tgtakaoka/retro-bionic/docs/mandelbrot.md

# CPU speed by an assembly-language Mandelbrot

Every architecture's samples run the same Mandelbrot algorithm, written in
that chip's own assembly: [mandelbrot.c](../samples/arith/mandelbrot.c) in
16-bit integers, and on chips with floating-point instructions,
[fmandel.cpp](../samples/arith/fmandel.cpp) as well. Both draw 25 rows of 79
pixels, each printed as its iteration count, `0`-`9` and `A`-`F`, or a space
after 16. Each character goes into a queue that the serial port's
transmit interrupt drains, so sending overlaps the next pixel's work.
On chips that draw a frame in under 10 seconds, a frame ends once the
queue is empty.
The tables time them on real chips, from recorded casts, with
[mandelbrot-timing.py](../scripts/mandelbrot-timing.py).

- **frame** is the seconds for a full frame, measured when the cast has
  one. Otherwise it is estimated: rows differ in work, so seconds =
  a × iterations + b is fitted to the timed rows and summed over the
  golden frame.
- **avg row** is the average seconds per row over the rows a cast timed.
- **std dev** is the standard deviation of those rows' seconds, which is
  mostly the picture's, not the chip's.
- **MHz** is the chip's clock: ⏱️ marks one clocked from a timer at
  that rate (see [hardware.md](hardware.md#clocking-the-cpu)), 🔨 one
  whose edges the debugger bit-bangs, at its average rate.
- **Note** names the code when it is not the chip's own, and any mode
  the run set.
- **Links**: ▶️ plays the cast, an [asciinema](https://asciinema.org/)
  recording of the debugger's terminal while the chip draws, with its
  timing, in the browser at the speed it ran, beside its listing
  (`asciinema play` replays the file in a terminal); 📄 opens the
  listing, the assembly source the chip ran.

<!-- Link a cast as
     https://tgtakaoka.github.io/retro-bionic/play.html?cast=samples/<arch>/<name>.cast&lst=samples/<arch>/<name>.lst
     with ▶️ as the text and the cast file name as the title, and the
     row's listing as 📄 with its path as the title; docs/play.html
     plays it beside the listing. -->

## Integer, mandelbrot

Icons: ⏱️ timer clock, 🔨 bit-banged clock (average), ▶️ play the
cast, 📄 the listing.

| arch | core | CPU | frame | avg row | std dev | MHz | Note | Links |
| :---: | :---: | :---: | ----: | ---: | ---: | ---: | --- | :---: |
| i8096  | i80296  | S80296SA50 | 1.6 | 0.066 | 0.017 | 4.93&nbsp;🔨 | i80296 code | [▶️](https://tgtakaoka.github.io/retro-bionic/play.html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 "mandelbrot.cast") [📄](../samples/i80296/mandelbrot.lst "i80296/mandelbrot.lst") |
| i8096  | i80296  | S80296SA50 | 1.7 | 0.069 | 0.018 | 4.87&nbsp;🔨 | i8096 code | [▶️](https://tgtakaoka.github.io/retro-bionic/play.html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 "mandelbrot_s80296sa.cast") [📄](../samples/i8096/mandelbrot.lst "i8096/mandelbrot.lst") |
| z280 | z280 | Z8028012VSC  | 1.8 | 0.074 | 0.017 | 7.12&nbsp;🔨 | cache on | [▶️](https://tgtakaoka.github.io/retro-bionic/play.html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 "mandelbrot.cast") [📄](../samples/z280/mandelbrot.lst "z280/mandelbrot.lst") |
| mc68hc16 |  mc68hc16 | MC68HC16Z1PV16 | 2.1 | 0.084 | 0.024 | 10.00&nbsp;⏱️ | | [▶️](https://tgtakaoka.github.io/retro-bionic/play.html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 "mandelbrot.cast") [📄](../samples/mc68hc16/mandelbrot.lst "mc68hc16/mandelbrot.lst") |
| mc68hc12 |  mc68hc12 |  MC68HC912BD32 | 2.1 | 0.086 | 0.023 | 2.50&nbsp;🔨 | | [▶️](https://tgtakaoka.github.io/retro-bionic/play.html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 "mandelbrot.cast") [📄](../samples/mc68hc12/mandelbrot.lst "mc68hc12/mandelbrot.lst") |
| mc68hc12 | mc68hcs12 |  MC9S12DG128B  | 2.2 | 0.089 | 0.024 | 2.44&nbsp;🔨 | | [▶️](https://tgtakaoka.github.io/retro-bionic/play.html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 "mandelbrot_mc9s12d.cast") [📄](../samples/mc68hc12/mandelbrot.lst "mc68hc12/mandelbrot.lst") |
| h16 | h16 |  HD641016CP10  | 2.4 | 0.098 | 0.022 | 10.00&nbsp;⏱️ | | [▶️](https://tgtakaoka.github.io/retro-bionic/play.html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 "mandelbrot.cast") [📄](../samples/h16/mandelbrot.lst "h16/mandelbrot.lst") |
| z8000  | z8002 | Z16C0210PSC  | 2.6 | 0.104 | 0.030 | 6.86&nbsp;🔨 | | [▶️](https://tgtakaoka.github.io/retro-bionic/play.html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 "mandelbrot.cast") [📄](../samples/z8002/mandelbrot.lst "z8002/mandelbrot.lst") |
| mc68000  |  mc68000  | MC68010P12 | 2.7 | 0.112 | 0.032 |  10.00&nbsp;⏱️ | | [▶️](https://tgtakaoka.github.io/retro-bionic/play.html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 "mandelbrot_mc68010.cast") [📄](../samples/mc68000/mandelbrot.lst "mc68000/mandelbrot.lst") |
| i8096  | i8096 | N8097BH | 2.9 | 0.117 | 0.033 |  10.03&nbsp;🔨 | i8096 code | [▶️](https://tgtakaoka.github.io/retro-bionic/play.html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 "mandelbrot_n8097.cast") [📄](../samples/i8096/mandelbrot.lst "i8096/mandelbrot.lst") |
| i8096  | i8096 | P8095BH | 2.9 | 0.119 | 0.033 |  10.06&nbsp;🔨 | i8096 code | [▶️](https://tgtakaoka.github.io/retro-bionic/play.html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 "mandelbrot.cast") [📄](../samples/i8096/mandelbrot.lst "i8096/mandelbrot.lst") |
| z8000  | z8001 | Z0800110PSC  | 3.0 | 0.121 | 0.034 | 6.01&nbsp;🔨 | nonsegmented, normal | [▶️](https://tgtakaoka.github.io/retro-bionic/play.html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 "mandelbrot_nonseg.cast") [📄](../samples/z8001/mandelbrot_nonseg.lst "z8001/mandelbrot_nonseg.lst") |
| z8000  | z8001 | Z0800110PSC  | 3.0 | 0.122 | 0.034 | 6.10&nbsp;🔨 | segmented, normal | [▶️](https://tgtakaoka.github.io/retro-bionic/play.html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 "mandelbrot.cast") [📄](../samples/z8001/mandelbrot.lst "z8001/mandelbrot.lst") |
| z380 | z380 | Z8038018FSC  | 3.0 | 0.122 | 0.036 | 3.41&nbsp;🔨 | | [▶️](https://tgtakaoka.github.io/retro-bionic/play.html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 "mandelbrot.cast") [📄](../samples/z380/mandelbrot.lst "z380/mandelbrot.lst") |
| i8096  | i80196  | S80C196KC20  | 3.0 | 0.124 | 0.035 | 4.89&nbsp;🔨 | i8096 code | [▶️](https://tgtakaoka.github.io/retro-bionic/play.html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 "mandelbrot_s80c196kc.cast") [📄](../samples/i8096/mandelbrot.lst "i8096/mandelbrot.lst") |
| mc68hc12 | mc68hcs12x |  MC9S12XDP512  | 3.2 | 0.132 | 0.036 | 1.58&nbsp;🔨 | non-mux addr/data | [▶️](https://tgtakaoka.github.io/retro-bionic/play.html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 "mandelbrot.cast") [📄](../samples/mc9s12x/mandelbrot.lst "mc9s12x/mandelbrot.lst") |
| mc68hc12 | mc68hcs12x |  MC9S12XDP512  | 3.3 | 0.135 | 0.037 | 1.58&nbsp;🔨 | mc68hc12 code | [▶️](https://tgtakaoka.github.io/retro-bionic/play.html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 "mandelbrot_mc9s12x.cast") [📄](../samples/mc68hc12/mandelbrot.lst "mc68hc12/mandelbrot.lst") |
|  i8086 | v30 | D70116C-8 | 3.4 | 0.140 | 0.040 |  5.00&nbsp;⏱️ | i80186 code | [▶️](https://tgtakaoka.github.io/retro-bionic/play.html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 "mandelbrot_i80186_v30.cast") [📄](../samples/i8086/mandelbrot_i80186.lst "i8086/mandelbrot_i80186.lst")  |
|  i8086 | v30 | D70116C-8 | 3.5 | 0.142 | 0.041 |  5.00&nbsp;⏱️ | i8086 code | [▶️](https://tgtakaoka.github.io/retro-bionic/play.html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 "mandelbrot_v30.cast") [📄](../samples/i8086/mandelbrot.lst "i8086/mandelbrot.lst") |
| mc68000  |  mc68000  | MC68008P10 | 3.7 | 0.149 | 0.041 | 10.00&nbsp;⏱️ | | [▶️](https://tgtakaoka.github.io/retro-bionic/play.html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 "mandelbrot.cast") [📄](../samples/mc68000/mandelbrot.lst "mc68000/mandelbrot.lst") |
| mc68000  |  mc68000  |  MC68008FN10 | 3.7 | 0.149 | 0.041 | 10.00&nbsp;⏱️ | | [▶️](https://tgtakaoka.github.io/retro-bionic/play.html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 "mandelbrot_mc68008fn.cast") [📄](../samples/mc68000/mandelbrot.lst "mc68000/mandelbrot.lst") |
| mc68000  |  mc68000  |  MC68HC000P16  | 4.0 | 0.164 | 0.047 |  7.50&nbsp;⏱️ | | [▶️](https://tgtakaoka.github.io/retro-bionic/play.html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 "mandelbrot_mc68000p.cast") [📄](../samples/mc68000/mandelbrot.lst "mc68000/mandelbrot.lst") |
| z280 | z280 | Z8028012VSC  | 4.5 | 0.182 | 0.053 | 3.78&nbsp;🔨 | | [▶️](https://tgtakaoka.github.io/retro-bionic/play.html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 "mandelbrot.cast") [📄](../samples/z280/mandelbrot.lst "z280/mandelbrot.lst") |
|  i8086 | v20 |  D70108HCZ-16  | 4.8 | 0.194 | 0.055 |  5.00&nbsp;⏱️ | i80186 code | [▶️](https://tgtakaoka.github.io/retro-bionic/play.html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 "mandelbrot_i80186_v20.cast") [📄](../samples/i8086/mandelbrot_i80186.lst "i8086/mandelbrot_i80186.lst")  |
|  i8086 | v20 |  D70108HCZ-16  | 4.8 | 0.195 | 0.055 |  5.00&nbsp;⏱️ | i8086 code | [▶️](https://tgtakaoka.github.io/retro-bionic/play.html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 "mandelbrot_v20.cast") [📄](../samples/i8086/mandelbrot.lst "i8086/mandelbrot.lst") |
|  tms320  | tms320c1x | TMS320C15NL  | 4.8 | 0.195 | 0.062 | 5.19&nbsp;🔨 | TMS320C1x code | [▶️](https://tgtakaoka.github.io/retro-bionic/play.html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 "mandelbrot.cast") [📄](../samples/tms320c1x/mandelbrot.lst "tms320c1x/mandelbrot.lst") |
| pdp11  | j11 | DCJ11 | 6.0 | 0.246 | 0.074 |  7.50&nbsp;⏱️ | with EIS | [▶️](https://tgtakaoka.github.io/retro-bionic/play.html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 "mandelbrot.cast") [📄](../samples/dcj11/mandelbrot.lst "dcj11/mandelbrot.lst") |
|  tms9900 |  tms99105 |  TMS99105AJDL  | 6.7 | 0.272 | 0.087 | 6.34&nbsp;🔨 | | [▶️](https://tgtakaoka.github.io/retro-bionic/play.html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 "mandelbrot.cast") [📄](../samples/tms99105/mandelbrot.lst "tms99105/mandelbrot.lst") |
|  tms9900 |  tms99105 |  TMS99105AJDL  | 6.7 | 0.274 | 0.087 | 6.32&nbsp;🔨 | TMS9995 code | [▶️](https://tgtakaoka.github.io/retro-bionic/play.html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 "mandelbrot_tms99105.cast") [📄](../samples/tms9995/mandelbrot.lst "tms9995/mandelbrot.lst") |
|  i8086 | i8086 | P80C86A-2 | 6.8 | 0.277 | 0.087 |  5.00&nbsp;⏱️ | | [▶️](https://tgtakaoka.github.io/retro-bionic/play.html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 "mandelbrot.cast") [📄](../samples/i8086/mandelbrot.lst "i8086/mandelbrot.lst") |
|  tms9900 |  tms99105 |  TMS99105AJDL  | 7.1 | 0.291 | 0.093 | 6.12&nbsp;🔨 | TMS9900 code | [▶️](https://tgtakaoka.github.io/retro-bionic/play.html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 "mandelbrot_tms99105.cast") [📄](../samples/tms9900/mandelbrot.lst "tms9900/mandelbrot.lst") |
|  i8086 | i8086 | P80C86A-2 | 7.3 | 0.297 | 0.091 |  5.00&nbsp;⏱️ | with D8087 | [▶️](https://tgtakaoka.github.io/retro-bionic/play.html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 "mandelbrot_80c86_8087.cast") [📄](../samples/i8086/mandelbrot.lst "i8086/mandelbrot.lst") |
|  i8086 | i8086 | P80C88A-2 | 7.9 | 0.321 | 0.099 |  5.00&nbsp;⏱️ | | [▶️](https://tgtakaoka.github.io/retro-bionic/play.html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 "mandelbrot_80c88.cast") [📄](../samples/i8086/mandelbrot.lst "i8086/mandelbrot.lst") |
|  tms9900 |  tms9995  |  TMS9995NL-12  | 8.3 | 0.338 | 0.108 | 6.17&nbsp;🔨 | | [▶️](https://tgtakaoka.github.io/retro-bionic/play.html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 "mandelbrot.cast") [📄](../samples/tms9995/mandelbrot.lst "tms9995/mandelbrot.lst") |
|  mn1610  | mn1613  | MN1613 | 8.6 | 0.353 | 0.115 | 8.01&nbsp;🔨 | | [▶️](https://tgtakaoka.github.io/retro-bionic/play.html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 "mandelbrot.cast") [📄](../samples/mn1613/mandelbrot.lst "mn1613/mandelbrot.lst") |
|  mn1610  | mn1613  | MN1613A | 8.9 | 0.362 | 0.118 | 8.01&nbsp;🔨 | | [▶️](https://tgtakaoka.github.io/retro-bionic/play.html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 "mandelbrot_mn1613a.cast") [📄](../samples/mn1613/mandelbrot.lst "mn1613/mandelbrot.lst") |
|  i8086 | i8086 | P80C88A-2 | 9.2 | 0.374 | 0.113 |  5.00&nbsp;⏱️ | with D8087 | [▶️](https://tgtakaoka.github.io/retro-bionic/play.html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 "mandelbrot_80c88_8087.cast") [📄](../samples/i8086/mandelbrot.lst "i8086/mandelbrot.lst") |
|  mc6809  | hd6309  | HD63C09EP |  10.0 | 0.408 | 0.131 | 0.88&nbsp;🔨 | HD6309 code | [▶️](https://tgtakaoka.github.io/retro-bionic/play.html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 "mandelbrot_hd6309e.cast") [📄](../samples/hd6309/mandelbrot.lst "hd6309/mandelbrot.lst") |
|  mos6502 |  w65c816  |  W65C816S8P-14 |  10.1 | 0.411 | 0.099 | 2.61&nbsp;🔨 | | [▶️](https://tgtakaoka.github.io/retro-bionic/play.html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 "mandelbrot.cast") [📄](../samples/w65c816/mandelbrot.lst "w65c816/mandelbrot.lst") |
| z380 | z380 | Z8038018FSC  |  10.2 | 0.415 | 0.110 | 3.60&nbsp;🔨 | Z180 code | [▶️](https://tgtakaoka.github.io/retro-bionic/play.html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 "mandelbrot_z380.cast") [📄](../samples/z180/mandelbrot.lst "z180/mandelbrot.lst") |
|  mos6502 |  w65c02s  | W65C02S6TPG-14 |  10.3 | 0.417 | 0.098 | 3.69&nbsp;🔨 | G65SC02 code | [▶️](https://tgtakaoka.github.io/retro-bionic/play.html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 "mandelbrot_w65c02s.cast") [📄](../samples/g65sc02/mandelbrot.lst "g65sc02/mandelbrot.lst") |
|  tms9900 |  tms9995  |  TMS9995NL-12  |  10.3 | 0.420 | 0.134 | 6.11&nbsp;🔨 | TMS9900 code | [▶️](https://tgtakaoka.github.io/retro-bionic/play.html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 "mandelbrot_tms9995.cast") [📄](../samples/tms9900/mandelbrot.lst "tms9900/mandelbrot.lst") |
|  mc6809  | hd6309  | HD63B09P |  10.3 | 0.422 | 0.135 | 3.39&nbsp;🔨 | | [▶️](https://tgtakaoka.github.io/retro-bionic/play.html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 "mandelbrot.cast") [📄](../samples/hd6309/mandelbrot.lst "hd6309/mandelbrot.lst") |
|  mos6502 |  w65c02s  | W65C02S6TPG-14 |  10.4 | 0.421 | 0.099 | 3.69&nbsp;🔨 | MOS6502 code | [▶️](https://tgtakaoka.github.io/retro-bionic/play.html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 "mandelbrot_w65c02s.cast") [📄](../samples/mos6502/mandelbrot.lst "mos6502/mandelbrot.lst") |
|  tlcs90  | tlcs90  | TMP90C802AP  |  11.3 | 0.460 | 0.151 | 5.16&nbsp;🔨 | TLCS90 code | [▶️](https://tgtakaoka.github.io/retro-bionic/play.html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 "mandelbrot.cast") [📄](../samples/tlcs90/mandelbrot.lst "tlcs90/mandelbrot.lst") |
| z380 | z380 | Z8038018FSC  |  12.1 | 0.491 | 0.121 | 3.51&nbsp;🔨 | Z80 code | [▶️](https://tgtakaoka.github.io/retro-bionic/play.html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 "mandelbrot_z380.cast") [📄](../samples/z80/mandelbrot.lst "z80/mandelbrot.lst") |
| z80 | z80 |  KL5C80A12CFP  |  12.4 | 0.505 | 0.123 | 18.75&nbsp;⏱️ | Z80 code | [▶️](https://tgtakaoka.github.io/retro-bionic/play.html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 "mandelbrot_kl5c80.cast") [📄](../samples/z80/mandelbrot.lst "z80/mandelbrot.lst") |
|  mn1610  | mn1613  | MN1613 |  12.7 | 0.517 | 0.131 | 7.57&nbsp;🔨 | MN1610 code | [▶️](https://tgtakaoka.github.io/retro-bionic/play.html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 "mandelbrot.cast") [📄](../samples/mn1610/mandelbrot.lst "mn1610/mandelbrot.lst") |
|  mn1610  | mn1613  | MN1613A |  12.8 | 0.519 | 0.131 | 7.57&nbsp;🔨 | MN1610 code | [▶️](https://tgtakaoka.github.io/retro-bionic/play.html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 "mandelbrot_mn1613a.cast") [📄](../samples/mn1610/mandelbrot.lst "mn1610/mandelbrot.lst") |
|  mos6502 |  g65sc02  | G65SC02P-4 |  13.2 | 0.535 | 0.125 | 2.88&nbsp;🔨 | | [▶️](https://tgtakaoka.github.io/retro-bionic/play.html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 "mandelbrot.cast") [📄](../samples/g65sc02/mandelbrot.lst "g65sc02/mandelbrot.lst") |
|  mos6502 |  g65sc02  | G65SC02P-4 |  13.3 | 0.534 | 0.128 | 2.88&nbsp;🔨 | MOS6502 code | [▶️](https://tgtakaoka.github.io/retro-bionic/play.html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 "mandelbrot_g65sc02.cast") [📄](../samples/mos6502/mandelbrot.lst "mos6502/mandelbrot.lst") |
|  tms370  | tms370  |  TMS370C250FNA |  13.8 | 0.561 | 0.176 | 18.75&nbsp;⏱️ | | [▶️](https://tgtakaoka.github.io/retro-bionic/play.html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 "mandelbrot.cast") [📄](../samples/tms370/mandelbrot.lst "tms370/mandelbrot.lst") |
|  mos6502 |  w65c816  |  W65C816S8P-14 |  14.4 | 0.586 | 0.137 | 2.63&nbsp;🔨 | G65SC02 code | [▶️](https://tgtakaoka.github.io/retro-bionic/play.html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 "mandelbrot_w65c816.cast") [📄](../samples/g65sc02/mandelbrot.lst "g65sc02/mandelbrot.lst") |
|  mos6502 |  w65c816  |  W65C816S8P-14 |  14.6 | 0.592 | 0.139 | 2.63&nbsp;🔨 | MOS6502 code | [▶️](https://tgtakaoka.github.io/retro-bionic/play.html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 "mandelbrot_w65c816.cast") [📄](../samples/mos6502/mandelbrot.lst "mos6502/mandelbrot.lst") |
| z80 | z180 | Z8018010VSC  |  14.9 | 0.605 | 0.160 | 16.67&nbsp;⏱️ | | [▶️](https://tgtakaoka.github.io/retro-bionic/play.html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 "mandelbrot_z180vsc.cast") [📄](../samples/z180/mandelbrot.lst "z180/mandelbrot.lst") |
| z80 | z180 | Z8018008FSC  |  14.9 | 0.606 | 0.160 | 16.67&nbsp;⏱️ | | [▶️](https://tgtakaoka.github.io/retro-bionic/play.html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 "mandelbrot.cast") [📄](../samples/z180/mandelbrot.lst "z180/mandelbrot.lst") |
| z80 | z180 | HD64180SH10  |  15.2 | 0.619 | 0.163 | 18.75&nbsp;⏱️ | Z180 code | [▶️](https://tgtakaoka.github.io/retro-bionic/play.html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 "mandelbrot_hd64180s.cast") [📄](../samples/z180/mandelbrot.lst "z180/mandelbrot.lst") |
|  mos6502 | r65c02  | R65C02P3 |  15.9 | 0.647 | 0.152 | 2.38&nbsp;🔨 | G65SC02 code | [▶️](https://tgtakaoka.github.io/retro-bionic/play.html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 "mandelbrot_r65c02.cast") [📄](../samples/g65sc02/mandelbrot.lst "g65sc02/mandelbrot.lst") |
|  mos6502 | r65c02  | R65C02P3 |  16.1 | 0.653 | 0.154 | 2.38&nbsp;🔨 | MOS6502 code | [▶️](https://tgtakaoka.github.io/retro-bionic/play.html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 "mandelbrot_r65c02.cast") [📄](../samples/mos6502/mandelbrot.lst "mos6502/mandelbrot.lst") |
| z80 | z80 |  KL5C80A12CFP  |  16.6 | 0.673 | 0.156 | 18.75&nbsp;⏱️ | i8080 code/mode2 | [▶️](https://tgtakaoka.github.io/retro-bionic/play.html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 "mandelbrot_mode2_kl5c80.cast") [📄](../samples/i8080/mandelbrot_mode2.lst "i8080/mandelbrot_mode2.lst") |
| z80 | z180 | Z8018010VSC  |  17.3 | 0.702 | 0.171 | 16.67&nbsp;⏱️ | Z80 code | [▶️](https://tgtakaoka.github.io/retro-bionic/play.html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 "mandelbrot_z180vsc.cast") [📄](../samples/z80/mandelbrot.lst "z80/mandelbrot.lst") |
| z80 | z180 | Z8018008FSC  |  17.3 | 0.704 | 0.171 | 16.67&nbsp;⏱️ | Z80 code | [▶️](https://tgtakaoka.github.io/retro-bionic/play.html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 "mandelbrot_z180.cast") [📄](../samples/z80/mandelbrot.lst "z80/mandelbrot.lst") |
| z80 | z180 | HD64180SH10  |  17.8 | 0.723 | 0.176 | 18.75&nbsp;⏱️ | Z80 code | [▶️](https://tgtakaoka.github.io/retro-bionic/play.html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 "mandelbrot_hd64180s.cast") [📄](../samples/z80/mandelbrot.lst "z80/mandelbrot.lst") |
| z8 | z88 | Z88C0020PSC  |  17.9 | 0.730 | 0.243 | 6.97&nbsp;🔨 | Z88 code | [▶️](https://tgtakaoka.github.io/retro-bionic/play.html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 "mandelbrot.cast") [📄](../samples/z88/mandelbrot.lst "z88/mandelbrot.lst") |
| pdp11  | j11 | DCJ11 |  18.5 | 0.752 | 0.191 |  7.50&nbsp;⏱️ | base PDP11 | [▶️](https://tgtakaoka.github.io/retro-bionic/play.html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 "mandelbrot_dcj11.cast") [📄](../samples/pdp11/mandelbrot.lst "pdp11/mandelbrot.lst") |
|  mc6805  |  mc68hc08 | XC68HC08AZ0  |  19.1 | 0.780 | 0.256 | 4.21&nbsp;🔨 | | [▶️](https://tgtakaoka.github.io/retro-bionic/play.html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 "mandelbrot.cast") [📄](../samples/mc68hc08/mandelbrot.lst "mc68hc08/mandelbrot.lst") |
|  tms7000 |  tms7000  | TMS7002NL |  20.8 | 0.846 | 0.223 | 4.67&nbsp;🔨 | TMS7000 code | [▶️](https://tgtakaoka.github.io/retro-bionic/play.html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 "mandelbrot.cast") [📄](../samples/tms7000/mandelbrot.lst "tms7000/mandelbrot.lst") |
|  tms9900 |  tms9900  | TMS9900NL |  21.3 | 0.869 | 0.280 |  14.22&nbsp;🔨 | | [▶️](https://tgtakaoka.github.io/retro-bionic/play.html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 "mandelbrot.cast") [📄](../samples/tms9900/mandelbrot.lst "tms9900/mandelbrot.lst") |
| pdp11  | t11 | DCT11 |  21.6 | 0.879 | 0.220 | 4.90&nbsp;🔨 | base PDP11 | [▶️](https://tgtakaoka.github.io/retro-bionic/play.html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 "mandelbrot_dct11.cast") [📄](../samples/pdp11/mandelbrot.lst "pdp11/mandelbrot.lst") |
|  i8086 | v30 | D70116C-8 |  22.7 | 0.933 | 0.208 |  5.00&nbsp;⏱️ | i8080 code/emulation | [▶️](https://tgtakaoka.github.io/retro-bionic/play.html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 "mandelbrot_v30.cast") [📄](../samples/i8080/mandelbrot.lst "i8080/mandelbrot.lst") |
|  mc6800  |  mc68hc11 | MC68HC11A0P  |  23.1 | 0.942 | 0.314 | 3.34&nbsp;🔨 | | [▶️](https://tgtakaoka.github.io/retro-bionic/play.html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 "mandelbrot.cast") [📄](../samples/mc68hc11/mandelbrot.lst "mc68hc11/mandelbrot.lst") |
| z80 | z80 | NSC800N-4I |  24.5 | 0.994 | 0.239 |  8.33&nbsp;⏱️ | Z80 code | [▶️](https://tgtakaoka.github.io/retro-bionic/play.html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 "mandelbrot_nsc800.cast") [📄](../samples/z80/mandelbrot.lst "z80/mandelbrot.lst") |
| z80 | z80 | Z8400APS |  25.0 | 1.017 | 0.244 | 3.23&nbsp;🔨 | | [▶️](https://tgtakaoka.github.io/retro-bionic/play.html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 "mandelbrot.cast") [📄](../samples/z80/mandelbrot.lst "z80/mandelbrot.lst") |
|  tms7000 |  tms7000  | TMS70C02NL |  26.8 | 1.092 | 0.287 | 3.62&nbsp;🔨 | TMS7000 code | [▶️](https://tgtakaoka.github.io/retro-bionic/play.html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 "mandelbrot_tms70c02.cast") [📄](../samples/tms7000/mandelbrot.lst "tms7000/mandelbrot.lst") |
|  tms7000 |  tms7000  | TMS70C00NL |  26.8 | 1.092 | 0.287 | 3.62&nbsp;🔨 | TMS7000 code | [▶️](https://tgtakaoka.github.io/retro-bionic/play.html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 "mandelbrot_tms70c00.cast") [📄](../samples/tms7000/mandelbrot.lst "tms7000/mandelbrot.lst") |
|  tms7000 |  tms7000  | TMS7001NL-2  |  26.9 | 1.094 | 0.288 | 3.61&nbsp;🔨 | TMS7000 code | [▶️](https://tgtakaoka.github.io/retro-bionic/play.html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 "mandelbrot_tms7001nl2.cast") [📄](../samples/tms7000/mandelbrot.lst "tms7000/mandelbrot.lst") |
|  mos6502 |  mos6502  | UM6502A |  26.9 | 1.168 | 0.228 | 1.44&nbsp;🔨 | | [▶️](https://tgtakaoka.github.io/retro-bionic/play.html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 "mandelbrot.cast") [📄](../samples/mos6502/mandelbrot.lst "mos6502/mandelbrot.lst") |
| z8 | z86 | Z86C9116PSC  |  27.1 | 1.103 | 0.305 | 6.77&nbsp;🔨 | Z86 code | [▶️](https://tgtakaoka.github.io/retro-bionic/play.html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 "mandelbrot.cast") [📄](../samples/z86/mandelbrot.lst "z86/mandelbrot.lst") |
|  tms7000 |  tms7000  | TMS7001NL-4  |  28.1 | 1.141 | 0.300 | 6.90&nbsp;🔨 | TMS7000 code | [▶️](https://tgtakaoka.github.io/retro-bionic/play.html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 "mandelbrot_tms7001nl4.cast") [📄](../samples/tms7000/mandelbrot.lst "tms7000/mandelbrot.lst") |
| z280 | z280 | Z8028012VSC  |  28.4 | 1.155 | 0.280 | 3.85&nbsp;🔨 | Z80 code | [▶️](https://tgtakaoka.github.io/retro-bionic/play.html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 "mandelbrot_z280.cast") [📄](../samples/z80/mandelbrot.lst "z80/mandelbrot.lst") |
| i8080  | i8085 | P8085AH-2 |  29.1 | 1.179 | 0.272 | 10.00&nbsp;⏱️ | i8080 code | [▶️](https://tgtakaoka.github.io/retro-bionic/play.html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 "mandelbrot_p8085.cast") [📄](../samples/i8080/mandelbrot.lst "i8080/mandelbrot.lst") |
| z80 | z80 | NSC800N-4I |  29.8 | 1.210 | 0.279 |  8.33&nbsp;⏱️ | i8080 code/mode0 | [▶️](https://tgtakaoka.github.io/retro-bionic/play.html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 "mandelbrot_nsc800.cast") [📄](../samples/i8080/mandelbrot.lst "i8080/mandelbrot.lst") |
|  mc6800  | hd6301  | HD63B03R1P |  30.4 | 1.235 | 0.311 | 3.30&nbsp;🔨 | MC6801 code | [▶️](https://tgtakaoka.github.io/retro-bionic/play.html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 "mandelbrot_hd6301.cast") [📄](../samples/mc6801/mandelbrot.lst "mc6801/mandelbrot.lst") |
|  mc6809  | hd6309  | HD63C09EP |  30.5 | 1.238 | 0.292 | 0.89&nbsp;🔨 | MC6809 code | [▶️](https://tgtakaoka.github.io/retro-bionic/play.html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 "mandelbrot_hd6309e.cast") [📄](../samples/mc6809/mandelbrot.lst "mc6809/mandelbrot.lst") |
| z80 | z80 | Z8400APS |  30.6 | 1.242 | 0.286 | 3.16&nbsp;🔨 | i8080 code/mode0 | [▶️](https://tgtakaoka.github.io/retro-bionic/play.html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 "mandelbrot_z80.cast") [📄](../samples/i8080/mandelbrot.lst "i8080/mandelbrot.lst") |
| i8051  | i8051 | P80C52 |  30.7 | 1.254 | 0.382 | 7.95&nbsp;🔨 | i8051 code | [▶️](https://tgtakaoka.github.io/retro-bionic/play.html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 "mandelbrot_p80c51.cast") [📄](../samples/i8051/mandelbrot.lst "i8051/mandelbrot.lst") |
| i8051  | i8051 | P8051AH |  31.4 | 1.281 | 0.393 | 7.67&nbsp;🔨 | i8051 code | [▶️](https://tgtakaoka.github.io/retro-bionic/play.html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 "mandelbrot.cast") [📄](../samples/i8051/mandelbrot.lst "i8051/mandelbrot.lst") |
|  tms9900 |  tms9980  | TMS9980ANL |  31.5 | 1.287 | 0.409 | 10.00&nbsp;⏱️ | TMS9900 code | [▶️](https://tgtakaoka.github.io/retro-bionic/play.html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 "mandelbrot_tms9980.cast") [📄](../samples/tms9900/mandelbrot.lst "tms9900/mandelbrot.lst") |
|  tms9900 |  tms9980  |  TMS9981NL-16  |  31.5 | 1.287 | 0.409 | 10.00&nbsp;⏱️ | TMS9900 code | [▶️](https://tgtakaoka.github.io/retro-bionic/play.html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 "mandelbrot_tms9981.cast") [📄](../samples/tms9900/mandelbrot.lst "tms9900/mandelbrot.lst") |
|  mc6809  | hd6309  | HD63B09P |  32.3 | 1.310 | 0.309 | 3.38&nbsp;🔨 | MC6809 code | [▶️](https://tgtakaoka.github.io/retro-bionic/play.html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 "mandelbrot_hd6309.cast") [📄](../samples/mc6809/mandelbrot.lst "mc6809/mandelbrot.lst") |
|  mc6800  |  mc68hc11 | MC68HC11D0P  |  32.8 | 1.331 | 0.328 | 3.34&nbsp;🔨 | MC6801 code | [▶️](https://tgtakaoka.github.io/retro-bionic/play.html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 "mandelbrot_mc68hc11.cast") [📄](../samples/mc6801/mandelbrot.lst "mc6801/mandelbrot.lst") |
|  mc6800  |  mc68hc11 | MC68HC11A0P  |  32.8 | 1.331 | 0.328 | 3.34&nbsp;🔨 | MC6801 code | [▶️](https://tgtakaoka.github.io/retro-bionic/play.html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 "mandelbrot_mc68hc11a0.cast") [📄](../samples/mc6801/mandelbrot.lst "mc6801/mandelbrot.lst") |
|  mc6800  | mc6801  | MC6803P-1 |  33.1 | 1.346 | 0.332 | 3.30&nbsp;🔨 | | [▶️](https://tgtakaoka.github.io/retro-bionic/play.html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 "mandelbrot.cast") [📄](../samples/mc6801/mandelbrot.lst "mc6801/mandelbrot.lst") |
|  i8086 | v20 |  D70108HCZ-16  |  34.0 | 1.399 | 0.312 |  5.00&nbsp;⏱️ | i8080 code/emulation | [▶️](https://tgtakaoka.github.io/retro-bionic/play.html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 "mandelbrot_v20.cast") [📄](../samples/i8080/mandelbrot.lst "i8080/mandelbrot.lst") |
|  mc6809  | mc6809  | MC68B09EP |  34.1 | 1.384 | 0.330 | 0.89&nbsp;🔨 | MC6809 code | [▶️](https://tgtakaoka.github.io/retro-bionic/play.html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 "mandelbrot_mc6809e.cast") [📄](../samples/mc6809/mandelbrot.lst "mc6809/mandelbrot.lst") |
|  mc6805  |  mc68hc08 | XC68HC08AZ0  |  35.6 | 1.452 | 0.460 | 4.17&nbsp;🔨 | MC68HC05 code | [▶️](https://tgtakaoka.github.io/retro-bionic/play.html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 "mandelbrot_mc68hc08.cast") [📄](../samples/mc68hc05/mandelbrot.lst "mc68hc05/mandelbrot.lst") |
|  mc6809  | mc6809  | MC68B09P |  35.9 | 1.456 | 0.347 | 3.38&nbsp;🔨 | | [▶️](https://tgtakaoka.github.io/retro-bionic/play.html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 "mandelbrot.cast") [📄](../samples/mc6809/mandelbrot.lst "mc6809/mandelbrot.lst") |
|  mc6805  |  mc68hc05 | MC68HC05C0 |  37.7 | 1.538 | 0.488 | 4.93&nbsp;🔨 | | [▶️](https://tgtakaoka.github.io/retro-bionic/play.html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 "mandelbrot.cast") [📄](../samples/mc68hc05/mandelbrot.lst "mc68hc05/mandelbrot.lst") |
|  mc6800  | hd6301  | HD63B03R1P |  38.6 | 1.564 | 0.352 | 3.30&nbsp;🔨 | MC6800 code | [▶️](https://tgtakaoka.github.io/retro-bionic/play.html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 "mandelbrot_hd6301.cast") [📄](../samples/mc6800/mandelbrot.lst "mc6800/mandelbrot.lst") |
|  mc6800  |  mc68hc11 | MC68HC11D0P  |  40.1 | 1.627 | 0.363 | 3.34&nbsp;🔨 | MC6800 code | [▶️](https://tgtakaoka.github.io/retro-bionic/play.html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 "mandelbrot_mc68hc11.cast") [📄](../samples/mc6800/mandelbrot.lst "mc6800/mandelbrot.lst") |
|  mc6800  |  mc68hc11 | MC68HC11A0P  |  40.1 | 1.627 | 0.363 | 3.34&nbsp;🔨 | MC6800 code | [▶️](https://tgtakaoka.github.io/retro-bionic/play.html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 "mandelbrot_mc68hc11a0.cast") [📄](../samples/mc6800/mandelbrot.lst "mc6800/mandelbrot.lst") |
|  mc6805  |  mc68hc08 | XC68HC08AZ0  |  40.5 | 1.650 | 0.485 | 4.11&nbsp;🔨 | MC6805 code | [▶️](https://tgtakaoka.github.io/retro-bionic/play.html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 "mandelbrot_mc68hc08.cast") [📄](../samples/mc6805/mandelbrot.lst "mc6805/mandelbrot.lst") |
|  mc6800  | mc6801  | MC6803P-1 |  40.6 | 1.648 | 0.368 | 3.30&nbsp;🔨 | MC6800 code | [▶️](https://tgtakaoka.github.io/retro-bionic/play.html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 "mandelbrot_mc6801.cast") [📄](../samples/mc6800/mandelbrot.lst "mc6800/mandelbrot.lst") |
|  mc6805  |  mc68hc05 | MC68HC05C0 |  42.5 | 1.730 | 0.509 | 4.93&nbsp;🔨 | MC6805 code | [▶️](https://tgtakaoka.github.io/retro-bionic/play.html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 "mandelbrot_mc68hc05.cast") [📄](../samples/mc6805/mandelbrot.lst "mc6805/mandelbrot.lst") |
|  mc6800  | mb8861  | MB8861H |  43.8 | 1.777 | 0.400 | 0.87&nbsp;🔨 | MC6800 code | [▶️](https://tgtakaoka.github.io/retro-bionic/play.html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 "mandelbrot_mb8861.cast") [📄](../samples/mc6800/mandelbrot.lst "mc6800/mandelbrot.lst") |
|  mc6800  | mc6800  | MC68B00P |  43.8 | 1.777 | 0.400 | 0.87&nbsp;🔨 | | [▶️](https://tgtakaoka.github.io/retro-bionic/play.html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 "mandelbrot.cast") [📄](../samples/mc6800/mandelbrot.lst "mc6800/mandelbrot.lst") |
| i8080  | i8080 | P8080A-1 |  44.9 | 1.821 | 0.417 |  2.50&nbsp;⏱️ | | [▶️](https://tgtakaoka.github.io/retro-bionic/play.html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 "mandelbrot.cast") [📄](../samples/i8080/mandelbrot.lst "i8080/mandelbrot.lst") |
|  mc6800  | mb8861  | MB8870N |  48.6 | 1.969 | 0.443 | 3.14&nbsp;🔨 | MC6800 code | [▶️](https://tgtakaoka.github.io/retro-bionic/play.html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 "mandelbrot_mb8870.cast") [📄](../samples/mc6800/mandelbrot.lst "mc6800/mandelbrot.lst") |
|  mc6800  | mc6800  | MC68B02P |  48.6 | 1.969 | 0.443 | 3.14&nbsp;🔨 | MC6800 code | [▶️](https://tgtakaoka.github.io/retro-bionic/play.html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 "mandelbrot_mc6802.cast") [📄](../samples/mc6800/mandelbrot.lst "mc6800/mandelbrot.lst") |
|  ins8070 |  ins8070  | INS8070N |  49.4 | 2.015 | 0.641 |  4.05&nbsp;⏱️ | | [▶️](https://tgtakaoka.github.io/retro-bionic/play.html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 "mandelbrot.cast") [📄](../samples/ins8070/mandelbrot.lst "ins8070/mandelbrot.lst") |
|  cp1600  | cp1610  | CP1610 |  56.0 | 2.275 | 0.580 |  2.00&nbsp;⏱️ | | [▶️](https://tgtakaoka.github.io/retro-bionic/play.html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 "mandelbrot.cast") [📄](../samples/cp1600/mandelbrot.lst "cp1600/mandelbrot.lst") |
| pdp8 | hd6120  | HD1-6120-9 |  62.1 | 2.520 | 0.573 | 3.86&nbsp;🔨 | PDP8 code | [▶️](https://tgtakaoka.github.io/retro-bionic/play.html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 "mandelbrot_hd6120.cast") [📄](../samples/pdp8/mandelbrot.lst "pdp8/mandelbrot.lst") |
|  mc6805  |  mc146805 | MC146805E2P  |  63.9 | 2.604 | 0.766 | 4.09&nbsp;🔨 | MC6805 code | [▶️](https://tgtakaoka.github.io/retro-bionic/play.html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 "mandelbrot.cast") [📄](../samples/mc6805/mandelbrot.lst "mc6805/mandelbrot.lst") |
|  scn2650 |  scn2650  | MAB2650A |  67.7 | 2.746 | 0.632 |  2.00&nbsp;⏱️ | | [▶️](https://tgtakaoka.github.io/retro-bionic/play.html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 "mandelbrot_2mhz.cast") [📄](../samples/scn2650/mandelbrot.lst "scn2650/mandelbrot.lst") |
| i8048  | i8039 | P8039AHL |  71.6 | 2.910 | 0.768 | 6.79&nbsp;🔨 | i8048 code | [▶️](https://tgtakaoka.github.io/retro-bionic/play.html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 "mandelbrot.cast") [📄](../samples/i8048/mandelbrot.lst "i8048/mandelbrot.lst") |
| pdp8 | im6100  | IM6100AIPL |  89.0 | 3.610 | 0.813 | 4.52&nbsp;🔨 | PDP8 code | [▶️](https://tgtakaoka.github.io/retro-bionic/play.html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 "mandelbrot.cast") [📄](../samples/pdp8/mandelbrot.lst "pdp8/mandelbrot.lst") |
|  cdp1802 |  cdp1804a | CDP1806ACE |  91.7 | 3.725 | 0.929 | 5.08&nbsp;🔨 | CDP1804A code | [▶️](https://tgtakaoka.github.io/retro-bionic/play.html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 "mandelbrot.cast") [📄](../samples/cdp1804a/mandelbrot.lst "cdp1804a/mandelbrot.lst") |
|  scn2650 |  scn2650  | MAB2650A | 108.3 | 4.393 | 1.011 |  1.25&nbsp;⏱️ | | [▶️](https://tgtakaoka.github.io/retro-bionic/play.html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 "mandelbrot.cast") [📄](../samples/scn2650/mandelbrot.lst "scn2650/mandelbrot.lst") |
|  cdp1802 |  cdp1802  | CDP1802BCE | 129.9 | 5.288 | 1.452 | 5.06&nbsp;🔨 | | [▶️](https://tgtakaoka.github.io/retro-bionic/play.html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 "mandelbrot.cast") [📄](../samples/cdp1802/mandelbrot.lst "cdp1802/mandelbrot.lst") |
| f3850  | f3850 | F3850PC | 246.8 |  10.068 | 3.097 | 1.72&nbsp;🔨 | | [▶️](https://tgtakaoka.github.io/retro-bionic/play.html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 "mandelbrot.cast") [📄](../samples/f3850/mandelbrot.lst "f3850/mandelbrot.lst") |
|  ins8060 |  ins8060  | INS8060N | 250.2 |  10.144 | 2.212 |  4.05&nbsp;⏱️ | | [▶️](https://tgtakaoka.github.io/retro-bionic/play.html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 "mandelbrot.cast") [📄](../samples/ins8060/mandelbrot.lst "ins8060/mandelbrot.lst") |

## Floating point, fmandel

Icons: ⏱️ timer clock, 🔨 bit-banged clock (average), ▶️ play the
cast, 📄 the listing.

| arch | core | CPU | frame | avg row | std dev | MHz | Note | Links |
| :---: | :---: | :---: | ----: | ---: | ---: | ---: | --- | :---: |
| pdp11  | j11 | DCJ11 | 5.5 | 0.225 | 0.070 |  7.50&nbsp;⏱️ | with FP11 | [▶️](https://tgtakaoka.github.io/retro-bionic/play.html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 "fmandel.cast") [📄](../samples/dcj11/fmandel.lst "dcj11/fmandel.lst") |
|  i8086 | i8086 | P80C86A-2 | 7.0 | 0.284 | 0.094 |  5.00&nbsp;⏱️ | with D8087 | [▶️](https://tgtakaoka.github.io/retro-bionic/play.html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 "fmandel_80c86_8087.cast") [📄](../samples/i8087/fmandel.lst "i8087/fmandel.lst") |
|  mn1610  | mn1613  | MN1613 | 8.2 | 0.336 | 0.131 | 9.08&nbsp;🔨 | | [▶️](https://tgtakaoka.github.io/retro-bionic/play.html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 "fmandel.cast") [📄](../samples/mn1613/fmandel.lst "mn1613/fmandel.lst") |
|  i8086 | i8086 | P80C88A-2 | 8.3 | 0.339 | 0.108 |  5.00&nbsp;⏱️ | with D8087 | [▶️](https://tgtakaoka.github.io/retro-bionic/play.html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 "fmandel_80c88_8087.cast") [📄](../samples/i8087/fmandel.lst "i8087/fmandel.lst") |
|  mn1610  | mn1613  | MN1613A | 8.3 | 0.341 | 0.133 | 8.99&nbsp;🔨 | | [▶️](https://tgtakaoka.github.io/retro-bionic/play.html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 "fmandel_mn1613a.cast") [📄](../samples/mn1613/fmandel.lst "mn1613/fmandel.lst") |
|  tms9900 |  tms99105 |  TMS99105AJDL  |  40.7 | 1.671 | 0.570 | 6.92&nbsp;🔨 | TMS99110 macrostore | [▶️](https://tgtakaoka.github.io/retro-bionic/play.html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 "fmandel.cast") [📄](../samples/tms99110/fmandel.lst "tms99110/fmandel.lst") |

## Binary compatibility: the same code on related chips

A family's later chips run its earlier chips' code unchanged, so one
listing times several chips. Each table below is a family, in seconds
per frame from the casts in the tables above: a row is a chip, a column
a listing it ran. The debugger drives each chip's clock, serves its
memory and records every bus cycle, so a board's pace is its own, not
the chip's.

### MC6800 family

| arch | core | CPU | MHz | Note | [mc6800](../samples/mc6800/mandelbrot.lst) | [mc6801](../samples/mc6801/mandelbrot.lst) | [mc68hc11](../samples/mc68hc11/mandelbrot.lst) |
| :---: | :---: | :---: | ---: | --- | ---: | ---: | ---: |
|  mc6800  | mc6800  | MC68B00P | 0.87&nbsp;🔨 | 2 phase clock | 43.8 | | |
|  mc6800  | mb8861  | MB8861H | 0.87&nbsp;🔨 | 2 phase clock | 43.8 | | |
|  mc6800  | mc6800  | MC68B02P | 3.14&nbsp;🔨 | 1 phase clock | 48.6 | | |
|  mc6800  | mb8861  | MB8870N | 3.14&nbsp;🔨 | 1 phase clock | 48.6 | | |
|  mc6800  | mc6801  | MC6803P-1 | 3.30&nbsp;🔨 | | 40.6 | 33.1 | |
|  mc6800  | hd6301  | HD63B03R1P | 3.30&nbsp;🔨 | a bit fast core | 38.6 | 30.4 | |
|  mc6800  |  mc68hc11 | MC68HC11A0P  | 3.34&nbsp;🔨 | | 40.1 | 32.8 | 23.1 |
|  mc6800  |  mc68hc11 | MC68HC11D0P  | 3.34&nbsp;🔨 | | 40.1 | 32.8 | |

### MC6805 family

| arch | core | CPU | MHz | Note | [mc6805](../samples/mc6805/mandelbrot.lst) | [mc68hc05](../samples/mc68hc05/mandelbrot.lst) | [mc68hc08](../samples/mc68hc08/mandelbrot.lst) |
| :---: | :---: | :---: | ---: | --- | ---: | ---: | ---: |
|  mc6805  |  mc146805 | MC146805E2P  | 4.09&nbsp;🔨 | 5 clock bus | 63.9 | | |
|  mc6805  |  mc68hc05 | MC68HC05C0 | 4.93&nbsp;🔨 | 4 clock bus | 42.5 | 37.7 | |
|  mc6805  |  mc68hc08 | XC68HC08AZ0  | 4.21&nbsp;🔨 | fast core | 40.5 | 35.6 | 19.1 |

### MC6809 family

| arch | core | CPU | MHz | Note | [mc6809](../samples/mc6809/mandelbrot.lst) | [hd6309](../samples/hd6309/mandelbrot.lst) |
| :---: | :---: | :---: | ---: | --- | ---: | ---: |
|  mc6809  | mc6809  | MC68B09P | 3.38&nbsp;🔨 | | 35.9 | |
|  mc6809  | hd6309  | HD63B09P | 3.39&nbsp;🔨 | | 32.3 | 10.3 |
|  mc6809  | mc6809  | MC68B09EP | 0.89&nbsp;🔨 | 2 phase clock | 34.1 | |
|  mc6809  | hd6309  | HD63C09EP | 0.88&nbsp;🔨 | 2 phase clock | 30.5 | 10.0 |

### MC68HC12 family

| arch | core | CPU | MHz | Note | [mc68hc12](../samples/mc68hc12/mandelbrot.lst) | [mc9s12x](../samples/mc9s12x/mandelbrot.lst) |
| :---: | :---: | :---: | ---: | --- | ---: | ---: |
| mc68hc12 |  mc68hc12 |  MC68HC912BD32 | 2.50&nbsp;🔨 | | 2.1 | |
| mc68hc12 | mc68hcs12 |  MC9S12DG128B  | 2.44&nbsp;🔨 | | 2.2 | |
| mc68hc12 | mc68hcs12x |  MC9S12XDP512  | 1.58&nbsp;🔨 | non-mux addr/data | 3.3 | 3.2 |

### MOS6502 family

| arch | core | CPU | MHz | Note | [mos6502](../samples/mos6502/mandelbrot.lst) | [g65sc02](../samples/g65sc02/mandelbrot.lst) | [w65c816](../samples/w65c816/mandelbrot.lst) |
| :---: | :---: | :---: | ---: | --- | ---: | ---: | ---: |
|  mos6502 |  mos6502  | UM6502A | 1.44&nbsp;🔨 | | 26.9 | | |
|  mos6502 |  g65sc02  | G65SC02P-4 | 2.88&nbsp;🔨 | | 13.3 | 13.2 | |
|  mos6502 | r65c02  | R65C02P3 | 2.38&nbsp;🔨 | | 16.1 | 15.9 | |
|  mos6502 |  w65c02s  | W65C02S6TPG-14 | 3.69&nbsp;🔨 | | 10.4 | 10.3 | |
|  mos6502 |  w65c816  |  W65C816S8P-14 | 2.61&nbsp;🔨 | 24bit addr | 14.6 | 14.4 | 10.1 |

### MCS-96 family

| arch | core | CPU | MHz | Note | [i8096](../samples/i8096/mandelbrot.lst) | [i80296](../samples/i80296/mandelbrot.lst) |
| :---: | :---: | :---: | ---: | --- | ---: | ---: |
| i8096  | i8096 | N8097BH |  10.03&nbsp;🔨 | | 2.9 | |
| i8096  | i8096 | P8095BH |  10.06&nbsp;🔨 | | 2.9 | |
| i8096  | i80196  | S80C196KC20  | 4.89&nbsp;🔨 | | 3.0 | |
| i8096  | i80296  | S80296SA50 | 4.93&nbsp;🔨 | shorter opcode | 1.7 | 1.6 |

### MN1610 family

| arch | core | CPU | MHz | Note | [mn1610](../samples/mn1610/mandelbrot.lst) | [mn1613](../samples/mn1613/mandelbrot.lst) |
| :---: | :---: | :---: | ---: | --- | ---: | ---: |
|  mn1610  | mn1613  | MN1613 | 8.01&nbsp;🔨 | 18bit addr | 12.7 | 10.0 |
|  mn1610  | mn1613  | MN1613A | 8.01&nbsp;🔨 | 20bit addr | 12.8 | 10.2 |

### PDP-8 family

| arch | core | CPU | MHz | Note | [pdp8](../samples/pdp8/mandelbrot.lst) |
| :---: | :---: | :---: | ---: | --- | ---: |
| pdp8 | im6100  | IM6100AIPL | 4.52&nbsp;🔨 | | 89.0 |
| pdp8 | hd6120  | HD1-6120-9 | 3.86&nbsp;🔨 | fast core/bus | 62.1 |

### PDP-11 family

| arch | core | CPU | MHz | Note | [base](../samples/pdp11/mandelbrot.lst) | [EIS](../samples/dcj11/mandelbrot.lst) |
| :---: | :---: | :---: | ---: | --- | ---: | ---: |
| pdp11  | t11 | DCT11 | 4.90&nbsp;🔨 | 16bit addr | 21.6 | |
| pdp11  | j11 | DCJ11 |  7.50&nbsp;⏱️ | 22bit addr | 18.5 | 6.0 |

### TMS7000 family

| arch | core | CPU | MHz | Note | [tms7000](../samples/tms7000/mandelbrot.lst) |
| :---: | :---: | :---: | ---: | --- | ---: |
|  tms7000 |  tms7000  | TMS7002NL | 4.67&nbsp;🔨 | /2 clock, 8 MHz part | 20.8 |
|  tms7000 |  tms7000  | TMS70C02NL | 3.62&nbsp;🔨 | /2 clock, CMOS | 26.8 |
|  tms7000 |  tms7000  | TMS70C00NL | 3.62&nbsp;🔨 | /2 clock, CMOS | 26.8 |
|  tms7000 |  tms7000  | TMS7001NL-2  | 3.61&nbsp;🔨 | /2 clock | 26.9 |
|  tms7000 |  tms7000  | TMS7001NL-4  | 6.90&nbsp;🔨 | /4 clock | 28.1 |

### TMS9900 family

| arch | core | CPU | MHz | Note | [tms9900](../samples/tms9900/mandelbrot.lst) | [tms9995](../samples/tms9995/mandelbrot.lst) | [tms99105](../samples/tms99105/mandelbrot.lst) |
| :---: | :---: | :---: | ---: | --- | ---: | ---: | ---: |
|  tms9900 |  tms9900  | TMS9900NL |  14.22&nbsp;🔨 | 16bit non mux | 21.3 | | |
|  tms9900 |  tms9980  | TMS9980ANL | 10.00&nbsp;⏱️ | 8bit bus | 38.9 | | |
|  tms9900 |  tms9980  |  TMS9981NL-16  | 10.00&nbsp;⏱️ | 8bit bus | 38.9 | | |
|  tms9900 |  tms9995  |  TMS9995NL-12  | 6.17&nbsp;🔨 | 8bit/fast bus | 13.0 | 8.3 | |
|  tms9900 |  tms99105 |  TMS99105AJDL  | 6.34&nbsp;🔨 | 16bit mux bus | 8.5 | 6.7 | 6.7 |

### 8080 and Z80 family

| arch | core | CPU | MHz | Note | [i8080](../samples/i8080/mandelbrot.lst) | [z80](../samples/z80/mandelbrot.lst) | [z180](../samples/z180/mandelbrot.lst) | [z280](../samples/z280/mandelbrot.lst) | [z380](../samples/z380/mandelbrot.lst) |
| :---: | :---: | :---: | ---: | --- | ---: | ---: | ---: | ---: | ---: |
| i8080  | i8080 | P8080A-1 |  2.50&nbsp;⏱️ | | 49.7 | | | | |
| i8080  | i8085 | P8085AH-2 | 10.00&nbsp;⏱️ | mux bus | 32.2 | | | | |
|  i8086 | v20 |  D70108HCZ-16  |  5.00&nbsp;⏱️ | emulation, 8 bit | 33.2 | | | | |
|  i8086 | v30 | D70116C-8 |  5.00&nbsp;⏱️ | emulation, 16 bit | 23.3 | | | | |
| z80 | z80 |  KL5C80A12CFP  | 18.75&nbsp;⏱️ | fast core/bus | 16.6 | 12.4 | | | |
| z80 | z80 | NSC800N-4I |  8.33&nbsp;⏱️ | mux bus | 33.0 | 27.9 | | | |
| z80 | z80 | Z8400APS | 3.23&nbsp;🔨 | | 33.3 | 28.0 | | | |
| z80 | z180 | HD64180SH10  | 18.75&nbsp;⏱️ | | | 17.8 | 15.2 | | |
| z80 | z180 | Z8018008FSC  | 16.67&nbsp;⏱️ | | | 17.3 | 14.9 | | |
| z80 | z180 | Z8018010VSC  | 16.67&nbsp;⏱️ | | | 17.3 | 14.9 | | |
| z280 | z280 | Z8028012VSC  | 3.78&nbsp;🔨 | mux bus | | 31.1 | | 5.2 | |
| z380 | z380 | Z8038018FSC  | 3.41&nbsp;🔨 | non mux | | 12.1 | 10.2 | | 3.0 |

### 8086 family

| arch | core | CPU | MHz | Note | [i8086](../samples/i8086/mandelbrot.lst) | [i80186](../samples/i8086/mandelbrot_i80186.lst) |
| :---: | :---: | :---: | ---: | --- | ---: | ---: |
|  i8086 | i8086 | P80C88A-2 |  5.00&nbsp;⏱️ | 8bit mux bus | 7.9 | |
|  i8086 | i8086 | P80C86A-2 |  5.00&nbsp;⏱️ | 16bit mux bus | 6.8 | |
|  i8086 | v20 |  D70108HCZ-16  |  5.00&nbsp;⏱️ | 8bit mux bus, fast core  | 4.8 | 4.8 |
|  i8086 | v30 | D70116C-8 |  5.00&nbsp;⏱️ | 16bit mux bus, fast core | 3.5 | 3.5 |
