tgtakaoka/retro-bionic/schematics/base/bionic-base.png

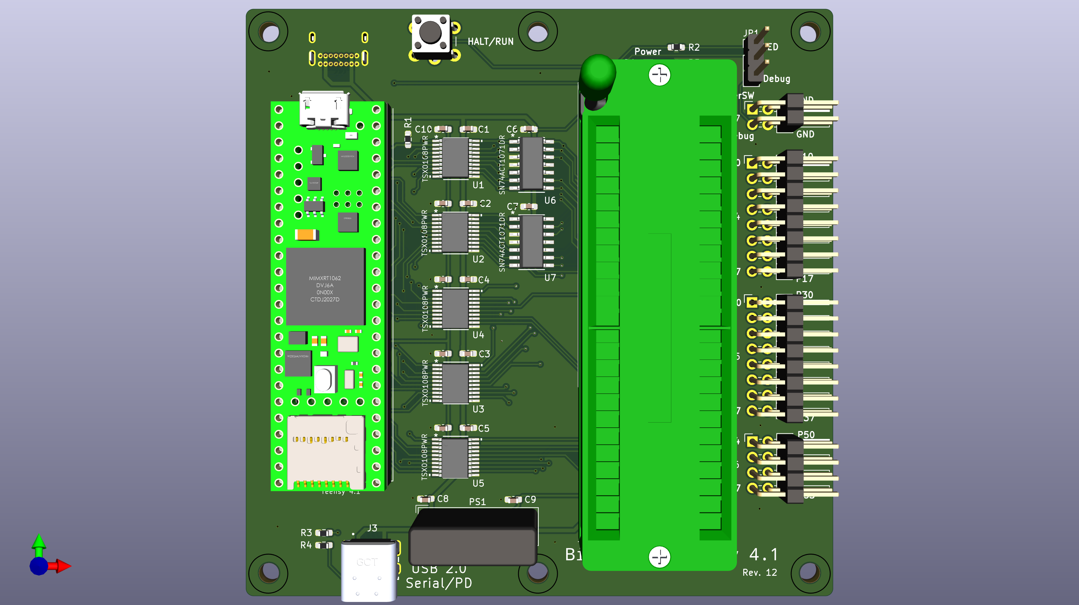
schematics/base/bionic-base.png
