tgtakaoka/retro-bionic/schematics/hd6120/0-LocalLibrary/SOT-23_MC_MCH.step

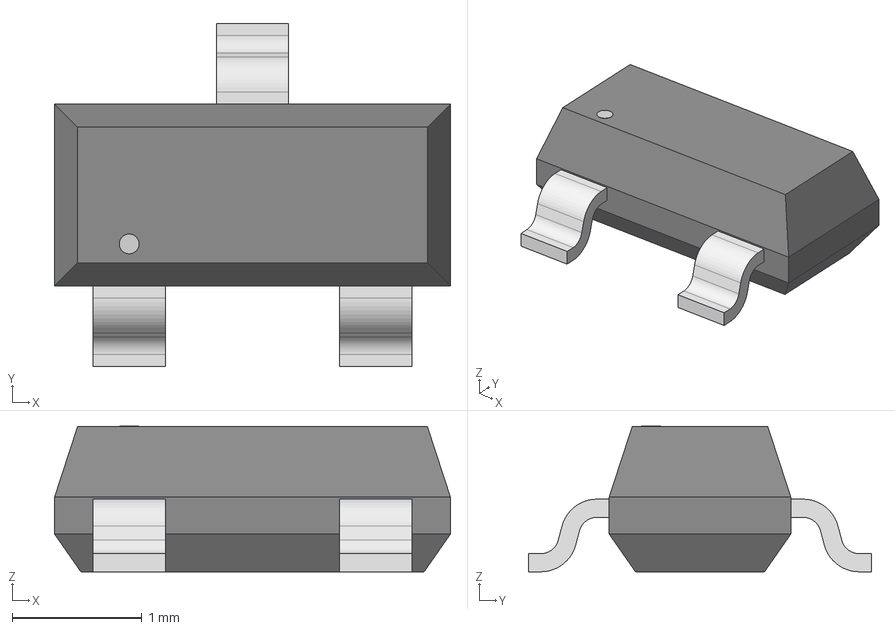
[picture p7: CAD file, 2024-05-01]
schematics/hd6120/0-LocalLibrary/SOT-23_MC_MCH.step
3.05 x 2.64 x 1.12 mm
