tgtakaoka/retro-bionic/schematics/tms99105/0-LocalLibrary/LED_CSL1901UW1_ROM.step

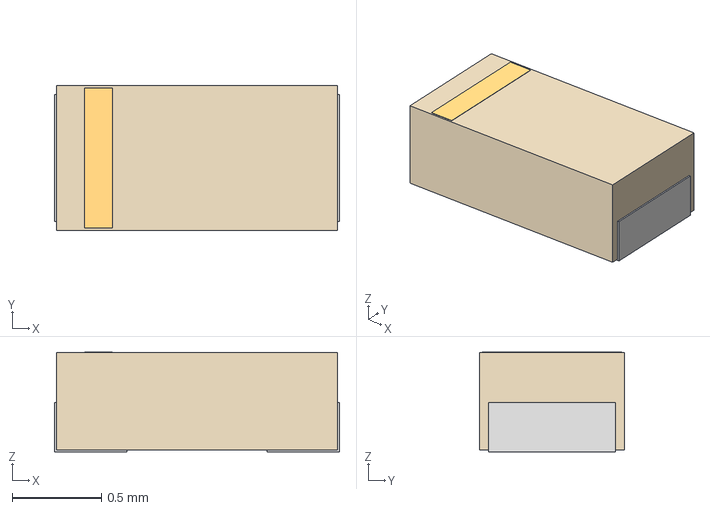
[picture p8: CAD file, 2025-01-11]
schematics/tms99105/0-LocalLibrary/LED_CSL1901UW1_ROM.step
1.60 x 0.812 x 0.561 mm
