tgtakaoka/retro-bionic/(list of files, cad)

Other CAD files:
schematics/hd6120/0-LocalLibrary/LED_CSL1901UW1_ROM.step
schematics/mezzanine/0-LocalLibrary/LED_CSL1901UW1_ROM.step
schematics/im6100/0-LocalLibrary/LED_CSL1901UW1_ROM.step
schematics/ins8060/0-LocalLibrary/LED_CSL1901UW1_ROM.step
schematics/ins8070/0-LocalLibrary/LED_CSL1901UW1_ROM.step
schematics/cdp1802/0-LocalLibrary/LED_CSL1901UW1_ROM.step
schematics/f3850/0-LocalLibrary/LED_CSL1901UW1_ROM.step
schematics/mc146805e2/0-LocalLibrary/LED_CSL1901UW1_ROM.step
schematics/mc6800/0-LocalLibrary/LED_CSL1901UW1_ROM.step
schematics/mc6801/0-LocalLibrary/LED_CSL1901UW1_ROM.step
schematics/mc6802/0-LocalLibrary/LED_CSL1901UW1_ROM.step
schematics/mc6809/0-LocalLibrary/LED_CSL1901UW1_ROM.step
schematics/mc6809e/0-LocalLibrary/LED_CSL1901UW1_ROM.step
schematics/mc68hc05c0/0-LocalLibrary/LED_CSL1901UW1_ROM.step
schematics/mc68hc11a/0-LocalLibrary/LED_CSL1901UW1_ROM.step
schematics/mc68hc11d/0-LocalLibrary/LED_CSL1901UW1_ROM.step
schematics/mn1613/0-LocalLibrary/LED_CSL1901UW1_ROM.step
schematics/mos6502/0-LocalLibrary/LED_CSL1901UW1_ROM.step
schematics/nsc800/0-LocalLibrary/LED_CSL1901UW1_ROM.step
schematics/p8048/0-LocalLibrary/LED_CSL1901UW1_ROM.step
schematics/p8051/0-LocalLibrary/LED_CSL1901UW1_ROM.step
schematics/p8085/0-LocalLibrary/LED_CSL1901UW1_ROM.step
schematics/scn2650/0-LocalLibrary/LED_CSL1901UW1_ROM.step
schematics/tmp90c802/0-LocalLibrary/LED_CSL1901UW1_ROM.step
schematics/tms7000/0-LocalLibrary/LED_CSL1901UW1_ROM.step
schematics/z80/0-LocalLibrary/LED_CSL1901UW1_ROM.step
schematics/z8691/0-LocalLibrary/LED_CSL1901UW1_ROM.step
schematics/z8800/0-LocalLibrary/LED_CSL1901UW1_ROM.step
