tgtakaoka/retro-bionic/schematics/mc9s12d/bionic-mc9s12d.pdf

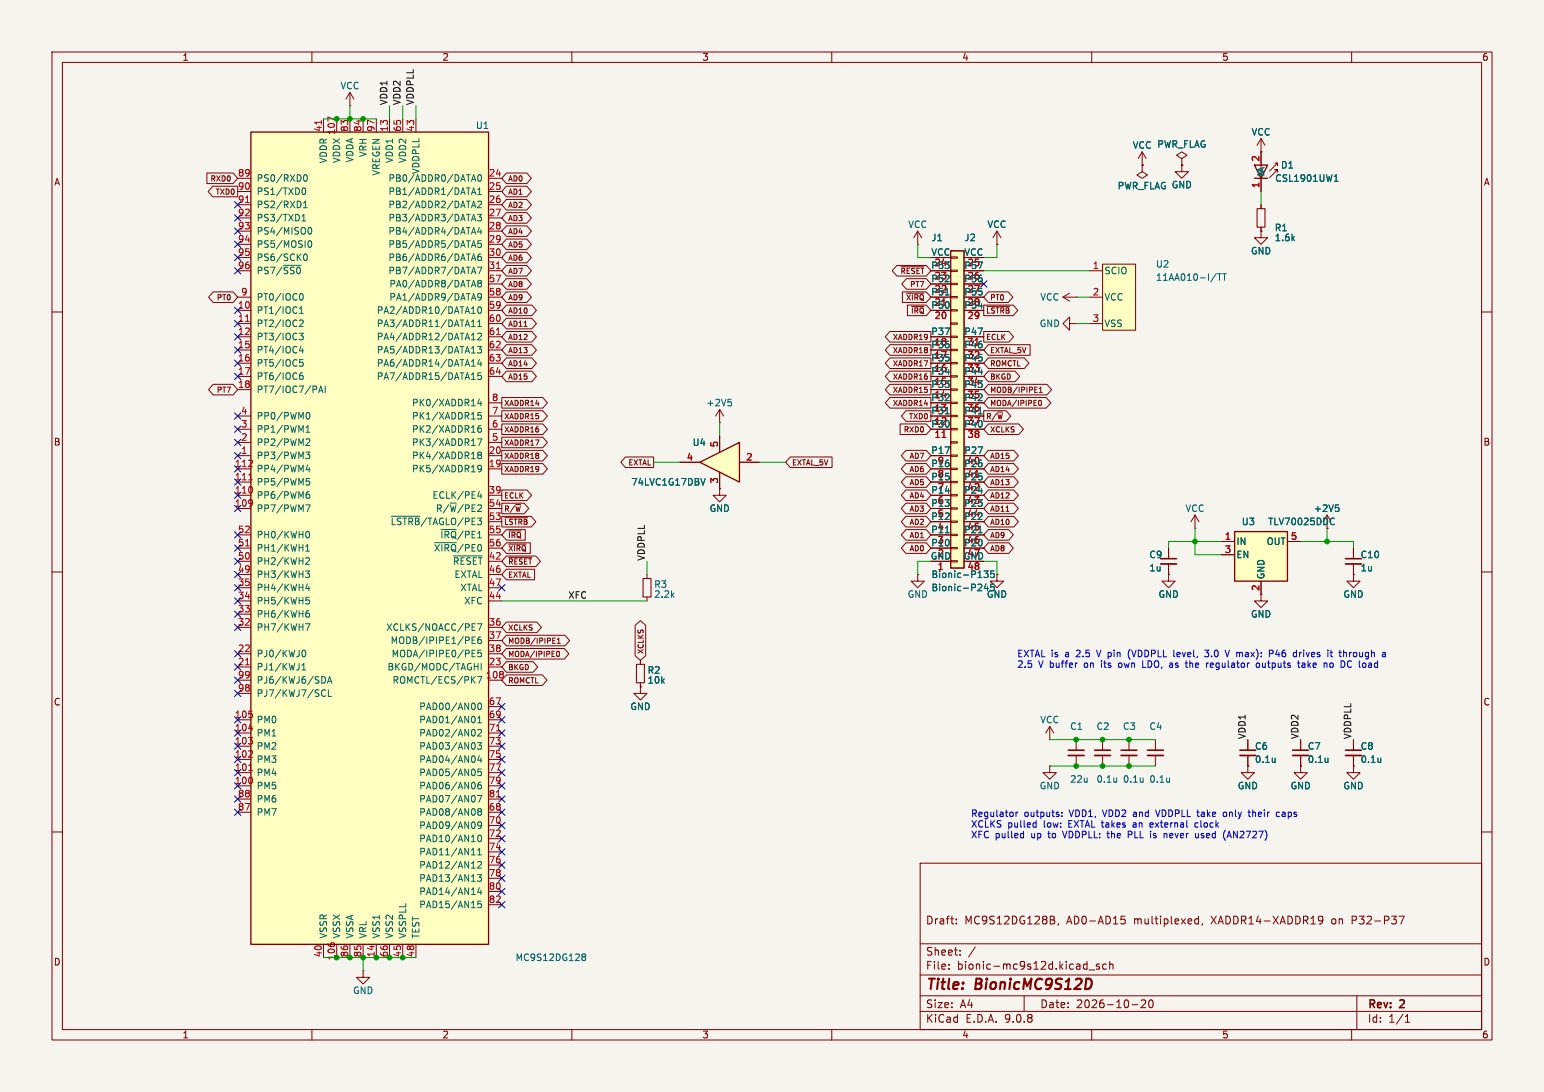
[picture p10: page 1]

~{LSTRB} MODB/IPIPE1 MODA/IPIPE0 XCLKS
