tgtakaoka/retro-bionic/schematics/dct11/bionic-dct11.pdf

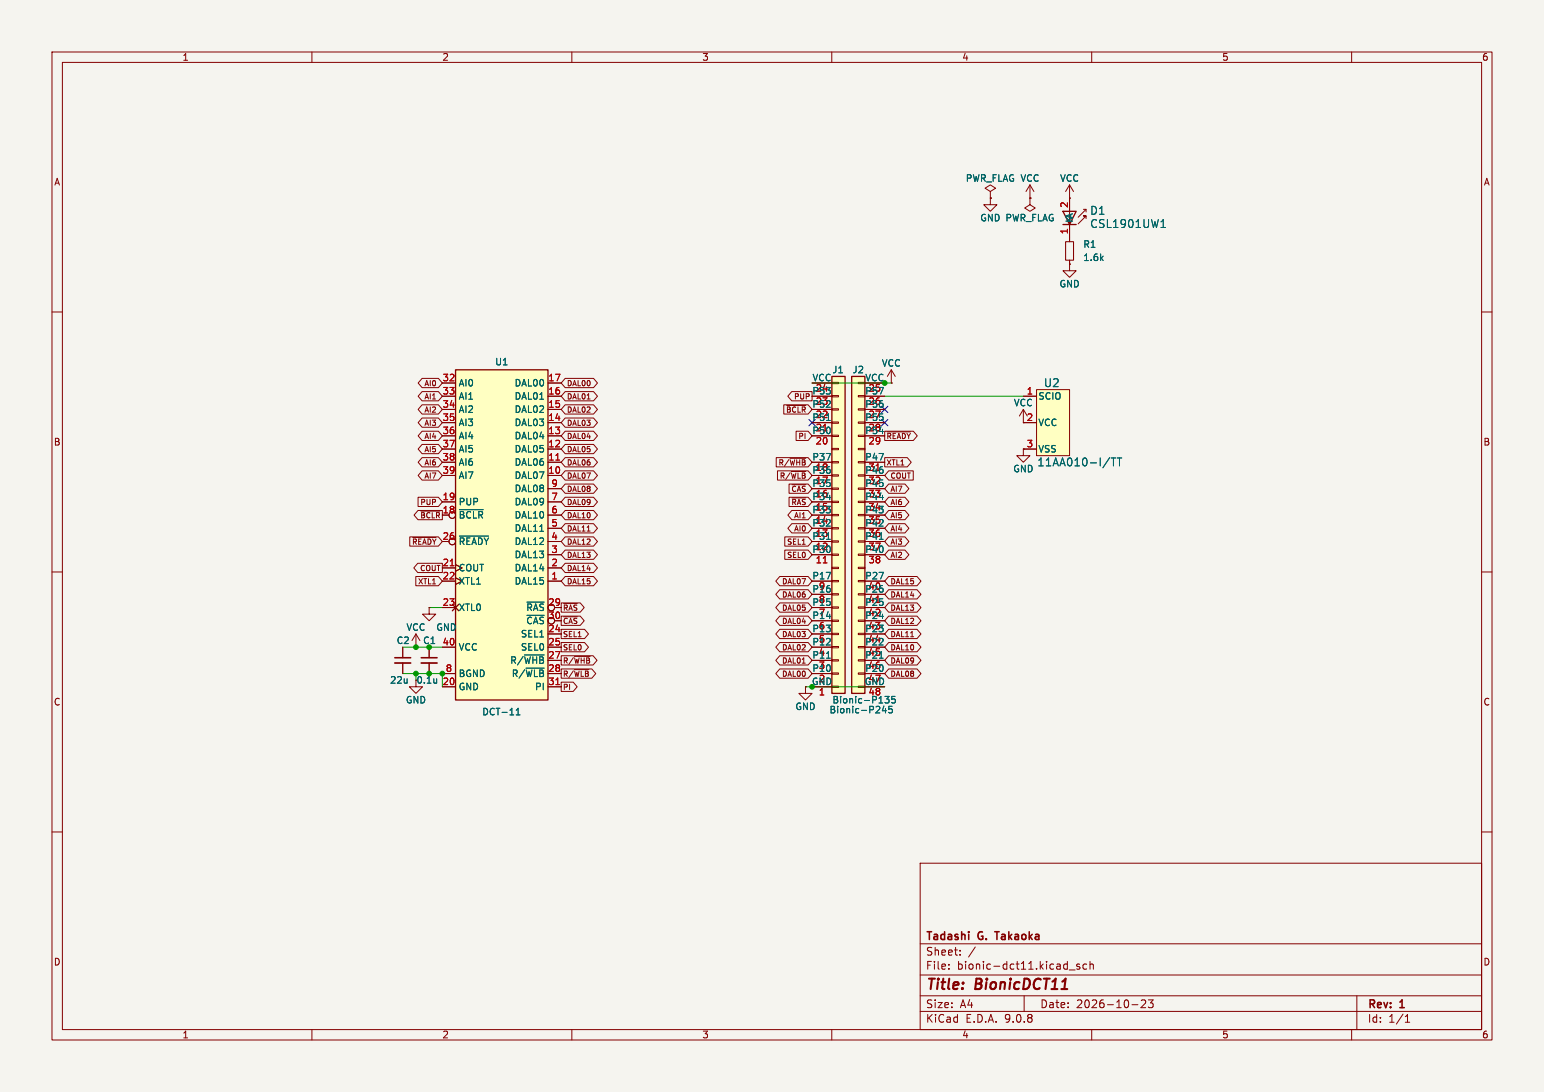
[picture p11: page 1]
