tgtakaoka/retro-bionic/schematics/ns32016/bionic-ns32081.pdf

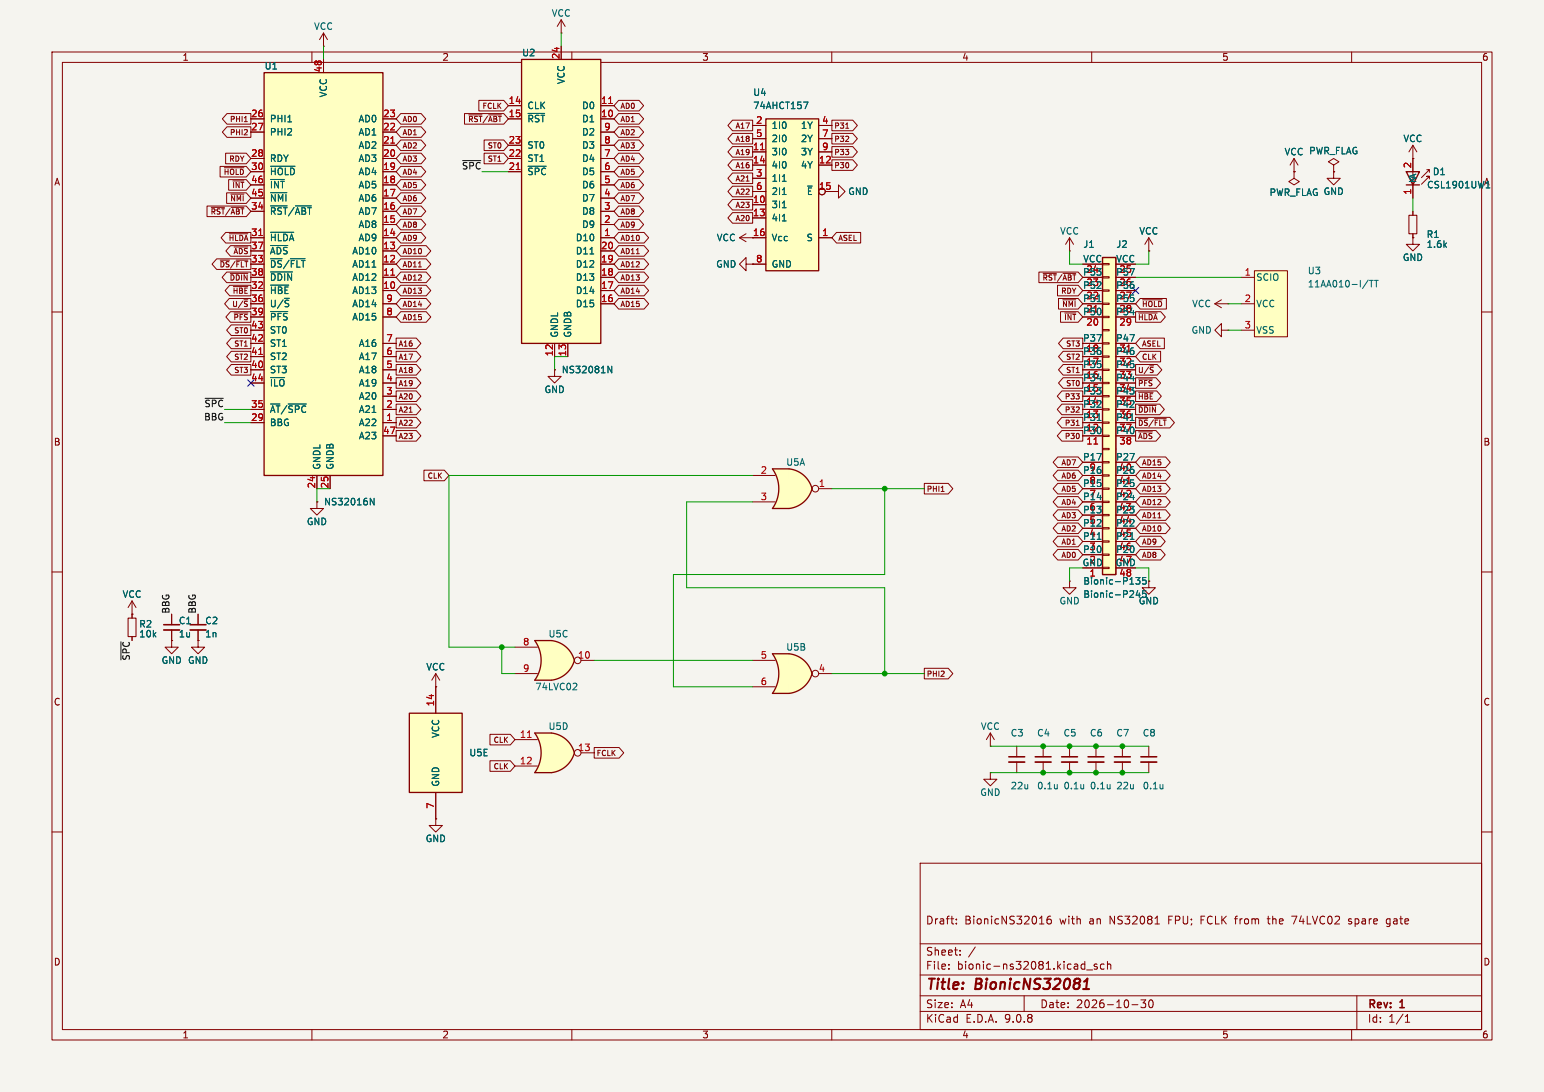
[picture p12: page 1]
