tgtakaoka/retro-bionic/schematics/ns32016/bionic-ns32016.pdf

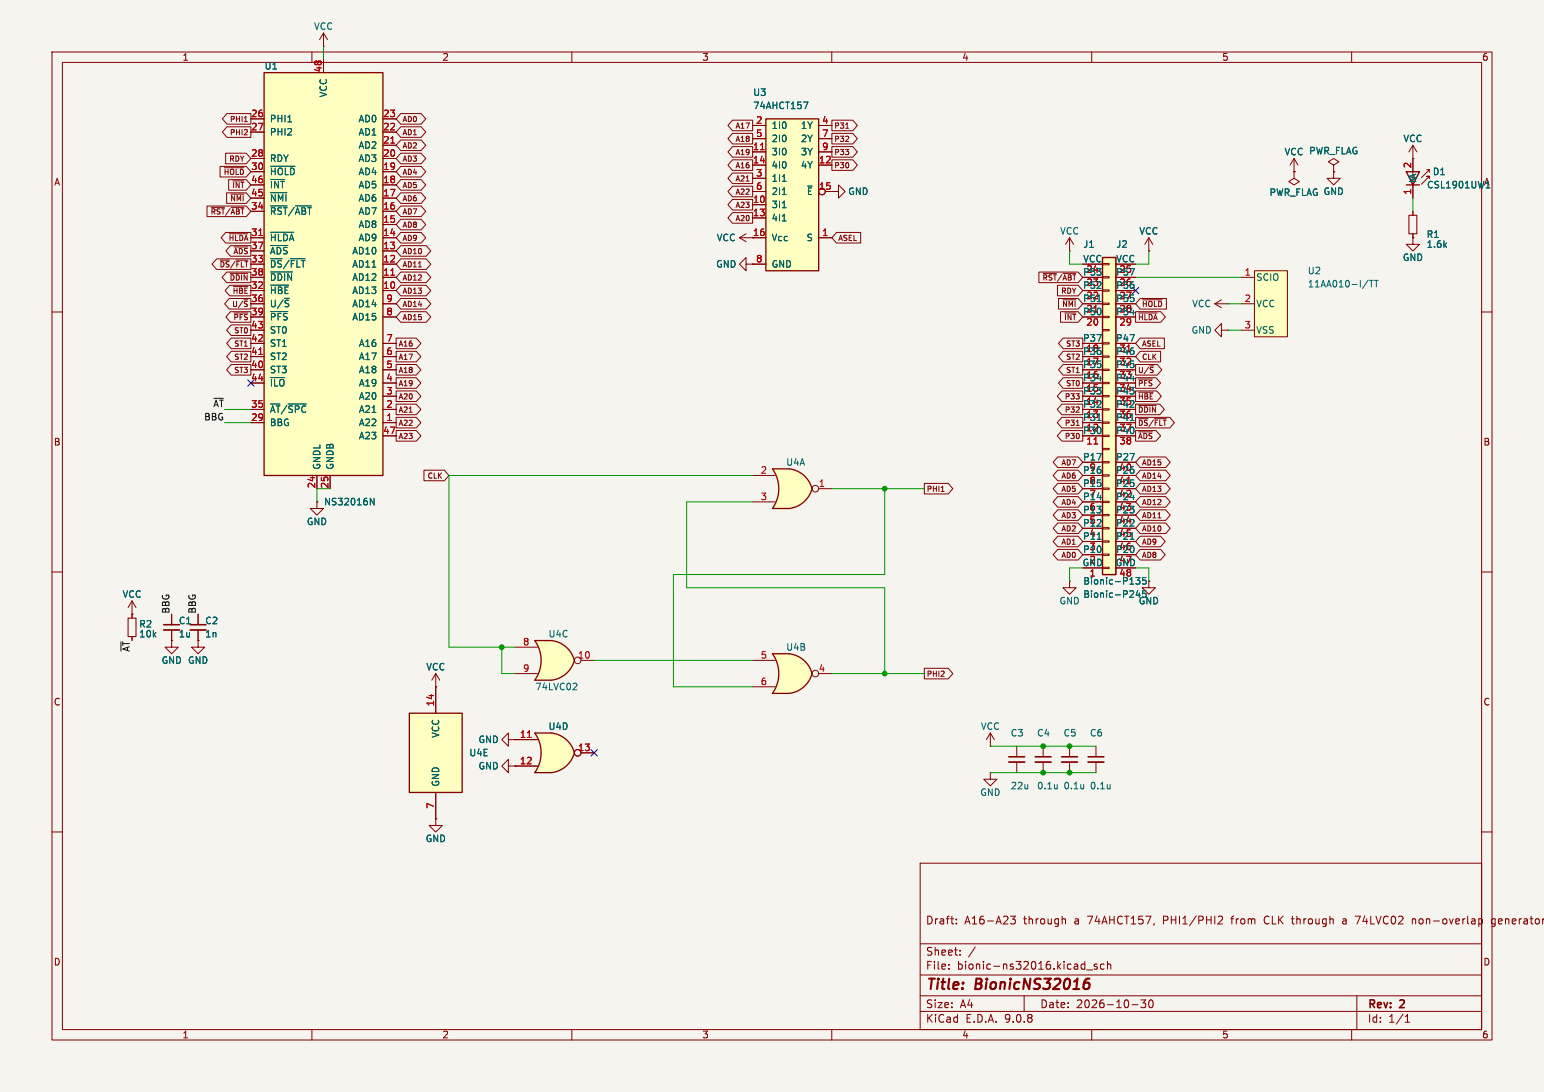
[picture p13: page 1]
