tgtakaoka/retro-bionic/schematics/h8510/bionic-h8510.pdf

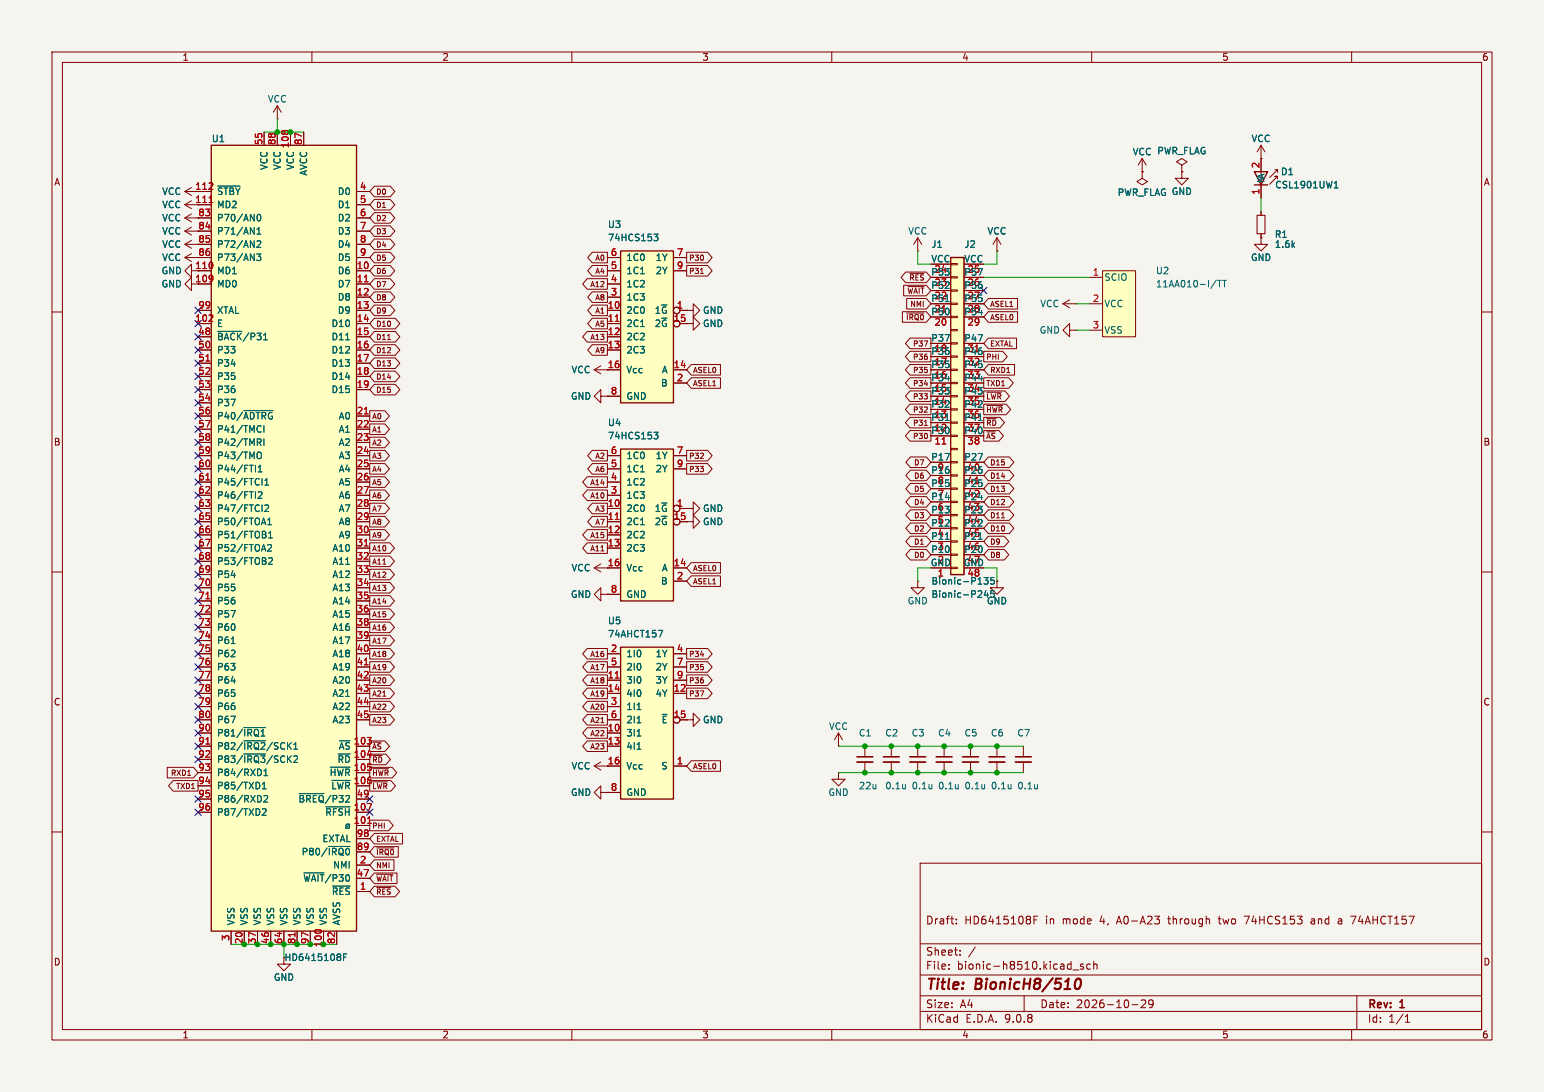
[picture p14: page 1]
