tgtakaoka/retro-bionic/schematics/hd641016/bionic-hd641016.pdf

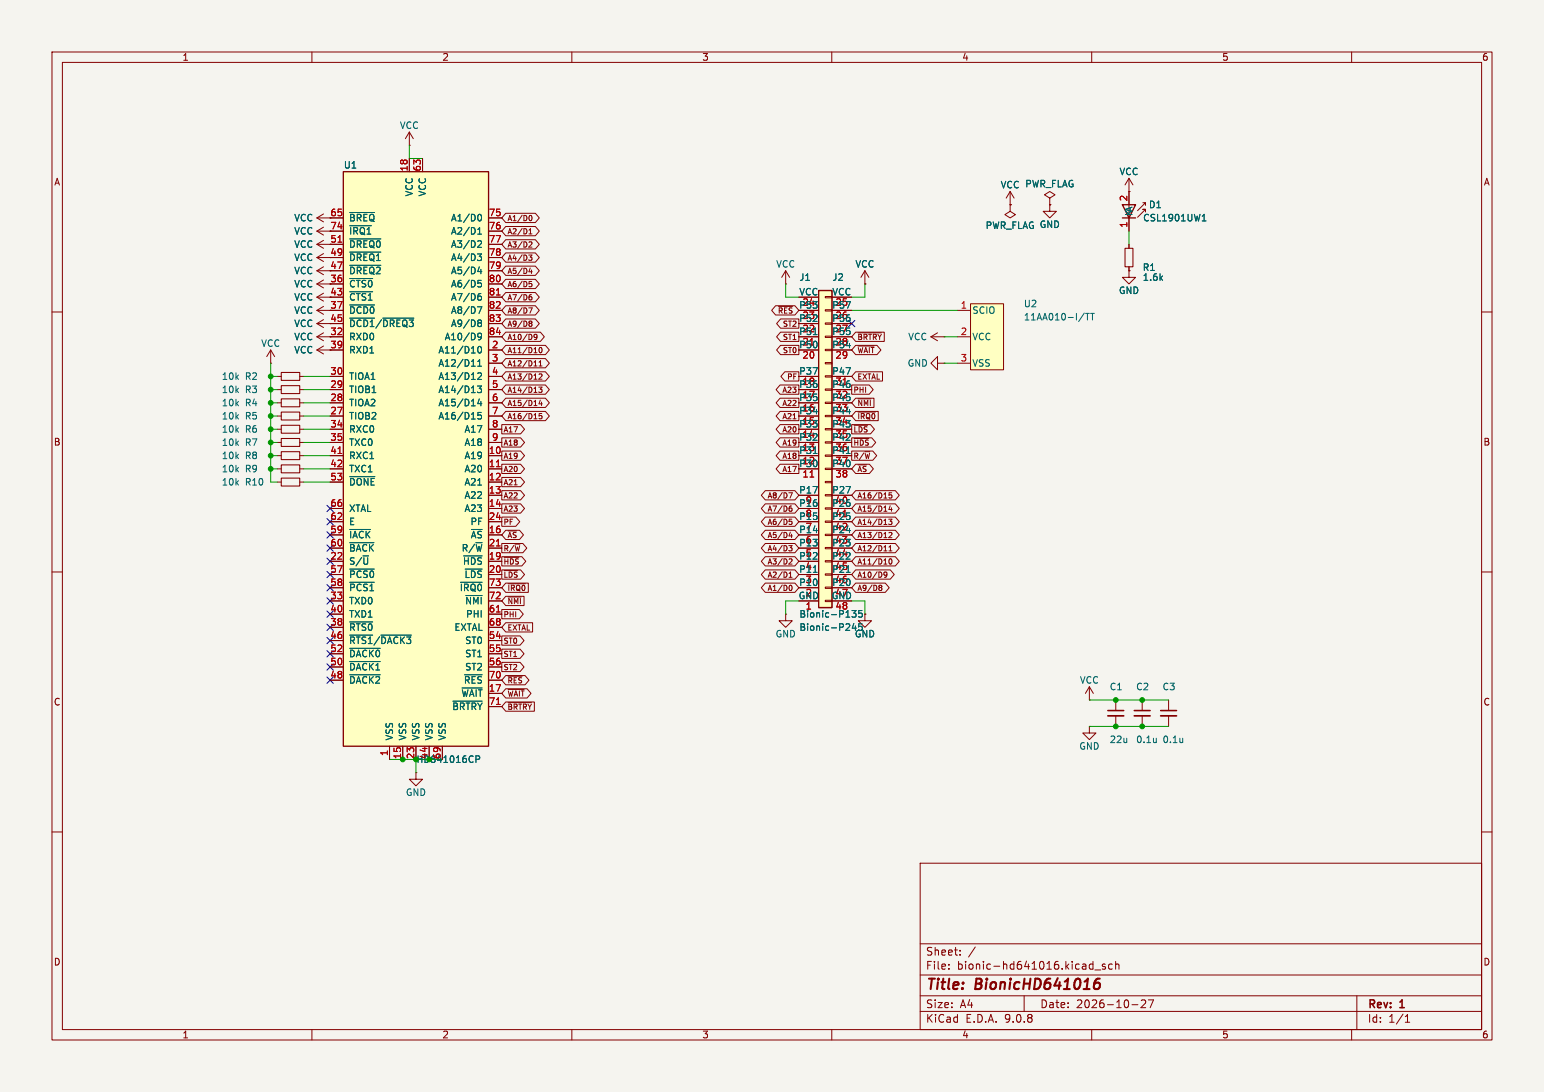
[picture p15: page 1]
