tgtakaoka/retro-bionic/schematics/mc68000/bionic-mc68000fn.pdf

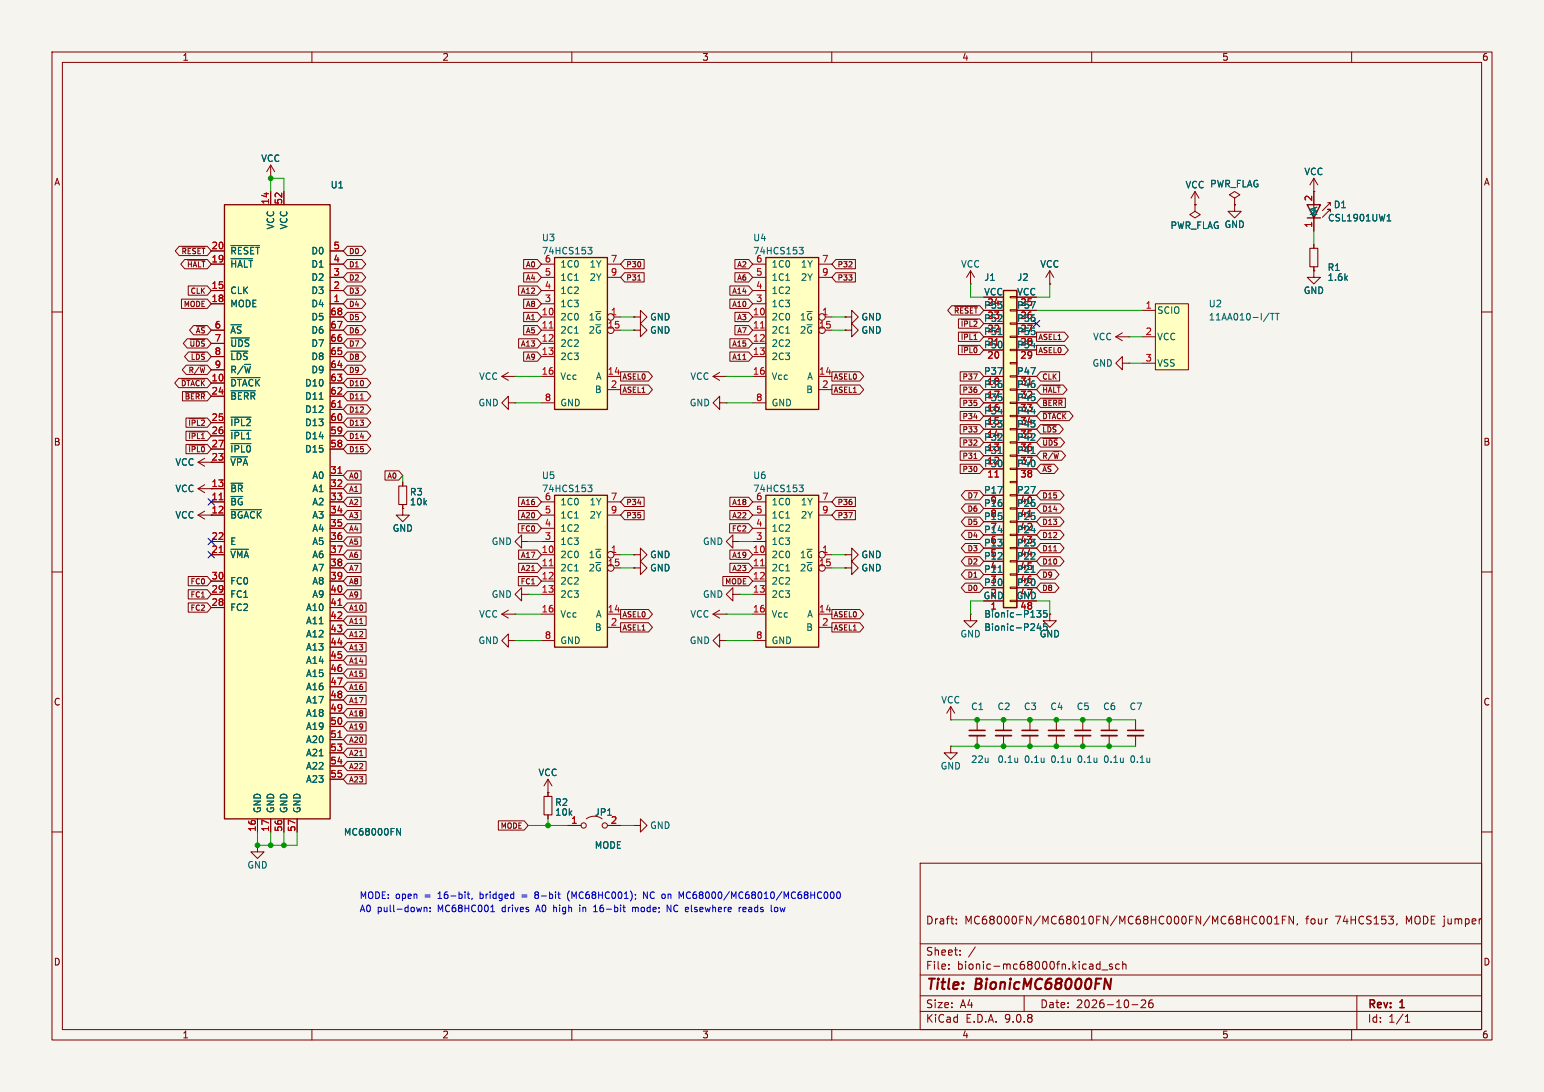
[picture p16: page 1]
