tgtakaoka/retro-bionic/schematics/mc68000/bionic-mc68000p.pdf

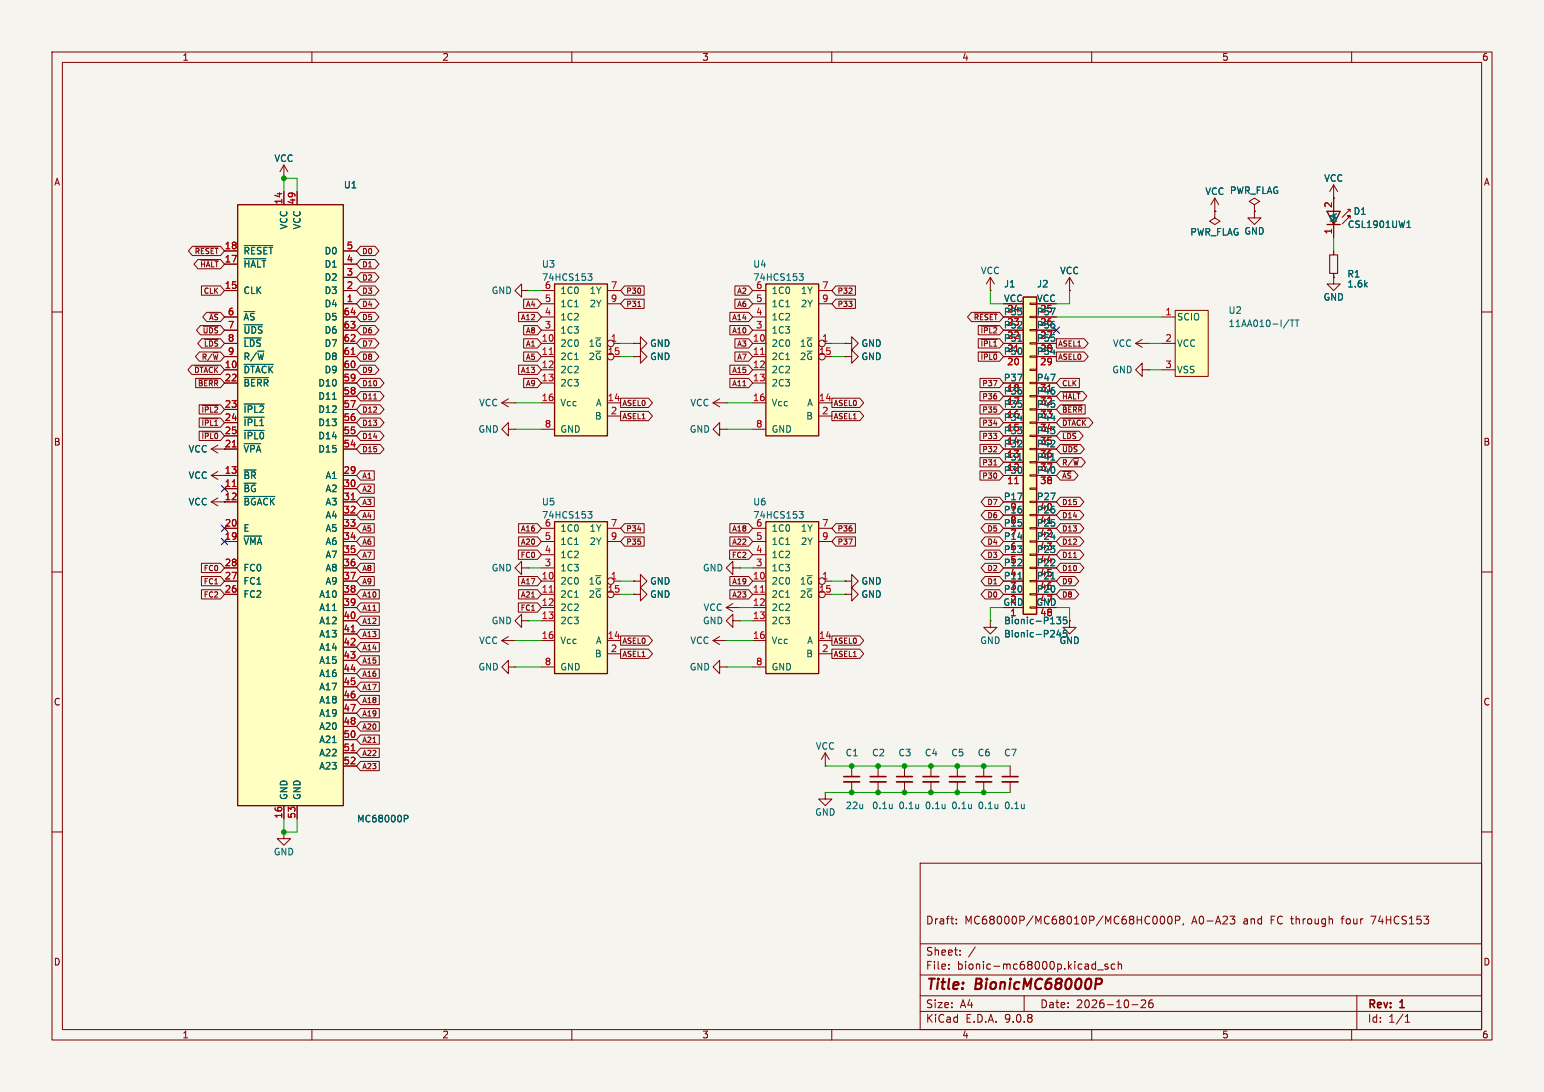
[picture p17: page 1]

~{RESET} 18 ~{HALT} 17 CLK 15 ~{AS} 6 ~{UDS} 7 ~{LDS} 8 R/~{W} 9 ~{DTACK} 10 ~{BERR} 22 ~{IPL2} 23 ~{IPL1} 24 ~{IPL0} 25 ~{VPA} 21 ~{BR} 13 ~{BG} 11 ~{BGACK} 12 E

VCC
