tgtakaoka/retro-bionic/schematics/p8086/bionic-d8087.pdf

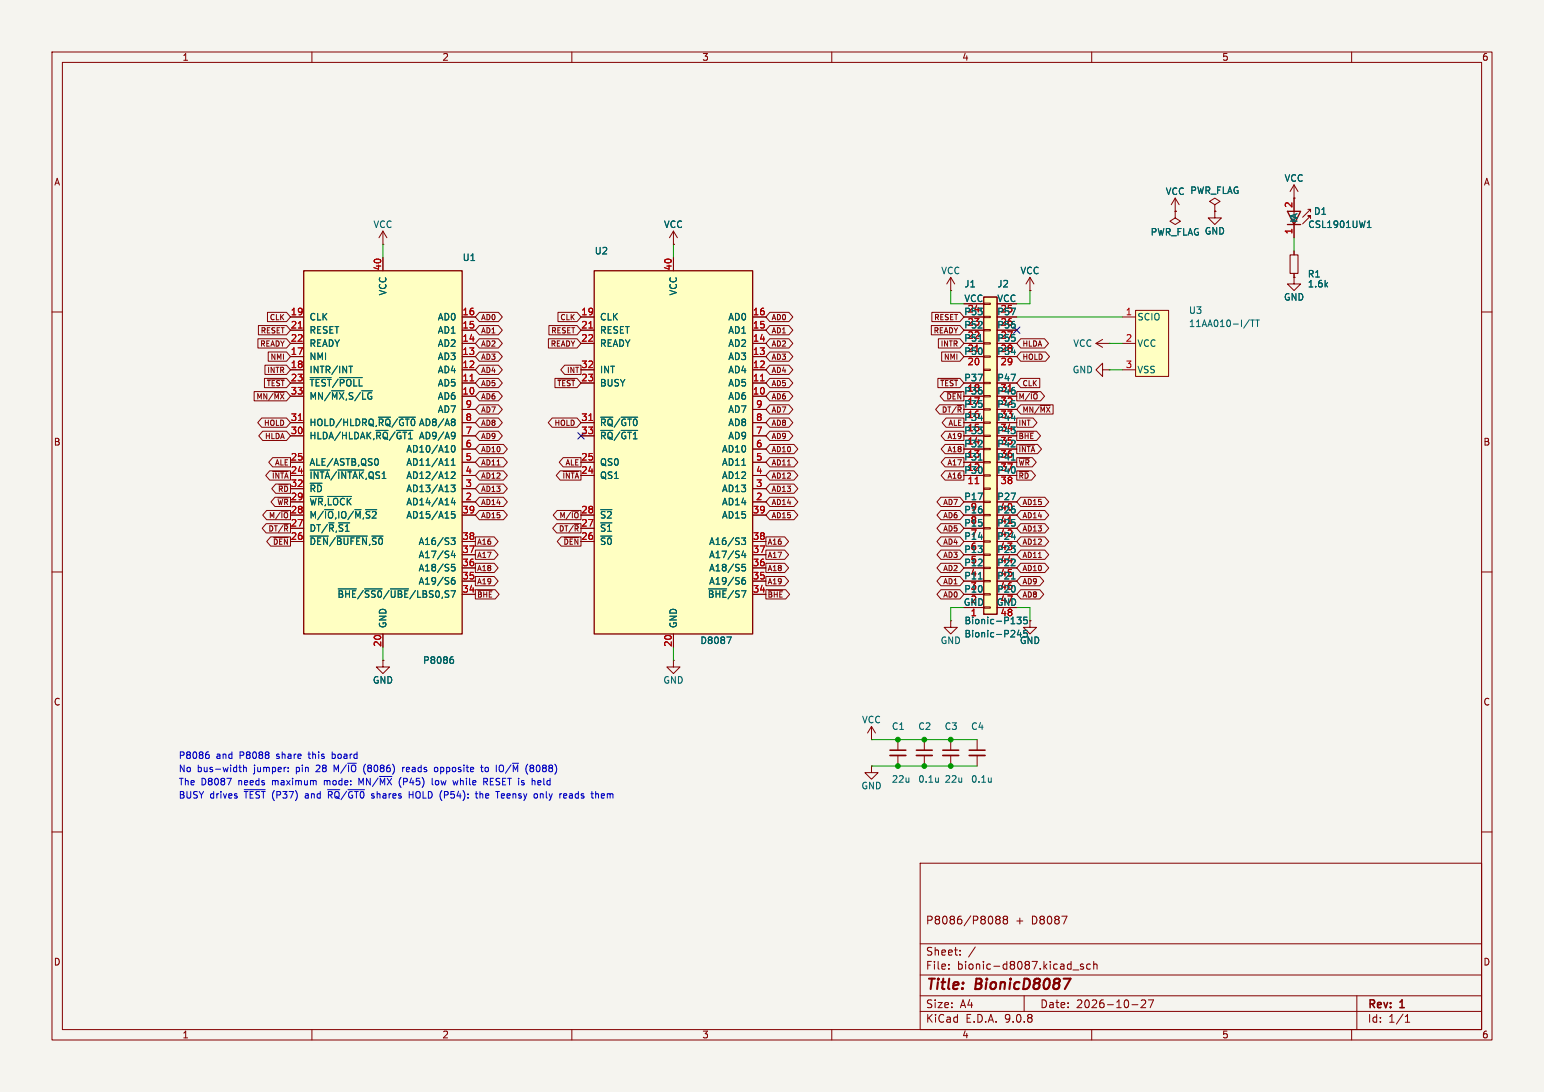
[picture p18: page 1]

1 D1 VCC VCC CSL1901UW1 CLK 19 RESET 21 READY 22

~{TEST} READY CLK RESET
NMI MN/~{MX} HOLD
INTR
