tgtakaoka/retro-bionic/schematics/p8086/bionic-p8086.pdf

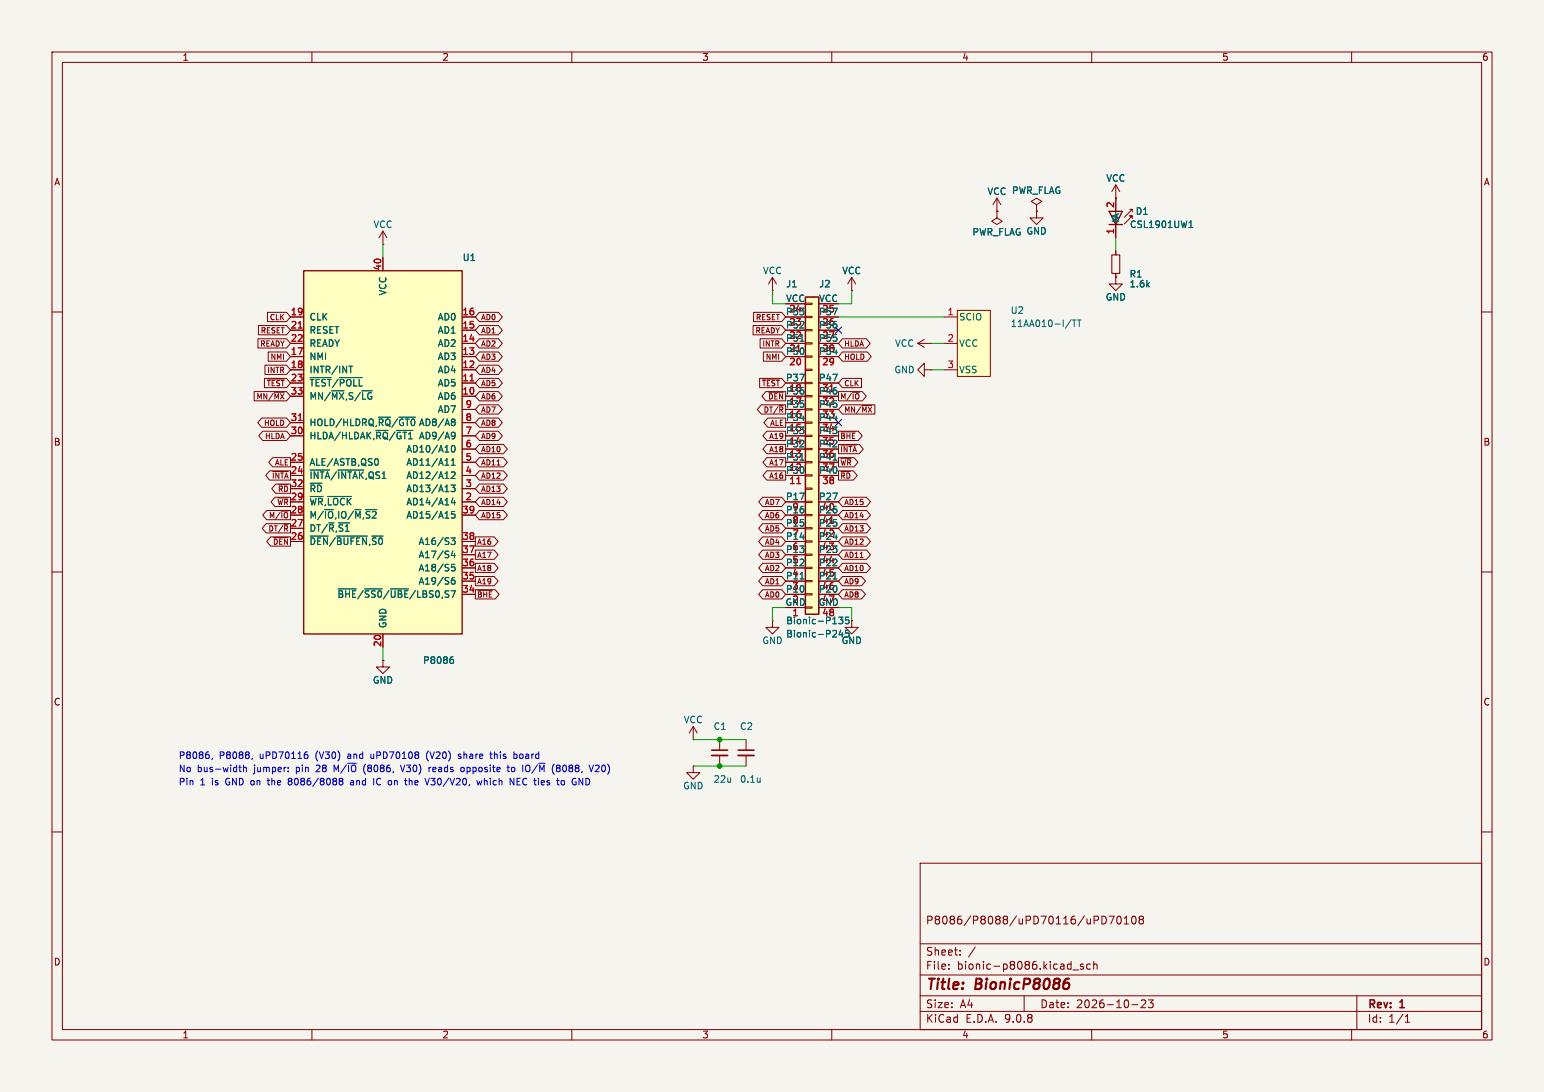
[picture p19: page 1]
