tgtakaoka/retro-bionic/schematics/mc68hc16z/bionic-mc68hc16z.pdf

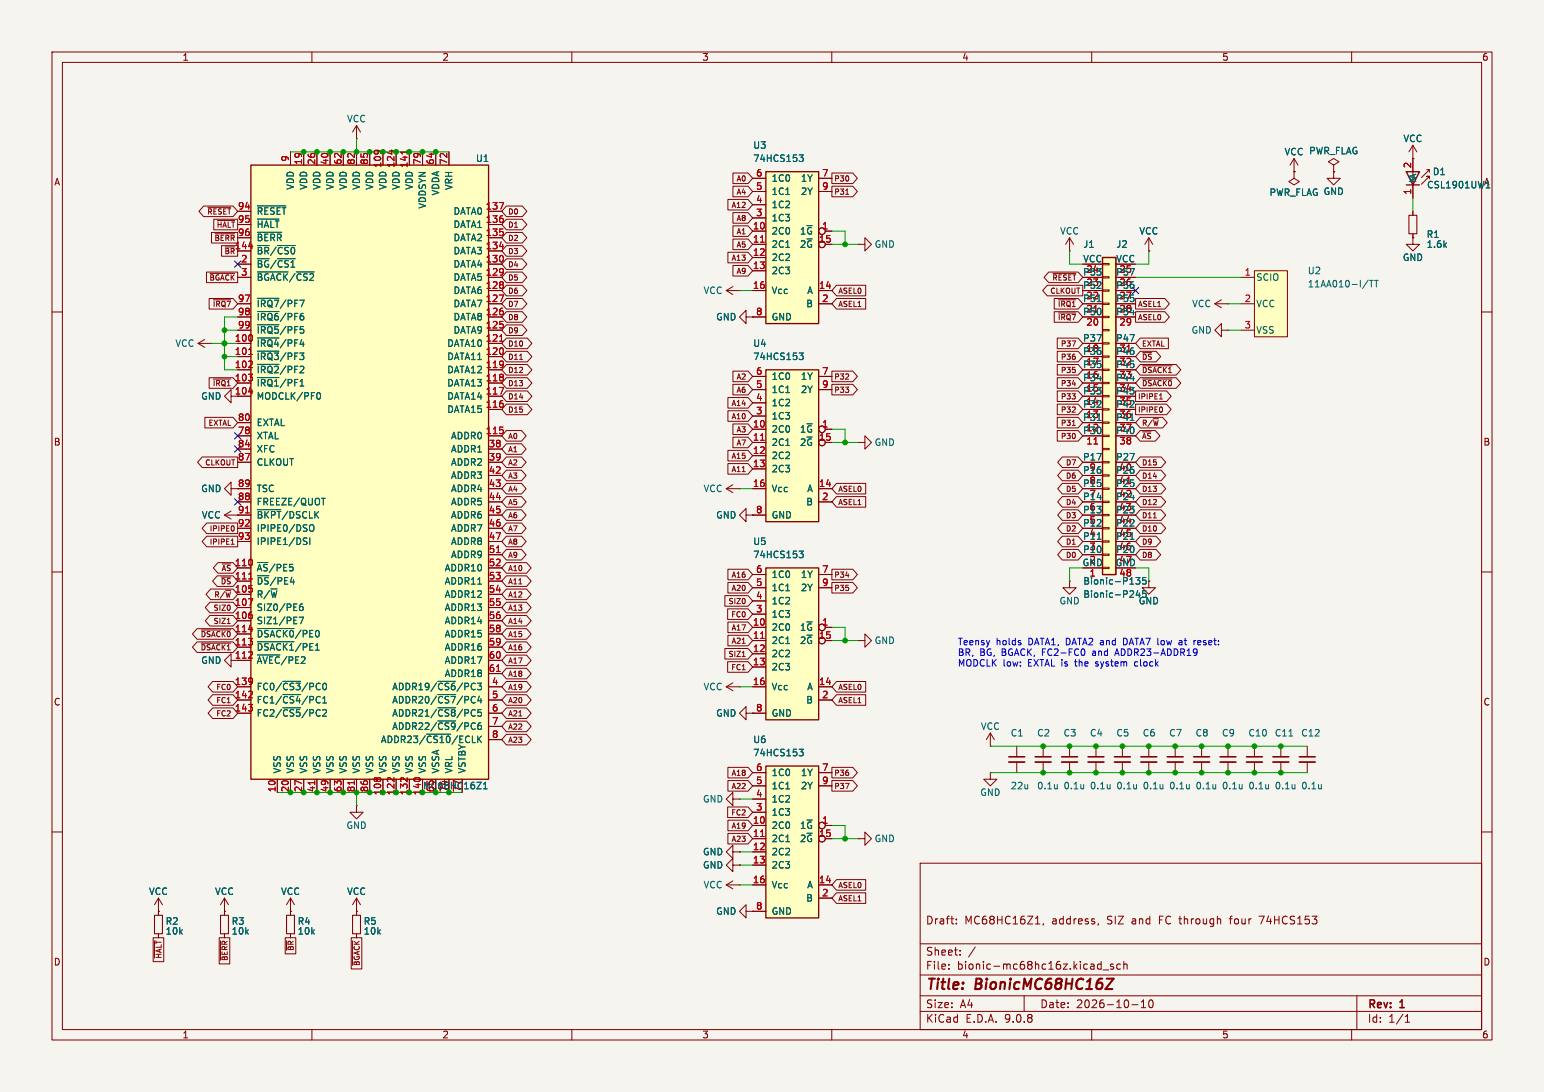
[picture p20: page 1]

VCC
~{RESET} 94 ~{HALT} 95 ~{BERR} 96 ~{BR}/~{CS0} 144 ~{BG}/~{CS1} 2 ~{BGACK}/~{CS2} 3 ~{IRQ7}/PF7 97 ~{IRQ6}/PF6 98 ~{IRQ5}/PF5 99 ~{IRQ4}/PF4 100 ~{IRQ3}/PF3 101 ~{IRQ2}/PF2 102 ~{IRQ1}/PF1 103 MODCLK/PF0 104 EXTAL 80 XTAL 78 XFC 84 CLKOUT 87 TSC 89 FREEZE/QUOT 88 ~{BKPT}/DSCLK 91
