tgtakaoka/retro-bionic/schematics/s80296sa/bionic-s80296sa.pdf

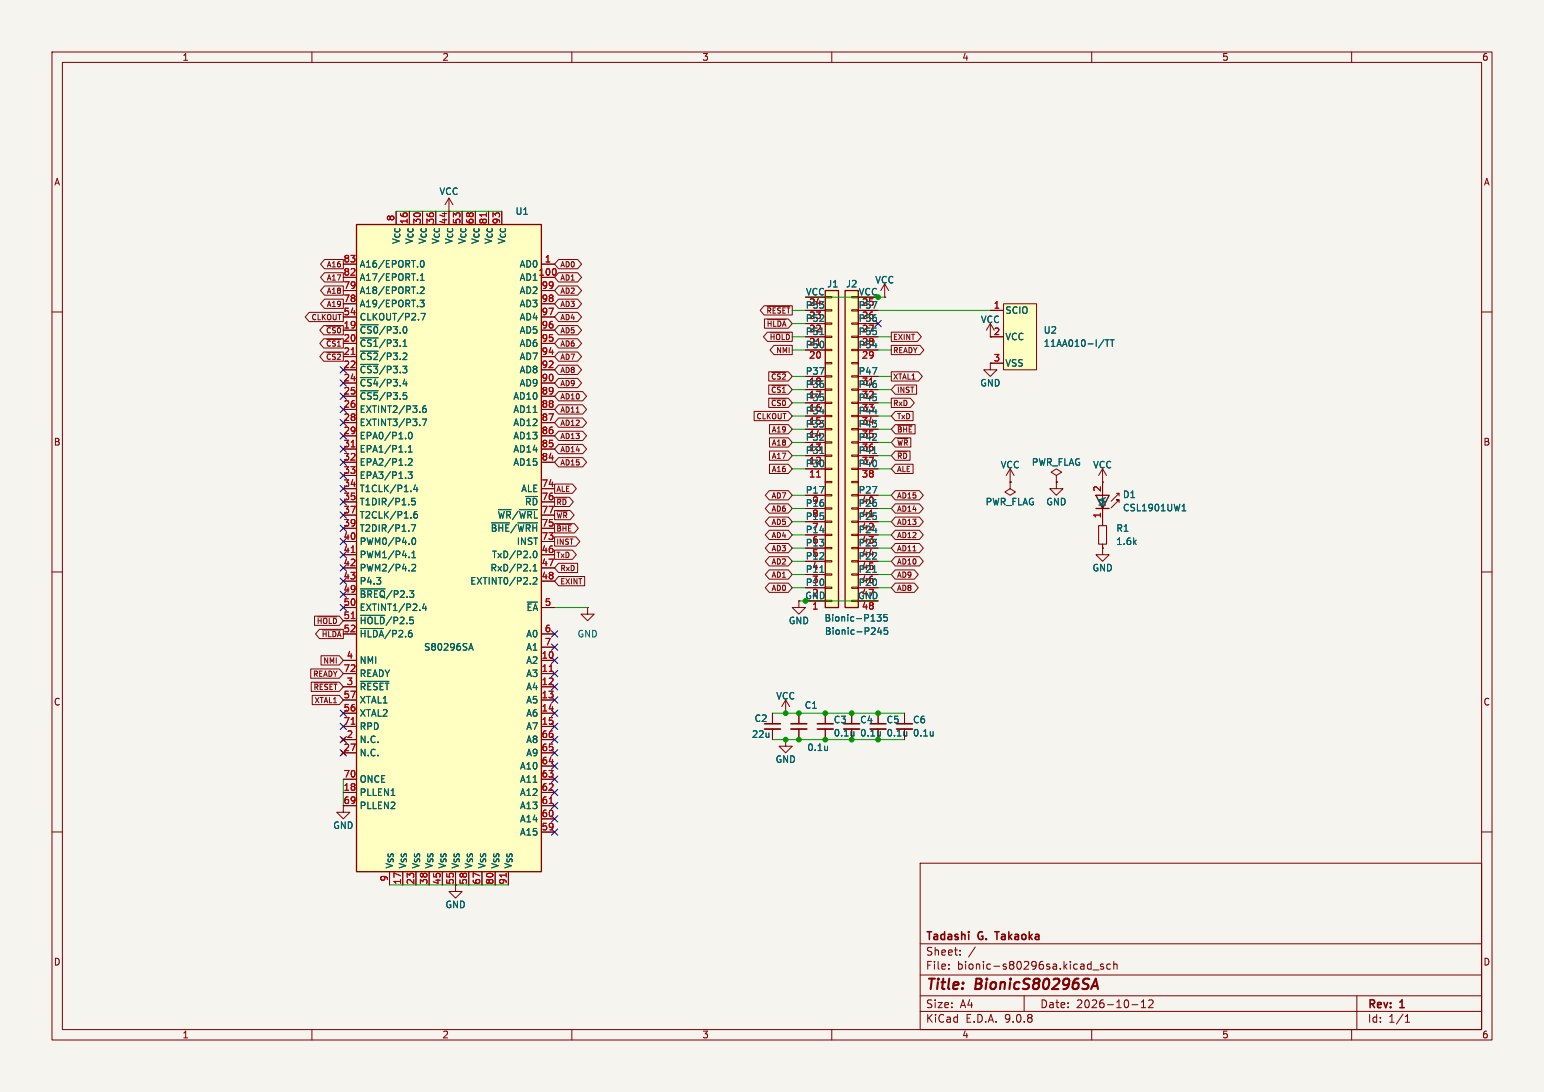
[picture p21: page 1]
