tgtakaoka/retro-bionic/schematics/mc68hc12b/bionic-mc68hc12b.pdf

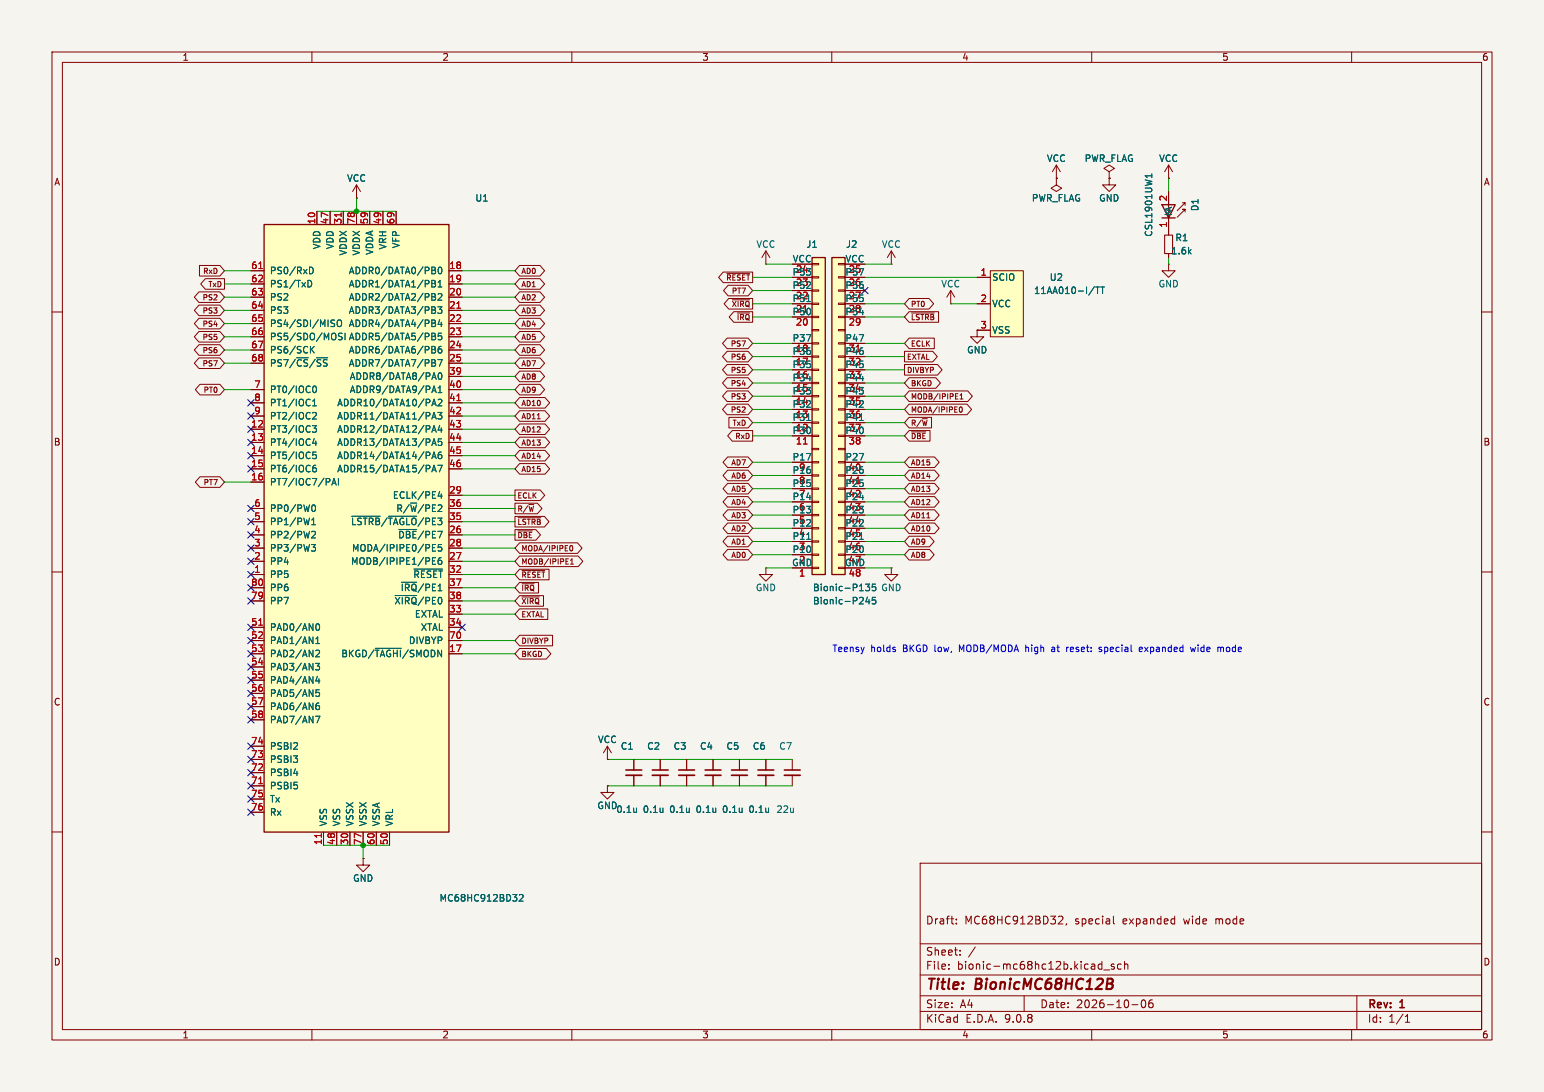
[picture p22: page 1]
