tgtakaoka/retro-bionic/schematics/n8097/bionic-n8097.pdf

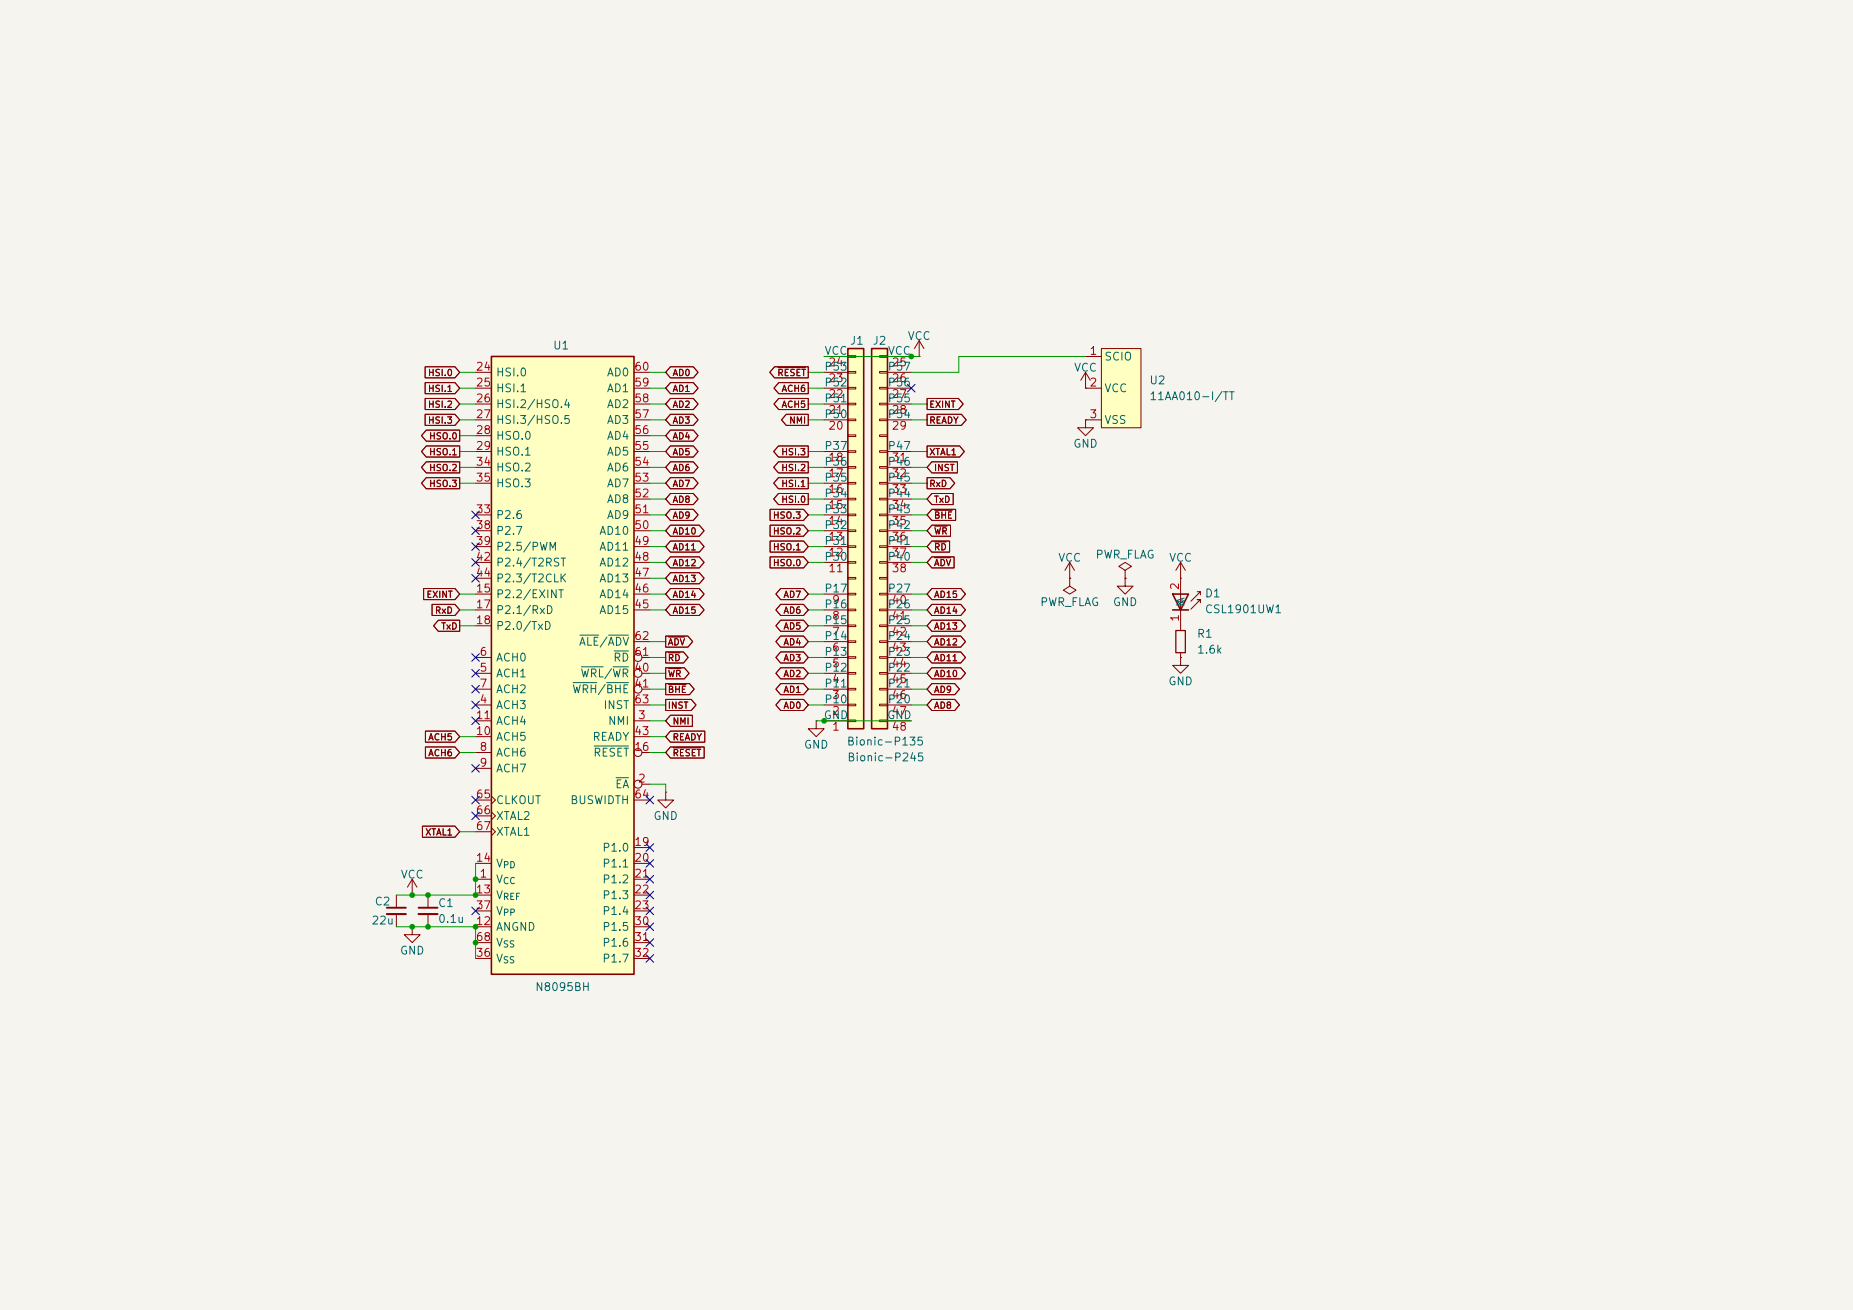
[picture p23: page 1]
