tgtakaoka/retro-bionic/schematics/z8001/bionic-z8001.pdf

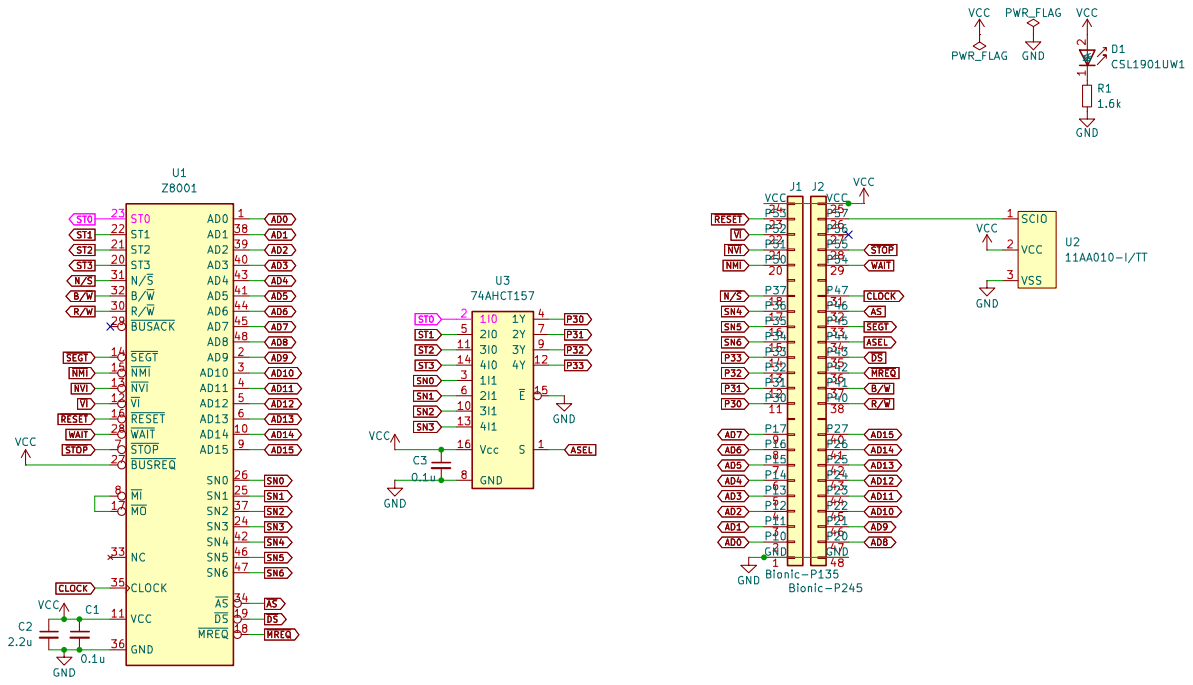
[picture p24: page 1]
