tgtakaoka/retro-bionic/schematics/z8002/bionic-z8002.pdf

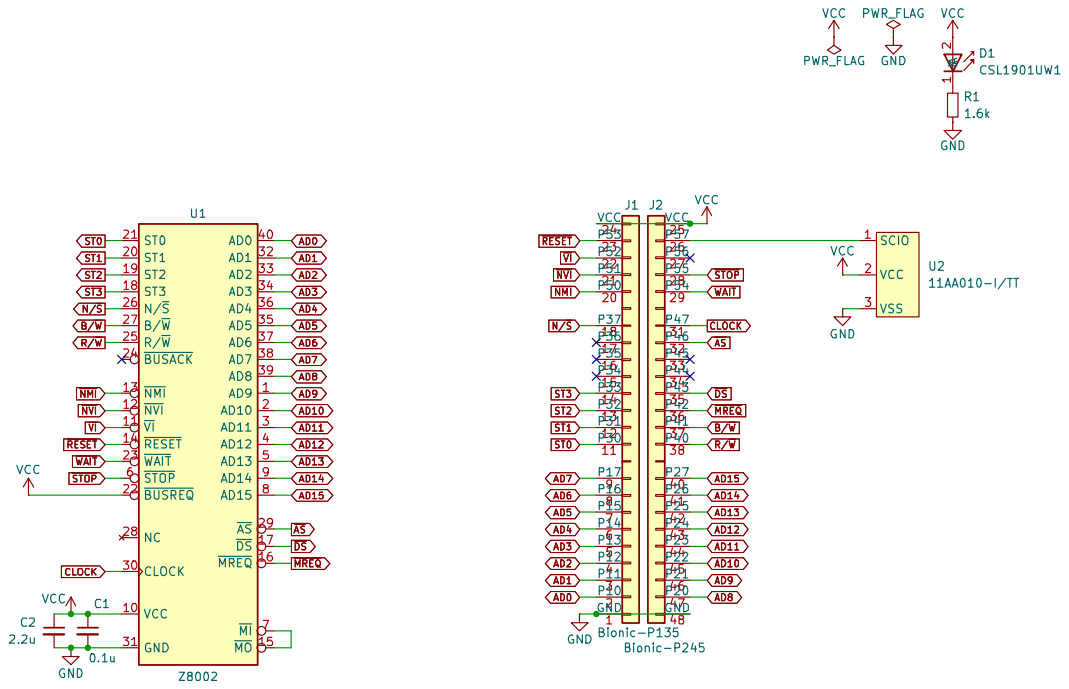
[picture p25: page 1]
