tgtakaoka/retro-bionic/schematics/z380/bionic-z380.pdf

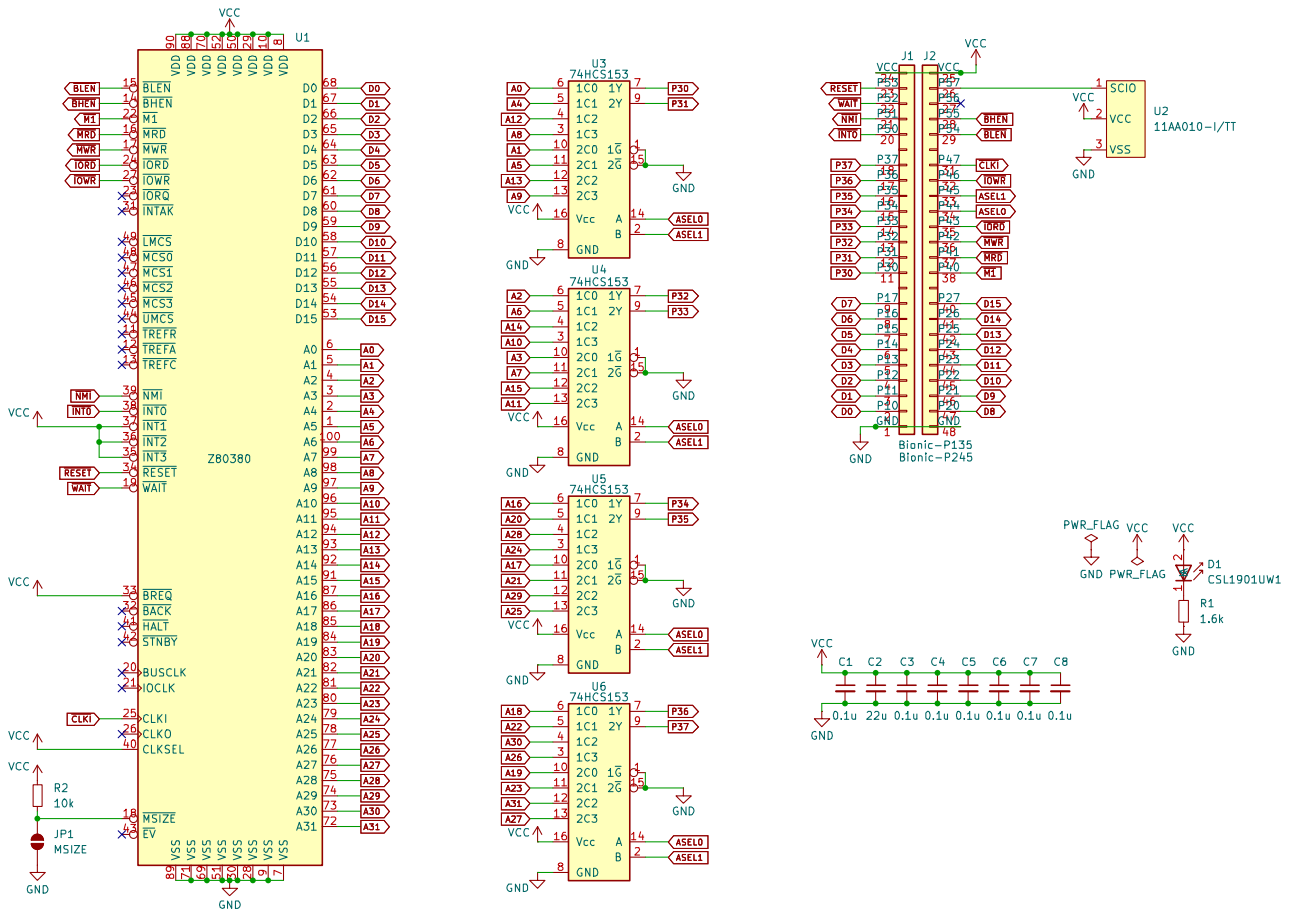
[picture p26: page 1]
