tgtakaoka/retro-bionic/schematics/z280/bionic-z280.pdf

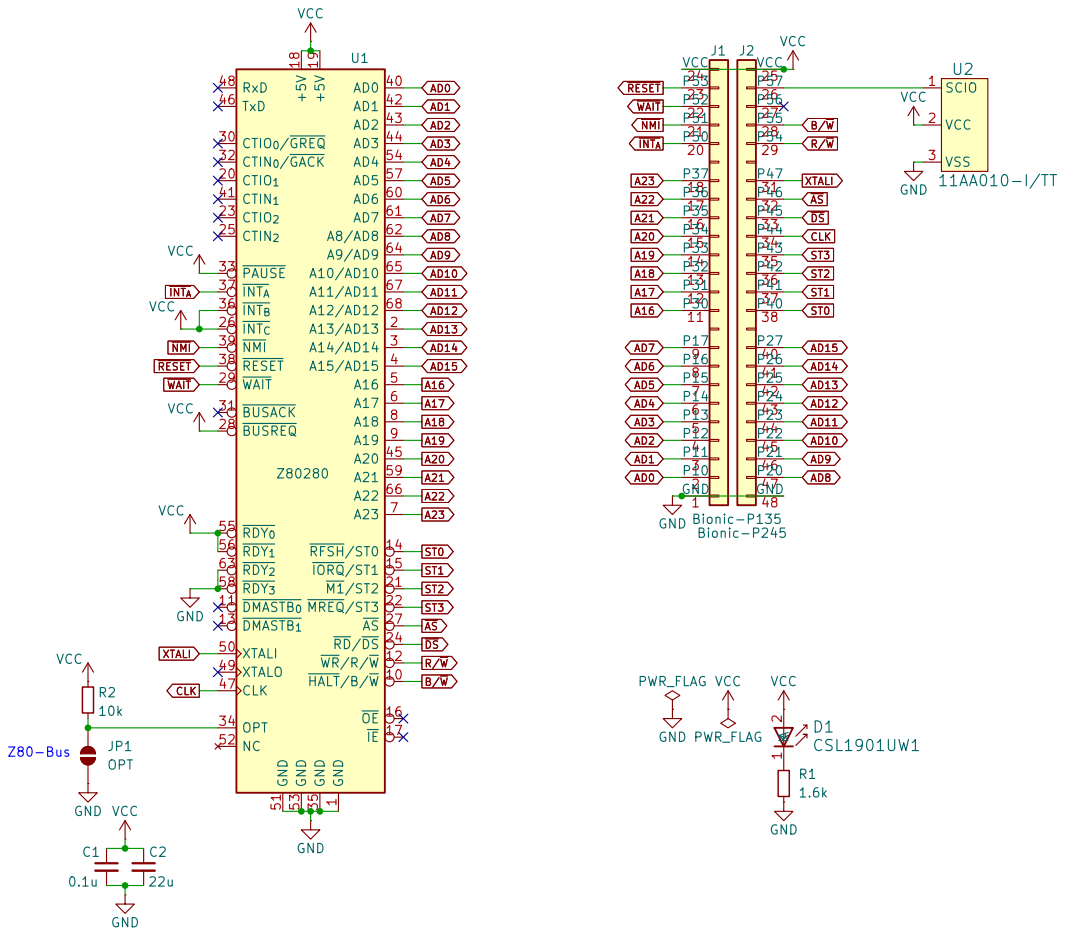
[picture p27: page 1]
