tgtakaoka/retro-bionic/schematics/hd64180s/bionic-hd64180s.pdf

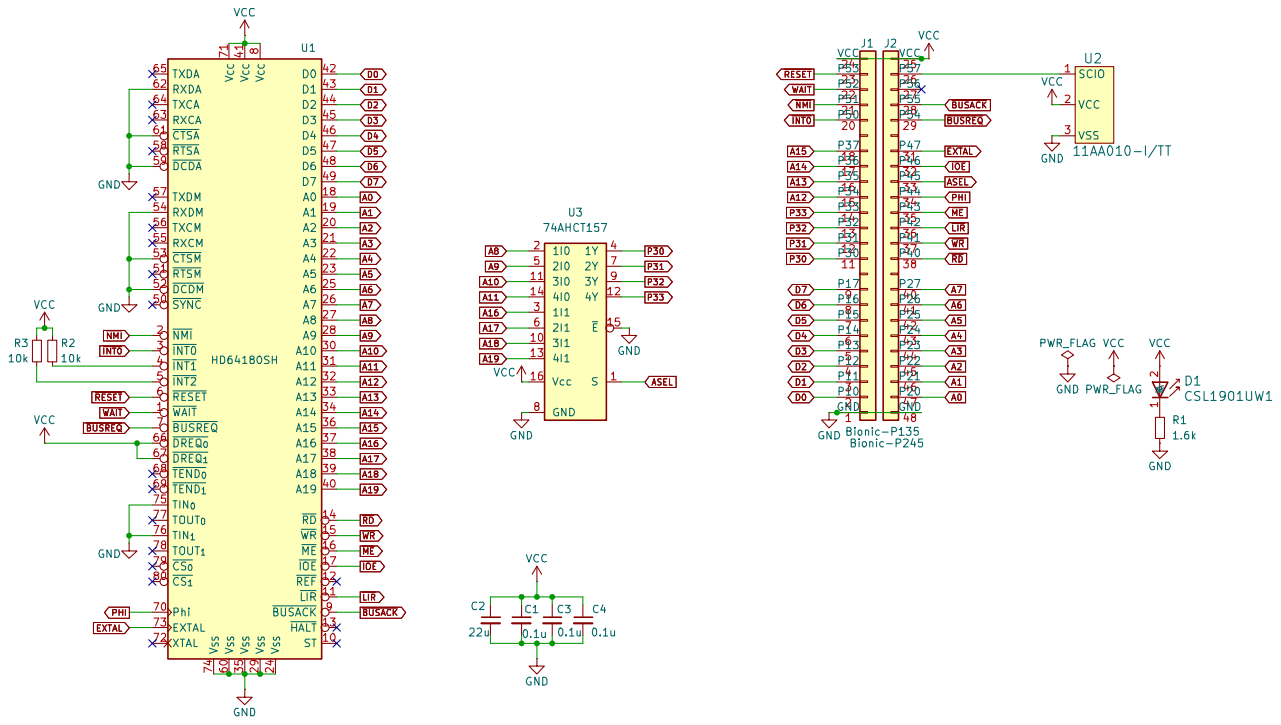
[picture p28: page 1]
