tgtakaoka/retro-bionic/schematics/p8095/bionic-p8095.pdf

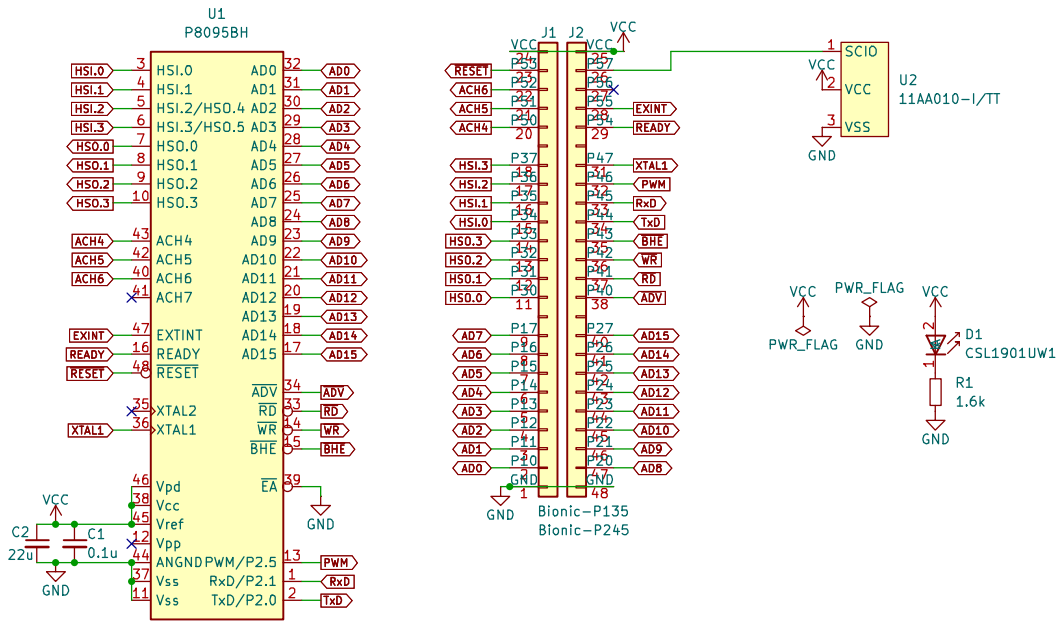
[picture p29: page 1]
