tgtakaoka/retro-bionic/schematics/tms370cx5x/bionic-tms370cx5x.pdf

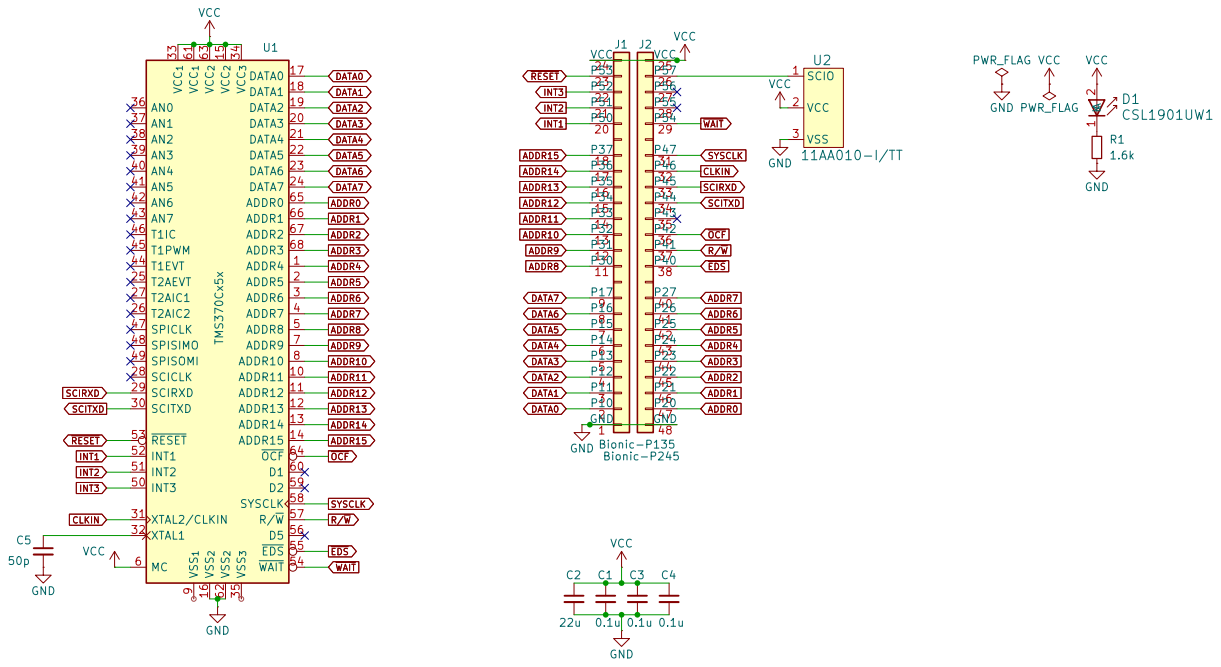
[picture p30: page 1]
