tgtakaoka/retro-bionic/schematics/z180/bionic-z180f.pdf

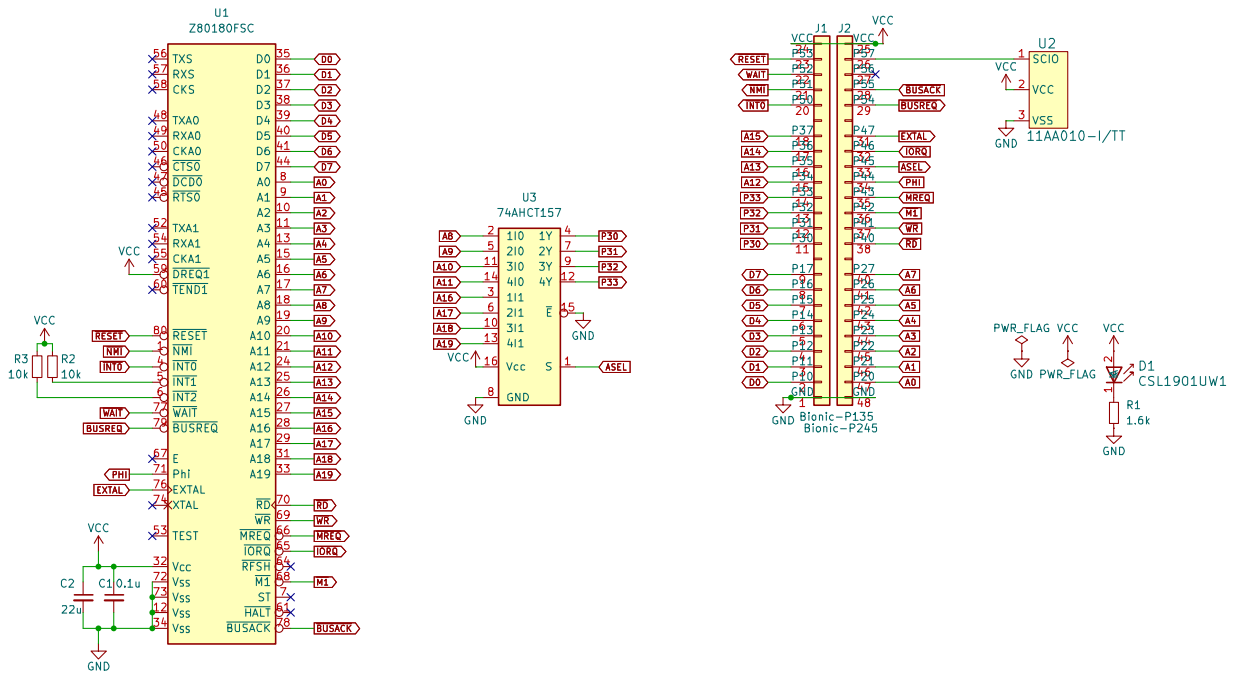
[picture p31: page 1]
