tgtakaoka/retro-bionic/schematics/z180/bionic-z180v.pdf

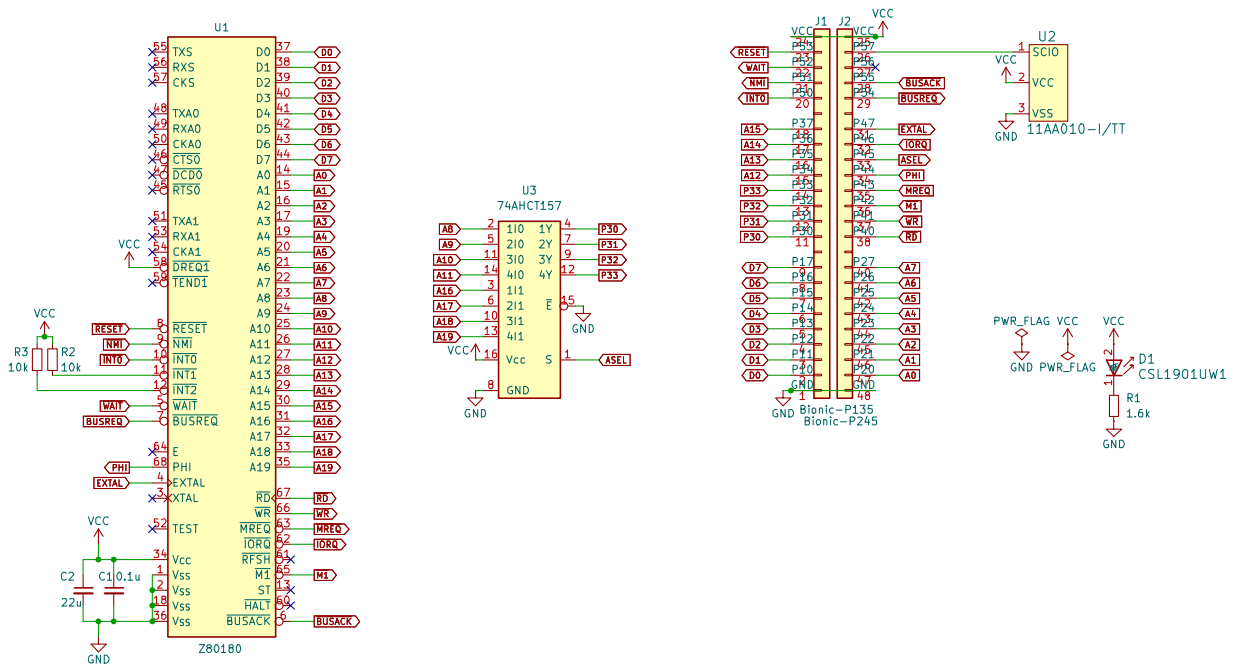
[picture p32: page 1]
