tgtakaoka/retro-bionic/schematics/kl5c80a12/bionic-kl5c80a12.pdf

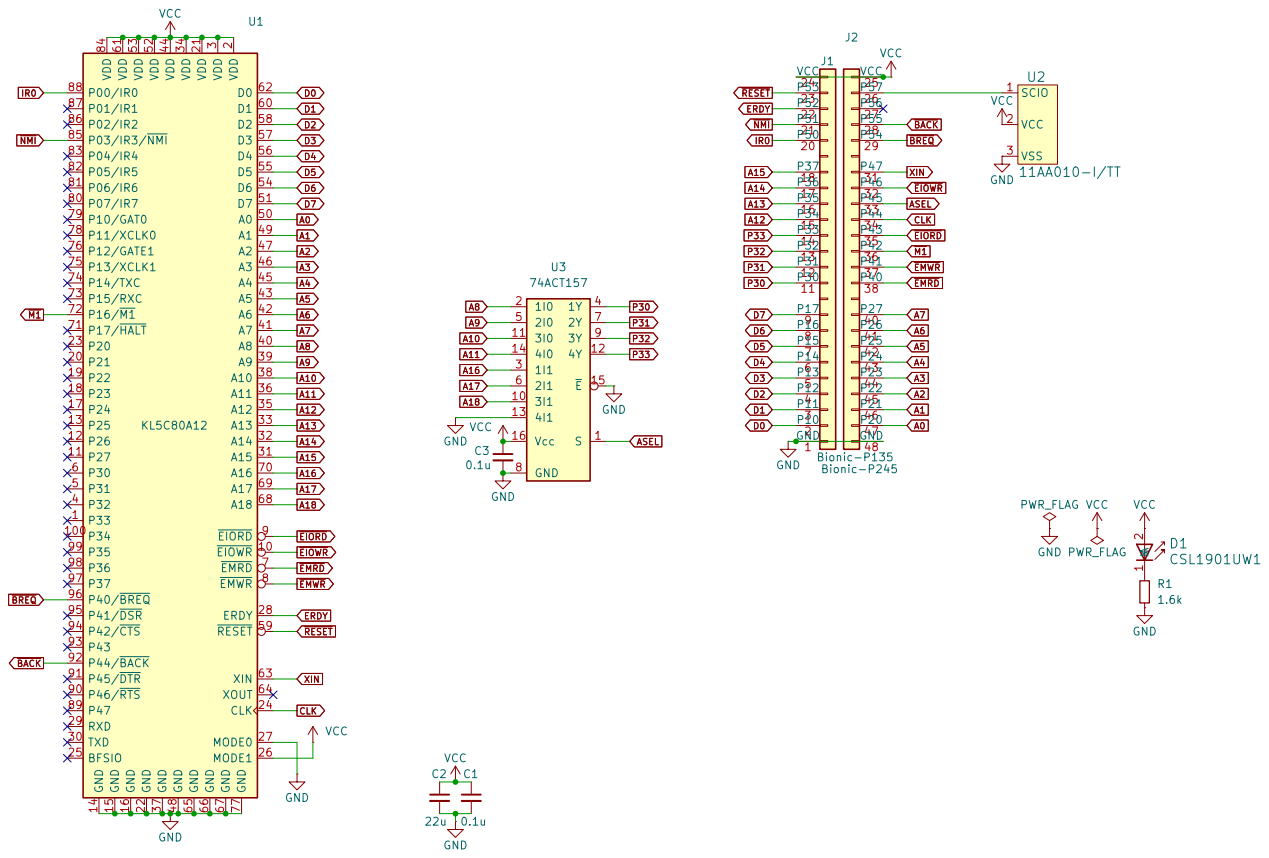
[picture p33: page 1]
