tgtakaoka/retro-bionic/schematics/mc68hc08az0/bionic-mc68hc08az0.pdf

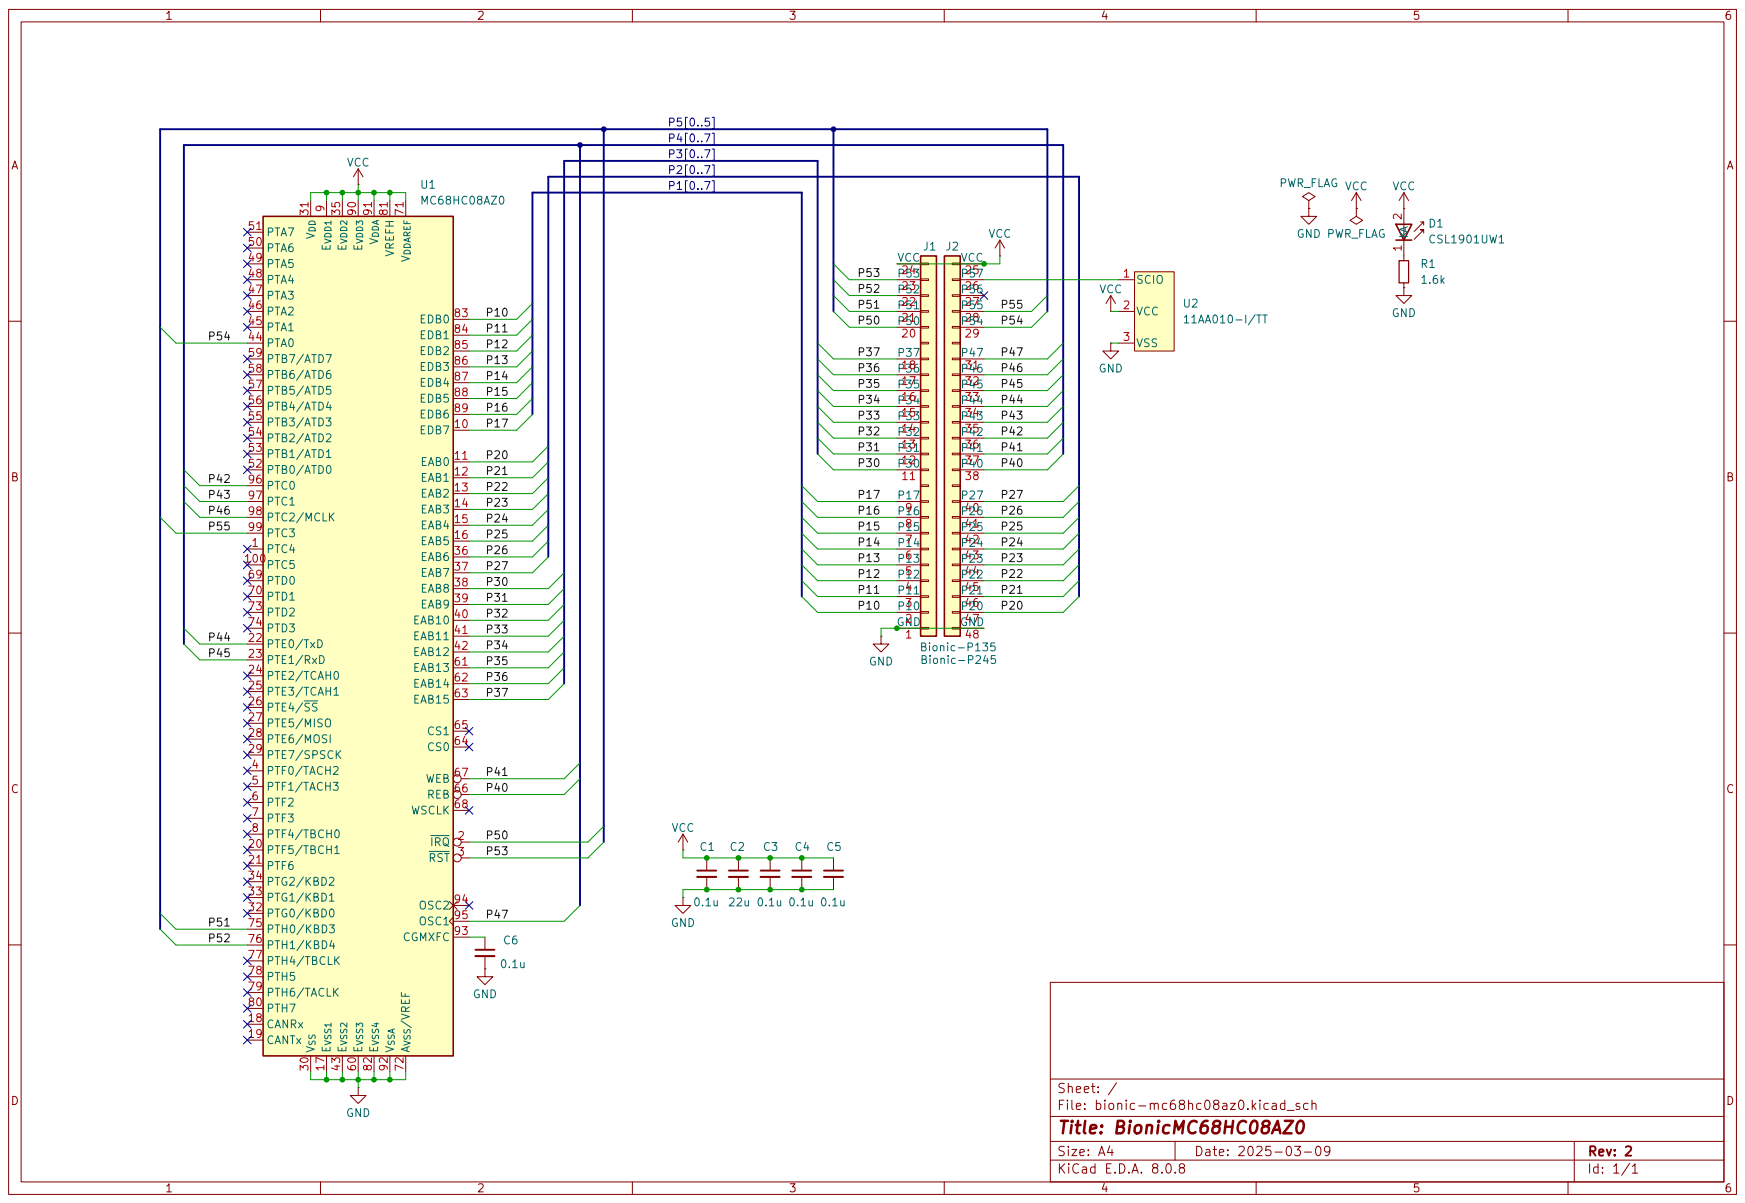
[picture p34: page 1]
