tgtakaoka/retro-bionic/schematics/tms32010/bionic-tms32010.pdf

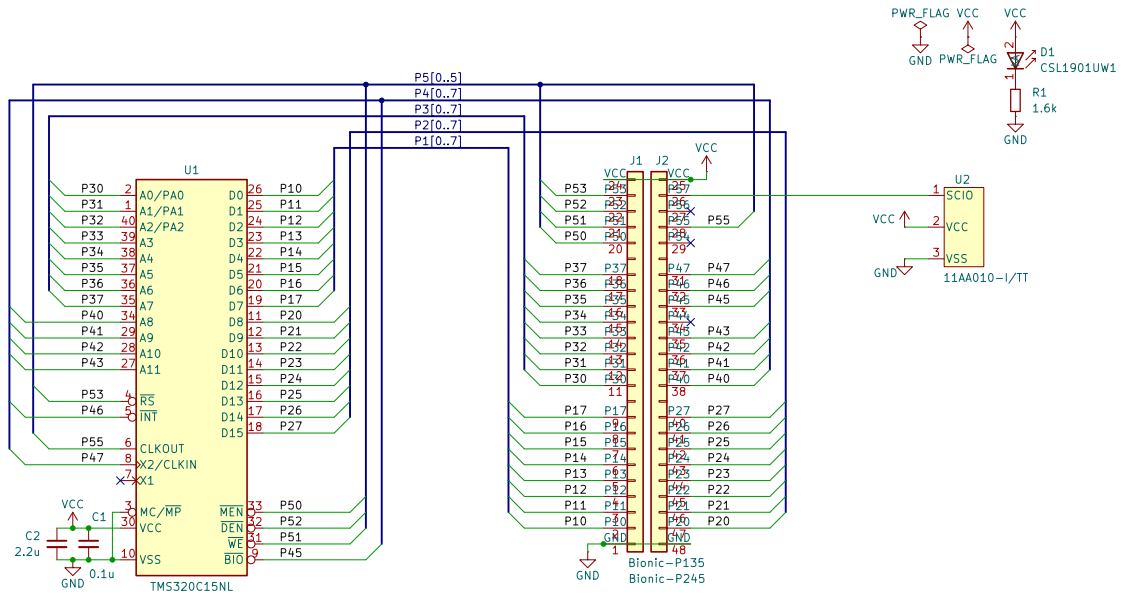
[picture p35: page 1]
