tgtakaoka/retro-bionic/schematics/tms9900/bionic-tms9900.pdf

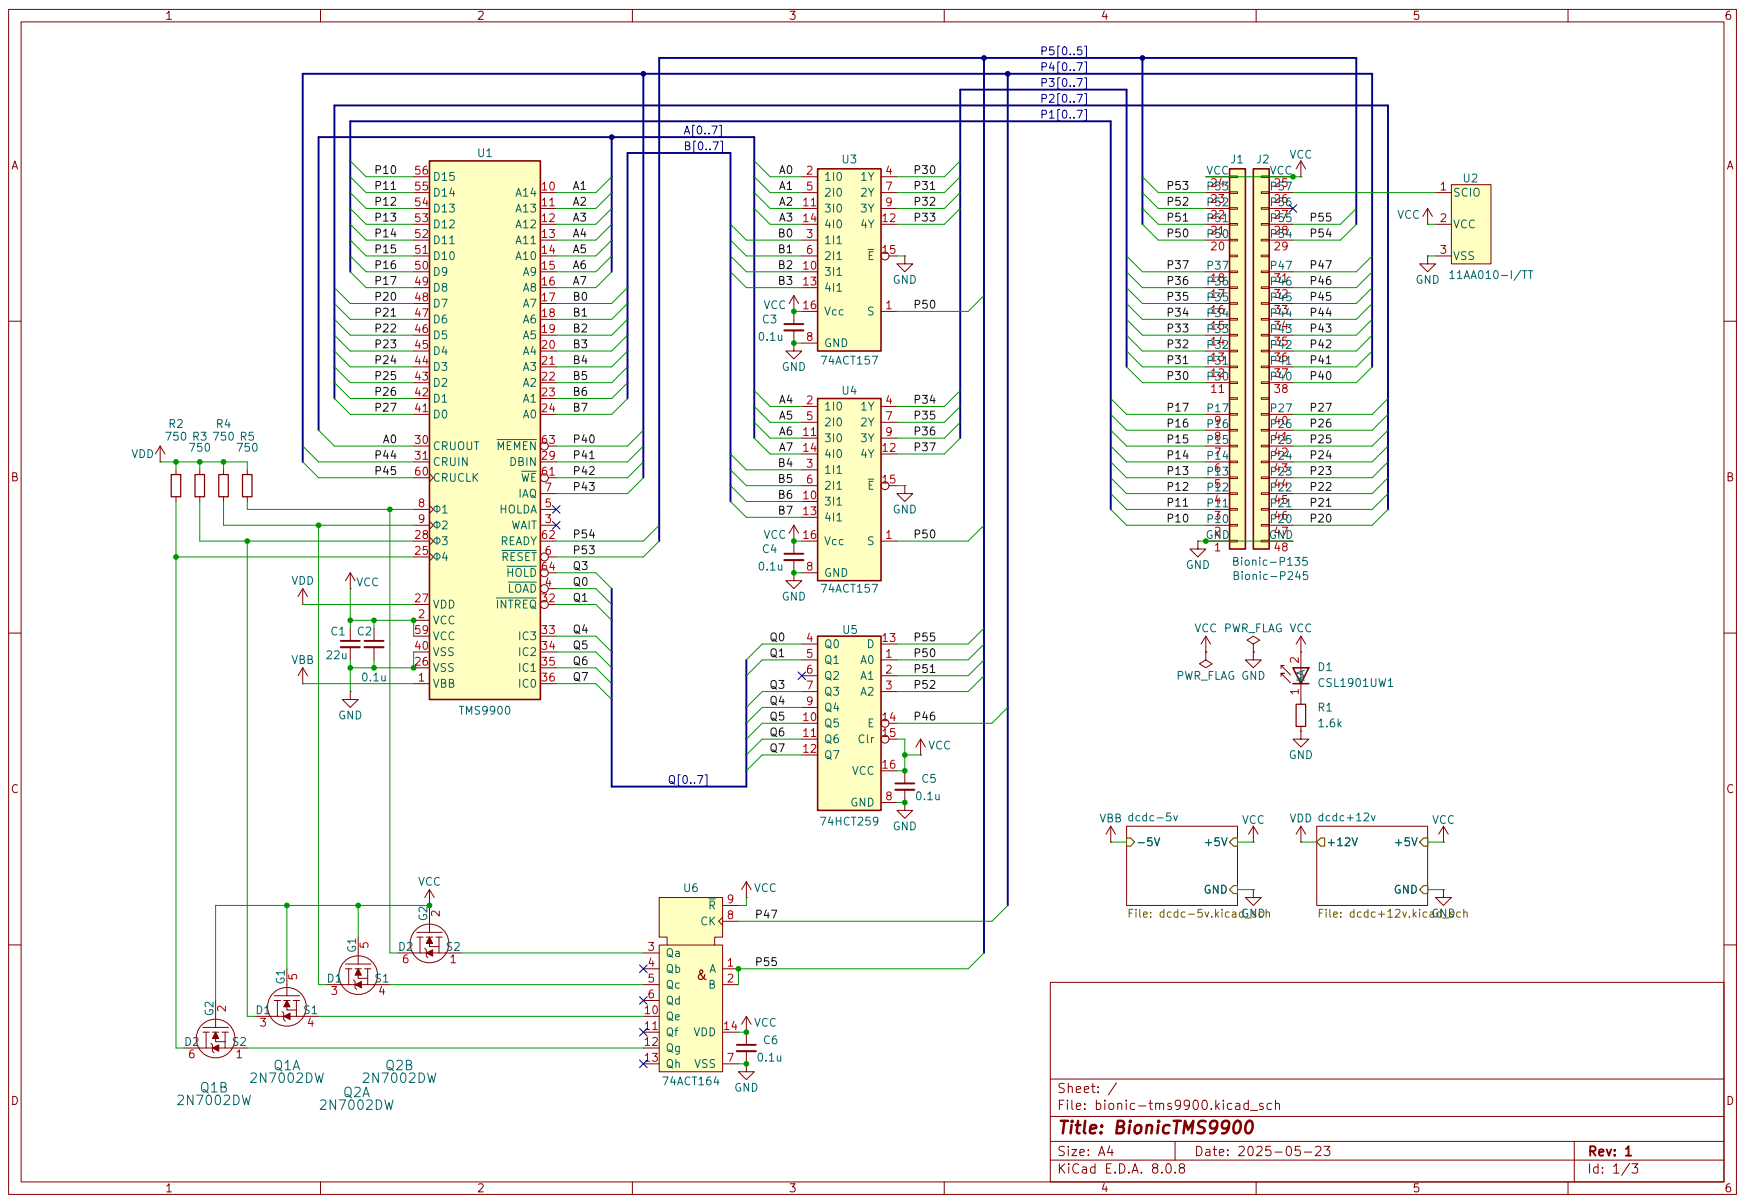
[picture p36: page 1]

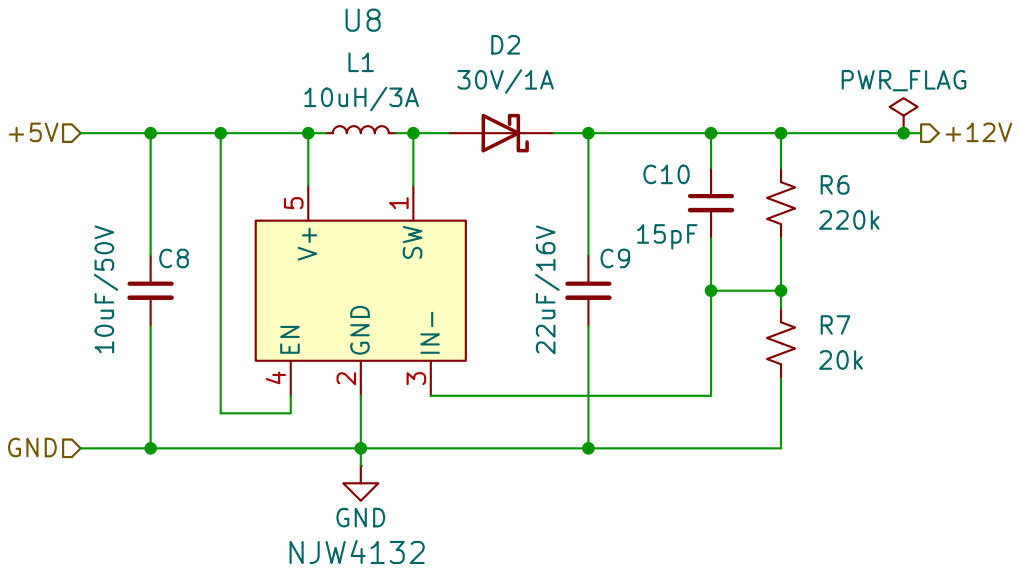
[picture p37: page 2]

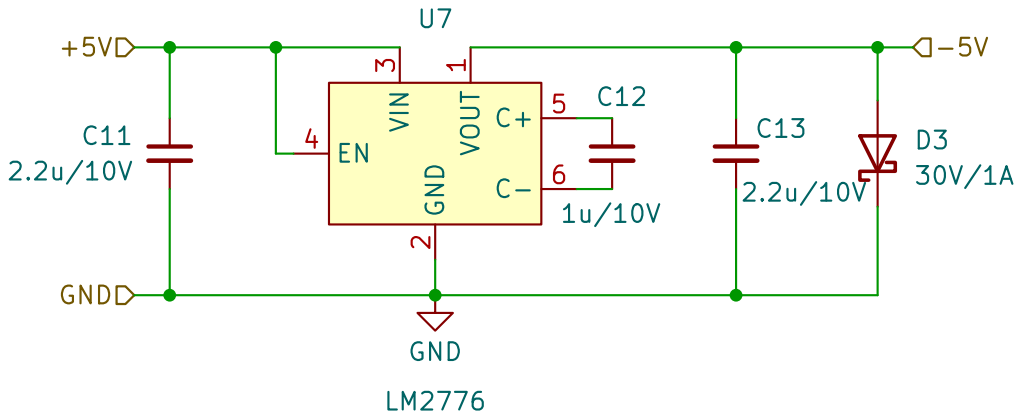
[picture p38: page 3]
