tgtakaoka/retro-bionic/schematics/tms9980/bionic-tms9980.pdf

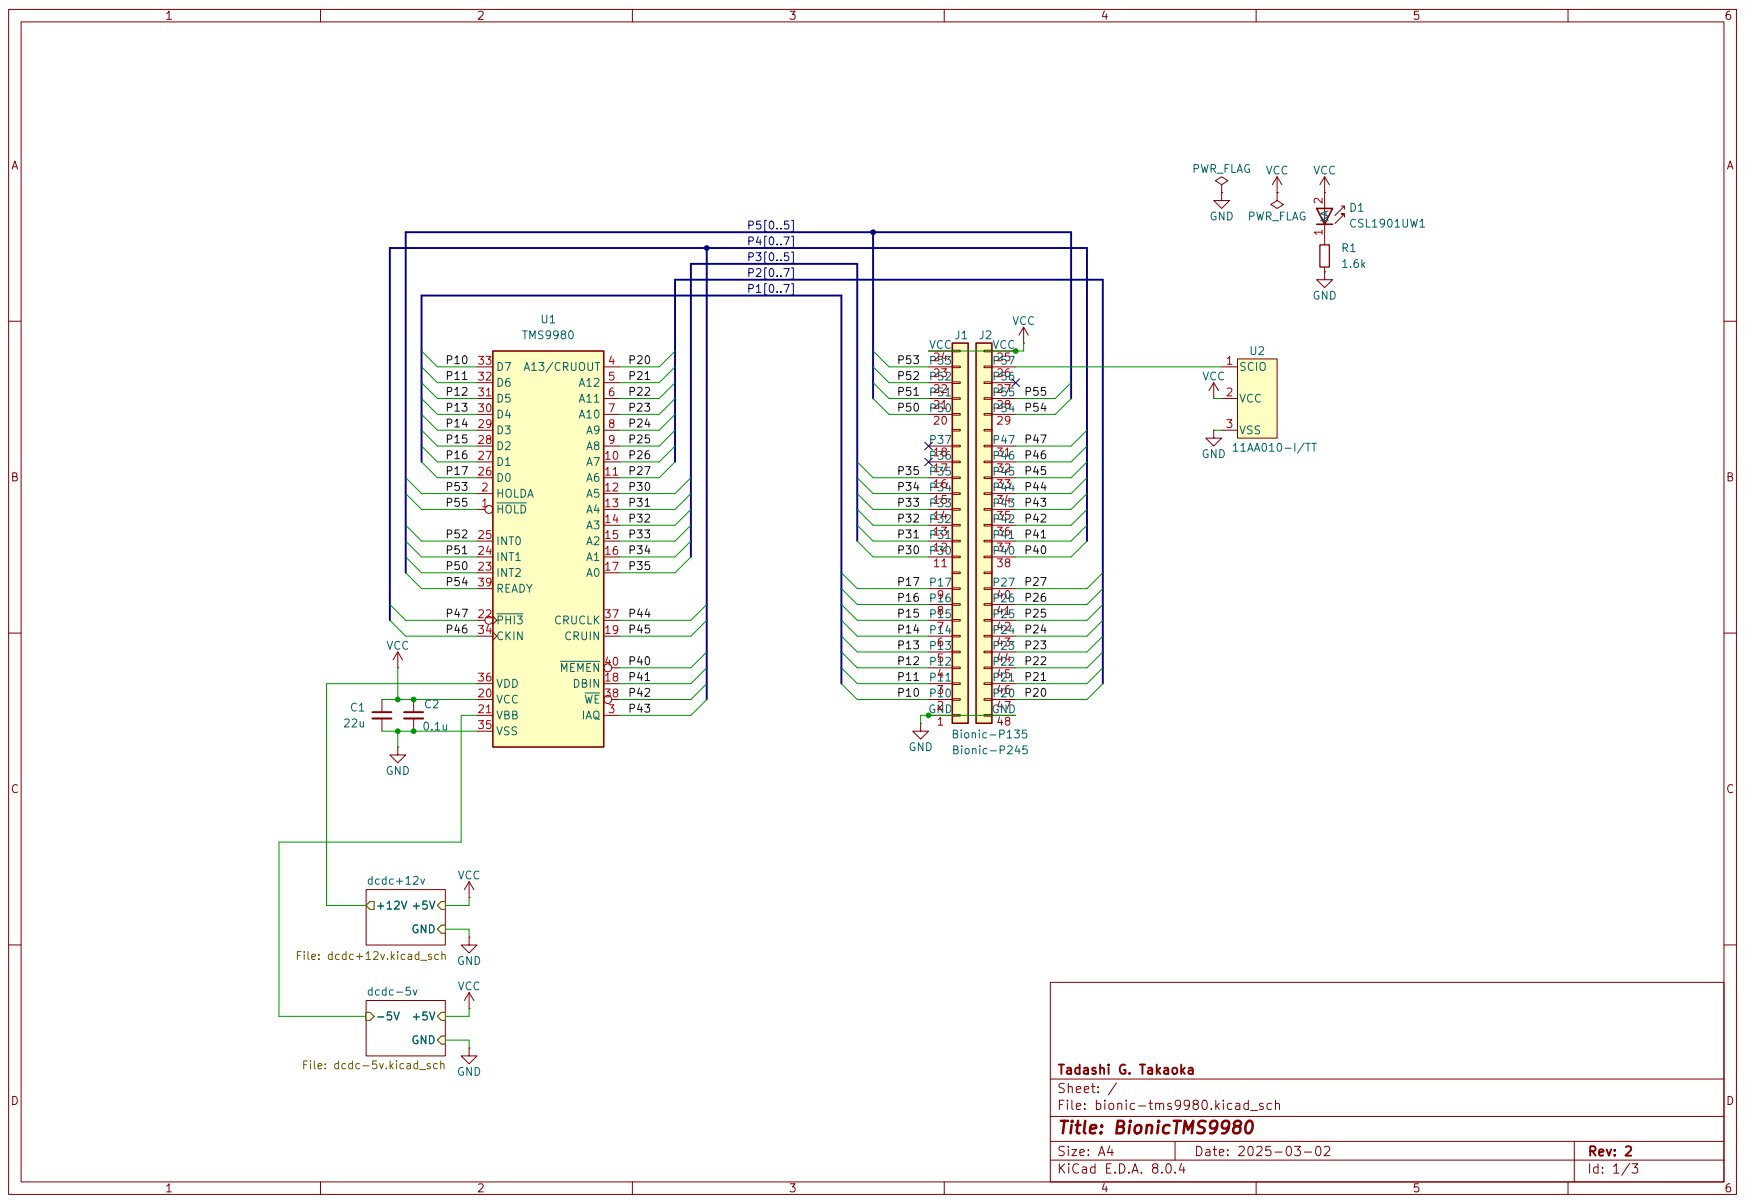
[picture p39: page 1]

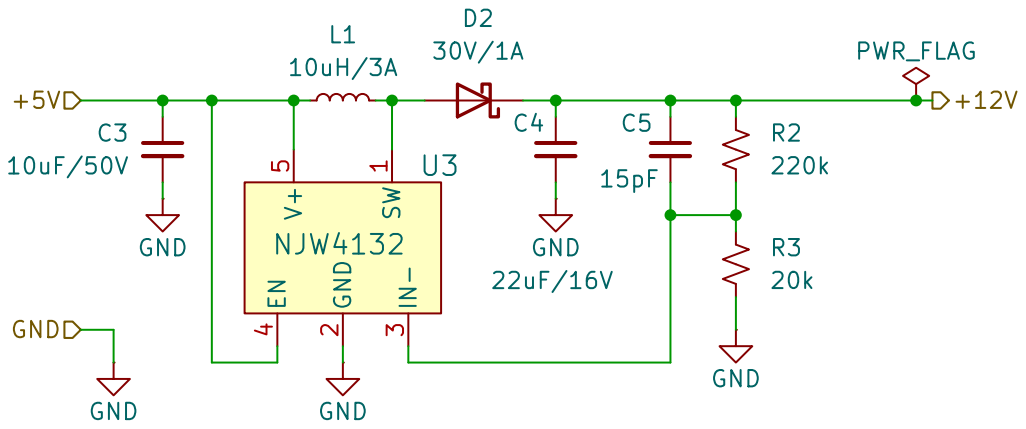
[picture p40: page 2]

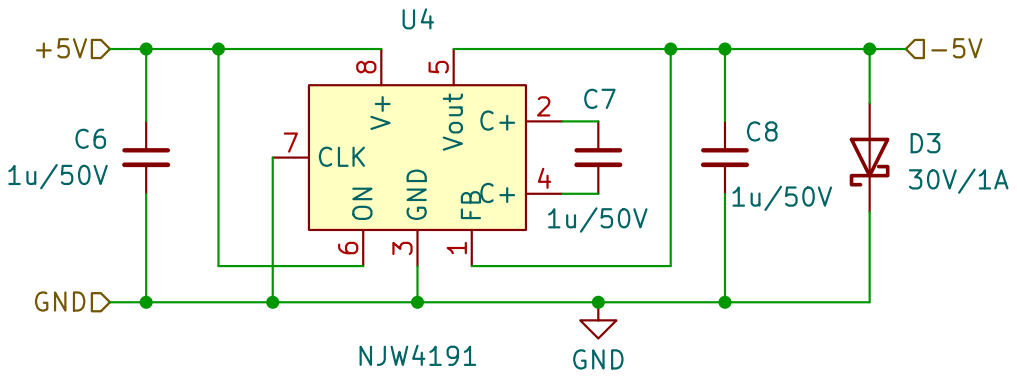
[picture p41: page 3]
