tgtakaoka/retro-bionic/schematics/mc146805e2/bionic-mc146805e2.pdf

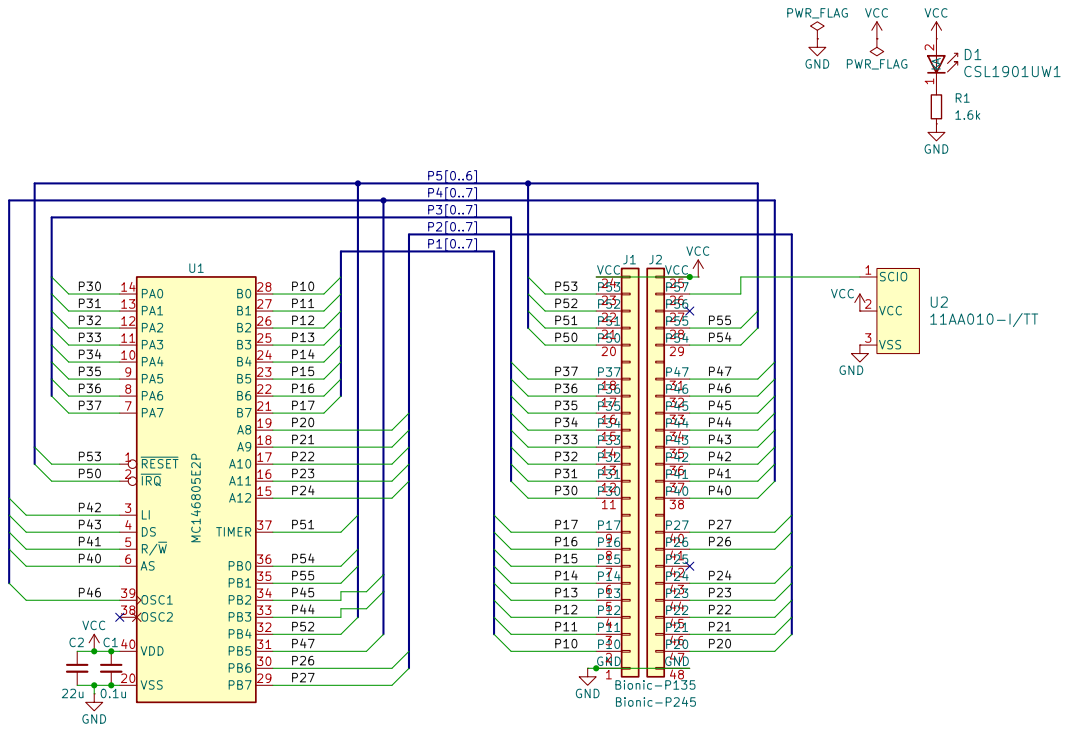
[picture p42: page 1]
