tgtakaoka/retro-bionic/schematics/mezzanine/bionic-mezzanine.pdf

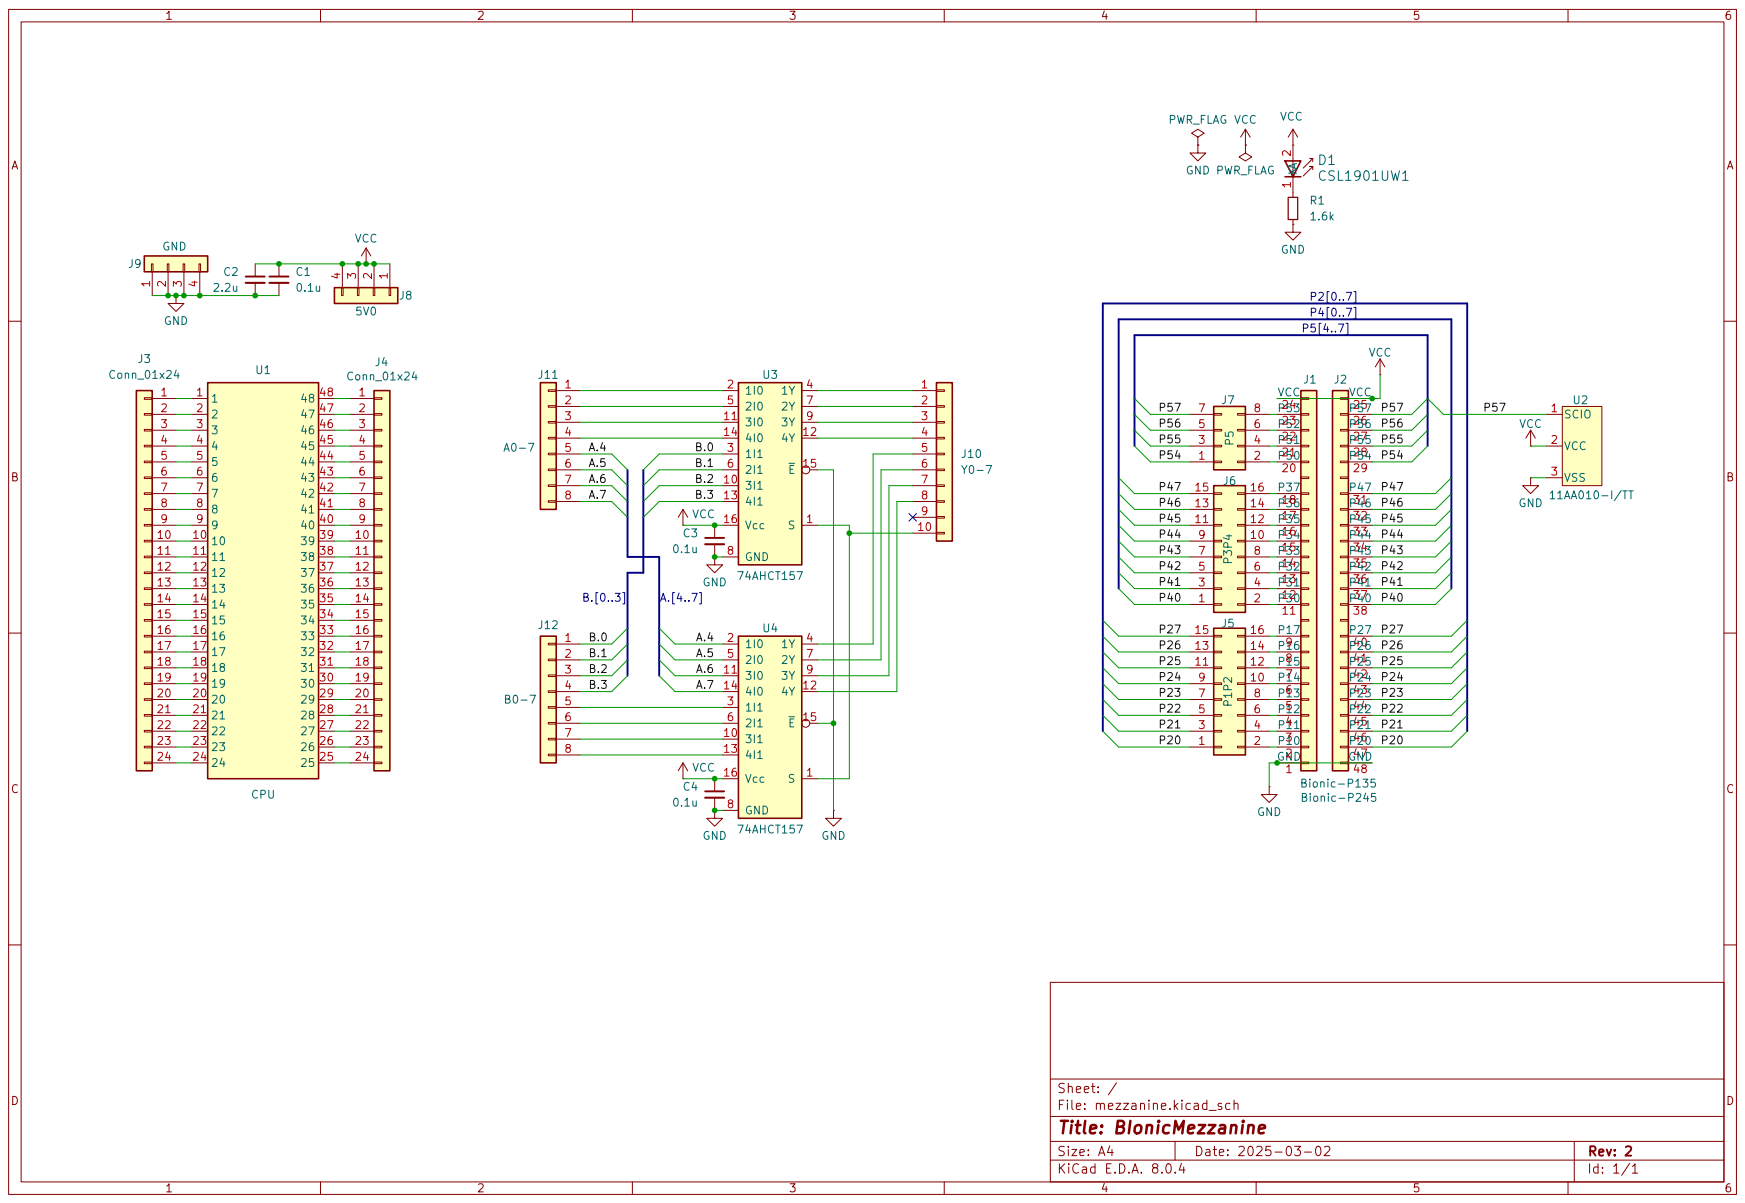
[picture p43: page 1]
