tgtakaoka/retro-bionic/schematics/mn1613/bionic-mn1613.pdf

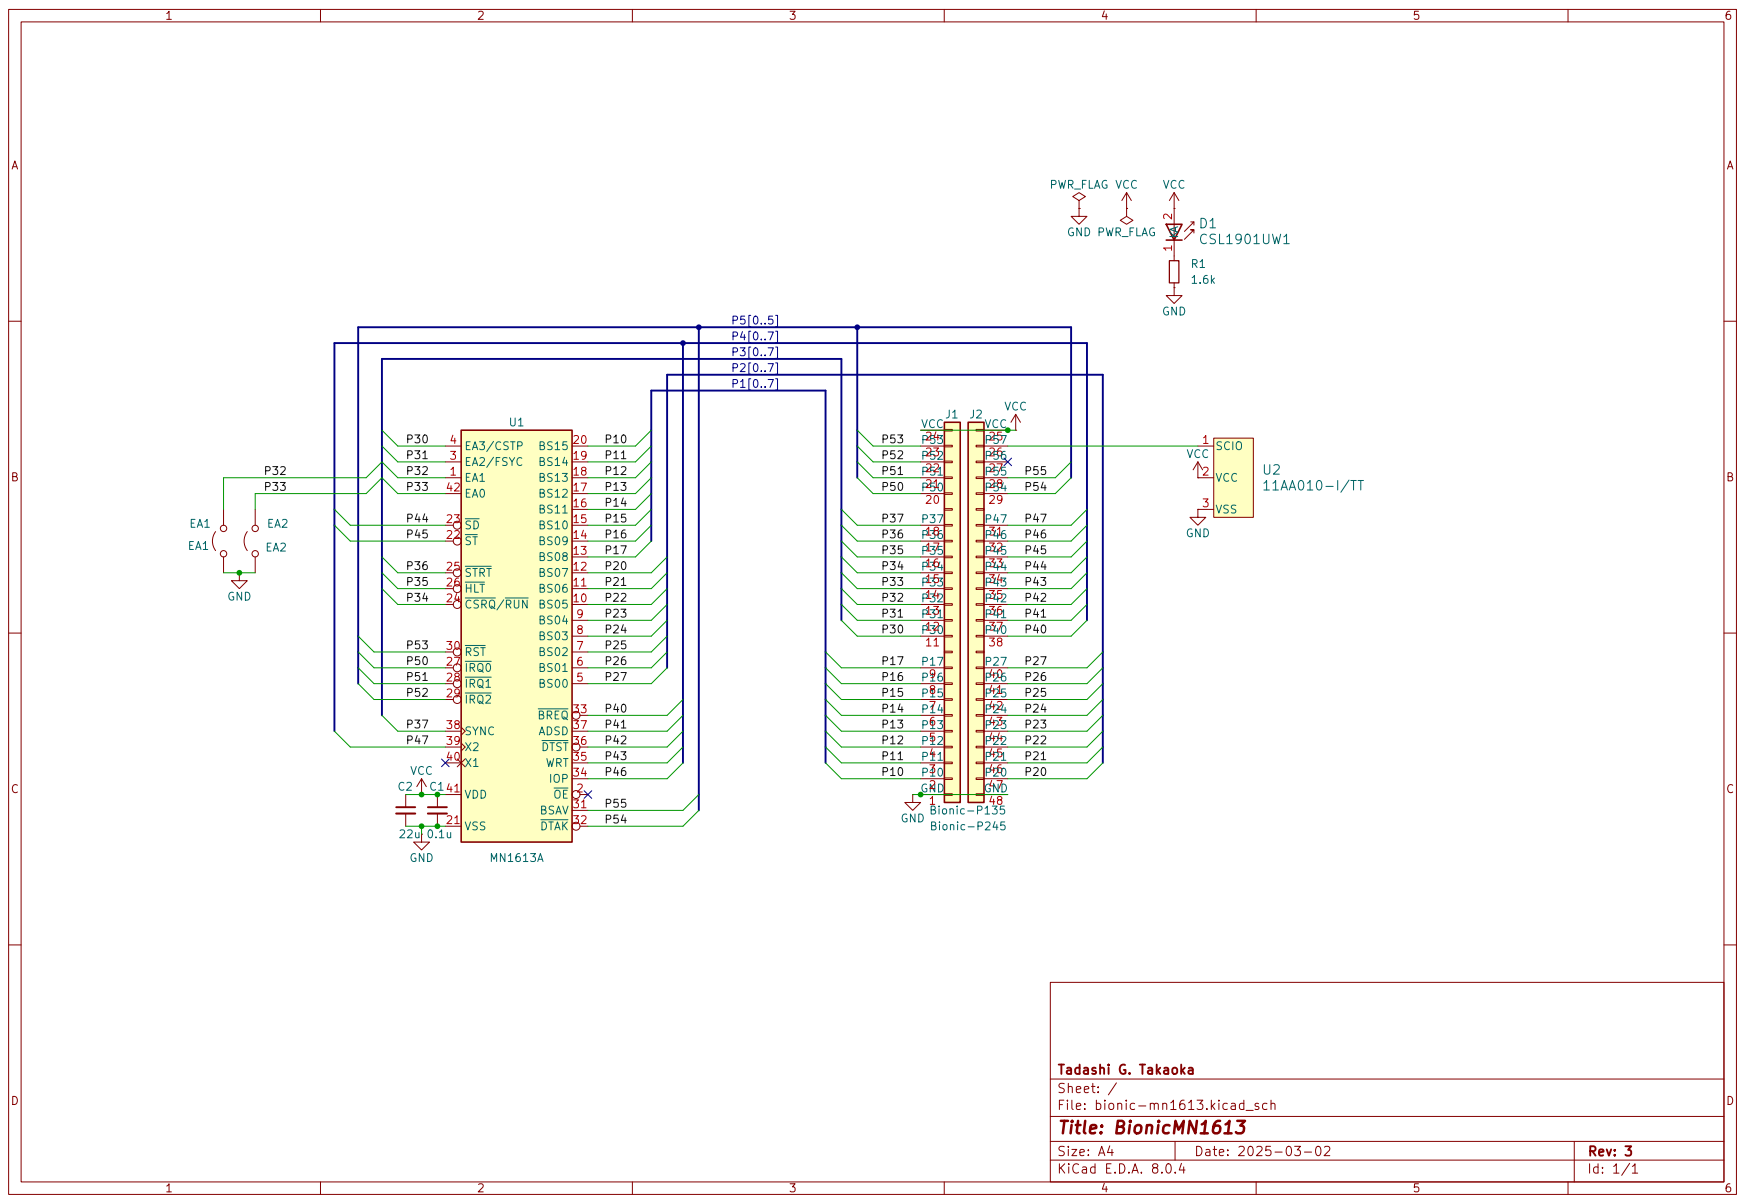
[picture p44: page 1]
