tgtakaoka/retro-bionic/schematics/mos6502/bionic-mos6502.pdf

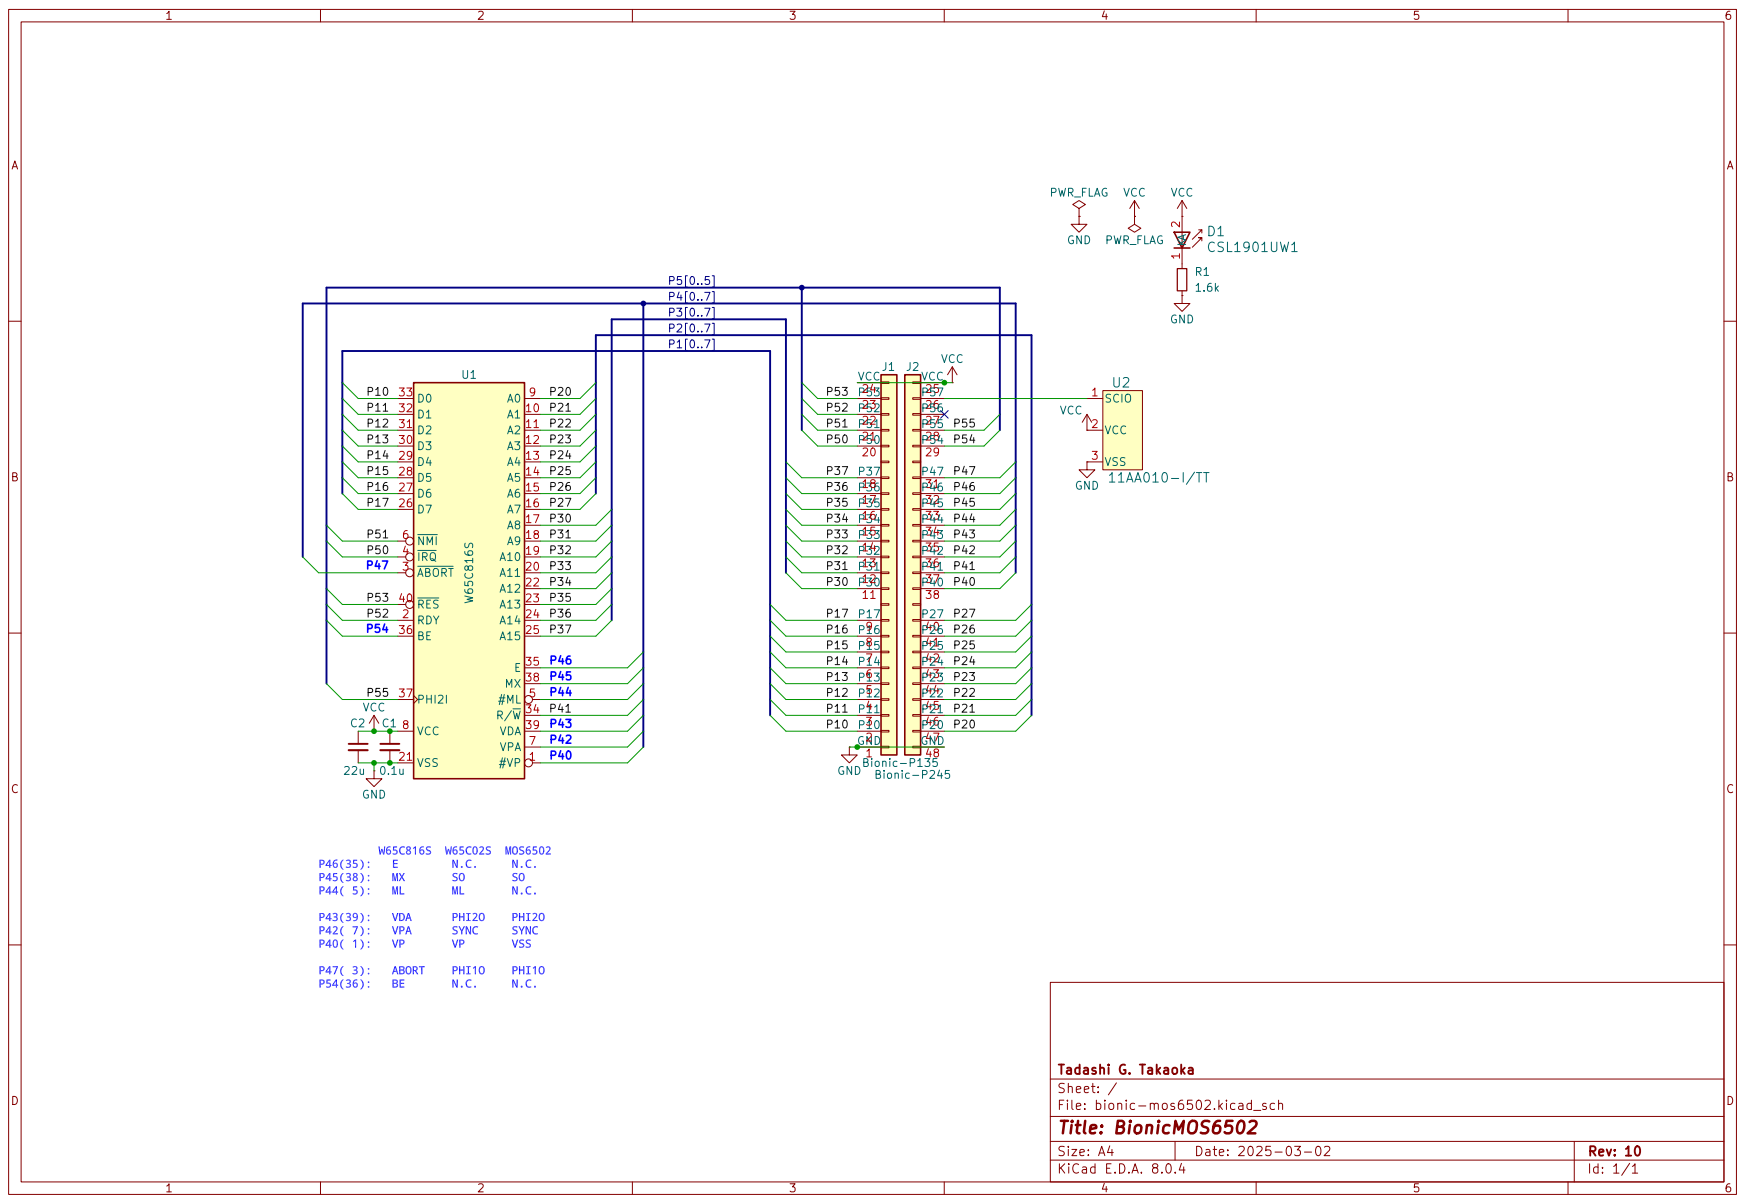
[picture p45: page 1]
