tgtakaoka/retro-bionic/schematics/nsc800/bionic-nsc800.pdf

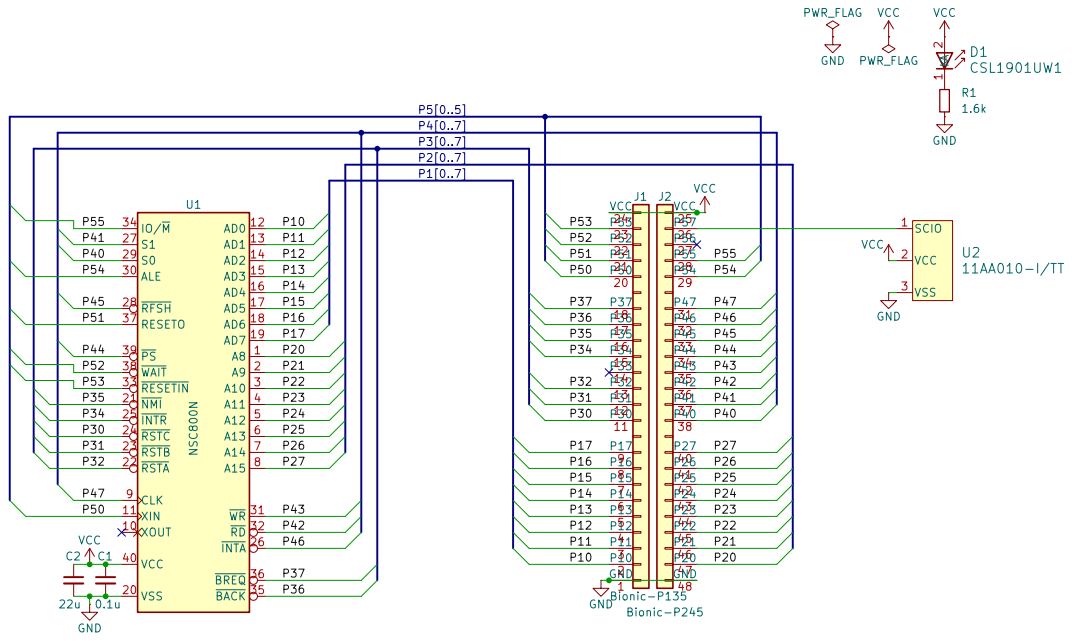
[picture p46: page 1]
