tgtakaoka/retro-bionic/schematics/p8048/bionic-p8048.pdf

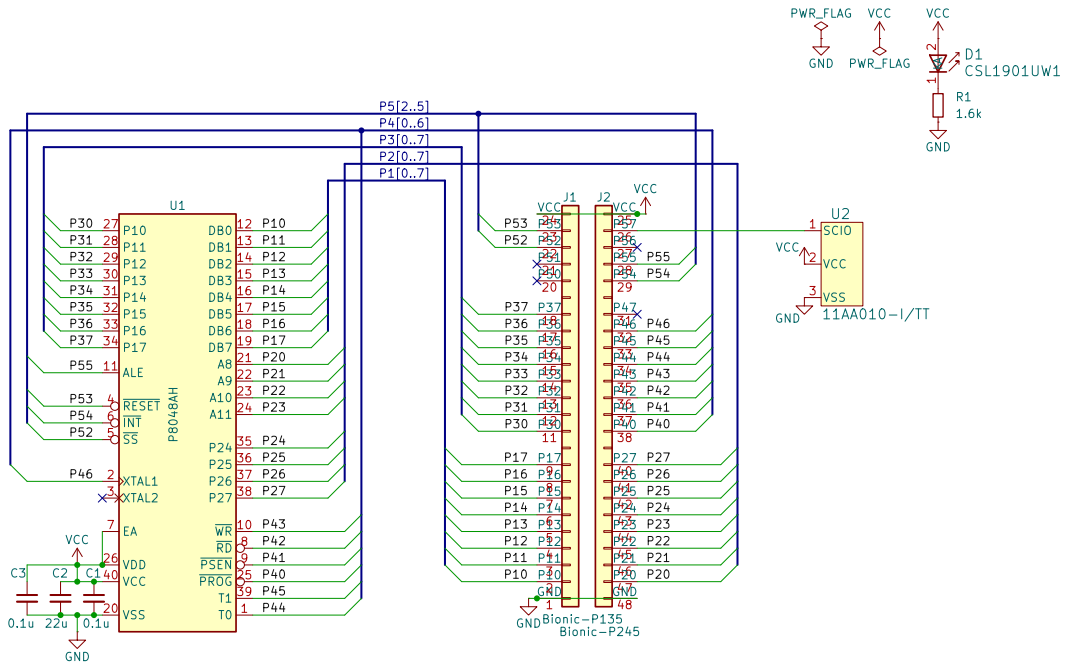
[picture p47: page 1]
