tgtakaoka/retro-bionic/schematics/p8051/bionic-p8051.pdf

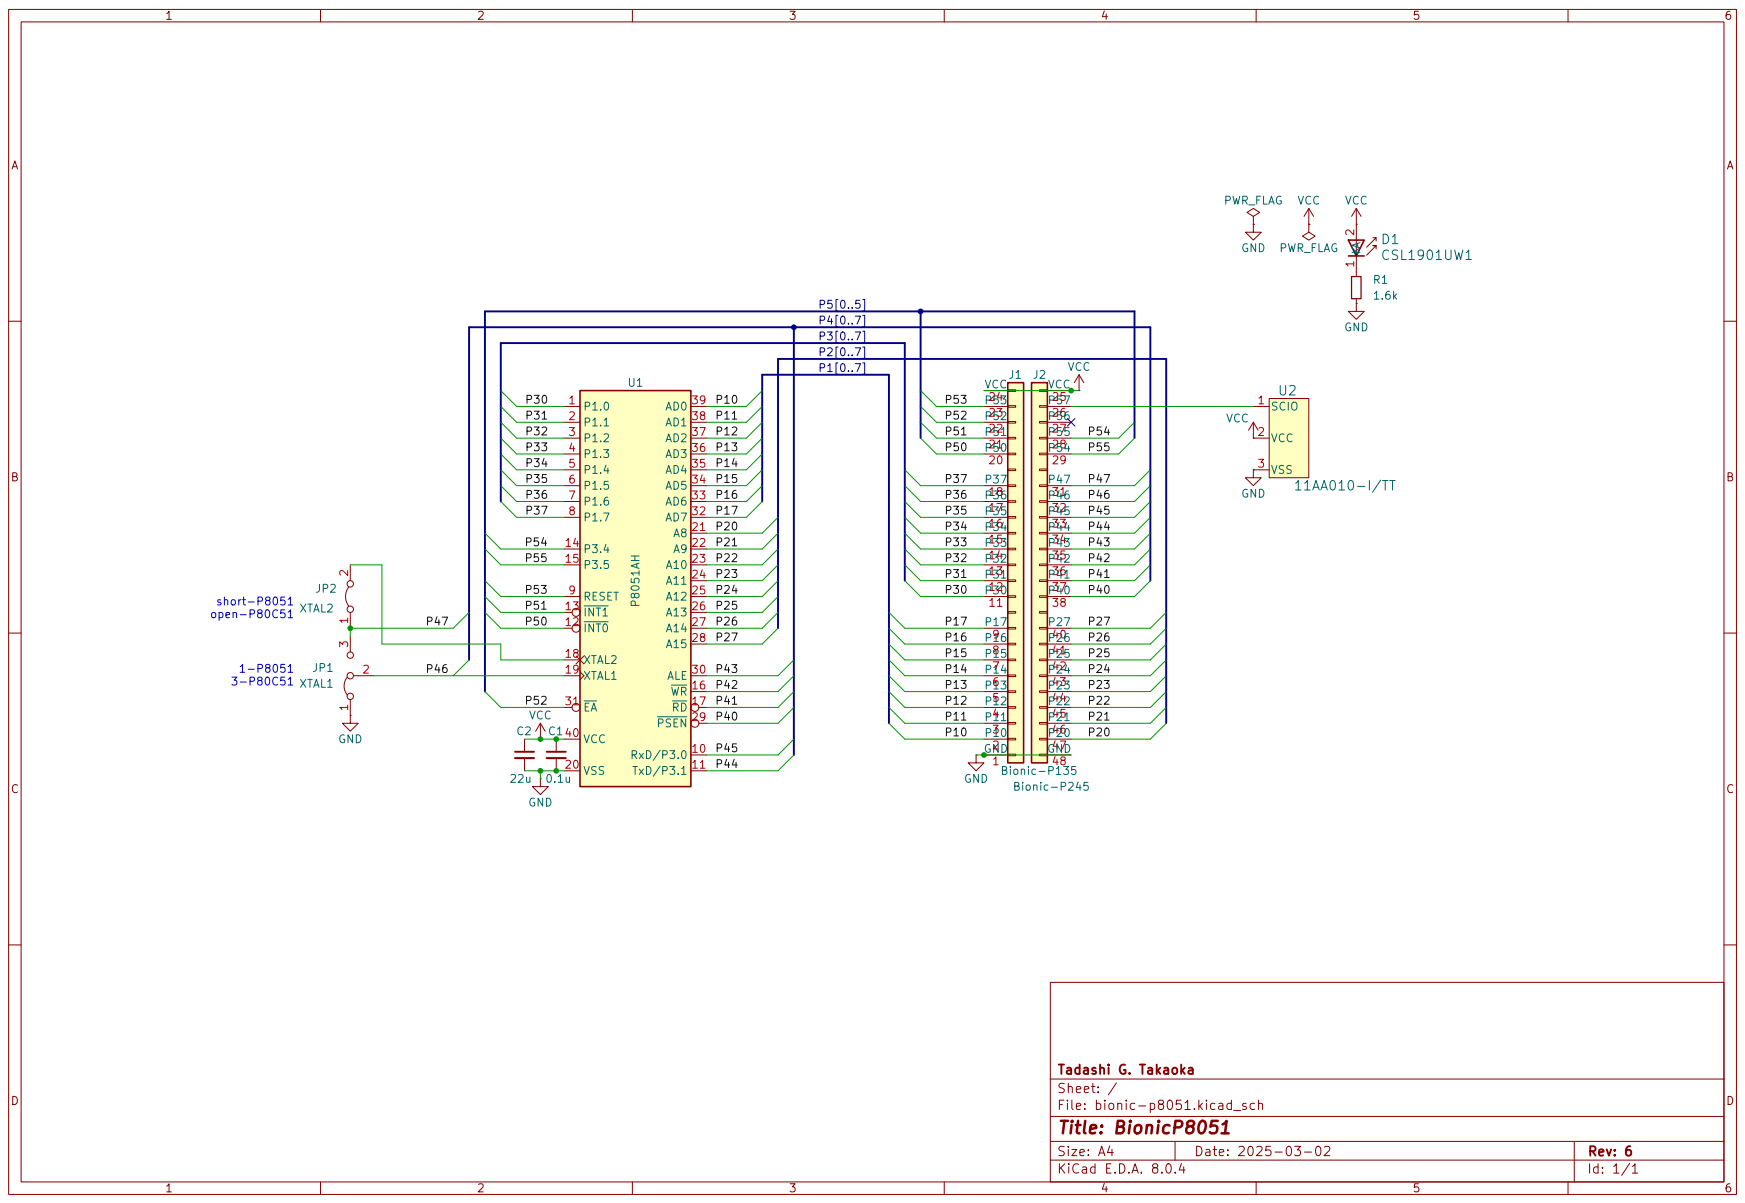
[picture p48: page 1]
