tgtakaoka/retro-bionic/schematics/p8080/bionic-p8080.pdf

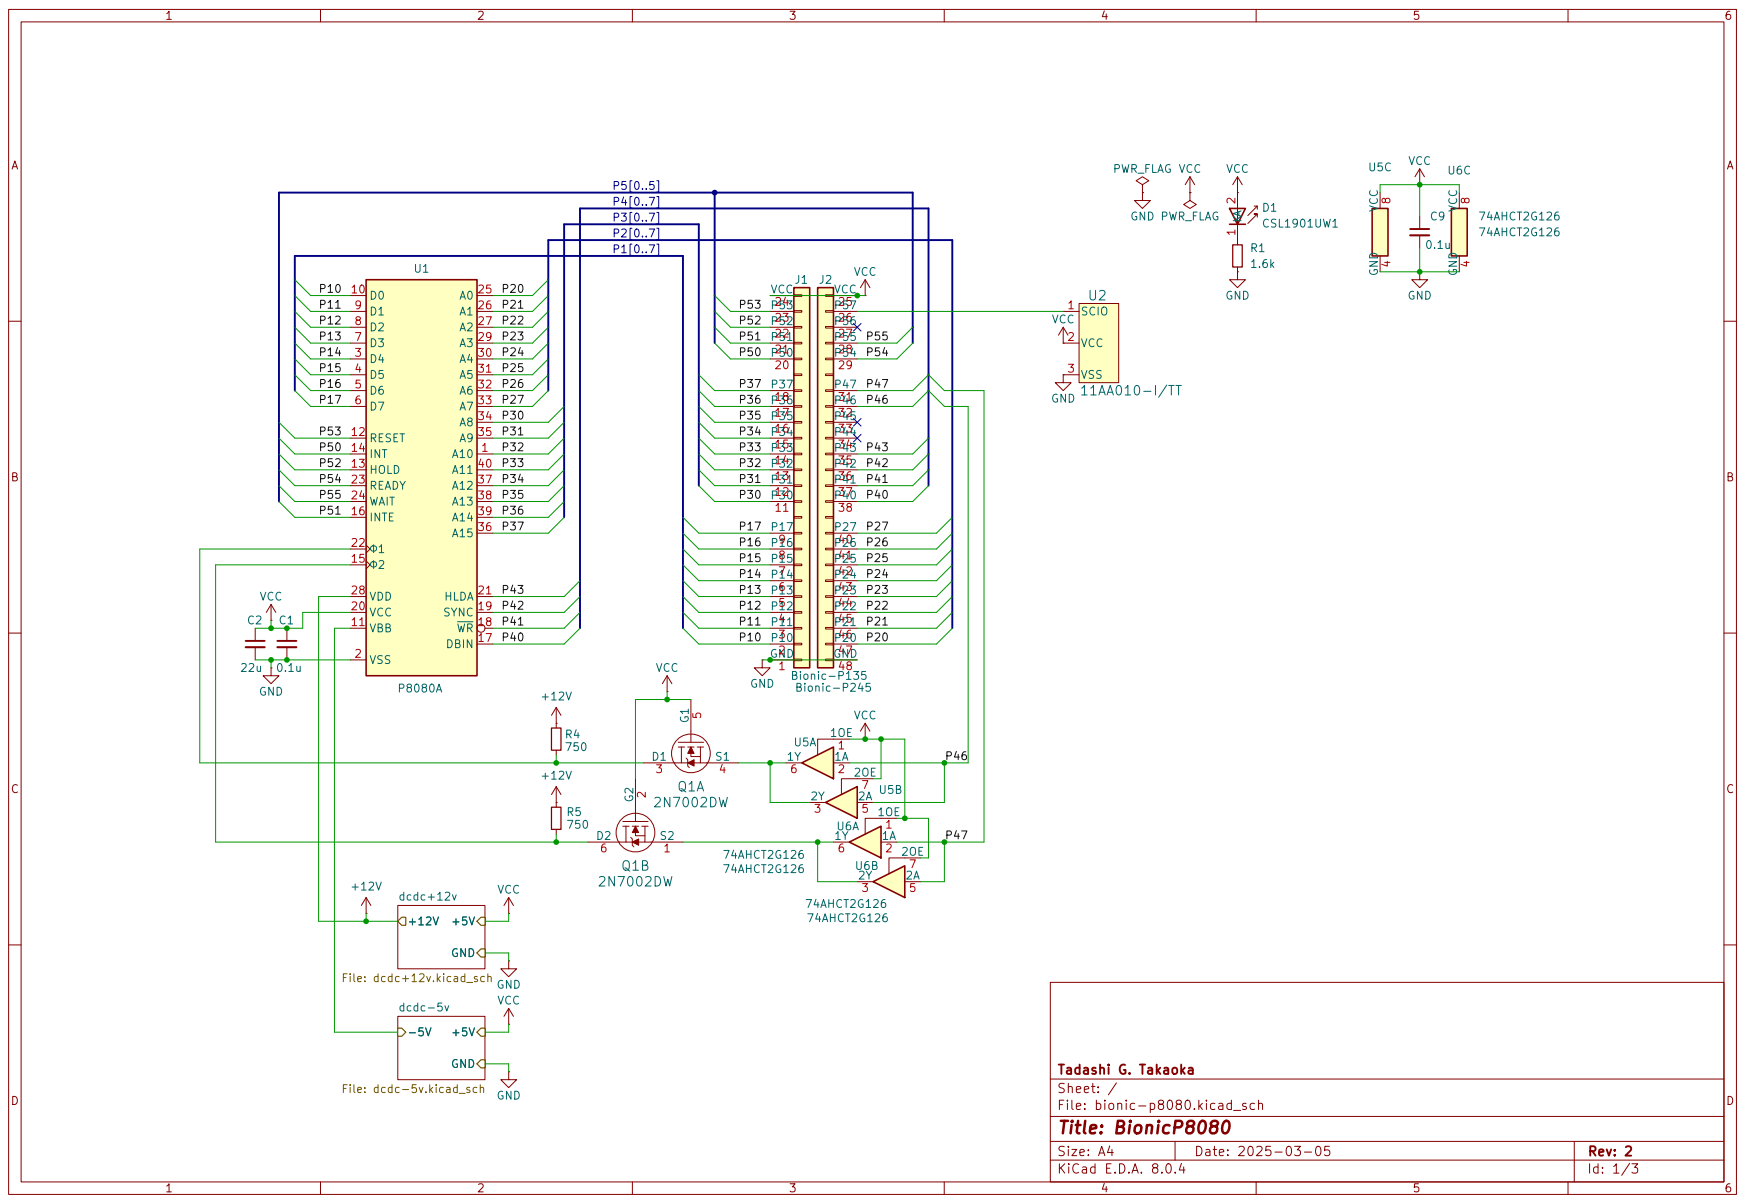
[picture p49: page 1]

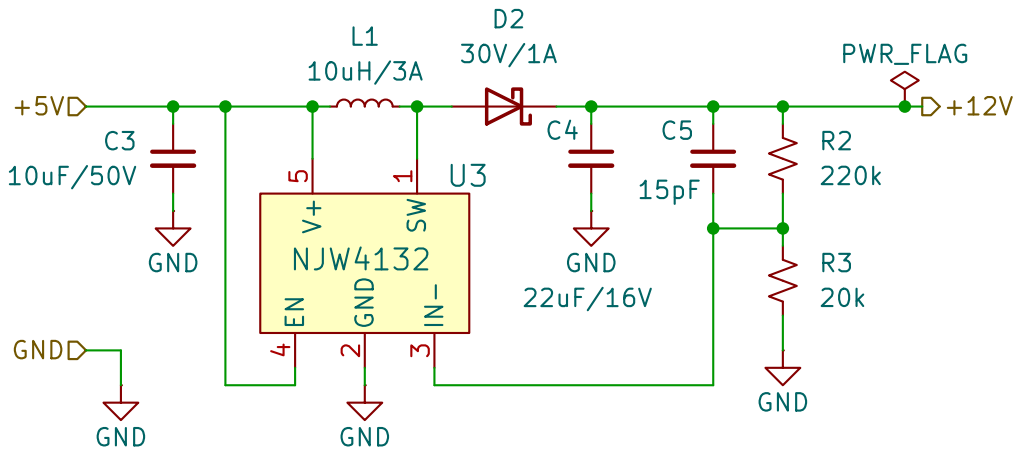
[picture p50: page 2]
