tgtakaoka/retro-bionic/schematics/p8085/bionic-p8085.pdf

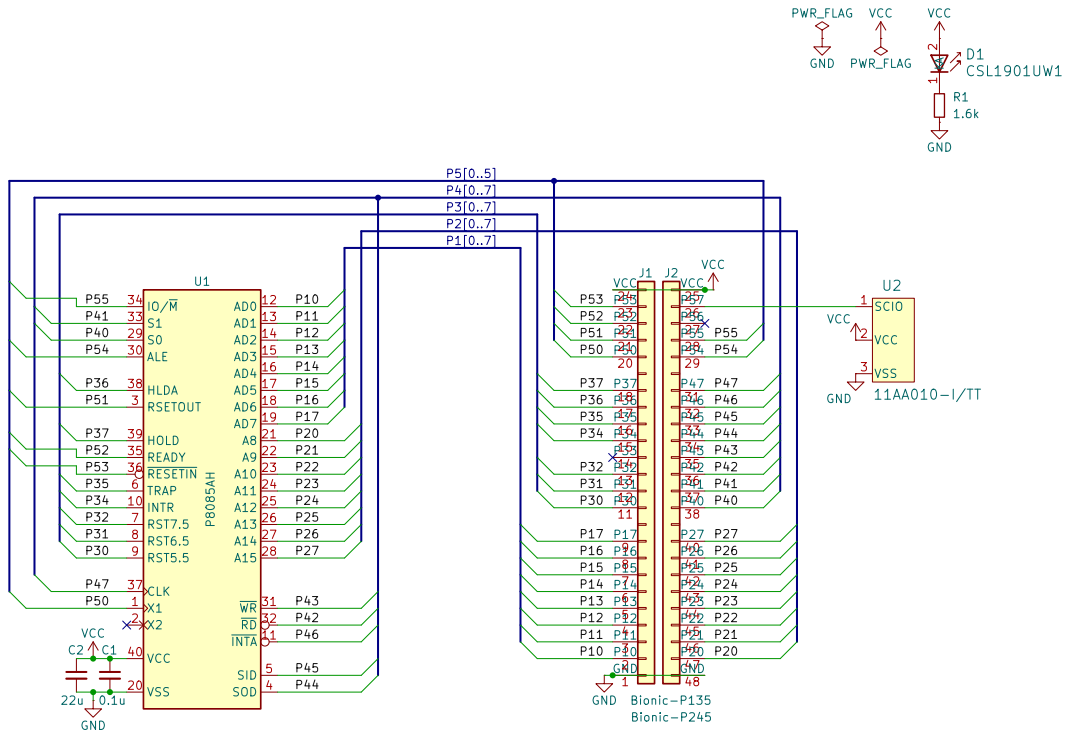
[picture p51: page 1]
