tgtakaoka/retro-bionic/schematics/scn2650/bionic-scn2650.pdf

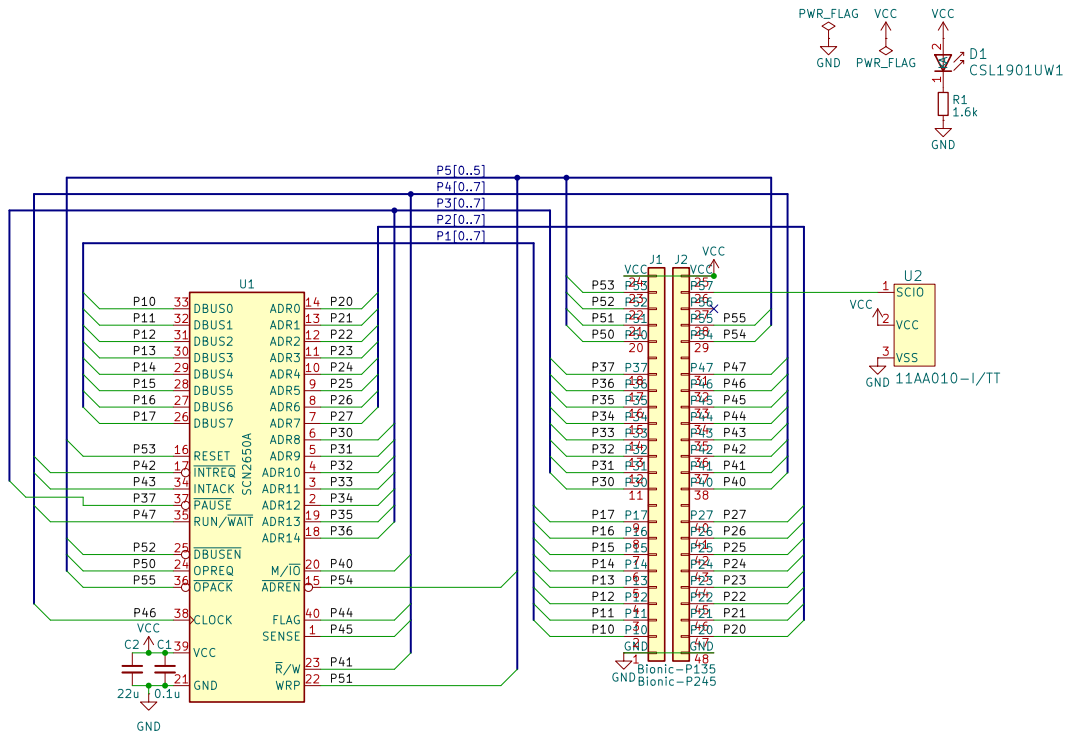
[picture p52: page 1]
