tgtakaoka/retro-bionic/schematics/tmp90c802/bionic-tmp90c802.pdf

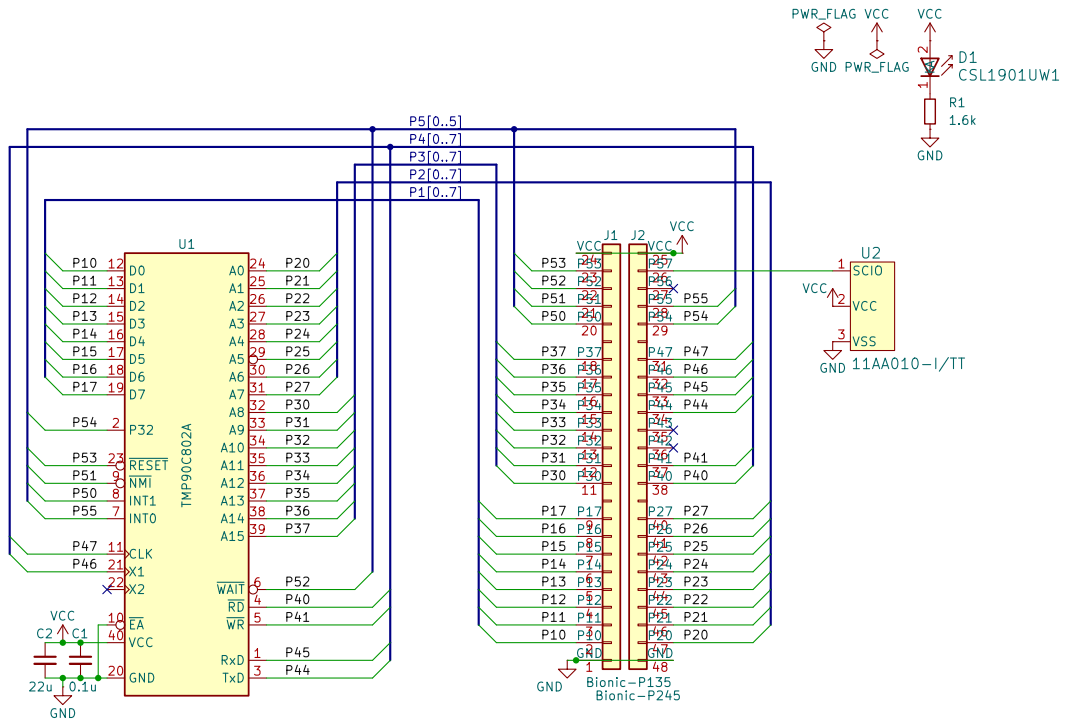
[picture p53: page 1]
