tgtakaoka/retro-bionic/schematics/tms7000/bionic-tms7000.pdf

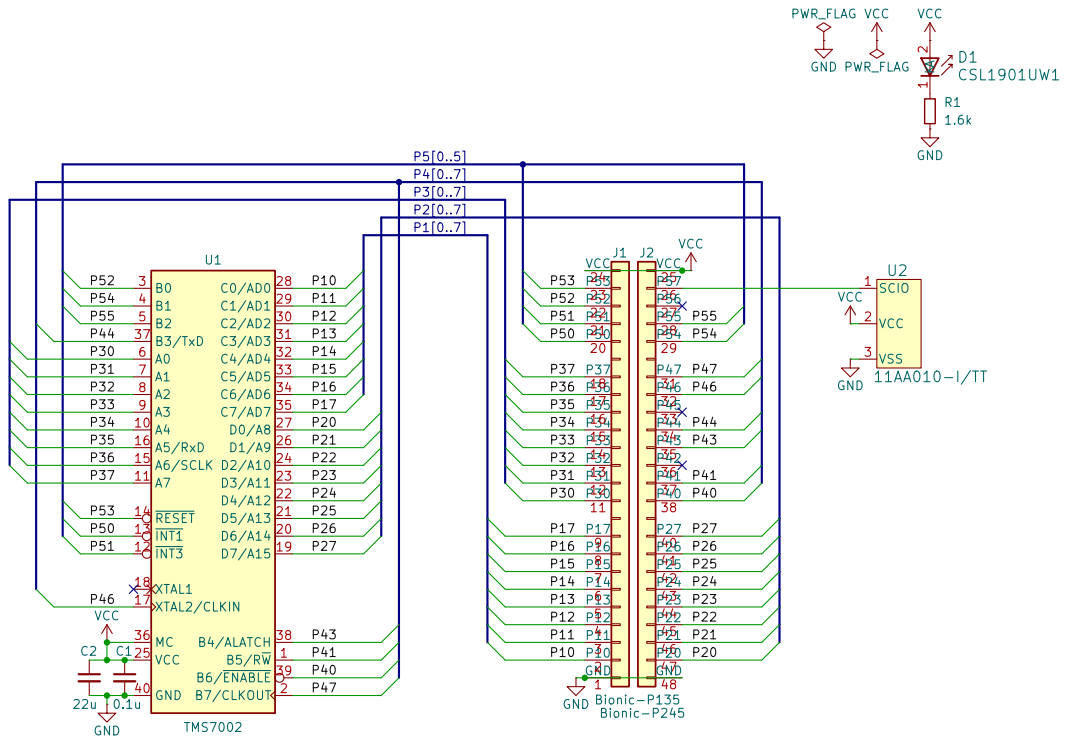
[picture p54: page 1]
