tgtakaoka/retro-bionic/schematics/tms99105/bionic-tms99105.pdf

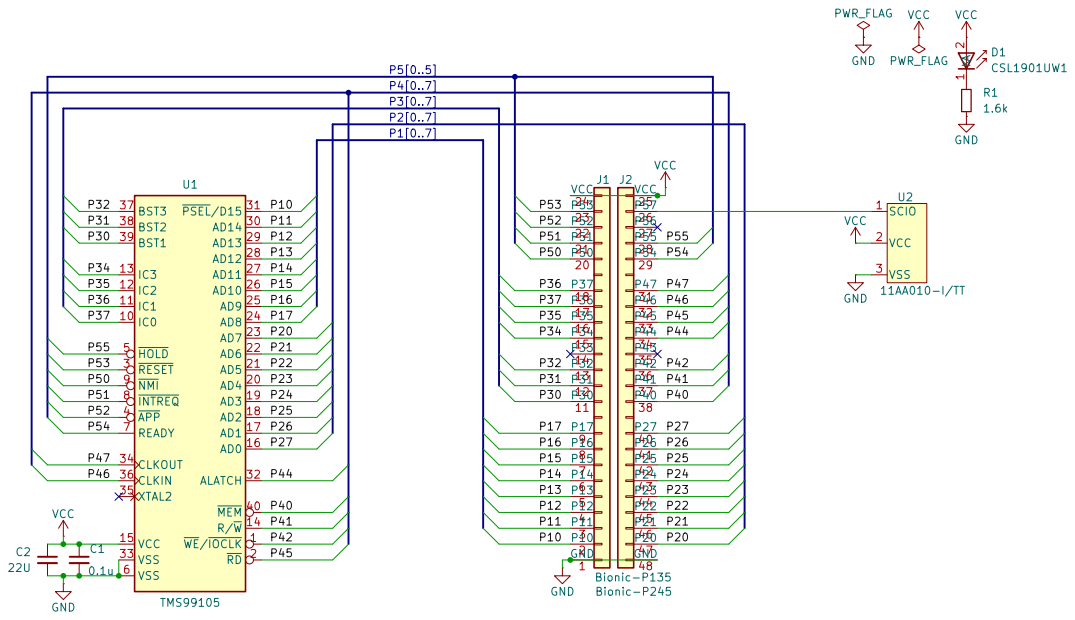
[picture p55: page 1]
