tgtakaoka/retro-bionic/schematics/tms9981/bionic-tms9981.pdf

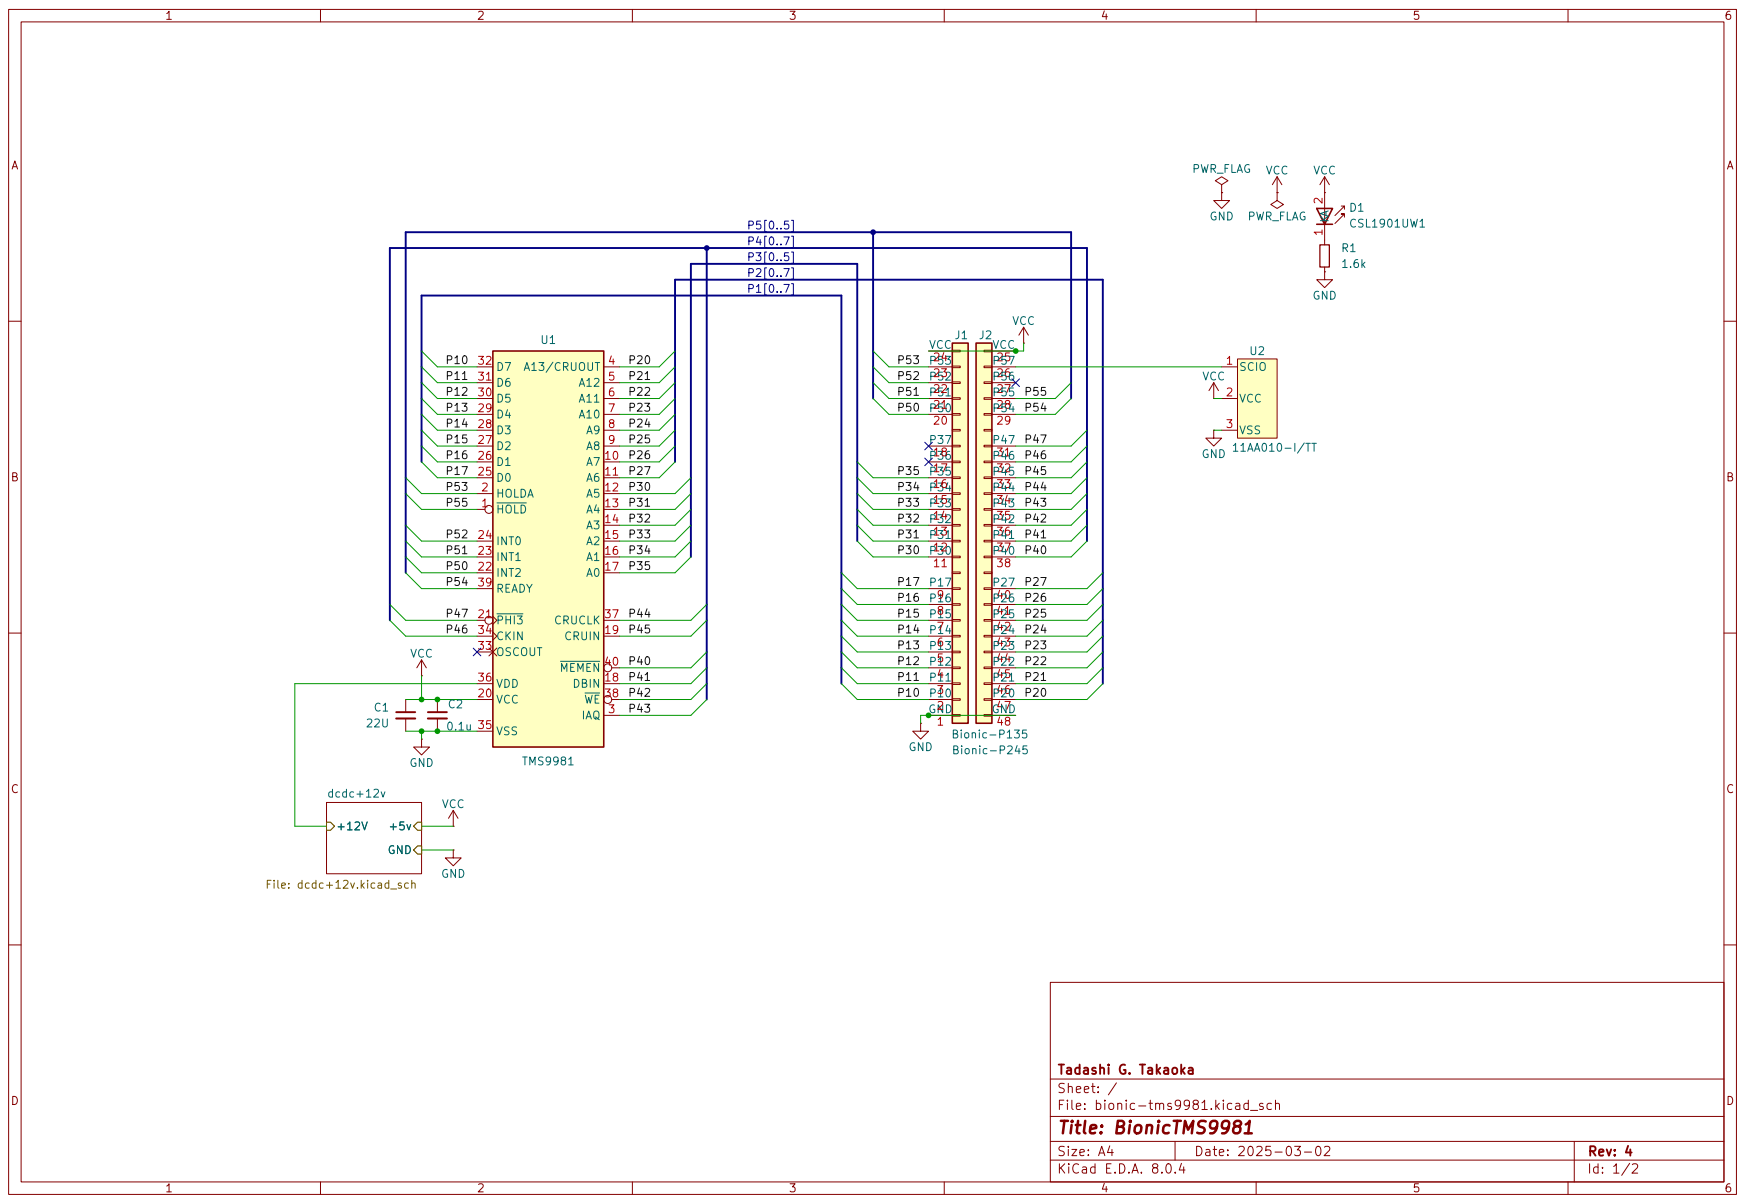
[picture p56: page 1]

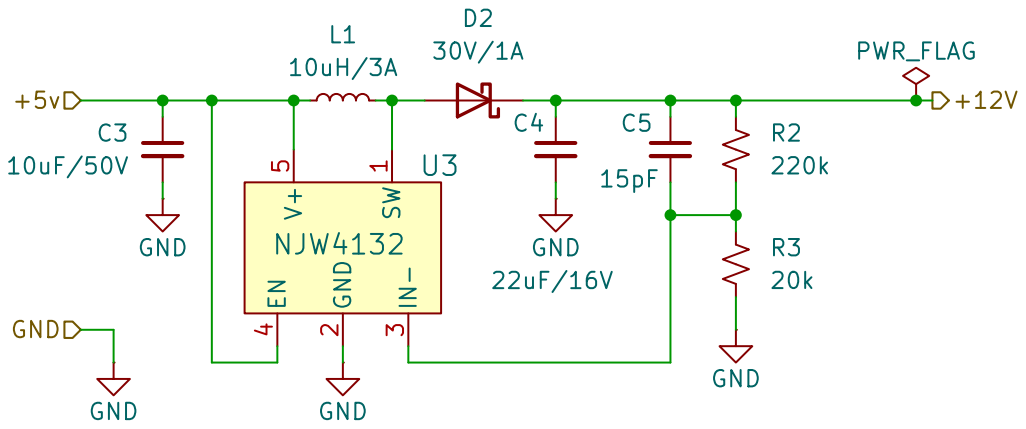
[picture p57: page 2]
