tgtakaoka/retro-bionic/schematics/tms9995/bionic-tms9995.pdf

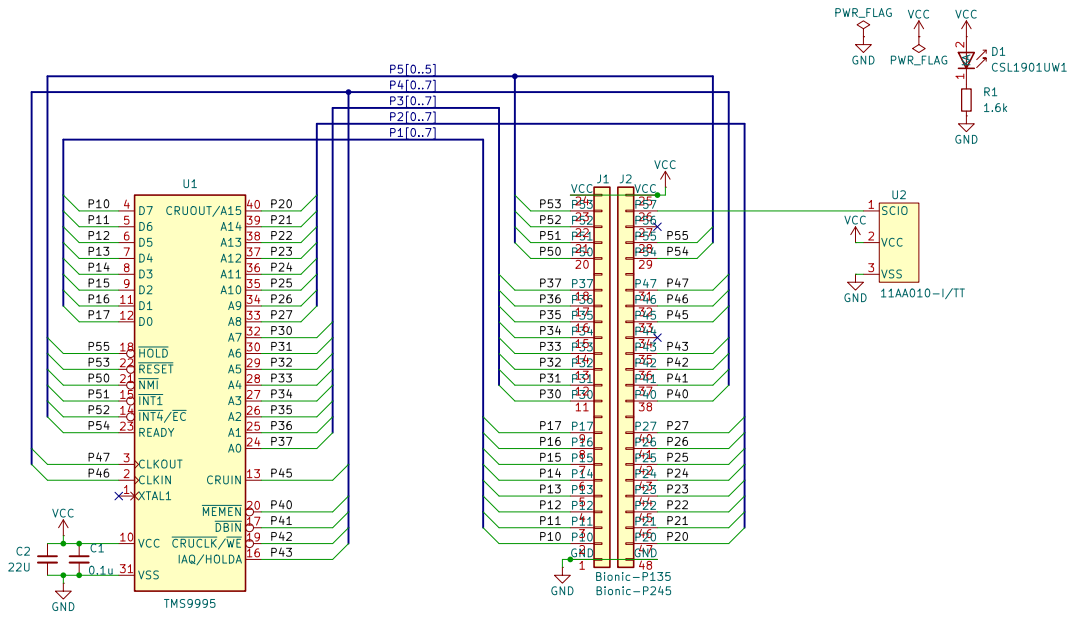
[picture p58: page 1]
