tgtakaoka/retro-bionic/schematics/z80/bionic-z80.pdf

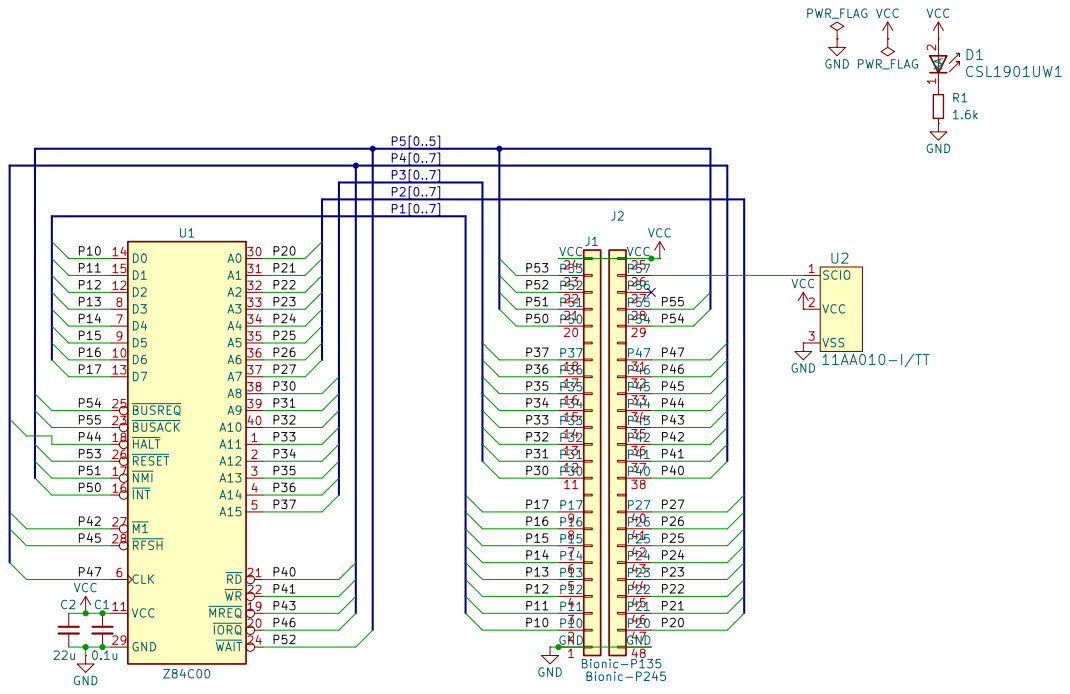
[picture p59: page 1]
