tgtakaoka/retro-bionic/schematics/z8691/bionic-z8691.pdf

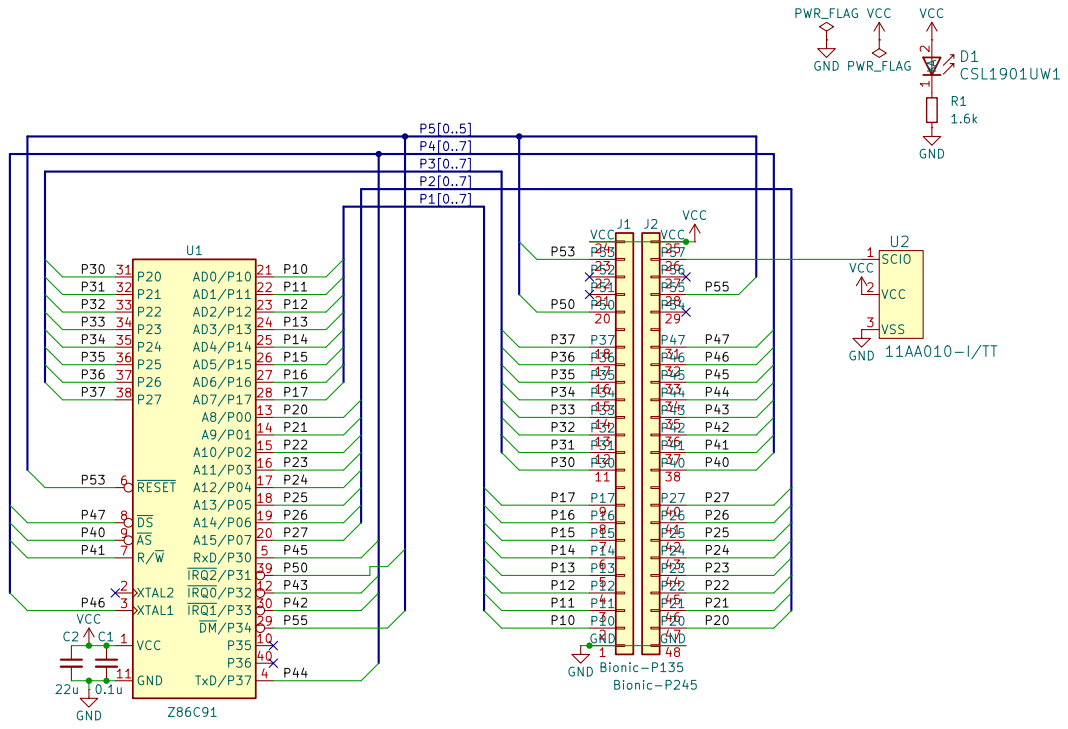
[picture p60: page 1]
