tgtakaoka/retro-bionic/schematics/z8800/bionic-z8800.pdf

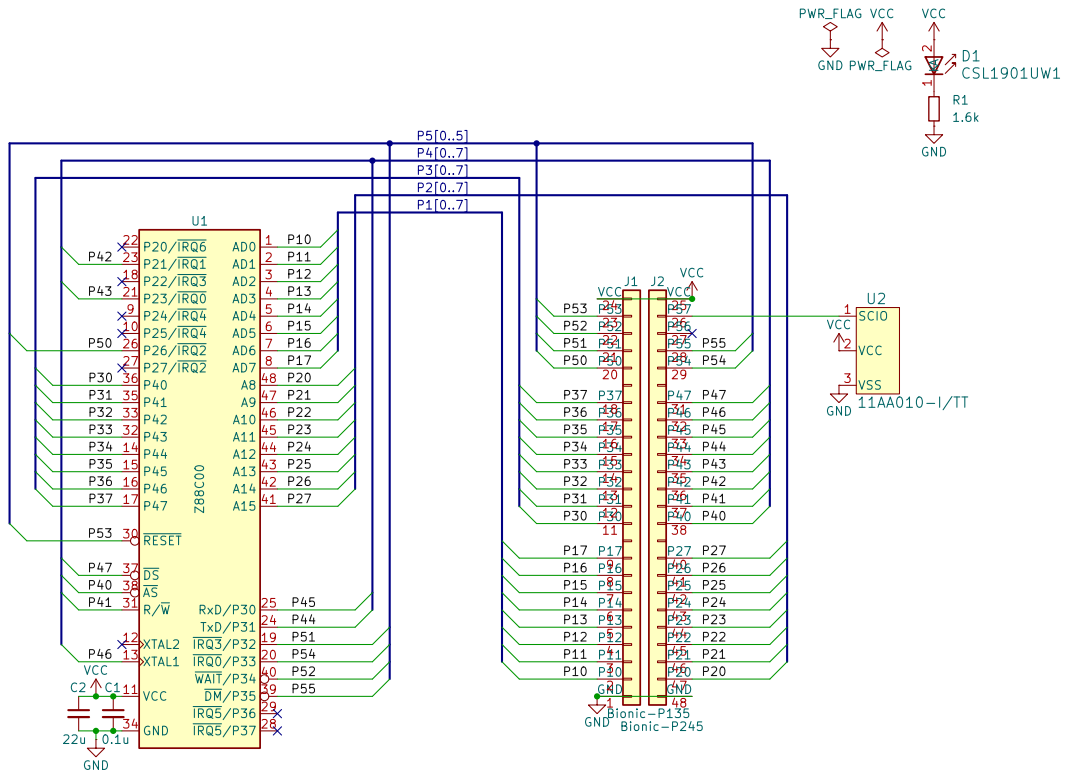
[picture p61: page 1]
