tgtakaoka/retro-bionic/schematics/cdp1802/bionic-cdp1802.pdf

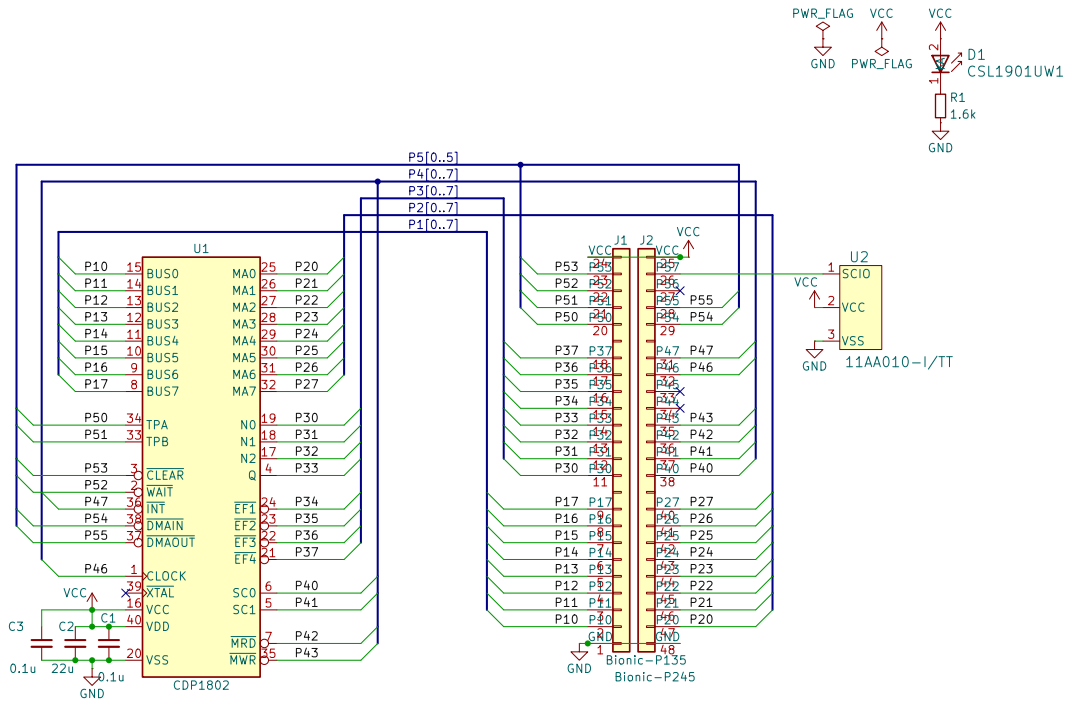
[picture p62: page 1]
