tgtakaoka/retro-bionic/schematics/f3850/bionic-f3850.pdf

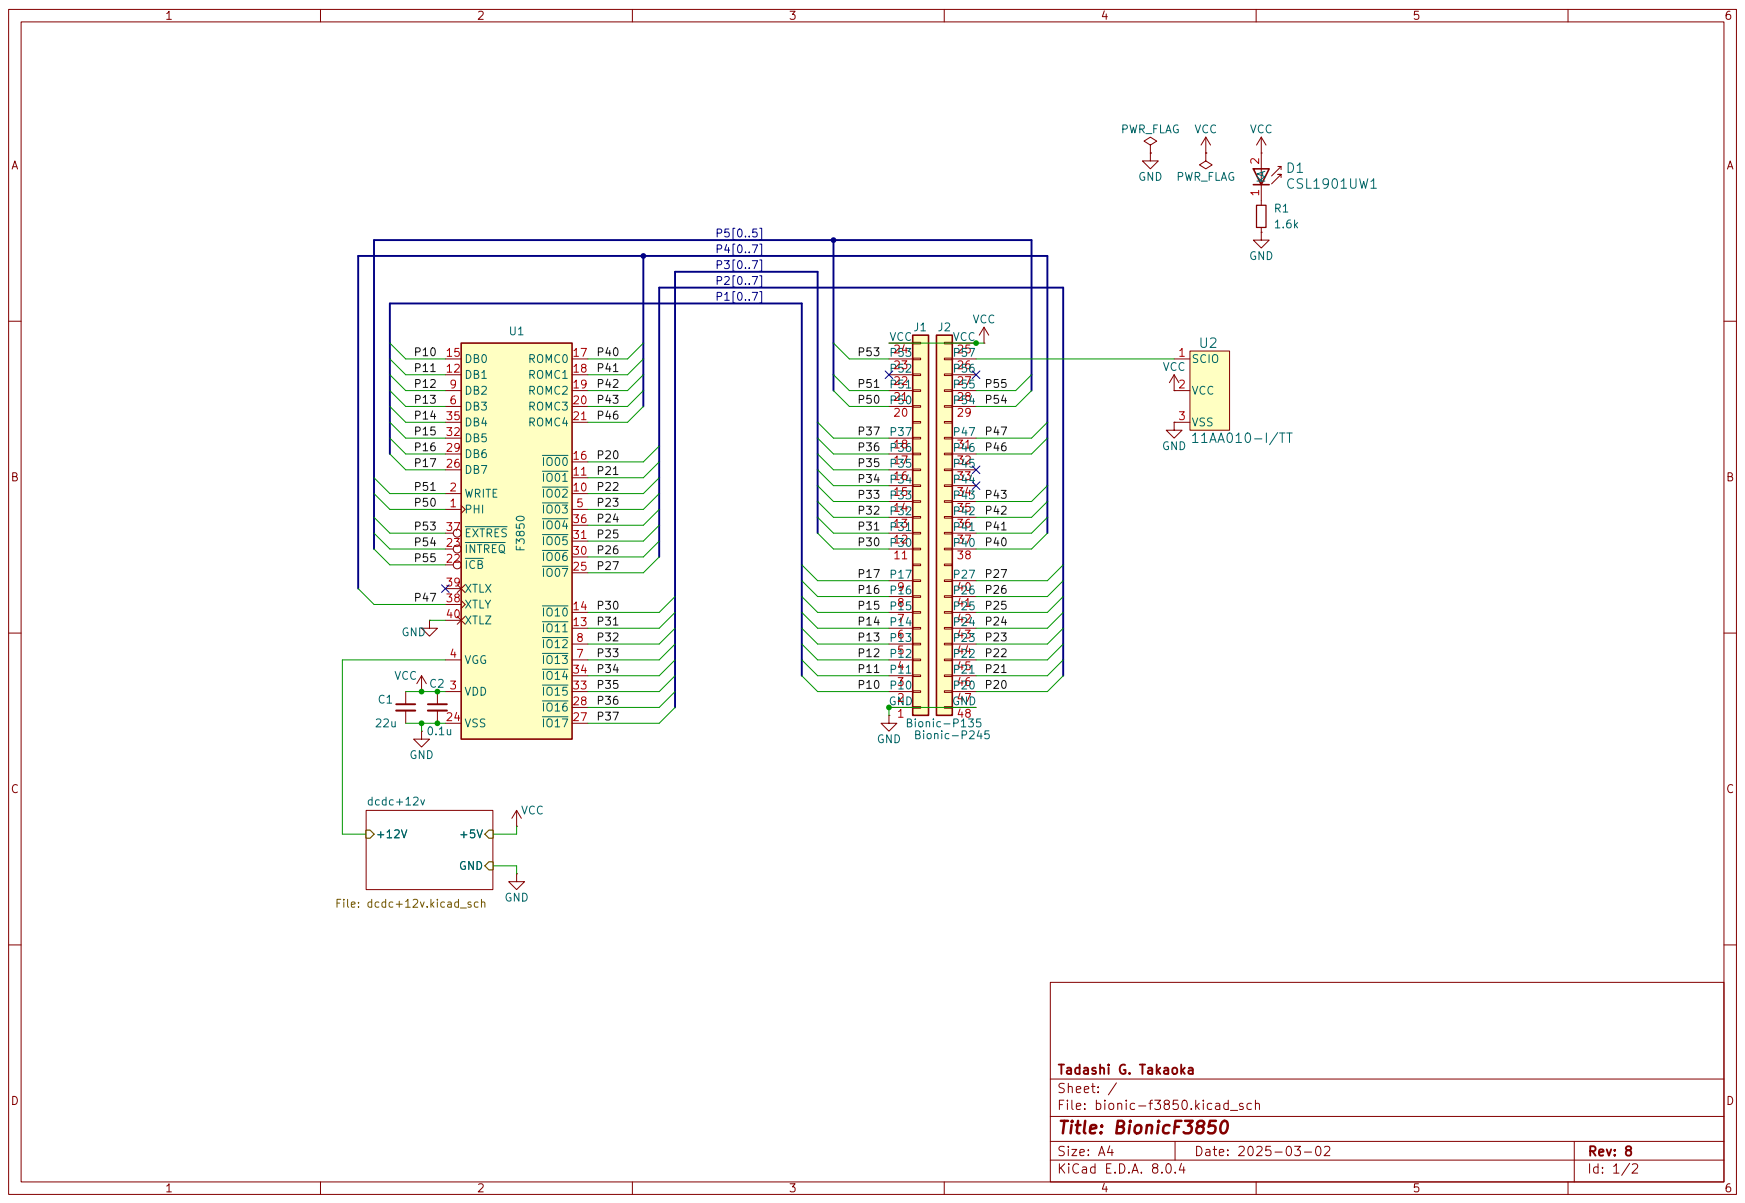
[picture p63: page 1]

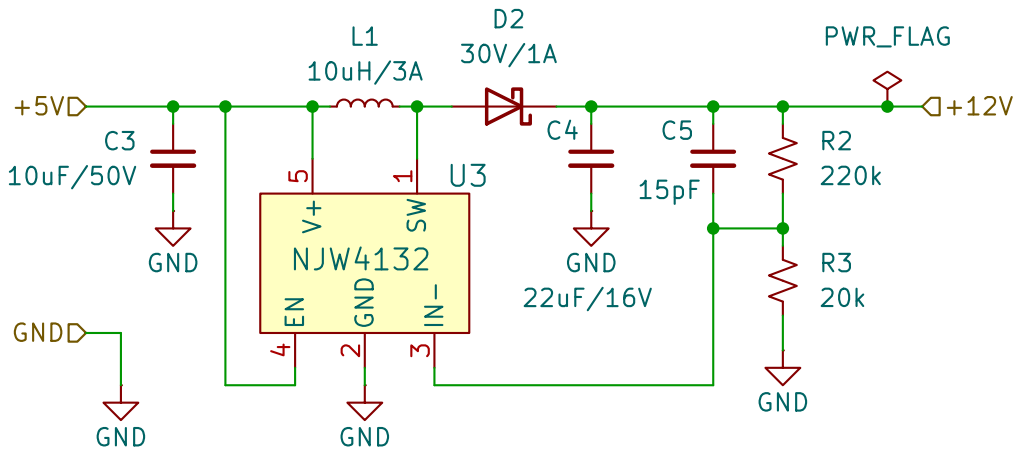
[picture p64: page 2]
