tgtakaoka/retro-bionic/schematics/im6100/bionic-im6100.pdf

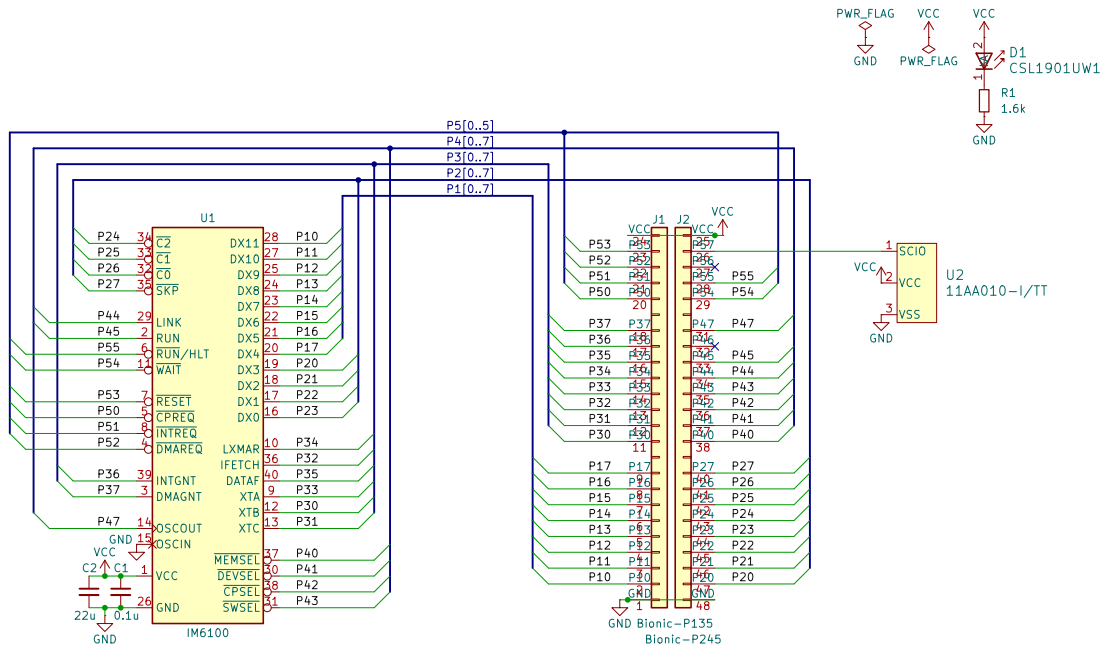
[picture p65: page 1]
