tgtakaoka/retro-bionic/schematics/ins8060/bionic-ins8060.pdf

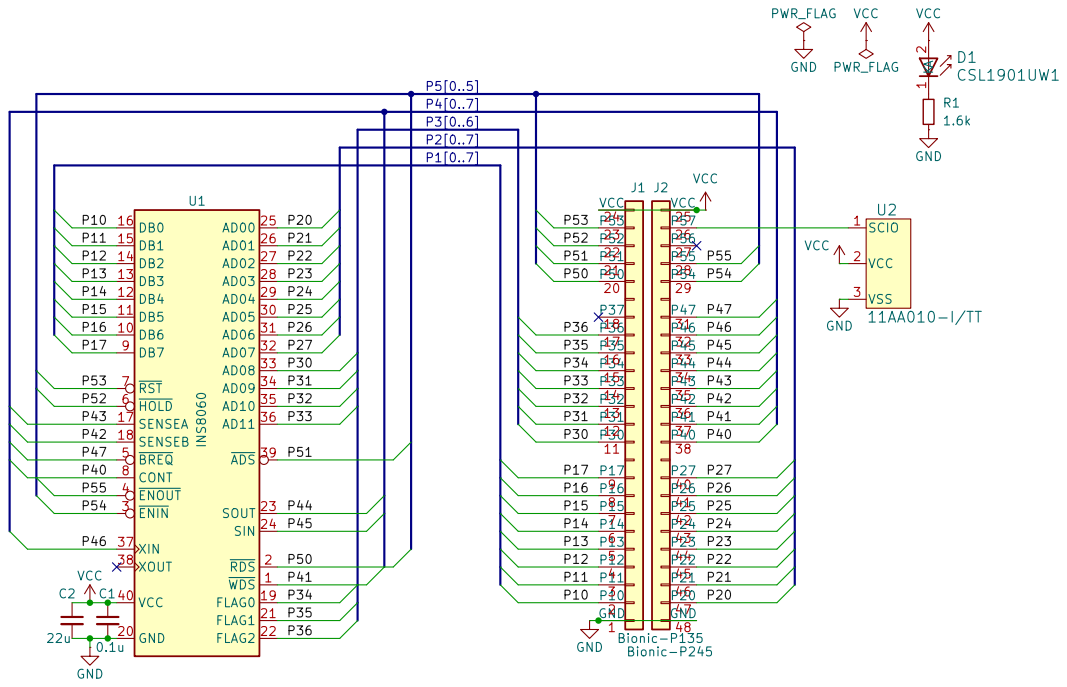
[picture p66: page 1]
