tgtakaoka/retro-bionic/schematics/ins8070/bionic-ins8070.pdf

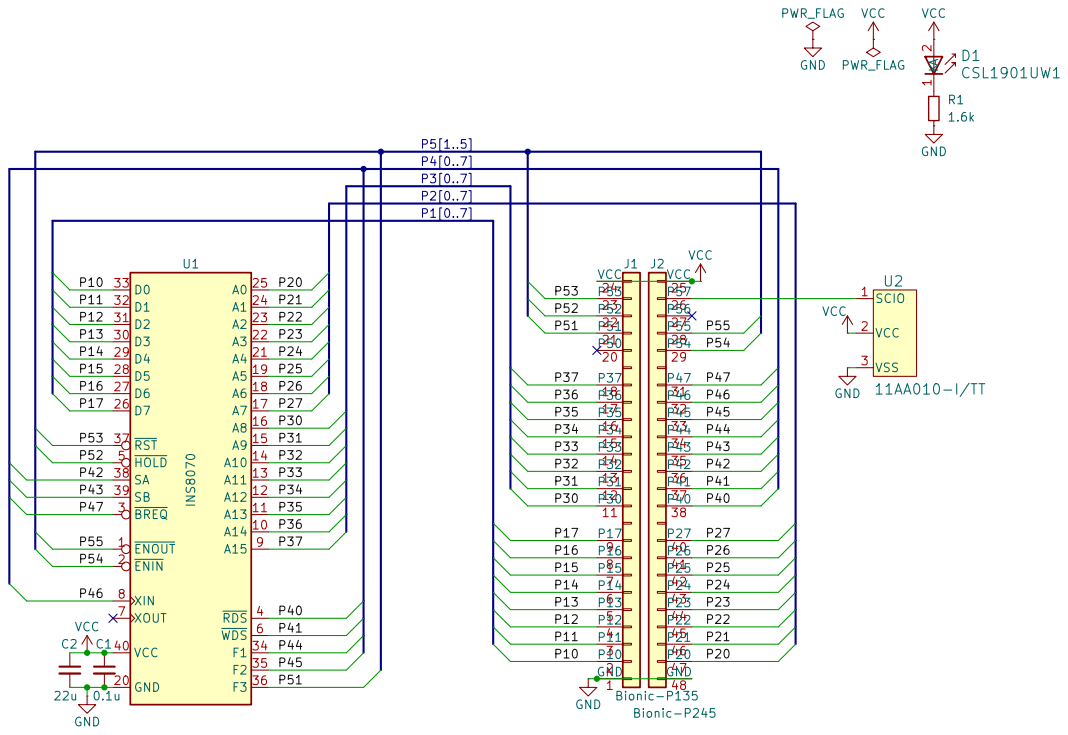
[picture p67: page 1]
