tgtakaoka/retro-bionic/schematics/mc6800/bionic-mc6800.pdf

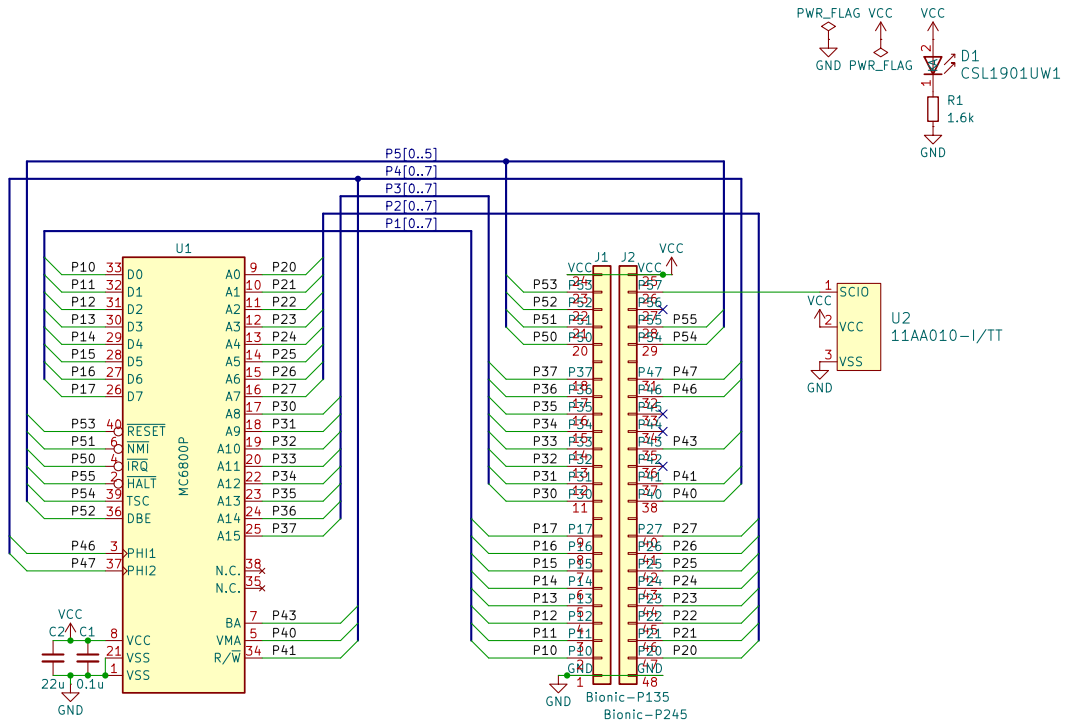
[picture p68: page 1]
