tgtakaoka/retro-bionic/schematics/mc6801/bionic-mc6801.pdf

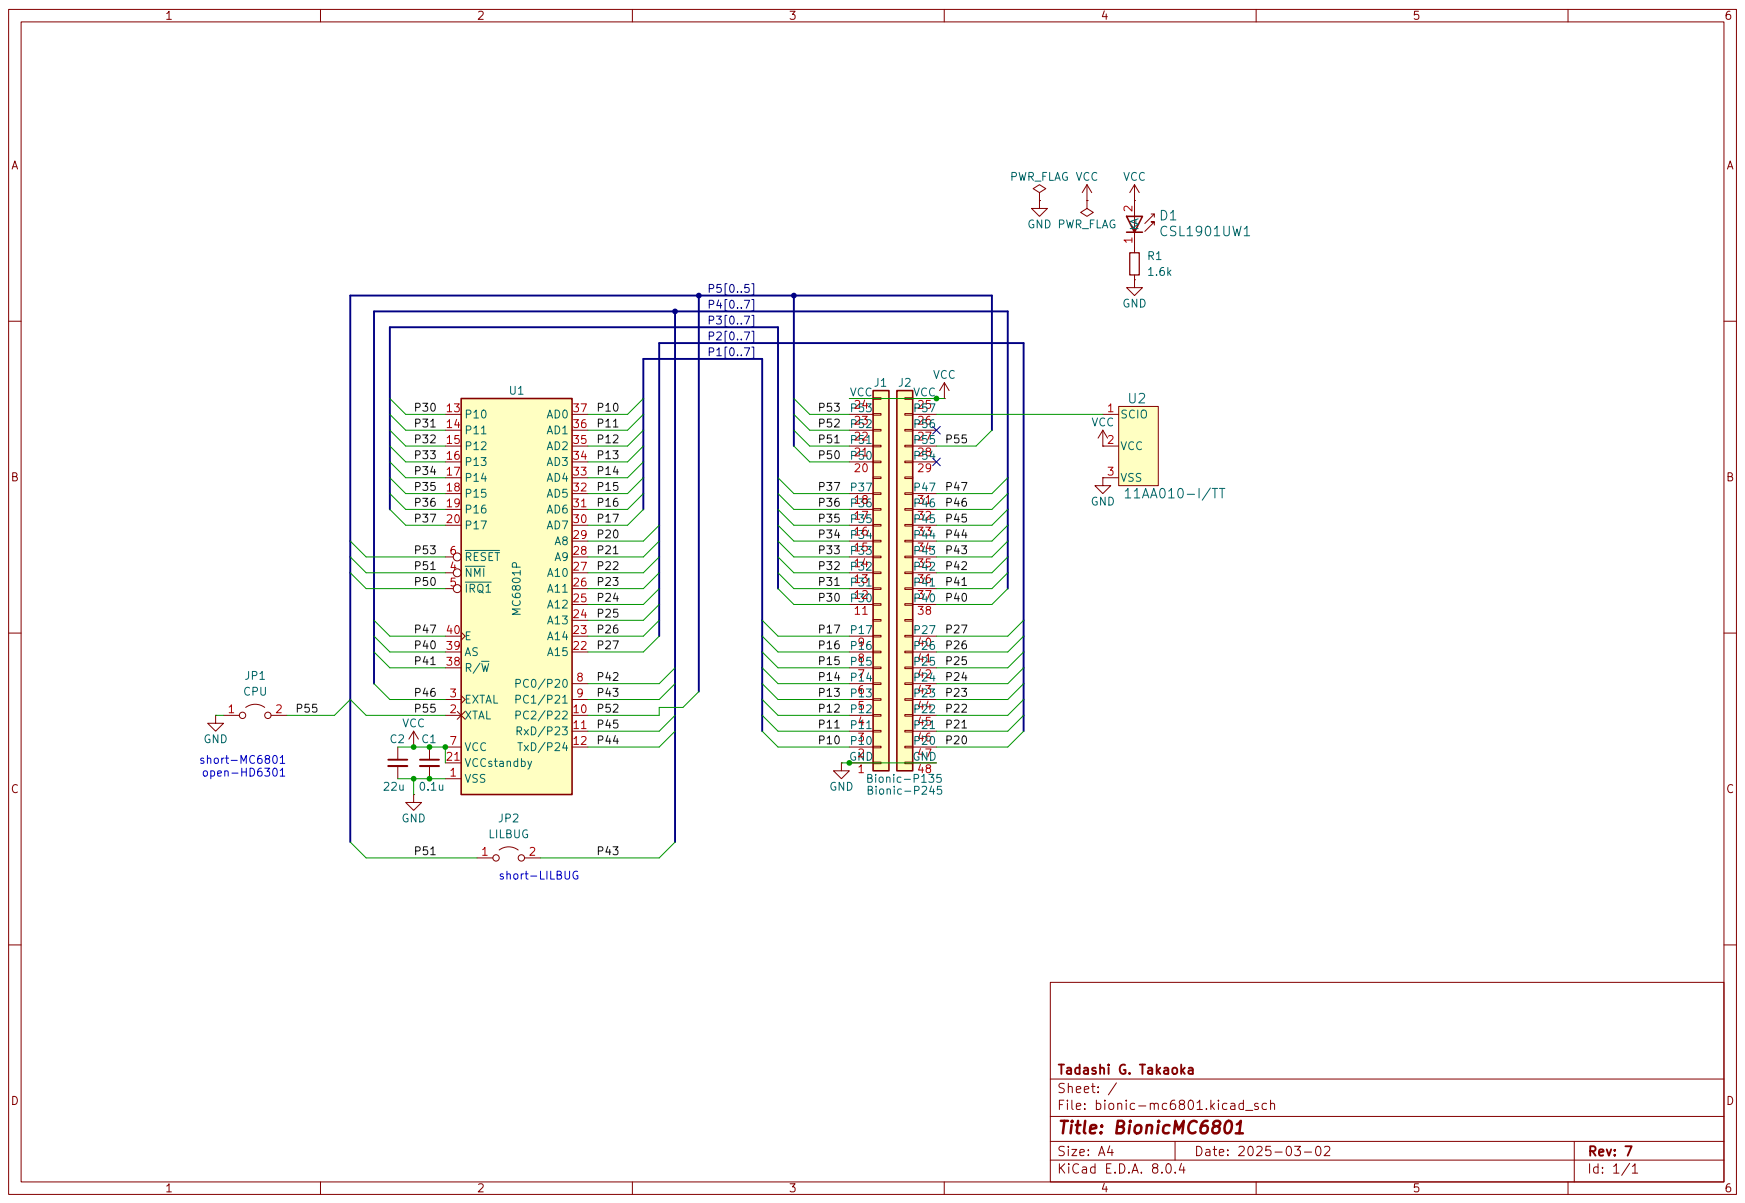
[picture p69: page 1]
