tgtakaoka/retro-bionic/schematics/mc6802/bionic-mc6802.pdf

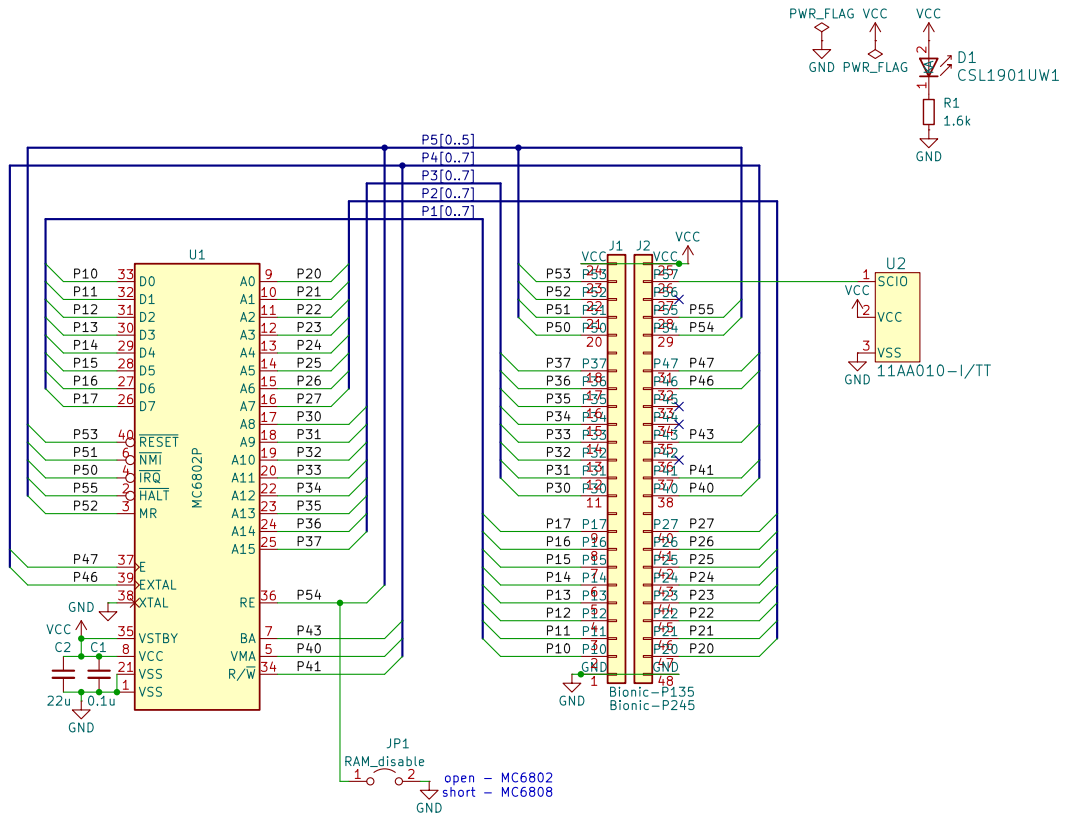
[picture p70: page 1]
