tgtakaoka/retro-bionic/schematics/mc6809/bionic-mc6809.pdf

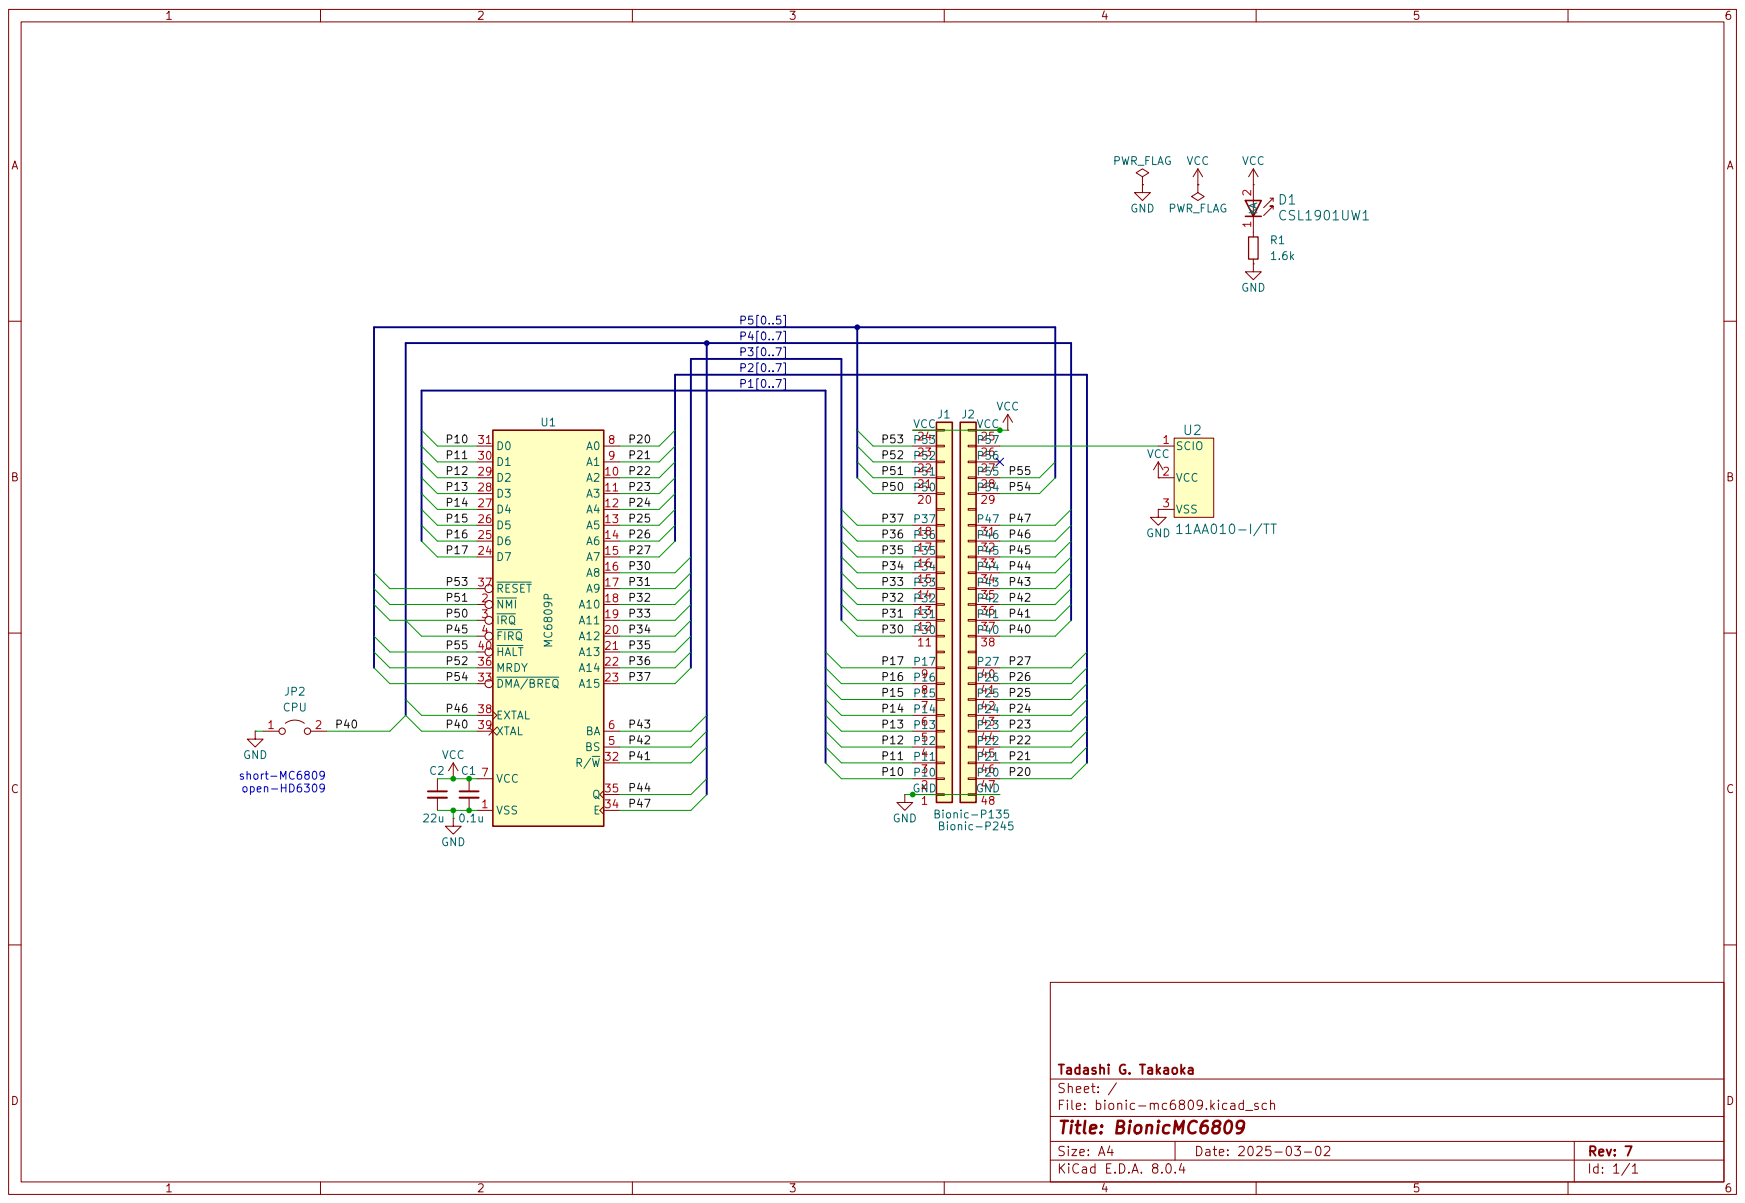
[picture p71: page 1]
