tgtakaoka/retro-bionic/schematics/mc6809e/bionic-mc6809e.pdf

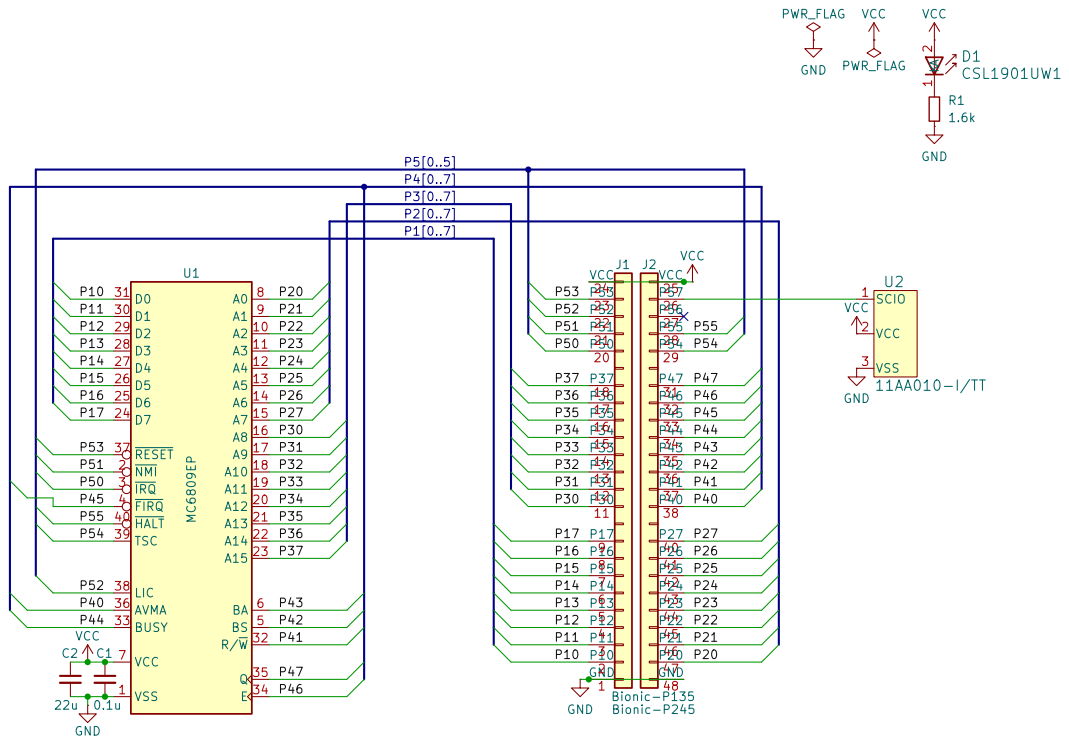
[picture p72: page 1]
