tgtakaoka/retro-bionic/schematics/mc68hc05c0/bionic-mc68hc05c0.pdf

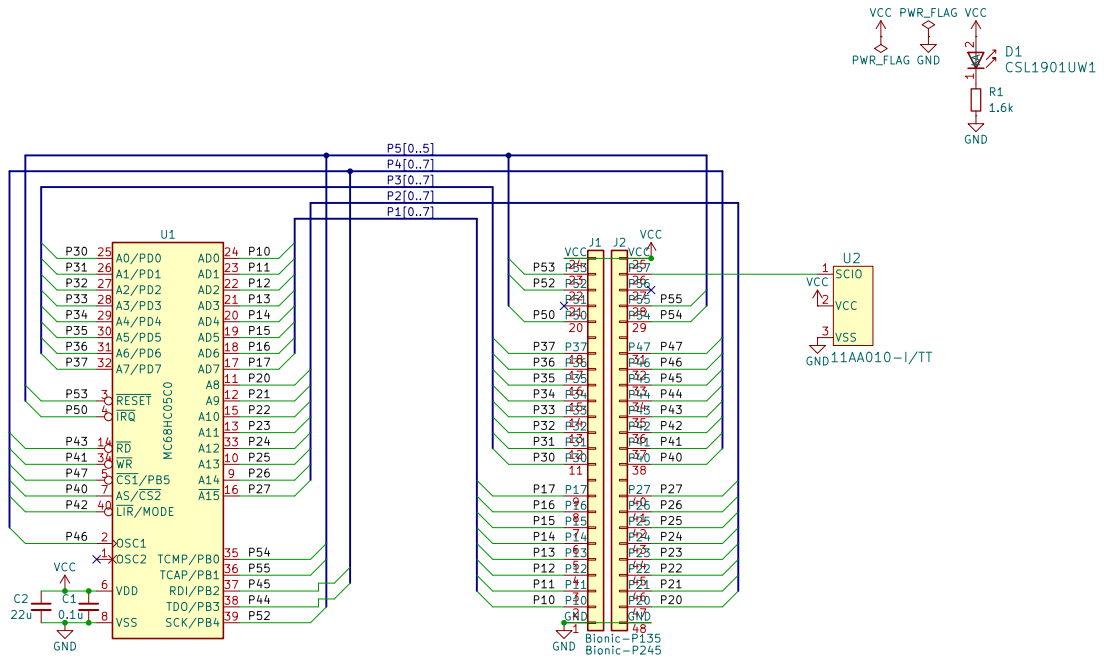
[picture p73: page 1]
