tgtakaoka/retro-bionic/schematics/mc68hc11a/bionic-mc68hc11a.pdf

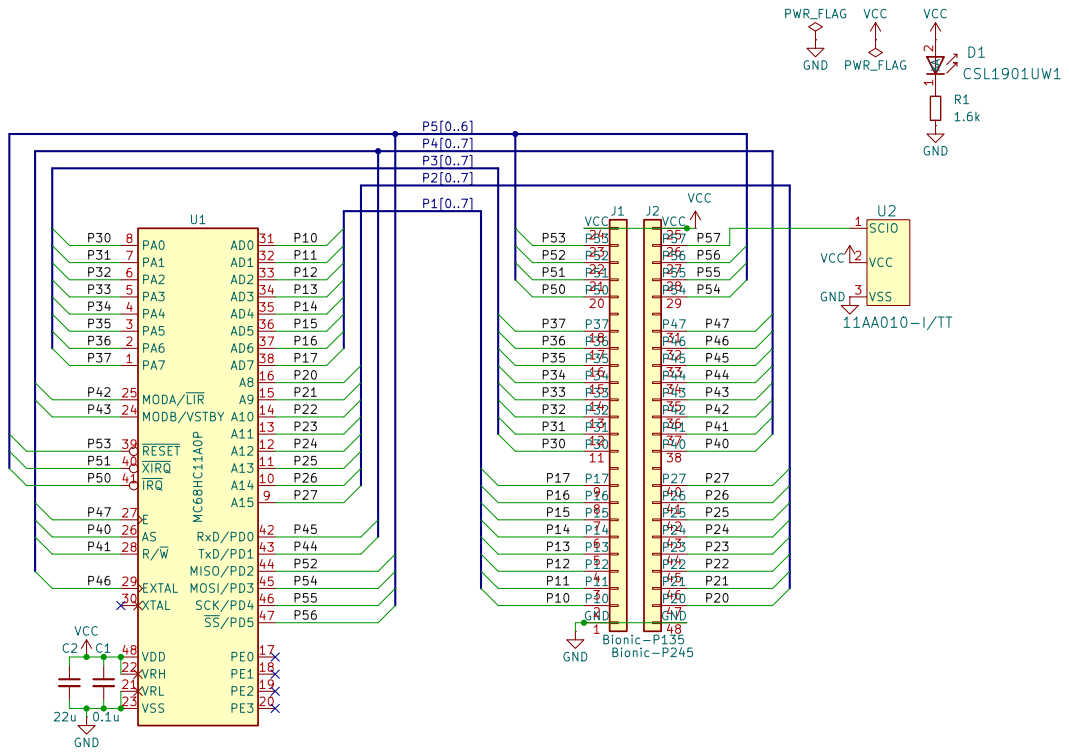
[picture p74: page 1]
