tgtakaoka/retro-bionic/schematics/mc68hc11d/bionic-mc68hc11d.pdf

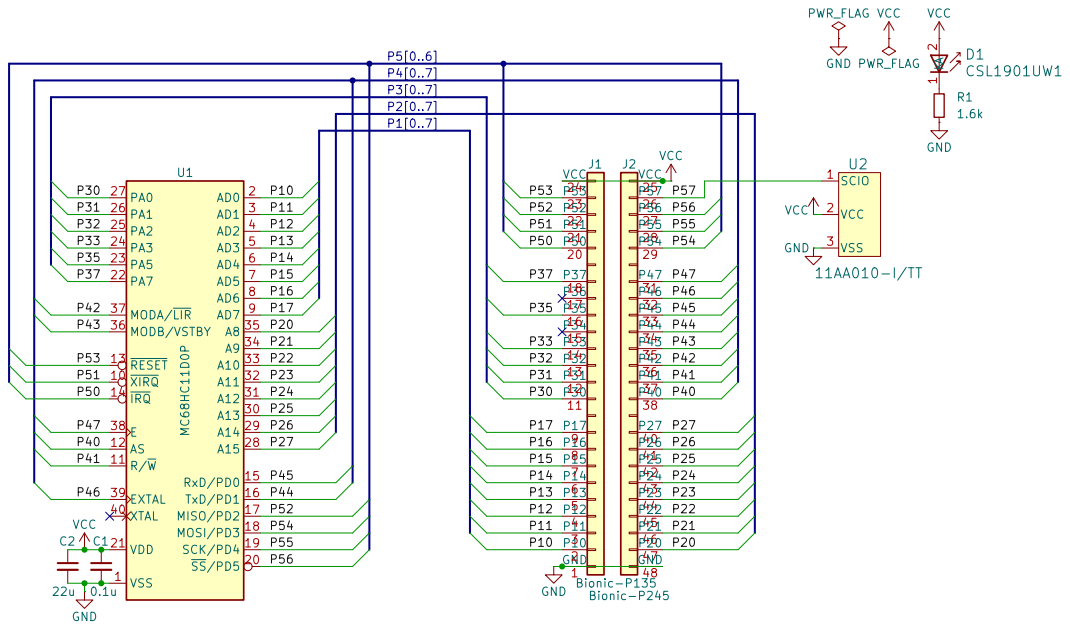
[picture p75: page 1]
