tgtakaoka/retro-bionic/schematics/base/bionic-base.pdf

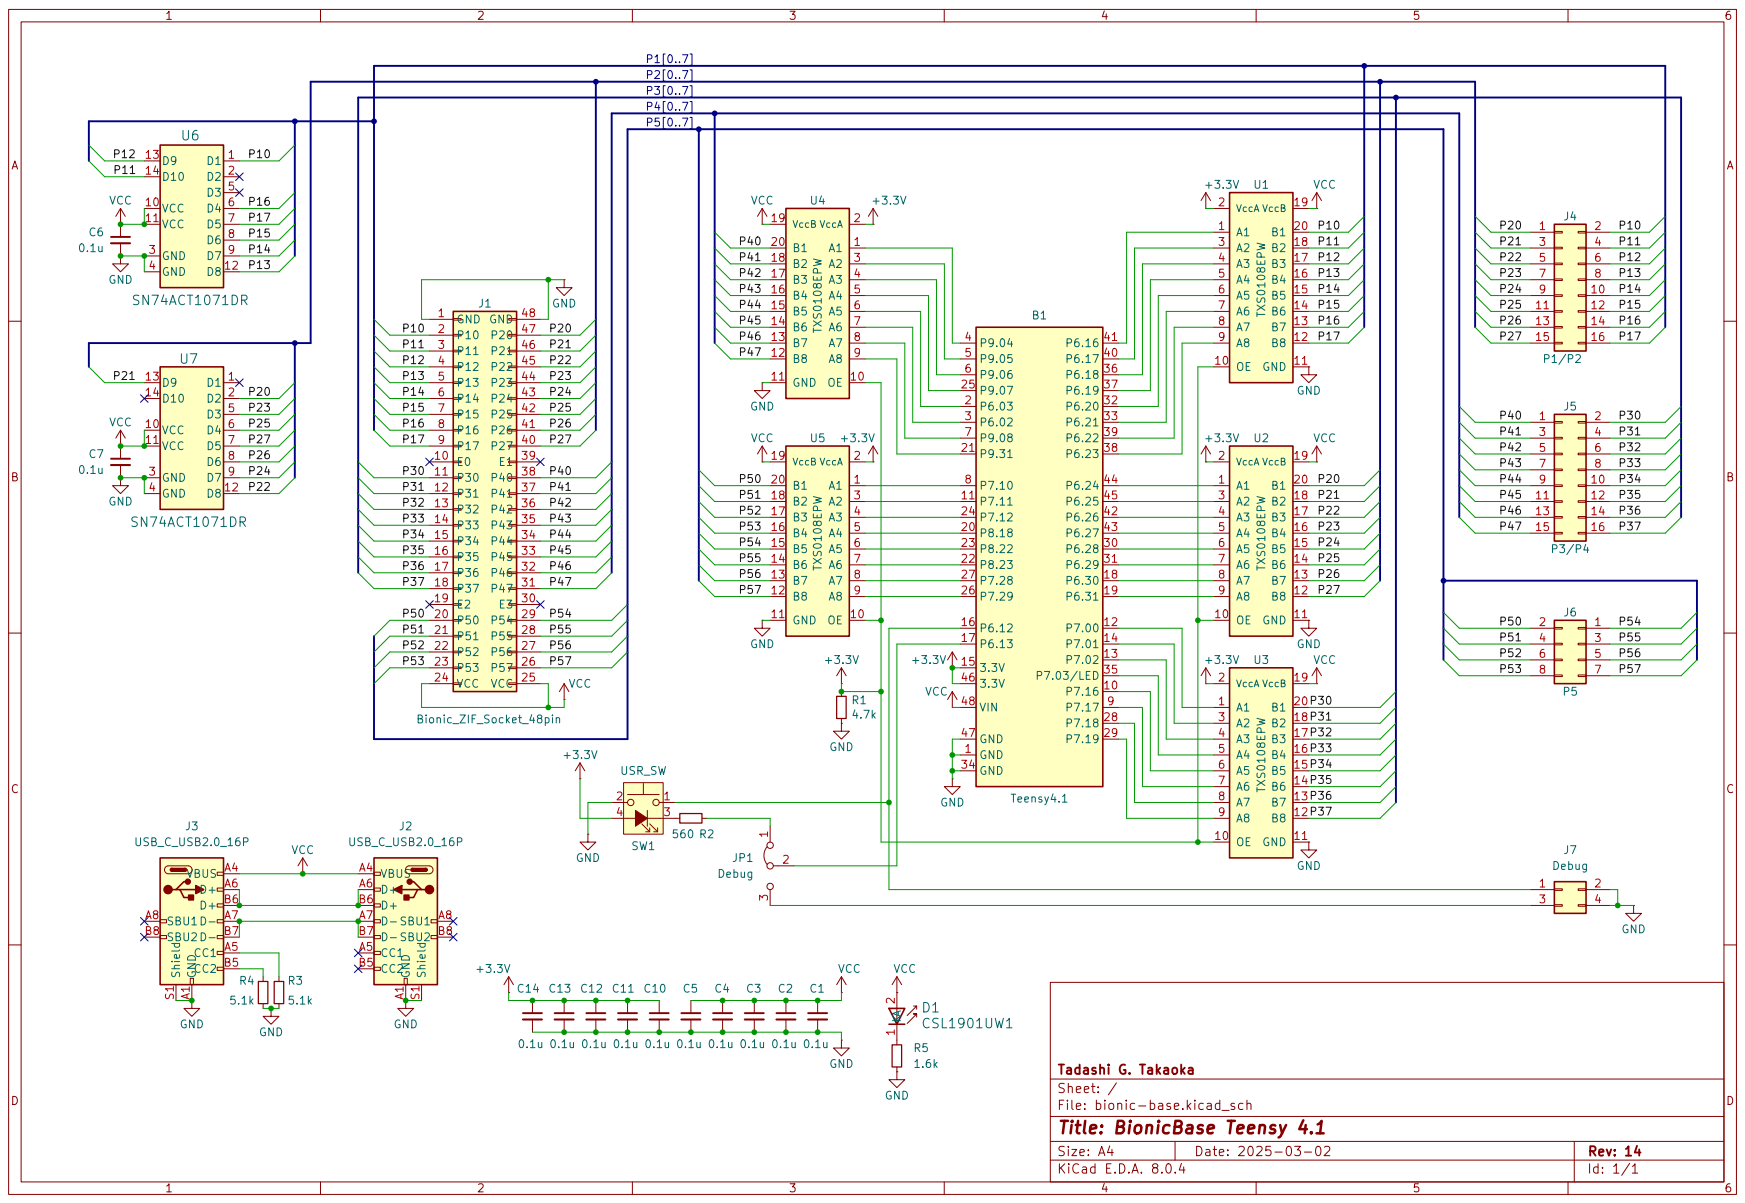
[picture p76: page 1]
