tgtakaoka/retro-bionic/schematics/hd6120/bionic-hd6120.pdf

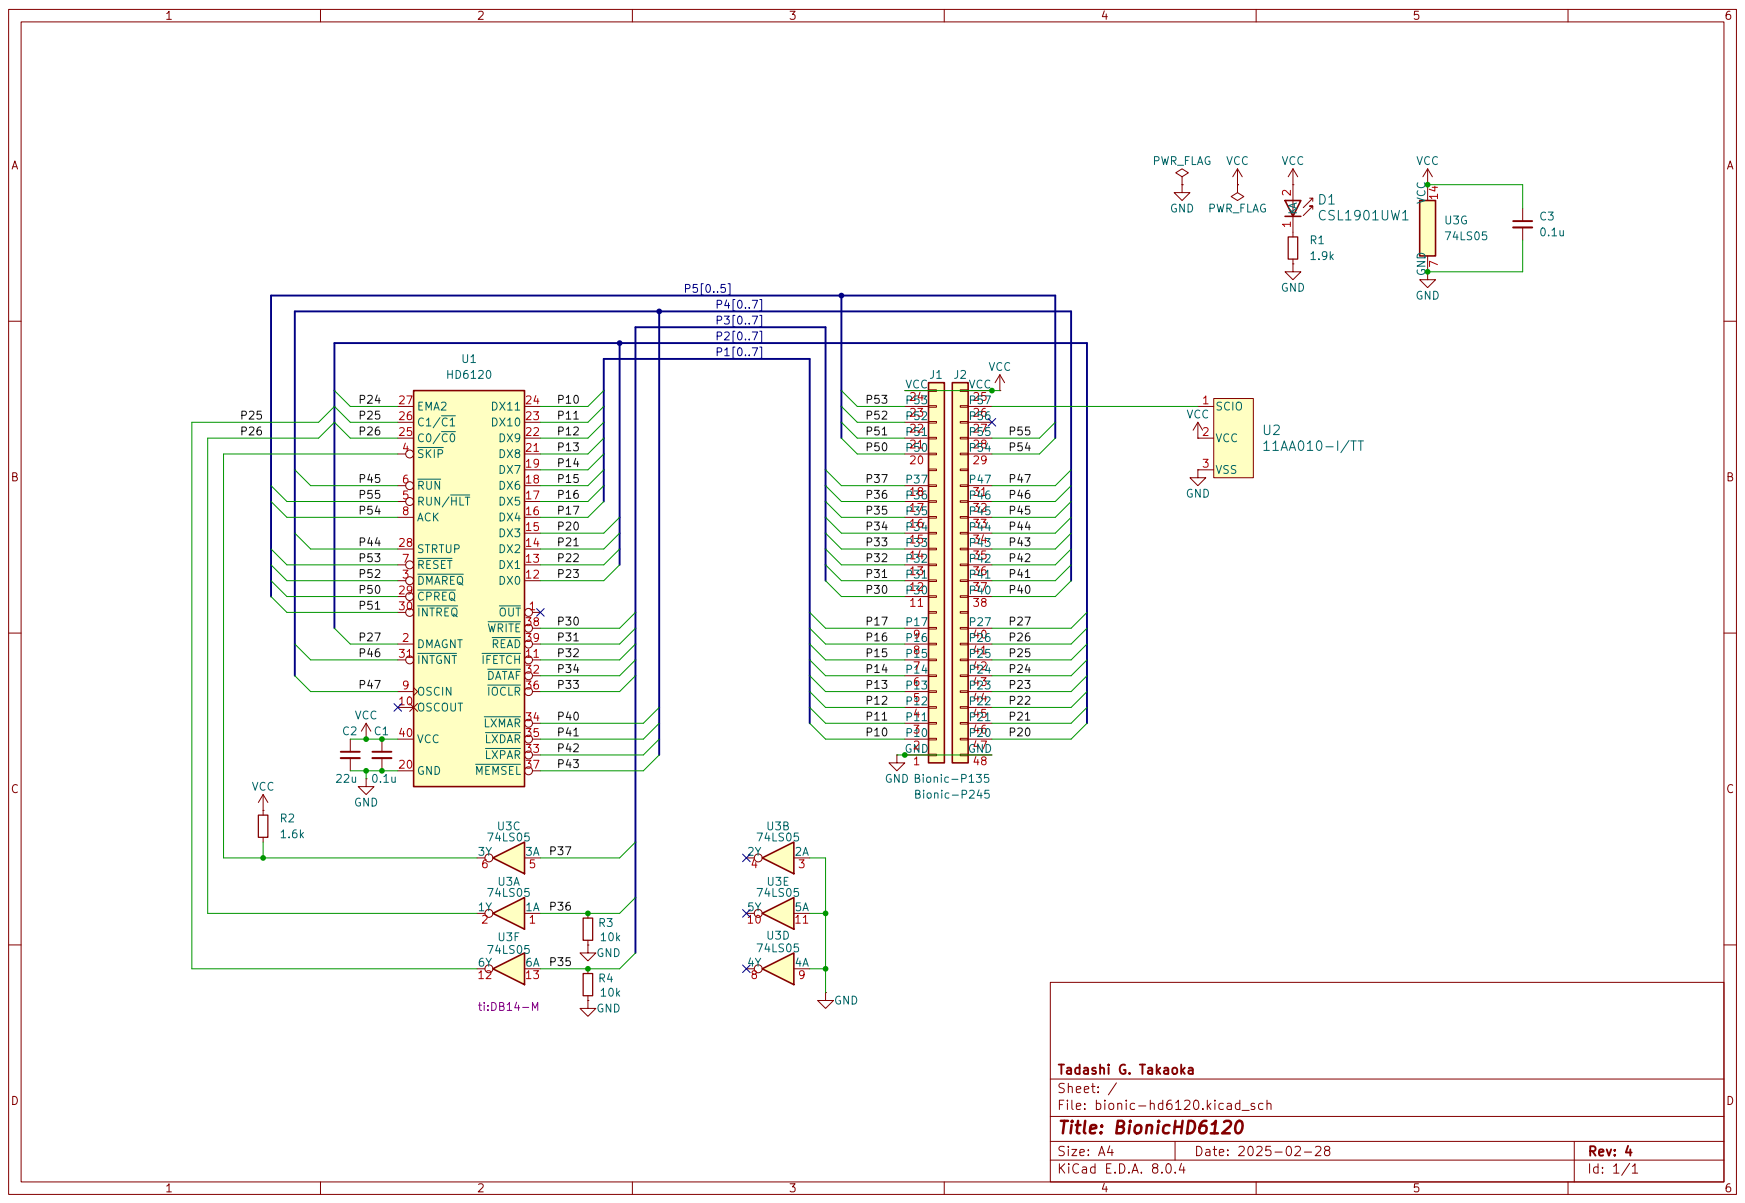
[picture p77: page 1]
