tgtakaoka/retro-bionic/schematics/hd641016/bionic-hd641016.kicad_pcb

## KiCad design schematics/hd641016/bionic-hd641016.kicad_pcb (2026-11-05)

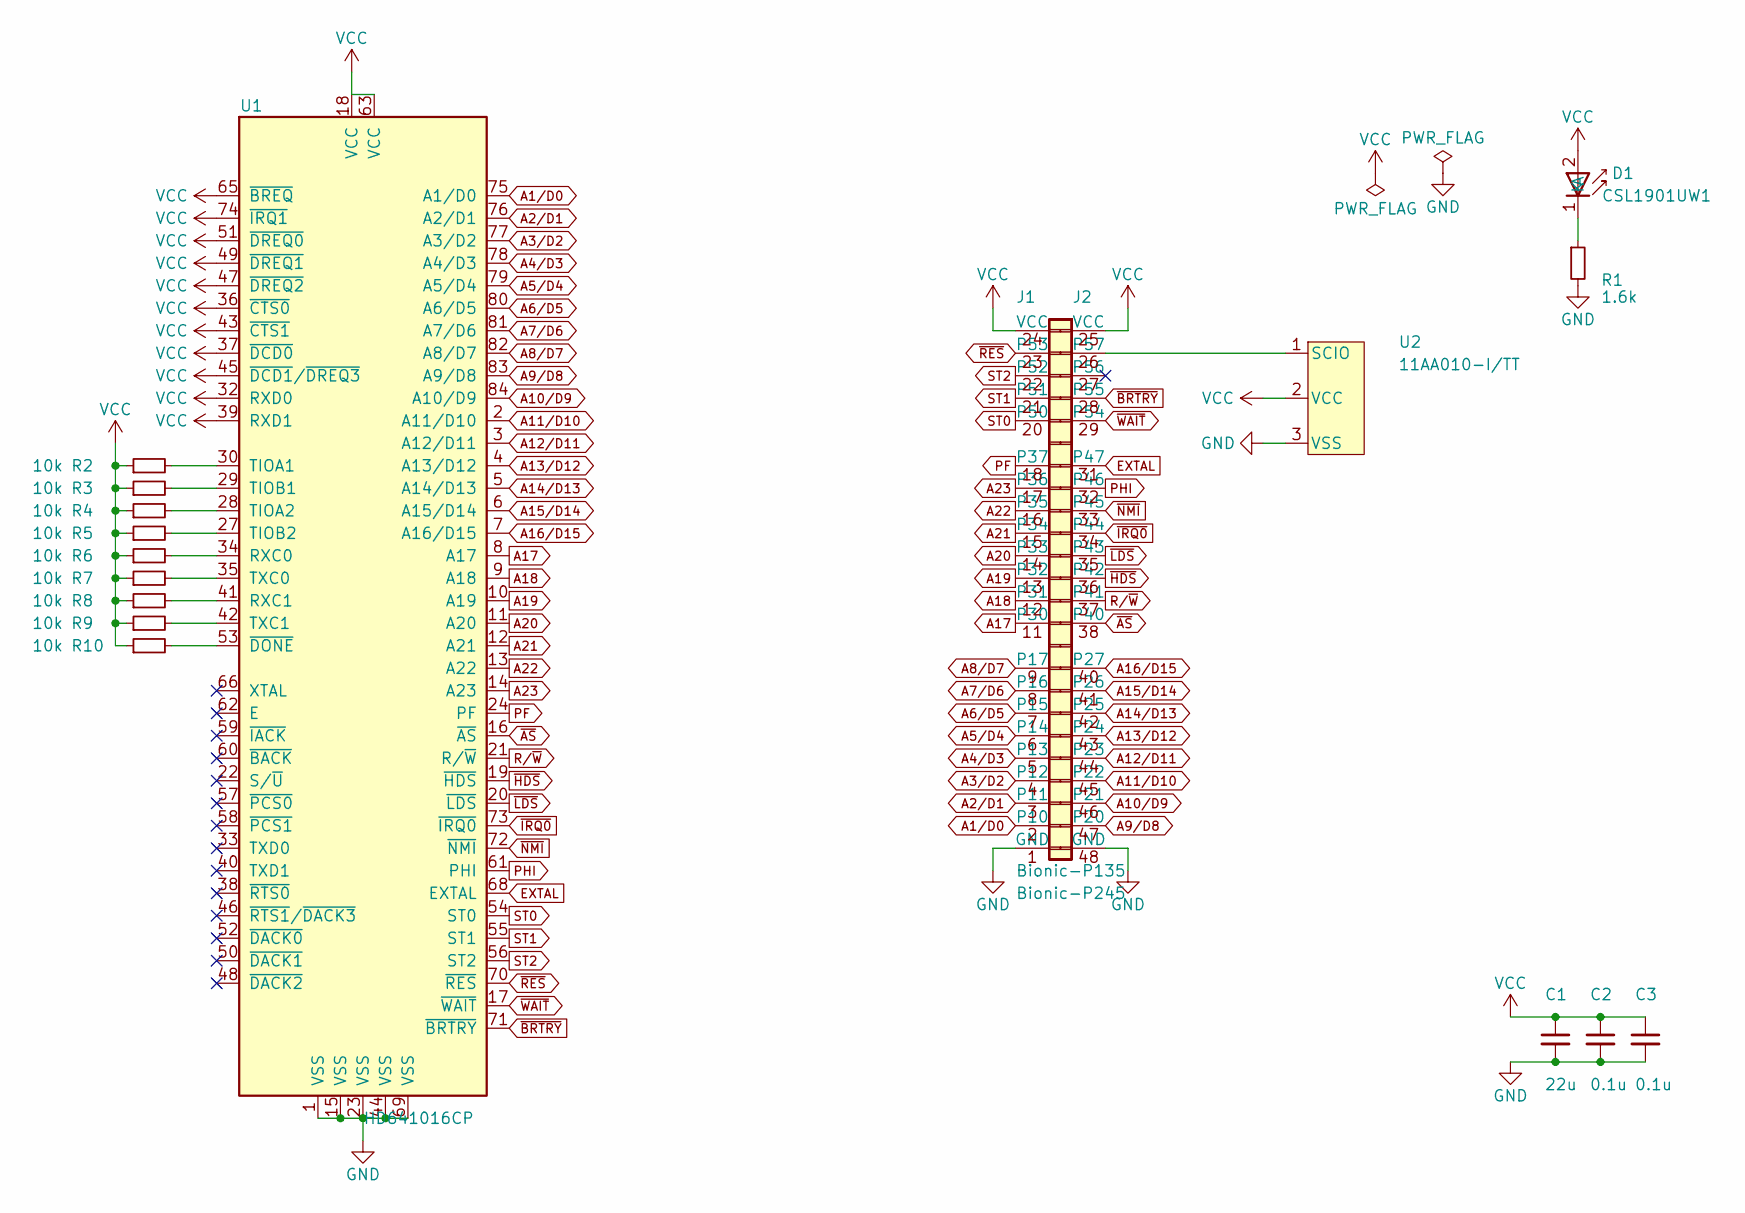
[picture p81: schematic bionic-hd641016.kicad_sch, BionicHD641016]

Parts:
C1: 22u; C_0603_1608Metric_Pad1.08x0.95mm_HandSolder
C2, C3: 0.1u; C_0603_1608Metric_Pad1.08x0.95mm_HandSolder
D1: CSL1901UW1; LED_CSL1901UW1_ROM-M
J1: Bionic-P135; Bionic-P135_SMT
J2: Bionic-P245; Bionic-P245_SMT
R1: 1.6k; R_0603_1608Metric_Pad0.98x0.95mm_HandSolder
R2, R3, R4, R5, R6, R7, R8, R9, R10: 10k; R_0603_1608Metric_Pad0.98x0.95mm_HandSolder
U1: HD641016CP; 848421B1RKTP
U2: 11AA010-I/TT; SOT-23_MC_MCH-M

Connections:
A1/D0: J1.2 (P10), U1.75 (A1/D0)
A2/D1: J1.3 (P11), U1.76 (A2/D1)
A3/D2: J1.4 (P12), U1.77 (A3/D2)
A4/D3: J1.5 (P13), U1.78 (A4/D3)
A5/D4: J1.6 (P14), U1.79 (A5/D4)
A6/D5: J1.7 (P15), U1.80 (A6/D5)
A7/D6: J1.8 (P16), U1.81 (A7/D6)
A8/D7: J1.9 (P17), U1.82 (A8/D7)
A9/D8: J2.47 (P20), U1.83 (A9/D8)
A10/D9: J2.46 (P21), U1.84 (A10/D9)
A11/D10: J2.45 (P22), U1.2 (A11/D10)
A12/D11: J2.44 (P23), U1.3 (A12/D11)
A13/D12: J2.43 (P24), U1.4 (A13/D12)
A14/D13: J2.42 (P25), U1.5 (A14/D13)
A15/D14: J2.41 (P26), U1.6 (A15/D14)
A16/D15: J2.40 (P27), U1.7 (A16/D15)
A17: J1.11 (P30), U1.8 (A17)
A18: J1.12 (P31), U1.9 (A18)
A19: J1.13 (P32), U1.10 (A19)
A20: J1.14 (P33), U1.11 (A20)
A21: J1.15 (P34), U1.12 (A21)
A22: J1.16 (P35), U1.13 (A22)
A23: J1.17 (P36), U1.14 (A23)
EXTAL: J2.31 (P47), U1.68 (EXTAL)
GND: C1.2, C2.2, C3.2, J1.1 (GND), J2.48 (GND), R1.2, U1.1 (VSS), U1.15 (VSS), U1.23 (VSS), U1.44 (VSS), U1.69 (VSS), U2.3 (VSS)
unnamed: D1.1 (K), R1.1
unnamed: J2.26 (P57), U2.1 (SCIO)
unnamed: R6.2, U1.34 (RXC0)
unnamed: R8.2, U1.41 (RXC1)
unnamed: R2.2, U1.30 (TIOA1)
unnamed: R4.2, U1.28 (TIOA2)
unnamed: R3.2, U1.29 (TIOB1)
unnamed: R5.2, U1.27 (TIOB2)
unnamed: R7.2, U1.35 (TXC0)
unnamed: R9.2, U1.42 (TXC1)
unnamed: R10.2, U1.53 (~DONE)
PF: J1.18 (P37), U1.24 (PF)
PHI: J2.32 (P46), U1.61 (PHI)
R/~W: J2.37 (P41), U1.21 (R/~W)
ST0: J1.20 (P50), U1.54 (ST0)
ST1: J1.21 (P51), U1.55 (ST1)
ST2: J1.22 (P52), U1.56 (ST2)
VCC: C1.1, C2.1, C3.1, D1.2 (A), J1.24 (VCC), J2.25 (VCC), R2.1, R3.1, R4.1, R5.1, R6.1, R7.1, R8.1, R9.1, R10.1, U1.18 (VCC), U1.32 (RXD0), U1.36 (~CTS0), U1.37 (~DCD0), U1.39 (RXD1), U1.43 (~CTS1), U1.45 (~DCD1/~DREQ3), U1.47 (~DREQ2), U1.49 (~DREQ1), U1.51 (~DREQ0), U1.63 (VCC), U1.65 (~BREQ), U1.74 (~IRQ1), U2.2 (VCC)
~AS: J2.38 (P40), U1.16 (~AS)
~BRTRY: J2.28 (P55), U1.71 (~BRTRY)
~HDS: J2.36 (P42), U1.19 (~HDS)
~IRQ0: J2.34 (P44), U1.73 (~IRQ0)
~LDS: J2.35 (P43), U1.20 (~LDS)
~NMI: J2.33 (P45), U1.72 (~NMI)
~RES: J1.23 (P53), U1.70 (~RES)
~WAIT: J2.29 (P54), U1.17 (~WAIT)

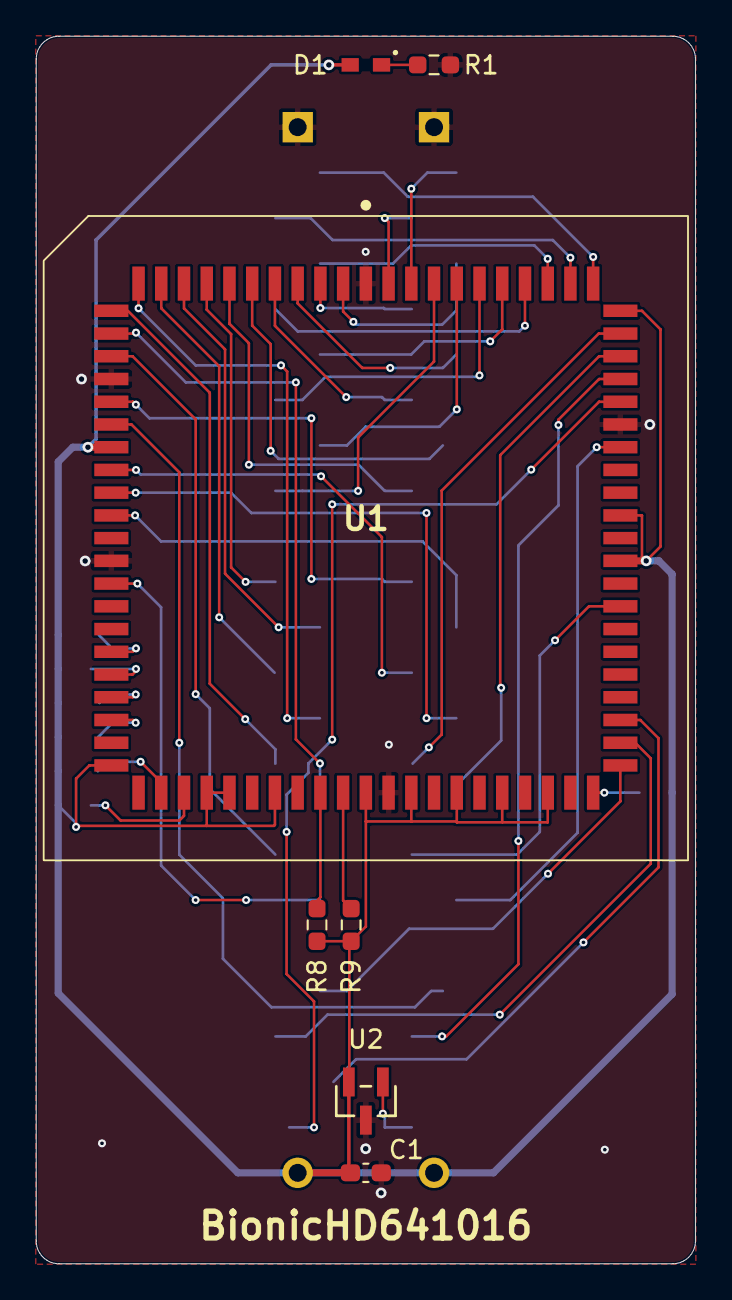
[picture p82: board bionic-hd641016.kicad_pcb from above]

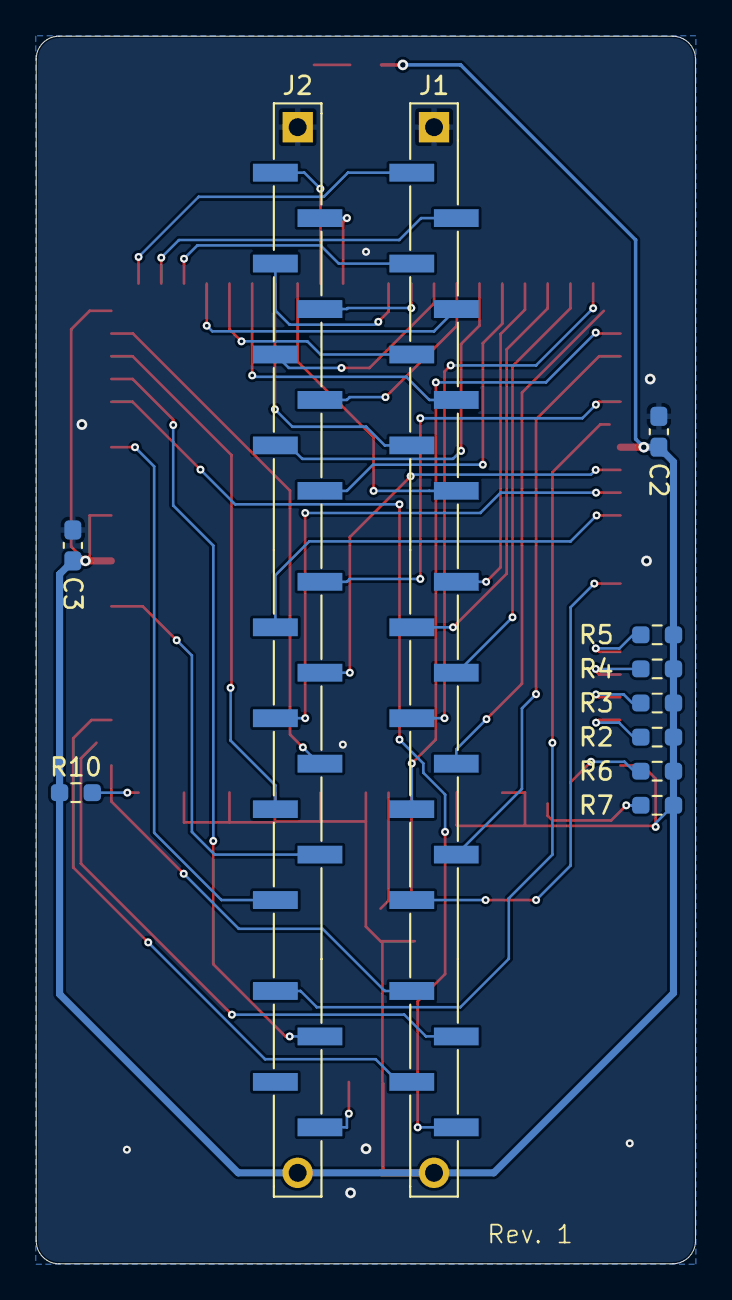
[picture p83: board bionic-hd641016.kicad_pcb from below]

Board: 2 copper layers, 36.8 x 68.6 mm, 18 parts (11 on the bottom side), 51 nets.
