tgtakaoka/retro-bionic/schematics/p8095/bionic-p8095.kicad_pcb

## KiCad design schematics/p8095/bionic-p8095.kicad_pcb (2026-11-05)

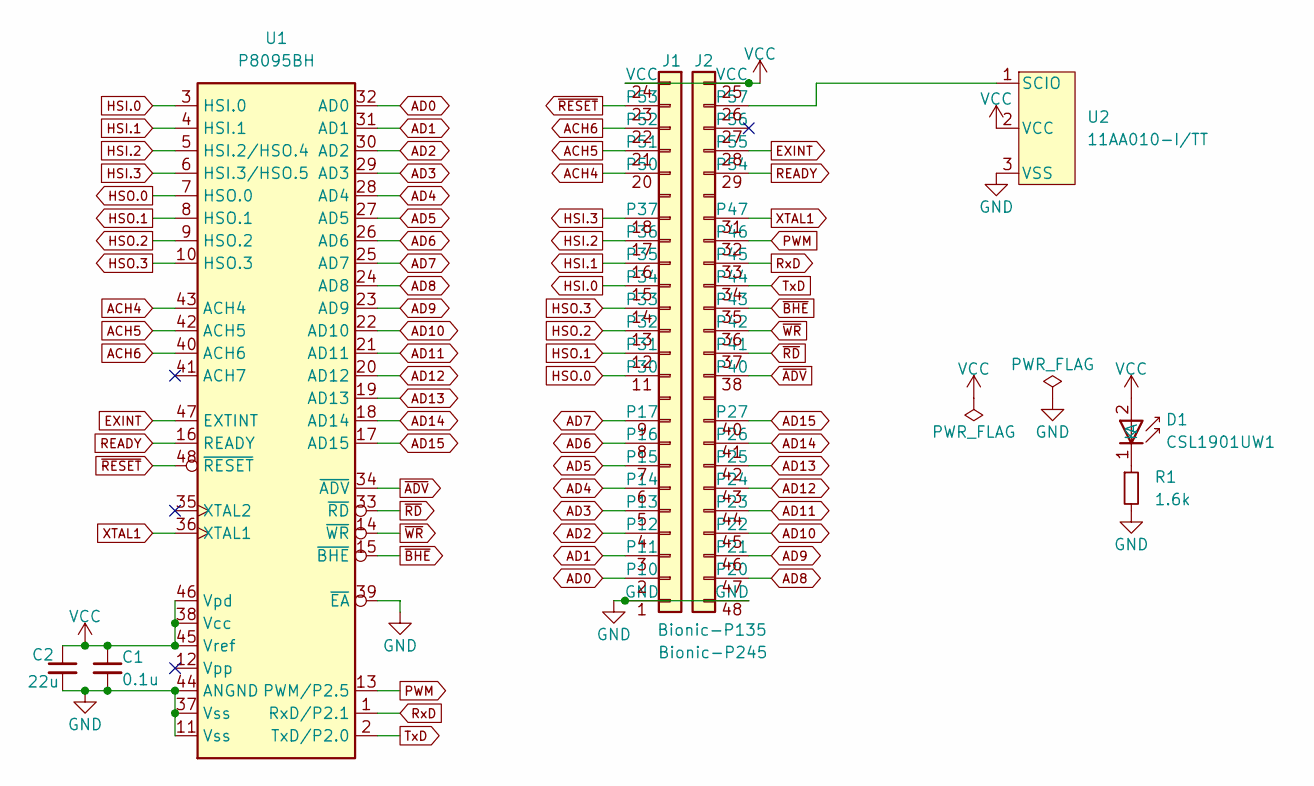
[picture p84: schematic bionic-p8095.kicad_sch, BionicP8095]

Parts:
C1: 0.1u; C_0603_1608Metric_Pad1.08x0.95mm_HandSolder
C2: 22u; C_0603_1608Metric_Pad1.08x0.95mm_HandSolder
D1: CSL1901UW1; LED_CSL1901UW1_ROM-M
J1: Bionic-P135; Bionic-P135_Vertical
J2: Bionic-P245; Bionic-P245_Vertical
R1: 1.6k; R_0603_1608Metric_Pad0.98x0.95mm_HandSolder
U1: P8095BH; DIP-48_W15.24mm_Socket
U2: 11AA010-I/TT; SOT-23_MC_MCH-M

Connections:
ACH4: J1.20 (P50), U1.43 (ACH4)
ACH5: J1.21 (P51), U1.42 (ACH5)
ACH6: J1.22 (P52), U1.40 (ACH6)
AD0: J1.2 (P10), U1.32 (AD0)
AD1: J1.3 (P11), U1.31 (AD1)
AD2: J1.4 (P12), U1.30 (AD2)
AD3: J1.5 (P13), U1.29 (AD3)
AD4: J1.6 (P14), U1.28 (AD4)
AD5: J1.7 (P15), U1.27 (AD5)
AD6: J1.8 (P16), U1.26 (AD6)
AD7: J1.9 (P17), U1.25 (AD7)
AD8: J2.47 (P20), U1.24 (AD8)
AD9: J2.46 (P21), U1.23 (AD9)
AD10: J2.45 (P22), U1.22 (AD10)
AD11: J2.44 (P23), U1.21 (AD11)
AD12: J2.43 (P24), U1.20 (AD12)
AD13: J2.42 (P25), U1.19 (AD13)
AD14: J2.41 (P26), U1.18 (AD14)
AD15: J2.40 (P27), U1.17 (AD15)
EXINT: J2.28 (P55), U1.47 (EXTINT)
GND: C1.2, C2.2, J1.1 (GND), J2.48 (GND), R1.2, U1.11 (Vss), U1.37 (Vss), U1.39 (~EA), U1.44 (ANGND), U2.3 (VSS)
HSI.0: J1.15 (P34), U1.3 (HSI.0)
HSI.1: J1.16 (P35), U1.4 (HSI.1)
HSI.2: J1.17 (P36), U1.5 (HSI.2/HSO.4)
HSI.3: J1.18 (P37), U1.6 (HSI.3/HSO.5)
HSO.0: J1.11 (P30), U1.7 (HSO.0)
HSO.1: J1.12 (P31), U1.8 (HSO.1)
HSO.2: J1.13 (P32), U1.9 (HSO.2)
HSO.3: J1.14 (P33), U1.10 (HSO.3)
unnamed: D1.1 (K), R1.1
unnamed: J2.26 (P57), U2.1 (SCIO)
PWM: J2.32 (P46), U1.13 (PWM/P2.5)
READY: J2.29 (P54), U1.16 (READY)
RxD: J2.33 (P45), U1.1 (RxD/P2.1)
TxD: J2.34 (P44), U1.2 (TxD/P2.0)
VCC: C1.1, C2.1, D1.2 (A), J1.24 (VCC), J2.25 (VCC), U1.38 (Vcc), U1.45 (Vref), U1.46 (Vpd), U2.2 (VCC)
XTAL1: J2.31 (P47), U1.36 (XTAL1)
~ADV: J2.38 (P40), U1.34 (~ADV)
~BHE: J2.35 (P43), U1.15 (~BHE)
~RD: J2.37 (P41), U1.33 (~RD)
~RESET: J1.23 (P53), U1.48 (~RESET)
~WR: J2.36 (P42), U1.14 (~WR)

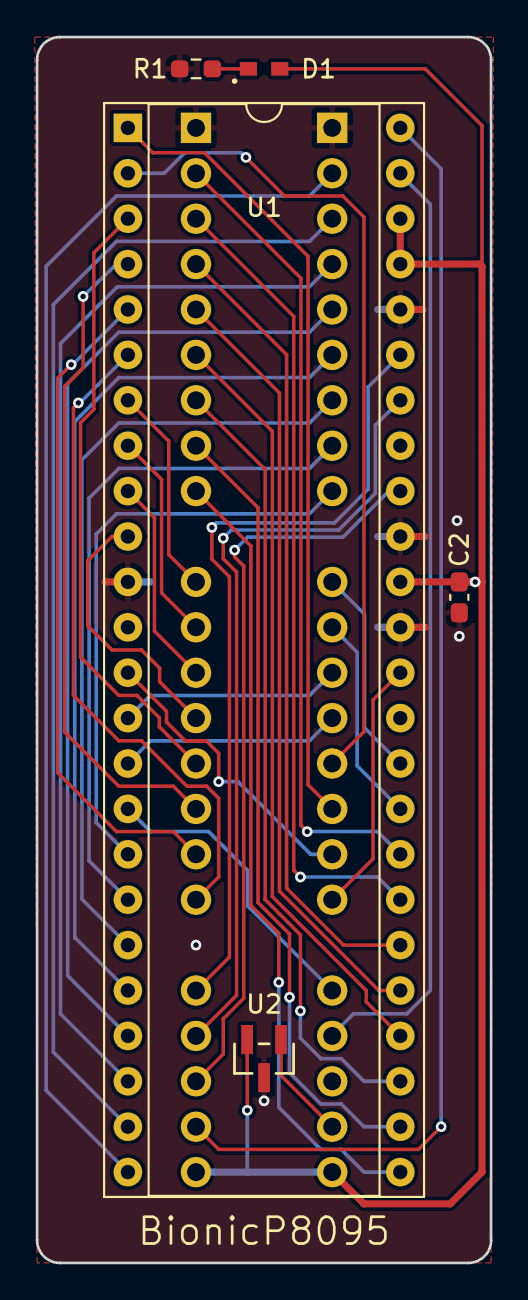
[picture p85: board bionic-p8095.kicad_pcb from above]

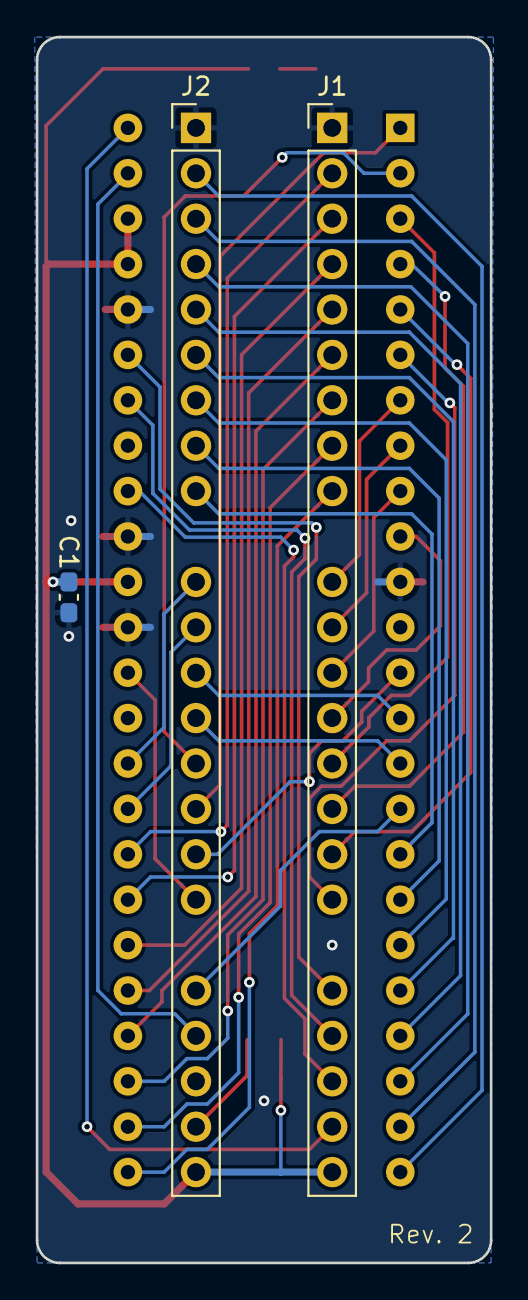
[picture p86: board bionic-p8095.kicad_pcb from below]

Board: 2 copper layers, 25.4 x 68.6 mm, 8 parts (3 on the bottom side), 42 nets.
