tgtakaoka/retro-bionic/schematics/n80c286/bionic-n80c286.kicad_pcb

## KiCad design schematics/n80c286/bionic-n80c286.kicad_pcb (2026-11-05)

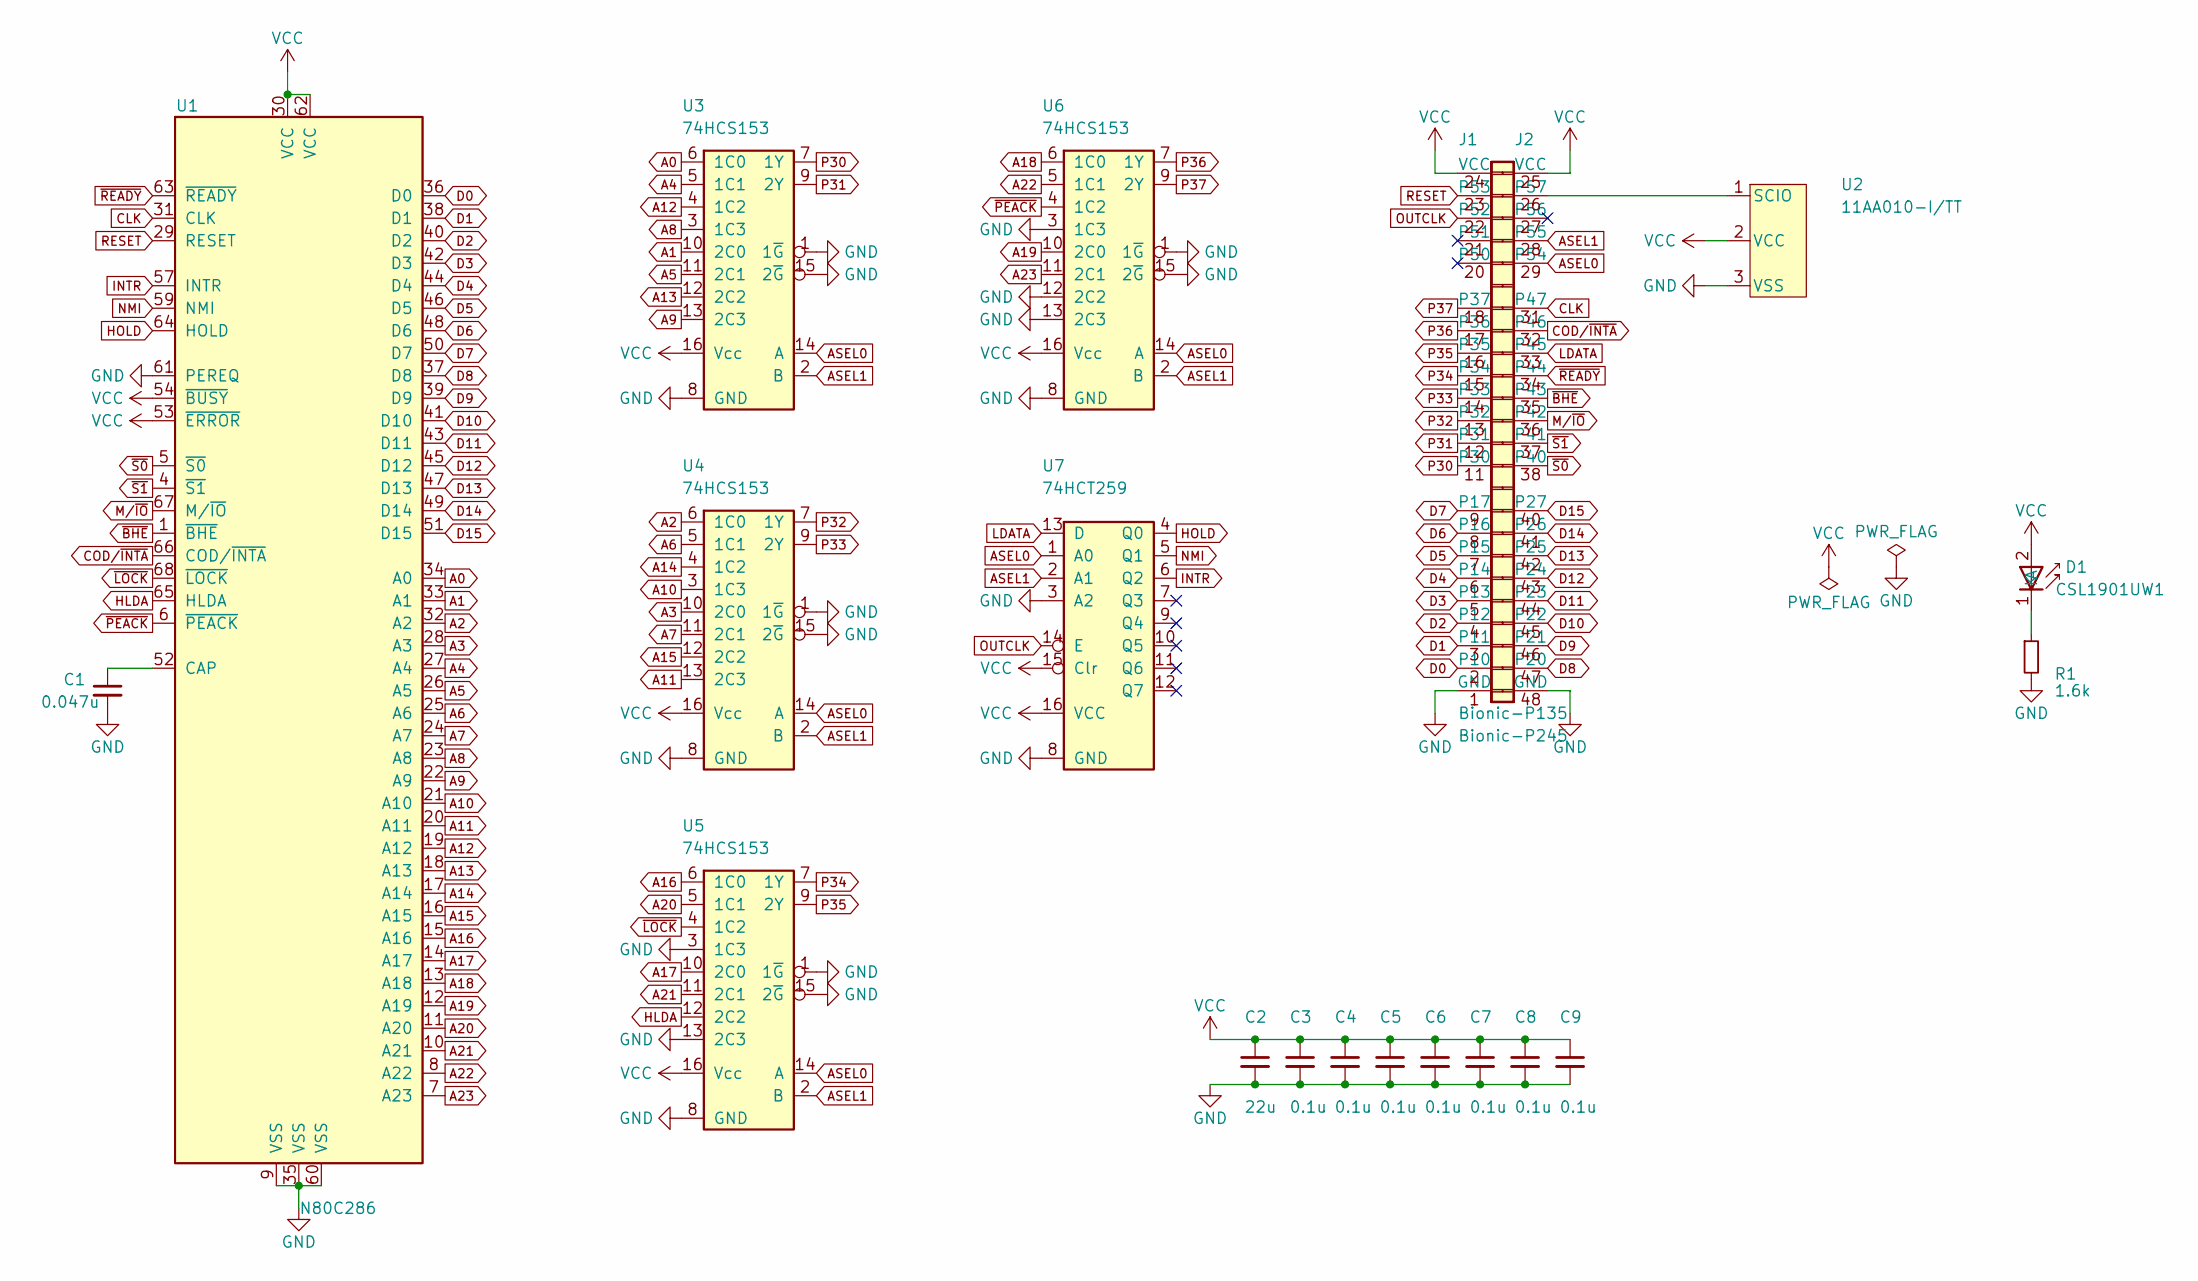
[picture p87: schematic bionic-n80c286.kicad_sch, BionicN80C286]

Parts:
C1: 0.047u; C_0603_1608Metric_Pad1.08x0.95mm_HandSolder
C2: 22u; C_0603_1608Metric_Pad1.08x0.95mm_HandSolder
C3, C4, C5, C6, C7, C8, C9: 0.1u; C_0603_1608Metric_Pad1.08x0.95mm_HandSolder
D1: CSL1901UW1; LED_CSL1901UW1_ROM-M
J1: Bionic-P135; Bionic-P135_SMT
J2: Bionic-P245; Bionic-P245_SMT
R1: 1.6k; R_0603_1608Metric_Pad0.98x0.95mm_HandSolder
U1: N80C286; PLCC-68_SMD-Socket
U2: 11AA010-I/TT; SOT-23_MC_MCH-M
U3, U4, U5, U6: 74HCS153; PW16-M
U7: 74HCT259; TSSOP16_SOT403-1_NEX-M

Connections:
A0: U1.34 (A0), U3.6 (1C0)
A1: U1.33 (A1), U3.10 (2C0)
A2: U1.32 (A2), U4.6 (1C0)
A3: U1.28 (A3), U4.10 (2C0)
A4: U1.27 (A4), U3.5 (1C1)
A5: U1.26 (A5), U3.11 (2C1)
A6: U1.25 (A6), U4.5 (1C1)
A7: U1.24 (A7), U4.11 (2C1)
A8: U1.23 (A8), U3.3 (1C3)
A9: U1.22 (A9), U3.13 (2C3)
A10: U1.21 (A10), U4.3 (1C3)
A11: U1.20 (A11), U4.13 (2C3)
A12: U1.19 (A12), U3.4 (1C2)
A13: U1.18 (A13), U3.12 (2C2)
A14: U1.17 (A14), U4.4 (1C2)
A15: U1.16 (A15), U4.12 (2C2)
A16: U1.15 (A16), U5.6 (1C0)
A17: U1.14 (A17), U5.10 (2C0)
A18: U1.13 (A18), U6.6 (1C0)
A19: U1.12 (A19), U6.10 (2C0)
A20: U1.11 (A20), U5.5 (1C1)
A21: U1.10 (A21), U5.11 (2C1)
A22: U1.8 (A22), U6.5 (1C1)
A23: U1.7 (A23), U6.11 (2C1)
ASEL0: J2.29 (P54), U3.14 (A), U4.14 (A), U5.14 (A), U6.14 (A), U7.1 (A0)
ASEL1: J2.28 (P55), U3.2 (B), U4.2 (B), U5.2 (B), U6.2 (B), U7.2 (A1)
CLK: J2.31 (P47), U1.31 (CLK)
COD/~INTA: J2.32 (P46), U1.66 (COD/~INTA)
D0: J1.2 (P10), U1.36 (D0)
D1: J1.3 (P11), U1.38 (D1)
D2: J1.4 (P12), U1.40 (D2)
D3: J1.5 (P13), U1.42 (D3)
D4: J1.6 (P14), U1.44 (D4)
D5: J1.7 (P15), U1.46 (D5)
D6: J1.8 (P16), U1.48 (D6)
D7: J1.9 (P17), U1.50 (D7)
D8: J2.47 (P20), U1.37 (D8)
D9: J2.46 (P21), U1.39 (D9)
D10: J2.45 (P22), U1.41 (D10)
D11: J2.44 (P23), U1.43 (D11)
D12: J2.43 (P24), U1.45 (D12)
D13: J2.42 (P25), U1.47 (D13)
D14: J2.41 (P26), U1.49 (D14)
D15: J2.40 (P27), U1.51 (D15)
GND: C1.2, C2.2, C3.2, C4.2, C5.2, C6.2, C7.2, C8.2, C9.2, J1.1 (GND), J2.48 (GND), R1.2, U1.9 (VSS), U1.35 (VSS), U1.60 (VSS), U1.61 (PEREQ), U2.3 (VSS), U3.1 (1~G), U3.8 (GND), U3.15 (2~G), U4.1 (1~G), U4.8 (GND), U4.15 (2~G), U5.1 (1~G), U5.3 (1C3), U5.8 (GND), U5.13 (2C3), U5.15 (2~G), U6.1 (1~G), U6.3 (1C3), U6.8 (GND), U6.12 (2C2), U6.13 (2C3), U6.15 (2~G), U7.3 (A2), U7.8 (GND)
HLDA: U1.65 (HLDA), U5.12 (2C2)
HOLD: U1.64 (HOLD), U7.4 (Q0)
INTR: U1.57 (INTR), U7.6 (Q2)
LDATA: J2.33 (P45), U7.13 (D)
M/~IO: J2.36 (P42), U1.67 (M/~IO)
NMI: U1.59 (NMI), U7.5 (Q1)
unnamed: D1.1 (K), R1.1
unnamed: J2.26 (P57), U2.1 (SCIO)
unnamed: C1.1, U1.52 (CAP)
OUTCLK: J1.22 (P52), U7.14 (E)
P30: J1.11 (P30), U3.7 (1Y)
P31: J1.12 (P31), U3.9 (2Y)
P32: J1.13 (P32), U4.7 (1Y)
P33: J1.14 (P33), U4.9 (2Y)
P34: J1.15 (P34), U5.7 (1Y)
P35: J1.16 (P35), U5.9 (2Y)
P36: J1.17 (P36), U6.7 (1Y)
P37: J1.18 (P37), U6.9 (2Y)
RESET: J1.23 (P53), U1.29 (RESET)
VCC: C2.1, C3.1, C4.1, C5.1, C6.1, C7.1, C8.1, C9.1, D1.2 (A), J1.24 (VCC), J2.25 (VCC), U1.30 (VCC), U1.53 (~ERROR), U1.54 (~BUSY), U1.62 (VCC), U2.2 (VCC), U3.16 (Vcc), U4.16 (Vcc), U5.16 (Vcc), U6.16 (Vcc), U7.15 (Clr), U7.16 (VCC)
~BHE: J2.35 (P43), U1.1 (~BHE)
~LOCK: U1.68 (~LOCK), U5.4 (1C2)
~PEACK: U1.6 (~PEACK), U6.4 (1C2)
~READY: J2.34 (P44), U1.63 (~READY)
~S0: J2.38 (P40), U1.5 (~S0)
~S1: J2.37 (P41), U1.4 (~S1)

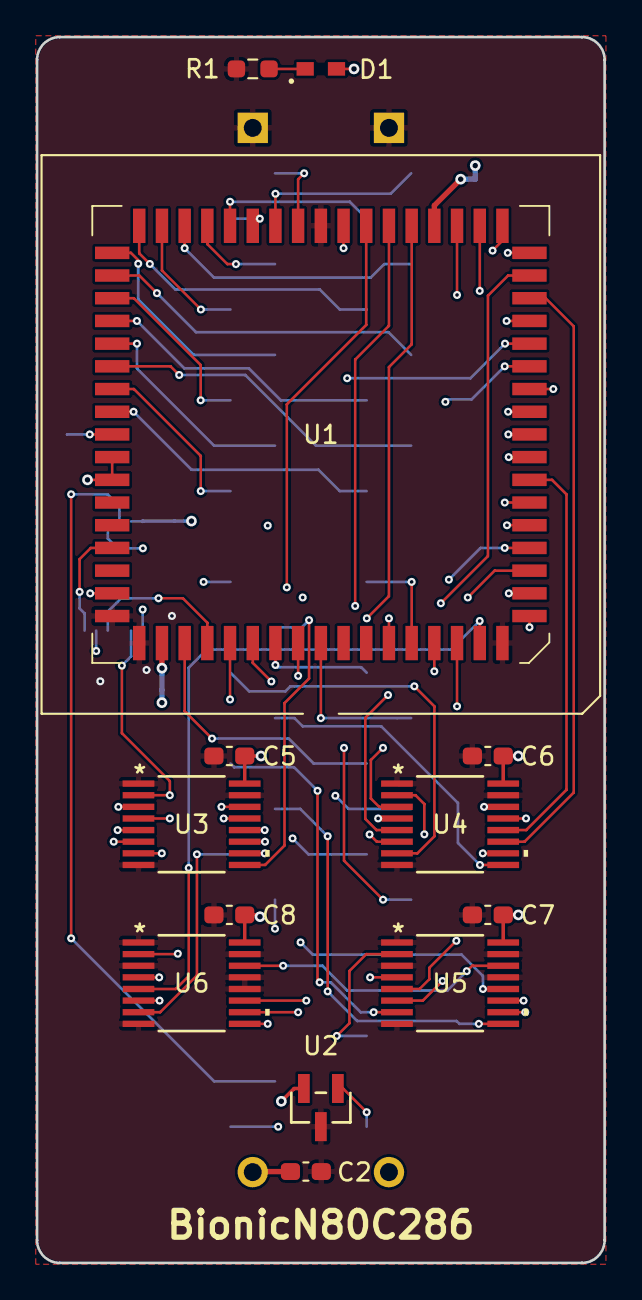
[picture p88: board bionic-n80c286.kicad_pcb from above]

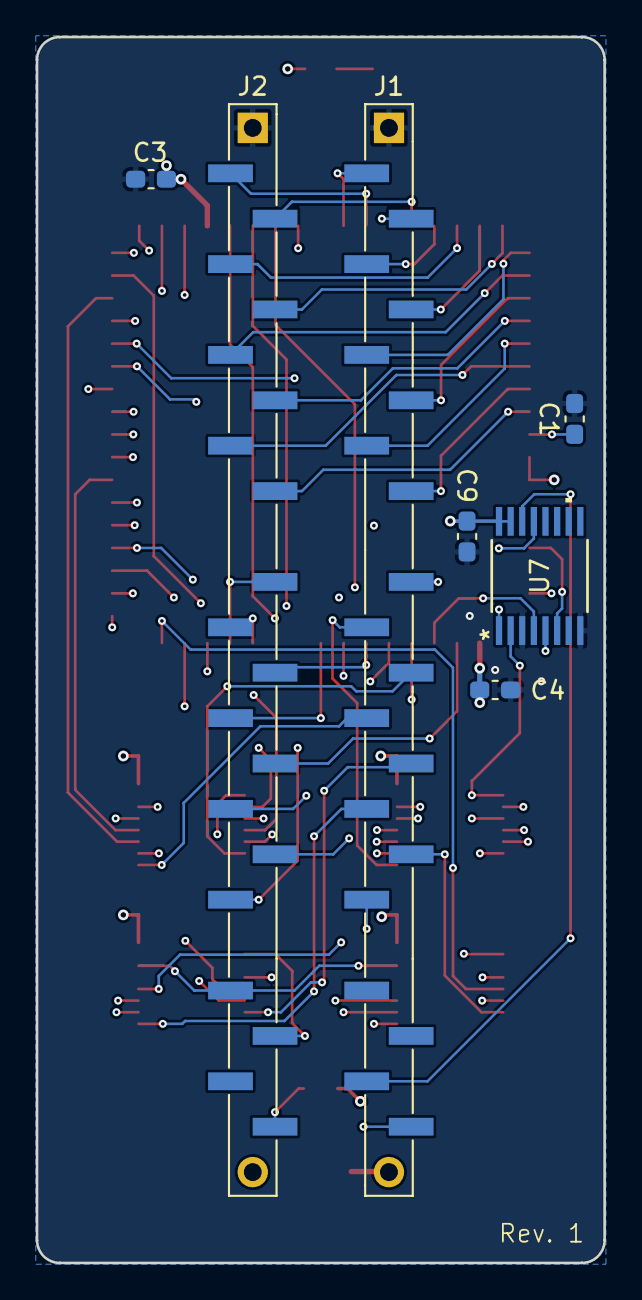
[picture p89: board bionic-n80c286.kicad_pcb from below]

Board: 4 copper layers, 31.7 x 68.6 mm, 20 parts (7 on the bottom side), 71 nets.
