tgtakaoka/retro-bionic/schematics/n80c186/bionic-n80c186.kicad_pcb

## KiCad design schematics/n80c186/bionic-n80c186.kicad_pcb (2026-11-05)

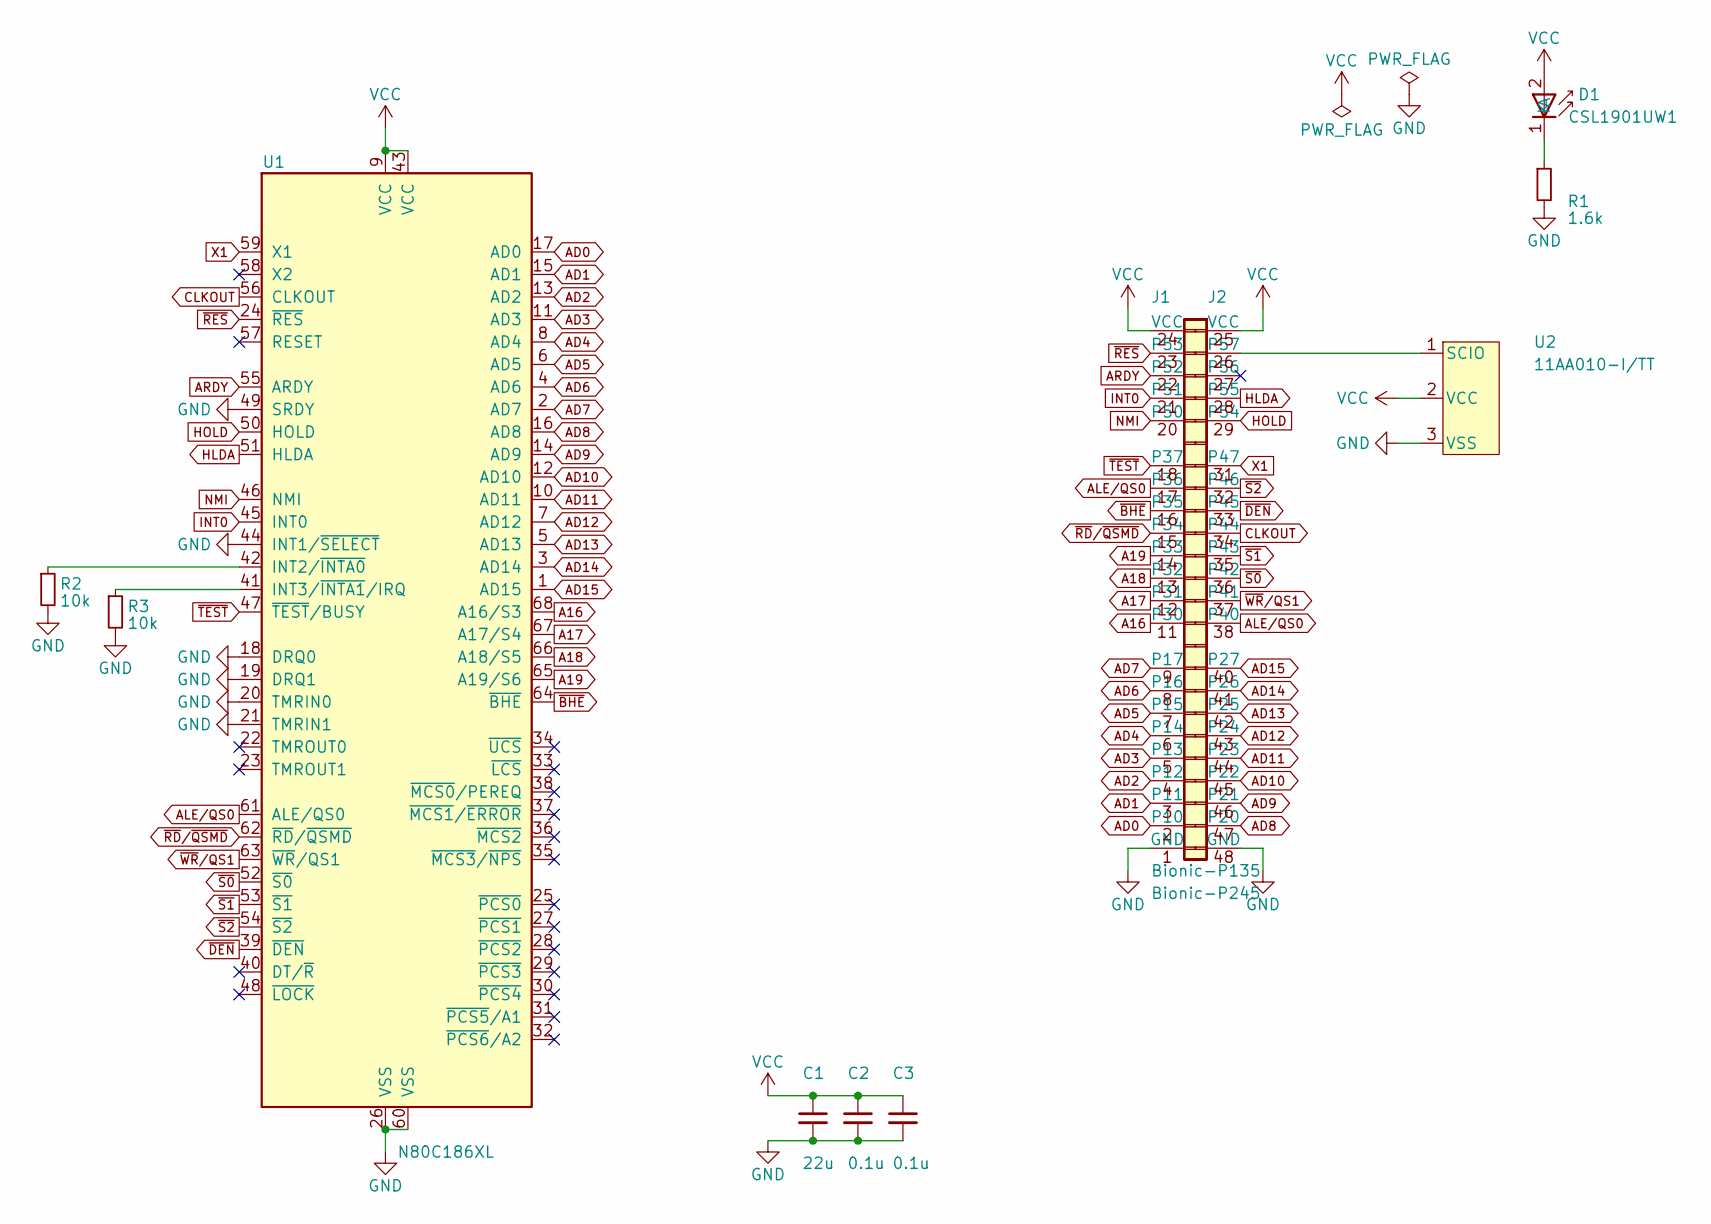
[picture p90: schematic bionic-n80c186.kicad_sch, BionicN80C186]

Parts:
C1: 22u; C_0603_1608Metric_Pad1.08x0.95mm_HandSolder
C2, C3: 0.1u; C_0603_1608Metric_Pad1.08x0.95mm_HandSolder
D1: CSL1901UW1; LED_CSL1901UW1_ROM-M
J1: Bionic-P135; Bionic-P135_SMT
J2: Bionic-P245; Bionic-P245_SMT
R1: 1.6k; R_0603_1608Metric_Pad0.98x0.95mm_HandSolder
R2, R3: 10k; R_0603_1608Metric_Pad0.98x0.95mm_HandSolder
U1: N80C186XL; PLCC-68_SMD-Socket
U2: 11AA010-I/TT; SOT-23_MC_MCH-M

Connections:
A16: J1.11 (P30), U1.68 (A16/S3)
A17: J1.12 (P31), U1.67 (A17/S4)
A18: J1.13 (P32), U1.66 (A18/S5)
A19: J1.14 (P33), U1.65 (A19/S6)
AD0: J1.2 (P10), U1.17 (AD0)
AD1: J1.3 (P11), U1.15 (AD1)
AD2: J1.4 (P12), U1.13 (AD2)
AD3: J1.5 (P13), U1.11 (AD3)
AD4: J1.6 (P14), U1.8 (AD4)
AD5: J1.7 (P15), U1.6 (AD5)
AD6: J1.8 (P16), U1.4 (AD6)
AD7: J1.9 (P17), U1.2 (AD7)
AD8: J2.47 (P20), U1.16 (AD8)
AD9: J2.46 (P21), U1.14 (AD9)
AD10: J2.45 (P22), U1.12 (AD10)
AD11: J2.44 (P23), U1.10 (AD11)
AD12: J2.43 (P24), U1.7 (AD12)
AD13: J2.42 (P25), U1.5 (AD13)
AD14: J2.41 (P26), U1.3 (AD14)
AD15: J2.40 (P27), U1.1 (AD15)
ALE/QS0: J1.17 (P36), J2.38 (P40), U1.61 (ALE/QS0)
ARDY: J1.22 (P52), U1.55 (ARDY)
CLKOUT: J2.34 (P44), U1.56 (CLKOUT)
GND: C1.2, C2.2, C3.2, J1.1 (GND), J2.48 (GND), R1.2, R2.2, R3.2, U1.18 (DRQ0), U1.19 (DRQ1), U1.20 (TMRIN0), U1.21 (TMRIN1), U1.26 (VSS), U1.44 (INT1/~SELECT), U1.49 (SRDY), U1.60 (VSS), U2.3 (VSS)
HLDA: J2.28 (P55), U1.51 (HLDA)
HOLD: J2.29 (P54), U1.50 (HOLD)
INT0: J1.21 (P51), U1.45 (INT0)
NMI: J1.20 (P50), U1.46 (NMI)
unnamed: D1.1 (K), R1.1
unnamed: J2.26 (P57), U2.1 (SCIO)
unnamed: R2.1, U1.42 (INT2/~INTA0)
unnamed: R3.1, U1.41 (INT3/~INTA1/IRQ)
VCC: C1.1, C2.1, C3.1, D1.2 (A), J1.24 (VCC), J2.25 (VCC), U1.9 (VCC), U1.43 (VCC), U2.2 (VCC)
X1: J2.31 (P47), U1.59 (X1)
~BHE: J1.16 (P35), U1.64 (~BHE)
~DEN: J2.33 (P45), U1.39 (~DEN)
~RD/~QSMD: J1.15 (P34), U1.62 (~RD/~QSMD)
~RES: J1.23 (P53), U1.24 (~RES)
~S0: J2.36 (P42), U1.52 (~S0)
~S1: J2.35 (P43), U1.53 (~S1)
~S2: J2.32 (P46), U1.54 (~S2)
~TEST: J1.18 (P37), U1.47 (~TEST/BUSY)
~WR/QS1: J2.37 (P41), U1.63 (~WR/QS1)

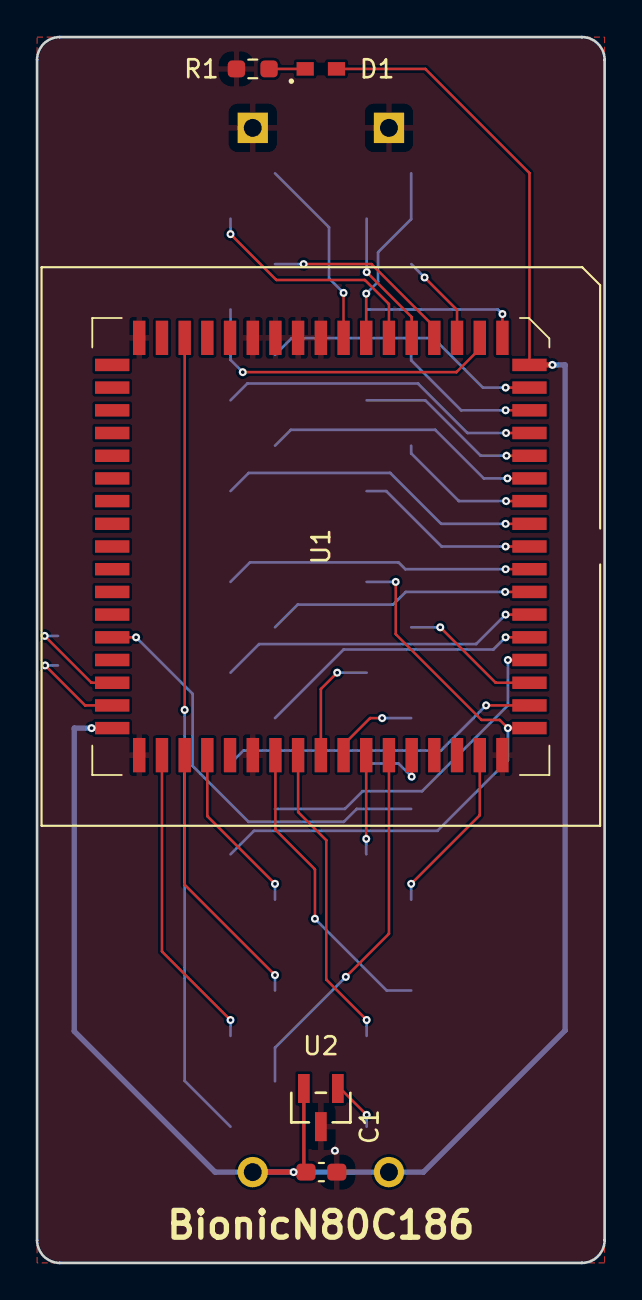
[picture p91: board bionic-n80c186.kicad_pcb from above]

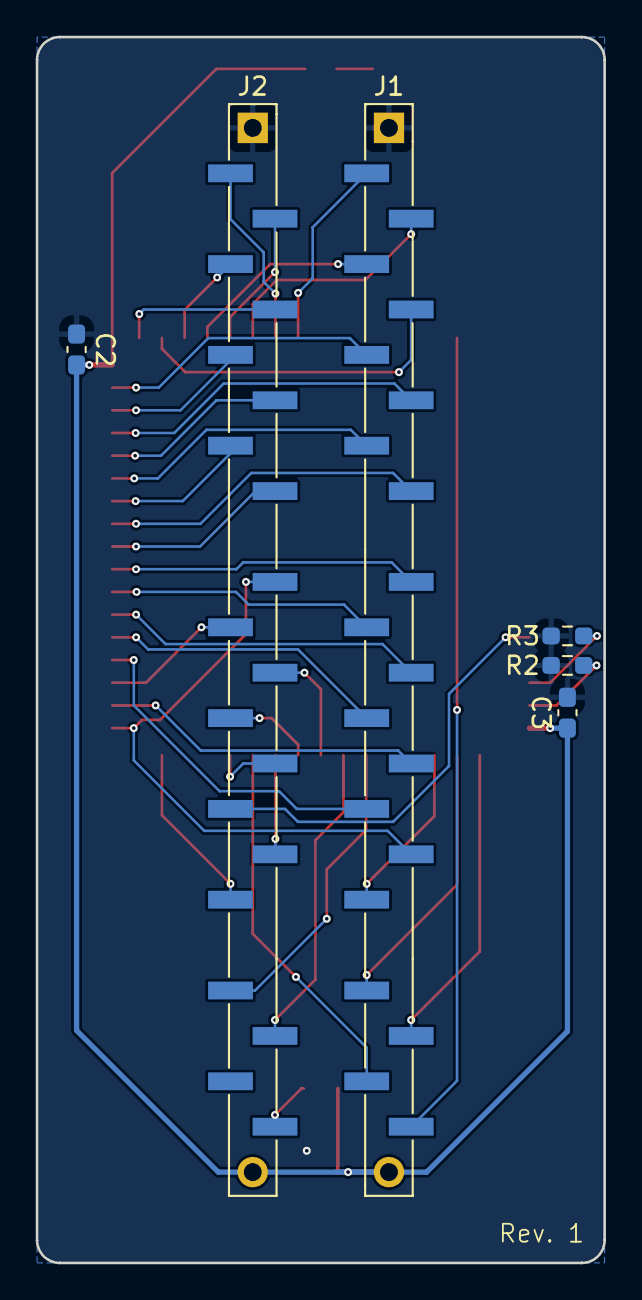
[picture p92: board bionic-n80c186.kicad_pcb from below]

Board: 2 copper layers, 31.7 x 68.6 mm, 11 parts (6 on the bottom side), 43 nets.
