tgtakaoka/retro-bionic/schematics/h8323/bionic-h8323.kicad_pcb

## KiCad design schematics/h8323/bionic-h8323.kicad_pcb (2026-10-30)

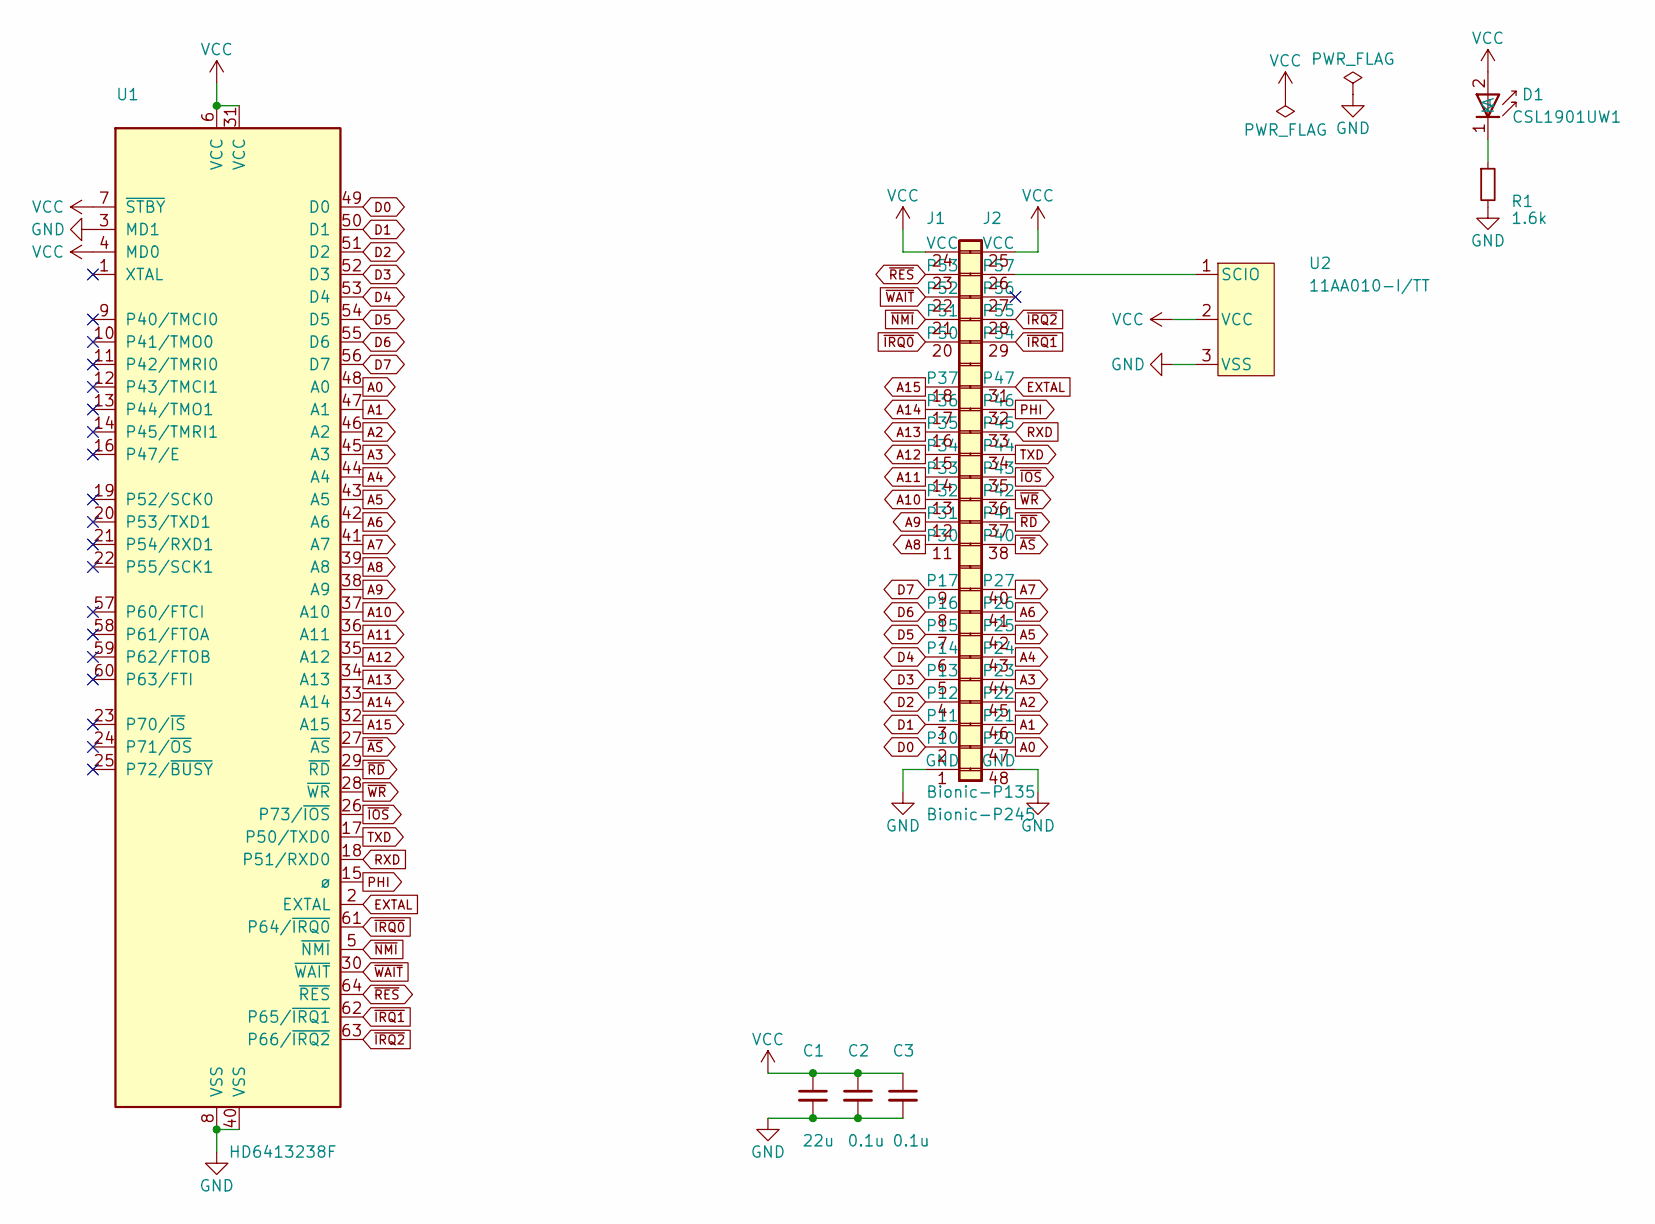
[picture p96: schematic bionic-h8323.kicad_sch, BionicH8/323]

Parts:
C1: 22u; C_0603_1608Metric_Pad1.08x0.95mm_HandSolder
C2, C3: 0.1u; C_0603_1608Metric_Pad1.08x0.95mm_HandSolder
D1: CSL1901UW1; LED_CSL1901UW1_ROM-M
J1: Bionic-P135; Bionic-P135_SMT
J2: Bionic-P245; Bionic-P245_SMT
R1: 1.6k; R_0603_1608Metric_Pad0.98x0.95mm_HandSolder
U1: HD6413238F; QFP-64_14x14mm_P0.8mm_Hitachi
U2: 11AA010-I/TT; SOT-23_MC_MCH-M

Connections:
A0: J2.47 (P20), U1.48 (A0)
A1: J2.46 (P21), U1.47 (A1)
A2: J2.45 (P22), U1.46 (A2)
A3: J2.44 (P23), U1.45 (A3)
A4: J2.43 (P24), U1.44 (A4)
A5: J2.42 (P25), U1.43 (A5)
A6: J2.41 (P26), U1.42 (A6)
A7: J2.40 (P27), U1.41 (A7)
A8: J1.11 (P30), U1.39 (A8)
A9: J1.12 (P31), U1.38 (A9)
A10: J1.13 (P32), U1.37 (A10)
A11: J1.14 (P33), U1.36 (A11)
A12: J1.15 (P34), U1.35 (A12)
A13: J1.16 (P35), U1.34 (A13)
A14: J1.17 (P36), U1.33 (A14)
A15: J1.18 (P37), U1.32 (A15)
D0: J1.2 (P10), U1.49 (D0)
D1: J1.3 (P11), U1.50 (D1)
D2: J1.4 (P12), U1.51 (D2)
D3: J1.5 (P13), U1.52 (D3)
D4: J1.6 (P14), U1.53 (D4)
D5: J1.7 (P15), U1.54 (D5)
D6: J1.8 (P16), U1.55 (D6)
D7: J1.9 (P17), U1.56 (D7)
EXTAL: J2.31 (P47), U1.2 (EXTAL)
GND: C1.2, C2.2, C3.2, J1.1 (GND), J2.48 (GND), R1.2, U1.3 (MD1), U1.8 (VSS), U1.40 (VSS), U2.3 (VSS)
unnamed: D1.1 (K), R1.1
unnamed: J2.26 (P57), U2.1 (SCIO)
PHI: J2.32 (P46), U1.15 (ø)
RXD: J2.33 (P45), U1.18 (P51/RXD0)
TXD: J2.34 (P44), U1.17 (P50/TXD0)
VCC: C1.1, C2.1, C3.1, D1.2 (A), J1.24 (VCC), J2.25 (VCC), U1.4 (MD0), U1.6 (VCC), U1.7 (~STBY), U1.31 (VCC), U2.2 (VCC)
~AS: J2.38 (P40), U1.27 (~AS)
~IOS: J2.35 (P43), U1.26 (P73/~IOS)
~IRQ0: J1.20 (P50), U1.61 (P64/~IRQ0)
~IRQ1: J2.29 (P54), U1.62 (P65/~IRQ1)
~IRQ2: J2.28 (P55), U1.63 (P66/~IRQ2)
~NMI: J1.21 (P51), U1.5 (~NMI)
~RD: J2.37 (P41), U1.29 (~RD)
~RES: J1.23 (P53), U1.64 (~RES)
~WAIT: J1.22 (P52), U1.30 (~WAIT)
~WR: J2.36 (P42), U1.28 (~WR)

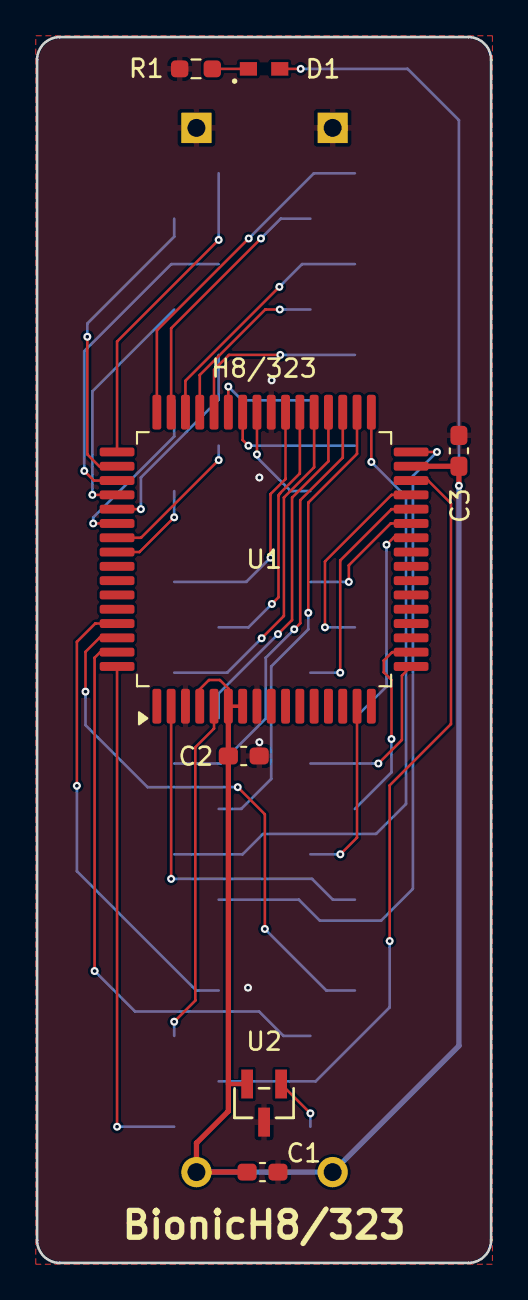
[picture p97: board bionic-h8323.kicad_pcb from above]

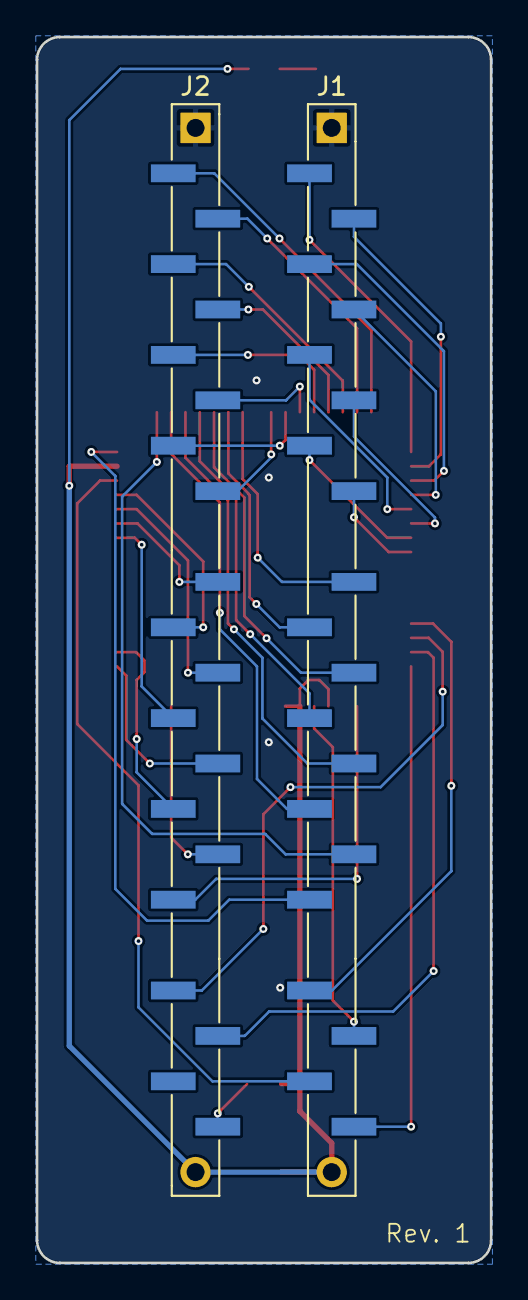
[picture p98: board bionic-h8323.kicad_pcb from below]

Board: 2 copper layers, 25.4 x 68.6 mm, 9 parts (2 on the bottom side), 42 nets.
