tgtakaoka/retro-bionic/schematics/h8536/bionic-h8536.kicad_pcb

## KiCad design schematics/h8536/bionic-h8536.kicad_pcb (2026-10-30)

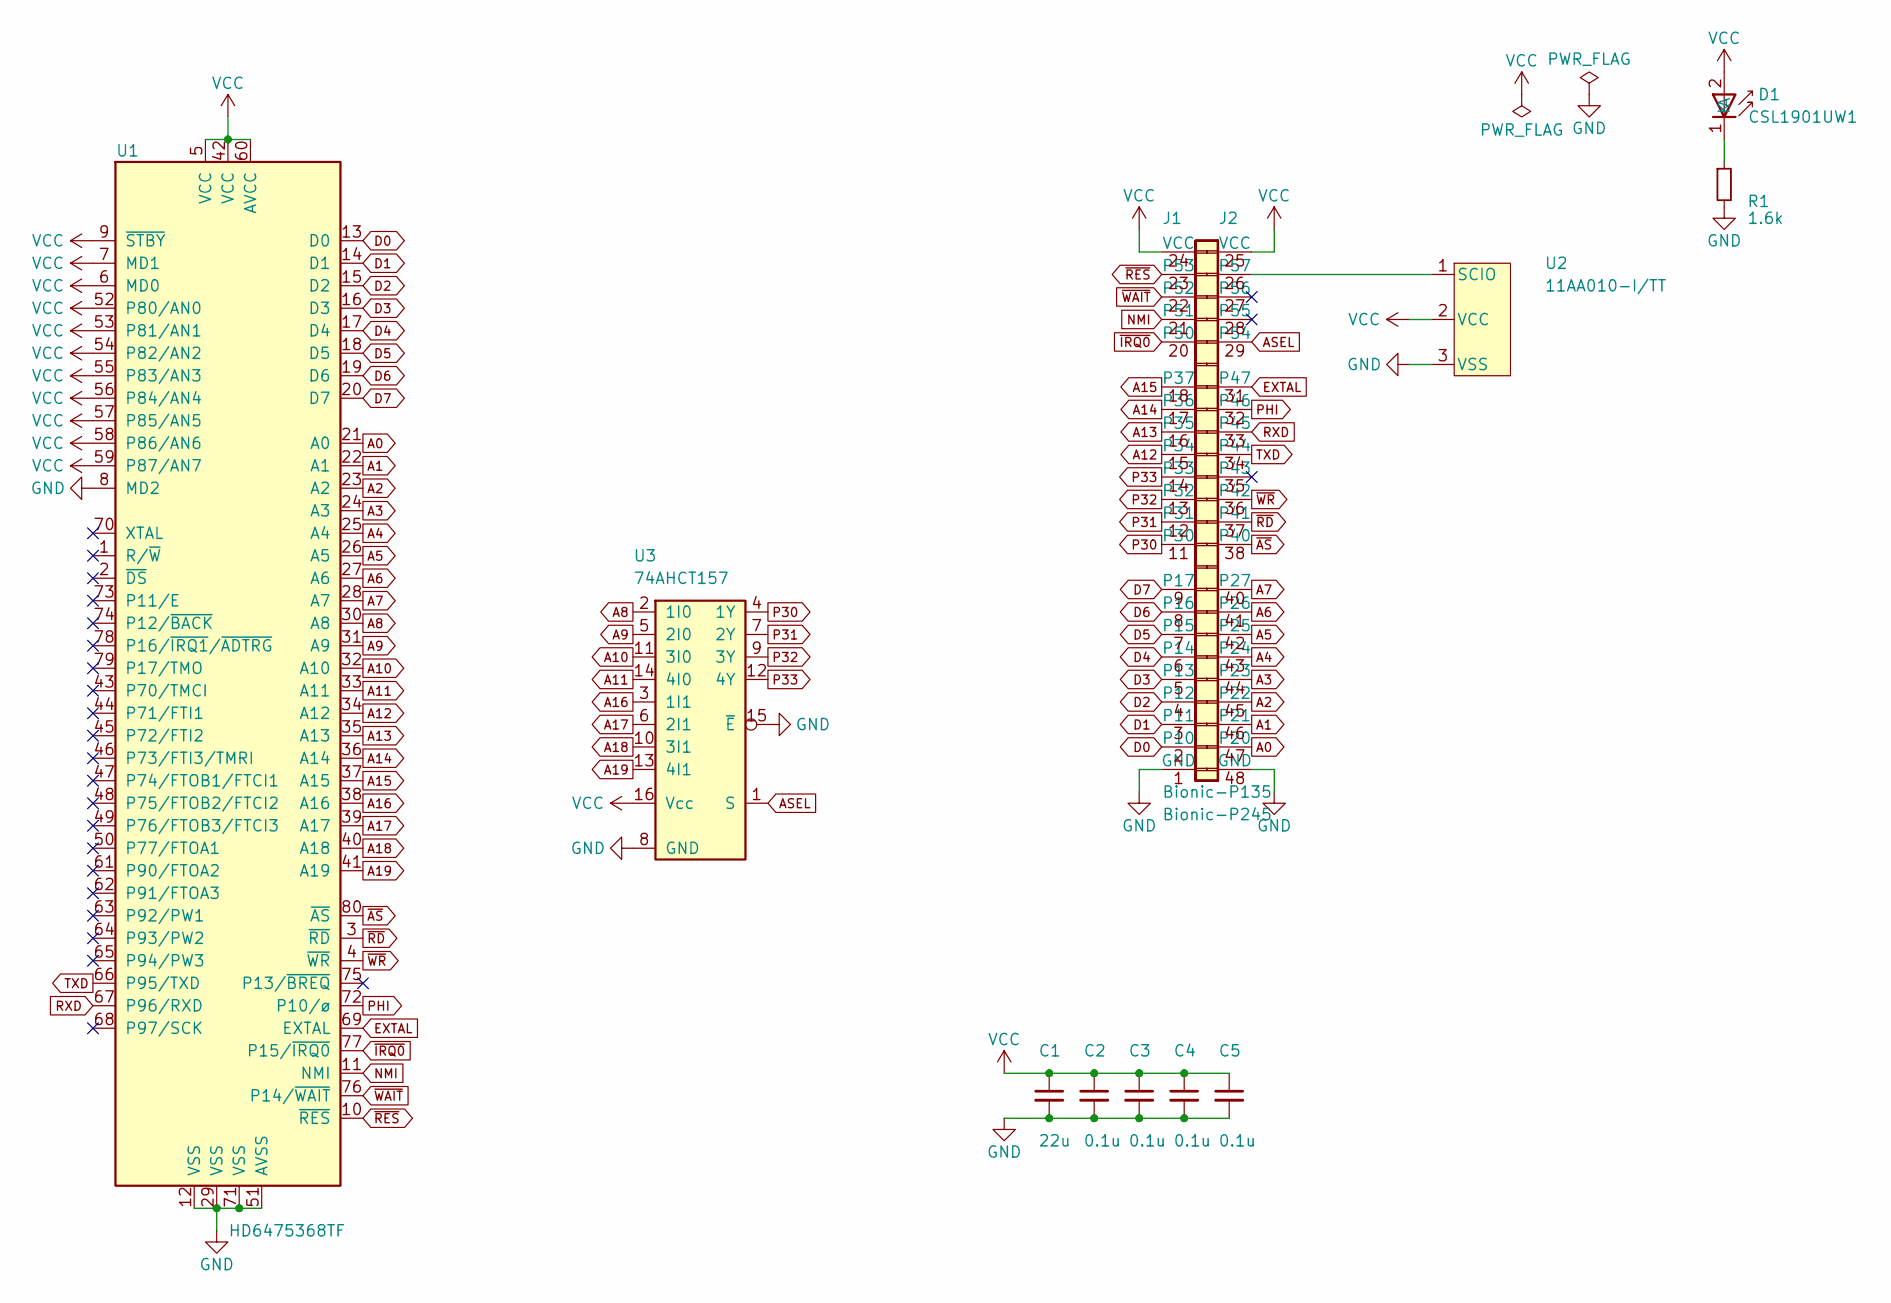
[picture p99: schematic bionic-h8536.kicad_sch, BionicH8/536]

Parts:
C1: 22u; C_0603_1608Metric_Pad1.08x0.95mm_HandSolder
C2, C3, C4, C5: 0.1u; C_0603_1608Metric_Pad1.08x0.95mm_HandSolder
D1: CSL1901UW1; LED_CSL1901UW1_ROM-M
J1: Bionic-P135; Bionic-P135_SMT
J2: Bionic-P245; Bionic-P245_SMT
R1: 1.6k; R_0603_1608Metric_Pad0.98x0.95mm_HandSolder
U1: HD6475368TF; TQFP-80_12x12mm_P0.5mm_Hitachi
U2: 11AA010-I/TT; SOT-23_MC_MCH-M
U3: 74AHCT157; PW16-M

Connections:
A0: J2.47 (P20), U1.21 (A0)
A1: J2.46 (P21), U1.22 (A1)
A2: J2.45 (P22), U1.23 (A2)
A3: J2.44 (P23), U1.24 (A3)
A4: J2.43 (P24), U1.25 (A4)
A5: J2.42 (P25), U1.26 (A5)
A6: J2.41 (P26), U1.27 (A6)
A7: J2.40 (P27), U1.28 (A7)
A8: U1.30 (A8), U3.2 (1I0)
A9: U1.31 (A9), U3.5 (2I0)
A10: U1.32 (A10), U3.11 (3I0)
A11: U1.33 (A11), U3.14 (4I0)
A12: J1.15 (P34), U1.34 (A12)
A13: J1.16 (P35), U1.35 (A13)
A14: J1.17 (P36), U1.36 (A14)
A15: J1.18 (P37), U1.37 (A15)
A16: U1.38 (A16), U3.3 (1I1)
A17: U1.39 (A17), U3.6 (2I1)
A18: U1.40 (A18), U3.10 (3I1)
A19: U1.41 (A19), U3.13 (4I1)
ASEL: J2.29 (P54), U3.1 (S)
D0: J1.2 (P10), U1.13 (D0)
D1: J1.3 (P11), U1.14 (D1)
D2: J1.4 (P12), U1.15 (D2)
D3: J1.5 (P13), U1.16 (D3)
D4: J1.6 (P14), U1.17 (D4)
D5: J1.7 (P15), U1.18 (D5)
D6: J1.8 (P16), U1.19 (D6)
D7: J1.9 (P17), U1.20 (D7)
EXTAL: J2.31 (P47), U1.69 (EXTAL)
GND: C1.2, C2.2, C3.2, C4.2, C5.2, J1.1 (GND), J2.48 (GND), R1.2, U1.8 (MD2), U1.12 (VSS), U1.29 (VSS), U1.51 (AVSS), U1.71 (VSS), U2.3 (VSS), U3.8 (GND), U3.15 (~E)
NMI: J1.21 (P51), U1.11 (NMI)
unnamed: D1.1 (K), R1.1
unnamed: J2.26 (P57), U2.1 (SCIO)
P30: J1.11 (P30), U3.4 (1Y)
P31: J1.12 (P31), U3.7 (2Y)
P32: J1.13 (P32), U3.9 (3Y)
P33: J1.14 (P33), U3.12 (4Y)
PHI: J2.32 (P46), U1.72 (P10/ø)
RXD: J2.33 (P45), U1.67 (P96/RXD)
TXD: J2.34 (P44), U1.66 (P95/TXD)
VCC: C1.1, C2.1, C3.1, C4.1, C5.1, D1.2 (A), J1.24 (VCC), J2.25 (VCC), U1.5 (VCC), U1.6 (MD0), U1.7 (MD1), U1.9 (~STBY), U1.42 (VCC), U1.52 (P80/AN0), U1.53 (P81/AN1), U1.54 (P82/AN2), U1.55 (P83/AN3), U1.56 (P84/AN4), U1.57 (P85/AN5), U1.58 (P86/AN6), U1.59 (P87/AN7), U1.60 (AVCC), U2.2 (VCC), U3.16 (Vcc)
~AS: J2.38 (P40), U1.80 (~AS)
~IRQ0: J1.20 (P50), U1.77 (P15/~IRQ0)
~RD: J2.37 (P41), U1.3 (~RD)
~RES: J1.23 (P53), U1.10 (~RES)
~WAIT: J1.22 (P52), U1.76 (P14/~WAIT)
~WR: J2.36 (P42), U1.4 (~WR)

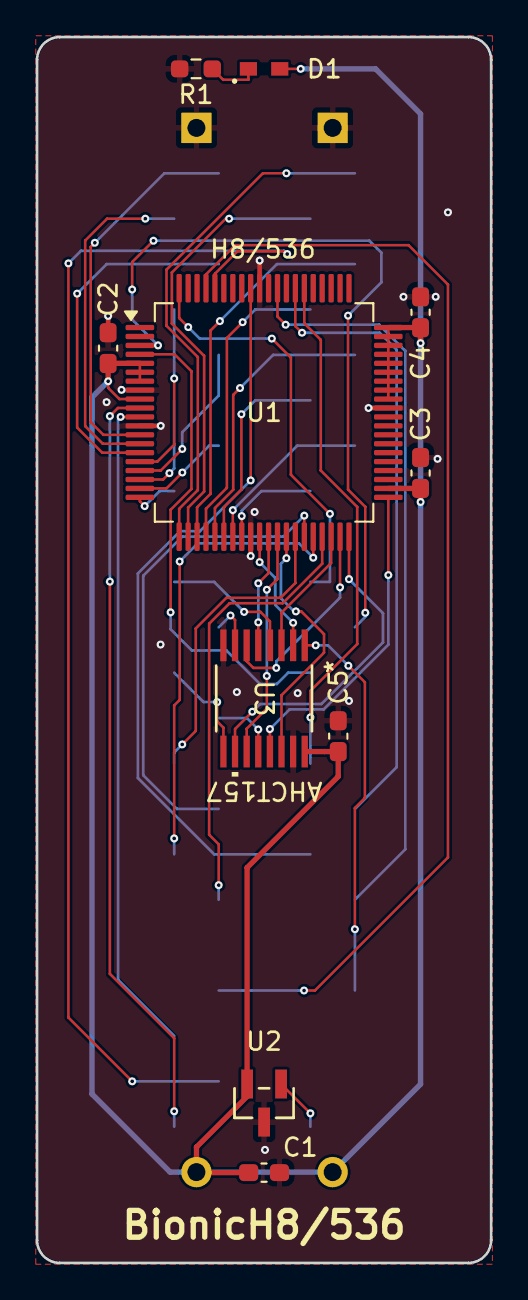
[picture p100: board bionic-h8536.kicad_pcb from above]

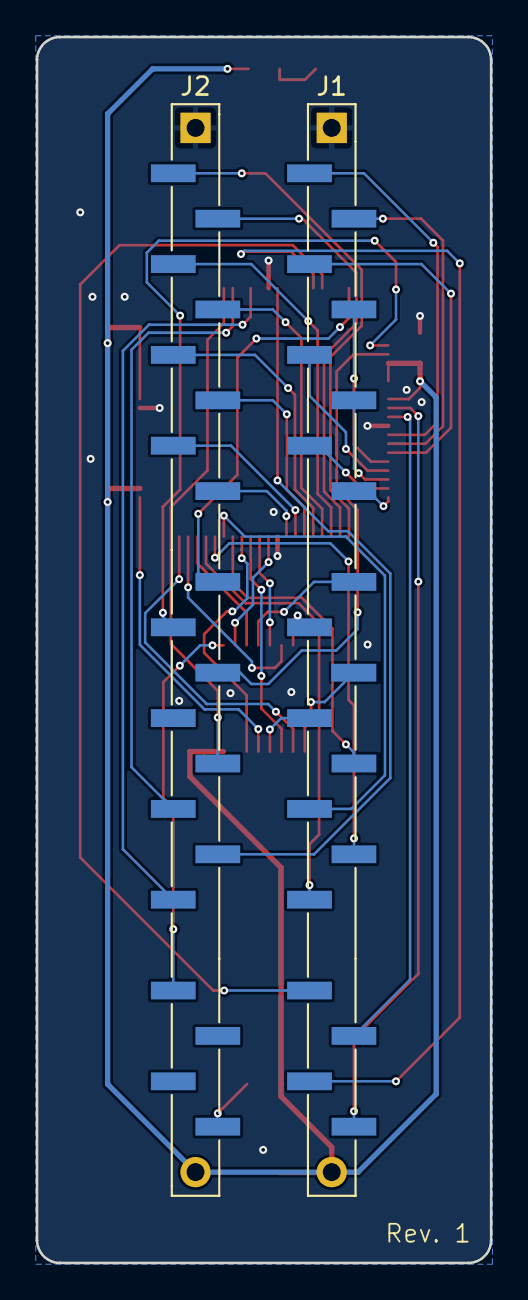
[picture p101: board bionic-h8536.kicad_pcb from below]

Board: 2 copper layers, 25.4 x 68.6 mm, 12 parts (2 on the bottom side), 48 nets.
