tgtakaoka/retro-bionic/schematics/mc68008/bionic-mc68008p.kicad_pcb

## KiCad design schematics/mc68008/bionic-mc68008p.kicad_pcb (2026-10-27)

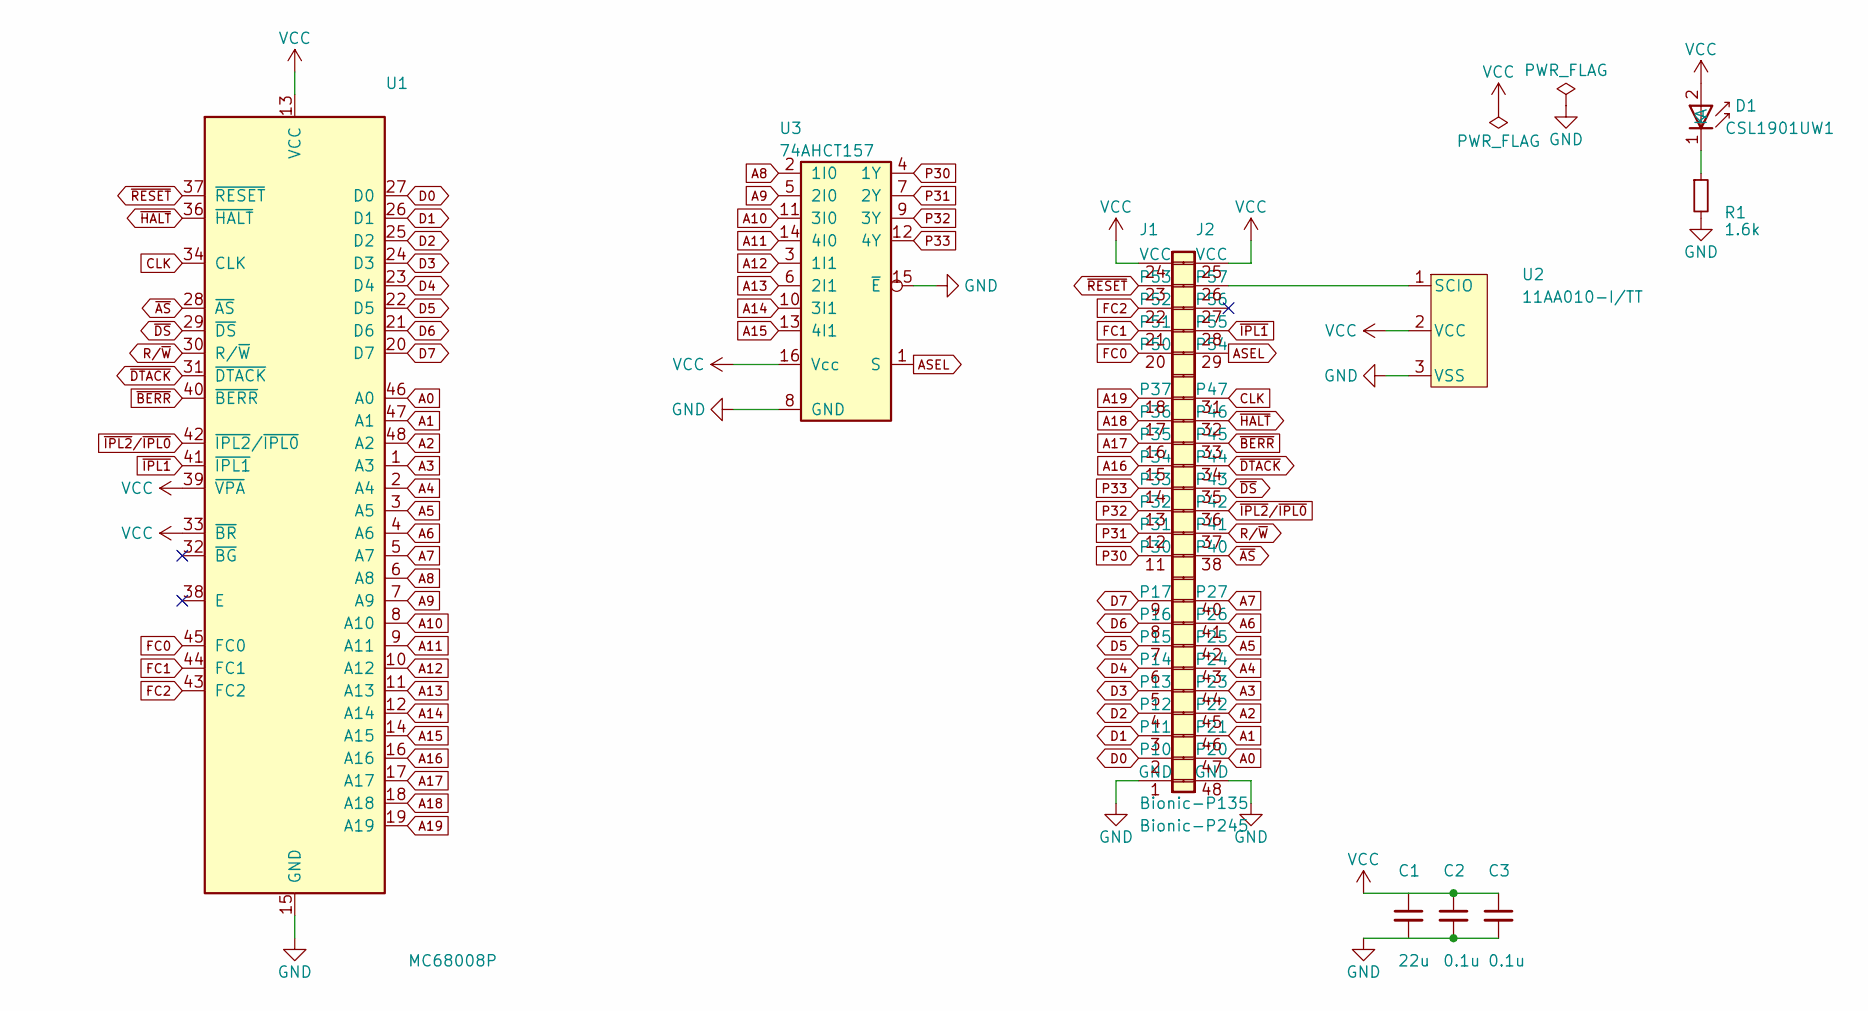
[picture p102: schematic bionic-mc68008p.kicad_sch, BionicMC68008P]

Parts:
C1: 22u; C_0603_1608Metric_Pad1.08x0.95mm_HandSolder
C2, C3: 0.1u; C_0603_1608Metric_Pad1.08x0.95mm_HandSolder
D1: CSL1901UW1; LED_CSL1901UW1_ROM-M
J1: Bionic-P135; Bionic-P135_THT
J2: Bionic-P245; Bionic-P245_THT
R1: 1.6k; R_0603_1608Metric_Pad0.98x0.95mm_HandSolder
U1: MC68008P; DIP-48_W15.24mm_Socket
U2: 11AA010-I/TT; SOT-23_MC_MCH-M
U3: 74AHCT157; PW16-M

Connections:
A0: J2.47 (P20), U1.46 (A0)
A1: J2.46 (P21), U1.47 (A1)
A2: J2.45 (P22), U1.48 (A2)
A3: J2.44 (P23), U1.1 (A3)
A4: J2.43 (P24), U1.2 (A4)
A5: J2.42 (P25), U1.3 (A5)
A6: J2.41 (P26), U1.4 (A6)
A7: J2.40 (P27), U1.5 (A7)
A8: U1.6 (A8), U3.2 (1I0)
A9: U1.7 (A9), U3.5 (2I0)
A10: U1.8 (A10), U3.11 (3I0)
A11: U1.9 (A11), U3.14 (4I0)
A12: U1.10 (A12), U3.3 (1I1)
A13: U1.11 (A13), U3.6 (2I1)
A14: U1.12 (A14), U3.10 (3I1)
A15: U1.14 (A15), U3.13 (4I1)
A16: J1.15 (P34), U1.16 (A16)
A17: J1.16 (P35), U1.17 (A17)
A18: J1.17 (P36), U1.18 (A18)
A19: J1.18 (P37), U1.19 (A19)
ASEL: J2.29 (P54), U3.1 (S)
CLK: J2.31 (P47), U1.34 (CLK)
D0: J1.2 (P10), U1.27 (D0)
D1: J1.3 (P11), U1.26 (D1)
D2: J1.4 (P12), U1.25 (D2)
D3: J1.5 (P13), U1.24 (D3)
D4: J1.6 (P14), U1.23 (D4)
D5: J1.7 (P15), U1.22 (D5)
D6: J1.8 (P16), U1.21 (D6)
D7: J1.9 (P17), U1.20 (D7)
FC0: J1.20 (P50), U1.45 (FC0)
FC1: J1.21 (P51), U1.44 (FC1)
FC2: J1.22 (P52), U1.43 (FC2)
GND: C1.2, C2.2, C3.2, J1.1 (GND), J2.48 (GND), R1.2, U1.15 (GND), U1.35 (GND), U2.3 (VSS), U3.8 (GND), U3.15 (~E)
unnamed: D1.1 (K), R1.1
unnamed: J2.26 (P57), U2.1 (SCIO)
P30: J1.11 (P30), U3.4 (1Y)
P31: J1.12 (P31), U3.7 (2Y)
P32: J1.13 (P32), U3.9 (3Y)
P33: J1.14 (P33), U3.12 (4Y)
R/~W: J2.37 (P41), U1.30 (R/~W)
VCC: C1.1, C2.1, C3.1, D1.2 (A), J1.24 (VCC), J2.25 (VCC), U1.13 (VCC), U1.33 (~BR), U1.39 (~VPA), U2.2 (VCC), U3.16 (Vcc)
~AS: J2.38 (P40), U1.28 (~AS)
~BERR: J2.33 (P45), U1.40 (~BERR)
~DS: J2.35 (P43), U1.29 (~DS)
~DTACK: J2.34 (P44), U1.31 (~DTACK)
~HALT: J2.32 (P46), U1.36 (~HALT)
~IPL1: J2.28 (P55), U1.41 (~IPL1)
~IPL2/~IPL0: J2.36 (P42), U1.42 (~IPL2/~IPL0)
~RESET: J1.23 (P53), U1.37 (~RESET)
