tgtakaoka/retro-bionic/schematics/mc68008/bionic-mc68008p.kicad_pcb

## KiCad design schematics/mc68008/bionic-mc68008p.kicad_pcb (continued)

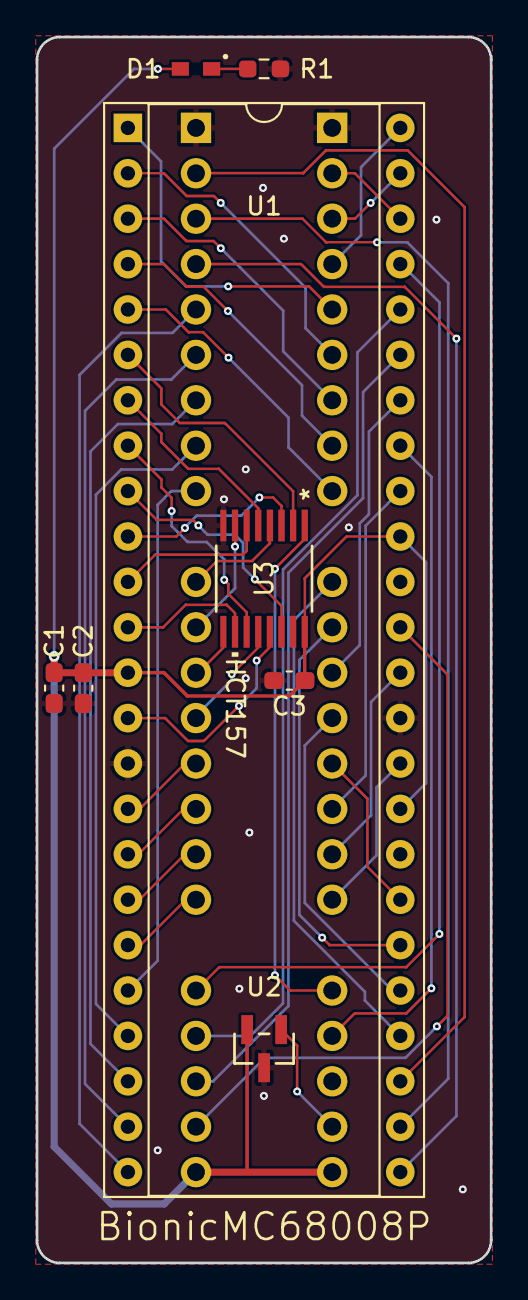
[picture p103: board bionic-mc68008p.kicad_pcb from above]

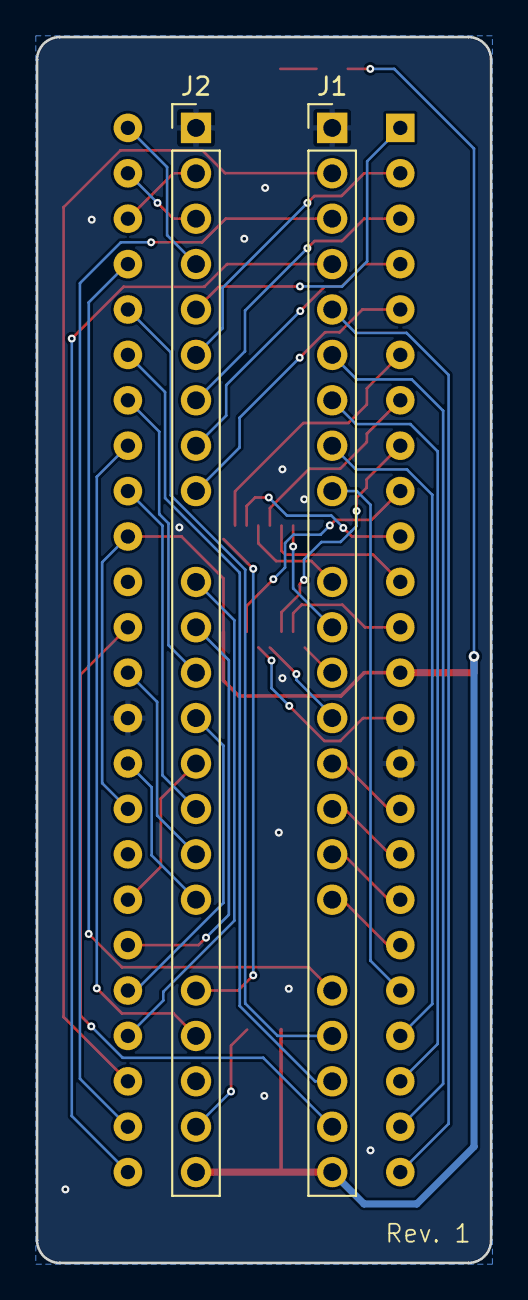
[picture p104: board bionic-mc68008p.kicad_pcb from below]

Board: 2 copper layers, 25.4 x 68.6 mm, 10 parts (2 on the bottom side), 50 nets.
