tgtakaoka/retro-bionic/schematics/mc68hc11a/bionic-mc68hc11a.kicad_pcb

## KiCad design schematics/mc68hc11a/bionic-mc68hc11a.kicad_pcb (2026-10-26)

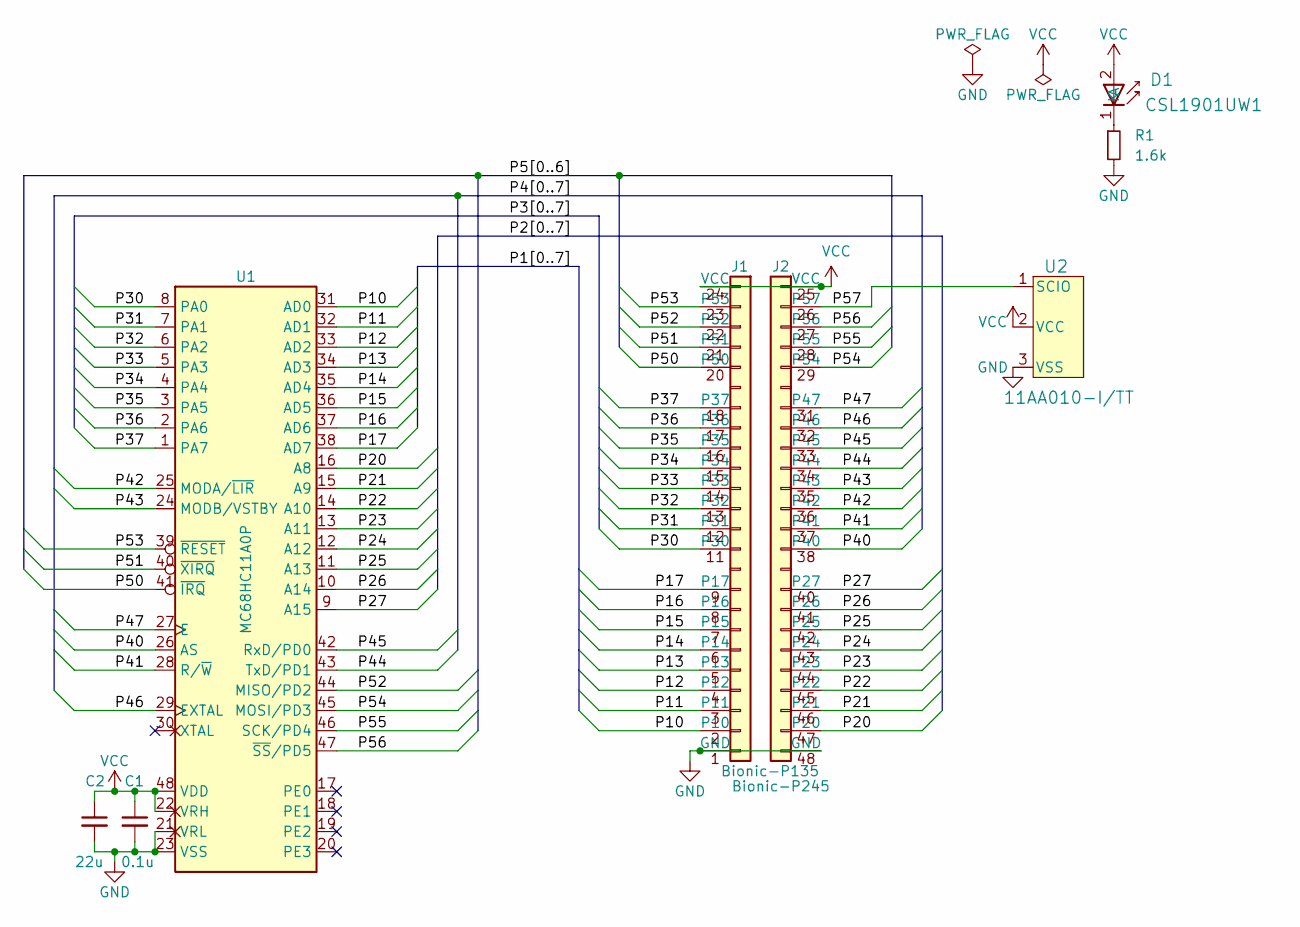
[picture p105: schematic bionic-mc68hc11a.kicad_sch, BionicMC68HC11A]

Parts:
C1: 0.1u; C_0603_1608Metric_Pad1.08x0.95mm_HandSolder
C2: 22u; C_0603_1608Metric_Pad1.08x0.95mm_HandSolder
D1: CSL1901UW1; LED_CSL1901UW1_ROM-M
J1: Bionic-P135; Bionic-P135_THT
J2: Bionic-P245; Bionic-P245_THT
R1: 1.6k; R_0603_1608Metric_Pad0.98x0.95mm_HandSolder
U1: MC68HC11A0P; DIP-48_W15.24mm_Socket
U2: 11AA010-I/TT; SOT-23_MC_MCH-M

Connections:
/P10: J1.2 (P10), U1.31 (AD0)
/P11: J1.3 (P11), U1.32 (AD1)
/P12: J1.4 (P12), U1.33 (AD2)
/P13: J1.5 (P13), U1.34 (AD3)
/P14: J1.6 (P14), U1.35 (AD4)
/P15: J1.7 (P15), U1.36 (AD5)
/P16: J1.8 (P16), U1.37 (AD6)
/P17: J1.9 (P17), U1.38 (AD7)
/P20: J2.47 (P20), U1.16 (A8)
/P21: J2.46 (P21), U1.15 (A9)
/P22: J2.45 (P22), U1.14 (A10)
/P23: J2.44 (P23), U1.13 (A11)
/P24: J2.43 (P24), U1.12 (A12)
/P25: J2.42 (P25), U1.11 (A13)
/P26: J2.41 (P26), U1.10 (A14)
/P27: J2.40 (P27), U1.9 (A15)
/P30: J1.11 (P30), U1.8 (PA0)
/P31: J1.12 (P31), U1.7 (PA1)
/P32: J1.13 (P32), U1.6 (PA2)
/P33: J1.14 (P33), U1.5 (PA3)
/P34: J1.15 (P34), U1.4 (PA4)
/P35: J1.16 (P35), U1.3 (PA5)
/P36: J1.17 (P36), U1.2 (PA6)
/P37: J1.18 (P37), U1.1 (PA7)
/P40: J2.38 (P40), U1.26 (AS)
/P41: J2.37 (P41), U1.28 (R/~W)
/P42: J2.36 (P42), U1.25 (MODA/~LIR)
/P43: J2.35 (P43), U1.24 (MODB/VSTBY)
/P44: J2.34 (P44), U1.43 (TxD/PD1)
/P45: J2.33 (P45), U1.42 (RxD/PD0)
/P46: J2.32 (P46), U1.29 (EXTAL)
/P47: J2.31 (P47), U1.27 (E)
/P50: J1.20 (P50), U1.41 (~IRQ)
/P51: J1.21 (P51), U1.40 (~XIRQ)
/P52: J1.22 (P52), U1.44 (MISO/PD2)
/P53: J1.23 (P53), U1.39 (~RESET)
/P54: J2.29 (P54), U1.45 (MOSI/PD3)
/P55: J2.28 (P55), U1.46 (SCK/PD4)
/P56: J2.27 (P56), U1.47 (~SS/PD5)
/P57: J2.26 (P57), U2.1 (SCIO)
GND: C1.2, C2.2, J1.1 (GND), J2.48 (GND), R1.2, U1.21 (VRL), U1.23 (VSS), U2.3 (VSS)
unnamed: D1.1 (K), R1.1
VCC: C1.1, C2.1, D1.2 (A), J1.24 (VCC), J2.25 (VCC), U1.22 (VRH), U1.48 (VDD), U2.2 (VCC)

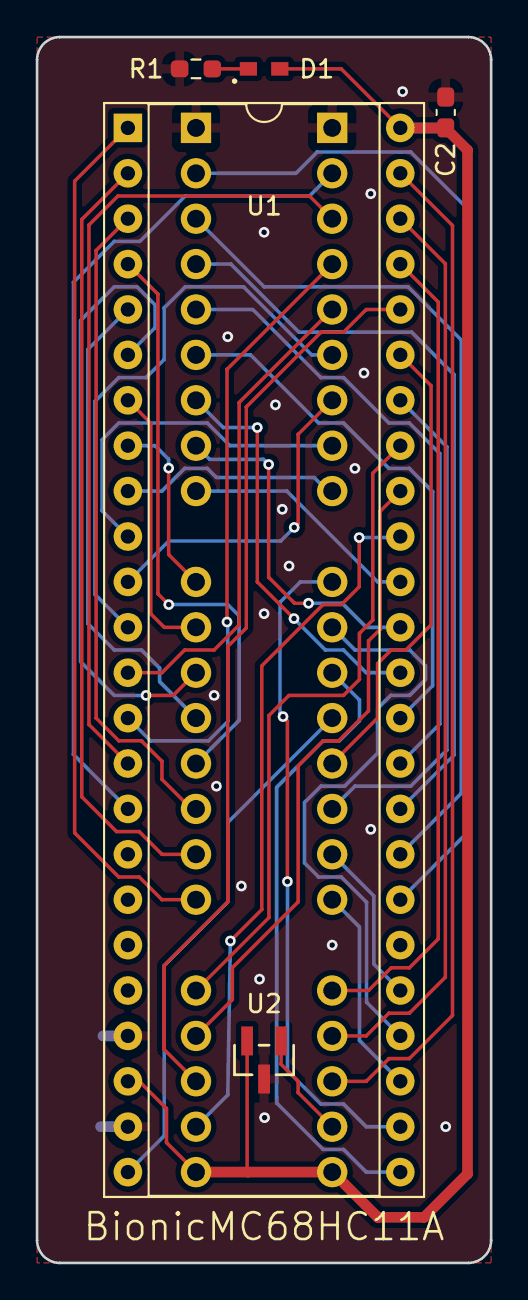
[picture p106: board bionic-mc68hc11a.kicad_pcb from above]

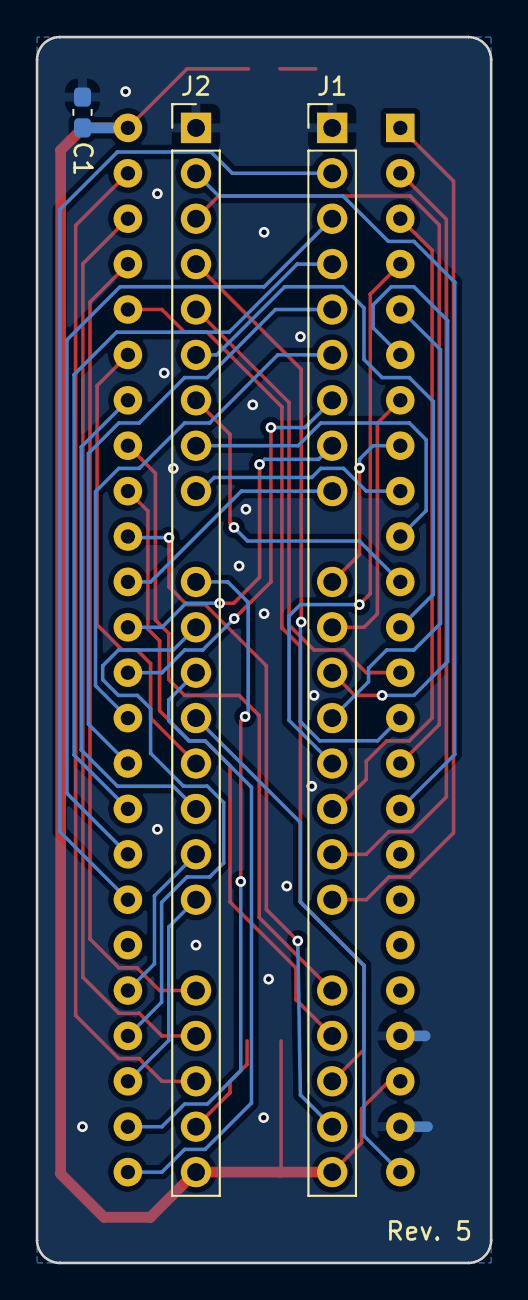
[picture p107: board bionic-mc68hc11a.kicad_pcb from below]

Board: 2 copper layers, 25.4 x 68.6 mm, 8 parts (3 on the bottom side), 43 nets.
