tgtakaoka/retro-bionic/schematics/p8080/bionic-p8080.kicad_pcb

## KiCad design schematics/p8080/bionic-p8080.kicad_pcb (2026-10-26)

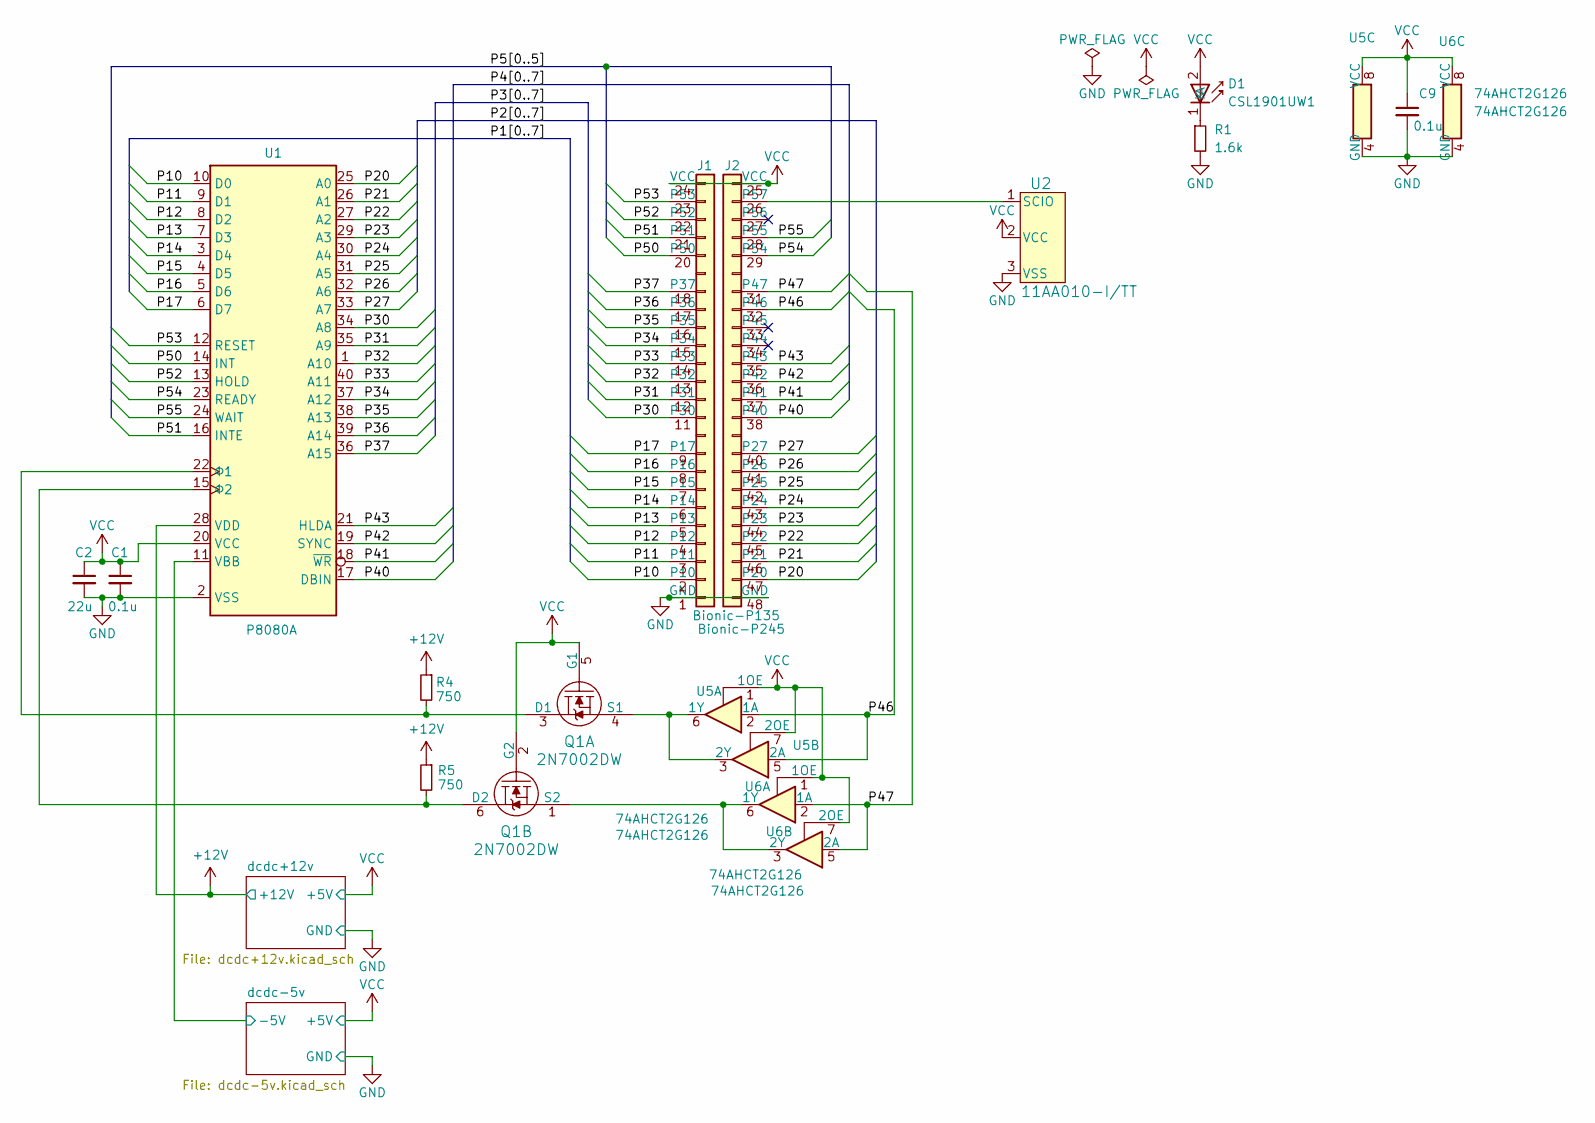
[picture p114: schematic bionic-p8080.kicad_sch, BionicP8080]

Parts:
C1, C9: 0.1u; C_0603_1608Metric_Pad1.08x0.95mm_HandSolder
C2: 22u; C_0603_1608Metric_Pad1.08x0.95mm_HandSolder
D1: CSL1901UW1; LED_CSL1901UW1_ROM-M
J1: Bionic-P135; Bionic-P135_SMT
J2: Bionic-P245; Bionic-P245_SMT
Q1: 2N7002DW; SC-88/SC70-6/SOT-363_419B-02_ONS_OSI
R1: 1.6k; R_0603_1608Metric_Pad0.98x0.95mm_HandSolder
R4, R5: 750; R_0603_1608Metric_Pad0.98x0.95mm_HandSolder
U1: P8080A; DIP-40_W15.24mm_Socket
U2: 11AA010-I/TT; SOT-23_MC_MCH-M
U5, U6: 74AHCT2G126; U_SOT765-1_NEX-M

Connections:
+12V: R4.1, R5.1, U1.28 (VDD); also elsewhere on the board
/P10: J1.2 (P10), U1.10 (D0)
/P11: J1.3 (P11), U1.9 (D1)
/P12: J1.4 (P12), U1.8 (D2)
/P13: J1.5 (P13), U1.7 (D3)
/P14: J1.6 (P14), U1.3 (D4)
/P15: J1.7 (P15), U1.4 (D5)
/P16: J1.8 (P16), U1.5 (D6)
/P17: J1.9 (P17), U1.6 (D7)
/P20: J2.47 (P20), U1.25 (A0)
/P21: J2.46 (P21), U1.26 (A1)
/P22: J2.45 (P22), U1.27 (A2)
/P23: J2.44 (P23), U1.29 (A3)
/P24: J2.43 (P24), U1.30 (A4)
/P25: J2.42 (P25), U1.31 (A5)
/P26: J2.41 (P26), U1.32 (A6)
/P27: J2.40 (P27), U1.33 (A7)
/P30: J1.11 (P30), U1.34 (A8)
/P31: J1.12 (P31), U1.35 (A9)
/P32: J1.13 (P32), U1.1 (A10)
/P33: J1.14 (P33), U1.40 (A11)
/P34: J1.15 (P34), U1.37 (A12)
/P35: J1.16 (P35), U1.38 (A13)
/P36: J1.17 (P36), U1.39 (A14)
/P37: J1.18 (P37), U1.36 (A15)
/P40: J2.38 (P40), U1.17 (DBIN)
/P41: J2.37 (P41), U1.18 (~WR)
/P42: J2.36 (P42), U1.19 (SYNC)
/P43: J2.35 (P43), U1.21 (HLDA)
/P46: J2.32 (P46), U5.2 (1A), U5.5 (2A)
/P47: J2.31 (P47), U6.2 (1A), U6.5 (2A)
/P50: J1.20 (P50), U1.14 (INT)
/P51: J1.21 (P51), U1.16 (INTE)
/P52: J1.22 (P52), U1.13 (HOLD)
/P53: J1.23 (P53), U1.12 (RESET)
/P54: J2.29 (P54), U1.23 (READY)
/P55: J2.28 (P55), U1.24 (WAIT)
/dcdc-5v/-5V: U1.11 (VBB); also elsewhere on the board
GND: C1.2, C2.2, C9.2, J1.1 (GND), J2.48 (GND), R1.2, U1.2 (VSS), U2.3 (VSS), U5.4 (GND), U6.4 (GND); also elsewhere on the board
unnamed: D1.1 (K), R1.1
unnamed: J2.26 (P57), U2.1 (SCIO)
unnamed: Q1.3 (D1), R4.2, U1.22 (Φ1)
unnamed: Q1.4 (S1), U5.3 (2Y), U5.6 (1Y)
unnamed: Q1.6 (D2), R5.2, U1.15 (Φ2)
unnamed: Q1.1 (S2), U6.3 (2Y), U6.6 (1Y)
VCC: C1.1, C2.1, C9.1, D1.2 (A), J1.24 (VCC), J2.25 (VCC), Q1.2 (G2), Q1.5 (G1), U1.20 (VCC), U2.2 (VCC), U5.1 (1OE), U5.7 (2OE), U5.8 (VCC), U6.1 (1OE), U6.7 (2OE), U6.8 (VCC); also elsewhere on the board

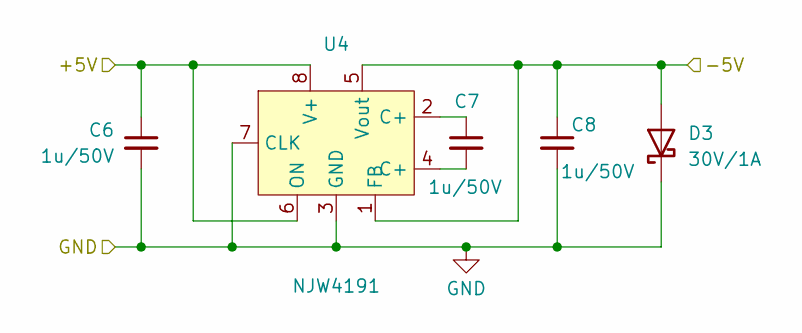
[picture p115: schematic dcdc-5v.kicad_sch]

Parts:
C6, C7, C8: 1u/50V; C_0603_1608Metric_Pad1.08x0.95mm_HandSolder
D3: 30V/1A; CR_60M-60_ROM-M
U4: NJW4191; MSOP8VSP8_PI-VSP8-E-B_NMD-M

Connections:
/dcdc-5v/-5V: C8.1, D3.2 (A), U4.1 (FB), U4.5 (Vout); also elsewhere on the board
GND: C6.2, C8.2, D3.1 (K), U4.3 (GND), U4.7 (CLK); also elsewhere on the board
VCC: C6.1, U4.6 (ON), U4.8 (V+); also elsewhere on the board

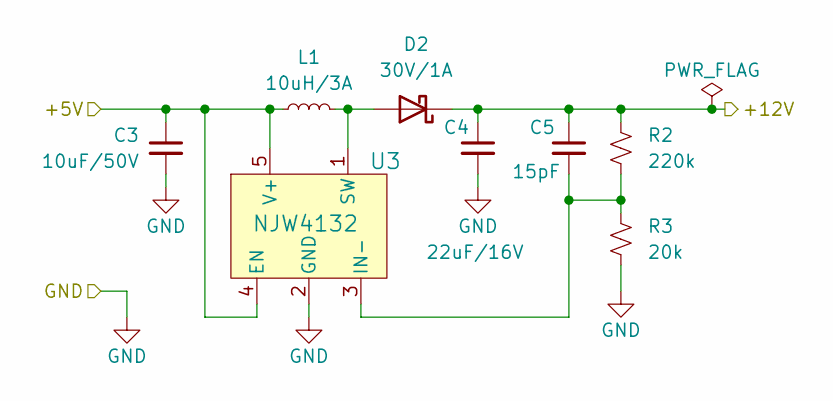
[picture p116: schematic dcdc+12v.kicad_sch]

Parts:
C3: 10uF/50V; C_0603_1608Metric_Pad1.08x0.95mm_HandSolder
C4: 22uF/16V; C_1210_3225Metric_Pad1.33x2.70mm_HandSolder
C5: 15pF; C_0603_1608Metric_Pad1.08x0.95mm_HandSolder
D2: 30V/1A; CR_60M-60_ROM-M
L1: 10uH/3A; IND_DFE322512F_MUR-M
R2: 220k; R_0603_1608Metric_Pad0.98x0.95mm_HandSolder
R3: 20k; R_0603_1608Metric_Pad0.98x0.95mm_HandSolder
U3: NJW4132; SOT-89-5_NMD-M

Connections:
+12V: C4.1, C5.1, D2.1 (K), R2.1; also elsewhere on the board
GND: C3.2, C4.2, R3.2, U3.2 (GND); also elsewhere on the board
unnamed: D2.2 (A), L1.2, U3.1 (SW)
unnamed: C5.2, R2.2, R3.1, U3.3 (IN-)
VCC: C3.1, L1.1, U3.4 (EN), U3.5 (V+); also elsewhere on the board

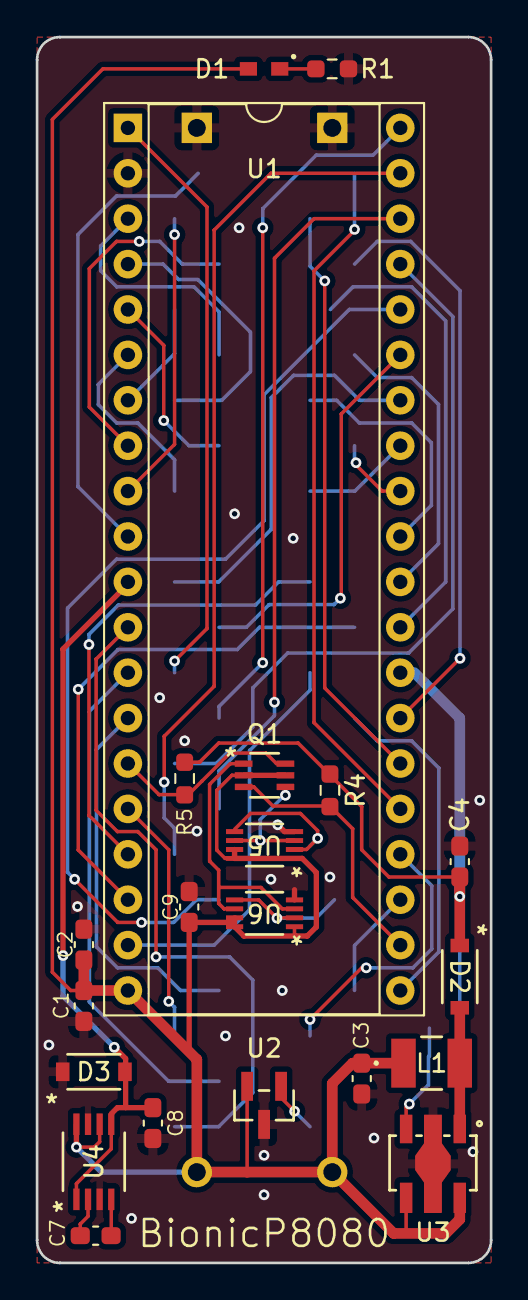
[picture p117: board bionic-p8080.kicad_pcb from above]

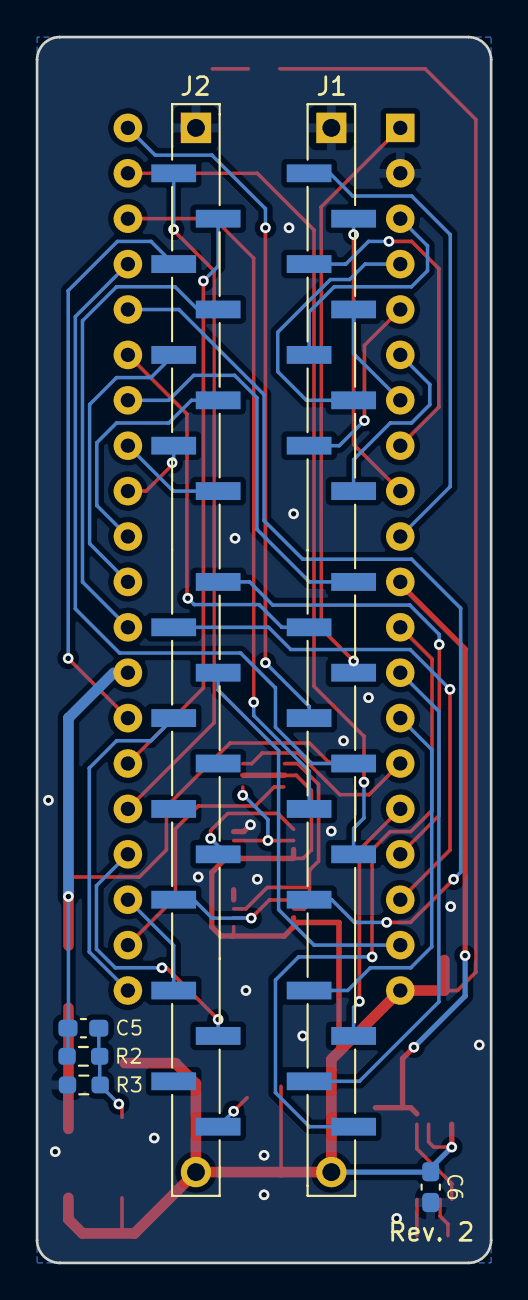
[picture p118: board bionic-p8080.kicad_pcb from below]

Board: 2 copper layers, 25.4 x 68.6 mm, 27 parts (6 on the bottom side), 48 nets.
