tgtakaoka/retro-bionic/schematics/mc6809/bionic-mc6809.kicad_pcb

## KiCad design schematics/mc6809/bionic-mc6809.kicad_pcb (2026-10-26)

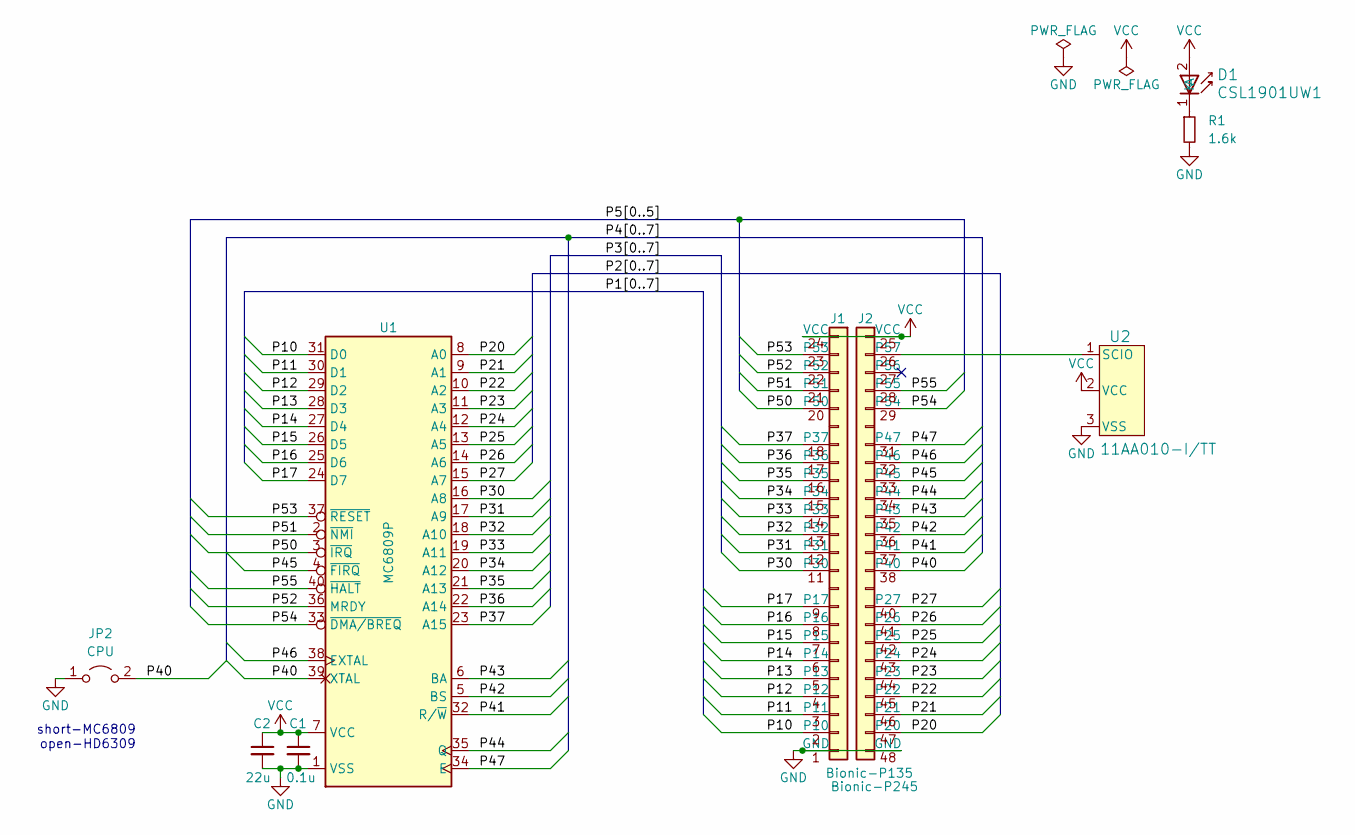
[picture p119: schematic bionic-mc6809.kicad_sch, BionicMC6809]

Parts:
C1: 0.1u; C_0603_1608Metric_Pad1.08x0.95mm_HandSolder
C2: 22u; C_0603_1608Metric_Pad1.08x0.95mm_HandSolder
D1: CSL1901UW1; LED_CSL1901UW1_ROM-M
J1: Bionic-P135; Bionic-P135_THT
J2: Bionic-P245; Bionic-P245_THT
JP2: CPU; SolderJumper-2_P1.3mm_Open_RoundedPad1.0x1.5mm
R1: 1.6k; R_0603_1608Metric_Pad0.98x0.95mm_HandSolder
U1: MC6809P; DIP-40_W15.24mm_Socket
U2: 11AA010-I/TT; SOT-23_MC_MCH-M

Connections:
/P10: J1.2 (P10), U1.31 (D0)
/P11: J1.3 (P11), U1.30 (D1)
/P12: J1.4 (P12), U1.29 (D2)
/P13: J1.5 (P13), U1.28 (D3)
/P14: J1.6 (P14), U1.27 (D4)
/P15: J1.7 (P15), U1.26 (D5)
/P16: J1.8 (P16), U1.25 (D6)
/P17: J1.9 (P17), U1.24 (D7)
/P20: J2.47 (P20), U1.8 (A0)
/P21: J2.46 (P21), U1.9 (A1)
/P22: J2.45 (P22), U1.10 (A2)
/P23: J2.44 (P23), U1.11 (A3)
/P24: J2.43 (P24), U1.12 (A4)
/P25: J2.42 (P25), U1.13 (A5)
/P26: J2.41 (P26), U1.14 (A6)
/P27: J2.40 (P27), U1.15 (A7)
/P30: J1.11 (P30), U1.16 (A8)
/P31: J1.12 (P31), U1.17 (A9)
/P32: J1.13 (P32), U1.18 (A10)
/P33: J1.14 (P33), U1.19 (A11)
/P34: J1.15 (P34), U1.20 (A12)
/P35: J1.16 (P35), U1.21 (A13)
/P36: J1.17 (P36), U1.22 (A14)
/P37: J1.18 (P37), U1.23 (A15)
/P40: J2.38 (P40), JP2.2 (B), U1.39 (XTAL)
/P41: J2.37 (P41), U1.32 (R/~W)
/P42: J2.36 (P42), U1.5 (BS)
/P43: J2.35 (P43), U1.6 (BA)
/P44: J2.34 (P44), U1.35 (Q)
/P45: J2.33 (P45), U1.4 (~FIRQ)
/P46: J2.32 (P46), U1.38 (EXTAL)
/P47: J2.31 (P47), U1.34 (E)
/P50: J1.20 (P50), U1.3 (~IRQ)
/P51: J1.21 (P51), U1.2 (~NMI)
/P52: J1.22 (P52), U1.36 (MRDY)
/P53: J1.23 (P53), U1.37 (~RESET)
/P54: J2.29 (P54), U1.33 (~DMA/BREQ)
/P55: J2.28 (P55), U1.40 (~HALT)
GND: C1.2, C2.2, J1.1 (GND), J2.48 (GND), JP2.1 (A), R1.2, U1.1 (VSS), U2.3 (VSS)
unnamed: D1.1 (K), R1.1
unnamed: J2.26 (P57), U2.1 (SCIO)
VCC: C1.1, C2.1, D1.2 (A), J1.24 (VCC), J2.25 (VCC), U1.7 (VCC), U2.2 (VCC)

Notes on the sheet:
short-MC6809 open-HD6309

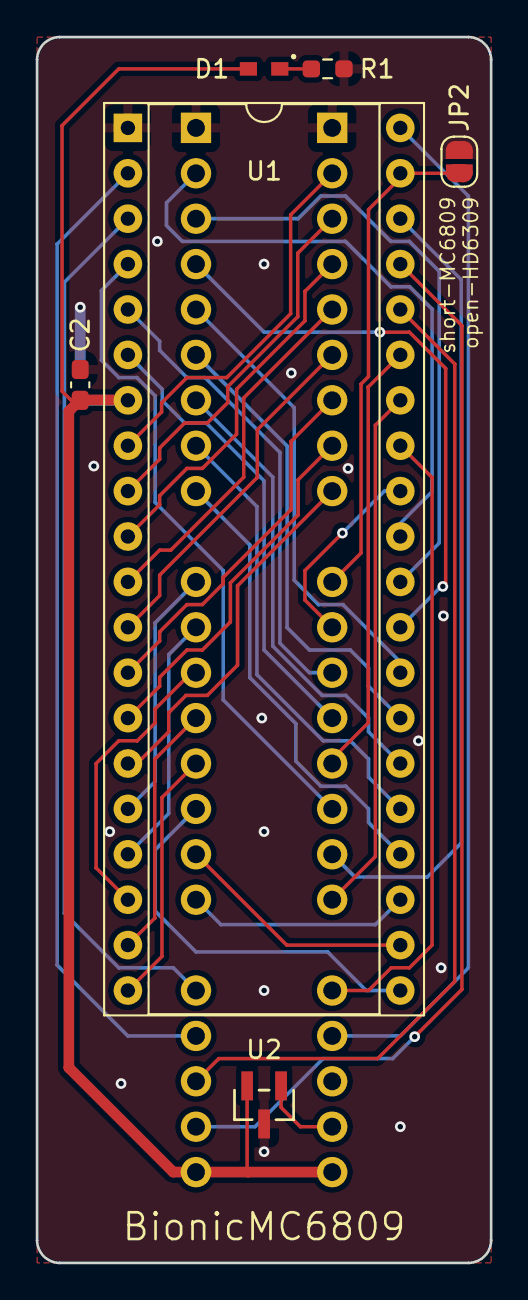
[picture p120: board bionic-mc6809.kicad_pcb from above]

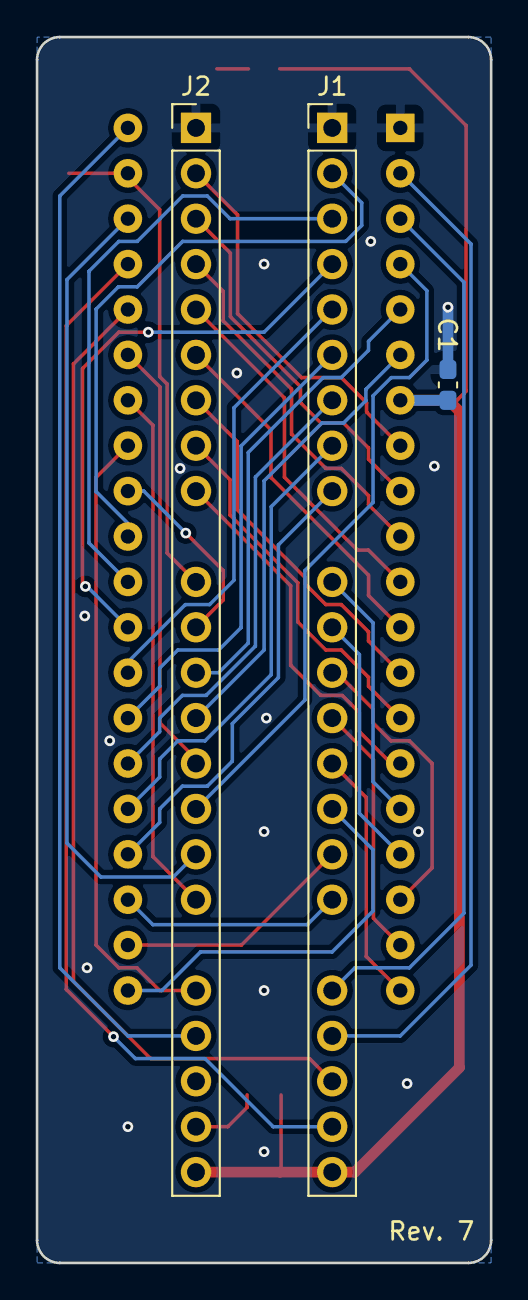
[picture p121: board bionic-mc6809.kicad_pcb from below]

Board: 2 copper layers, 25.4 x 68.6 mm, 9 parts (3 on the bottom side), 42 nets.
