tgtakaoka/retro-bionic/schematics/hd64180s/bionic-hd64180s.kicad_pcb

## KiCad design schematics/hd64180s/bionic-hd64180s.kicad_pcb (2026-10-26)

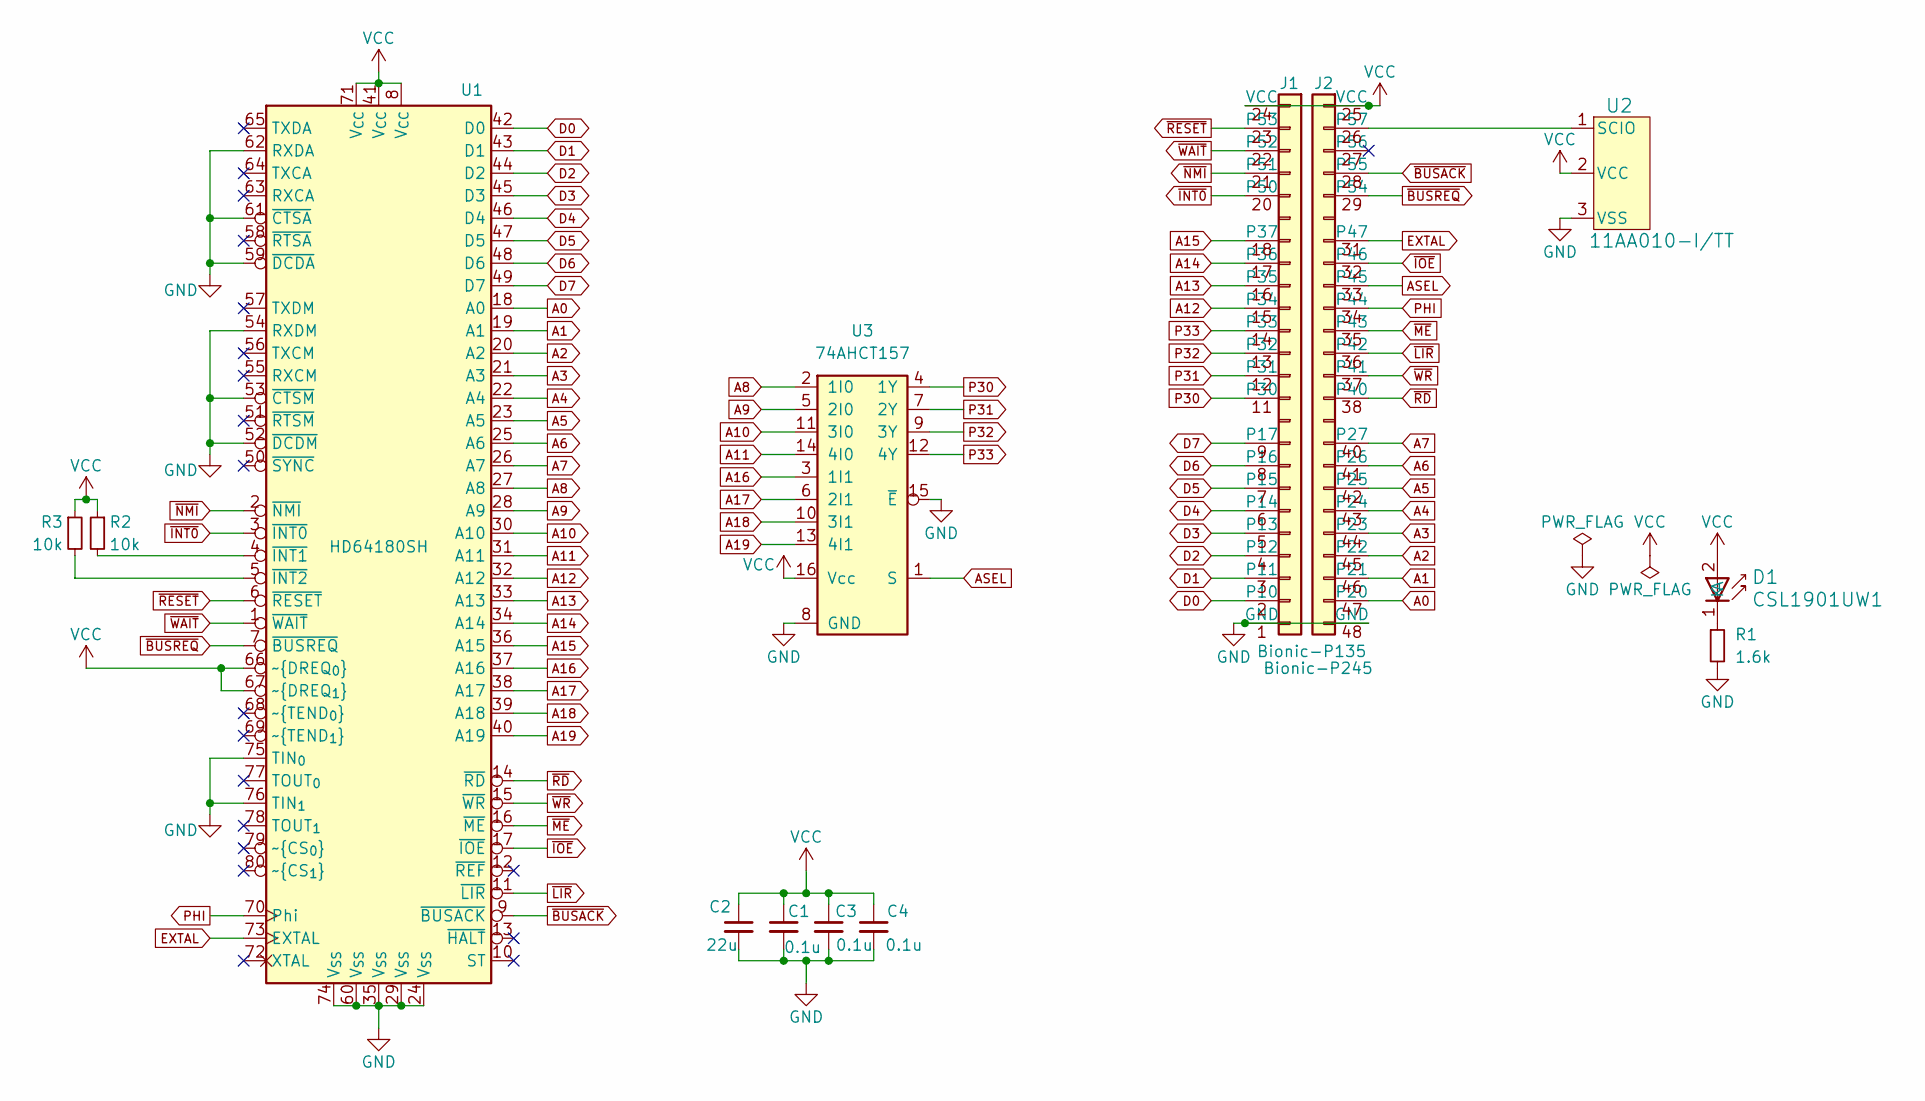
[picture p125: schematic bionic-hd64180s.kicad_sch, BionicHD64180S]

Parts:
C1, C3, C4: 0.1u; C_0603_1608Metric_Pad1.08x0.95mm_HandSolder
C2: 22u; C_0603_1608Metric_Pad1.08x0.95mm_HandSolder
D1: CSL1901UW1; LED_CSL1901UW1_ROM-M
J1: Bionic-P135; Bionic-P135_SMT
J2: Bionic-P245; Bionic-P245_SMT
R1: 1.6k; R_0603_1608Metric_Pad0.98x0.95mm_HandSolder
R2, R3: 10k; R_0603_1608Metric_Pad0.98x0.95mm_HandSolder
U1: HD64180SH; PQFP-80_14x14mm_P0.65mm
U2: 11AA010-I/TT; SOT-23_MC_MCH-M
U3: 74AHCT157; PW16-M

Connections:
A0: J2.47 (P20), U1.18 (A0)
A1: J2.46 (P21), U1.19 (A1)
A2: J2.45 (P22), U1.20 (A2)
A3: J2.44 (P23), U1.21 (A3)
A4: J2.43 (P24), U1.22 (A4)
A5: J2.42 (P25), U1.23 (A5)
A6: J2.41 (P26), U1.25 (A6)
A7: J2.40 (P27), U1.26 (A7)
A8: U1.27 (A8), U3.2 (1I0)
A9: U1.28 (A9), U3.5 (2I0)
A10: U1.30 (A10), U3.11 (3I0)
A11: U1.31 (A11), U3.14 (4I0)
A12: J1.15 (P34), U1.32 (A12)
A13: J1.16 (P35), U1.33 (A13)
A14: J1.17 (P36), U1.34 (A14)
A15: J1.18 (P37), U1.36 (A15)
A16: U1.37 (A16), U3.3 (1I1)
A17: U1.38 (A17), U3.6 (2I1)
A18: U1.39 (A18), U3.10 (3I1)
A19: U1.40 (A19), U3.13 (4I1)
ASEL: J2.33 (P45), U3.1 (S)
D0: J1.2 (P10), U1.42 (D0)
D1: J1.3 (P11), U1.43 (D1)
D2: J1.4 (P12), U1.44 (D2)
D3: J1.5 (P13), U1.45 (D3)
D4: J1.6 (P14), U1.46 (D4)
D5: J1.7 (P15), U1.47 (D5)
D6: J1.8 (P16), U1.48 (D6)
D7: J1.9 (P17), U1.49 (D7)
EXTAL: J2.31 (P47), U1.73 (EXTAL)
GND: C1.2, C2.2, C3.2, C4.2, J1.1 (GND), J2.48 (GND), R1.2, U1.24 (V_{SS}), U1.29 (V_{SS}), U1.35 (V_{SS}), U1.52 (~DCDM), U1.53 (~CTSM), U1.54 (RXDM), U1.59 (~DCDA), U1.60 (V_{SS}), U1.61 (~CTSA), U1.62 (RXDA), U1.74 (V_{SS}), U1.75 (TIN_{0}), U1.76 (TIN_{1}), U2.3 (VSS), U3.8 (GND), U3.15 (~E)
unnamed: D1.1 (K), R1.1
unnamed: J2.26 (P57), U2.1 (SCIO)
unnamed: R2.2, U1.4 (~INT1)
unnamed: R3.2, U1.5 (~INT2)
P30: J1.11 (P30), U3.4 (1Y)
P31: J1.12 (P31), U3.7 (2Y)
P32: J1.13 (P32), U3.9 (3Y)
P33: J1.14 (P33), U3.12 (4Y)
PHI: J2.34 (P44), U1.70 (Phi)
VCC: C1.1, C2.1, C3.1, C4.1, D1.2 (A), J1.24 (VCC), J2.25 (VCC), R2.1, R3.1, U1.8 (V_{CC}), U1.41 (V_{CC}), U1.66 (~DREQ_{0}), U1.67 (~DREQ_{1}), U1.71 (V_{CC}), U2.2 (VCC), U3.16 (Vcc)
~BUSACK: J2.28 (P55), U1.9 (~BUSACK)
~BUSREQ: J2.29 (P54), U1.7 (~BUSREQ)
~INT0: J1.20 (P50), U1.3 (~INT0)
~IOE: J2.32 (P46), U1.17 (~IOE)
~LIR: J2.36 (P42), U1.11 (~LIR)
~ME: J2.35 (P43), U1.16 (~ME)
~NMI: J1.21 (P51), U1.2 (~NMI)
~RD: J2.38 (P40), U1.14 (~RD)
~RESET: J1.23 (P53), U1.6 (~RESET)
~WAIT: J1.22 (P52), U1.1 (~WAIT)
~WR: J2.37 (P41), U1.15 (~WR)

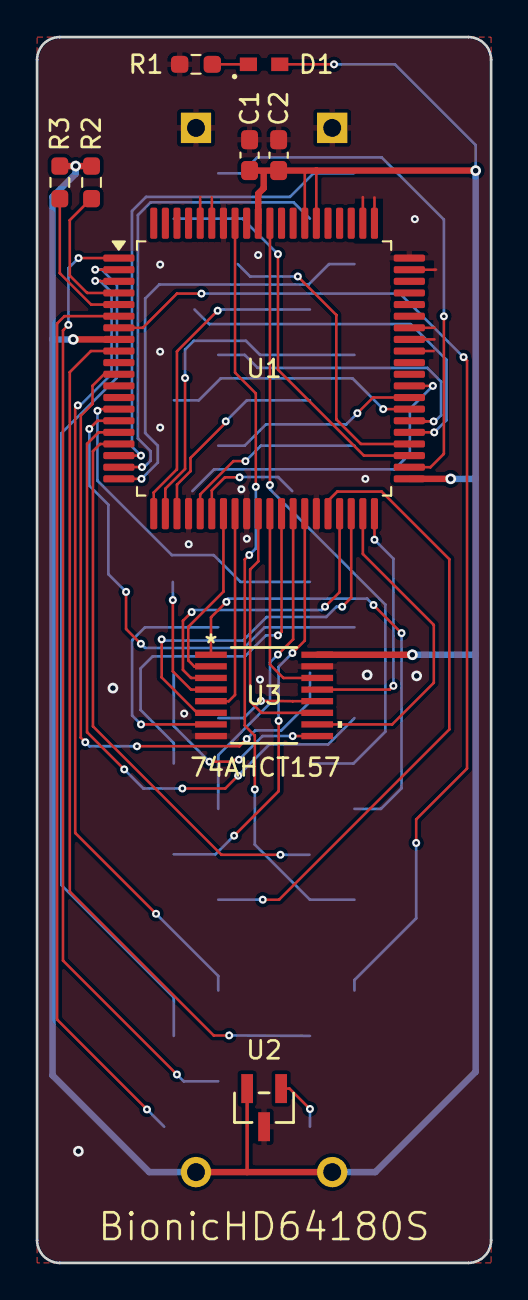
[picture p126: board bionic-hd64180s.kicad_pcb from above]

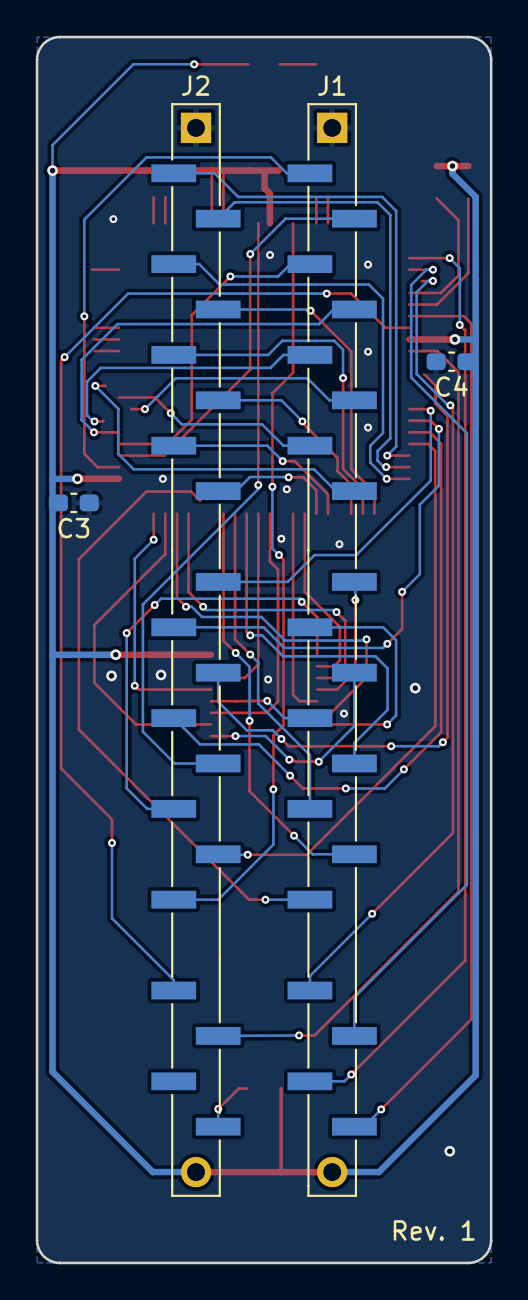
[picture p127: board bionic-hd64180s.kicad_pcb from below]

Board: 2 copper layers, 25.4 x 68.6 mm, 13 parts (4 on the bottom side), 52 nets.
