tgtakaoka/retro-bionic/schematics/s80c196kc/bionic-s80c196kc.kicad_pcb

## KiCad design schematics/s80c196kc/bionic-s80c196kc.kicad_pcb (2026-10-26)

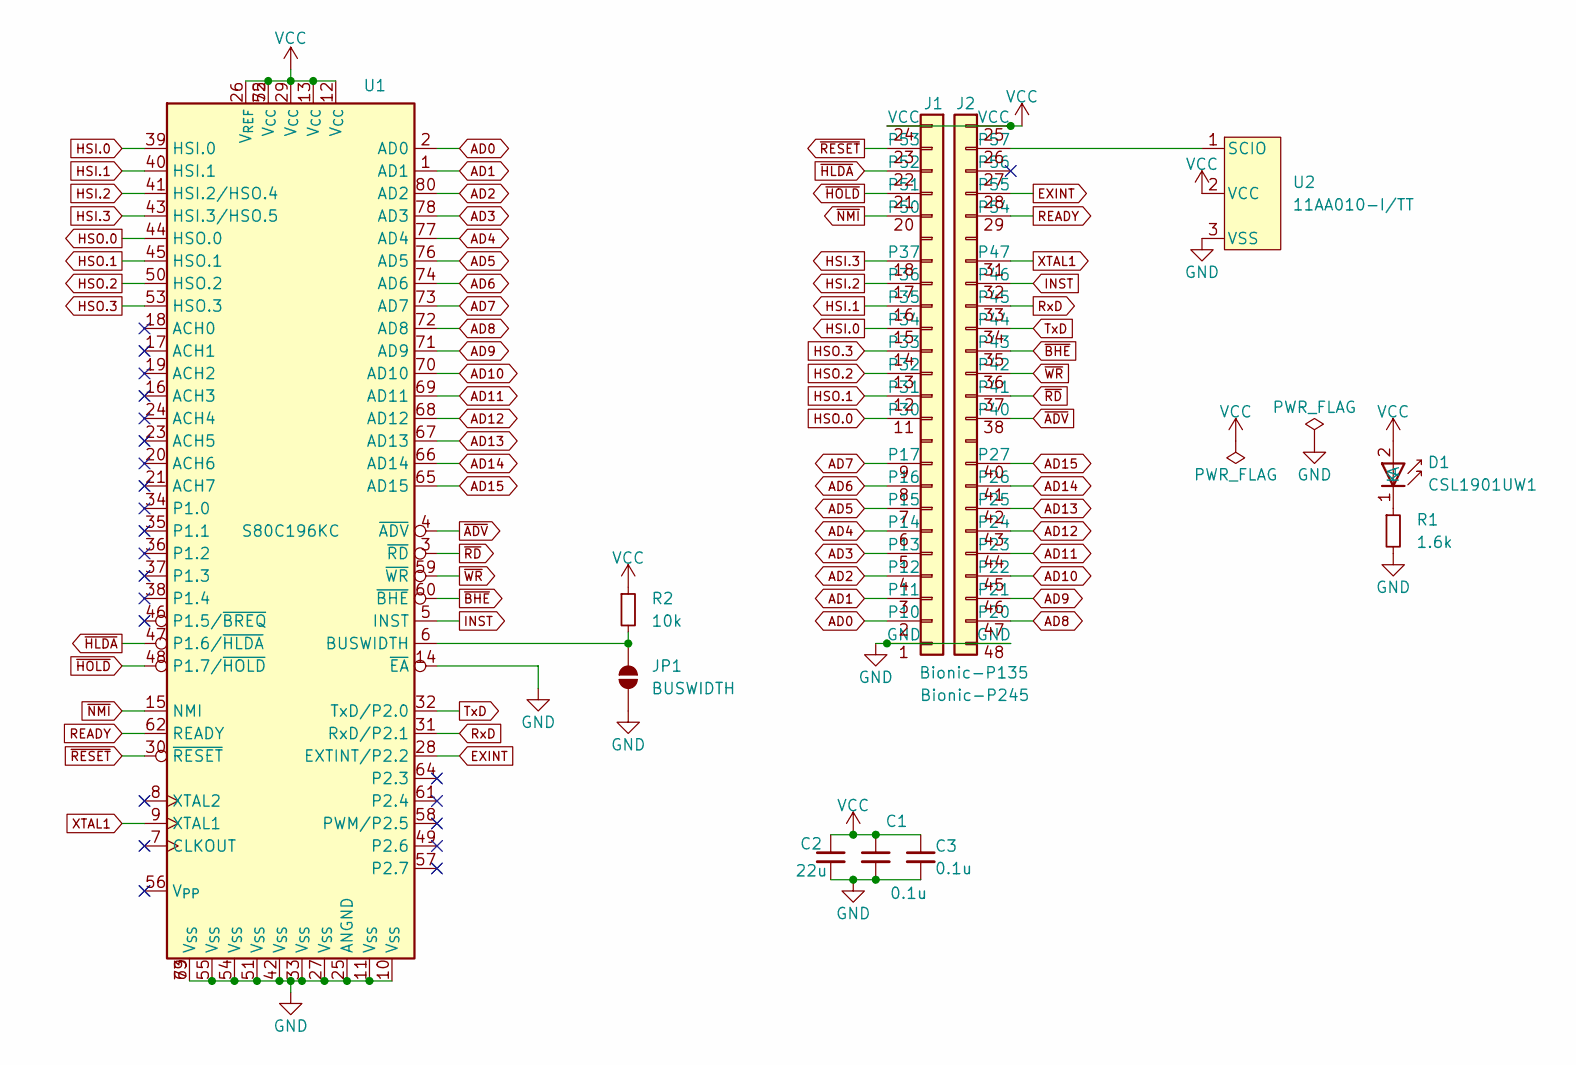
[picture p131: schematic bionic-s80c196kc.kicad_sch, BionicS80C196KC]

Parts:
C1, C3: 0.1u; C_0603_1608Metric_Pad1.08x0.95mm_HandSolder
C2: 22u; C_0603_1608Metric_Pad1.08x0.95mm_HandSolder
D1: CSL1901UW1; LED_CSL1901UW1_ROM-M
J1: Bionic-P135; Bionic-P135_SMT
J2: Bionic-P245; Bionic-P245_SMT
JP1: BUSWIDTH; SolderJumper-2_P1.3mm_Open_TrianglePad1.0x1.5mm
R1: 1.6k; R_0603_1608Metric_Pad0.98x0.95mm_HandSolder
R2: 10k; R_0603_1608Metric_Pad0.98x0.95mm_HandSolder
U1: S80C196KC; PQFP-80_14x20mm_P0.8mm
U2: 11AA010-I/TT; SOT-23_MC_MCH-M

Connections:
AD0: J1.2 (P10), U1.2 (AD0)
AD1: J1.3 (P11), U1.1 (AD1)
AD2: J1.4 (P12), U1.80 (AD2)
AD3: J1.5 (P13), U1.78 (AD3)
AD4: J1.6 (P14), U1.77 (AD4)
AD5: J1.7 (P15), U1.76 (AD5)
AD6: J1.8 (P16), U1.74 (AD6)
AD7: J1.9 (P17), U1.73 (AD7)
AD8: J2.47 (P20), U1.72 (AD8)
AD9: J2.46 (P21), U1.71 (AD9)
AD10: J2.45 (P22), U1.70 (AD10)
AD11: J2.44 (P23), U1.69 (AD11)
AD12: J2.43 (P24), U1.68 (AD12)
AD13: J2.42 (P25), U1.67 (AD13)
AD14: J2.41 (P26), U1.66 (AD14)
AD15: J2.40 (P27), U1.65 (AD15)
EXINT: J2.28 (P55), U1.28 (EXTINT/P2.2)
GND: C1.2, C2.2, C3.2, J1.1 (GND), J2.48 (GND), JP1.1 (A), R1.2, U1.10 (V_{SS}), U1.11 (V_{SS}), U1.14 (~EA), U1.25 (ANGND), U1.27 (V_{SS}), U1.33 (V_{SS}), U1.42 (V_{SS}), U1.51 (V_{SS}), U1.54 (V_{SS}), U1.55 (V_{SS}), U1.63 (V_{SS}), U1.79 (V_{SS}), U2.3 (VSS)
HSI.0: J1.15 (P34), U1.39 (HSI.0)
HSI.1: J1.16 (P35), U1.40 (HSI.1)
HSI.2: J1.17 (P36), U1.41 (HSI.2/HSO.4)
HSI.3: J1.18 (P37), U1.43 (HSI.3/HSO.5)
HSO.0: J1.11 (P30), U1.44 (HSO.0)
HSO.1: J1.12 (P31), U1.45 (HSO.1)
HSO.2: J1.13 (P32), U1.50 (HSO.2)
HSO.3: J1.14 (P33), U1.53 (HSO.3)
INST: J2.32 (P46), U1.5 (INST)
unnamed: D1.1 (K), R1.1
unnamed: J2.26 (P57), U2.1 (SCIO)
unnamed: JP1.2 (B), R2.2, U1.6 (BUSWIDTH)
READY: J2.29 (P54), U1.62 (READY)
RxD: J2.33 (P45), U1.31 (RxD/P2.1)
TxD: J2.34 (P44), U1.32 (TxD/P2.0)
VCC: C1.1, C2.1, C3.1, D1.2 (A), J1.24 (VCC), J2.25 (VCC), R2.1, U1.12 (V_{CC}), U1.13 (V_{CC}), U1.26 (V_{REF}), U1.29 (V_{CC}), U1.52 (V_{CC}), U1.75 (V_{CC}), U2.2 (VCC)
XTAL1: J2.31 (P47), U1.9 (XTAL1)
~ADV: J2.38 (P40), U1.4 (~ADV)
~BHE: J2.35 (P43), U1.60 (~BHE)
~HLDA: J1.22 (P52), U1.47 (P1.6/~HLDA)
~HOLD: J1.21 (P51), U1.48 (P1.7/~HOLD)
~NMI: J1.20 (P50), U1.15 (NMI)
~RD: J2.37 (P41), U1.3 (~RD)
~RESET: J1.23 (P53), U1.30 (~RESET)
~WR: J2.36 (P42), U1.59 (~WR)

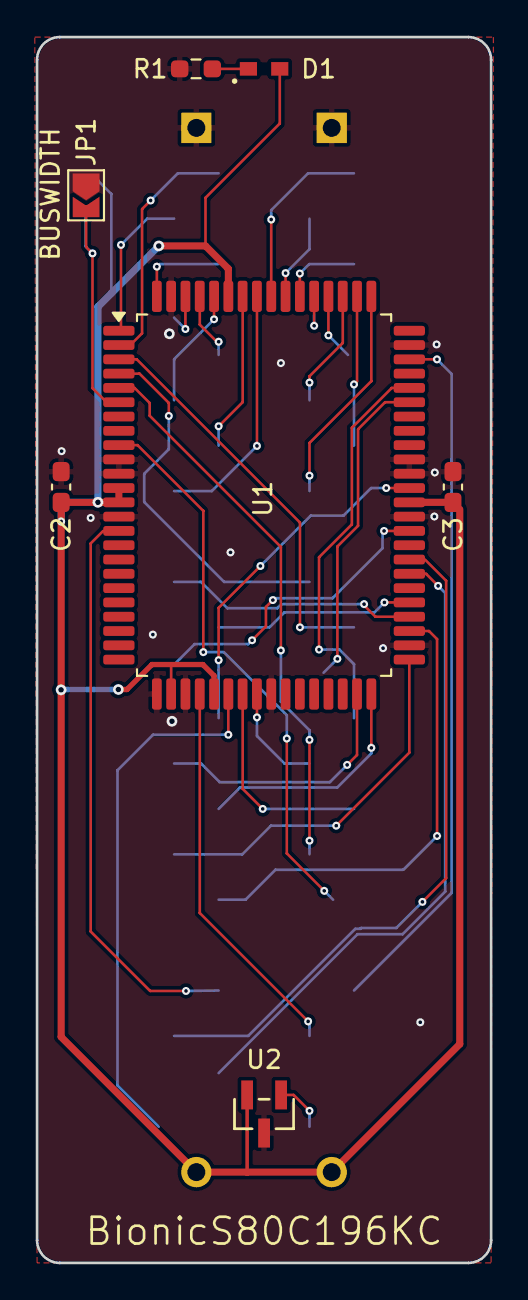
[picture p132: board bionic-s80c196kc.kicad_pcb from above]

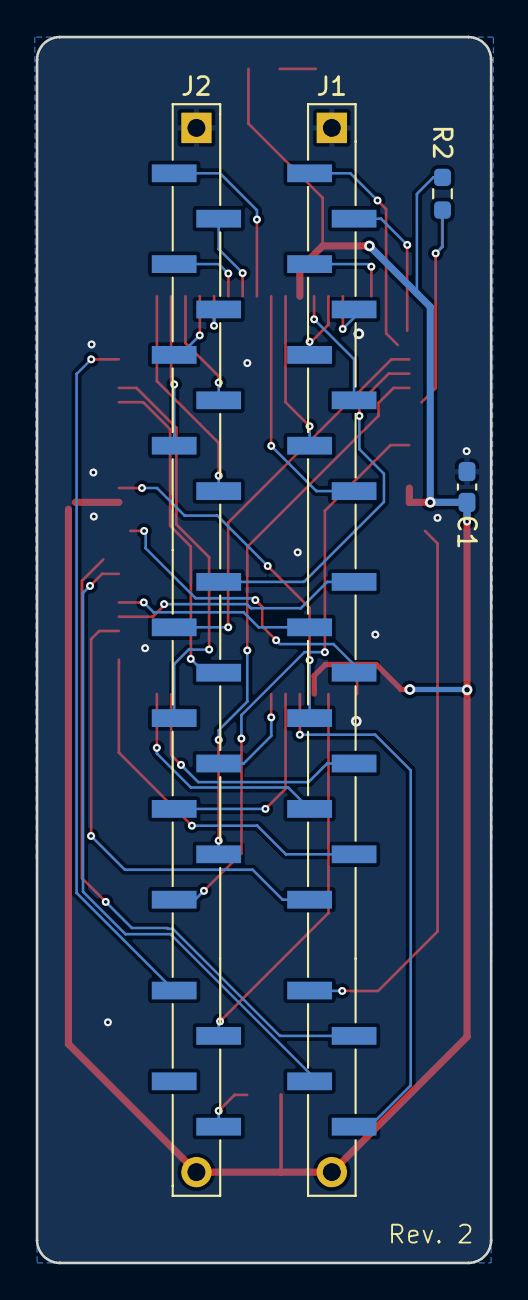
[picture p133: board bionic-s80c196kc.kicad_pcb from below]

Board: 2 copper layers, 25.4 x 68.6 mm, 11 parts (4 on the bottom side), 43 nets.
