tgtakaoka/retro-bionic/schematics/tmp90c802/bionic-tmp90c802.kicad_pcb

## KiCad design schematics/tmp90c802/bionic-tmp90c802.kicad_pcb (continued)

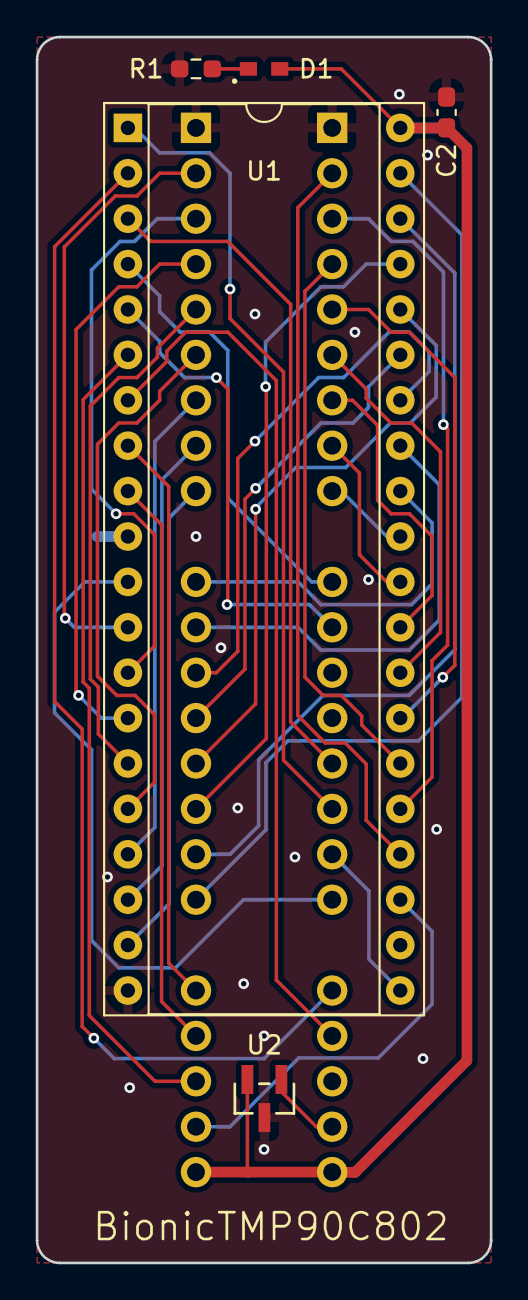
[picture p138: board bionic-tmp90c802.kicad_pcb from above]

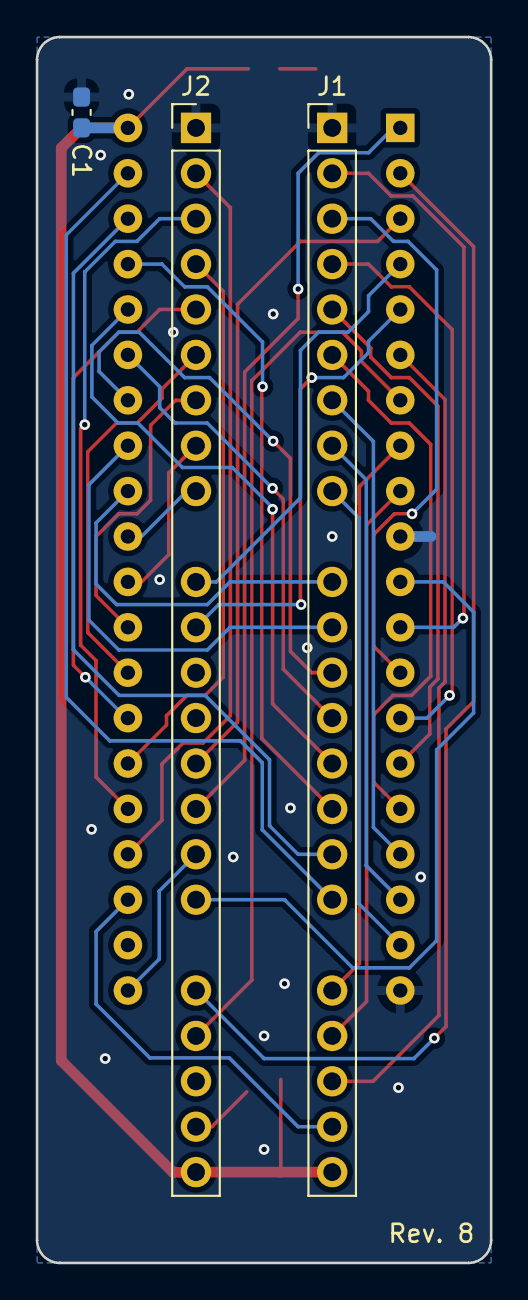
[picture p139: board bionic-tmp90c802.kicad_pcb from below]

Board: 2 copper layers, 25.4 x 68.6 mm, 8 parts (3 on the bottom side), 40 nets.
