tgtakaoka/retro-bionic/schematics/mc68hc08az0/bionic-mc68hc08az0.kicad_pcb

## KiCad design schematics/mc68hc08az0/bionic-mc68hc08az0.kicad_pcb (2026-10-26)

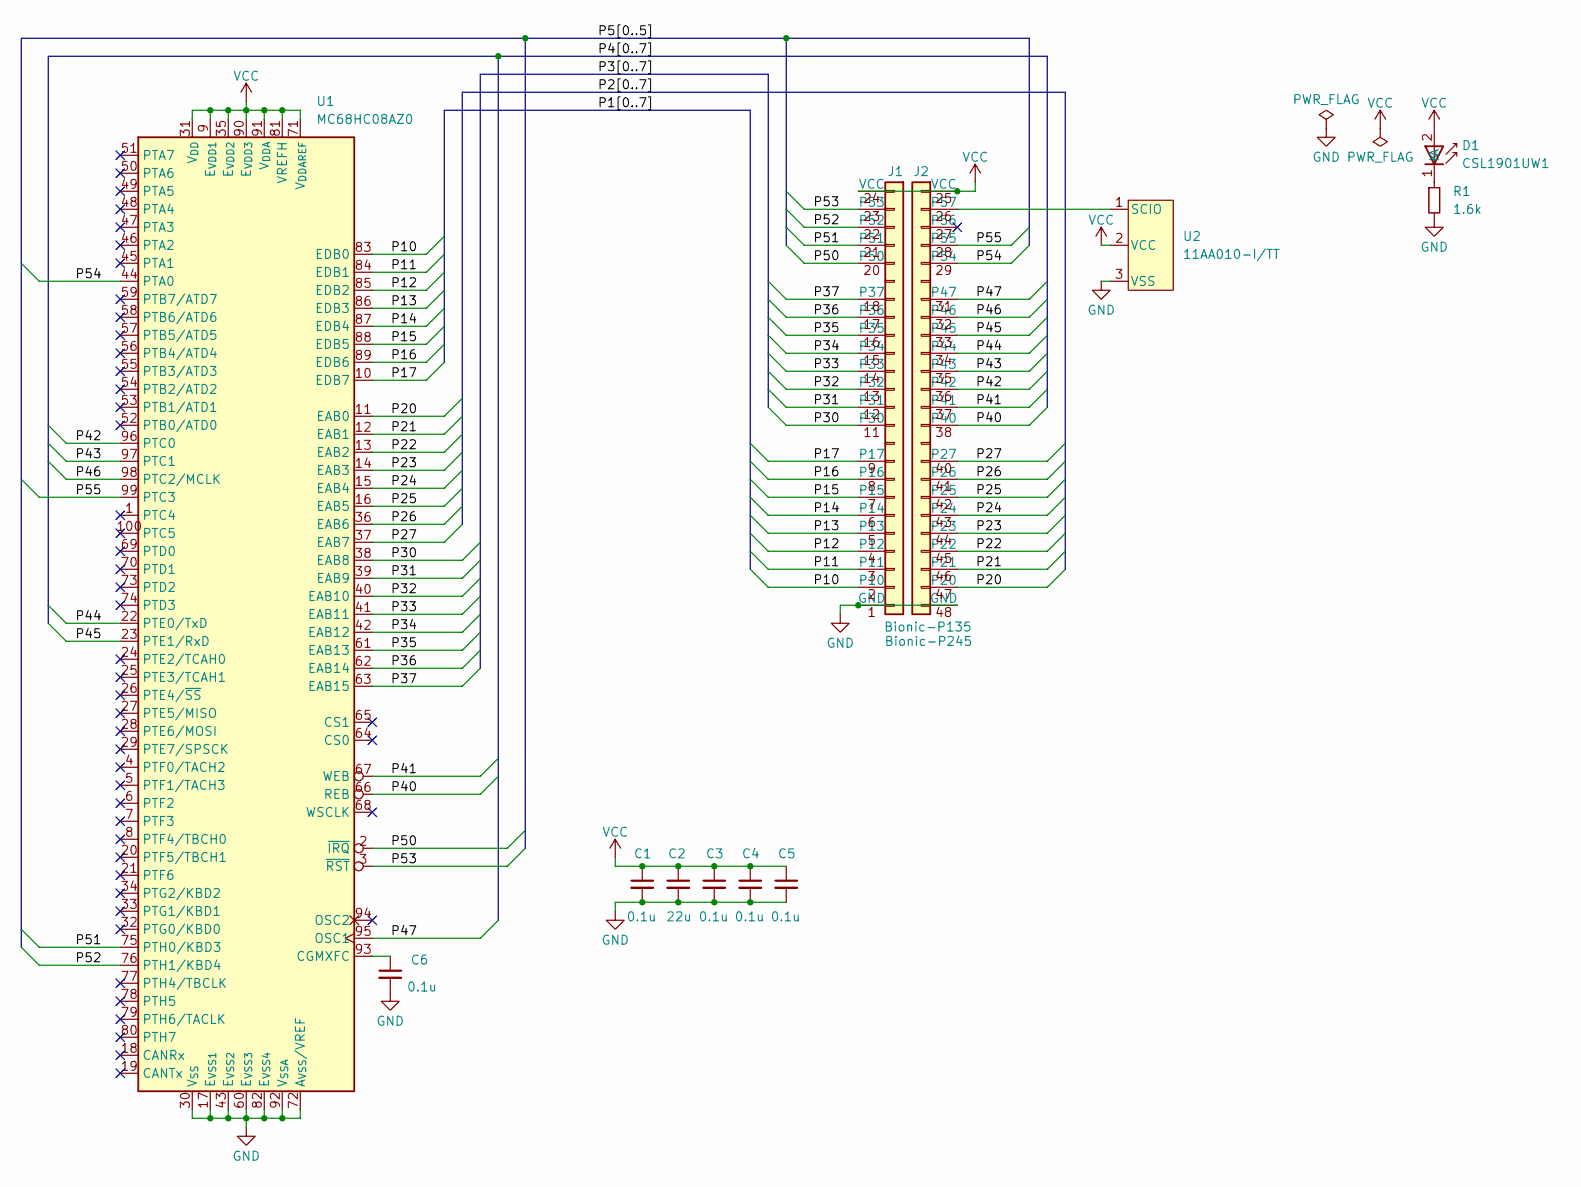
[picture p143: schematic bionic-mc68hc08az0.kicad_sch, BionicMC68HC08AZ0]

Parts:
C1, C3, C4, C5, C6: 0.1u; C_0603_1608Metric_Pad1.08x0.95mm_HandSolder
C2: 22u; C_0603_1608Metric_Pad1.08x0.95mm_HandSolder
D1: CSL1901UW1; LED_CSL1901UW1_ROM-M
J1: Bionic-P135; Bionic-P135_SMT
J2: Bionic-P245; Bionic-P245_SMT
R1: 1.6k; R_0603_1608Metric_Pad0.98x0.95mm_HandSolder
U1: MC68HC08AZ0; LQFP-100_14x14mm_P0.5mm
U2: 11AA010-I/TT; SOT-23_MC_MCH-M

Connections:
/P10: J1.2 (P10), U1.83 (EDB0)
/P11: J1.3 (P11), U1.84 (EDB1)
/P12: J1.4 (P12), U1.85 (EDB2)
/P13: J1.5 (P13), U1.86 (EDB3)
/P14: J1.6 (P14), U1.87 (EDB4)
/P15: J1.7 (P15), U1.88 (EDB5)
/P16: J1.8 (P16), U1.89 (EDB6)
/P17: J1.9 (P17), U1.10 (EDB7)
/P20: J2.47 (P20), U1.11 (EAB0)
/P21: J2.46 (P21), U1.12 (EAB1)
/P22: J2.45 (P22), U1.13 (EAB2)
/P23: J2.44 (P23), U1.14 (EAB3)
/P24: J2.43 (P24), U1.15 (EAB4)
/P25: J2.42 (P25), U1.16 (EAB5)
/P26: J2.41 (P26), U1.36 (EAB6)
/P27: J2.40 (P27), U1.37 (EAB7)
/P30: J1.11 (P30), U1.38 (EAB8)
/P31: J1.12 (P31), U1.39 (EAB9)
/P32: J1.13 (P32), U1.40 (EAB10)
/P33: J1.14 (P33), U1.41 (EAB11)
/P34: J1.15 (P34), U1.42 (EAB12)
/P35: J1.16 (P35), U1.61 (EAB13)
/P36: J1.17 (P36), U1.62 (EAB14)
/P37: J1.18 (P37), U1.63 (EAB15)
/P40: J2.38 (P40), U1.66 (REB)
/P41: J2.37 (P41), U1.67 (WEB)
/P42: J2.36 (P42), U1.96 (PTC0)
/P43: J2.35 (P43), U1.97 (PTC1)
/P44: J2.34 (P44), U1.22 (PTE0/TxD)
/P45: J2.33 (P45), U1.23 (PTE1/RxD)
/P46: J2.32 (P46), U1.98 (PTC2/MCLK)
/P47: J2.31 (P47), U1.95 (OSC1)
/P50: J1.20 (P50), U1.2 (~IRQ)
/P51: J1.21 (P51), U1.75 (PTH0/KBD3)
/P52: J1.22 (P52), U1.76 (PTH1/KBD4)
/P53: J1.23 (P53), U1.3 (~RST)
/P54: J2.29 (P54), U1.44 (PTA0)
/P55: J2.28 (P55), U1.99 (PTC3)
GND: C1.2, C2.2, C3.2, C4.2, C5.2, C6.2, J1.1 (GND), J2.48 (GND), R1.2, U1.17 (EVSS1), U1.30 (VSS), U1.43 (EVSS2), U1.60 (EVSS3), U1.72 (AVSS/VREFL), U1.82 (EVSS4), U1.92 (VSSA), U2.3 (VSS)
unnamed: D1.1 (K), R1.1
unnamed: J2.26 (P57), U2.1 (SCIO)
unnamed: C6.1, U1.93 (CGMXFC)
VCC: C1.1, C2.1, C3.1, C4.1, C5.1, D1.2 (A), J1.24 (VCC), J2.25 (VCC), U1.9 (EVDD1), U1.31 (VDD), U1.35 (EVDD2), U1.71 (VDDAREF), U1.81 (VREFH), U1.90 (EVDD3), U1.91 (VDDA), U2.2 (VCC)

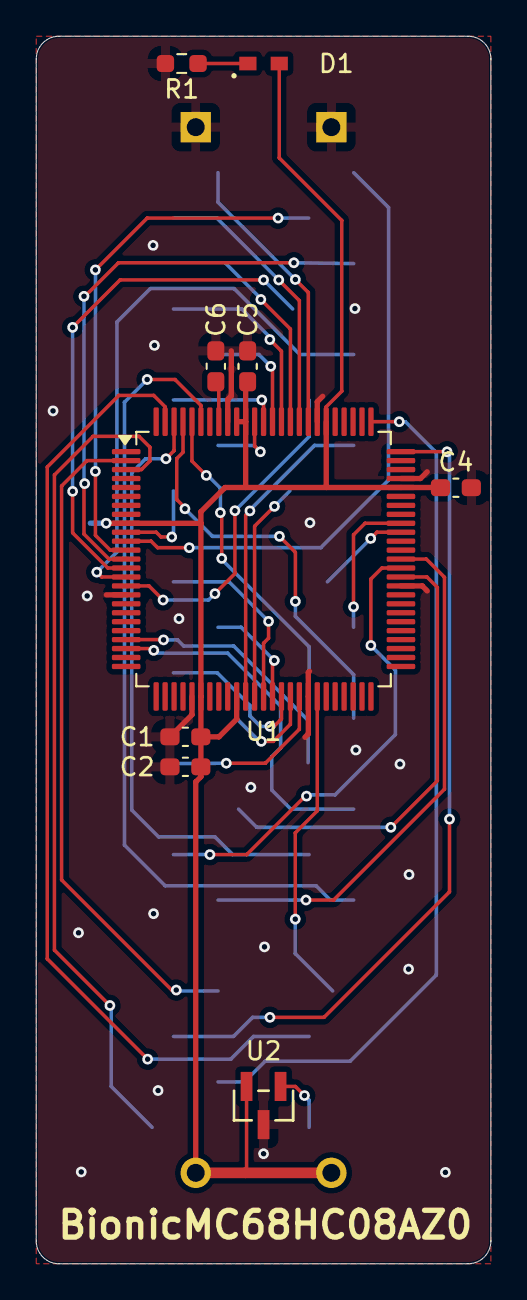
[picture p144: board bionic-mc68hc08az0.kicad_pcb from above]

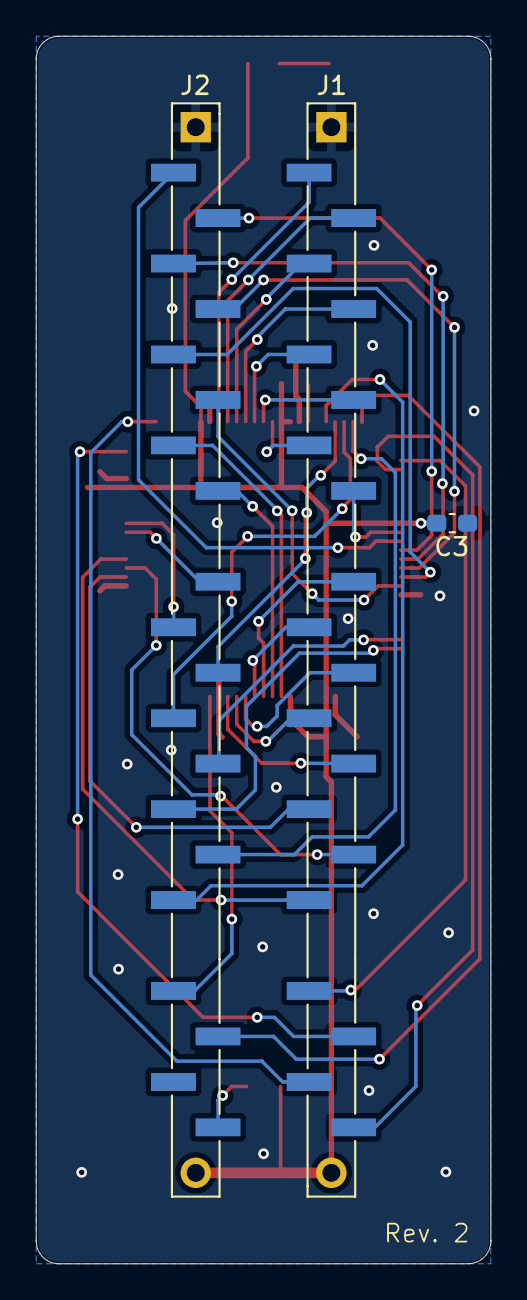
[picture p145: board bionic-mc68hc08az0.kicad_pcb from below]

Board: 2 copper layers, 25.4 x 68.6 mm, 12 parts (3 on the bottom side), 43 nets.
