tgtakaoka/retro-bionic/schematics/f3850/bionic-f3850.kicad_pcb

## KiCad design schematics/f3850/bionic-f3850.kicad_pcb (2026-10-26)

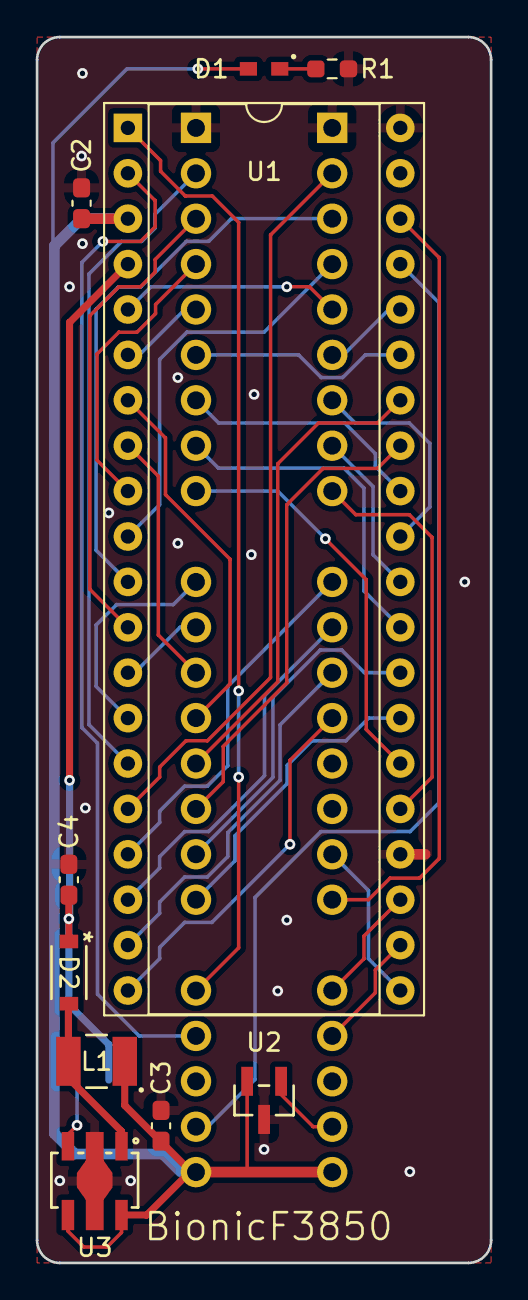
[picture p149: board bionic-f3850.kicad_pcb from above]

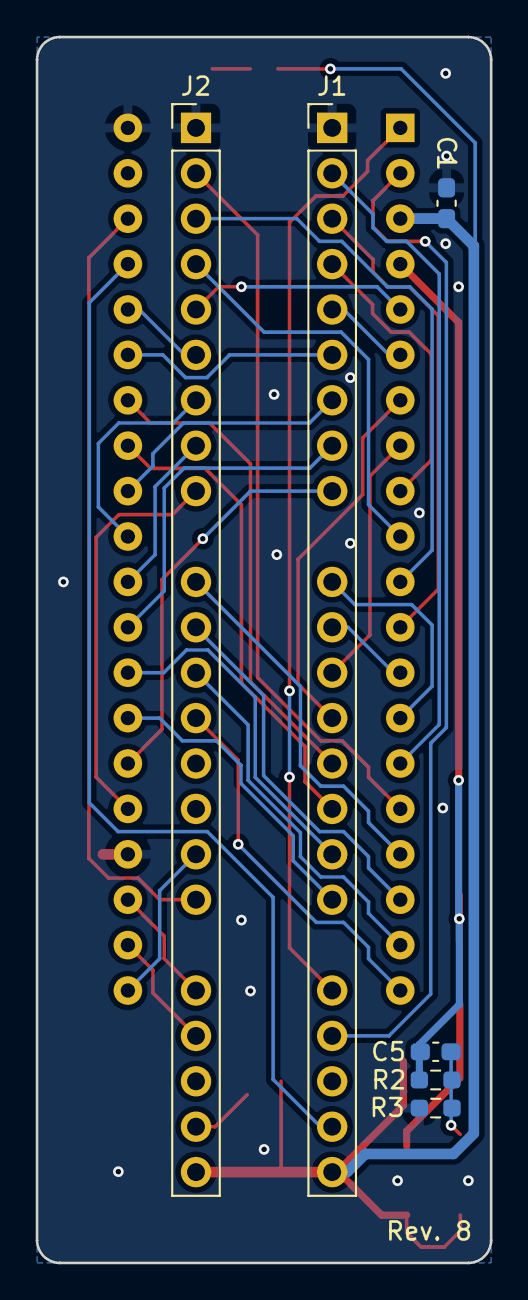
[picture p150: board bionic-f3850.kicad_pcb from below]

Board: 2 copper layers, 25.4 x 68.6 mm, 16 parts (6 on the bottom side), 42 nets.

Parts:
C1: 22u; C_0603_1608Metric_Pad1.08x0.95mm_HandSolder
C2: 0.1u; C_0603_1608Metric_Pad1.08x0.95mm_HandSolder
C3: 10uF/50V; C_0603_1608Metric_Pad1.08x0.95mm_HandSolder
C4: 22uF/16V; C_0603_1608Metric_Pad1.08x0.95mm_HandSolder
C5: 15pF; C_0603_1608Metric_Pad1.08x0.95mm_HandSolder
D1: CSL1901UW1; LED_CSL1901UW1_ROM-M
D2: 30V/1A; CR_60M-60_ROM-M
J1: Bionic-P135; Bionic-P135_THT
J2: Bionic-P245; Bionic-P245_THT
L1: 10uH/3A; IND_DFE322512F_MUR-M
R1: 1.6k; R_0603_1608Metric_Pad0.98x0.95mm_HandSolder
R2: 220k; R_0603_1608Metric_Pad0.98x0.95mm_HandSolder
R3: 20k; R_0603_1608Metric_Pad0.98x0.95mm_HandSolder
U1: F3850; DIP-40_W15.24mm_Socket
U2: 11AA010-I/TT; SOT-23_MC_MCH-M
U3: NJW4132; SOT-89-5_NMD-M

Connections:
/P10: J1.2 (P10), U1.15 (DB0)
/P11: J1.3 (P11), U1.12 (DB1)
/P12: J1.4 (P12), U1.9 (DB2)
/P13: J1.5 (P13), U1.6 (DB3)
/P14: J1.6 (P14), U1.35 (DB4)
/P15: J1.7 (P15), U1.32 (DB5)
/P16: J1.8 (P16), U1.29 (DB6)
/P17: J1.9 (P17), U1.26 (DB7)
/P20: J2.47 (P20), U1.16 (~IO00)
/P21: J2.46 (P21), U1.11 (~IO01)
/P22: J2.45 (P22), U1.10 (~IO02)
/P23: J2.44 (P23), U1.5 (~IO03)
/P24: J2.43 (P24), U1.36 (~IO04)
/P25: J2.42 (P25), U1.31 (~IO05)
/P26: J2.41 (P26), U1.30 (~IO06)
/P27: J2.40 (P27), U1.25 (~IO07)
/P30: J1.11 (P30), U1.14 (~IO10)
/P31: J1.12 (P31), U1.13 (~IO11)
/P32: J1.13 (P32), U1.8 (~IO12)
/P33: J1.14 (P33), U1.7 (~IO13)
/P34: J1.15 (P34), U1.34 (~IO14)
/P35: J1.16 (P35), U1.33 (~IO15)
/P36: J1.17 (P36), U1.28 (~IO16)
/P37: J1.18 (P37), U1.27 (~IO17)
/P40: J2.38 (P40), U1.17 (ROMC0)
/P41: J2.37 (P41), U1.18 (ROMC1)
/P42: J2.36 (P42), U1.19 (ROMC2)
/P43: J2.35 (P43), U1.20 (ROMC3)
/P46: J2.32 (P46), U1.21 (ROMC4)
/P47: J2.31 (P47), U1.38 (XTLY)
/P50: J1.20 (P50), U1.1 (PHI)
/P51: J1.21 (P51), U1.2 (WRITE)
/P53: J1.23 (P53), U1.37 (~EXTRES)
/P54: J2.29 (P54), U1.23 (~INTREQ)
/P55: J2.28 (P55), U1.22 (~ICB)
/dcdc+12v/+12V: C4.1, C5.1, D2.1 (K), R2.1, U1.4 (VGG)
GND: C1.2, C2.2, C3.2, C4.2, J1.1 (GND), J2.48 (GND), R1.2, R3.2, U1.24 (VSS), U1.40 (XTLZ), U2.3 (VSS), U3.2 (GND)
unnamed: D1.1 (K), R1.1
unnamed: D2.2 (A), L1.2, U3.1 (SW)
unnamed: J2.26 (P57), U2.1 (SCIO)
unnamed: C5.2, R2.2, R3.1, U3.3 (IN-)
VCC: C1.1, C2.1, C3.1, D1.2 (A), J1.24 (VCC), J2.25 (VCC), L1.1, U1.3 (VDD), U2.2 (VCC), U3.4 (EN), U3.5 (V+)
