tgtakaoka/retro-bionic/schematics/z8002/bionic-z8002.kicad_pcb

## KiCad design schematics/z8002/bionic-z8002.kicad_pcb (2026-10-26)

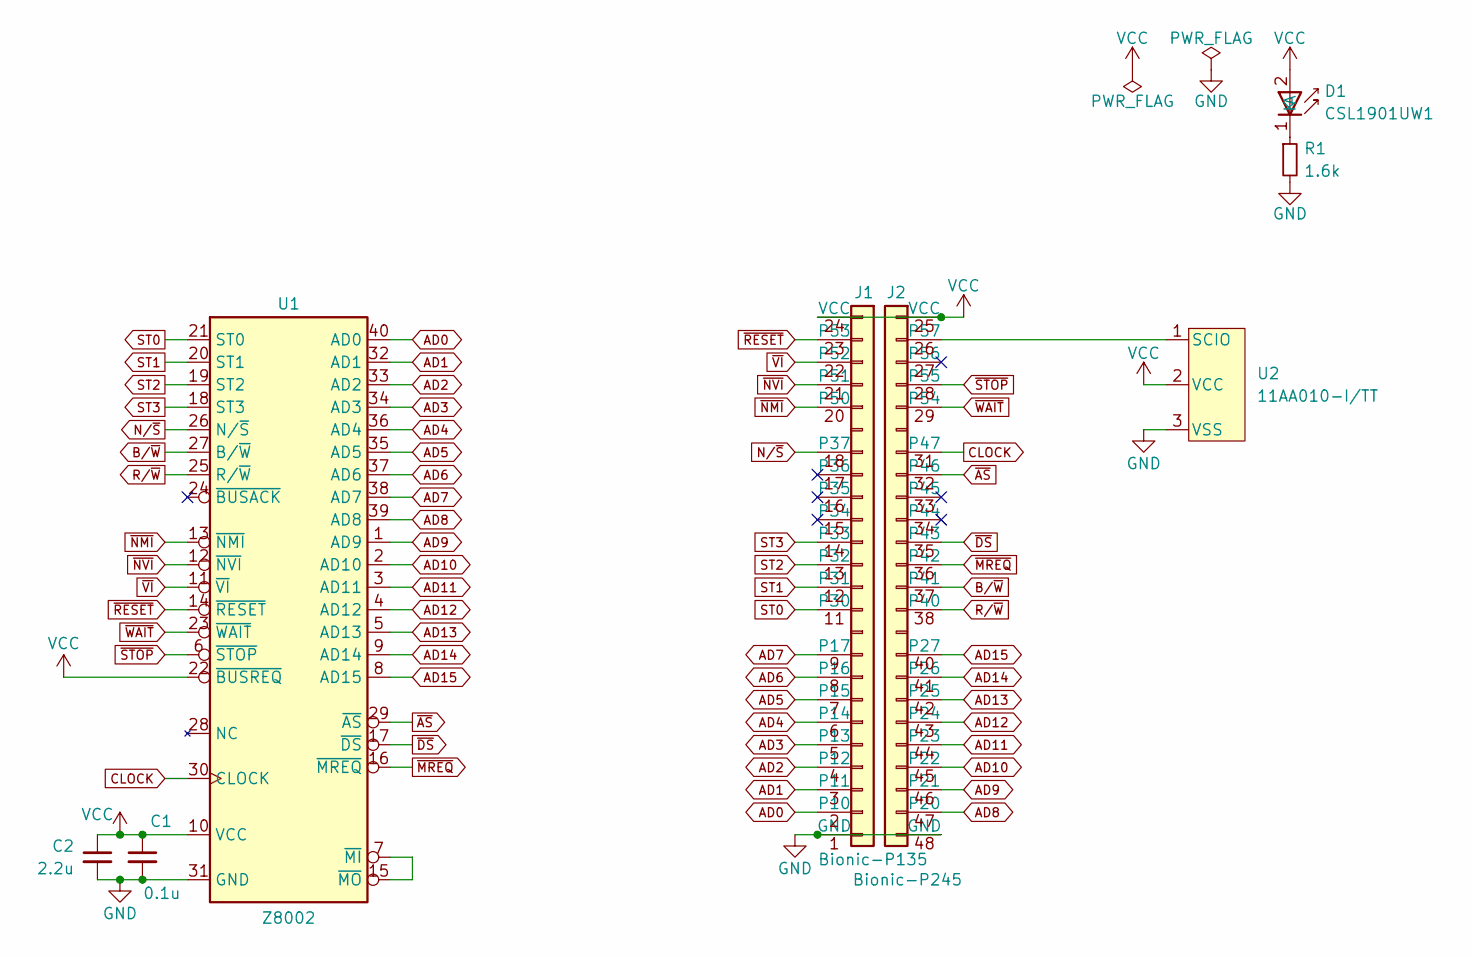
[picture p160: schematic bionic-z8002.kicad_sch, BionicZ8002]

Parts:
C1: 0.1u; C_0603_1608Metric_Pad1.08x0.95mm_HandSolder
C2: 2.2u; C_0603_1608Metric_Pad1.08x0.95mm_HandSolder
D1: CSL1901UW1; LED_CSL1901UW1_ROM-M
J1: Bionic-P135; Bionic-P135_THT
J2: Bionic-P245; Bionic-P245_THT
R1: 1.6k; R_0603_1608Metric_Pad0.98x0.95mm_HandSolder
U1: Z8002; DIP-40_W15.24mm_Socket
U2: 11AA010-I/TT; SOT-23_MC_MCH-M

Connections:
AD0: J1.2 (P10), U1.40 (AD0)
AD1: J1.3 (P11), U1.32 (AD1)
AD2: J1.4 (P12), U1.33 (AD2)
AD3: J1.5 (P13), U1.34 (AD3)
AD4: J1.6 (P14), U1.36 (AD4)
AD5: J1.7 (P15), U1.35 (AD5)
AD6: J1.8 (P16), U1.37 (AD6)
AD7: J1.9 (P17), U1.38 (AD7)
AD8: J2.47 (P20), U1.39 (AD8)
AD9: J2.46 (P21), U1.1 (AD9)
AD10: J2.45 (P22), U1.2 (AD10)
AD11: J2.44 (P23), U1.3 (AD11)
AD12: J2.43 (P24), U1.4 (AD12)
AD13: J2.42 (P25), U1.5 (AD13)
AD14: J2.41 (P26), U1.9 (AD14)
AD15: J2.40 (P27), U1.8 (AD15)
B/~W: J2.37 (P41), U1.27 (B/~W)
CLOCK: J2.31 (P47), U1.30 (CLOCK)
GND: C1.2, C2.2, J1.1 (GND), J2.48 (GND), R1.2, U1.31 (GND), U2.3 (VSS)
unnamed: D1.1 (K), R1.1
unnamed: J2.26 (P57), U2.1 (SCIO)
unnamed: U1.7 (~MI), U1.15 (~MO)
N/~S: J1.18 (P37), U1.26 (N/~S)
R/~W: J2.38 (P40), U1.25 (R/~W)
ST0: J1.11 (P30), U1.21 (ST0)
ST1: J1.12 (P31), U1.20 (ST1)
ST2: J1.13 (P32), U1.19 (ST2)
ST3: J1.14 (P33), U1.18 (ST3)
VCC: C1.1, C2.1, D1.2 (A), J1.24 (VCC), J2.25 (VCC), U1.10 (VCC), U1.22 (~BUSREQ), U2.2 (VCC)
~AS: J2.32 (P46), U1.29 (~AS)
~DS: J2.35 (P43), U1.17 (~DS)
~MREQ: J2.36 (P42), U1.16 (~MREQ)
~NMI: J1.20 (P50), U1.13 (~NMI)
~NVI: J1.21 (P51), U1.12 (~NVI)
~RESET: J1.23 (P53), U1.14 (~RESET)
~STOP: J2.28 (P55), U1.6 (~STOP)
~VI: J1.22 (P52), U1.11 (~VI)
~WAIT: J2.29 (P54), U1.23 (~WAIT)

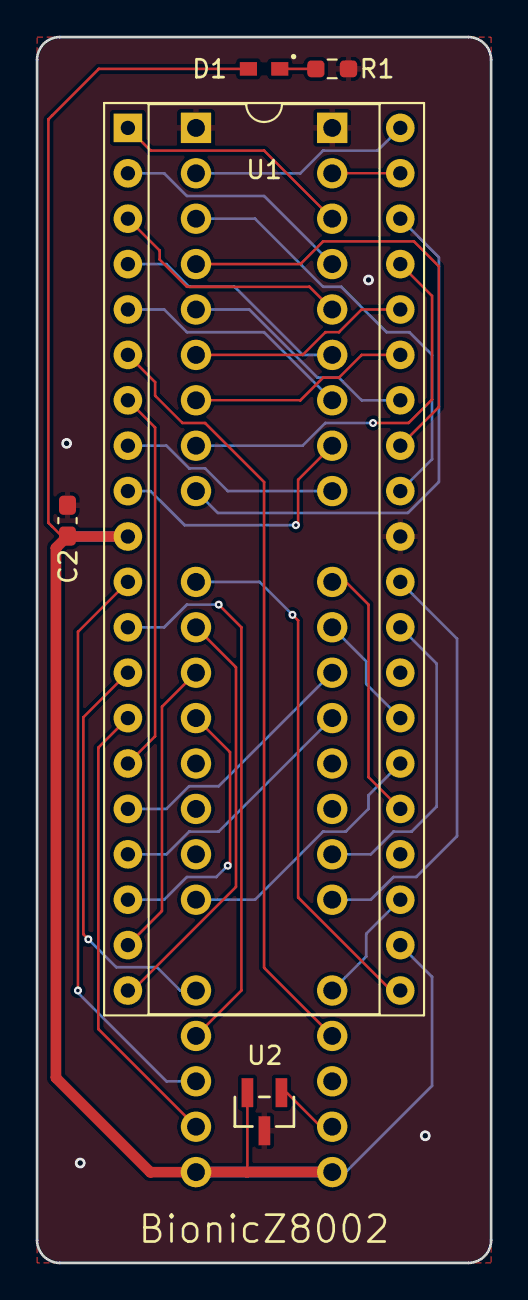
[picture p161: board bionic-z8002.kicad_pcb from above]

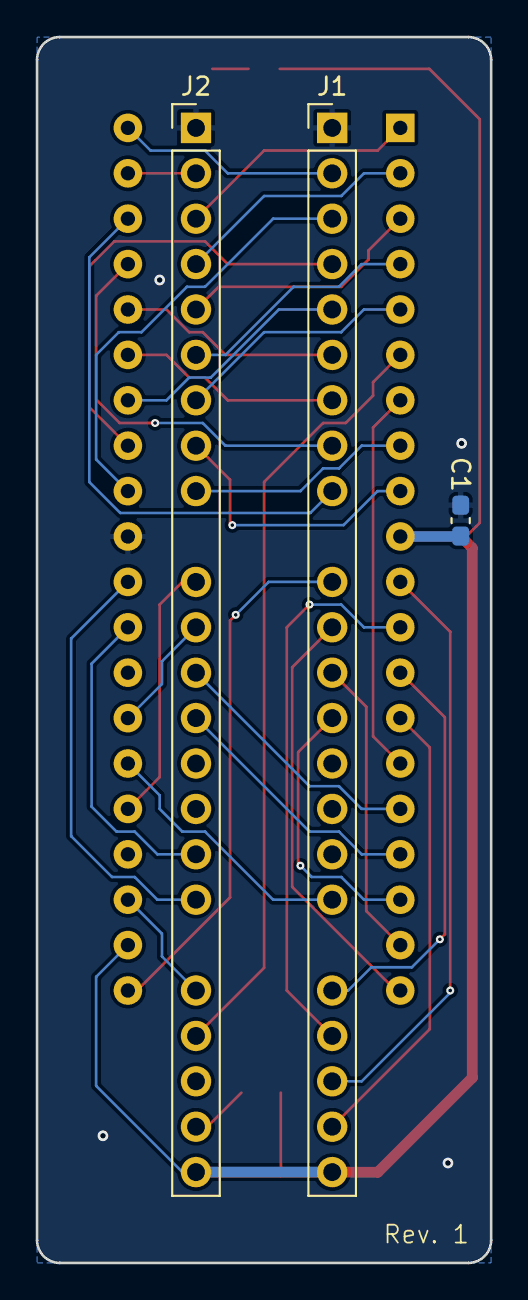
[picture p162: board bionic-z8002.kicad_pcb from below]

Board: 2 copper layers, 25.4 x 68.6 mm, 8 parts (3 on the bottom side), 38 nets.
