tgtakaoka/retro-bionic/schematics/mezzanine/mezzanine.kicad_pcb

## KiCad design schematics/mezzanine/mezzanine.kicad_pcb (2026-10-26)

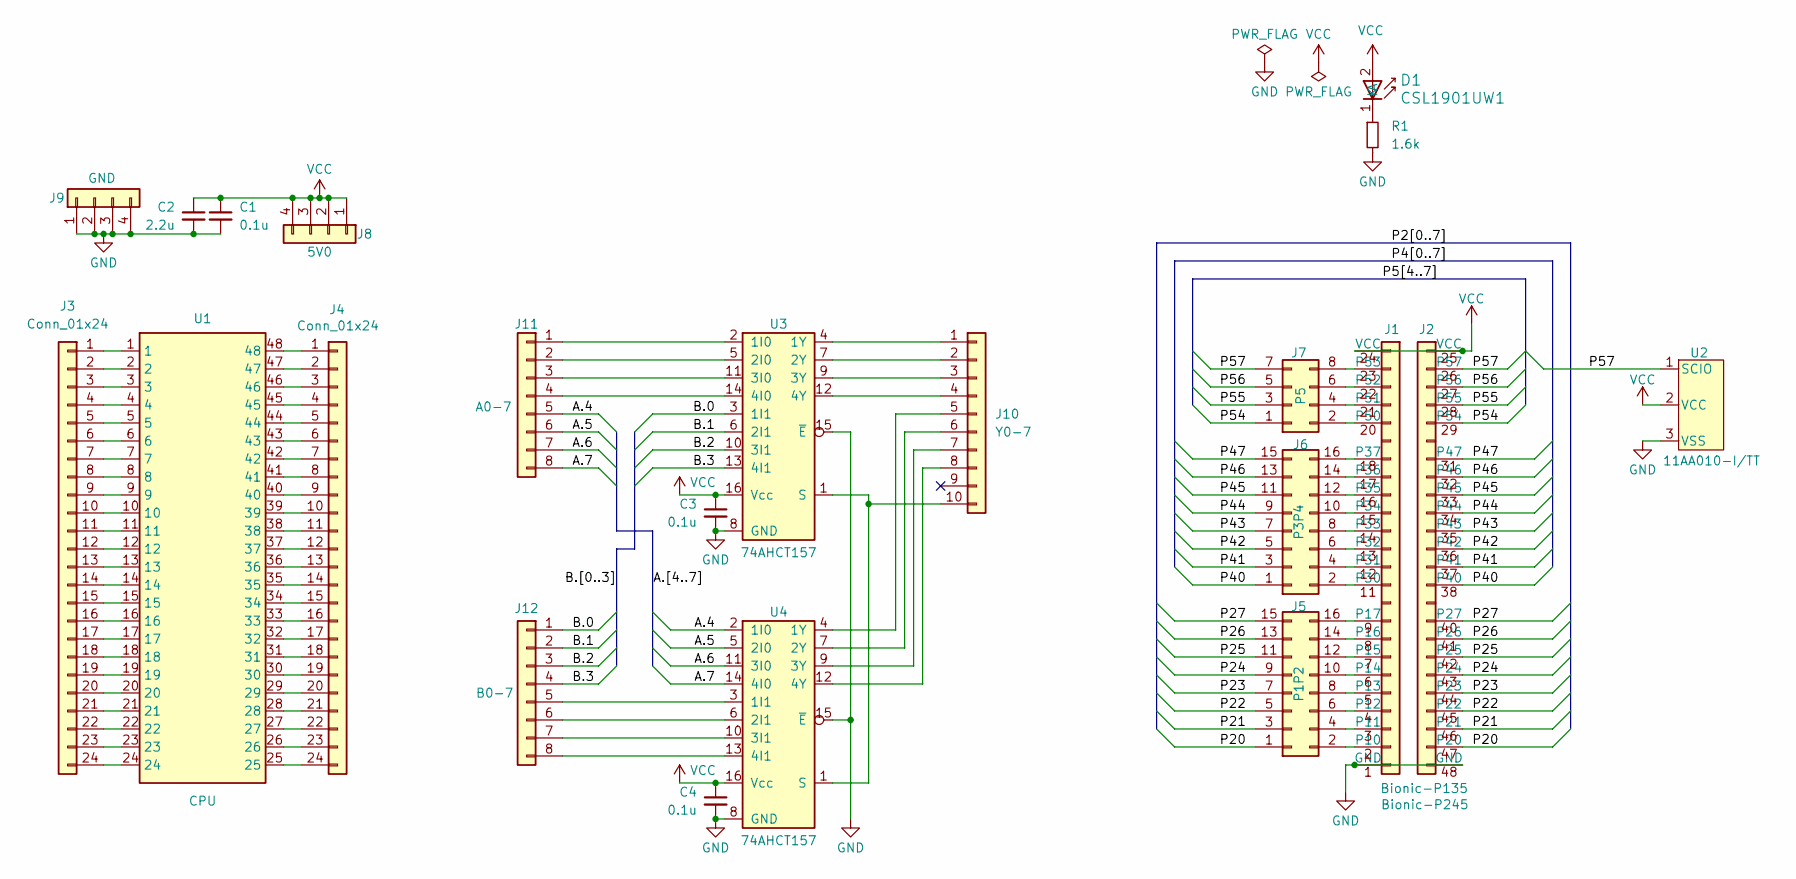
[picture p166: schematic mezzanine.kicad_sch, BIonicMezzanine]

Parts:
C1, C3, C4: 0.1u; C_0603_1608Metric_Pad1.08x0.95mm_HandSolder
C2: 2.2u; C_0603_1608Metric_Pad1.08x0.95mm_HandSolder
D1: CSL1901UW1; LED_CSL1901UW1_ROM-M
J1: Bionic-P135; Bionic-P135_THT
J2: Bionic-P245; Bionic-P245_THT
J3, J4: Conn_01x24; PinSocket_1x24_P2.54mm_Vertical
J5: P1P2; PinSocket_2x08_P2.54mm_Vertical
J6: P3P4; PinSocket_2x08_P2.54mm_Vertical
J7: P5; PinSocket_2x04_P2.54mm_Vertical
J8: 5V0; PinSocket_1x04_P2.54mm_Vertical
J9: GND; PinSocket_1x04_P2.54mm_Vertical
J10: Y0-7; PinSocket_1x10_P2.54mm_Vertical
J11: A0-7; PinSocket_1x08_P2.54mm_Vertical
J12: B0-7; PinSocket_1x08_P2.54mm_Vertical
R1: 1.6k; R_0603_1608Metric_Pad0.98x0.95mm_HandSolder
U1: CPU; Aries_ZIF_socket_DIP-48-pin
U2: 11AA010-I/TT; SOT-23_MC_MCH-M
U3, U4: 74AHCT157; PW16-M

Connections:
/A.4: J11.5, U4.2 (1I0)
/A.5: J11.6, U4.5 (2I0)
/A.6: J11.7, U4.11 (3I0)
/A.7: J11.8, U4.14 (4I0)
/B.0: J12.1, U3.3 (1I1)
/B.1: J12.2, U3.6 (2I1)
/B.2: J12.3, U3.10 (3I1)
/B.3: J12.4, U3.13 (4I1)
/P20: J2.47 (P20), J5.1
/P21: J2.46 (P21), J5.3
/P22: J2.45 (P22), J5.5
/P23: J2.44 (P23), J5.7
/P24: J2.43 (P24), J5.9
/P25: J2.42 (P25), J5.11
/P26: J2.41 (P26), J5.13
/P27: J2.40 (P27), J5.15
/P40: J2.38 (P40), J6.1
/P41: J2.37 (P41), J6.3
/P42: J2.36 (P42), J6.5
/P43: J2.35 (P43), J6.7
/P44: J2.34 (P44), J6.9
/P45: J2.33 (P45), J6.11
/P46: J2.32 (P46), J6.13
/P47: J2.31 (P47), J6.15
/P54: J2.29 (P54), J7.1
/P55: J2.28 (P55), J7.3
/P56: J2.27 (P56), J7.5
/P57: J2.26 (P57), J7.7, U2.1 (SCIO)
GND: C1.2, C2.2, C3.2, C4.2, J1.1 (GND), J2.48 (GND), J9.1, J9.2, J9.3, J9.4, R1.2, U2.3 (VSS), U3.8 (GND), U3.15 (~E), U4.8 (GND), U4.15 (~E)
unnamed: D1.1 (K), R1.1
unnamed: J1.2 (P10), J5.2
unnamed: J1.3 (P11), J5.4
unnamed: J1.4 (P12), J5.6
unnamed: J1.5 (P13), J5.8
unnamed: J1.6 (P14), J5.10
unnamed: J1.7 (P15), J5.12
unnamed: J1.8 (P16), J5.14
unnamed: J1.9 (P17), J5.16
unnamed: J1.11 (P30), J6.2
unnamed: J1.12 (P31), J6.4
unnamed: J1.13 (P32), J6.6
unnamed: J1.14 (P33), J6.8
unnamed: J1.15 (P34), J6.10
unnamed: J1.16 (P35), J6.12
unnamed: J1.17 (P36), J6.14
unnamed: J1.18 (P37), J6.16
unnamed: J1.20 (P50), J7.2
unnamed: J1.21 (P51), J7.4
unnamed: J1.22 (P52), J7.6
unnamed: J1.23 (P53), J7.8
unnamed: J3.1, U1.1
unnamed: J3.2, U1.2
unnamed: J3.3, U1.3
unnamed: J3.4, U1.4
unnamed: J3.5, U1.5
unnamed: J3.6, U1.6
unnamed: J3.7, U1.7
unnamed: J3.8, U1.8
unnamed: J3.9, U1.9
unnamed: J3.10, U1.10
unnamed: J3.11, U1.11
unnamed: J3.12, U1.12
unnamed: J3.13, U1.13
unnamed: J3.14, U1.14
unnamed: J3.15, U1.15
unnamed: J3.16, U1.16
unnamed: J3.17, U1.17
unnamed: J3.18, U1.18
unnamed: J3.19, U1.19
unnamed: J3.20, U1.20
unnamed: J3.21, U1.21
unnamed: J3.22, U1.22
unnamed: J3.23, U1.23
unnamed: J3.24, U1.24
unnamed: J4.1, U1.48
unnamed: J4.2, U1.47
unnamed: J4.3, U1.46
unnamed: J4.4, U1.45
unnamed: J4.5, U1.44
unnamed: J4.6, U1.43
unnamed: J4.7, U1.42
unnamed: J4.8, U1.41
unnamed: J4.9, U1.40
unnamed: J4.10, U1.39
unnamed: J4.11, U1.38
unnamed: J4.12, U1.37
unnamed: J4.13, U1.36
unnamed: J4.14, U1.35
unnamed: J4.15, U1.34
unnamed: J4.16, U1.33
unnamed: J4.17, U1.32
unnamed: J4.18, U1.31
unnamed: J4.19, U1.30
unnamed: J4.20, U1.29
unnamed: J4.21, U1.28
unnamed: J4.22, U1.27
unnamed: J4.23, U1.26
unnamed: J4.24, U1.25
unnamed: J10.1, U3.4 (1Y)
unnamed: J10.2, U3.7 (2Y)
unnamed: J10.3, U3.9 (3Y)
unnamed: J10.4, U3.12 (4Y)
unnamed: J10.5, U4.4 (1Y)
unnamed: J10.6, U4.7 (2Y)
unnamed: J10.7, U4.9 (3Y)
unnamed: J10.8, U4.12 (4Y)
unnamed: J10.10, U3.1 (S), U4.1 (S)
unnamed: J11.1, U3.2 (1I0)
unnamed: J11.2, U3.5 (2I0)
unnamed: J11.3, U3.11 (3I0)
unnamed: J11.4, U3.14 (4I0)
unnamed: J12.5, U4.3 (1I1)
unnamed: J12.6, U4.6 (2I1)
unnamed: J12.7, U4.10 (3I1)
unnamed: J12.8, U4.13 (4I1)
VCC: C1.1, C2.1, C3.1, C4.1, D1.2 (A), J1.24 (VCC), J2.25 (VCC), J8.1, J8.2, J8.3, J8.4, U2.2 (VCC), U3.16 (Vcc), U4.16 (Vcc)

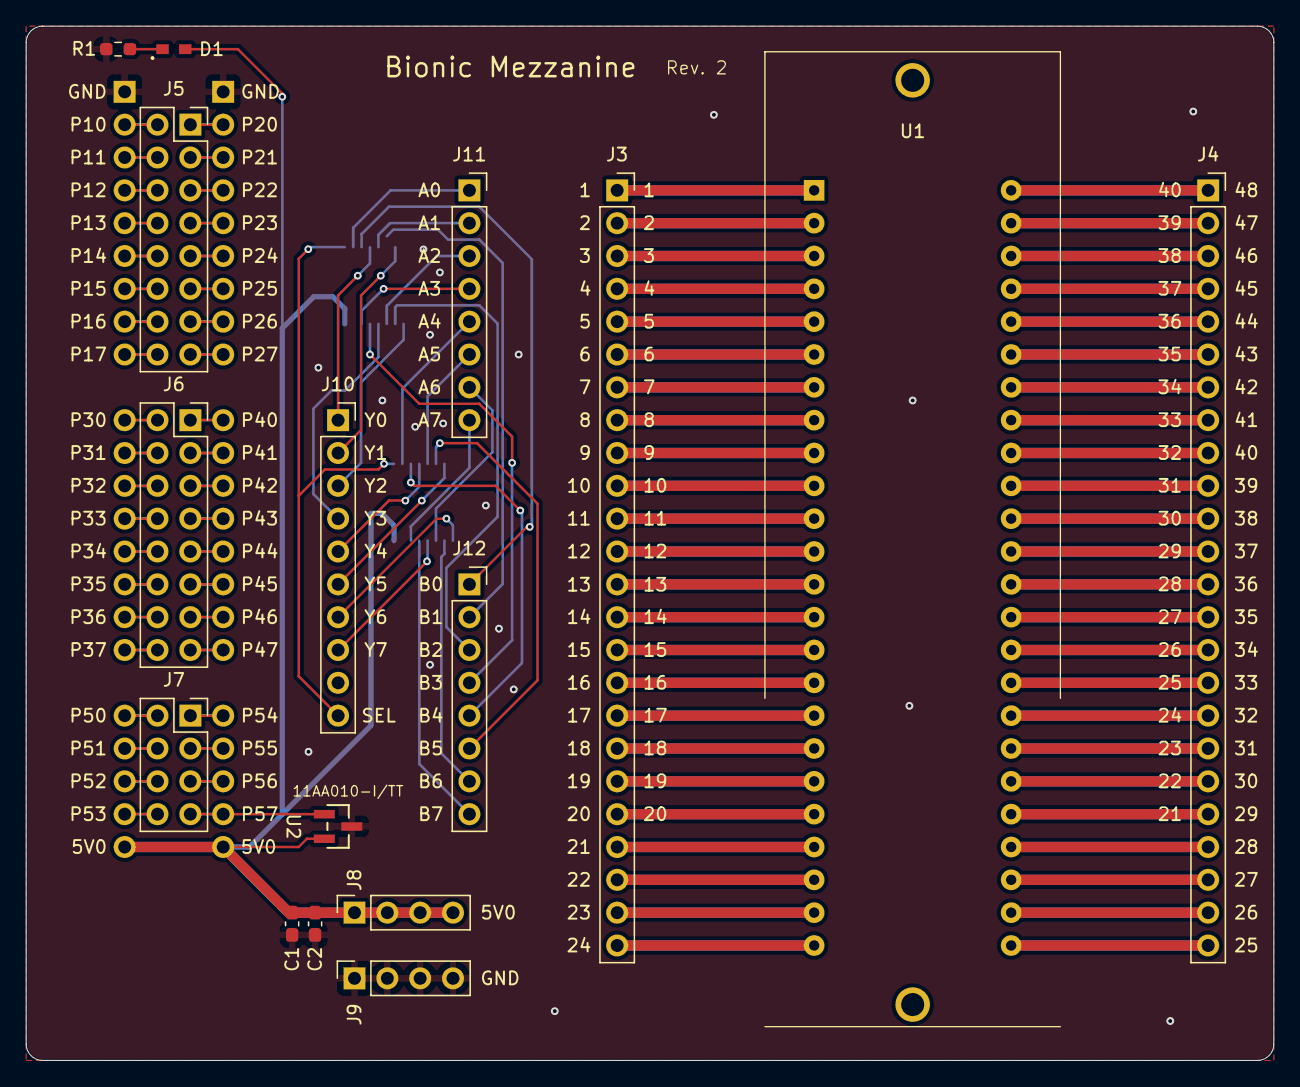
[picture p167: board mezzanine.kicad_pcb from above]

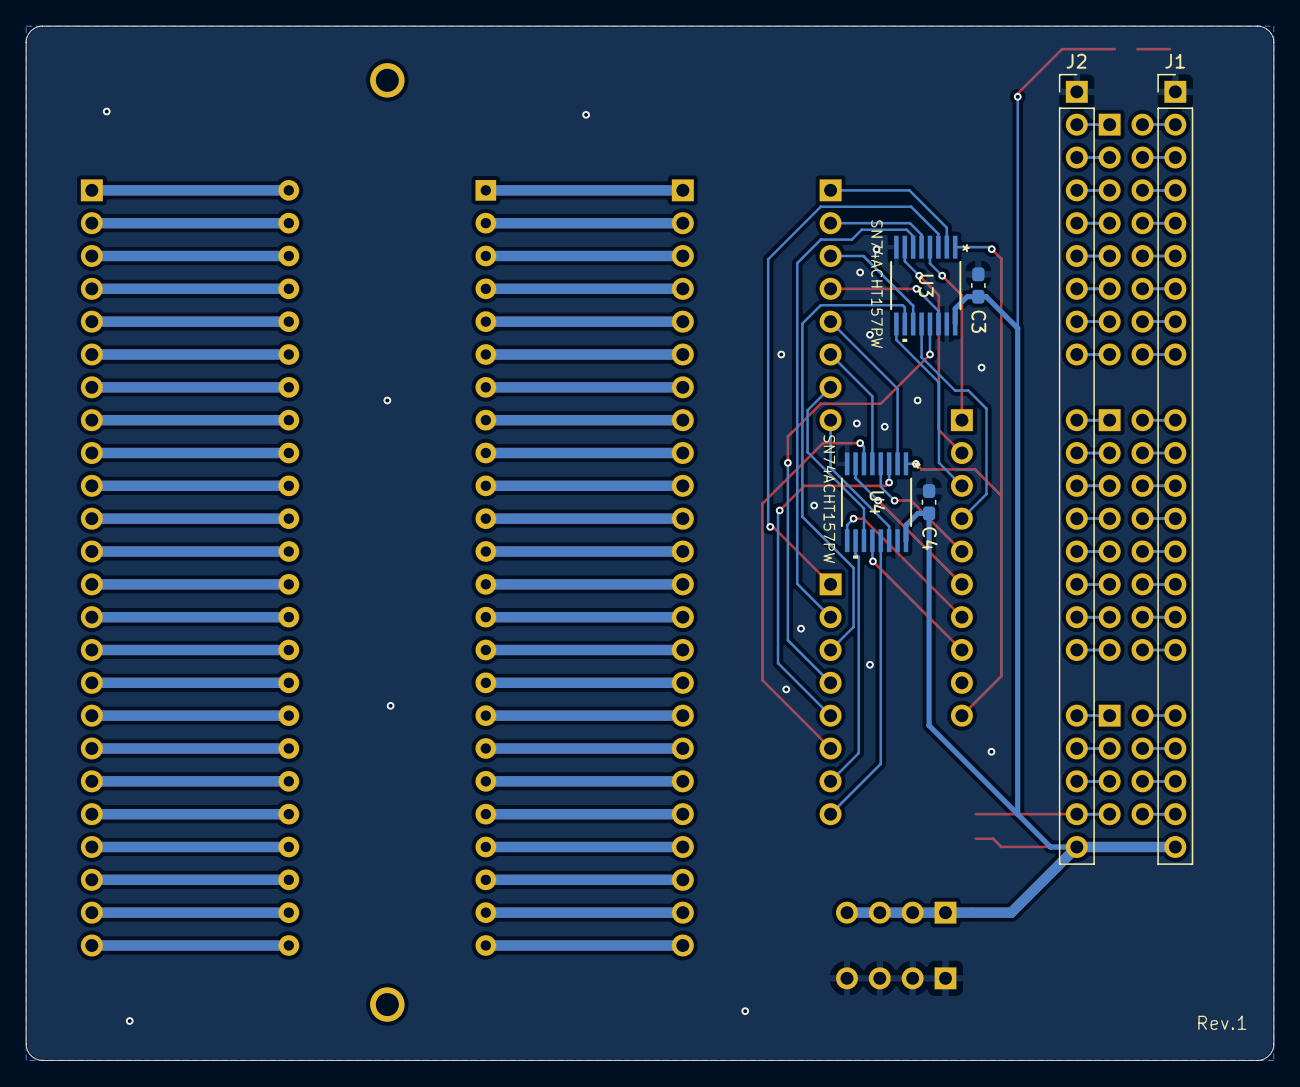
[picture p168: board mezzanine.kicad_pcb from below]

Board: 2 copper layers, 96.5 x 80.0 mm, 22 parts (6 on the bottom side), 116 nets.
