tgtakaoka/retro-bionic/schematics/z280/bionic-z280.kicad_pcb

## KiCad design schematics/z280/bionic-z280.kicad_pcb (2026-10-26)

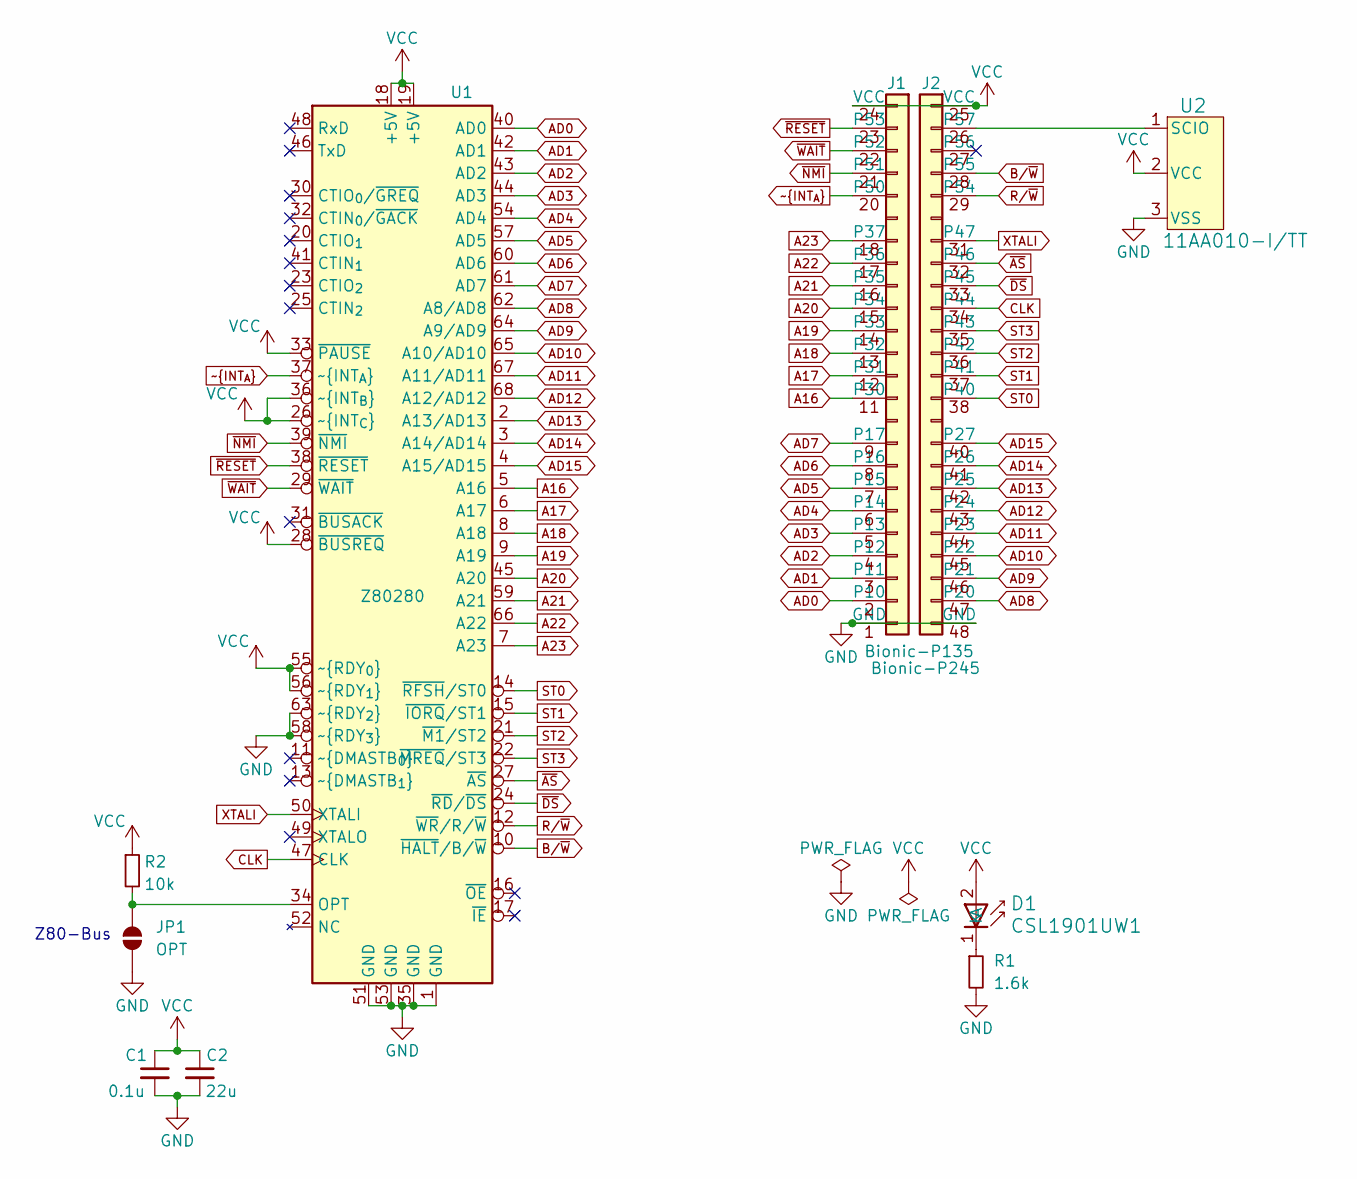
[picture p169: schematic bionic-z280.kicad_sch, BionicZ280]

Parts:
C1: 0.1u; C_0603_1608Metric_Pad1.08x0.95mm_HandSolder
C2: 22u; C_0603_1608Metric_Pad1.08x0.95mm_HandSolder
D1: CSL1901UW1; LED_CSL1901UW1_ROM-M
J1: Bionic-P135; Bionic-P135_SMT
J2: Bionic-P245; Bionic-P245_SMT
JP1: OPT; SolderJumper-2_P1.3mm_Open_TrianglePad1.0x1.5mm
R1: 1.6k; R_0603_1608Metric_Pad0.98x0.95mm_HandSolder
R2: 10k; R_0603_1608Metric_Pad0.98x0.95mm_HandSolder
U1: Z80280; 846821B1RKTP
U2: 11AA010-I/TT; SOT-23_MC_MCH-M

Connections:
A16: J1.11 (P30), U1.5 (A16)
A17: J1.12 (P31), U1.6 (A17)
A18: J1.13 (P32), U1.8 (A18)
A19: J1.14 (P33), U1.9 (A19)
A20: J1.15 (P34), U1.45 (A20)
A21: J1.16 (P35), U1.59 (A21)
A22: J1.17 (P36), U1.66 (A22)
A23: J1.18 (P37), U1.7 (A23)
AD0: J1.2 (P10), U1.40 (AD0)
AD1: J1.3 (P11), U1.42 (AD1)
AD2: J1.4 (P12), U1.43 (AD2)
AD3: J1.5 (P13), U1.44 (AD3)
AD4: J1.6 (P14), U1.54 (AD4)
AD5: J1.7 (P15), U1.57 (AD5)
AD6: J1.8 (P16), U1.60 (AD6)
AD7: J1.9 (P17), U1.61 (AD7)
AD8: J2.47 (P20), U1.62 (A8/AD8)
AD9: J2.46 (P21), U1.64 (A9/AD9)
AD10: J2.45 (P22), U1.65 (A10/AD10)
AD11: J2.44 (P23), U1.67 (A11/AD11)
AD12: J2.43 (P24), U1.68 (A12/AD12)
AD13: J2.42 (P25), U1.2 (A13/AD13)
AD14: J2.41 (P26), U1.3 (A14/AD14)
AD15: J2.40 (P27), U1.4 (A15/AD15)
B/~W: J2.28 (P55), U1.10 (~HALT/B/~W)
CLK: J2.34 (P44), U1.47 (CLK)
GND: C1.2, C2.2, J1.1 (GND), J2.48 (GND), JP1.1 (A), R1.2, U1.1 (GND), U1.35 (GND), U1.51 (GND), U1.53 (GND), U1.58 (~RDY_{3}), U1.63 (~RDY_{2}), U2.3 (VSS)
unnamed: D1.1 (K), R1.1
unnamed: J2.26 (P57), U2.1 (SCIO)
unnamed: JP1.2 (B), R2.2, U1.34 (OPT)
R/~W: J2.29 (P54), U1.12 (~WR/R/~W)
ST0: J2.38 (P40), U1.14 (~RFSH/ST0)
ST1: J2.37 (P41), U1.15 (~IORQ/ST1)
ST2: J2.36 (P42), U1.21 (~M1/ST2)
ST3: J2.35 (P43), U1.22 (~MREQ/ST3)
VCC: C1.1, C2.1, D1.2 (A), J1.24 (VCC), J2.25 (VCC), R2.1, U1.18 (+5V), U1.19 (+5V), U1.26 (~INT_{C}), U1.28 (~BUSREQ), U1.33 (~PAUSE), U1.36 (~INT_{B}), U1.55 (~RDY_{0}), U1.56 (~RDY_{1}), U2.2 (VCC)
XTALI: J2.31 (P47), U1.50 (XTALI)
~AS: J2.32 (P46), U1.27 (~AS)
~DS: J2.33 (P45), U1.24 (~RD/~DS)
~INT_{A}: J1.20 (P50), U1.37 (~INT_{A})
~NMI: J1.21 (P51), U1.39 (~NMI)
~RESET: J1.23 (P53), U1.38 (~RESET)
~WAIT: J1.22 (P52), U1.29 (~WAIT)

Notes on the sheet:
Z80-Bus

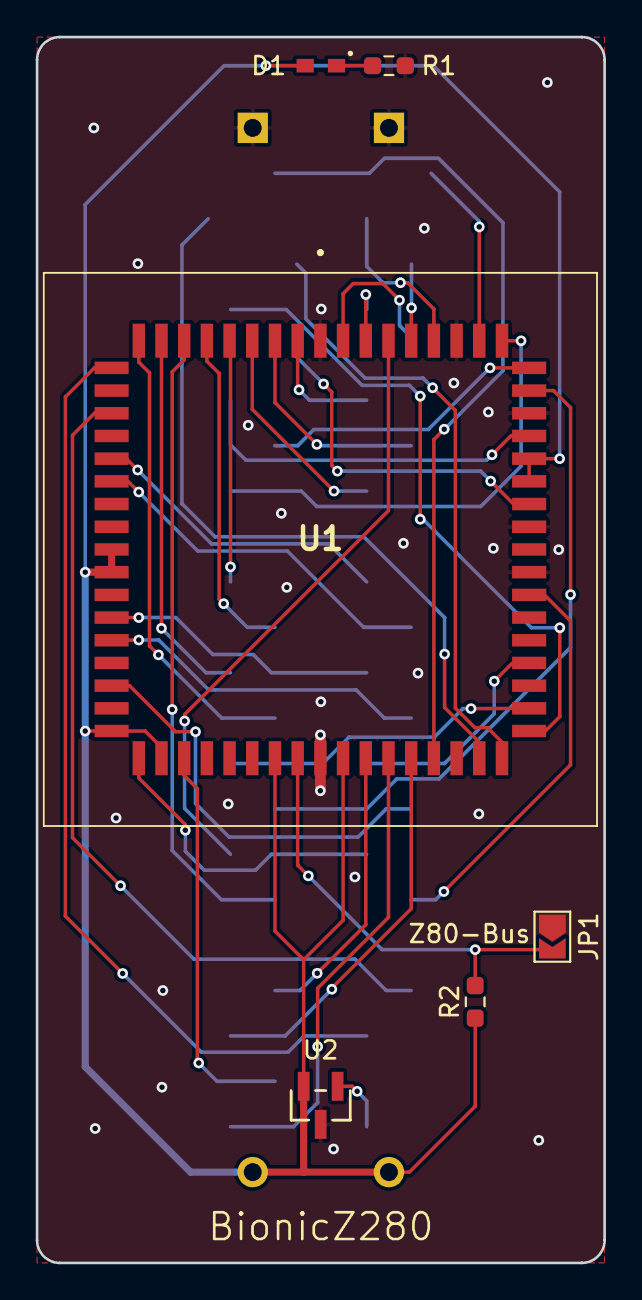
[picture p170: board bionic-z280.kicad_pcb from above]

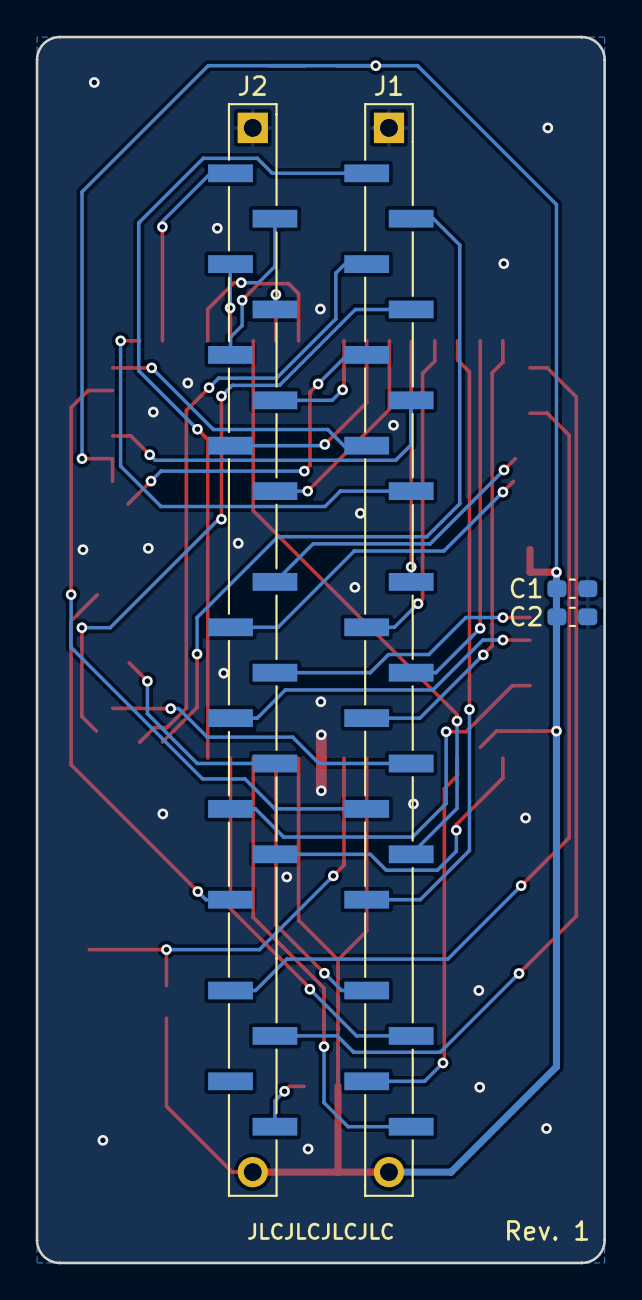
[picture p171: board bionic-z280.kicad_pcb from below]

Board: 2 copper layers, 31.7 x 68.6 mm, 10 parts (4 on the bottom side), 43 nets.
