tgtakaoka/retro-bionic/schematics/z380/bionic-z380.kicad_pcb

## KiCad design schematics/z380/bionic-z380.kicad_pcb (2026-10-26)

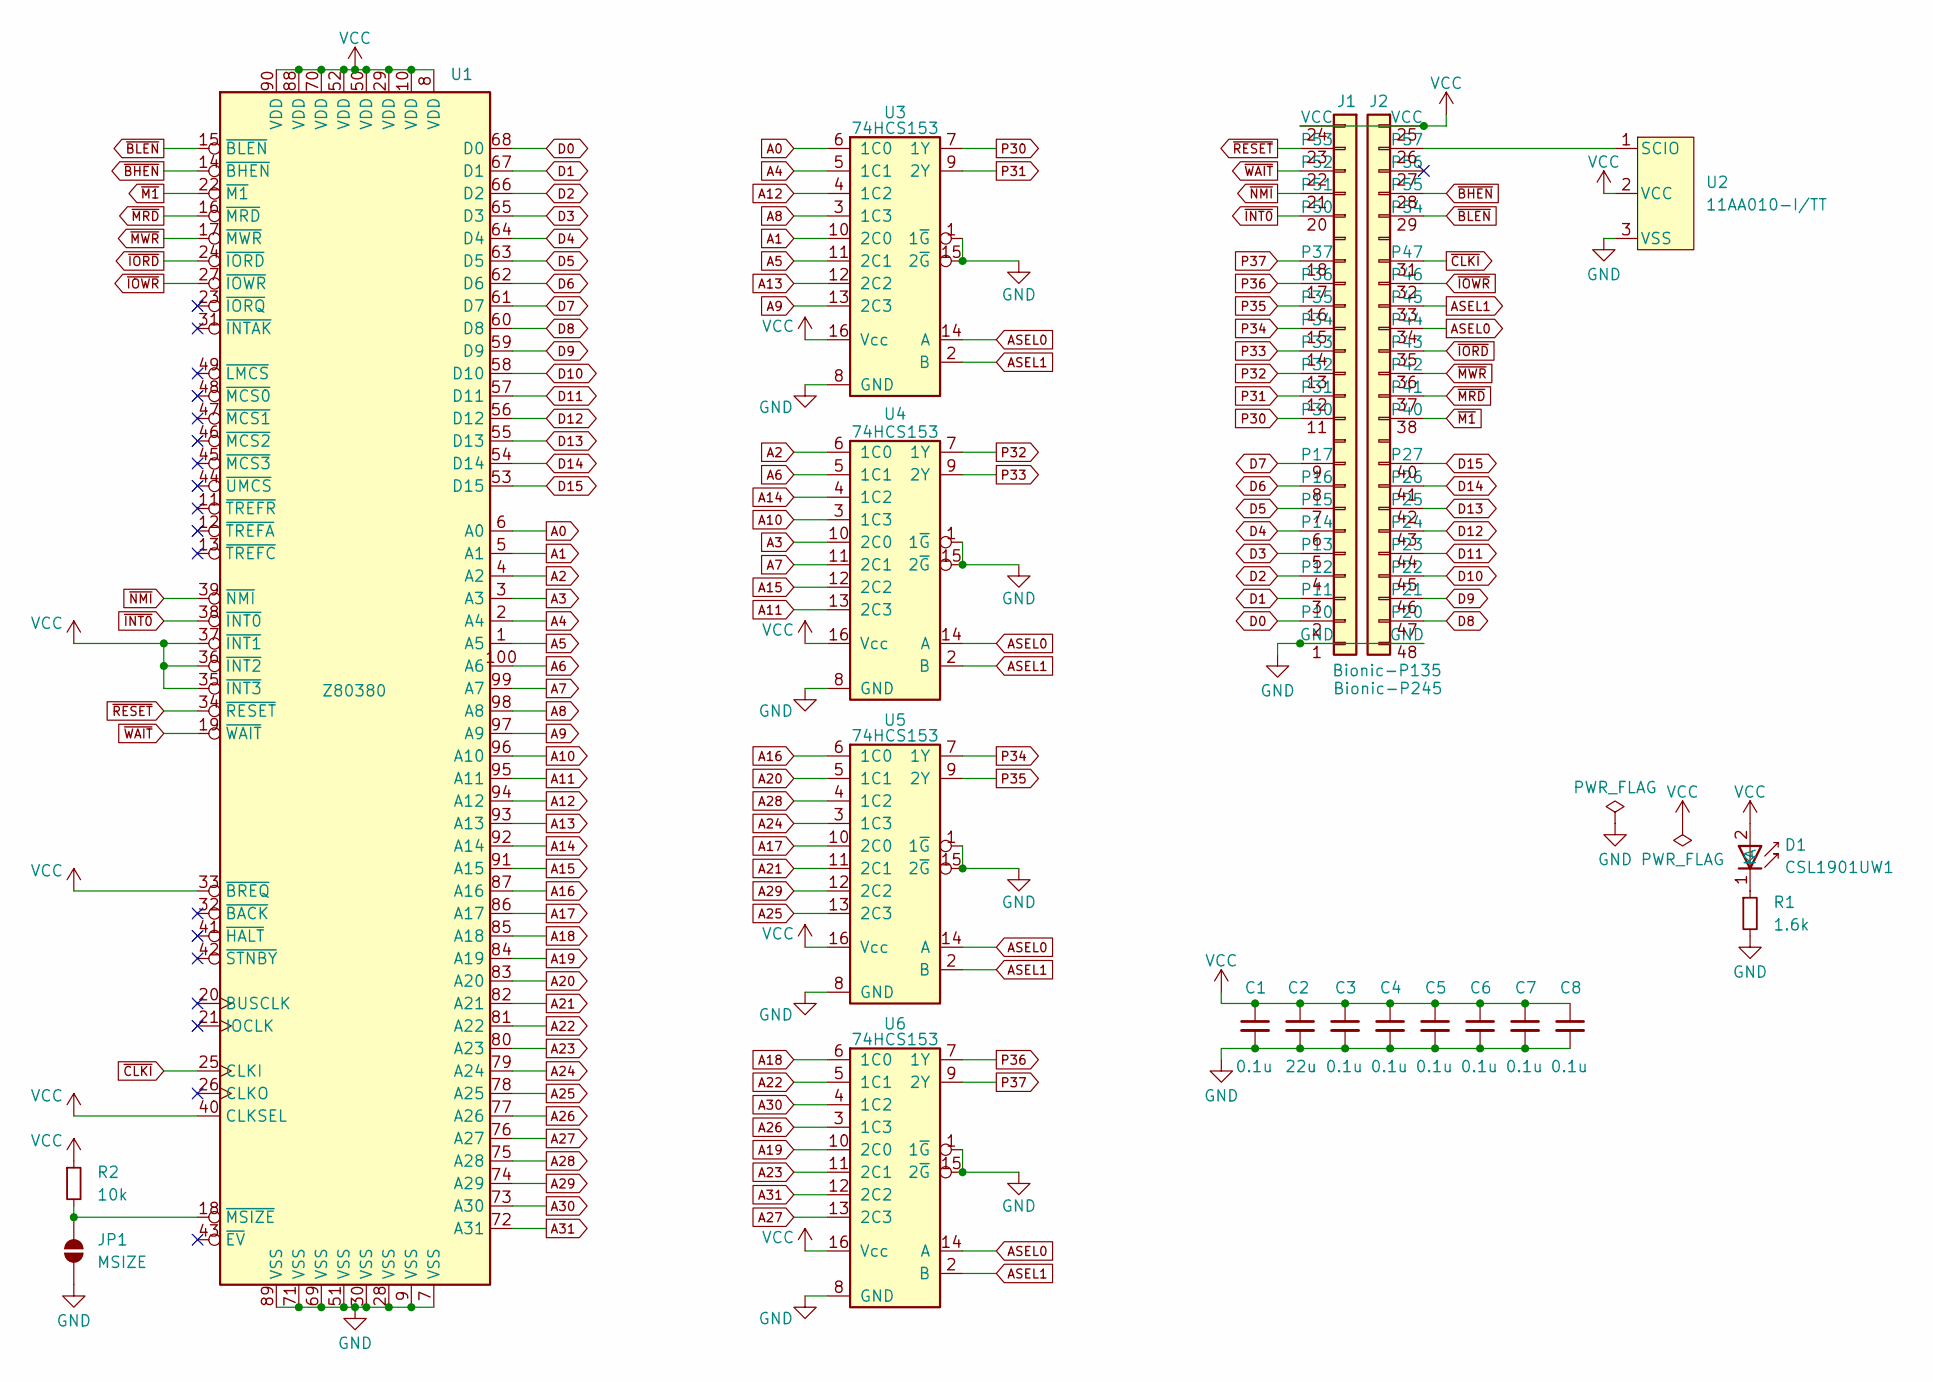
[picture p172: schematic bionic-z380.kicad_sch, BionicZ380]

Parts:
C1, C3, C4, C5, C6, C7, C8: 0.1u; C_0603_1608Metric_Pad1.08x0.95mm_HandSolder
C2: 22u; C_0603_1608Metric_Pad1.08x0.95mm_HandSolder
D1: CSL1901UW1; LED_CSL1901UW1_ROM-M
J1: Bionic-P135; Bionic-P135_SMT
J2: Bionic-P245; Bionic-P245_SMT
JP1: MSIZE; SolderJumper-2_P1.3mm_Open_TrianglePad1.0x1.5mm
R1: 1.6k; R_0603_1608Metric_Pad0.98x0.95mm_HandSolder
R2: 10k; R_0603_1608Metric_Pad0.98x0.95mm_HandSolder
U1: Z80380; PQFP-100_14x20mm_P0.65mm
U2: 11AA010-I/TT; SOT-23_MC_MCH-M
U3, U4, U5, U6: 74HCS153; PW16-M

Connections:
A0: U1.6 (A0), U3.6 (1C0)
A1: U1.5 (A1), U3.10 (2C0)
A2: U1.4 (A2), U4.6 (1C0)
A3: U1.3 (A3), U4.10 (2C0)
A4: U1.2 (A4), U3.5 (1C1)
A5: U1.1 (A5), U3.11 (2C1)
A6: U1.100 (A6), U4.5 (1C1)
A7: U1.99 (A7), U4.11 (2C1)
A8: U1.98 (A8), U3.3 (1C3)
A9: U1.97 (A9), U3.13 (2C3)
A10: U1.96 (A10), U4.3 (1C3)
A11: U1.95 (A11), U4.13 (2C3)
A12: U1.94 (A12), U3.4 (1C2)
A13: U1.93 (A13), U3.12 (2C2)
A14: U1.92 (A14), U4.4 (1C2)
A15: U1.91 (A15), U4.12 (2C2)
A16: U1.87 (A16), U5.6 (1C0)
A17: U1.86 (A17), U5.10 (2C0)
A18: U1.85 (A18), U6.6 (1C0)
A19: U1.84 (A19), U6.10 (2C0)
A20: U1.83 (A20), U5.5 (1C1)
A21: U1.82 (A21), U5.11 (2C1)
A22: U1.81 (A22), U6.5 (1C1)
A23: U1.80 (A23), U6.11 (2C1)
A24: U1.79 (A24), U5.3 (1C3)
A25: U1.78 (A25), U5.13 (2C3)
A26: U1.77 (A26), U6.3 (1C3)
A27: U1.76 (A27), U6.13 (2C3)
A28: U1.75 (A28), U5.4 (1C2)
A29: U1.74 (A29), U5.12 (2C2)
A30: U1.73 (A30), U6.4 (1C2)
A31: U1.72 (A31), U6.12 (2C2)
ASEL0: J2.34 (P44), U3.14 (A), U4.14 (A), U5.14 (A), U6.14 (A)
ASEL1: J2.33 (P45), U3.2 (B), U4.2 (B), U5.2 (B), U6.2 (B)
D0: J1.2 (P10), U1.68 (D0)
D1: J1.3 (P11), U1.67 (D1)
D2: J1.4 (P12), U1.66 (D2)
D3: J1.5 (P13), U1.65 (D3)
D4: J1.6 (P14), U1.64 (D4)
D5: J1.7 (P15), U1.63 (D5)
D6: J1.8 (P16), U1.62 (D6)
D7: J1.9 (P17), U1.61 (D7)
D8: J2.47 (P20), U1.60 (D8)
D9: J2.46 (P21), U1.59 (D9)
D10: J2.45 (P22), U1.58 (D10)
D11: J2.44 (P23), U1.57 (D11)
D12: J2.43 (P24), U1.56 (D12)
D13: J2.42 (P25), U1.55 (D13)
D14: J2.41 (P26), U1.54 (D14)
D15: J2.40 (P27), U1.53 (D15)
GND: C1.2, C2.2, C3.2, C4.2, C5.2, C6.2, C7.2, C8.2, J1.1 (GND), J2.48 (GND), JP1.1 (A), R1.2, U1.7 (VSS), U1.9 (VSS), U1.28 (VSS), U1.30 (VSS), U1.51 (VSS), U1.69 (VSS), U1.71 (VSS), U1.89 (VSS), U2.3 (VSS), U3.1 (1~G), U3.8 (GND), U3.15 (2~G), U4.1 (1~G), U4.8 (GND), U4.15 (2~G), U5.1 (1~G), U5.8 (GND), U5.15 (2~G), U6.1 (1~G), U6.8 (GND), U6.15 (2~G)
unnamed: D1.1 (K), R1.1
unnamed: J2.26 (P57), U2.1 (SCIO)
unnamed: JP1.2 (B), R2.2, U1.18 (~MSIZE)
P30: J1.11 (P30), U3.7 (1Y)
P31: J1.12 (P31), U3.9 (2Y)
P32: J1.13 (P32), U4.7 (1Y)
P33: J1.14 (P33), U4.9 (2Y)
P34: J1.15 (P34), U5.7 (1Y)
P35: J1.16 (P35), U5.9 (2Y)
P36: J1.17 (P36), U6.7 (1Y)
P37: J1.18 (P37), U6.9 (2Y)
VCC: C1.1, C2.1, C3.1, C4.1, C5.1, C6.1, C7.1, C8.1, D1.2 (A), J1.24 (VCC), J2.25 (VCC), R2.1, U1.8 (VDD), U1.10 (VDD), U1.29 (VDD), U1.33 (~BREQ), U1.35 (~INT3), U1.36 (~INT2), U1.37 (~INT1), U1.40 (CLKSEL), U1.50 (VDD), U1.52 (VDD), U1.70 (VDD), U1.88 (VDD), U1.90 (VDD), U2.2 (VCC), U3.16 (Vcc), U4.16 (Vcc), U5.16 (Vcc), U6.16 (Vcc)
~BHEN: J2.28 (P55), U1.14 (~BHEN)
~BLEN: J2.29 (P54), U1.15 (~BLEN)
~CLKI: J2.31 (P47), U1.25 (CLKI)
~INT0: J1.20 (P50), U1.38 (~INT0)
~IORD: J2.35 (P43), U1.24 (~IORD)
~IOWR: J2.32 (P46), U1.27 (~IOWR)
~M1: J2.38 (P40), U1.22 (~M1)
~MRD: J2.37 (P41), U1.16 (~MRD)
~MWR: J2.36 (P42), U1.17 (~MWR)
~NMI: J1.21 (P51), U1.39 (~NMI)
~RESET: J1.23 (P53), U1.34 (~RESET)
~WAIT: J1.22 (P52), U1.19 (~WAIT)

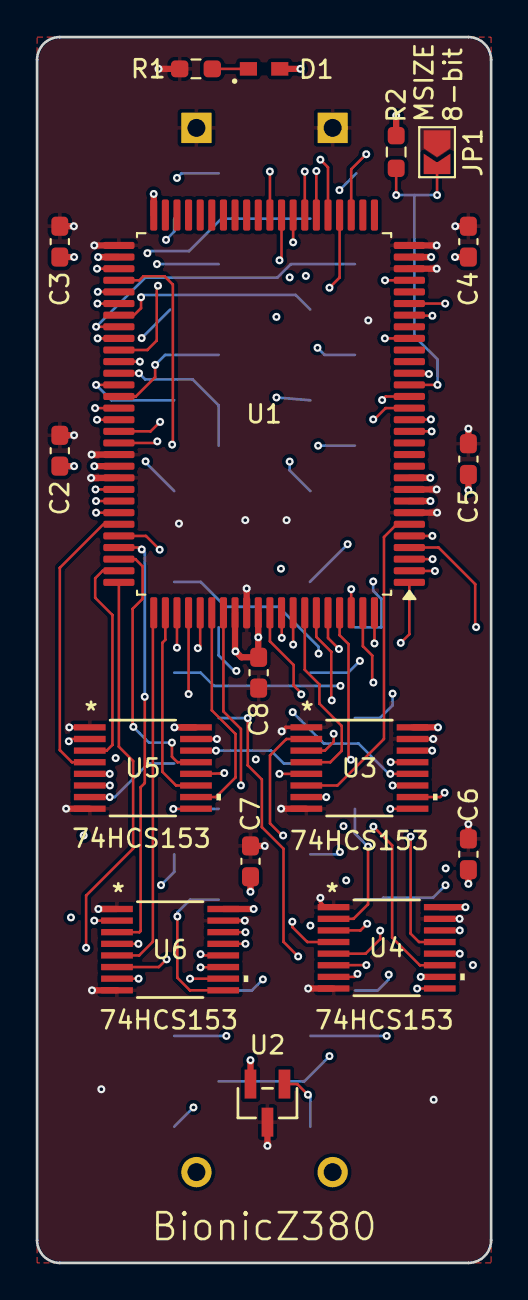
[picture p173: board bionic-z380.kicad_pcb from above]

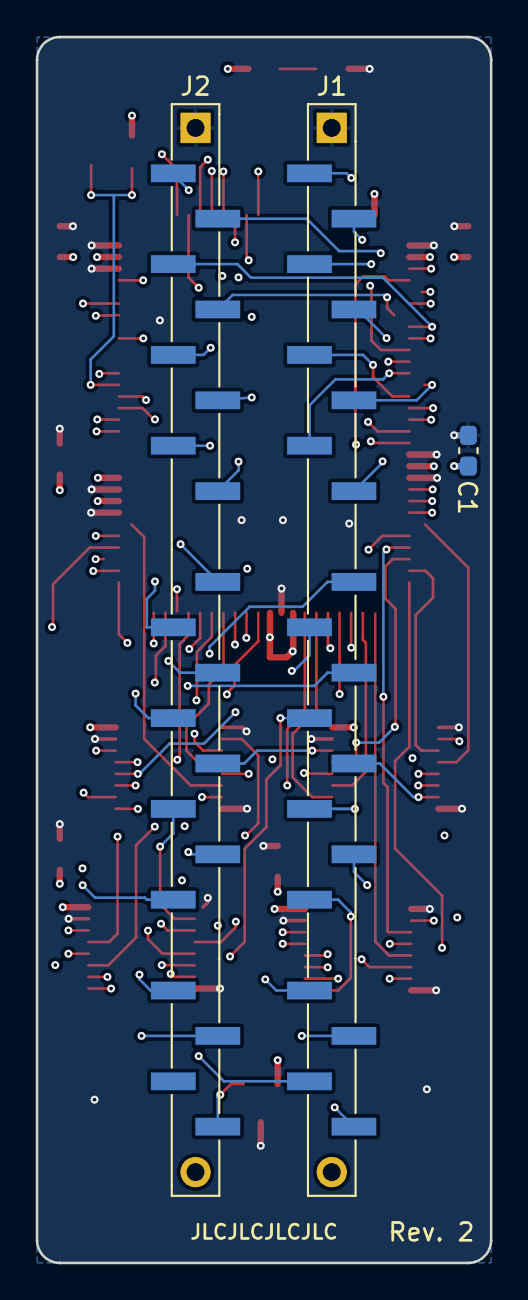
[picture p174: board bionic-z380.kicad_pcb from below]

Board: 4 copper layers, 25.4 x 68.6 mm, 20 parts (3 on the bottom side), 75 nets.
