tgtakaoka/retro-bionic/schematics/n8097/bionic-n8097.kicad_pcb

## KiCad design schematics/n8097/bionic-n8097.kicad_pcb (2026-10-26)

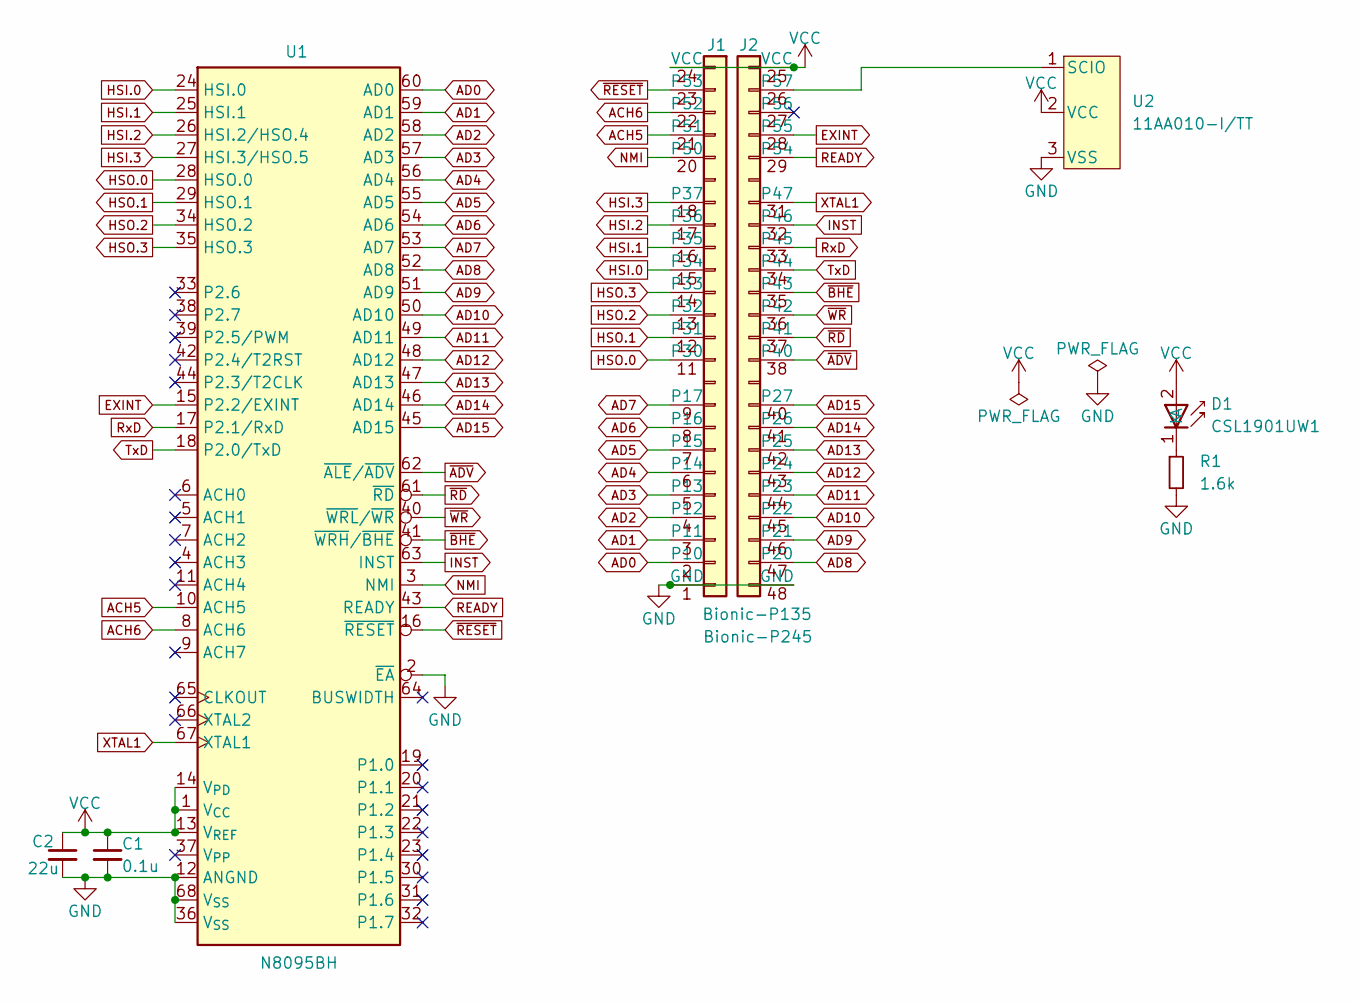
[picture p175: schematic bionic-n8097.kicad_sch, BionicN8097]

Parts:
C1: 0.1u; C_0603_1608Metric_Pad1.08x0.95mm_HandSolder
C2: 22u; C_0603_1608Metric_Pad1.08x0.95mm_HandSolder
D1: CSL1901UW1; LED_CSL1901UW1_ROM-M
J1: Bionic-P135; Bionic-P135_SMT
J2: Bionic-P245; Bionic-P245_SMT
R1: 1.6k; R_0603_1608Metric_Pad0.98x0.95mm_HandSolder
U1: N8095BH; 846821B1RKTP
U2: 11AA010-I/TT; SOT-23_MC_MCH-M

Connections:
ACH5: J1.21 (P51), U1.10 (ACH5)
ACH6: J1.22 (P52), U1.8 (ACH6)
AD0: J1.2 (P10), U1.60 (AD0)
AD1: J1.3 (P11), U1.59 (AD1)
AD2: J1.4 (P12), U1.58 (AD2)
AD3: J1.5 (P13), U1.57 (AD3)
AD4: J1.6 (P14), U1.56 (AD4)
AD5: J1.7 (P15), U1.55 (AD5)
AD6: J1.8 (P16), U1.54 (AD6)
AD7: J1.9 (P17), U1.53 (AD7)
AD8: J2.47 (P20), U1.52 (AD8)
AD9: J2.46 (P21), U1.51 (AD9)
AD10: J2.45 (P22), U1.50 (AD10)
AD11: J2.44 (P23), U1.49 (AD11)
AD12: J2.43 (P24), U1.48 (AD12)
AD13: J2.42 (P25), U1.47 (AD13)
AD14: J2.41 (P26), U1.46 (AD14)
AD15: J2.40 (P27), U1.45 (AD15)
EXINT: J2.28 (P55), U1.15 (P2.2/EXINT)
GND: C1.2, C2.2, J1.1 (GND), J2.48 (GND), R1.2, U1.2 (~EA), U1.12 (ANGND), U1.36 (V_{SS}), U1.68 (V_{SS}), U2.3 (VSS)
HSI.0: J1.15 (P34), U1.24 (HSI.0)
HSI.1: J1.16 (P35), U1.25 (HSI.1)
HSI.2: J1.17 (P36), U1.26 (HSI.2/HSO.4)
HSI.3: J1.18 (P37), U1.27 (HSI.3/HSO.5)
HSO.0: J1.11 (P30), U1.28 (HSO.0)
HSO.1: J1.12 (P31), U1.29 (HSO.1)
HSO.2: J1.13 (P32), U1.34 (HSO.2)
HSO.3: J1.14 (P33), U1.35 (HSO.3)
INST: J2.32 (P46), U1.63 (INST)
NMI: J1.20 (P50), U1.3 (NMI)
unnamed: D1.1 (K), R1.1
unnamed: J2.26 (P57), U2.1 (SCIO)
READY: J2.29 (P54), U1.43 (READY)
RxD: J2.33 (P45), U1.17 (P2.1/RxD)
TxD: J2.34 (P44), U1.18 (P2.0/TxD)
VCC: C1.1, C2.1, D1.2 (A), J1.24 (VCC), J2.25 (VCC), U1.1 (V_{CC}), U1.13 (V_{REF}), U1.14 (V_{PD}), U2.2 (VCC)
XTAL1: J2.31 (P47), U1.67 (XTAL1)
~ADV: J2.38 (P40), U1.62 (~ALE/~ADV)
~BHE: J2.35 (P43), U1.41 (~WRH/~BHE)
~RD: J2.37 (P41), U1.61 (~RD)
~RESET: J1.23 (P53), U1.16 (~RESET)
~WR: J2.36 (P42), U1.40 (~WRL/~WR)

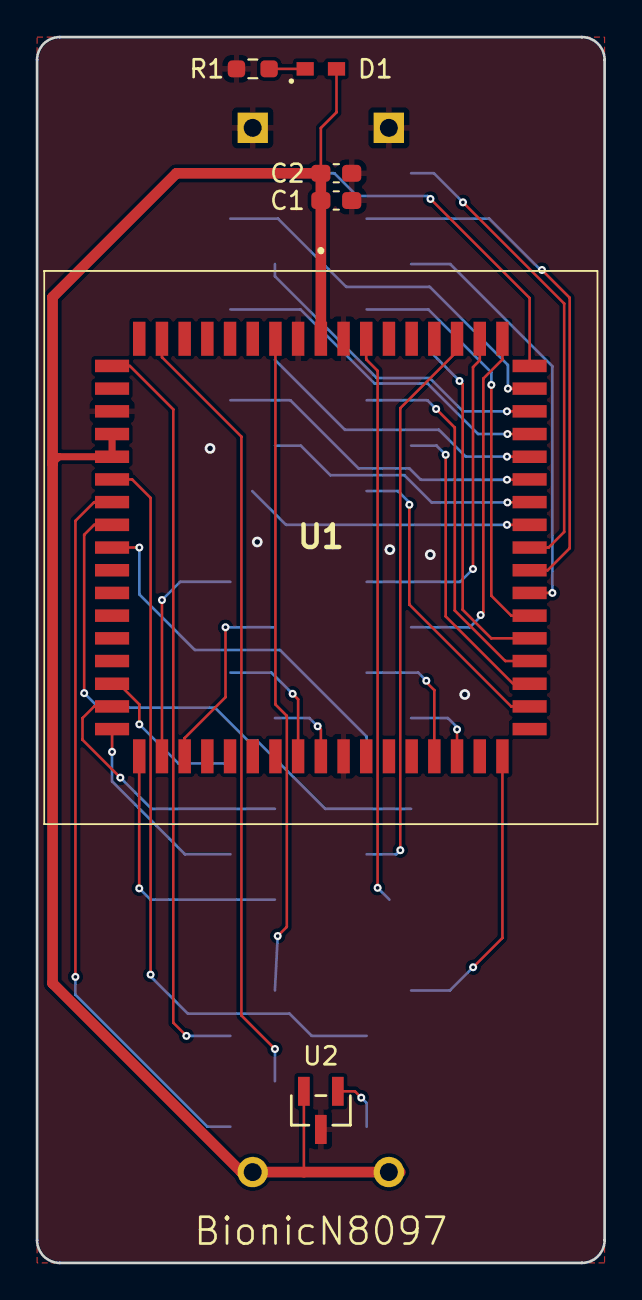
[picture p176: board bionic-n8097.kicad_pcb from above]

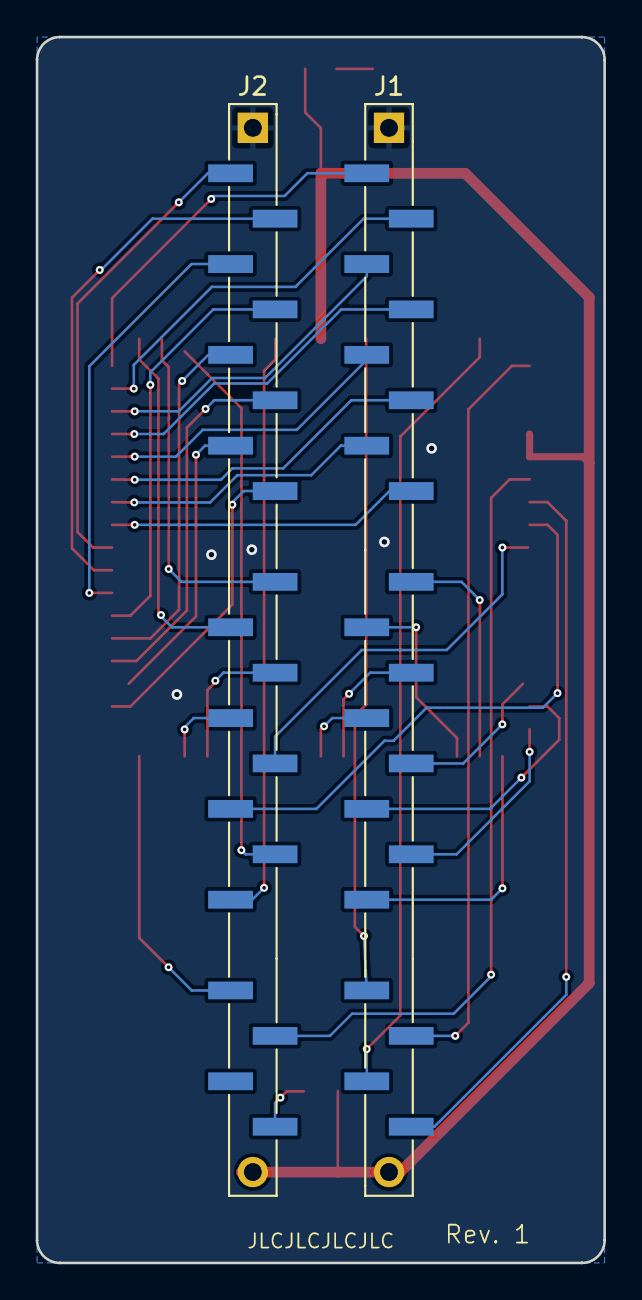
[picture p177: board bionic-n8097.kicad_pcb from below]

Board: 2 copper layers, 31.8 x 68.6 mm, 8 parts (2 on the bottom side), 42 nets.
