tgtakaoka/retro-bionic/schematics/tms9980/bionic-tms9980.kicad_pcb

## KiCad design schematics/tms9980/bionic-tms9980.kicad_pcb (2026-10-26)

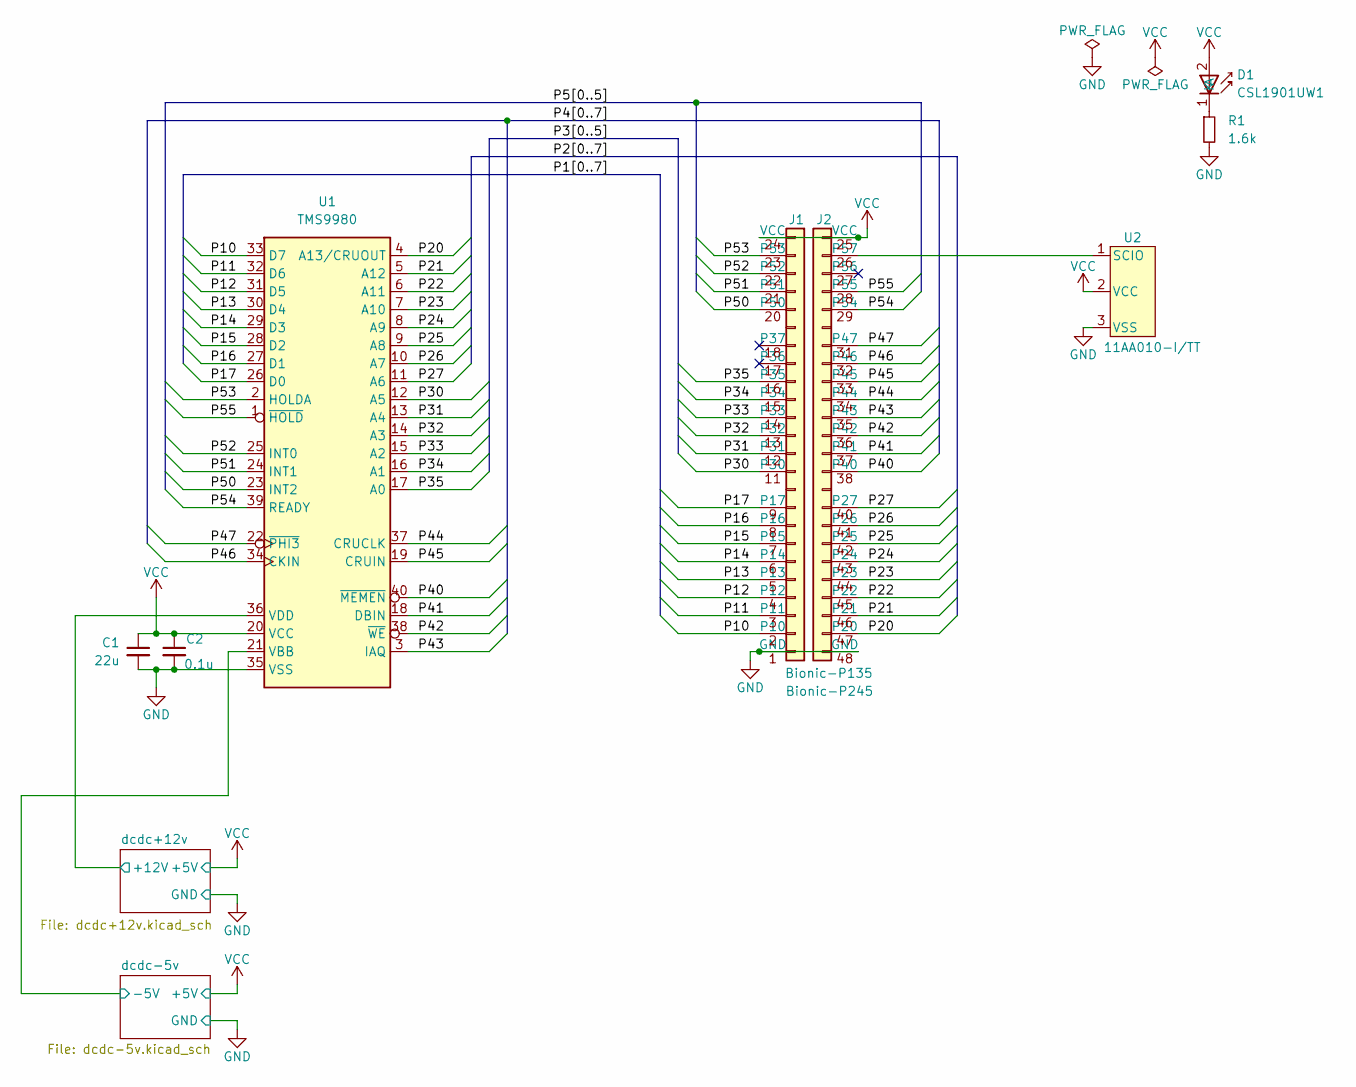
[picture p178: schematic bionic-tms9980.kicad_sch, BionicTMS9980]

Parts:
C1: 22u; C_0603_1608Metric_Pad1.08x0.95mm_HandSolder
C2: 0.1u; C_0603_1608Metric_Pad1.08x0.95mm_HandSolder
D1: CSL1901UW1; LED_CSL1901UW1_ROM-M
J1: Bionic-P135; Bionic-P135_THT
J2: Bionic-P245; Bionic-P245_THT
R1: 1.6k; R_0603_1608Metric_Pad0.98x0.95mm_HandSolder
U1: TMS9980; DIP-40_W15.24mm_Socket
U2: 11AA010-I/TT; SOT-23_MC_MCH-M

Connections:
/P10: J1.2 (P10), U1.33 (D7)
/P11: J1.3 (P11), U1.32 (D6)
/P12: J1.4 (P12), U1.31 (D5)
/P13: J1.5 (P13), U1.30 (D4)
/P14: J1.6 (P14), U1.29 (D3)
/P15: J1.7 (P15), U1.28 (D2)
/P16: J1.8 (P16), U1.27 (D1)
/P17: J1.9 (P17), U1.26 (D0)
/P20: J2.47 (P20), U1.4 (A13/CRUOUT)
/P21: J2.46 (P21), U1.5 (A12)
/P22: J2.45 (P22), U1.6 (A11)
/P23: J2.44 (P23), U1.7 (A10)
/P24: J2.43 (P24), U1.8 (A9)
/P25: J2.42 (P25), U1.9 (A8)
/P26: J2.41 (P26), U1.10 (A7)
/P27: J2.40 (P27), U1.11 (A6)
/P30: J1.11 (P30), U1.12 (A5)
/P31: J1.12 (P31), U1.13 (A4)
/P32: J1.13 (P32), U1.14 (A3)
/P33: J1.14 (P33), U1.15 (A2)
/P34: J1.15 (P34), U1.16 (A1)
/P35: J1.16 (P35), U1.17 (A0)
/P40: J2.38 (P40), U1.40 (~MEMEN)
/P41: J2.37 (P41), U1.18 (DBIN)
/P42: J2.36 (P42), U1.38 (~WE)
/P43: J2.35 (P43), U1.3 (IAQ)
/P44: J2.34 (P44), U1.37 (CRUCLK)
/P45: J2.33 (P45), U1.19 (CRUIN)
/P46: J2.32 (P46), U1.34 (CKIN)
/P47: J2.31 (P47), U1.22 (~PHI3)
/P50: J1.20 (P50), U1.23 (INT2)
/P51: J1.21 (P51), U1.24 (INT1)
/P52: J1.22 (P52), U1.25 (INT0)
/P53: J1.23 (P53), U1.2 (HOLDA)
/P54: J2.29 (P54), U1.39 (READY)
/P55: J2.28 (P55), U1.1 (~HOLD)
/dcdc+12v/+12V: U1.36 (VDD); also elsewhere on the board
/dcdc-5v/-5V: U1.21 (VBB); also elsewhere on the board
GND: C1.2, C2.2, J1.1 (GND), J2.48 (GND), R1.2, U1.35 (VSS), U2.3 (VSS); also elsewhere on the board
unnamed: D1.1 (K), R1.1
unnamed: J2.26 (P57), U2.1 (SCIO)
VCC: C1.1, C2.1, D1.2 (A), J1.24 (VCC), J2.25 (VCC), U1.20 (VCC), U2.2 (VCC); also elsewhere on the board


Parts:
C6, C7, C8: 1u/50V; C_0603_1608Metric_Pad1.08x0.95mm_HandSolder
D3: 30V/1A; CR_60M-60_ROM-M
U4: NJW4191; MSOP8VSP8_PI-VSP8-E-B_NMD-M

Connections:
/dcdc-5v/-5V: C8.1, D3.2 (A), U4.1 (FB), U4.5 (Vout); also elsewhere on the board
GND: C6.2, C8.2, D3.1 (K), U4.3 (GND), U4.7 (CLK); also elsewhere on the board
unnamed: C7.1, U4.2 (C+)
unnamed: C7.2, U4.4 (C+)
VCC: C6.1, U4.6 (ON), U4.8 (V+); also elsewhere on the board

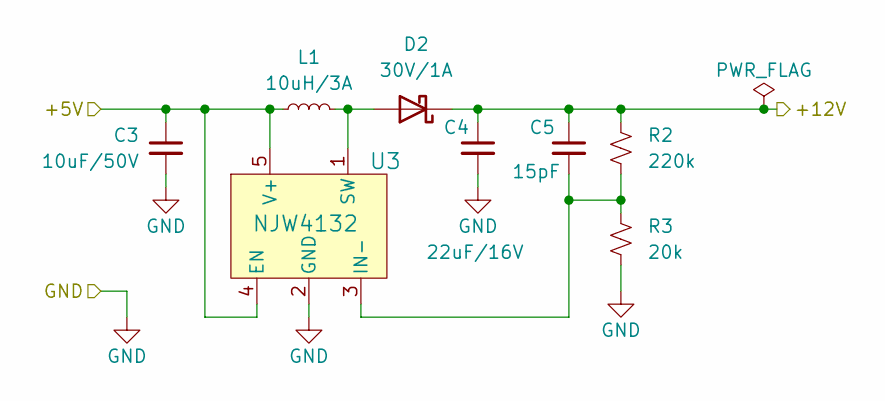
[picture p179: schematic dcdc+12v.kicad_sch]

Parts:
C3: 10uF/50V; C_0603_1608Metric_Pad1.08x0.95mm_HandSolder
C4: 22uF/16V; C_0603_1608Metric_Pad1.08x0.95mm_HandSolder
C5: 15pF; C_0603_1608Metric_Pad1.08x0.95mm_HandSolder
D2: 30V/1A; CR_60M-60_ROM-M
L1: 10uH/3A; IND_DFE322512F_MUR-M
R2: 220k; R_0603_1608Metric_Pad0.98x0.95mm_HandSolder
R3: 20k; R_0603_1608Metric_Pad0.98x0.95mm_HandSolder
U3: NJW4132; SOT-89-5_NMD-M

Connections:
/dcdc+12v/+12V: C4.1, C5.1, D2.1 (K), R2.1; also elsewhere on the board
GND: C3.2, C4.2, R3.2, U3.2 (GND); also elsewhere on the board
unnamed: D2.2 (A), L1.2, U3.1 (SW)
unnamed: C5.2, R2.2, R3.1, U3.3 (IN-)
VCC: C3.1, L1.1, U3.4 (EN), U3.5 (V+); also elsewhere on the board

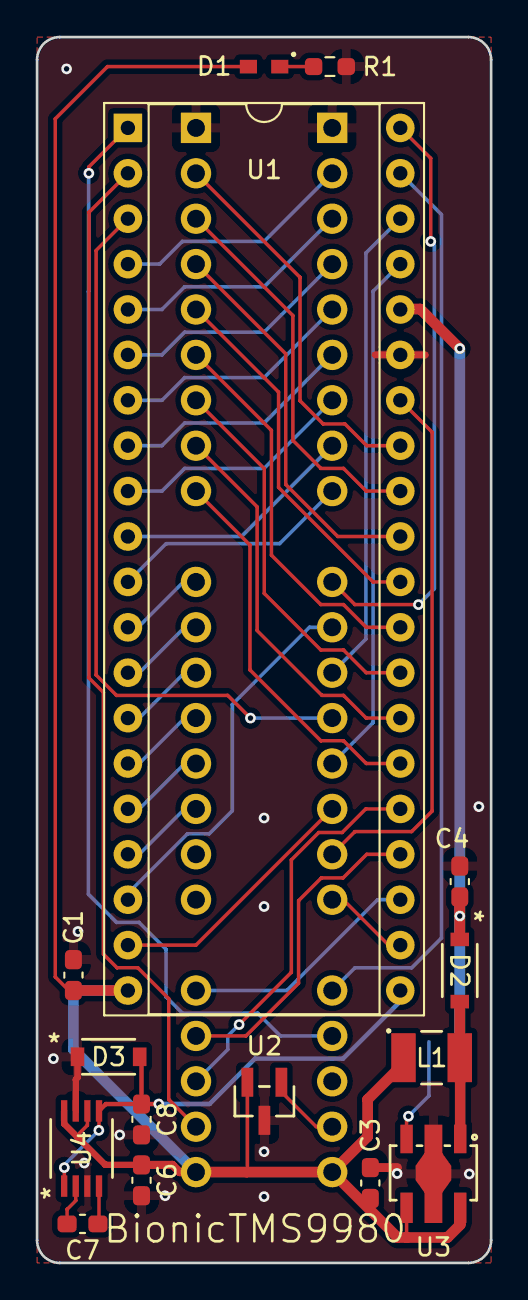
[picture p180: board bionic-tms9980.kicad_pcb from above]

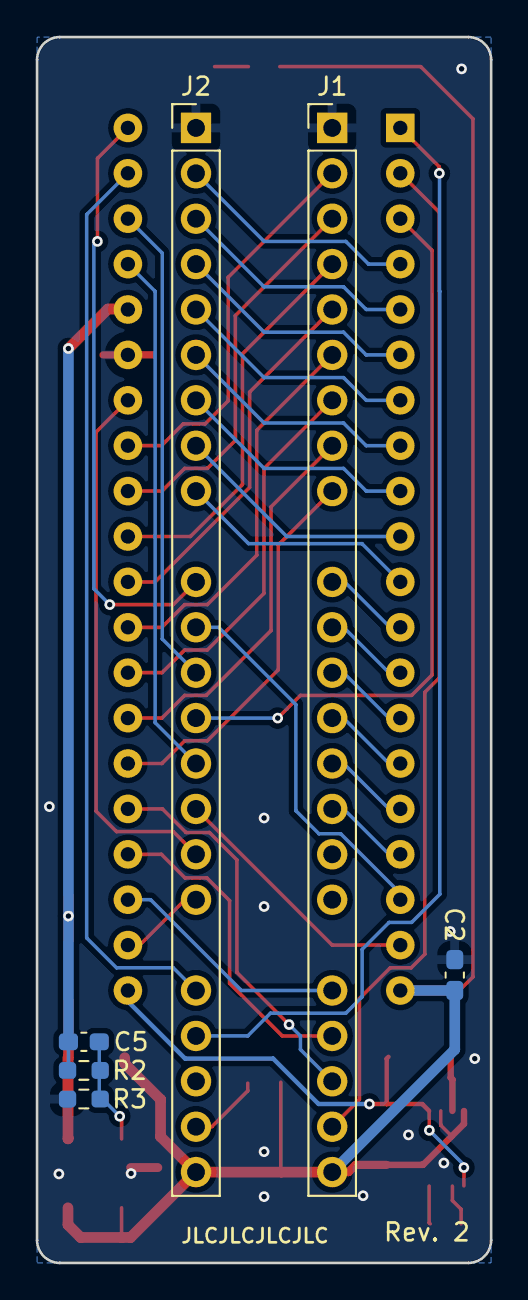
[picture p181: board bionic-tms9980.kicad_pcb from below]

Board: 2 copper layers, 25.4 x 68.6 mm, 21 parts (6 on the bottom side), 46 nets.
