tgtakaoka/retro-bionic/schematics/kl5c80a12/bionic-kl5c80a12.kicad_pcb

## KiCad design schematics/kl5c80a12/bionic-kl5c80a12.kicad_pcb (2026-10-26)

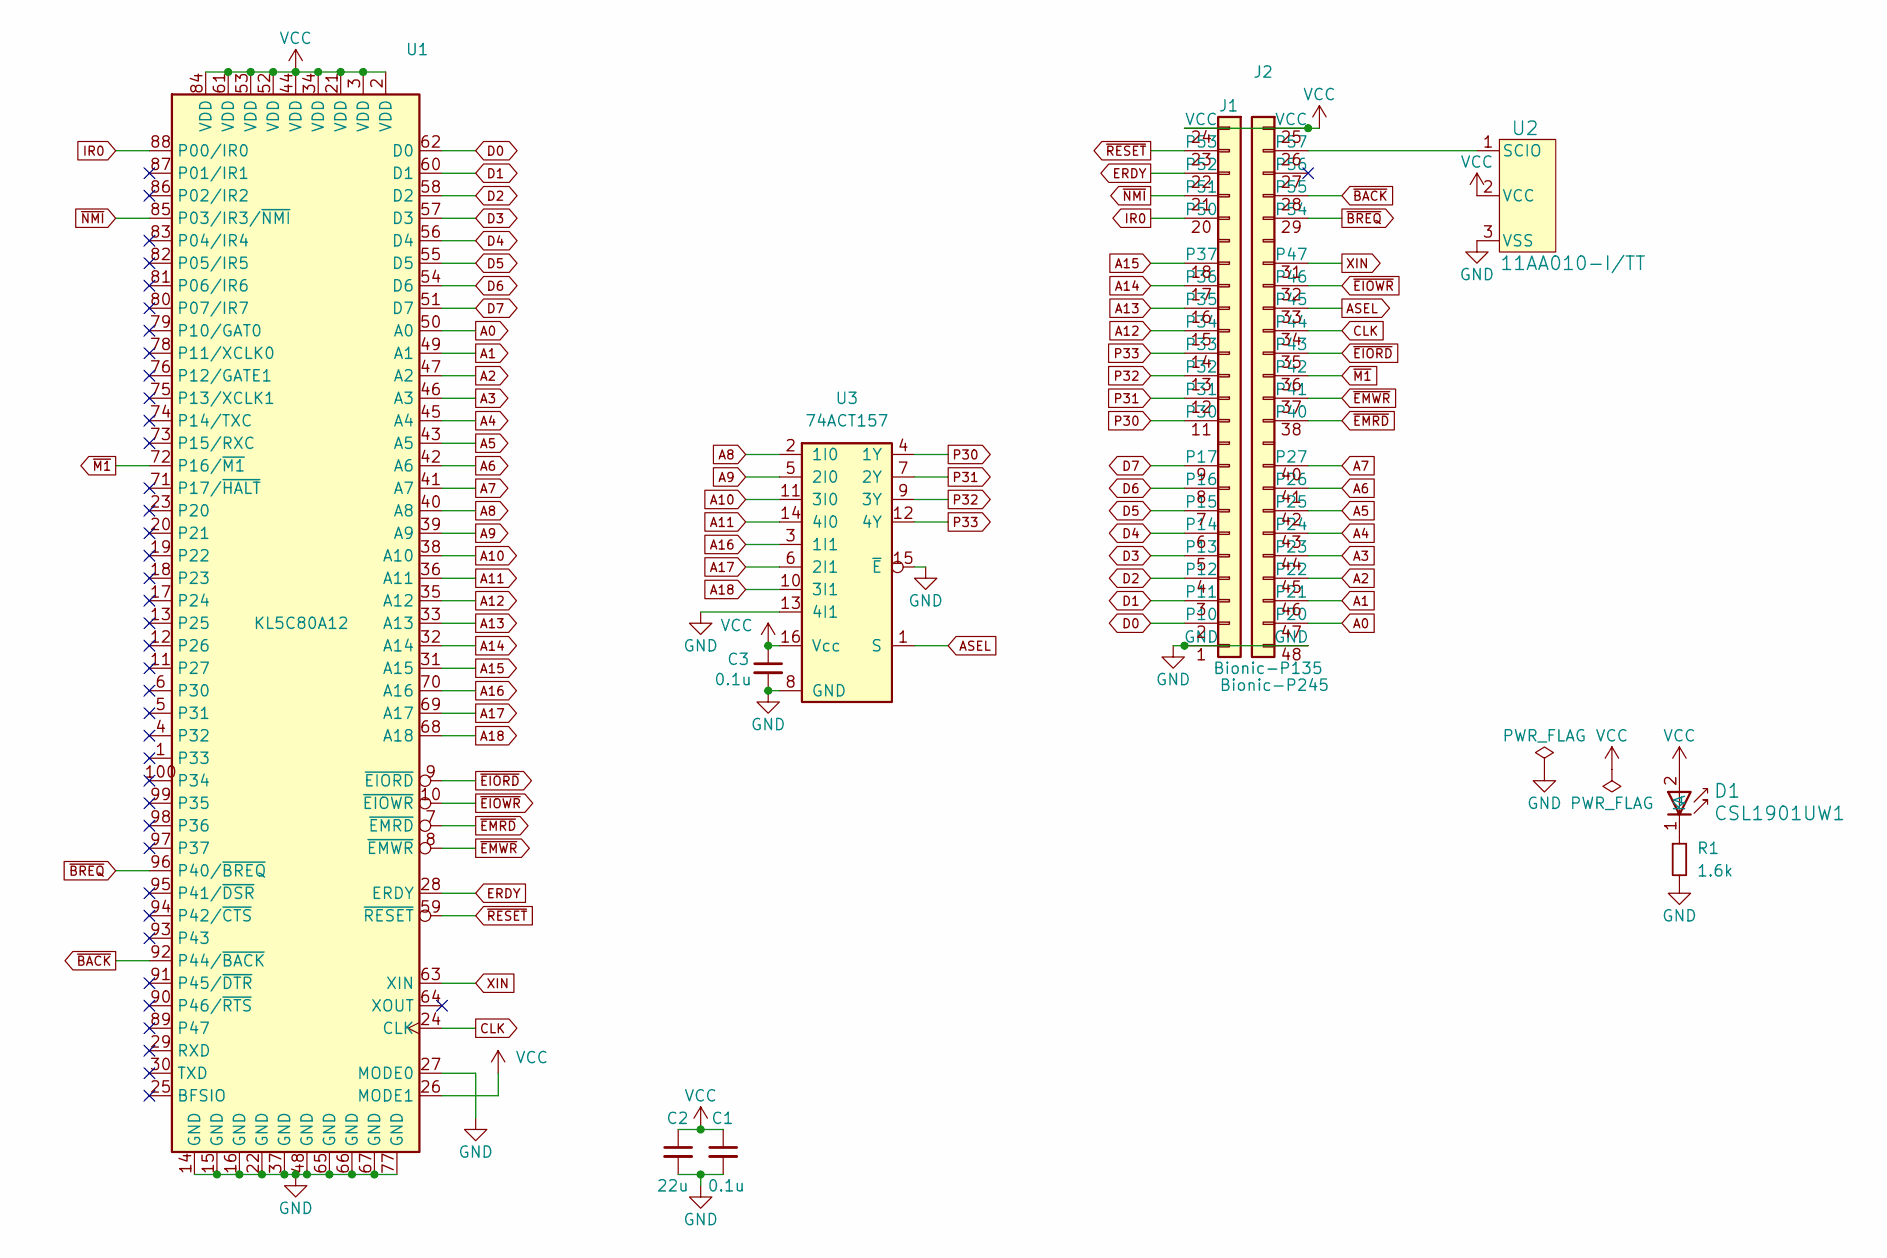
[picture p182: schematic bionic-kl5c80a12.kicad_sch, BionicKL5C80A12]

Parts:
C1, C3: 0.1u; C_0603_1608Metric_Pad1.08x0.95mm_HandSolder
C2: 22u; C_0603_1608Metric_Pad1.08x0.95mm_HandSolder
D1: CSL1901UW1; LED_CSL1901UW1_ROM-M
J1: Bionic-P135; Bionic-P135_SMT
J2: Bionic-P245; Bionic-P245_SMT
R1: 1.6k; R_0603_1608Metric_Pad0.98x0.95mm_HandSolder
U1: KL5C80A12; PQFP-100_14x20mm_P0.65mm
U2: 11AA010-I/TT; SOT-23_MC_MCH-M
U3: 74ACT157; PW16-M

Connections:
A0: J2.47 (P20), U1.50 (A0)
A1: J2.46 (P21), U1.49 (A1)
A2: J2.45 (P22), U1.47 (A2)
A3: J2.44 (P23), U1.46 (A3)
A4: J2.43 (P24), U1.45 (A4)
A5: J2.42 (P25), U1.43 (A5)
A6: J2.41 (P26), U1.42 (A6)
A7: J2.40 (P27), U1.41 (A7)
A8: U1.40 (A8), U3.2 (1I0)
A9: U1.39 (A9), U3.5 (2I0)
A10: U1.38 (A10), U3.11 (3I0)
A11: U1.36 (A11), U3.14 (4I0)
A12: J1.15 (P34), U1.35 (A12)
A13: J1.16 (P35), U1.33 (A13)
A14: J1.17 (P36), U1.32 (A14)
A15: J1.18 (P37), U1.31 (A15)
A16: U1.70 (A16), U3.3 (1I1)
A17: U1.69 (A17), U3.6 (2I1)
A18: U1.68 (A18), U3.10 (3I1)
ASEL: J2.33 (P45), U3.1 (S)
CLK: J2.34 (P44), U1.24 (CLK)
D0: J1.2 (P10), U1.62 (D0)
D1: J1.3 (P11), U1.60 (D1)
D2: J1.4 (P12), U1.58 (D2)
D3: J1.5 (P13), U1.57 (D3)
D4: J1.6 (P14), U1.56 (D4)
D5: J1.7 (P15), U1.55 (D5)
D6: J1.8 (P16), U1.54 (D6)
D7: J1.9 (P17), U1.51 (D7)
ERDY: J1.22 (P52), U1.28 (ERDY)
GND: C1.2, C2.2, C3.2, J1.1 (GND), J2.48 (GND), R1.2, U1.14 (GND), U1.15 (GND), U1.16 (GND), U1.22 (GND), U1.27 (MODE0), U1.37 (GND), U1.48 (GND), U1.65 (GND), U1.66 (GND), U1.67 (GND), U1.77 (GND), U2.3 (VSS), U3.8 (GND), U3.13 (4I1), U3.15 (~E)
IR0: J1.20 (P50), U1.88 (P00/IR0)
unnamed: D1.1 (K), R1.1
unnamed: J2.26 (P57), U2.1 (SCIO)
P30: J1.11 (P30), U3.4 (1Y)
P31: J1.12 (P31), U3.7 (2Y)
P32: J1.13 (P32), U3.9 (3Y)
P33: J1.14 (P33), U3.12 (4Y)
VCC: C1.1, C2.1, C3.1, D1.2 (A), J1.24 (VCC), J2.25 (VCC), U1.2 (VDD), U1.3 (VDD), U1.21 (VDD), U1.26 (MODE1), U1.34 (VDD), U1.44 (VDD), U1.52 (VDD), U1.53 (VDD), U1.61 (VDD), U1.84 (VDD), U2.2 (VCC), U3.16 (Vcc)
XIN: J2.31 (P47), U1.63 (XIN)
~BACK: J2.28 (P55), U1.92 (P44/~BACK)
~BREQ: J2.29 (P54), U1.96 (P40/~BREQ)
~EIORD: J2.35 (P43), U1.9 (~EIORD)
~EIOWR: J2.32 (P46), U1.10 (~EIOWR)
~EMRD: J2.38 (P40), U1.7 (~EMRD)
~EMWR: J2.37 (P41), U1.8 (~EMWR)
~M1: J2.36 (P42), U1.72 (P16/~M1)
~NMI: J1.21 (P51), U1.85 (P03/IR3/~NMI)
~RESET: J1.23 (P53), U1.59 (~RESET)

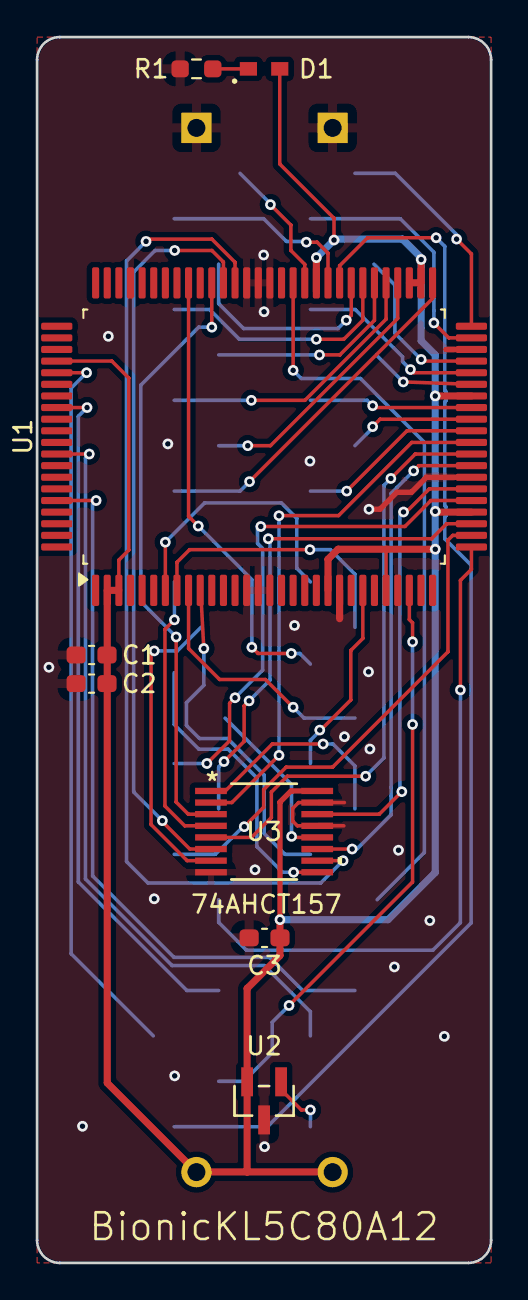
[picture p183: board bionic-kl5c80a12.kicad_pcb from above]

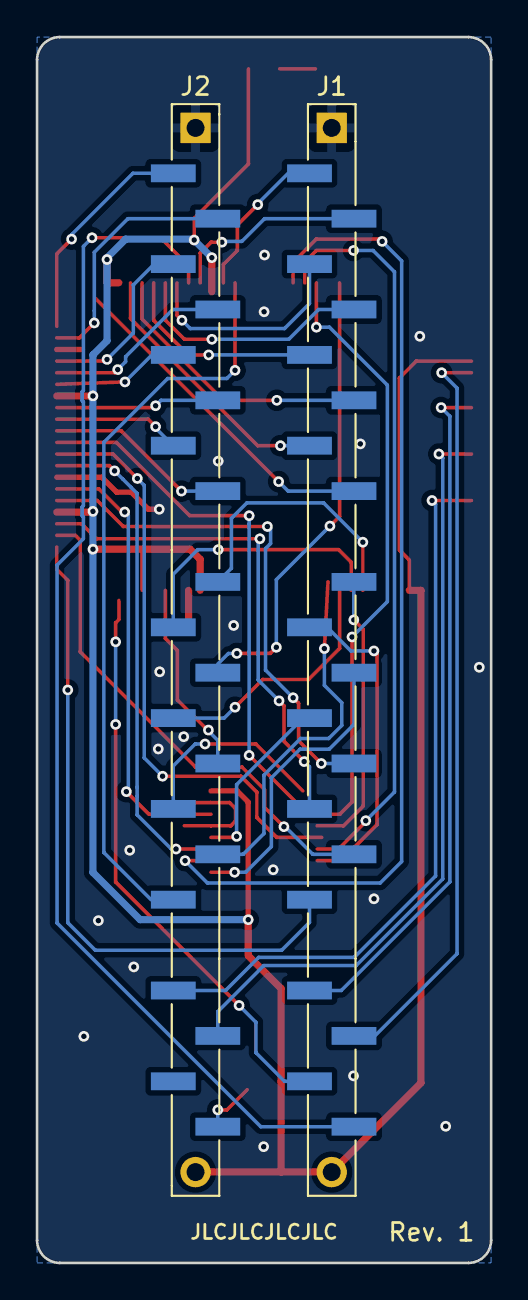
[picture p184: board bionic-kl5c80a12.kicad_pcb from below]

Board: 2 copper layers, 25.4 x 68.6 mm, 10 parts (2 on the bottom side), 49 nets.
