tgtakaoka/retro-bionic/schematics/tms9900/bionic-tms9900.kicad_pcb

## KiCad design schematics/tms9900/bionic-tms9900.kicad_pcb (2026-10-26)

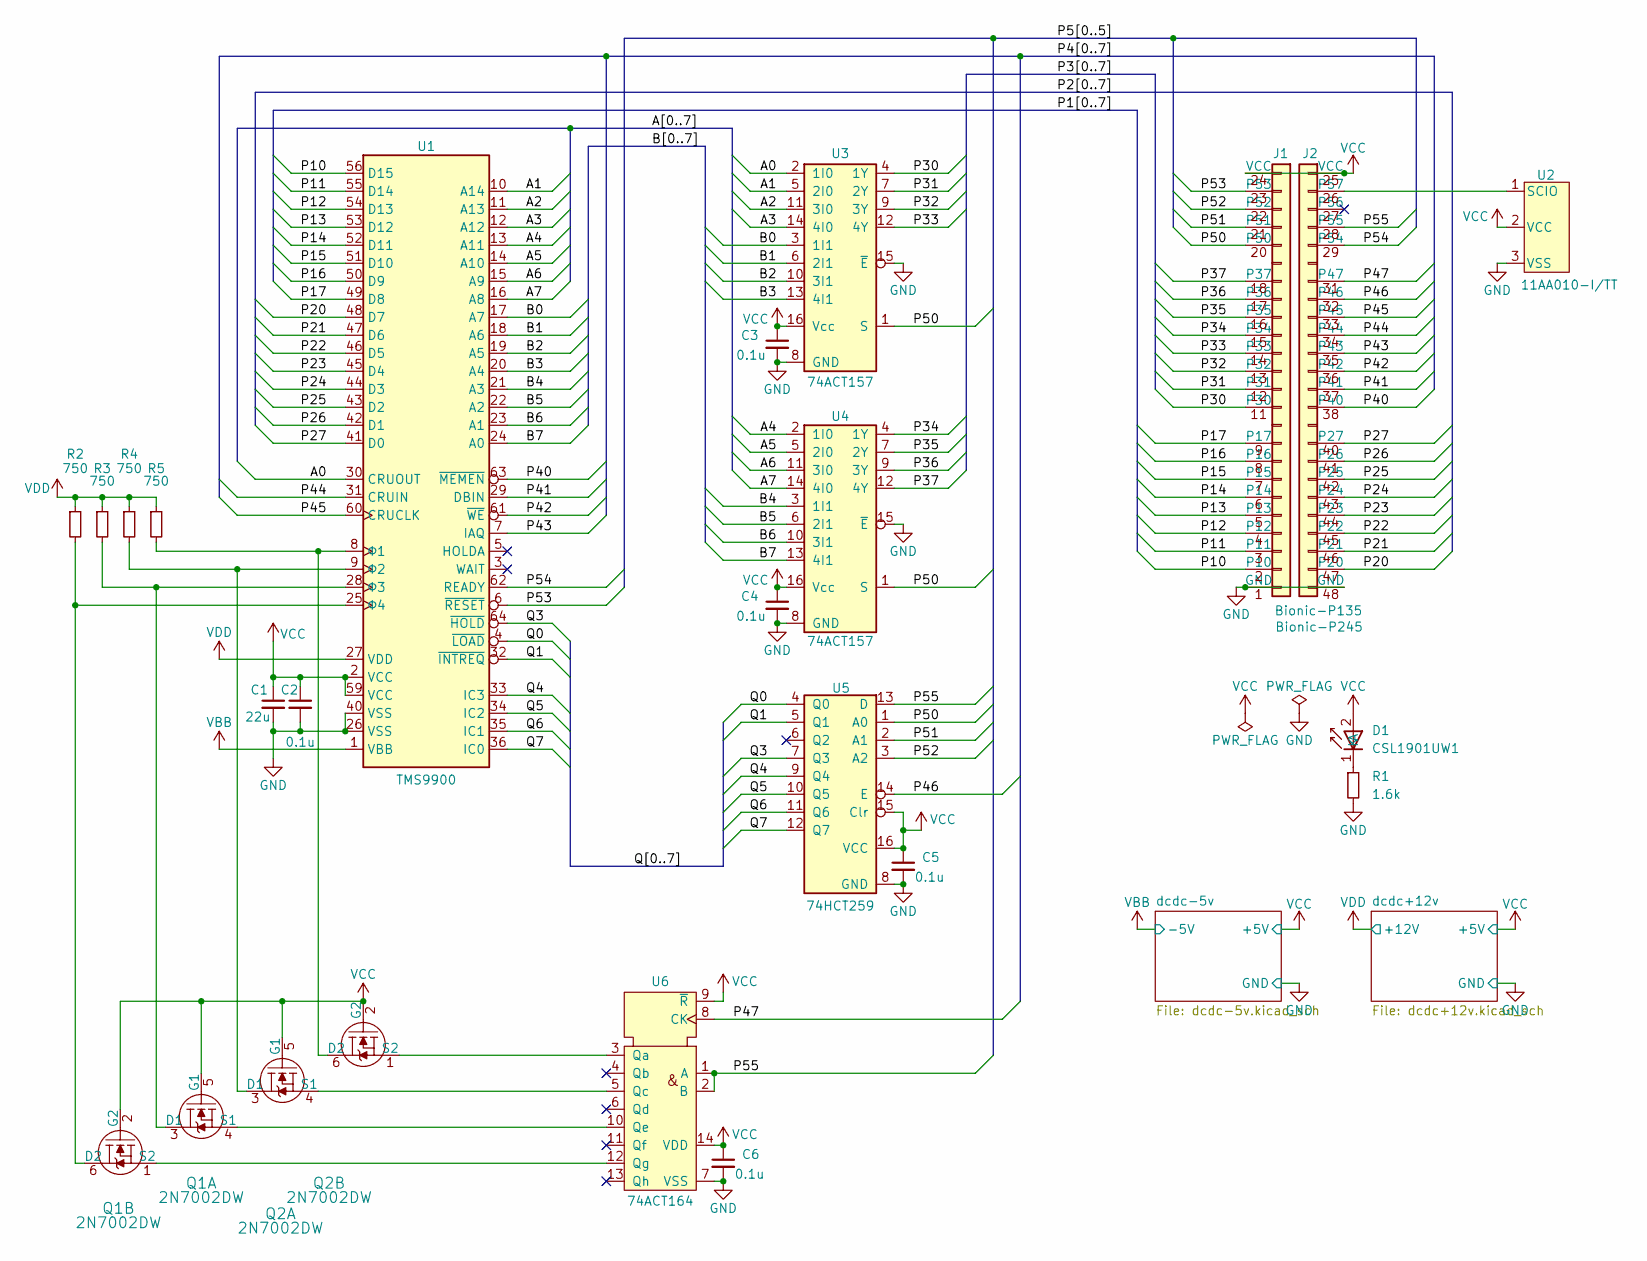
[picture p185: schematic bionic-tms9900.kicad_sch, BionicTMS9900]

Parts:
C1: 22u; C_0603_1608Metric_Pad1.08x0.95mm_HandSolder
C2, C3, C4, C5, C6: 0.1u; C_0603_1608Metric_Pad1.08x0.95mm_HandSolder
D1: CSL1901UW1; LED_CSL1901UW1_ROM-M
J1: Bionic-P135; Bionic-P135_SMT
J2: Bionic-P245; Bionic-P245_SMT
Q1, Q2: 2N7002DW; SC-88&slash;SC70-6&slash;SOT-363_419B-02_ONS_OSI-M
R1: 1.6k; R_0603_1608Metric_Pad0.98x0.95mm_HandSolder
R2, R3, R4, R5: 750; R_0603_1608Metric_Pad0.98x0.95mm_HandSolder
U1: TMS9900; DIP-64_W22.86mm_Socket
U2: 11AA010-I/TT; SOT-23_MC_MCH-M
U3, U4: 74ACT157; PW16-M
U5: 74HCT259; TSSOP16_SOT403-1_NEX-M
U6: 74ACT164; PW14-M

Connections:
/A0: U1.30 (CRUOUT), U3.2 (1I0)
/A1: U1.10 (A14), U3.5 (2I0)
/A2: U1.11 (A13), U3.11 (3I0)
/A3: U1.12 (A12), U3.14 (4I0)
/A4: U1.13 (A11), U4.2 (1I0)
/A5: U1.14 (A10), U4.5 (2I0)
/A6: U1.15 (A9), U4.11 (3I0)
/A7: U1.16 (A8), U4.14 (4I0)
/B0: U1.17 (A7), U3.3 (1I1)
/B1: U1.18 (A6), U3.6 (2I1)
/B2: U1.19 (A5), U3.10 (3I1)
/B3: U1.20 (A4), U3.13 (4I1)
/B4: U1.21 (A3), U4.3 (1I1)
/B5: U1.22 (A2), U4.6 (2I1)
/B6: U1.23 (A1), U4.10 (3I1)
/B7: U1.24 (A0), U4.13 (4I1)
/P10: J1.2 (P10), U1.56 (D15)
/P11: J1.3 (P11), U1.55 (D14)
/P12: J1.4 (P12), U1.54 (D13)
/P13: J1.5 (P13), U1.53 (D12)
/P14: J1.6 (P14), U1.52 (D11)
/P15: J1.7 (P15), U1.51 (D10)
/P16: J1.8 (P16), U1.50 (D9)
/P17: J1.9 (P17), U1.49 (D8)
/P20: J2.47 (P20), U1.48 (D7)
/P21: J2.46 (P21), U1.47 (D6)
/P22: J2.45 (P22), U1.46 (D5)
/P23: J2.44 (P23), U1.45 (D4)
/P24: J2.43 (P24), U1.44 (D3)
/P25: J2.42 (P25), U1.43 (D2)
/P26: J2.41 (P26), U1.42 (D1)
/P27: J2.40 (P27), U1.41 (D0)
/P30: J1.11 (P30), U3.4 (1Y)
/P31: J1.12 (P31), U3.7 (2Y)
/P32: J1.13 (P32), U3.9 (3Y)
/P33: J1.14 (P33), U3.12 (4Y)
/P34: J1.15 (P34), U4.4 (1Y)
/P35: J1.16 (P35), U4.7 (2Y)
/P36: J1.17 (P36), U4.9 (3Y)
/P37: J1.18 (P37), U4.12 (4Y)
/P40: J2.38 (P40), U1.63 (~MEMEN)
/P41: J2.37 (P41), U1.29 (DBIN)
/P42: J2.36 (P42), U1.61 (~WE)
/P43: J2.35 (P43), U1.7 (IAQ)
/P44: J2.34 (P44), U1.31 (CRUIN)
/P45: J2.33 (P45), U1.60 (CRUCLK)
/P46: J2.32 (P46), U5.14 (E)
/P47: J2.31 (P47), U6.8 (CK)
/P50: J1.20 (P50), U3.1 (S), U4.1 (S), U5.1 (A0)
/P51: J1.21 (P51), U5.2 (A1)
/P52: J1.22 (P52), U5.3 (A2)
/P53: J1.23 (P53), U1.6 (~RESET)
/P54: J2.29 (P54), U1.62 (READY)
/P55: J2.28 (P55), U5.13 (D), U6.1 (A), U6.2 (B)
/Q0: U1.4 (~LOAD), U5.4 (Q0)
/Q1: U1.32 (~INTREQ), U5.5 (Q1)
/Q3: U1.64 (~HOLD), U5.7 (Q3)
/Q4: U1.33 (IC3), U5.9 (Q4)
/Q5: U1.34 (IC2), U5.10 (Q5)
/Q6: U1.35 (IC1), U5.11 (Q6)
/Q7: U1.36 (IC0), U5.12 (Q7)
GND: C1.2, C2.2, C3.2, C4.2, C5.2, C6.2, J1.1 (GND), J2.48 (GND), R1.2, U1.26 (VSS), U1.40 (VSS), U2.3 (VSS), U3.8 (GND), U3.15 (~E), U4.8 (GND), U4.15 (~E), U5.8 (GND), U6.7 (VSS); also elsewhere on the board
unnamed: D1.1 (K), R1.1
unnamed: J2.26 (P57), U2.1 (SCIO)
unnamed: Q1.3 (D1), R3.2, U1.28 (Φ3)
unnamed: Q1.4 (S1), U6.10 (Qe)
unnamed: Q1.6 (D2), R2.2, U1.25 (Φ4)
unnamed: Q1.1 (S2), U6.12 (Qg)
unnamed: Q2.3 (D1), R4.2, U1.9 (Φ2)
unnamed: Q2.4 (S1), U6.5 (Qc)
unnamed: Q2.6 (D2), R5.2, U1.8 (Φ1)
unnamed: Q2.1 (S2), U6.3 (Qa)
VBB: U1.1 (VBB); also elsewhere on the board
VCC: C1.1, C2.1, C3.1, C4.1, C5.1, C6.1, D1.2 (A), J1.24 (VCC), J2.25 (VCC), Q1.2 (G2), Q1.5 (G1), Q2.2 (G2), Q2.5 (G1), U1.2 (VCC), U1.59 (VCC), U2.2 (VCC), U3.16 (Vcc), U4.16 (Vcc), U5.15 (Clr), U5.16 (VCC), U6.9 (~R), U6.14 (VDD); also elsewhere on the board
VDD: R2.1, R3.1, R4.1, R5.1, U1.27 (VDD); also elsewhere on the board

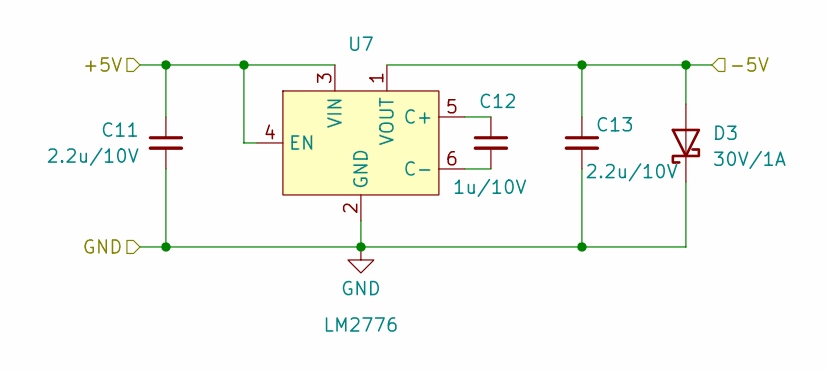
[picture p186: schematic dcdc-5v.kicad_sch]

Parts:
C11, C13: 2.2u/10V; C_0603_1608Metric_Pad1.08x0.95mm_HandSolder
C12: 1u/10V; C_0603_1608Metric_Pad1.08x0.95mm_HandSolder
D3: 30V/1A; CR_60M-60_ROM-M
U7: LM2776; DBV0006A_M

Connections:
GND: C11.2, C13.2, D3.1 (K), U7.2 (GND); also elsewhere on the board
unnamed: C12.1, U7.5 (C+)
unnamed: C12.2, U7.6 (C-)
VBB: C13.1, D3.2 (A), U7.1 (VOUT); also elsewhere on the board
VCC: C11.1, U7.3 (VIN), U7.4 (EN); also elsewhere on the board

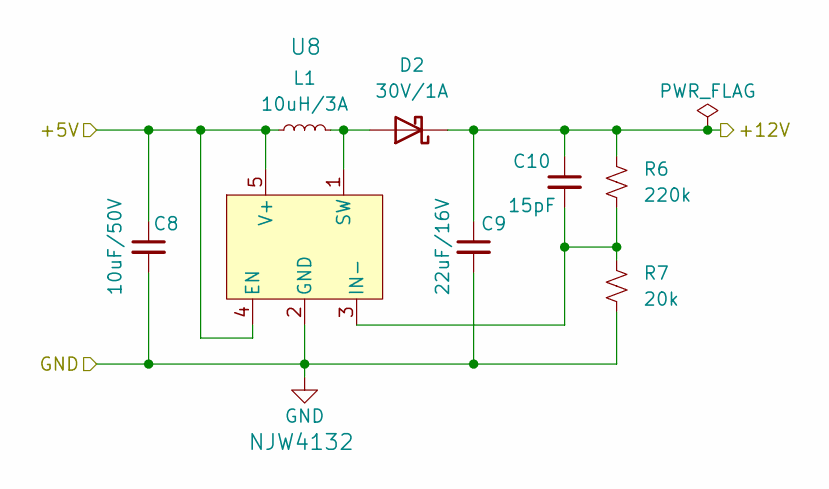
[picture p187: schematic dcdc+12v.kicad_sch]

Parts:
C8: 10uF/50V; C_0603_1608Metric_Pad1.08x0.95mm_HandSolder
C9: 22uF/16V; C_0603_1608Metric_Pad1.08x0.95mm_HandSolder
C10: 15pF; C_0603_1608Metric_Pad1.08x0.95mm_HandSolder
D2: 30V/1A; CR_60M-60_ROM-M
L1: 10uH/3A; IND_DFE322512F_MUR-M
R6: 220k; R_0603_1608Metric_Pad0.98x0.95mm_HandSolder
R7: 20k; R_0603_1608Metric_Pad0.98x0.95mm_HandSolder
U8: NJW4132; SOT-89-5_NMD-M

Connections:
GND: C8.2, C9.2, R7.2, U8.2 (GND); also elsewhere on the board
unnamed: D2.2 (A), L1.2, U8.1 (SW)
unnamed: C10.2, R6.2, R7.1, U8.3 (IN-)
VCC: C8.1, L1.1, U8.4 (EN), U8.5 (V+); also elsewhere on the board
VDD: C9.1, C10.1, D2.1 (K), R6.1; also elsewhere on the board

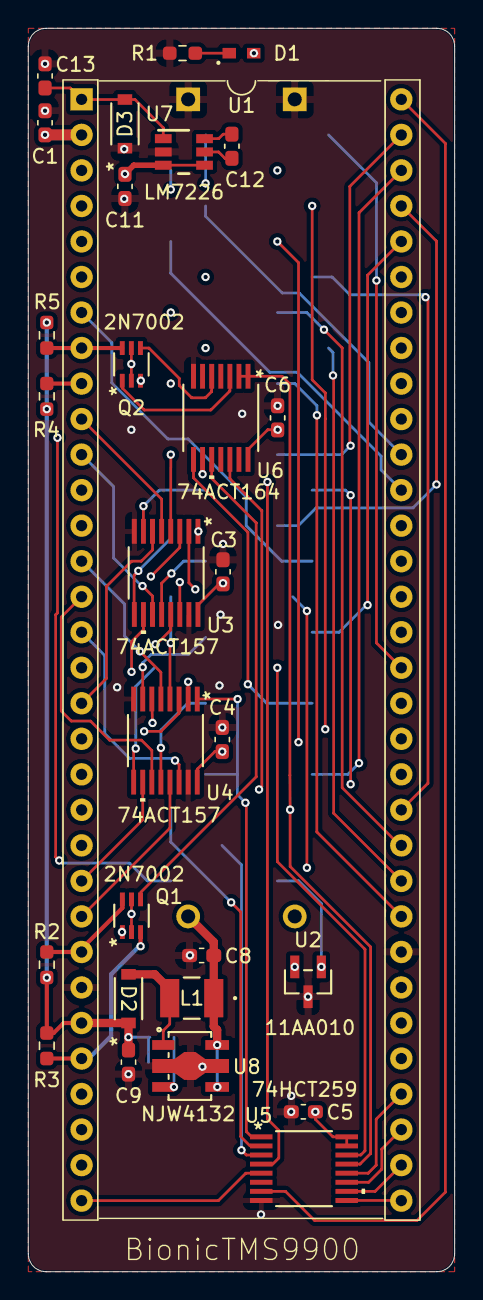
[picture p188: board bionic-tms9900.kicad_pcb from above]

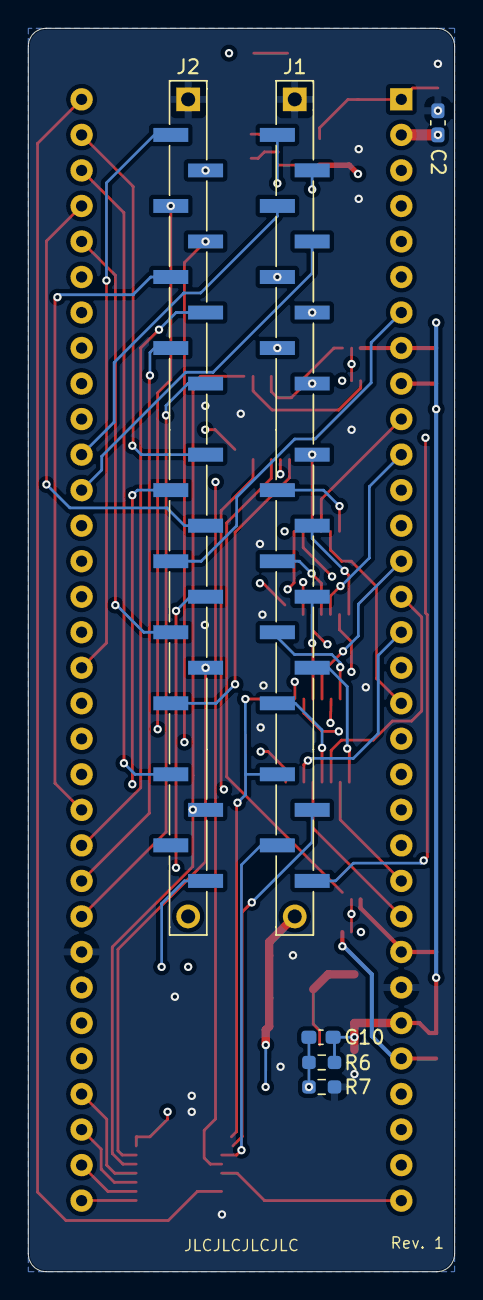
[picture p189: board bionic-tms9900.kicad_pcb from below]

Board: 4 copper layers, 30.5 x 88.9 mm, 35 parts (6 on the bottom side), 79 nets.
