tgtakaoka/retro-bionic/schematics/hd6120/bionic-hd6120.kicad_pcb

## KiCad design schematics/hd6120/bionic-hd6120.kicad_pcb (2026-10-26)

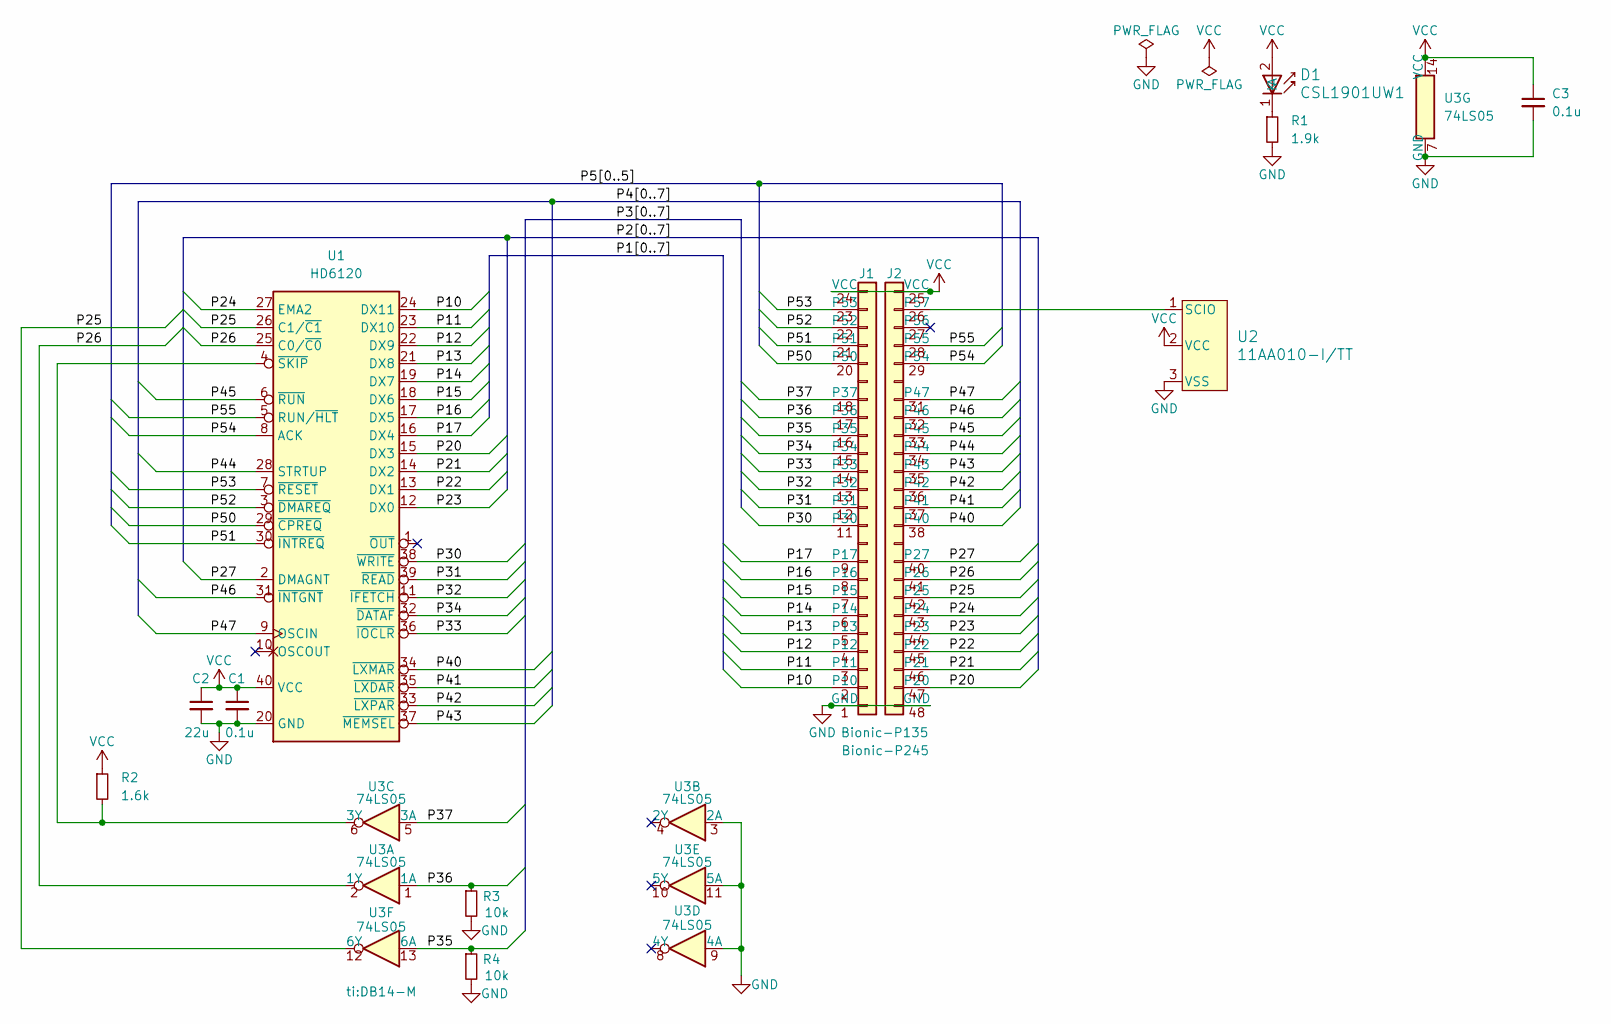
[picture p190: schematic bionic-hd6120.kicad_sch, BionicHD6120]

Parts:
C1, C3: 0.1u; C_0603_1608Metric_Pad1.08x0.95mm_HandSolder
C2: 22u; C_0603_1608Metric_Pad1.08x0.95mm_HandSolder
D1: CSL1901UW1; LED_CSL1901UW1_ROM-M
J1: Bionic-P135; Bionic-P135_THT
J2: Bionic-P245; Bionic-P245_THT
R1: 1.9k; R_0603_1608Metric_Pad0.98x0.95mm_HandSolder
R2: 1.6k; R_0603_1608Metric_Pad0.98x0.95mm_HandSolder
R3, R4: 10k; R_0603_1608Metric_Pad0.98x0.95mm_HandSolder
U1: HD6120; DIP-40_W15.24mm_Socket
U2: 11AA010-I/TT; SOT-23_MC_MCH-M
U3: 74LS05; DB14-M

Connections:
/P10: J1.2 (P10), U1.24 (DX11)
/P11: J1.3 (P11), U1.23 (DX10)
/P12: J1.4 (P12), U1.22 (DX9)
/P13: J1.5 (P13), U1.21 (DX8)
/P14: J1.6 (P14), U1.19 (DX7)
/P15: J1.7 (P15), U1.18 (DX6)
/P16: J1.8 (P16), U1.17 (DX5)
/P17: J1.9 (P17), U1.16 (DX4)
/P20: J2.47 (P20), U1.15 (DX3)
/P21: J2.46 (P21), U1.14 (DX2)
/P22: J2.45 (P22), U1.13 (DX1)
/P23: J2.44 (P23), U1.12 (DX0)
/P24: J2.43 (P24), U1.27 (EMA2)
/P25: J2.42 (P25), U1.26 (C1/~C1), U3.12 (6Y)
/P26: J2.41 (P26), U1.25 (C0/~C0), U3.2 (1Y)
/P27: J2.40 (P27), U1.2 (DMAGNT)
/P30: J1.11 (P30), U1.38 (~WRITE)
/P31: J1.12 (P31), U1.39 (~READ)
/P32: J1.13 (P32), U1.11 (~IFETCH)
/P33: J1.14 (P33), U1.36 (~IOCLR)
/P34: J1.15 (P34), U1.32 (~DATAF)
/P35: J1.16 (P35), R4.1, U3.13 (6A)
/P36: J1.17 (P36), R3.1, U3.1 (1A)
/P37: J1.18 (P37), U3.5 (3A)
/P40: J2.38 (P40), U1.34 (~LXMAR)
/P41: J2.37 (P41), U1.35 (~LXDAR)
/P42: J2.36 (P42), U1.33 (~LXPAR)
/P43: J2.35 (P43), U1.37 (~MEMSEL)
/P44: J2.34 (P44), U1.28 (STRTUP)
/P45: J2.33 (P45), U1.6 (~RUN)
/P46: J2.32 (P46), U1.31 (~INTGNT)
/P47: J2.31 (P47), U1.9 (OSCIN)
/P50: J1.20 (P50), U1.29 (~CPREQ)
/P51: J1.21 (P51), U1.30 (~INTREQ)
/P52: J1.22 (P52), U1.3 (~DMAREQ)
/P53: J1.23 (P53), U1.7 (~RESET)
/P54: J2.29 (P54), U1.8 (ACK)
/P55: J2.28 (P55), U1.5 (RUN/~HLT)
GND: C1.2, C2.2, C3.2, J1.1 (GND), J2.48 (GND), R1.2, R3.2, R4.2, U1.20 (GND), U2.3 (VSS), U3.3 (2A), U3.7 (GND), U3.9 (4A), U3.11 (5A)
unnamed: D1.1 (K), R1.1
unnamed: J2.26 (P57), U2.1 (SCIO)
unnamed: R2.2, U1.4 (~SKIP), U3.6 (3Y)
VCC: C1.1, C2.1, C3.1, D1.2 (A), J1.24 (VCC), J2.25 (VCC), R2.1, U1.40 (VCC), U2.2 (VCC), U3.14 (VCC)

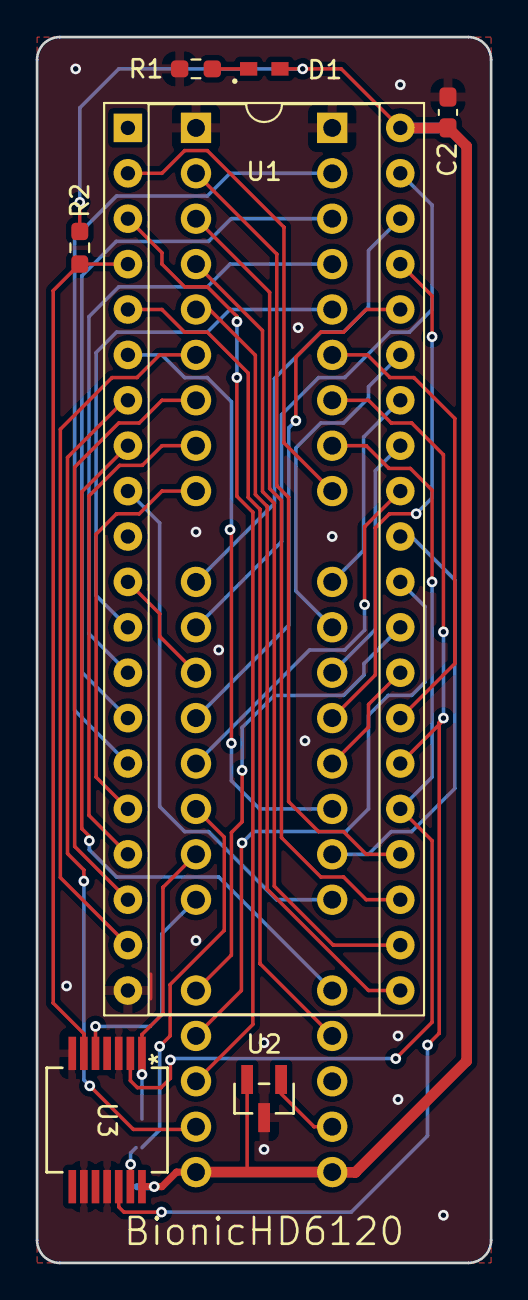
[picture p191: board bionic-hd6120.kicad_pcb from above]

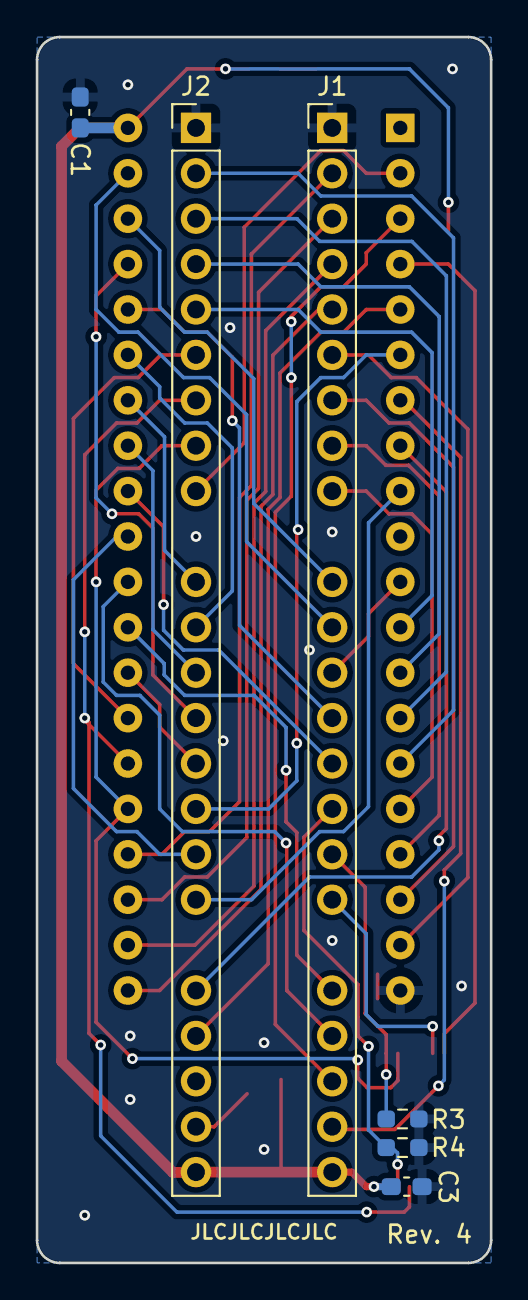
[picture p192: board bionic-hd6120.kicad_pcb from below]

Board: 2 copper layers, 25.4 x 68.6 mm, 13 parts (6 on the bottom side), 43 nets.
