tgtakaoka/retro-bionic/debugger/mc68000/pins_mc68000.cpp

#include "pins_mc68000.h"
#include "debugger.h"
#include "devs_mc68000.h"
#include "digital_bus.h"
#include "mems_mc68000.h"
#include "pins_mc68000_cycle.h"
#include "regs_mc68000.h"
#include "signals_mc68000.h"

namespace debugger {
namespace mc68000 {

namespace {

constexpr auto ADDR_MASK = 0xFFFFFF;  // A0-A23
// 150 MHz / 15: the slowest chips the boards take are 10 MHz parts.
constexpr uint32_t clock_input_hz = 10000000;

// 74HCS153 select to output: 15 ns typical at 5 V.
constexpr auto asel_delay_ns = 15;

const uint8_t PINS_LOW[] = {
        PIN_RESET,
        PIN_HALT,
        PIN_ASEL0,
        PIN_ASEL1,
};

const uint8_t PINS_HIGH[] = {
        PIN_DTACK,
        PIN_BERR,
        PIN_IPL0,
        PIN_IPL1,
        PIN_IPL2,
};

const uint8_t PINS_INPUT[] = {
        PIN_AS,
        PIN_RW,
        PIN_UDS,
        PIN_LDS,
        PIN_D0,
        PIN_D1,
        PIN_D2,
        PIN_D3,
        PIN_D4,
        PIN_D5,
        PIN_D6,
        PIN_D7,
        PIN_D8,
        PIN_D9,
        PIN_D10,
        PIN_D11,
        PIN_D12,
        PIN_D13,
        PIN_D14,
        PIN_D15,
        PIN_AL0,
        PIN_AL1,
        PIN_AL2,
        PIN_AL3,
        PIN_AH0,
        PIN_AH1,
        PIN_AH2,
        PIN_AH3,
};

inline uint16_t bothLanes(uint8_t v) {
    return static_cast<uint16_t>(v) << 8 | v;
}

// The read right after a select write still shows the old selection, the
// next one the new, measured from the Teensy side: one other read settles
// a step, a discarded one where there is nothing to read. A board with
// asel_delay waits asel_delay_ns instead.
template <typename BOARD>
inline void settle_asel(bool read) {
    if constexpr (BOARD::asel_delay) {
        delayNanoseconds(asel_delay_ns);
    } else if (!read) {
        PIN(ADDR);
    }
}

}  // namespace

template <typename BOARD>
PinsMc68000<BOARD>::PinsMc68000()
    : PinsMc68000Base(Signals::UDS | Signals::LDS, clock_input_hz) {
    _devs = new DevsMc68000(ADDR_MASK);
    _mems = new MemsMc68000(ADDR_MASK);
    _regs = new RegsMc68000(this, mems<MemsMc68000>(), false);
}

template <typename BOARD>
void PinsMc68000<BOARD>::resetPins() {
    pinsMode(PINS_LOW, sizeof(PINS_LOW), OUTPUT, LOW);
    pinsMode(PINS_HIGH, sizeof(PINS_HIGH), OUTPUT, HIGH);
    pinsMode(PINS_INPUT, sizeof(PINS_INPUT), INPUT);
    resetCpu();
}

// MODE, on P37 in phase 10, is a strap: high or open for a 16-bit bus, low
// (JP1 closed on the FN board) for an MC68HC001's 8-bit bus. The P and PS
// boards tie it high. It must be known before the first cycle, whose A0
// comes from the strobes on a 16-bit bus and from the mux on an 8-bit one.
template <typename BOARD>
void PinsMc68000<BOARD>::readStraps() {
    digitalWriteFast(PIN_ASEL1, HIGH);  // 10
    delayNanoseconds(asel_delay_ns);
    const uint32_t sel10 = PIN(ADDR);
    digitalWriteFast(PIN_ASEL1, LOW);  // 00
    _bus8 = (sel10 & (UINT32_C(1) << 19)) == 0;
}

// ASEL1:ASEL0 rests at 00. Stepped in gray order 00, 01, 11, 10 the muxes
// hand out A0/A16, A4/A20, A8/-, A12/FC in turn, one select changing per
// step, and the last step brings it back to 00. Each phase's AL and AH
// nibbles shift together by 0, 4, 8 and 12: A0-A23 in bits 0-23, FC2:FC0
// in 28-30. The CPU holds the address until #DTACK.
template <typename BOARD>
void PinsMc68000<BOARD>::getAddr(Signals *s) const {
    constexpr uint32_t nibbles = 0x000F000F;
    const uint32_t sel00 = PIN(ADDR);
    // A read asserts its strobes with #AS: they are settled by now.
    uint8_t cntl;
    if constexpr (BOARD::asel_delay) {
        // ATTENTION: cause unknown. Read after the select write, bench1
        // misreads device cycles.
        cntl = busRead(CNTL);
        digitalWriteFast(PIN_ASEL0, HIGH);  // 01
    } else {
        digitalWriteFast(PIN_ASEL0, HIGH);  // 01
        cntl = busRead(CNTL);
    }
    uint32_t addr = sel00 & nibbles;
    settle_asel<BOARD>(true);
    const uint32_t sel01 = PIN(ADDR);
    digitalWriteFast(PIN_ASEL1, HIGH);  // 11
    addr |= (sel01 & nibbles) << 4;
    settle_asel<BOARD>(false);
    const uint32_t sel11 = PIN(ADDR);
    digitalWriteFast(PIN_ASEL0, LOW);  // 10
    addr |= (sel11 & nibbles) << 8;
    settle_asel<BOARD>(false);
    const uint32_t sel10 = PIN(ADDR);
    digitalWriteFast(PIN_ASEL1, LOW);  // 00
    addr |= (sel10 & nibbles) << 12;
    s->addr = addr & 0xFFFFFF;
    s->setFc((addr >> 28) & 7, false);
    // A write's strobes come later, for getLanes().
    if (s->read()) {
        s->cntl() = cntl;
        getLanes(s);
    }
}

// Both strobes move a word; #UDS alone the even byte, #LDS alone the odd
// one. On an 8-bit bus #LDS strobes every byte and A0 is on the bus.
template <typename BOARD>
void PinsMc68000<BOARD>::getLanes(Signals *s) const {
    if (_bus8)
        return;
    const auto uds = (s->cntl() & Signals::UDS) == 0;
    const auto lds = (s->cntl() & Signals::LDS) == 0;
    s->addr = (s->addr & ~UINT32_C(1)) | ((lds && !uds) ? 1 : 0);
    s->setFc(s->fc(), uds && lds);
}

template <typename BOARD>
void PinsMc68000<BOARD>::getData(Signals *s) const {
    const uint16_t data = busRead(D);
    if (s->wordAccess()) {
        s->data = data;
    } else if (_bus8 || (s->cntl() & Signals::LDS) == 0) {
        s->data = data & 0xFF;
    } else {
        s->data = data >> 8;
    }
}

// A byte goes out on both lanes: the CPU takes the one it strobed.
template <typename BOARD>
void PinsMc68000<BOARD>::outData(const Signals *s) const {
    busWrite(D, s->wordAccess() ? s->data : bothLanes(s->data));
    busMode(D, OUTPUT);
}

template <typename BOARD>
void PinsMc68000<BOARD>::inputMode() const {
    busMode(D, INPUT);
}

// The level on #IPL2-#IPL0, active low.
template <typename BOARD>
void PinsMc68000<BOARD>::setIpl() const {
    busWrite(IPL, ~iplLevel() & 7);
}

template <typename BOARD>
Signals *PinsMc68000<BOARD>::prepareCycle(uint_fast16_t clocks) {
    return prepareCycleOf<BOARD>(clocks);
}

template <typename BOARD>
Signals *PinsMc68000<BOARD>::completeCycle(Signals *s) {
    return completeCycleOf<BOARD>(s);
}

template <typename BOARD>
bool PinsMc68000<BOARD>::loop() {
    return loopOf<BOARD>();
}

template struct PinsMc68000<PinsMc68000P>;
template struct PinsMc68000<PinsMc68000Fn>;

}  // namespace mc68000
}  // namespace debugger

// Local Variables:
// mode: c++
// c-basic-offset: 4
// tab-width: 4
// End:
// vim: set ft=cpp et ts=4 sw=4:
