tgtakaoka/retro-bionic/debugger/mc6800/pins_mc6801.cpp

#include "pins_mc6801.h"
#include "debugger.h"
#include "devs_mc6801.h"
#include "inst_hd6301.h"
#include "inst_mc6801.h"
#include "mems_mc6801.h"
#include "regs_mc6801.h"
#include "signals_mc6801.h"

namespace debugger {
namespace mc6801 {

/**
 * MC6801 bus cycle.
 *         __    __    __    __    __    __    __    __    __    __
 * EXTAL c|4 |_c|1 |_c|2 |_c|3 |_c|4 |_c|1 |_c|2 |_c|3 |_c|4 |_c| 1|_
 *       ____\  \     \  \ __________\  \     \  \ ___________\  \
 *     E      |___________|           |___________|           |______
 *                _____                   _____                    __
 *    AS ________|     |_________________|     |__________________|
 *       ______     ___________________                             _
 *   R/W ______>---|                   |---|___________________|---<_
 *       ______     ___________________     ___________________     _
 *  Addr ______>---<___________________>---<___________________>---<_
 *       ______     ____            ___     ____        _______     _
 *  Data ______>---<____>----------<___>---<____>------<_______>---<_
 *
 * - EXTAL falling-edge to E edges takes 50ns.
 * - EXTAL rising-edge of c1 to AS edges takes 40ns.
 * - EXTAL falling-edge of c4 to R/W edges takes 100ns.
 * - R/W is valid before rising edge of c1.
 * - Read data setup to falling E edge is 80ns.
 * - Write data gets valid after 225ns of rising E edge.
 */

namespace {

//  XTAL: max 4 MHz, min 0.4 MHz
//  tCYC: min 1000 ns, max 2,000 ns
//  PWEL: min  430 ns, max 1,000 ns; e_lo
//  PWEH: min  450 ns, max 1,000 ns; e_hi
//   tAV: min  200 ns; addr to e_hi
//  tDSR: min   80 ns; data to e_lo
//  tDDW: max  225 ns; e_hi to data
//  tASD: min   90 ns; e_lo to as_hi
//  tASL: min   60 ns; addr to as_lo
// tASED: min   90 ns; as_lo to e_hi
//  tPCS: min  200 ns; reset_hi to e_lo
constexpr auto extal_hi_ns = 108;  // 125
constexpr auto extal_lo_ns = 108;  // 125
enum Delay : uint8_t {
    c1_lo_ns,       // 125
    c1_hi_ns,       // 125
    c2_lo_ns,       // 125
    c2_hi_ns,       // 125
    c3_lo_read,     // 125
    c3_lo_inject,   // 125
    c3_hi_read,     // 125
    c4_lo_read,     // 125
    c4_hi_read,     // 125
    c3_lo_write,    // 125
    c3_hi_write,    // 125
    c4_lo_write,    // 125
    c4_lo_capture,  // 125
    c4_hi_write,    // 125
    DELAYS,
};
// Long enough that no EXTAL half runs under 125 ns, the 1 MHz part's
// 4 MHz XTAL, so no E cycle runs under tCYC either.
constexpr uint16_t DELAYS_NS[DELAYS] = {
        37, 116, 100, 100, 70, 105, 105, 87, 61, 103, 100, 78, 108, 65};
// MC6803-1 (1.25 MHz): no E cycle under 800 ns on the bench.
// constexpr uint16_t DELAYS_NS[DELAYS] = {
//         1, 74, 64, 64, 1, 67, 67, 54, 39, 66, 64, 1, 69, 41};
// HD63B03 (2 MHz): E 1.67 MHz on the bench; 1.92 MHz fails the regress.
// constexpr uint16_t DELAYS_NS[DELAYS] = {
//         1, 31, 26, 26, 1, 28, 28, 22, 16, 27, 26, 1, 29, 17};
constexpr auto tpcs_ns = 200;

inline void extal_hi() {
    digitalWriteFast(PIN_EXTAL, HIGH);
}

inline void extal_lo() {
    digitalWriteFast(PIN_EXTAL, LOW);
}

inline void clock_cycle() {
    extal_hi();
    delayNanoseconds(extal_hi_ns);
    extal_lo();
    delayNanoseconds(extal_lo_ns);
}

inline auto clock_e() {
    return digitalReadFast(PIN_E);
}

inline void negate_reset() {
    digitalWriteFast(PIN_RESET, HIGH);
}

inline void inject_mode_pin(uint8_t pin, uint8_t val) {
    if (val) {
        pinMode(pin, INPUT_PULLUP);
    } else {
        digitalWriteFast(pin, LOW);
        pinMode(pin, OUTPUT);
    }
}

void inject_mode(uint8_t mode) {
    inject_mode_pin(PIN_PC2, mode & 4);
    inject_mode_pin(PIN_PC1, mode & 2);
    inject_mode_pin(PIN_PC0, mode & 1);
}

void release_mode() {
    pinMode(PIN_PC2, INPUT_PULLUP);
    pinMode(PIN_PC1, INPUT_PULLUP);
    pinMode(PIN_PC0, INPUT_PULLUP);
}

constexpr uint8_t PINS_LOW[] = {
        PIN_RESET,
        PIN_EXTAL,
};

constexpr uint8_t PINS_HIGH[] = {
        PIN_IRQ,  // IRQ1
};

constexpr uint8_t PINS_PULLUP[] = {
        // #NMI may be connected to P21/PC1 for LILBUG trace.
        PIN_NMI,
        PIN_PC0,
        PIN_PC1,
        PIN_PC2,
};

constexpr uint8_t PINS_INPUT[] = {
        PIN_AD0,
        PIN_AD1,
        PIN_AD2,
        PIN_AD3,
        PIN_AD4,
        PIN_AD5,
        PIN_AD6,
        PIN_AD7,
        PIN_ADDR8,
        PIN_ADDR9,
        PIN_ADDR10,
        PIN_ADDR11,
        PIN_ADDR12,
        PIN_ADDR13,
        PIN_ADDR14,
        PIN_ADDR15,
        PIN_RW,
        PIN_AS,
        PIN_E,
        PIN_XTAL,
};

}  // namespace

PinsMc6801::PinsMc6801() {
    auto regs = new RegsMc6801(this);
    auto devs = new DevsMc6801();
    _regs = regs;
    _devs = devs;
    _mems = new MemsMc6801(regs, devs);
    _inst = new InstMc6801(_mems);
}

template <uint8_t F>
inline void PinsMc6801::delay() const {
    if constexpr (DELAYS_NS[F] != 0)
        delayNanoseconds(DELAYS_NS[F]);
}

void PinsMc6801::resetPins() {
    // Assert reset condition
    pinsMode(PINS_LOW, sizeof(PINS_LOW), OUTPUT, LOW);
    pinsMode(PINS_HIGH, sizeof(PINS_HIGH), OUTPUT, HIGH);
    pinsMode(PINS_PULLUP, sizeof(PINS_PULLUP), INPUT_PULLUP);
    pinsMode(PINS_INPUT, sizeof(PINS_INPUT), INPUT);

    // The save injects into the first fetch, so it must be external: the
    // CPU answers an internal address itself. Start at 8000H until then.
    const uint16_t reset_vec = _mems->read16(ArchMc6800::VEC_RESET);
    _mems->write16(ArchMc6800::VEC_RESET, 0x8000);

    // Clock a few cycles with #RESET low.
    clock_cycle();
    clock_cycle();
    clock_cycle();
    clock_cycle();
    // Synchronize clock output and E clock input.
    while (clock_e() == LOW)
        clock_cycle();
    while (clock_e() != LOW)
        clock_cycle();
    // #RESET Low Pulse Width: min 3 E cycles
    cycle();
    // Mode Programming Setup Time: min 2 E cycles
    inject_mode(MPU_MODE);
    cycle();
    cycle();
    delayNanoseconds(tpcs_ns);
    negate_reset();
    Cycles::reset();
    // Mode Programming Hold Time: min MC6803:100ns HD6303:150ns
    release_mode();
    if (isHd63())
        cycle();
    cycle();
    // Read Reset vector
    cycle();
    cycle();
    // The first fetch takes the save's injected instructions.
    _regs->reset();
    _regs->save();
    _mems->write16(ArchMc6800::VEC_RESET, reset_vec);
    _regs->setIp(reset_vec);
    if (regs<RegsMc6801>()->checkSoftwareType() == SW_HD6301) {
        delete _inst;
        _inst = new hd6301::InstHd6301(_mems);
    }
}

mc6800::Signals *PinsMc6801::cycle() {
    delay<c1_lo_ns>();
    return rawCycle();
}

mc6800::Signals *PinsMc6801::rawCycle() {
    // E is EXTAL/4: one bus cycle is four EXTAL cycles, c1-c4.
    Signals::inputMode();
    // c1
    extal_hi();
    auto s = Signals::put();
    delay<c1_hi_ns>();
    // c2
    extal_lo();
    delay<c2_lo_ns>();
    s->getAddr();
    extal_hi();
    delay<c2_hi_ns>();
    s->getDirection();
    //  c3
    extal_lo();
    if (s->write()) {
        ++_writes;
        delay<c3_lo_write>();
        extal_hi();
        delay<c3_hi_write>();
        s->getData();
        // c4
        extal_lo();
        if (s->writeMemory()) {
            mems<MemsMc6801>()->write(s->addr, s->data);
            delay<c4_lo_write>();
        } else {
            delay<c4_lo_capture>();
        }
        extal_hi();
        Cycles::next();
        delay<c4_hi_write>();
    } else {
        if (s->readMemory()) {
            s->data = mems<MemsMc6801>()->read(s->addr);
            delay<c3_lo_read>();
        } else {
            delay<c3_lo_inject>();
        }
        extal_hi();
        delay<c3_hi_read>();
        s->setData();
        // c4
        extal_lo();
        Signals::outputMode();
        delay<c4_lo_read>();
        extal_hi();
        _writes = 0;
        Cycles::next();
        delay<c4_hi_read>();
    }
    // c1
    extal_lo();

    return s;
}

// The MC6801's BRA takes 3 cycles.
void PinsMc6801::idle() {
    auto s = Signals::put();
    s->inject(ArchMc6800::BRA);
    rawCycle();
    injectCycle(ArchMc6800::BRA_HERE);
    injectCycle(0);
    Cycles::discard(s);
}

bool PinsMc6801::isHd63() const {
    return digitalReadFast(PIN_XTAL) != LOW;
}

}  // namespace mc6801
}  // namespace debugger

// Local Variables:
// mode: c++
// c-basic-offset: 4
// tab-width: 4
// End:
// vim: set ft=cpp et ts=4 sw=4:
