tgtakaoka/retro-bionic/debugger/mc6800/pins_mc68hc11.cpp

#include "pins_mc68hc11.h"
#include "debugger.h"
#include "devs_mc68hc11.h"
#include "inst_mc68hc11.h"
#include "mc68hc11_init.h"
#include "mems_mc68hc11.h"
#include "regs_mc68hc11.h"
#include "signals_mc68hc11.h"

namespace debugger {
namespace mc68hc11 {

/**
 * MC68HC11 bus cycle.
 *       _    __    __    __    __    __    __    __    __    __
 * EXTAL  |_c|1 |_c|2 |_c|3 |_c|4 |_c|1 |_c|2 |_c|3 |_c|4 |_c|1 |_
 *            \     \  \___________\  \     \  \___________\  \
 *     E _____|______|_|           |__|_____|__|           |__|___
 *            |______|                |_____|                 |___
 *    AS _____|      |________________|     |_________________|
 *           _______________________                         _____
 *   R/W ---<                       |_______________________|
 *           _______________________ _______________________ _____
 *  Addr ---<_______________________X_______________________X_____
 *              _______       ________   _______   __________    _
 *  Data ------<___A___>-----<______R_>-<___A___>-<_______W__>--<_
 *
 * - EXTAL falling-edge to E edges takes 40ns.
 * - EXTAL rising-edge of c1 to AS edges takes 40ns.
 * - EXTAL falling-edge of c4 to R/W edges takes 100ns.
 * - EXTAL falling-edge to #LIR edges takes 40ns.
 * - R/W and non-muxed address are valid after 281.5ns of falling edge of E.
 * - R/W and non-muxed address are valid before rising edge of c1.
 * - Muxed address is valid before 151ns of falling edge of AS.
 * - Muxed address is valid until 95.4ns of falling edge of AS.
 * - Read data setup to falling E edge is 30ns.
 * - Read data hold to falling E edge is 145.5ns.
 * - Write data gets valid after 190.5ns of rising E edge.
 */

namespace {

//  fXTAL: max   4.0 MHz
//   tCYC: min 1,000 ns
// pwRSTL: min 8,000 ns; reset_lo width
//   tMPH: min 2,000 ns: mode setup to reset_hi
//  pwIRQ: min 1,020 ns: irq_lo width
//  tPWEL: min   477 ns: e_lo
//  tPWEH: min   472 ns: e_hi
//    tAV: min   282 ns: high-addr to e_hi
//   tDSR: min   146 ns: data to e_lo
//   tDDW: max   191 ns: e_hi to data
//   tDHW: min    96 ns: e_lo to data hold
//   tAVM: min   272 ns: muxed-addr to e_hi
//   tASL: min   151 ns: muxed-addr to as_lo
//   tAHL: min    95 ns: as_lo to muxed-addr hold
//   tASD: min   116 ns: e_lo to as_hi
//  pwASH: min:  221 ns: as_hi
//  tASED: min   116 ns: as_lo to e_hi
//   tMAD: min   145 ns: el_lo to muxed-addr
//  tPCSU: min   300 ns; processor control setup to e_lo
constexpr auto extal_e_ns = 50;
constexpr auto extal_hi_ns = 100;  // 125
constexpr auto extal_lo_ns = 100;  // 125
enum Delay : uint8_t {
    c1_lo_ns,       // 125
    c1_hi_ns,       // 125
    c2_lo_ns,       // 125
    c2_hi_read,     // 125
    c3_lo_read,     // 125
    c3_lo_inject,   // 125
    c3_hi_read,     // 125
    c4_lo_read,     // 125
    c4_hi_read,     // 125
    c2_hi_write,    // 125
    c3_lo_write,    // 125
    c3_hi_write,    // 125
    c4_lo_write,    // 125
    c4_lo_capture,  // 125
    c4_hi_write,    // 125
    DELAYS,
};
// Long enough that no E cycle runs under tCYC, nor EXTAL faster than fXTAL,
// the 1 MHz part's.
constexpr uint16_t DELAYS_NS[DELAYS] = {
        60, 121, 87, 84, 60, 109, 60, 96, 66, 72, 95, 90, 60, 107, 77};
// 2 MHz part: E 1.55 MHz, EXTAL under 8 MHz on the bench.
// constexpr uint16_t DELAYS_NS[DELAYS] = {
//         1, 36, 26, 25, 0, 32, 18, 29, 20, 21, 28, 27, 1, 32, 23};
constexpr auto tpcsu = 300;

inline void extal_hi() {
    digitalWriteFast(PIN_EXTAL, HIGH);
}

inline void extal_lo() {
    digitalWriteFast(PIN_EXTAL, LOW);
}

inline void extal_cycle() {
    delayNanoseconds(extal_lo_ns);
    extal_hi();
    delayNanoseconds(extal_hi_ns);
    extal_lo();
}

inline auto clock_e() {
    return digitalReadFast(PIN_E);
}

// STOP freezes E until an interrupt restarts the clock, which may come back
// at another phase against EXTAL; walk EXTAL until E falls again.
void resync_e() {
    for (auto n = 0; clock_e() == LOW; ++n) {
        if (n >= 16)
            return;  // still stopped
        extal_cycle();
        delayNanoseconds(extal_e_ns);
    }
    while (clock_e() != LOW) {
        extal_cycle();
        delayNanoseconds(extal_e_ns);
    }
}

inline auto reset_signal() {
    return digitalReadFast(PIN_RESET);
}

inline void assert_reset() {
    digitalWriteFast(PIN_RESET, LOW);
    pinMode(PIN_RESET, OUTPUT_OPENDRAIN);
}

inline void negate_reset() {
    pinMode(PIN_RESET, INPUT_PULLUP);
}

constexpr uint8_t PINS_LOW[] = {
        PIN_EXTAL,
};

constexpr uint8_t PINS_HIGH[] = {
        PIN_IRQ,
        PIN_MODB,
};

constexpr uint8_t PINS_PULLUP[] = {
        PIN_RESET,  // bi-directional
        PIN_NMI,
        PIN_MODA,
};

constexpr uint8_t PINS_INPUT[] = {
        PIN_AD0,
        PIN_AD1,
        PIN_AD2,
        PIN_AD3,
        PIN_AD4,
        PIN_AD5,
        PIN_AD6,
        PIN_AD7,
        PIN_ADDR8,
        PIN_ADDR9,
        PIN_ADDR10,
        PIN_ADDR11,
        PIN_ADDR12,
        PIN_ADDR13,
        PIN_ADDR14,
        PIN_ADDR15,
        PIN_RW,
        PIN_AS,
        PIN_E,
};

void inject_mode() {
    // Inject MODB=H, MODA=H
    digitalWriteFast(PIN_MODB, HIGH);
    pinMode(PIN_MODA, INPUT_PULLUP);
}

void release_mode() {
    // PIN_MODB is now Vstby
    digitalWriteFast(PIN_MODB, HIGH);
    // PIN_MODA is now PIN_LIR
    pinMode(PIN_MODA, INPUT_PULLUP);
}

}  // namespace

PinsMc68hc11::PinsMc68hc11(Mc68hc11Init &init) : _init(init) {
    auto regs = new RegsMc68hc11(this, init);
    auto devs = new DevsMc68hc11(init);
    _regs = regs;
    _devs = devs;
    _mems = new MemsMc68hc11(regs, devs, init);
    _inst = new InstMc68hc11(_mems);
}

template <uint8_t F>
inline void PinsMc68hc11::delay() const {
    if constexpr (DELAYS_NS[F] != 0)
        delayNanoseconds(DELAYS_NS[F]);
}

void PinsMc68hc11::resetPins() {
    // Assert reset condition
    pinsMode(PINS_LOW, sizeof(PINS_LOW), OUTPUT, LOW);
    pinsMode(PINS_HIGH, sizeof(PINS_HIGH), OUTPUT, HIGH);
    pinsMode(PINS_PULLUP, sizeof(PINS_PULLUP), INPUT_PULLUP);
    pinsMode(PINS_INPUT, sizeof(PINS_INPUT), INPUT);

    // The save injects into the first fetch, so it must be external: the
    // CPU answers an internal address itself. Start at 8000H until then.
    const auto reset_vec = _mems->read16(InstMc68hc11::VEC_RESET);
    _mems->write16(InstMc68hc11::VEC_RESET, 0x8000);

    // To get out from Clock Monitor Reset, inject EXTAL pulses
    while (reset_signal() == LOW) {
        negate_reset();
        extal_cycle();
    }
    assert_reset();

    // Synchronize clock output and E clock input.
    while (clock_e() == LOW) {
        extal_cycle();
        delayNanoseconds(extal_e_ns);
    }
    while (clock_e() != LOW) {
        extal_cycle();
        delayNanoseconds(extal_e_ns);
    }
    // #RESET should be at least 8 cycles
    for (auto i = 0; i < 8; i++)
        cycle();

    // Mode Programming Setup Time for #RESET rising is 2 E cycles at minimum.
    inject_mode();
    cycle();
    cycle();
    cycle();
    delayNanoseconds(tpcsu);
    negate_reset();
    Cycles::reset();
    // Mode Programming Hold Time: min 10ns
    release_mode();
    cycle();
    // Read Reset vector
    cycle();
    cycle();
    // The first fetch takes the save's injected instructions.
    _regs->reset();
    _regs->save();
    _init.configSystem(regs<RegsMc68hc11>());
    regs<RegsMc68hc11>()->checkSoftwareType();
    _mems->write16(InstMc68hc11::VEC_RESET, reset_vec);
    _regs->setIp(reset_vec);
}

mc6800::Signals *PinsMc68hc11::cycle() {
    delay<c1_lo_ns>();
    return rawCycle();
}

mc6800::Signals *PinsMc68hc11::rawCycle() {
    // E is EXTAL/4: one bus cycle is four EXTAL cycles, c1-c4.
    // C1H
    Signals::inputMode();
    extal_hi();
    delay<c1_hi_ns>();
    // C2L
    extal_lo();
    auto s = Signals::put();
    delay<c2_lo_ns>();
    s->getAddr();
    // C2H
    extal_hi();
    s->getDirection();
    if (s->read()) {
        _writes = 0;
        delay<c2_hi_read>();
        // C3L
        extal_lo();
        if (s->readMemory()) {
            s->data = mems<MemsMc68hc11>()->read(s->addr);
            delay<c3_lo_read>();
        } else {
            delay<c3_lo_inject>();
        }
        // C3H
        extal_hi();
        s->outData();
        delay<c3_hi_read>();
        // C4L
        extal_lo();
        delay<c4_lo_read>();
        s->getControl();
        // E low where it must be high: a STOP froze it or shifted its
        // phase; stopped() resyncs.
        if (clock_e() == LOW)
            return stopped(s);
        // C4H
        extal_hi();
        Cycles::next();
        delay<c4_hi_read>();
    } else {
        ++_writes;
        delay<c2_hi_write>();
        // C3L
        extal_lo();
        delay<c3_lo_write>();
        s->getControl();
        // C3H
        extal_hi();
        delay<c3_hi_write>();
        if (clock_e() == LOW) {
            --_writes;
            return stopped(s);
        }
        s->getData();
        // C4L
        extal_lo();
        if (s->writeMemory()) {
            mems<MemsMc68hc11>()->write(s->addr, s->data);
            delay<c4_lo_write>();
        } else {
            delay<c4_lo_capture>();
        }
        // C4H
        extal_hi();
        Cycles::next();
        delay<c4_hi_write>();
    }
    // C1L
    extal_lo();

    return s;
}

mc6800::Signals *PinsMc68hc11::stopped(Signals *s) {
    s->clearVma();
    extal_lo();
    Signals::inputMode();
    resync_e();
    Cycles::next();
    return s;
}

void PinsMc68hc11::printBacktrace() {
    const auto g = Signals::get();
    const auto cycles = g->diff(Signals::put());
    for (auto i = 0u; i < cycles;) {
        const auto s = g->next(i);
        if (s->fetch()) {
            const auto len = _mems->disassemble(s->addr, 1) - s->addr;
            // print bus cycles other than instruction bytes
            for (uint_fast8_t j = 1; j < len; j++) {
                const auto t = s->next(j);
                if (t->addr < s->addr || t->addr >= s->addr + len)
                    t->print();
            }
            i += len;
        } else {
            s->print();
            ++i;
        }
    }
}

}  // namespace mc68hc11
}  // namespace debugger

// Local Variables:
// mode: c++
// c-basic-offset: 4
// tab-width: 4
// End:
// vim: set ft=cpp et ts=4 sw=4:
