tgtakaoka/retro-bionic/debugger/mc6800/pins_mc6800_base.cpp

#include "pins_mc6800_base.h"
#include "debugger.h"
#include "inst_mc6800.h"
#include "mems_mc6800.h"
#include "regs_mc6800.h"
#include "signals_mc6800.h"

namespace debugger {
namespace mc6800 {

namespace {

// Longest instruction plus a context save, with margin.
constexpr auto SUSPEND_CYCLES = 64;

inline void assert_irq() {
    digitalWriteFast(PIN_IRQ, LOW);
}

inline void negate_irq() {
    digitalWriteFast(PIN_IRQ, HIGH);
}

inline bool irq_asserted() {
    return (*portOutputRegister(PIN_IRQ) & digitalPinToBitMask(PIN_IRQ)) == 0;
}

// Open drain: #NMI may also be wired to another source or a switch.
void assert_nmi() {
    pinMode(PIN_NMI, OUTPUT_OPENDRAIN);
    digitalWriteFast(PIN_NMI, LOW);
}

void negate_nmi() {
    pinMode(PIN_NMI, INPUT_PULLUP);
}

}  // namespace

Signals *PinsMc6800Base::injectCycle(uint8_t data) {
    Signals::put()->inject(data);
    return cycle();
}

void PinsMc6800Base::injectReads(
        const uint8_t *inst, uint8_t len, uint8_t cycles) {
    for (auto inj = 0; inj < len; ++inj) {
        injectCycle(inst[inj]);
    }
    for (auto inj = len; inj < cycles; ++inj) {
        injectCycle(ArchMc6800::NOP);
    }
}

void PinsMc6800Base::captureWrites(uint8_t *buf, uint8_t len, uint16_t *addr) {
    for (auto cap = 0; cap < len;) {
        auto s = Signals::put();
        s->capture();
        cycle();
        if (s->write()) {
            if (cap == 0 && addr)
                *addr = s->addr;
            buf[cap++] = s->data;
        }
    }
}

// A 4-cycle BRA $ keeps the PC while the bus stays clocked; its cycles
// are dropped from the ring.
void PinsMc6800Base::idle() {
    auto s = Signals::put();
    s->inject(ArchMc6800::BRA);
    rawCycle();
    injectCycle(ArchMc6800::BRA_HERE);
    injectCycle(ArchMc6800::NOP);
    injectCycle(ArchMc6800::NOP);
    Cycles::discard(s);
}

#ifdef PROFILE_CYCLES
// For scripts/record-cycles.py: stop at any SWI, keep every cycle of it,
// and give up well before the ring wraps; the debug pin frames the run, to
// trigger a capture on.
void PinsMc6800Base::loop() {
    constexpr auto MAX_CYCLES = 96;
    _profileEnd = nullptr;
    assert_debug();
    for (auto n = 0;; ++n) {
        _devs->loop();
        rawCycle();
        if (_writes == regs<RegsMc6800>()->contextLength()) {
            const auto frame = Signals::put()->prev(_writes);
            if (nonVmaAfterContextSave())
                cycle();                  // non VMA cycle
            const auto vec_hi = cycle();  // read interrupt high(vector)
            if (vec_hi->addr == _inst->vec_swi()) {
                negate_debug();
                cycle();  // read interrupt low(vector)
                regs<RegsMc6800>()->capture(frame, false);
                // Match up to the SWI's opcode fetch, as the normal build does.
                _profileEnd = frame->prev(nonVmaAfterContextSave() ? 1 : 2);
                return;
            }
            _writes = 0;
        } else if (n >= MAX_CYCLES || haltSwitch()) {
            negate_debug();
            cli.println(n >= MAX_CYCLES ? "?cycles" : "?halt");
            suspend(true);
            return;
        }
    }
}
#else
void PinsMc6800Base::loop() {
    while (true) {
        const auto serviced = _devs->loop();
        cycle();
        // A context push: the vector read after it tells an SWI's.
        if (_writes == regs<RegsMc6800>()->contextLength()) {
            const auto frame = Signals::put()->prev(_writes);
            if (nonVmaAfterContextSave())
                cycle();                  // non VMA cycle
            const auto vec_hi = cycle();  // read interrupt high(vector)
            const auto vec_swi = _inst->vec_swi();
            if (vec_hi->addr == vec_swi) {
                cycle();  // read interrupt low(vector)
                const auto pc = regs<RegsMc6800>()->capture(frame, false);
                const auto swi_vector = _mems->read16(vec_swi);
                // An SWI vector pointing at itself is a program's halt to
                // system.
                if (isBreakPoint(pc) || swi_vector == vec_swi) {
                    const auto discard = nonVmaAfterContextSave() ? 1 : 2;
                    Cycles::discard(frame->prev(discard));
                    return;
                }
            }
            // WAI idles on non-VMA cycles, which leave _writes as is.
            _writes = 0;
        } else if (serviced && haltSwitch()) {
            suspend(true);
            return;
        }
    }
}
#endif

void PinsMc6800Base::suspend(bool show) {
    assert_nmi();
reentry:
    _writes = 0;
    // Wait for the NMI's context push, a write per stacked byte.
    for (auto n = 0; _writes < regs<RegsMc6800>()->contextLength(); ++n) {
        const auto s = cycle();
        if (s->valid() && s->read() && s->addr == _inst->vec_nmi()) {
            // In WAI the context is already stacked, so NMI fetches its
            // vector without pushing. RTI back out of WAI, then take a
            // fresh NMI edge.
            negate_nmi();
            cycle();  // NMI lo(vector)
            injectCycle(ArchMc6800::RTI);
            assert_nmi();
            goto reentry;
        }
        if (n >= SUSPEND_CYCLES) {
            negate_nmi();
            cli.println("?halt: no context saved");
            return;
        }
    }
    // Capture registers pushed onto stack.
    const auto frame = Signals::put()->prev(_writes);
    // A push by WAI is followed by idle cycles until the NMI is taken,
    // so find the vector read rather than counting cycles to it.
    const Signals *v;
    for (auto n = 0;; ++n) {
        v = cycle();
        if (v->valid() && v->read() &&
                (v->addr == _inst->vec_swi() || v->addr == _inst->vec_nmi()))
            break;
        if (n >= SUSPEND_CYCLES) {
            negate_nmi();
            cli.println("?halt: no vector fetched");
            return;
        }
    }
    negate_nmi();
    // An SWI pushed first: give NMI a fresh edge and wait for its push.
    if (v->addr == _inst->vec_swi()) {
        assert_nmi();
        cycle();  // SWI lo(vector);
        goto reentry;
    }
    cycle();  // NMI lo(vector)
    regs<RegsMc6800>()->capture(frame);
    if (show) {
        const auto discard = nonVmaAfterContextSave() ? 1 : 2;
        Cycles::discard(frame->prev(discard));
    }
}

void PinsMc6800Base::run() {
    _regs->restore();
    Cycles::reset();
    saveBreakInsts();
    startRunTimer();
    loop();
    stopRunTimer();
    restoreBreakInsts();
    disassembleCycles();
}

bool PinsMc6800Base::step(bool show) {
    Cycles::reset();
    _regs->restore();
    if (show)
        Cycles::reset();
    // A pending IRQ the restored CC lets in starts its entry before any
    // instruction, and an NMI raised now would take the vector: let the
    // IRQ fetch its vector first.
    if (irq_asserted() && !regs<RegsMc6800>()->irqMasked()) {
        for (auto n = 0; n < SUSPEND_CYCLES; ++n) {
            const auto s = cycle();
            if (s->valid() && s->read() && s->addr == _inst->vec_irq())
                break;
        }
    }
    suspend(show);
    if (show)
        printCycles(Signals::put()->prev());
    return true;
}

void PinsMc6800Base::assertInt(uint8_t) {
    assert_irq();
}

void PinsMc6800Base::negateInt(uint8_t) {
    negate_irq();
}

void PinsMc6800Base::setBreakInst(uint32_t addr) const {
    _mems->put_prog(addr, ArchMc6800::SWI);
};

void PinsMc6800Base::printCycles(const Signals *end) {
    const auto g = Signals::get();
    const auto cycles = g->diff(end ? end : Signals::put());
    for (auto i = 0u; i < cycles; ++i) {
        const auto s = g->next(i);
        if (s == end)
            break;
        s->print();
        idle();
    }
}

// The ring's last cycle is the next fetch: ArchMc6800 walks no
// instruction from it.
const Signals *PinsMc6800Base::findFetch(Signals *begin, const Signals *end) {
    _inst->setIdle(
            [](void *pins) { static_cast<PinsMc6800Base *>(pins)->idle(); },
            this);
    auto &walker = MatchWalker::shared();
    if (!walker.walk(*_inst, begin, end))
        return end;
    return begin->next(walker.start());
}

// findFetch() marks the fetch() cycles as it walks the ring, so it runs
// before backtraceStartFrom() counts them; printBacktrace() runs it again
// and derives the same marks.
const SignalsImpl *PinsMc6800Base::findBacktraceStart() {
    const auto end = Signals::put();
    // Make room for idle cycles -- see printBacktrace().
    const auto begin = findFetch(Signals::get()->next(4), end);
    return backtraceStartFrom<Signals>(begin, _lineLimit);
}

void PinsMc6800Base::printBacktrace() {
    const auto end = Signals::put();
#ifdef PROFILE_CYCLES
    // Every cycle, with the marks the matcher gives them; a run's first
    // cycle is its opcode fetch.
    findFetch(Signals::get(), _profileEnd ? _profileEnd : end);
    printCycles(end);
#else
    // Skip the 4 oldest cycles: each idle() writes 4 past the ring's end,
    // over them.
    const auto begin = findFetch(Signals::get()->next(4), end);
    printCycles(begin);
    const auto cycles = begin->diff(end);
    if (Debugger.verbose()) {
        // Every cycle in order, an instruction's line before its fetch.
        for (auto i = 0u; i < cycles; ++i) {
            const auto s = begin->next(i);
            if (s->fetch())
                _mems->disassemble(s->addr, 1);
            s->print();
            idle();
        }
        return;
    }
    const Signals *pref = nullptr;
    for (auto i = 0u; i < cycles;) {
        const auto s = begin->next(i);
        if (pref || s->fetch()) {
            const auto f = pref ? pref : s;
            const auto nexti = _mems->disassemble(f->addr, 1);
            const auto len = nexti - f->addr - (pref ? 1 : 0);
            const auto matched = f->matched();
            pref = nullptr;
            for (auto j = len; j < matched; ++j) {
                const auto p = s->next(j);
                p->print();
                if (p->fetch())
                    pref = p;
            }
            i += matched;
        } else {
            if (s->valid())
                s->print();
            ++i;
        }
        idle();
    }
#endif
}

}  // namespace mc6800
}  // namespace debugger

// Local Variables:
// mode: c++
// c-basic-offset: 4
// tab-width: 4
// End:
// vim: set ft=cpp et ts=4 sw=4:
