tgtakaoka/retro-bionic/(commit log)

2024-04-10 [MC68HC11D] Fix mode injection and tune bus cycles
    [pins_mc68hc11.cpp, pins_mc68hc11.h]
2024-04-10 [MC68HC11A] Add MC68HC11A variant
    [bionic-mc68hc11a.kicad_pcb, bionic-mc68hc11a.kicad_sch]
2024-04-10 [MC68HC11D] Update schematics
    Connect PAx and PDx
    [bionic-mc68hc11d.kicad_pcb, bionic-mc68hc11d.kicad_sch]
2024-05-01 [SCN2650] Read control signals as bus
    Assign control signals, M/#IO, #R/W and INTACK to P9 and read those
    signals at once.
    [LED_CSL1901UW1_ROM.step, SOT-23_MC_MCH.step, bionic-scn2650.kicad_pcb, bionic-scn2650.kicad_sch]
2024-05-01 [P8085] Read control signals as bus
    Assign control signals, S0, S1, #RD, #WR and #INTA to P9 and read
    those signals at once.
    [LED_CSL1901UW1_ROM.step, SOT-23_MC_MCH.step, bionic-p8085.kicad_pcb, bionic-p8085.kicad_sch]
2024-05-01 [CDP1802] Read control signals as bus
    Assign control signals, SC0, SC1, #MRD and #MWR to P9 and read those
    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
    [LED_CSL1901UW1_ROM.step, SOT-23_MC_MCH.step, bionic-cdp1802.kicad_pcb, bionic-cdp1802.kicad_sch]
2024-05-01 [P8048] Support P8048
    [LED_CSL1901UW1_ROM.step, SOT-23_MC_MCH.step, bionic-p8048.kicad_pcb, bionic-p8048.kicad_sch]
2024-05-01 [Z8] Unify Z86 and Z88 debugger
    [LED_CSL1901UW1_ROM.step, SOT-23_MC_MCH.step, bionic-z8691.kicad_pcb, bionic-z8691.kicad_sch, bionic-z8800.kicad_pcb, bionic-z8800.kicad_sch]
2024-05-01 Fix serial handler to be disabled while in idle
    [debugger.cpp, debugger.h, device.h, devs.h, devs_cdp1802.cpp, devs_cdp1802.h, devs_i8085.cpp, devs_i8085.h]
2024-05-01 [TMP90C802] Read control signals as bus
    [LED_CSL1901UW1_ROM.step, SOT-23_MC_MCH.step, bionic-tmp90c802.kicad_pcb, bionic-tmp90c802.kicad_sch]
2024-05-01 [INS8070] Read control signals as bus
    [LED_CSL1901UW1_ROM.step, SOT-23_MC_MCH.step, bionic-ins8070.kicad_pcb, bionic-ins8070.kicad_sch]
2024-05-01 [MOS6502] Read control signals as bus
    [LED_CSL1901UW1_ROM.step, SOT-23_MC_MCH.step, bionic-mos6502.kicad_pcb, bionic-mos6502.kicad_sch]
2024-05-02 [debugger] Add verbose option to Reset command
    [debugger.cpp, debugger.h, pins.h, pins_cdp1802.cpp, pins_cdp1802.h, pins_f3850.cpp, pins_f3850.h, pins_i8048.h]
2024-05-02 [MC6809] Fix ORCC/ANDCC bus cycles
    [pins_mc6809.cpp]
2024-05-02 [MC6809] Fix DIVD/DIVQ/MULD bus cycles
    [pins_mc6809.cpp]
2024-05-04 [MC6809] Fix capture context
    [mems.cpp, pins_mc6809.cpp, pins_mc6809e.cpp]
2024-05-08 [MOS6502] Add W65C816 E signal to control bus
    [bionic-mos6502.kicad_pcb, bionic-mos6502.kicad_sch]
2024-05-08 [MC6802] Fix target config
    [pins_mc6800.cpp]
2024-05-09 [MC68HC11] Fix disassemble cycles of BRxxx instruction
    [pins_mc68hc11.cpp]
2024-05-09 [MC68xx] Read control signals as bus
    [bionic-mc6800.kicad_pcb, bionic-mc6800.kicad_sch, bionic-mc6801.kicad_pcb, bionic-mc6801.kicad_sch, bionic-mc6802.kicad_pcb, bionic-mc6802.kicad_sch, bionic-mc6809.kicad_pcb, bionic-mc6809.kicad_sch]
2024-05-11 [MOS6502] Fix bus conflict with W65C816 bank address
    [bionic-mos6502.kicad_pcb, bionic-mos6502.kicad_sch]
2024-05-11 [INS8060] Add power LED
    [LED_CSL1901UW1_ROM.step, SOT-23_MC_MCH.step, bionic-ins8060.kicad_pcb, bionic-ins8060.kicad_sch]
2024-05-11 [F3850] Add power LED
    [LED_CSL1901UW1_ROM.step, SOT-23_MC_MCH.step, bionic-f3850.kicad_pcb, bionic-f3850.kicad_sch]
2024-05-25 [P8051] Support P8051
    [DBV0005A.stp, LED_CSL1901UW1_ROM.step, SOT-23_MC_MCH.step, bionic-p8051.kicad_pcb, bionic-p8051.kicad_sch]
2024-05-29 [debugger] Fix break on consecutive break points
    [debugger.cpp]
2024-05-29 [i8085] Fix I/O read/write access
    [pins_i8085.cpp, regs_i8085.cpp]
2024-05-29 [samples] Optimize echoitr
2024-06-01 [Z80] Support Z80
    [bionic-z80.kicad_pcb, bionic-z80.kicad_sch]
2024-06-12 [samples] Cleanup mandelbrot C reference sourece
2024-06-16 [MOS6502] Remove unnecessary info from Signals::print
2024-06-17 [MC6809E] Fix finding instruction fetch
    [pins_mc6809.cpp, pins_mc6809e.cpp]
2024-06-17 [MC6809] Improve register print
2024-06-18 [MOS6502] Fix to use W65C816 memory
    [pins_mos6502.cpp]
2024-06-18 [samples] Fix typos in comments
2024-06-21 [Base] Add bus-terminaters
    [D0014A.stp, PW0020A.stp, base.kicad_pcb, base.kicad_sch, universal.kicad_pcb, universal.kicad_sch]
2024-06-21 [MOS6502] Turns bus to input before phi0 edge
    Bus hold circuit retains output data until bank address of next bus
    cycle of W65C816.
2024-06-26 [TMS7000] Update schematics
    [bionic-tms7000.kicad_pcb, bionic-tms7000.kicad_sch]
2024-10-21 [samples] compatible with libasm 1.6.48
2024-10-21 Add SerialUSB1 as logger printer
2024-10-25 [Base] Add USB-C Power connector
    [248-1282-00-0602J.step, Keystone 5000.step, Keystone 5001.step, Keystone 5002.step, Keystone 5003.step, Keystone 5004.step, Keystone 5115.step, Keystone 5116.step]
2024-10-25 [schematics] Make board edges round
    [LED_CSL1901UW1_ROM.step, SOT-23_MC_MCH.step, bionic-cdp1802.kicad_pcb, bionic-f3850.kicad_pcb, bionic-ins8060.kicad_pcb, bionic-ins8070.kicad_pcb, bionic-mc146805e2.kicad_pcb, bionic-mc146805e2.kicad_sch]
2024-10-25 [gerber] Generate Gerber data files fo JLPCB
    [base-B_Cu.gbr, base-B_Mask.gbr, base-B_Paste.gbr, base-B_Silkscreen.gbr, base-Edge_Cuts.gbr, base-F_Cu.gbr, base-F_Mask.gbr, base-F_Paste.gbr]
2024-10-25 [P8085] Connect RESET OUT pin
    [bionic-p8085-B_Cu.gbr, bionic-p8085-B_Mask.gbr, bionic-p8085-B_Paste.gbr, bionic-p8085-B_Silkscreen.gbr, bionic-p8085-Edge_Cuts.gbr, bionic-p8085-F_Cu.gbr, bionic-p8085-F_Mask.gbr, bionic-p8085-F_Paste.gbr]
2024-11-14 [Base] Change mount hale to M3
    [base-B_Cu.gbr, base-B_Mask.gbr, base-B_Paste.gbr, base-B_Silkscreen.gbr, base-Edge_Cuts.gbr, base-F_Cu.gbr, base-F_Mask.gbr, base-F_Paste.gbr]
2024-11-14 [CDP1802] Fix EEPROM pinout
    [bionic-cdp1802-B_Cu.gbr, bionic-cdp1802-B_Mask.gbr, bionic-cdp1802-B_Paste.gbr, bionic-cdp1802-B_Silkscreen.gbr, bionic-cdp1802-Edge_Cuts.gbr, bionic-cdp1802-F_Cu.gbr, bionic-cdp1802-F_Mask.gbr, bionic-cdp1802-F_Paste.gbr]
2024-11-14 [F3850] Fix EEPROM pinout
    [bionic-f3850-B_Cu.gbr, bionic-f3850-B_Mask.gbr, bionic-f3850-B_Paste.gbr, bionic-f3850-B_Silkscreen.gbr, bionic-f3850-Edge_Cuts.gbr, bionic-f3850-F_Cu.gbr, bionic-f3850-F_Mask.gbr, bionic-f3850-F_Paste.gbr]
2024-11-14 [INS8060] Fix EEPROM pinout
    [bionic-ins8060-B_Cu.gbr, bionic-ins8060-B_Mask.gbr, bionic-ins8060-B_Paste.gbr, bionic-ins8060-B_Silkscreen.gbr, bionic-ins8060-Edge_Cuts.gbr, bionic-ins8060-F_Cu.gbr, bionic-ins8060-F_Mask.gbr, bionic-ins8060-F_Paste.gbr]
2024-11-14 [INS8070] Fix EEPROM pinout
    [bionic-ins8070-B_Cu.gbr, bionic-ins8070-B_Mask.gbr, bionic-ins8070-B_Paste.gbr, bionic-ins8070-B_Silkscreen.gbr, bionic-ins8070-Edge_Cuts.gbr, bionic-ins8070-F_Cu.gbr, bionic-ins8070-F_Mask.gbr, bionic-ins8070-F_Paste.gbr]
2024-11-14 [MC68HC11A] Fix EEPROM pinout
    [bionic-mc68hc11a-B_Cu.gbr, bionic-mc68hc11a-B_Mask.gbr, bionic-mc68hc11a-B_Paste.gbr, bionic-mc68hc11a-B_Silkscreen.gbr, bionic-mc68hc11a-Edge_Cuts.gbr, bionic-mc68hc11a-F_Cu.gbr, bionic-mc68hc11a-F_Mask.gbr, bionic-mc68hc11a-F_Paste.gbr]
2024-11-14 [MC68HC11D] Fix EEPROM pinout
    [bionic-mc68hc11d-B_Cu.gbr, bionic-mc68hc11d-B_Mask.gbr, bionic-mc68hc11d-B_Paste.gbr, bionic-mc68hc11d-B_Silkscreen.gbr, bionic-mc68hc11d-Edge_Cuts.gbr, bionic-mc68hc11d-F_Cu.gbr, bionic-mc68hc11d-F_Mask.gbr, bionic-mc68hc11d-F_Paste.gbr]
2024-11-14 [MC6800] Fix EEPROM pinout
    [bionic-mc6800-B_Cu.gbr, bionic-mc6800-B_Mask.gbr, bionic-mc6800-B_Paste.gbr, bionic-mc6800-B_Silkscreen.gbr, bionic-mc6800-Edge_Cuts.gbr, bionic-mc6800-F_Cu.gbr, bionic-mc6800-F_Mask.gbr, bionic-mc6800-F_Paste.gbr]
2024-11-14 [MC6801] Fix EEPROM pinout
    [bionic-mc6801-B_Cu.gbr, bionic-mc6801-B_Mask.gbr, bionic-mc6801-B_Paste.gbr, bionic-mc6801-B_Silkscreen.gbr, bionic-mc6801-Edge_Cuts.gbr, bionic-mc6801-F_Cu.gbr, bionic-mc6801-F_Mask.gbr, bionic-mc6801-F_Paste.gbr]
2024-11-14 [MC6802] Fix EEPROM pinout
    [bionic-mc6802-B_Cu.gbr, bionic-mc6802-B_Mask.gbr, bionic-mc6802-B_Paste.gbr, bionic-mc6802-B_Silkscreen.gbr, bionic-mc6802-Edge_Cuts.gbr, bionic-mc6802-F_Cu.gbr, bionic-mc6802-F_Mask.gbr, bionic-mc6802-F_Paste.gbr]
2024-11-14 [MC6809] Fix EEPROM pinout
    [bionic-mc6809-B_Cu.gbr, bionic-mc6809-B_Mask.gbr, bionic-mc6809-B_Paste.gbr, bionic-mc6809-B_Silkscreen.gbr, bionic-mc6809-Edge_Cuts.gbr, bionic-mc6809-F_Cu.gbr, bionic-mc6809-F_Mask.gbr, bionic-mc6809-F_Paste.gbr]
2024-11-14 [MC6809E] Fix EEPROM pinout
    [bionic-mc6809e-B_Cu.gbr, bionic-mc6809e-B_Mask.gbr, bionic-mc6809e-B_Paste.gbr, bionic-mc6809e-B_Silkscreen.gbr, bionic-mc6809e-Edge_Cuts.gbr, bionic-mc6809e-F_Cu.gbr, bionic-mc6809e-F_Mask.gbr, bionic-mc6809e-F_Paste.gbr]
2024-11-14 [MC146805E2] Fix EEPROM pinout
    [bionic-mc146805e2-B_Cu.gbr, bionic-mc146805e2-B_Mask.gbr, bionic-mc146805e2-B_Paste.gbr, bionic-mc146805e2-B_Silkscreen.gbr, bionic-mc146805e2-Edge_Cuts.gbr, bionic-mc146805e2-F_Cu.gbr, bionic-mc146805e2-F_Mask.gbr, bionic-mc146805e2-F_Paste.gbr]
2024-11-14 [MOS6502] Fix EEPROM pinout
    [bionic-mos6502-B_Cu.gbr, bionic-mos6502-B_Mask.gbr, bionic-mos6502-B_Paste.gbr, bionic-mos6502-B_Silkscreen.gbr, bionic-mos6502-Edge_Cuts.gbr, bionic-mos6502-F_Cu.gbr, bionic-mos6502-F_Mask.gbr, bionic-mos6502-F_Paste.gbr]
2024-11-14 [P8048] Fix EEPROM pinout
    [bionic-p8048-B_Cu.gbr, bionic-p8048-B_Mask.gbr, bionic-p8048-B_Paste.gbr, bionic-p8048-B_Silkscreen.gbr, bionic-p8048-Edge_Cuts.gbr, bionic-p8048-F_Cu.gbr, bionic-p8048-F_Mask.gbr, bionic-p8048-F_Paste.gbr]
2024-11-14 [P8051] Fix EEPROM pinout
    [bionic-p8051-B_Cu.gbr, bionic-p8051-B_Mask.gbr, bionic-p8051-B_Paste.gbr, bionic-p8051-B_Silkscreen.gbr, bionic-p8051-Edge_Cuts.gbr, bionic-p8051-F_Cu.gbr, bionic-p8051-F_Mask.gbr, bionic-p8051-F_Paste.gbr]
2024-11-14 [P8085] Fix EEPROM pinout
    [bionic-p8085-B_Cu.gbr, bionic-p8085-B_Mask.gbr, bionic-p8085-B_Paste.gbr, bionic-p8085-B_Silkscreen.gbr, bionic-p8085-Edge_Cuts.gbr, bionic-p8085-F_Cu.gbr, bionic-p8085-F_Mask.gbr, bionic-p8085-F_Paste.gbr]
2024-11-14 [SCN2650] Fix EEPROM pinout
    [bionic-scn2650-B_Cu.gbr, bionic-scn2650-B_Mask.gbr, bionic-scn2650-B_Paste.gbr, bionic-scn2650-B_Silkscreen.gbr, bionic-scn2650-Edge_Cuts.gbr, bionic-scn2650-F_Cu.gbr, bionic-scn2650-F_Mask.gbr, bionic-scn2650-F_Paste.gbr]
2024-11-14 [TMP90C802] Fix EEPROM pinout
    [bionic-tmp90c802-B_Cu.gbr, bionic-tmp90c802-B_Mask.gbr, bionic-tmp90c802-B_Paste.gbr, bionic-tmp90c802-B_Silkscreen.gbr, bionic-tmp90c802-Edge_Cuts.gbr, bionic-tmp90c802-F_Cu.gbr, bionic-tmp90c802-F_Mask.gbr, bionic-tmp90c802-F_Paste.gbr]
2024-11-14 [TMS7000] Fix EEPROM pinout
    [bionic-tms7000-B_Cu.gbr, bionic-tms7000-B_Mask.gbr, bionic-tms7000-B_Paste.gbr, bionic-tms7000-B_Silkscreen.gbr, bionic-tms7000-Edge_Cuts.gbr, bionic-tms7000-F_Cu.gbr, bionic-tms7000-F_Mask.gbr, bionic-tms7000-F_Paste.gbr]
2024-11-14 [Z80] Fix EEPROM pinout
    [bionic-z80-B_Cu.gbr, bionic-z80-B_Mask.gbr, bionic-z80-B_Paste.gbr, bionic-z80-B_Silkscreen.gbr, bionic-z80-Edge_Cuts.gbr, bionic-z80-F_Cu.gbr, bionic-z80-F_Mask.gbr, bionic-z80-F_Paste.gbr]
2024-11-14 [Z8691] Fix EEPROM pinout
    [bionic-z8691-B_Cu.gbr, bionic-z8691-B_Mask.gbr, bionic-z8691-B_Paste.gbr, bionic-z8691-B_Silkscreen.gbr, bionic-z8691-Edge_Cuts.gbr, bionic-z8691-F_Cu.gbr, bionic-z8691-F_Mask.gbr, bionic-z8691-F_Paste.gbr]
2024-11-14 [Z8800] Fix EEPROM pinout
    [bionic-z8800-B_Cu.gbr, bionic-z8800-B_Mask.gbr, bionic-z8800-B_Paste.gbr, bionic-z8800-B_Silkscreen.gbr, bionic-z8800-Edge_Cuts.gbr, bionic-z8800-F_Cu.gbr, bionic-z8800-F_Mask.gbr, bionic-z8800-F_Paste.gbr]
2024-11-14 [base] Fix push switch foot print
    [base-B_Cu.gbr, base-B_Mask.gbr, base-B_Paste.gbr, base-B_Silkscreen.gbr, base-Edge_Cuts.gbr, base-F_Cu.gbr, base-F_Mask.gbr, base-F_Paste.gbr]
2024-11-20 [TMS7000] Fix disassemble BTJxx bus cycles
    [pins_tms7000.cpp]
2024-11-24 [debugger] Defer Tx interrupt of UART emulator
    This prevents an Tx interrupt assertion just after negating Tx
    interrupt by sending a character. Those successive interrupts may not
    be recognized by the level sensing interrupt system of some CPUs.
    [i8251.cpp, mc6850.cpp, uart_base.cpp, uart_base.h]
2024-11-24 [TMS7000] Fix MC6850 Tx/Rx interrupts samples
2024-11-25 [base] Change test points to pin headers
    [base-B_Cu.gbr, base-B_Mask.gbr, base-B_Paste.gbr, base-B_Silkscreen.gbr, base-Edge_Cuts.gbr, base-F_Cu.gbr, base-F_Mask.gbr, base-F_Paste.gbr]
2024-11-26 [base] 4 Layers
    [base-B_Cu.gbr, base-B_Mask.gbr, base-B_Paste.gbr, base-B_Silkscreen.gbr, base-Edge_Cuts.gbr, base-F_Cu.gbr, base-F_Mask.gbr, base-F_Paste.gbr]
2024-11-28 [CDP1802] Shrink board size
    [bionic-cdp1802-B_Cu.gbr, bionic-cdp1802-B_Mask.gbr, bionic-cdp1802-B_Paste.gbr, bionic-cdp1802-B_Silkscreen.gbr, bionic-cdp1802-Edge_Cuts.gbr, bionic-cdp1802-F_Cu.gbr, bionic-cdp1802-F_Mask.gbr, bionic-cdp1802-F_Paste.gbr]
2024-12-04 [F3850] Shrink board size
    [bionic-f3850-B_Cu.gbr, bionic-f3850-B_Mask.gbr, bionic-f3850-B_Paste.gbr, bionic-f3850-B_Silkscreen.gbr, bionic-f3850-Edge_Cuts.gbr, bionic-f3850-F_Cu.gbr, bionic-f3850-F_Mask.gbr, bionic-f3850-F_Paste.gbr]
2024-12-04 [INS8060] Shrink board size
    [bionic-ins8060-B_Cu.gbr, bionic-ins8060-B_Mask.gbr, bionic-ins8060-B_Paste.gbr, bionic-ins8060-B_Silkscreen.gbr, bionic-ins8060-Edge_Cuts.gbr, bionic-ins8060-F_Cu.gbr, bionic-ins8060-F_Mask.gbr, bionic-ins8060-F_Paste.gbr]
2024-12-04 [INS8070] Shrink board size
    [bionic-ins8070-B_Cu.gbr, bionic-ins8070-B_Mask.gbr, bionic-ins8070-B_Paste.gbr, bionic-ins8070-B_Silkscreen.gbr, bionic-ins8070-Edge_Cuts.gbr, bionic-ins8070-F_Cu.gbr, bionic-ins8070-F_Mask.gbr, bionic-ins8070-F_Paste.gbr]
2024-12-04 [MC68HC11A] Shrink board size
    [bionic-mc68hc11a-B_Cu.gbr, bionic-mc68hc11a-B_Mask.gbr, bionic-mc68hc11a-B_Paste.gbr, bionic-mc68hc11a-B_Silkscreen.gbr, bionic-mc68hc11a-Edge_Cuts.gbr, bionic-mc68hc11a-F_Cu.gbr, bionic-mc68hc11a-F_Mask.gbr, bionic-mc68hc11a-F_Paste.gbr]
2024-12-04 [MC68HC11D] Shrink board size
    [bionic-mc68hc11d-B_Cu.gbr, bionic-mc68hc11d-B_Mask.gbr, bionic-mc68hc11d-B_Paste.gbr, bionic-mc68hc11d-B_Silkscreen.gbr, bionic-mc68hc11d-Edge_Cuts.gbr, bionic-mc68hc11d-F_Cu.gbr, bionic-mc68hc11d-F_Mask.gbr, bionic-mc68hc11d-F_Paste.gbr]
2024-12-04 [MC6800] Shrink board size
    [bionic-mc6800-B_Cu.gbr, bionic-mc6800-B_Mask.gbr, bionic-mc6800-B_Paste.gbr, bionic-mc6800-B_Silkscreen.gbr, bionic-mc6800-Edge_Cuts.gbr, bionic-mc6800-F_Cu.gbr, bionic-mc6800-F_Mask.gbr, bionic-mc6800-F_Paste.gbr]
2024-12-04 [MC6801] Shrink board size
    [bionic-mc6801-B_Cu.gbr, bionic-mc6801-B_Mask.gbr, bionic-mc6801-B_Paste.gbr, bionic-mc6801-B_Silkscreen.gbr, bionic-mc6801-Edge_Cuts.gbr, bionic-mc6801-F_Cu.gbr, bionic-mc6801-F_Mask.gbr, bionic-mc6801-F_Paste.gbr]
2024-12-04 [MC6802] Shrink board size
    [bionic-mc6802-B_Cu.gbr, bionic-mc6802-B_Mask.gbr, bionic-mc6802-B_Paste.gbr, bionic-mc6802-B_Silkscreen.gbr, bionic-mc6802-Edge_Cuts.gbr, bionic-mc6802-F_Cu.gbr, bionic-mc6802-F_Mask.gbr, bionic-mc6802-F_Paste.gbr]
2024-12-04 [MC6809] Shrink board size
    [bionic-mc6809-B_Cu.gbr, bionic-mc6809-B_Mask.gbr, bionic-mc6809-B_Paste.gbr, bionic-mc6809-B_Silkscreen.gbr, bionic-mc6809-Edge_Cuts.gbr, bionic-mc6809-F_Cu.gbr, bionic-mc6809-F_Mask.gbr, bionic-mc6809-F_Paste.gbr]
2024-12-04 [MC6809E] Shrink board size
    [bionic-mc6809e-B_Cu.gbr, bionic-mc6809e-B_Mask.gbr, bionic-mc6809e-B_Paste.gbr, bionic-mc6809e-B_Silkscreen.gbr, bionic-mc6809e-Edge_Cuts.gbr, bionic-mc6809e-F_Cu.gbr, bionic-mc6809e-F_Mask.gbr, bionic-mc6809e-F_Paste.gbr]
2024-12-04 [MC146805E2] Shrink board size
    [bionic-mc146805e2-B_Cu.gbr, bionic-mc146805e2-B_Mask.gbr, bionic-mc146805e2-B_Paste.gbr, bionic-mc146805e2-B_Silkscreen.gbr, bionic-mc146805e2-Edge_Cuts.gbr, bionic-mc146805e2-F_Cu.gbr, bionic-mc146805e2-F_Mask.gbr, bionic-mc146805e2-F_Paste.gbr]
2024-12-04 [MOS6502] Shrink board size
    [bionic-mos6502-B_Cu.gbr, bionic-mos6502-B_Mask.gbr, bionic-mos6502-B_Paste.gbr, bionic-mos6502-B_Silkscreen.gbr, bionic-mos6502-Edge_Cuts.gbr, bionic-mos6502-F_Cu.gbr, bionic-mos6502-F_Mask.gbr, bionic-mos6502-F_Paste.gbr]
2024-12-04 [P8048] Shrink board size
    [bionic-p8048-B_Cu.gbr, bionic-p8048-B_Mask.gbr, bionic-p8048-B_Paste.gbr, bionic-p8048-B_Silkscreen.gbr, bionic-p8048-Edge_Cuts.gbr, bionic-p8048-F_Cu.gbr, bionic-p8048-F_Mask.gbr, bionic-p8048-F_Paste.gbr]
2024-12-04 [P8051] Shrink board size
    [bionic-p8051-B_Cu.gbr, bionic-p8051-B_Mask.gbr, bionic-p8051-B_Paste.gbr, bionic-p8051-B_Silkscreen.gbr, bionic-p8051-Edge_Cuts.gbr, bionic-p8051-F_Cu.gbr, bionic-p8051-F_Mask.gbr, bionic-p8051-F_Paste.gbr]
2024-12-04 [P8085] Shrink board size
    [bionic-p8085-B_Cu.gbr, bionic-p8085-B_Mask.gbr, bionic-p8085-B_Paste.gbr, bionic-p8085-B_Silkscreen.gbr, bionic-p8085-Edge_Cuts.gbr, bionic-p8085-F_Cu.gbr, bionic-p8085-F_Mask.gbr, bionic-p8085-F_Paste.gbr]
2024-12-04 [SCN2650] Shrink board size
    [bionic-scn2650-B_Cu.gbr, bionic-scn2650-B_Mask.gbr, bionic-scn2650-B_Paste.gbr, bionic-scn2650-B_Silkscreen.gbr, bionic-scn2650-Edge_Cuts.gbr, bionic-scn2650-F_Cu.gbr, bionic-scn2650-F_Mask.gbr, bionic-scn2650-F_Paste.gbr]
2024-12-04 [TMP90C802] Shrink board size
    [bionic-tmp90c802-B_Cu.gbr, bionic-tmp90c802-B_Mask.gbr, bionic-tmp90c802-B_Paste.gbr, bionic-tmp90c802-B_Silkscreen.gbr, bionic-tmp90c802-Edge_Cuts.gbr, bionic-tmp90c802-F_Cu.gbr, bionic-tmp90c802-F_Mask.gbr, bionic-tmp90c802-F_Paste.gbr]
2024-12-04 [TMS7000] Shrink board size
    [bionic-tms7000-B_Cu.gbr, bionic-tms7000-B_Mask.gbr, bionic-tms7000-B_Paste.gbr, bionic-tms7000-B_Silkscreen.gbr, bionic-tms7000-Edge_Cuts.gbr, bionic-tms7000-F_Cu.gbr, bionic-tms7000-F_Mask.gbr, bionic-tms7000-F_Paste.gbr]
2024-12-04 [Z80] Shrink board size
    [bionic-z80-B_Cu.gbr, bionic-z80-B_Mask.gbr, bionic-z80-B_Paste.gbr, bionic-z80-B_Silkscreen.gbr, bionic-z80-Edge_Cuts.gbr, bionic-z80-F_Cu.gbr, bionic-z80-F_Mask.gbr, bionic-z80-F_Paste.gbr]
2024-12-04 [Z8691] Shrink board size and 4 layers
    [bionic-z8691-B_Cu.gbr, bionic-z8691-B_Mask.gbr, bionic-z8691-B_Paste.gbr, bionic-z8691-B_Silkscreen.gbr, bionic-z8691-Edge_Cuts.gbr, bionic-z8691-F_Cu.gbr, bionic-z8691-F_Mask.gbr, bionic-z8691-F_Paste.gbr]
2024-12-04 [Z8800] Shrink board size
    [bionic-z8800-B_Cu.gbr, bionic-z8800-B_Mask.gbr, bionic-z8800-B_Paste.gbr, bionic-z8800-B_Silkscreen.gbr, bionic-z8800-Edge_Cuts.gbr, bionic-z8800-F_Cu.gbr, bionic-z8800-F_Mask.gbr, bionic-z8800-F_Paste.gbr]
2024-12-04 [P8051] Fix P8051 footprint
    [bionic-p8051-B_Cu.gbr, bionic-p8051-B_Mask.gbr, bionic-p8051-B_Paste.gbr, bionic-p8051-B_Silkscreen.gbr, bionic-p8051-Edge_Cuts.gbr, bionic-p8051-F_Cu.gbr, bionic-p8051-F_Mask.gbr, bionic-p8051-F_Paste.gbr]
2024-12-04 [MOS6502] Improve PCB layout
    [bionic-mos6502-B_Cu.gbr, bionic-mos6502-B_Mask.gbr, bionic-mos6502-B_Paste.gbr, bionic-mos6502-B_Silkscreen.gbr, bionic-mos6502-Edge_Cuts.gbr, bionic-mos6502-F_Cu.gbr, bionic-mos6502-F_Mask.gbr, bionic-mos6502-F_Paste.gbr]
2024-12-04 [debugger] Rename Pins::reset and Pins::resetPins
    [pins.cpp, pins.h, pins_cdp1802.cpp, pins_cdp1802.h, pins_f3850.cpp, pins_f3850.h, pins_i8048.cpp, pins_i8048.h]
2024-12-04 [base] Reactor to 2 Layers
    [base-B_Cu.gbr, base-B_Mask.gbr, base-B_Paste.gbr, base-B_Silkscreen.gbr, base-Edge_Cuts.gbr, base-F_Cu.gbr, base-F_Mask.gbr, base-F_Paste.gbr]
2024-12-04 [INS8070] Fix SA/SB connections
    [bionic-ins8070-B_Cu.gbr, bionic-ins8070-B_Mask.gbr, bionic-ins8070-B_Paste.gbr, bionic-ins8070-B_Silkscreen.gbr, bionic-ins8070-Edge_Cuts.gbr, bionic-ins8070-F_Cu.gbr, bionic-ins8070-F_Mask.gbr, bionic-ins8070-F_Paste.gbr]
2024-12-04 [TMP90C802] Fix INT0/INT1 footprints
    [bionic-tmp90c802-B_Cu.gbr, bionic-tmp90c802-B_Mask.gbr, bionic-tmp90c802-B_Paste.gbr, bionic-tmp90c802-B_Silkscreen.gbr, bionic-tmp90c802-Edge_Cuts.gbr, bionic-tmp90c802-F_Cu.gbr, bionic-tmp90c802-F_Mask.gbr, bionic-tmp90c802-F_Paste.gbr]
2024-12-04 [Z8691] Fix IRQ0/IRQ1 connections
    [bionic-z8691-B_Cu.gbr, bionic-z8691-B_Mask.gbr, bionic-z8691-B_Paste.gbr, bionic-z8691-B_Silkscreen.gbr, bionic-z8691-Edge_Cuts.gbr, bionic-z8691-F_Cu.gbr, bionic-z8691-F_Mask.gbr, bionic-z8691-F_Paste.gbr]
2024-12-07 [NSC800] Update schematics
    [LED_CSL1901UW1_ROM.step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]
2024-12-07 [Z80] Support NSC800
    [bionic-nsc800.kicad_sch]
2024-12-07 [debugger] Fix Files to show a directory only
    [debugger.cpp]
2024-12-10 [base] Add power LED and Debug jumper
    [LED_CSL1901UW1_ROM.step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]
2024-12-10 [MC68HC11] Fix reset sequence
    [pins_mc68hc11.cpp]
2024-12-10 [schematics] Update LED footprint
    [bionic-cdp1802-B_Cu.gbr, bionic-cdp1802-B_Mask.gbr, bionic-cdp1802-B_Paste.gbr, bionic-cdp1802-B_Silkscreen.gbr, bionic-cdp1802-Edge_Cuts.gbr, bionic-cdp1802-F_Cu.gbr, bionic-cdp1802-F_Mask.gbr, bionic-cdp1802-F_Paste.gbr]
2024-12-10 [Z8691] Refactor to 2 Layers
    [bionic-z8691-B_Cu.gbr, bionic-z8691-B_Mask.gbr, bionic-z8691-B_Paste.gbr, bionic-z8691-B_Silkscreen.gbr, bionic-z8691-Edge_Cuts.gbr, bionic-z8691-F_Cu.gbr, bionic-z8691-F_Mask.gbr, bionic-z8691-F_Paste.gbr]
2024-12-10 [INS8060] Fix SENSE A/B connections
    [pins_ins8060.h]
2024-12-11 [F3850] Fix #INTREQ/#ICB connections
    [bionic-f3850.kicad_pcb, bionic-f3850.kicad_sch]
2024-12-11 [MC6801] Fix Vstby connection
    [bionic-mc6801-B_Cu.gbr, bionic-mc6801-B_Mask.gbr, bionic-mc6801-B_Paste.gbr, bionic-mc6801-B_Silkscreen.gbr, bionic-mc6801-Edge_Cuts.gbr, bionic-mc6801-F_Cu.gbr, bionic-mc6801-F_Mask.gbr, bionic-mc6801-F_Paste.gbr]
2024-12-18 [base] Add dummy road to 15V
    [base-B_Cu.gbr, base-B_Mask.gbr, base-B_Paste.gbr, base-B_Silkscreen.gbr, base-Edge_Cuts.gbr, base-F_Cu.gbr, base-F_Mask.gbr, base-F_Paste.gbr]
2024-12-18 [TLCS90] Fix INT0/INT1 connections
    [bionic-tmp90c802.kicad_pcb, bionic-tmp90c802.kicad_sch]
2024-12-18 [Z80] Fix Z8400 symbol
    [bionic-z80.kicad_sch]
2024-12-19 [Z8800] Fix Z8800 symbol
    [bionic-z8800-B_Cu.gbr, bionic-z8800-B_Mask.gbr, bionic-z8800-B_Paste.gbr, bionic-z8800-B_Silkscreen.gbr, bionic-z8800-Edge_Cuts.gbr, bionic-z8800-F_Cu.gbr, bionic-z8800-F_Mask.gbr, bionic-z8800-F_Paste.gbr]
2024-12-19 [Z8691] Fix bus connections
    [bionic-z8691-B_Cu.gbr, bionic-z8691-B_Mask.gbr, bionic-z8691-B_Paste.gbr, bionic-z8691-B_Silkscreen.gbr, bionic-z8691-Edge_Cuts.gbr, bionic-z8691-F_Cu.gbr, bionic-z8691-F_Mask.gbr, bionic-z8691-F_Paste.gbr]
2024-12-22 [MC68HC05C0] Add schematics
    [LED_CSL1901UW1_ROM.step, SOT-23_MC_MCH.step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]
2024-12-29 [MC6809] Change Interrupt names
2024-12-31 [debugger] Add 16-bit support to UART simulator
2025-01-11 [TMS9981] Update schematics
    [LED_CSL1901UW1_ROM.step, SOT-23_MC_MCH.step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]
2025-01-11 [TMS9995] Update schematics
    [LED_CSL1901UW1_ROM.step, SOT-23_MC_MCH.step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]
2025-01-11 [TMS99105] Update schematics
    [LED_CSL1901UW1_ROM.step, SOT-23_MC_MCH.step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]
2025-01-15 [debugger] Fix load/upload to handle word addressed atarget
    [debugger.cpp, devs.cpp, mems.h, target.cpp, target.h]
2025-01-18 [samples] Add assembler arithmetic simulation in C++
2025-01-29 [debugger] Fix dump/disassemble near the end of memory
    [mems.cpp]
2025-01-29 [mezzanine] 48-pin mezzanine board for experiment
    [248-1282-00-0602J.step, LED_CSL1901UW1_ROM.step, PW0016A.stp, SOT-23_MC_MCH.step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]
2025-02-03 [samples] Add float mandelbrot
2025-02-06 [MN1613] Update schematics
    [LED_CSL1901UW1_ROM.step, SOT-23_MC_MCH.step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]
2025-02-11 [debugger] Fix go until command to handle backspace
    [debugger.cpp]
2025-02-12 [debugger] Add no target mode
    The debugger will be in no target mode if user switch is on at powering up.
2025-02-12 [IM6100] Update schematics
    [LED_CSL1901UW1_ROM.step, SOT-23_MC_MCH.step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]
2025-02-17 [INS8060] Fix interrupt routines
    Status register needs to be saved.
2025-02-18 [INS8060] Tune bus cycle
    - Use noInterrupts/interrupts for sever timing.
    - Use Signals::inject to eliminate duplicate instruction read
2025-02-19 [CDP1802] Move MC6850 in device address space
2025-02-19 [CDP1802] Fix restore R14/R15 bug
    [inst_cdp1802.h, regs_cdp1802.cpp]
2025-02-22 [TMS9981] Rename LDO version
    [bionic-tms9981-B_Mask.gbr, bionic-tms9981-F_Mask.gbr, bionic-tms9981-ldo-B_Cu.gbr, bionic-tms9981-ldo-B_Mask.gbr, bionic-tms9981-ldo-B_Paste.gbr, bionic-tms9981-ldo-B_Silkscreen.gbr, bionic-tms9981-ldo-Edge_Cuts.gbr, bionic-tms9981-ldo-F_Cu.gbr]
2025-02-24 [TMS9981] Add DC/DC version
    [bionic-tms9981-B_Cu.gbr, bionic-tms9981-B_Mask.gbr, bionic-tms9981-B_Paste.gbr, bionic-tms9981-B_Silkscreen.gbr, bionic-tms9981-Edge_Cuts.gbr, bionic-tms9981-F_Cu.gbr, bionic-tms9981-F_Mask.gbr, bionic-tms9981-F_Paste.gbr]
2025-02-24 [Base] Cleanup schematics
    [Keystone 5000.step, Keystone 5001.step, Keystone 5002.step, Keystone 5003.step, Keystone 5004.step, Keystone 5115.step, Keystone 5116.step, Keystone 5117.step]
2025-02-24 [CDP1802] Cleanup schematics
    [bionic-cdp1802-B_Cu.gbr, bionic-cdp1802-B_Mask.gbr, bionic-cdp1802-B_Paste.gbr, bionic-cdp1802-B_Silkscreen.gbr, bionic-cdp1802-Edge_Cuts.gbr, bionic-cdp1802-F_Cu.gbr, bionic-cdp1802-F_Mask.gbr, bionic-cdp1802-F_Paste.gbr]
2025-02-24 [IM6100] Cleanup schematics
    [bionic-im6100-B_Cu.gbr, bionic-im6100-B_Mask.gbr, bionic-im6100-B_Paste.gbr, bionic-im6100-B_Silkscreen.gbr, bionic-im6100-Edge_Cuts.gbr, bionic-im6100-F_Cu.gbr, bionic-im6100-F_Mask.gbr, bionic-im6100-F_Paste.gbr]
2025-02-24 [INS8060] Cleanup schematics
    [bionic-ins8060-B_Cu.gbr, bionic-ins8060-B_Mask.gbr, bionic-ins8060-B_Paste.gbr, bionic-ins8060-B_Silkscreen.gbr, bionic-ins8060-Edge_Cuts.gbr, bionic-ins8060-F_Cu.gbr, bionic-ins8060-F_Mask.gbr, bionic-ins8060-F_Paste.gbr]
2025-02-24 [INS8070] Cleanup schematics
    [bionic-ins8070-B_Cu.gbr, bionic-ins8070-B_Mask.gbr, bionic-ins8070-B_Paste.gbr, bionic-ins8070-B_Silkscreen.gbr, bionic-ins8070-Edge_Cuts.gbr, bionic-ins8070-F_Cu.gbr, bionic-ins8070-F_Mask.gbr, bionic-ins8070-F_Paste.gbr]
2025-02-24 [MC68HC05C0] Cleanup schematics
    [bionic-mc68hc05c0-B_Cu.gbr, bionic-mc68hc05c0-B_Mask.gbr, bionic-mc68hc05c0-B_Paste.gbr, bionic-mc68hc05c0-B_Silkscreen.gbr, bionic-mc68hc05c0-Edge_Cuts.gbr, bionic-mc68hc05c0-F_Cu.gbr, bionic-mc68hc05c0-F_Mask.gbr, bionic-mc68hc05c0-F_Paste.gbr]
2025-02-24 [MC68HC11A] Cleanup schematics
    [bionic-mc68hc11a-B_Cu.gbr, bionic-mc68hc11a-B_Mask.gbr, bionic-mc68hc11a-B_Paste.gbr, bionic-mc68hc11a-B_Silkscreen.gbr, bionic-mc68hc11a-Edge_Cuts.gbr, bionic-mc68hc11a-F_Cu.gbr, bionic-mc68hc11a-F_Mask.gbr, bionic-mc68hc11a-F_Paste.gbr]
2025-02-24 [MC68HC11D] Cleanup schematics
    [bionic-mc68hc11d-B_Cu.gbr, bionic-mc68hc11d-B_Mask.gbr, bionic-mc68hc11d-B_Paste.gbr, bionic-mc68hc11d-B_Silkscreen.gbr, bionic-mc68hc11d-Edge_Cuts.gbr, bionic-mc68hc11d-F_Cu.gbr, bionic-mc68hc11d-F_Mask.gbr, bionic-mc68hc11d-F_Paste.gbr]
2025-02-24 [MC6800] Cleanup schematics
    [bionic-mc6800-B_Cu.gbr, bionic-mc6800-B_Mask.gbr, bionic-mc6800-B_Paste.gbr, bionic-mc6800-B_Silkscreen.gbr, bionic-mc6800-Edge_Cuts.gbr, bionic-mc6800-F_Cu.gbr, bionic-mc6800-F_Mask.gbr, bionic-mc6800-F_Paste.gbr]
2025-02-24 [MC6801] Cleanup schematics
    [bionic-mc6801-B_Cu.gbr, bionic-mc6801-B_Mask.gbr, bionic-mc6801-B_Paste.gbr, bionic-mc6801-B_Silkscreen.gbr, bionic-mc6801-Edge_Cuts.gbr, bionic-mc6801-F_Cu.gbr, bionic-mc6801-F_Mask.gbr, bionic-mc6801-F_Paste.gbr]
2025-02-24 [MC6802] Cleanup schematics
    [bionic-mc6802-B_Cu.gbr, bionic-mc6802-B_Mask.gbr, bionic-mc6802-B_Paste.gbr, bionic-mc6802-B_Silkscreen.gbr, bionic-mc6802-Edge_Cuts.gbr, bionic-mc6802-F_Cu.gbr, bionic-mc6802-F_Mask.gbr, bionic-mc6802-F_Paste.gbr]
2025-02-24 [MC6809] Cleanup schematics
    [bionic-mc6809-B_Cu.gbr, bionic-mc6809-B_Mask.gbr, bionic-mc6809-B_Paste.gbr, bionic-mc6809-B_Silkscreen.gbr, bionic-mc6809-Edge_Cuts.gbr, bionic-mc6809-F_Cu.gbr, bionic-mc6809-F_Mask.gbr, bionic-mc6809-F_Paste.gbr]
2025-02-24 [MC6809E] Cleanup schematics
    [bionic-mc6809e-B_Cu.gbr, bionic-mc6809e-B_Mask.gbr, bionic-mc6809e-B_Paste.gbr, bionic-mc6809e-B_Silkscreen.gbr, bionic-mc6809e-Edge_Cuts.gbr, bionic-mc6809e-F_Cu.gbr, bionic-mc6809e-F_Mask.gbr, bionic-mc6809e-F_Paste.gbr]
2025-02-24 [MC146805E2] Cleanup schematics
    [bionic-mc146805e2-B_Cu.gbr, bionic-mc146805e2-B_Mask.gbr, bionic-mc146805e2-B_Paste.gbr, bionic-mc146805e2-B_Silkscreen.gbr, bionic-mc146805e2-Edge_Cuts.gbr, bionic-mc146805e2-F_Cu.gbr, bionic-mc146805e2-F_Mask.gbr, bionic-mc146805e2-F_Paste.gbr]
2025-02-24 [Mezzanine] Cleanup schematics
    [mezzanine-B_Cu.gbr, mezzanine-B_Mask.gbr, mezzanine-B_Paste.gbr, mezzanine-B_Silkscreen.gbr, mezzanine-Edge_Cuts.gbr, mezzanine-F_Cu.gbr, mezzanine-F_Mask.gbr, mezzanine-F_Paste.gbr]
2025-02-24 [MN1613] Cleanup schematics
    [bionic-mn1613-B_Cu.gbr, bionic-mn1613-B_Mask.gbr, bionic-mn1613-B_Paste.gbr, bionic-mn1613-B_Silkscreen.gbr, bionic-mn1613-Edge_Cuts.gbr, bionic-mn1613-F_Cu.gbr, bionic-mn1613-F_Mask.gbr, bionic-mn1613-F_Paste.gbr]
2025-02-24 [MOS6502] Cleanup schematics
    [bionic-mos6502-B_Cu.gbr, bionic-mos6502-B_Mask.gbr, bionic-mos6502-B_Paste.gbr, bionic-mos6502-B_Silkscreen.gbr, bionic-mos6502-Edge_Cuts.gbr, bionic-mos6502-F_Cu.gbr, bionic-mos6502-F_Mask.gbr, bionic-mos6502-F_Paste.gbr]
2025-02-24 [NSC800] Cleanup schematics
    [bionic-nsc800-B_Cu.gbr, bionic-nsc800-B_Mask.gbr, bionic-nsc800-B_Paste.gbr, bionic-nsc800-B_Silkscreen.gbr, bionic-nsc800-Edge_Cuts.gbr, bionic-nsc800-F_Cu.gbr, bionic-nsc800-F_Mask.gbr, bionic-nsc800-F_Paste.gbr]
2025-02-24 [P8048] Cleanup schematics
    [bionic-p8048-B_Cu.gbr, bionic-p8048-B_Mask.gbr, bionic-p8048-B_Paste.gbr, bionic-p8048-B_Silkscreen.gbr, bionic-p8048-Edge_Cuts.gbr, bionic-p8048-F_Cu.gbr, bionic-p8048-F_Mask.gbr, bionic-p8048-F_Paste.gbr]
2025-02-24 [P8051] Cleanup schematics
    [DBV0005A.stp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]
2025-02-24 [P8085] Cleanup schematics
    [bionic-p8085-B_Cu.gbr, bionic-p8085-B_Mask.gbr, bionic-p8085-B_Paste.gbr, bionic-p8085-B_Silkscreen.gbr, bionic-p8085-Edge_Cuts.gbr, bionic-p8085-F_Cu.gbr, bionic-p8085-F_Mask.gbr, bionic-p8085-F_Paste.gbr]
2025-02-24 [SCN2650] Cleanup schematics
    [bionic-scn2650-B_Cu.gbr, bionic-scn2650-B_Mask.gbr, bionic-scn2650-B_Paste.gbr, bionic-scn2650-B_Silkscreen.gbr, bionic-scn2650-Edge_Cuts.gbr, bionic-scn2650-F_Cu.gbr, bionic-scn2650-F_Mask.gbr, bionic-scn2650-F_Paste.gbr]
2025-02-24 [TMP90C802] Cleanup schematics
    [bionic-tmp90c802-B_Cu.gbr, bionic-tmp90c802-B_Mask.gbr, bionic-tmp90c802-B_Paste.gbr, bionic-tmp90c802-B_Silkscreen.gbr, bionic-tmp90c802-Edge_Cuts.gbr, bionic-tmp90c802-F_Cu.gbr, bionic-tmp90c802-F_Mask.gbr, bionic-tmp90c802-F_Paste.gbr]
2025-02-24 [TMS7000] Cleanup schematics
    [bionic-tms7000-B_Cu.gbr, bionic-tms7000-B_Mask.gbr, bionic-tms7000-B_Paste.gbr, bionic-tms7000-B_Silkscreen.gbr, bionic-tms7000-Edge_Cuts.gbr, bionic-tms7000-F_Cu.gbr, bionic-tms7000-F_Mask.gbr, bionic-tms7000-F_Paste.gbr]
2025-02-24 [TMS9995] Cleanup schematics
    [bionic-tms9995-B_Cu.gbr, bionic-tms9995-B_Mask.gbr, bionic-tms9995-B_Paste.gbr, bionic-tms9995-B_Silkscreen.gbr, bionic-tms9995-Edge_Cuts.gbr, bionic-tms9995-F_Cu.gbr, bionic-tms9995-F_Mask.gbr, bionic-tms9995-F_Paste.gbr]
2025-02-24 [TMS99105] Cleanup schematics
    [bionic-tms99105-B_Cu.gbr, bionic-tms99105-B_Mask.gbr, bionic-tms99105-B_Paste.gbr, bionic-tms99105-B_Silkscreen.gbr, bionic-tms99105-Edge_Cuts.gbr, bionic-tms99105-F_Cu.gbr, bionic-tms99105-F_Mask.gbr, bionic-tms99105-F_Paste.gbr]
2025-02-24 [Z80] Cleanup schematics
    [bionic-z80-B_Cu.gbr, bionic-z80-B_Mask.gbr, bionic-z80-B_Paste.gbr, bionic-z80-B_Silkscreen.gbr, bionic-z80-Edge_Cuts.gbr, bionic-z80-F_Cu.gbr, bionic-z80-F_Mask.gbr, bionic-z80-F_Paste.gbr]
2025-02-24 [Z8691] Cleanup schematics
    [bionic-z8691-B_Cu.gbr, bionic-z8691-B_Mask.gbr, bionic-z8691-B_Paste.gbr, bionic-z8691-B_Silkscreen.gbr, bionic-z8691-Edge_Cuts.gbr, bionic-z8691-F_Cu.gbr, bionic-z8691-F_Mask.gbr, bionic-z8691-F_Paste.gbr]
2025-02-24 [Z8800] Cleanup schematics
    [bionic-z8800-B_Cu.gbr, bionic-z8800-B_Mask.gbr, bionic-z8800-B_Paste.gbr, bionic-z8800-B_Silkscreen.gbr, bionic-z8800-Edge_Cuts.gbr, bionic-z8800-F_Cu.gbr, bionic-z8800-F_Mask.gbr, bionic-z8800-F_Paste.gbr]
2025-02-27 [F3850] Rename LDO version
    [bionic-f3850-B_Mask.gbr, bionic-f3850-F_Mask.gbr, bionic-f3850-ldo-B_Cu.gbr, bionic-f3850-ldo-B_Mask.gbr, bionic-f3850-ldo-B_Paste.gbr, bionic-f3850-ldo-B_Silkscreen.gbr, bionic-f3850-ldo-Edge_Cuts.gbr, bionic-f3850-ldo-F_Cu.gbr]
2025-02-28 [F3850] Add DC/DC version
    [bionic-f3850-dcdc-B_Cu.gbr, bionic-f3850-dcdc-B_Mask.gbr, bionic-f3850-dcdc-B_Paste.gbr, bionic-f3850-dcdc-B_Silkscreen.gbr, bionic-f3850-dcdc-Edge_Cuts.gbr, bionic-f3850-dcdc-F_Cu.gbr, bionic-f3850-dcdc-F_Mask.gbr, bionic-f3850-dcdc-F_Paste.gbr]
2025-03-01 [PDP8] Disable interrupts at IM6100 critical bus timing
2025-03-01 [HD6120] Update schematics
    [LED_CSL1901UW1_ROM.step, SOT-23_MC_MCH.step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]
2025-03-01 [HD6120] Use 74LS05
    [bionic-hd6120-B_Cu.gbr, bionic-hd6120-B_Mask.gbr, bionic-hd6120-B_Paste.gbr, bionic-hd6120-B_Silkscreen.gbr, bionic-hd6120-Edge_Cuts.gbr, bionic-hd6120-F_Cu.gbr, bionic-hd6120-F_Mask.gbr, bionic-hd6120-F_Paste.gbr]
2025-03-02 [Base] Update schematics
    Remove 15V DC/DC converter
    [bionic-base-B_Cu.gbr, bionic-base-B_Mask.gbr, bionic-base-B_Paste.gbr, bionic-base-B_Silkscreen.gbr, bionic-base-Edge_Cuts.gbr, bionic-base-F_Cu.gbr, bionic-base-F_Mask.gbr, bionic-base-F_Paste.gbr]
2025-03-06 [Base] Cleanup Silk text
    [bionic-base-B_Cu.gbr, bionic-base-B_Mask.gbr, bionic-base-B_Paste.gbr, bionic-base-B_Silkscreen.gbr, bionic-base-Edge_Cuts.gbr, bionic-base-F_Cu.gbr, bionic-base-F_Mask.gbr, bionic-base-F_Paste.gbr]
2025-03-06 [CDP1802] Update schematics
    Remove unused pins from bionic connector
    [bionic-cdp1802-B_Cu.gbr, bionic-cdp1802-B_Mask.gbr, bionic-cdp1802-B_Paste.gbr, bionic-cdp1802-B_Silkscreen.gbr, bionic-cdp1802-Edge_Cuts.gbr, bionic-cdp1802-F_Cu.gbr, bionic-cdp1802-F_Mask.gbr, bionic-cdp1802-F_Paste.gbr]
2025-03-06 [F3850] Cleanup schematics
    Remove LDO version
    [bionic-f3850-B_Cu.gbr, bionic-f3850-B_Mask.gbr, bionic-f3850-B_Paste.gbr, bionic-f3850-B_Silkscreen.gbr, bionic-f3850-Edge_Cuts.gbr, bionic-f3850-F_Cu.gbr, bionic-f3850-F_Mask.gbr, bionic-f3850-F_Paste.gbr]
2025-03-06 [HD6120] Cleanup schematics
    [bionic-hd6120-B_Cu.gbr, bionic-hd6120-B_Mask.gbr, bionic-hd6120-B_Paste.gbr, bionic-hd6120-B_Silkscreen.gbr, bionic-hd6120-Edge_Cuts.gbr, bionic-hd6120-F_Cu.gbr, bionic-hd6120-F_Mask.gbr, bionic-hd6120-F_Paste.gbr]
2025-03-06 [IM6100] Update schematics
    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
    [bionic-im6100-B_Cu.gbr, bionic-im6100-B_Mask.gbr, bionic-im6100-B_Paste.gbr, bionic-im6100-B_Silkscreen.gbr, bionic-im6100-Edge_Cuts.gbr, bionic-im6100-F_Cu.gbr, bionic-im6100-F_Mask.gbr, bionic-im6100-F_Paste.gbr]
2025-03-06 [INS8060] Update schematics
    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
    [bionic-ins8060-B_Cu.gbr, bionic-ins8060-B_Mask.gbr, bionic-ins8060-B_Paste.gbr, bionic-ins8060-B_Silkscreen.gbr, bionic-ins8060-Edge_Cuts.gbr, bionic-ins8060-F_Cu.gbr, bionic-ins8060-F_Mask.gbr, bionic-ins8060-F_Paste.gbr]
2025-03-06 [INS8070] Update schematics
    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
    [bionic-ins8070-B_Cu.gbr, bionic-ins8070-B_Mask.gbr, bionic-ins8070-B_Paste.gbr, bionic-ins8070-B_Silkscreen.gbr, bionic-ins8070-Edge_Cuts.gbr, bionic-ins8070-F_Cu.gbr, bionic-ins8070-F_Mask.gbr, bionic-ins8070-F_Paste.gbr]
2025-03-06 [MC68HC05C0] Update schematics
    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
    [bionic-mc68hc05c0-B_Cu.gbr, bionic-mc68hc05c0-B_Mask.gbr, bionic-mc68hc05c0-B_Paste.gbr, bionic-mc68hc05c0-B_Silkscreen.gbr, bionic-mc68hc05c0-Edge_Cuts.gbr, bionic-mc68hc05c0-F_Cu.gbr, bionic-mc68hc05c0-F_Mask.gbr, bionic-mc68hc05c0-F_Paste.gbr]
2025-03-06 [MC68HC11A] Update schematics
    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
    [bionic-mc68hc11a-B_Cu.gbr, bionic-mc68hc11a-B_Mask.gbr, bionic-mc68hc11a-B_Paste.gbr, bionic-mc68hc11a-B_Silkscreen.gbr, bionic-mc68hc11a-Edge_Cuts.gbr, bionic-mc68hc11a-F_Cu.gbr, bionic-mc68hc11a-F_Mask.gbr, bionic-mc68hc11a-F_Paste.gbr]
2025-03-06 [MC68HC11D] Update schematics
    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
    [bionic-mc68hc11d-B_Cu.gbr, bionic-mc68hc11d-B_Mask.gbr, bionic-mc68hc11d-B_Paste.gbr, bionic-mc68hc11d-B_Silkscreen.gbr, bionic-mc68hc11d-Edge_Cuts.gbr, bionic-mc68hc11d-F_Cu.gbr, bionic-mc68hc11d-F_Mask.gbr, bionic-mc68hc11d-F_Paste.gbr]
2025-03-06 [MC6800] Update schematics
    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
    [bionic-mc6800-B_Cu.gbr, bionic-mc6800-B_Mask.gbr, bionic-mc6800-B_Paste.gbr, bionic-mc6800-B_Silkscreen.gbr, bionic-mc6800-Edge_Cuts.gbr, bionic-mc6800-F_Cu.gbr, bionic-mc6800-F_Mask.gbr, bionic-mc6800-F_Paste.gbr]
2025-03-06 [MC6801] Update schematics
    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
    [bionic-mc6801-B_Cu.gbr, bionic-mc6801-B_Mask.gbr, bionic-mc6801-B_Paste.gbr, bionic-mc6801-B_Silkscreen.gbr, bionic-mc6801-Edge_Cuts.gbr, bionic-mc6801-F_Cu.gbr, bionic-mc6801-F_Mask.gbr, bionic-mc6801-F_Paste.gbr]
2025-03-06 [MC6802] Update schematics
    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
    [bionic-mc6802-B_Cu.gbr, bionic-mc6802-B_Mask.gbr, bionic-mc6802-B_Paste.gbr, bionic-mc6802-B_Silkscreen.gbr, bionic-mc6802-Edge_Cuts.gbr, bionic-mc6802-F_Cu.gbr, bionic-mc6802-F_Mask.gbr, bionic-mc6802-F_Paste.gbr]
2025-03-06 [MC6809] Update schematics
    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
    [bionic-mc6809-B_Cu.gbr, bionic-mc6809-B_Mask.gbr, bionic-mc6809-B_Paste.gbr, bionic-mc6809-B_Silkscreen.gbr, bionic-mc6809-Edge_Cuts.gbr, bionic-mc6809-F_Cu.gbr, bionic-mc6809-F_Mask.gbr, bionic-mc6809-F_Paste.gbr]
2025-03-06 [MC6809E] Update schematics
    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
    [bionic-mc6809e-B_Cu.gbr, bionic-mc6809e-B_Mask.gbr, bionic-mc6809e-B_Paste.gbr, bionic-mc6809e-B_Silkscreen.gbr, bionic-mc6809e-Edge_Cuts.gbr, bionic-mc6809e-F_Cu.gbr, bionic-mc6809e-F_Mask.gbr, bionic-mc6809e-F_Paste.gbr]
2025-03-06 [MC146805E2] Update schematics
    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
    [bionic-mc146805e2-B_Cu.gbr, bionic-mc146805e2-B_Mask.gbr, bionic-mc146805e2-B_Paste.gbr, bionic-mc146805e2-B_Silkscreen.gbr, bionic-mc146805e2-Edge_Cuts.gbr, bionic-mc146805e2-F_Cu.gbr, bionic-mc146805e2-F_Mask.gbr, bionic-mc146805e2-F_Paste.gbr]
2025-03-06 [Mezzanine] Update schematics
    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
    [mezzanine-B_Cu.gbr, mezzanine-B_Mask.gbr, mezzanine-B_Paste.gbr, mezzanine-B_Silkscreen.gbr, mezzanine-Edge_Cuts.gbr, mezzanine-F_Cu.gbr, mezzanine-F_Mask.gbr, mezzanine-F_Paste.gbr]
2025-03-06 [MN1613] Update schematics
    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
    [bionic-mn1613-B_Cu.gbr, bionic-mn1613-B_Mask.gbr, bionic-mn1613-B_Paste.gbr, bionic-mn1613-B_Silkscreen.gbr, bionic-mn1613-Edge_Cuts.gbr, bionic-mn1613-F_Cu.gbr, bionic-mn1613-F_Mask.gbr, bionic-mn1613-F_Paste.gbr]
2025-03-06 [MOS6502] Update schematics
    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
    [bionic-mos6502-B_Cu.gbr, bionic-mos6502-B_Mask.gbr, bionic-mos6502-B_Paste.gbr, bionic-mos6502-B_Silkscreen.gbr, bionic-mos6502-Edge_Cuts.gbr, bionic-mos6502-F_Cu.gbr, bionic-mos6502-F_Mask.gbr, bionic-mos6502-F_Paste.gbr]
2025-03-06 [NSC800] Update schematics
    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
    [bionic-nsc800-B_Cu.gbr, bionic-nsc800-B_Mask.gbr, bionic-nsc800-B_Paste.gbr, bionic-nsc800-B_Silkscreen.gbr, bionic-nsc800-Edge_Cuts.gbr, bionic-nsc800-F_Cu.gbr, bionic-nsc800-F_Mask.gbr, bionic-nsc800-F_Paste.gbr]
2025-03-06 [P8048] Update schematics
    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
    [bionic-p8048-B_Cu.gbr, bionic-p8048-B_Mask.gbr, bionic-p8048-B_Paste.gbr, bionic-p8048-B_Silkscreen.gbr, bionic-p8048-Edge_Cuts.gbr, bionic-p8048-F_Cu.gbr, bionic-p8048-F_Mask.gbr, bionic-p8048-F_Paste.gbr]
2025-03-06 [P8051] Update schematics
    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
    [bionic-p8051-B_Cu.gbr, bionic-p8051-B_Mask.gbr, bionic-p8051-B_Paste.gbr, bionic-p8051-B_Silkscreen.gbr, bionic-p8051-Edge_Cuts.gbr, bionic-p8051-F_Cu.gbr, bionic-p8051-F_Mask.gbr, bionic-p8051-F_Paste.gbr]
2025-03-06 [P8085] Update schematics
    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
    [bionic-p8085-B_Cu.gbr, bionic-p8085-B_Mask.gbr, bionic-p8085-B_Paste.gbr, bionic-p8085-B_Silkscreen.gbr, bionic-p8085-Edge_Cuts.gbr, bionic-p8085-F_Cu.gbr, bionic-p8085-F_Mask.gbr, bionic-p8085-F_Paste.gbr]
2025-03-06 [SCN2650] Update schematics
    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
    [bionic-scn2650-B_Cu.gbr, bionic-scn2650-B_Mask.gbr, bionic-scn2650-B_Paste.gbr, bionic-scn2650-B_Silkscreen.gbr, bionic-scn2650-Edge_Cuts.gbr, bionic-scn2650-F_Cu.gbr, bionic-scn2650-F_Mask.gbr, bionic-scn2650-F_Paste.gbr]
2025-03-06 [TMP90C802] Update schematics
    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
    [bionic-tmp90c802-B_Cu.gbr, bionic-tmp90c802-B_Mask.gbr, bionic-tmp90c802-B_Paste.gbr, bionic-tmp90c802-B_Silkscreen.gbr, bionic-tmp90c802-Edge_Cuts.gbr, bionic-tmp90c802-F_Cu.gbr, bionic-tmp90c802-F_Mask.gbr, bionic-tmp90c802-F_Paste.gbr]
2025-03-06 [TMS7000] Update schematics
    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
    [bionic-tms7000-B_Cu.gbr, bionic-tms7000-B_Mask.gbr, bionic-tms7000-B_Paste.gbr, bionic-tms7000-B_Silkscreen.gbr, bionic-tms7000-Edge_Cuts.gbr, bionic-tms7000-F_Cu.gbr, bionic-tms7000-F_Mask.gbr, bionic-tms7000-F_Paste.gbr]
2025-03-06 [TMS9981] Cleanup schematics
    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
    [bionic-tms9981-B_Cu.gbr, bionic-tms9981-B_Mask.gbr, bionic-tms9981-B_Paste.gbr, bionic-tms9981-B_Silkscreen.gbr, bionic-tms9981-Edge_Cuts.gbr, bionic-tms9981-F_Cu.gbr, bionic-tms9981-F_Mask.gbr, bionic-tms9981-F_Paste.gbr]
2025-03-06 [TMS9995] Update schematics
    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
    [bionic-tms9995-B_Cu.gbr, bionic-tms9995-B_Mask.gbr, bionic-tms9995-B_Paste.gbr, bionic-tms9995-B_Silkscreen.gbr, bionic-tms9995-Edge_Cuts.gbr, bionic-tms9995-F_Cu.gbr, bionic-tms9995-F_Mask.gbr, bionic-tms9995-F_Paste.gbr]
2025-03-06 [TMS99105] Update schematics
    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
    [bionic-tms99105-B_Cu.gbr, bionic-tms99105-B_Mask.gbr, bionic-tms99105-B_Paste.gbr, bionic-tms99105-B_Silkscreen.gbr, bionic-tms99105-Edge_Cuts.gbr, bionic-tms99105-F_Cu.gbr, bionic-tms99105-F_Mask.gbr, bionic-tms99105-F_Paste.gbr]
2025-03-06 [Z80] Update schematics
    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
    [bionic-z80-B_Cu.gbr, bionic-z80-B_Mask.gbr, bionic-z80-B_Paste.gbr, bionic-z80-B_Silkscreen.gbr, bionic-z80-Edge_Cuts.gbr, bionic-z80-F_Cu.gbr, bionic-z80-F_Mask.gbr, bionic-z80-F_Paste.gbr]
2025-03-06 [Z8691] Update schematics
    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
    [bionic-z8691-B_Cu.gbr, bionic-z8691-B_Mask.gbr, bionic-z8691-B_Paste.gbr, bionic-z8691-B_Silkscreen.gbr, bionic-z8691-Edge_Cuts.gbr, bionic-z8691-F_Cu.gbr, bionic-z8691-F_Mask.gbr, bionic-z8691-F_Paste.gbr]
2025-03-06 [Z8800] Update schematics
    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
    [bionic-z8800-B_Cu.gbr, bionic-z8800-B_Mask.gbr, bionic-z8800-B_Paste.gbr, bionic-z8800-B_Silkscreen.gbr, bionic-z8800-Edge_Cuts.gbr, bionic-z8800-F_Cu.gbr, bionic-z8800-F_Mask.gbr, bionic-z8800-F_Paste.gbr]
2025-03-06 [samples] Integer Mandelbrot without division
2025-03-06 [i8085] Clean up samples
    Use DAA to convert hexadecimal to ASCII.
2025-03-06 [P8080] Add schematics
    [bionic-p8080-B_Cu.gbr, bionic-p8080-B_Mask.gbr, bionic-p8080-B_Paste.gbr, bionic-p8080-B_Silkscreen.gbr, bionic-p8080-Edge_Cuts.gbr, bionic-p8080-F_Cu.gbr, bionic-p8080-F_Mask.gbr, bionic-p8080-F_Paste.gbr]
2025-03-06 [P8080] Fix level shifter
    [bionic-p8080-B_Cu.gbr, bionic-p8080-B_Mask.gbr, bionic-p8080-B_Paste.gbr, bionic-p8080-B_Silkscreen.gbr, bionic-p8080-Edge_Cuts.gbr, bionic-p8080-F_Cu.gbr, bionic-p8080-F_Mask.gbr, bionic-p8080-F_Paste.gbr]
2025-03-06 [i8080] Add i8080 samples
2025-03-07 [i8080] Use HLT and RESET for P8080 break point
    [pins_i8080.cpp, pins_i8080.h, regs_i8080.cpp, regs_i8080.h, signals_i8080.cpp, signals_i8080.h]
2025-03-10 [TMS9900] Optimize samples
2025-03-10 [TMS9980] Add schematics
    [bionic-tms9980-B_Cu.gbr, bionic-tms9980-B_Mask.gbr, bionic-tms9980-B_Paste.gbr, bionic-tms9980-B_Silkscreen.gbr, bionic-tms9980-Edge_Cuts.gbr, bionic-tms9980-F_Cu.gbr, bionic-tms9980-F_Mask.gbr, bionic-tms9980-F_Paste.gbr]
2025-03-11 [P8080] Remove unused subsheet
    [dcdc+12.kicad_sch]
2025-03-25 [debugger] Fix to support break point in internal RAM
    [mems.h]
2025-03-28 [Z80] Fix restopre registers and tune for Z8400
    [pins_nsc800.cpp, pins_nsc800.h, pins_z80.cpp, pins_z80.h]
2025-03-28 [Z80] Optimize samples
2025-03-28 [MC68HC08AZ0] Add schematics
    [bionic-mc68hc08az0-B_Cu.gbr, bionic-mc68hc08az0-B_Mask.gbr, bionic-mc68hc08az0-B_Paste.gbr, bionic-mc68hc08az0-B_Silkscreen.gbr, bionic-mc68hc08az0-Edge_Cuts.gbr, bionic-mc68hc08az0-F_Cu.gbr, bionic-mc68hc08az0-F_Mask.gbr, bionic-mc68hc08az0-F_Paste.gbr]
2025-03-28 [MC68HC08AZ0] Fix serial EEPROM connection
    [bionic-mc68hc08az0-B_Cu.gbr, bionic-mc68hc08az0-B_Mask.gbr, bionic-mc68hc08az0-B_Paste.gbr, bionic-mc68hc08az0-B_Silkscreen.gbr, bionic-mc68hc08az0-Edge_Cuts.gbr, bionic-mc68hc08az0-F_Cu.gbr, bionic-mc68hc08az0-F_Mask.gbr, bionic-mc68hc08az0-F_Paste.gbr]
2025-04-23 [MC6805] Refactor samples
2025-06-19 [P8080] Fix ERC warnings
    [bionic-p8080.kicad_sch]
2025-06-19 [debugger] Fix memory dump for word access memory
    [mems.cpp]
2025-06-19 [samples] Fix typo
2025-06-19 [TMS9900] Add schematics
    [bionic-tms9900-B_Cu.gbr, bionic-tms9900-B_Mask.gbr, bionic-tms9900-B_Paste.gbr, bionic-tms9900-B_Silkscreen.gbr, bionic-tms9900-Edge_Cuts.gbr, bionic-tms9900-F_Cu.gbr, bionic-tms9900-F_Mask.gbr, bionic-tms9900-F_Paste.gbr]
2025-06-19 [TMS32010] Update schematics
    [bionic-tms32010-B_Cu.gbr, bionic-tms32010-B_Mask.gbr, bionic-tms32010-B_Paste.gbr, bionic-tms32010-B_Silkscreen.gbr, bionic-tms32010-Edge_Cuts.gbr, bionic-tms32010-F_Cu.gbr, bionic-tms32010-F_Mask.gbr, bionic-tms32010-F_Paste.gbr]
2025-08-01 [MC68HC08AZ0] Update CPU symbol
    [bionic-mc68hc08az0.kicad_sch]
2025-11-22 [KL5C80A12] Add schematics
    [bionic-kl5c80a12-B_Cu.gbr, bionic-kl5c80a12-B_Mask.gbr, bionic-kl5c80a12-B_Paste.gbr, bionic-kl5c80a12-B_Silkscreen.gbr, bionic-kl5c80a12-Edge_Cuts.gbr, bionic-kl5c80a12-F_Cu.gbr, bionic-kl5c80a12-F_Mask.gbr, bionic-kl5c80a12-F_Paste.gbr]
2025-11-22 [KL5C80A12] Fix KL5C80A12 foot print wider
    [bionic-kl5c80a12-B_Cu.gbr, bionic-kl5c80a12-B_Mask.gbr, bionic-kl5c80a12-B_Paste.gbr, bionic-kl5c80a12-B_Silkscreen.gbr, bionic-kl5c80a12-Edge_Cuts.gbr, bionic-kl5c80a12-F_Cu.gbr, bionic-kl5c80a12-F_Mask.gbr, bionic-kl5c80a12-F_Paste.gbr]
2025-11-22 [KL5C80] Fix step bus cycles display
    [pins_kl5c80.cpp]
2025-11-22 [KL5C80A12] Fix memory size to 512kB
    [pins_kl5c80.cpp, pins_kl5c80.h]
2025-11-22 [KL5C80] Separate sample directory from Z80
2025-11-23 [samples] Remove duplicate files
2025-11-29 [Z180] Add schematics
    [bionic-z180-B_Cu.gbr, bionic-z180-B_Mask.gbr, bionic-z180-B_Paste.gbr, bionic-z180-B_Silkscreen.gbr, bionic-z180-Edge_Cuts.gbr, bionic-z180-F_Cu.gbr, bionic-z180-F_Mask.gbr, bionic-z180-F_Paste.gbr]
2025-11-29 [Z180] Rename PLCC package project
    [bionic-z180-F_Silkscreen.gbr, bionic-z180vsc-B_Cu.gbr, bionic-z180vsc-B_Mask.gbr, bionic-z180vsc-B_Paste.gbr, bionic-z180vsc-B_Silkscreen.gbr, bionic-z180vsc-Edge_Cuts.gbr, bionic-z180vsc-F_Cu.gbr, bionic-z180vsc-F_Mask.gbr]
2025-11-29 [Z180] Add QFP package project
    [bionic-z180fsc-B_Cu.gbr, bionic-z180fsc-B_Mask.gbr, bionic-z180fsc-B_Paste.gbr, bionic-z180fsc-B_Silkscreen.gbr, bionic-z180fsc-Edge_Cuts.gbr, bionic-z180fsc-F_Cu.gbr, bionic-z180fsc-F_Mask.gbr, bionic-z180fsc-F_Paste.gbr]
2025-11-30 [Z180] Optimze QFP board layout
    [bionic-z180fsc-B_Cu.gbr, bionic-z180fsc-B_Mask.gbr, bionic-z180fsc-B_Paste.gbr, bionic-z180fsc-B_Silkscreen.gbr, bionic-z180fsc-Edge_Cuts.gbr, bionic-z180fsc-F_Cu.gbr, bionic-z180fsc-F_Mask.gbr, bionic-z180fsc-F_Paste.gbr]
2025-12-02 [Z180] Rename PLCC/QFP schematics name
    [bionic-z180f-B_Cu.gbr, bionic-z180f-B_Mask.gbr, bionic-z180f-B_Paste.gbr, bionic-z180f-B_Silkscreen.gbr, bionic-z180f-Edge_Cuts.gbr, bionic-z180f-F_Cu.gbr, bionic-z180f-F_Mask.gbr, bionic-z180f-F_Paste.gbr]
2025-12-22 [Z180] Update board settings
    [bionic-z180f-B_Cu.gbr, bionic-z180f-B_Mask.gbr, bionic-z180f-B_Paste.gbr, bionic-z180f-B_Silkscreen.gbr, bionic-z180f-Edge_Cuts.gbr, bionic-z180f-F_Cu.gbr, bionic-z180f-F_Mask.gbr, bionic-z180f-F_Paste.gbr]
2026-02-08 [TMS370C250] Add schematics
    [bionic-tms370c250-B_Cu.gbr, bionic-tms370c250-B_Mask.gbr, bionic-tms370c250-B_Paste.gbr, bionic-tms370c250-B_Silkscreen.gbr, bionic-tms370c250-Edge_Cuts.gbr, bionic-tms370c250-F_Cu.gbr, bionic-tms370c250-F_Mask.gbr, bionic-tms370c250-F_Paste.gbr]
2026-02-08 [TNS320C250] Fix XTAL1 50pF
    [bionic-tms370c250-B_Cu.gbr, bionic-tms370c250-B_Mask.gbr, bionic-tms370c250-B_Paste.gbr, bionic-tms370c250-B_Silkscreen.gbr, bionic-tms370c250-Edge_Cuts.gbr, bionic-tms370c250-F_Cu.gbr, bionic-tms370c250-F_Mask.gbr, bionic-tms370c250-F_Paste.gbr]
2026-02-08 [TMS370Cx5x] Rename TMS370C250 to TNS370Cx5x
    [bionic-tms370c250-F_Mask.gbr, bionic-tms370c250-F_Paste.gbr, bionic-tms370cx5x-B_Cu.gbr, bionic-tms370cx5x-B_Mask.gbr, bionic-tms370cx5x-B_Paste.gbr, bionic-tms370cx5x-B_Silkscreen.gbr, bionic-tms370cx5x-Edge_Cuts.gbr, bionic-tms370cx5x-F_Cu.gbr]
2026-02-08 [TMS370Cx5x] Fix missing ADDR0 pin
    [pins_tms370cx5x.cpp]
2026-02-13 Fix clangd, lsp-mode, platform.ini to correctly identify Arduino.h (#22)
    [debugger.h]
2026-02-21 remove .dir-locals.el
2026-03-15 [P8096] Update schematics
    [bionic-p8095-B_Cu.gbr, bionic-p8095-B_Mask.gbr, bionic-p8095-B_Paste.gbr, bionic-p8095-B_Silkscreen.gbr, bionic-p8095-Edge_Cuts.gbr, bionic-p8095-F_Cu.gbr, bionic-p8095-F_Mask.gbr, bionic-p8095-F_Paste.gbr]
2026-03-24 [debugger] Fix off by one bug
    [break_points.cpp]
2026-03-29 [HD64180S] Add schematics
    [bionic-hd64180s-B_Cu.gbr, bionic-hd64180s-B_Mask.gbr, bionic-hd64180s-B_Paste.gbr, bionic-hd64180s-B_Silkscreen.gbr, bionic-hd64180s-Edge_Cuts.gbr, bionic-hd64180s-F_Cu.gbr, bionic-hd64180s-F_Mask.gbr, bionic-hd64180s-F_Paste.gbr]
2026-08-31 [ci] Update GitHub workflows to the latest actions
    Auto Approve:
    - Switch trigger from pull_request_target to pull_request, drop
    synchronize.
    - Replace hmarr/auto-approve-action and the bot PAT with "gh pr
    review" using the built-in GITHUB_TOKEN.
    PlatformIO CI:
    - actions/checkout v3 to v7, actions/cache v3 to v6,
    actions/setup-python v4 to v7 with an explicit python-version.
    - Limit GITHUB_TOKEN to "contents: read", as libasm does; CodeQL
    reported actions/missing-workflow-permissions for this workflow.
    - Key the caches on files that exist in this repository; the previous
    keys hashed requirements.txt and lockfiles, which are absent, so
    they never invalidated.
    - Replac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
2026-08-31 [docs] Add README, docs/ pages and LICENSE
    The repository had no README and no LICENSE. Add an English README
    introducing the project, a docs/ directory for images and detail
    pages, and the Apache-2.0 licence the source headers already refer to.
    - README.md: what Bionic is, a block diagram of the hardware, the
    board stack, the debugger features, all 40 targets with the
    variants each detects, repository layout, and links to libasm,
    libcli and dip.
    - docs/supported-cpus.md: one table covering both the supported CPUs
    and those still to be supported, grouped by libasm architecture,
    with detected variants and the part numbers in hand.
    - docs/hardware.md: base board and CPU ada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
2026-08-31 [debugger] Extract the bus cycle ring into Cycles
    The ring lived as static members of SignalsImpl, so the buffer and a
    single cycle were the same type. Move it to its own class in
    cycles.h and cycles.cpp, turning Signals::resetCycles() and friends
    into Cycles::reset(), Cycles::next() and Cycles::discard().
    Signals stays free of virtual functions. Positions and counters are
    uint_fast8_t; the per cycle storage stays uint8_t, keeping
    SignalsImpl at 12 bytes.
    [cycles.cpp, cycles.h, pins_cdp1802.cpp, pins_f3850.cpp, pins_hd6120.cpp, pins_i8048.cpp, pins_i8051.cpp, pins_i8080.cpp]
2026-08-31 [debugger] Move Signals print buffer into Cycles (#26)
2026-09-01 [docs] Note the 5 V limit and plan a 3.3 V base board
2026-09-01 [debugger] Fix -Wsign-compare warnings in cycle loops (#30)
    Signals::diff() returns uint_fast8_t, so start cycle loop indices at 0u.
    InstMc6800::matchSequence() compares int8_t _nexti in signed space.
    [pins_cdp1802.cpp, pins_f3850.cpp, pins_i8048.cpp, pins_i8051.cpp, pins_i8080.cpp, pins_i8085.cpp, pins_ins8060.cpp, pins_ins8070.cpp]
2026-09-11 [base] Add a 3D model for the LED tact switch
2026-09-12 [base] Model the ZIF socket, add the Teensy pin header, fix colours
    [bionic-base.kicad_pcb]
2026-09-12 [hd64180s] Add a STEP model for the HD64180S QFP-80
    [bionic-hd64180s.kicad_pcb, bionic-hd64180s.kicad_sch]
2026-09-12 [kl5c80a12] Add a STEP model for the KL5C80A12CFP QFP-100
    [bionic-kl5c80a12.kicad_pcb]
2026-09-12 [mc68hc08az0] Add STEP model for the MC68HC08AZ0 QFP-100
    [bionic-mc68hc08az0.kicad_pcb]
2026-09-12 [z180f] Add a STEP model for the Z8018008FSC QFP-80
    Also fix the KL5C80A12CFP marking, which had the same left-aligned
    text-overflow bug found and fixed on the MC68HC08AZ0 model.
    [bionic-z180f.kicad_pcb]
2026-09-16 [samples] Fix mandelbrot T>=256 check and wrong expected values (#31)
    * [z80] Fix T>=256 check in mandelbrot
    * [samples] Correct expected values in arithmetic demos
2026-09-20 [docs] Add planned CPUs and runtime variants (#32)
    Plan i960, V25/V35/V53 and H8/300, the last with no part in hand yet.
    Add P80C51, TMS70C00 and TMP90P802 variants, and group parts that
    share a board under Variants: 8088 with 8086, V20 with V30, V25 with
    V35.
2026-09-22 [debugger] Fix put_code() clobbering the neighbouring byte (#33)
    Writing a whole word per byte made each byte of an instruction
    overwrite its neighbour on byte-addressed, word-accessed memory.
    Affects TMS9900 and TMS99105.
    [mems.cpp]
2026-09-22 [debugger] Fix writeMemory() on byte-addressed word memory (#34)
    It advanced the address by one per word, so each word overwrote the
    previous, and the little-endian branch dropped the shift.
    [mems.cpp]
2026-09-24 [samples] Fix LF after CR in z180 echo/echoir (#37)
    These use BC as the I/O pointer and keep the character in D, but the
    CR tail still did LD B,0AH. That left the character unchanged and
    moved the port to 0A40H, so transmit_loop polled an unselected
    address.
2026-09-27 [scripts] Add a target-agnostic bench tool and bring-up notes
    bionic-control.py drives the board for any target: the `?` banner names
    it, and that name selects the only thing that differs, the bus status
    decode. Every operation has a hard deadline and classifies the board
    afterwards -- at its prompt, running, or wedged with the firmware in an
    unbounded wait -- so a run that never comes back is reported instead of
    hanging the caller, and an flock keeps two sessions off one device.
    development-style.md collects the bring-up findings that cost real
    debugging time. It is for agents working in this tree, so it is not
    listed in the README's documentation index.
2026-09-27 [scripts] Add a regression suite for the debugger board
    Target agnostic like bionic-control.py: the `?` banner names the target
    and that picks samples/<target>/. Cases are reset, step, samples, haltgo,
    break and gountil; each reports with the firmware timing parameters, and a
    case that leaves the board stuck is recovered before the next one runs.
    Two of them exist because the obvious test passes while the feature is
    broken. haltgo checks the PC after continuing, not just that output
    resumed -- a corrupted resume still emits bytes, and only a later continue
    fails. break requires the same breakpoint to be hit several times running,
    so one that is consumed on first hit, or whose patched opc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
2026-09-27 [debugger] Keep the cycle ring's tail off the head when it fills
    Cycles::next() let the count reach MAX_CYCLES before moving the tail, so
    with exactly that many cycles recorded the tail sat on the head and the
    dump printed nothing.
2026-09-27 [debugger] Add host-side unit tests for the cycle ring
    A native PlatformIO env (pio test -e native, make test) builds only the
    target-independent pieces. The tests cover next(), discard(), prev()/next(),
    diff(), pos() and the count, including the full-ring case the previous
    commit fixes.
2026-09-27 [debugger] Poll the halt port from haltSwitch()
    The core only services the halt port from yield(), which a run reached
    only through console I/O; a program that never enabled the console
    device could not be halted.
2026-09-27 [scripts] Let the regression suite run a silent sample to its break
    A sample that prints nothing until it breaks looked like a stall.
2026-09-27 [debugger] Report uptime and any crash report in the banner
    A fault reboots the board silently, which looks like a wedge.
    [debugger.cpp, main.cpp]
2026-09-27 [scripts] Let a target drive its own samples through samples/<target>/regress.json
2026-09-27 [scripts] Check that a run's dump is disassembled
    A new regression case loads a looping sample, runs it briefly with
    verbose off, halts it and requires the dump to hold at least ten lines
    of the form addr: bytes mnemonic -- what every target's
    disassembleCycles() prints and what one that only prints raw cycles
    never does.
2026-09-27 [scripts] Parse a cycle line with or without its slot number
    A target's plain build may print only "R A=... D=..."; the slot number
    and the inject/capture flags then come from a profiling build. parse()
    takes either, numbering the cycles itself when the line does not.
2026-09-28 [debugger] Verbose help, a crash status on every prompt
    '?' now prints a full command reference: one line per command with its
    arguments, aligned on ':', grouped in the order a session actually
    goes (reset, load, run, break/step, registers, examine, id), each
    conditionally compiled command (D/A/F/L) appearing only when its
    feature is built in. Boot instead prints just the banner, registers,
    and a "? for help" hint -- not the full table, which would be noise on
    every power-up. 'R' (reset) is unchanged: registers only. The 'R' line
    and the halt-switch paragraph name the actual target CPU (falling back
    to "CPU" if unnamed), matching Identity::printIdentity()'s convention.
    CrashReport isn't cle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
    [debugger.cpp]
2026-09-28 [Z280] Add schematics
    [bionic-z280-B_Cu.gbr, bionic-z280-B_Mask.gbr, bionic-z280-B_Paste.gbr, bionic-z280-B_Silkscreen.gbr, bionic-z280-Edge_Cuts.gbr, bionic-z280-F_Cu.gbr, bionic-z280-F_Mask.gbr, bionic-z280-F_Paste.gbr]
2026-09-28 [z280] Support programs with the cache enabled
    A cached fetch never reaches the bus, so every stop parks at the vector
    fetch and the debugger's sequences run from there: one entry sequence
    purges, keeps HL and BC, reads Cache Control and caches nothing; one
    return sequence from 8000H restores it and the MSR, purges and returns by
    RETN, RETIL or JP. A step leaves the cache off. Jump targets are matched
    by word, the page frame comes from the program's last fetch, and the
    register dump shows CACHE=, which =IC and =DC edit. cmandel.asm enables
    the cache through enable_cache.inc.
    A word read at an odd address answers the aligned pair. The CPU files
    both lanes in the cache line, so answering [add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
2026-09-28 [z280] Measure the bus cycles of every instruction on the chip
    The Z-BUS does not tell a fetch from a data read and the prefetch runs
    ahead, so the per-opcode cycle tables cannot come from the manual.
    profile_z280.py runs every instruction pattern in isolation, memory
    filled with RST 38H, and records the ring; derive_z280.py folds the
    variants into z280-PAGExx.txt, which inst_z280.awk turns into tables.
    The recording is committed as profile/z280-profile.jsonl.zst. A build
    with -D Z280_PROFILE prints the wide cycle line the harness needs.
    Measured: prefetch runs up to 3 words past an instruction; a byte load
    at an even address is a word read and an odd word is two byte reads;
    stalls and flus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
2026-09-28 [z280] Disassemble the cycle dump by matching the fetch stream
    InstZ280::match() explains the ring from the measured tables: the
    instruction's bytes in order, then its data transfers, with prefetch
    and re-fetches absorbed anywhere. Prefetch is the next instruction's,
    so the next match starts right after the previous one's bytes; a taken
    transfer ends at the target's fetch. An interrupt taken instead of the
    fetch owed is matched as one.
    A ring cut inside an instruction decodes its tail and data cycles as
    something, so a match must be followed by what it expects (next
    address, branch target, popped address, interrupt vector, or the PC
    the CPU stopped at) or it is dropped and matching repeats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
2026-09-29 [debugger] Print how long G/g actually ran the target
2026-09-29 Refactor bionic tools
    bionic-control.py is now a pure board controller; decoding and Logic 2
    support move to their own scripts. bionic-regress.py's sample-driving
    config is fully explicit per target now, including verifying arith's
    actual computed output, not just that it produced some. Also fixes
    upload, which never reset the CPU before running the uploaded file.
2026-09-29 [z280] Move debugging tools into debugger/z280/tools
    Bus-cycle recording, table derivation, and capture decoding are Z280-
    specific tools, so they move out of the generic scripts/ directory and
    out of debugger/z280/'s top level into their own subdirectory, with
    clearer names. Also fixes record_cycles.py, which the earlier Board
    refactor had broken.
2026-10-04 [debugger] Reboot the Teensy when the firmware hangs
    A firmware hang reboots the Teensy after 4 s instead of needing a power
    cycle.
    [cycles.cpp, debugger.cpp, main.cpp, pins.cpp, watchdog.cpp, watchdog.h]
2026-10-04 [schematics] Fix pinout definitions against the schematics
    Pin names and port bits match the chip manuals and board nets.
2026-10-04 [cdp1802] Add automation config
    Fix CPU type detection and the reset PC.
    [pins_cdp1802.cpp, pins_cdp1802.h, regs_cdp1802.cpp]
2026-10-04 [f3850] Add automation config
    Fix an off-by-one stack pointer and the samples' 16-bit compares.
    [devs_f3850.h, pins_f3850.cpp, pins_f3850.h, regs_f3850.cpp, signals_f3850.cpp, signals_f3850.h]
2026-10-04 [i8048] Add automation config
    Fix the samples' interrupt handler, which corrupted the main program's
    stack.
    [pins_i8048.cpp, pins_i8048.h]
2026-10-04 [i8051] Add automation config
    Fix the samples' 16-bit division.
    [bionic-p8051-B_Cu.gbr, bionic-p8051-B_Mask.gbr, bionic-p8051-B_Paste.gbr, bionic-p8051-B_Silkscreen.gbr, bionic-p8051-Edge_Cuts.gbr, bionic-p8051-F_Cu.gbr, bionic-p8051-F_Mask.gbr, bionic-p8051-F_Paste.gbr]
2026-10-04 [i8080] Add automation config
    Fix memory corruption from reading the bus status too early.
    [devs_i8080.h, devs_i8085.cpp, devs_i8085.h, pins_i8080.cpp, pins_i8080.h, pins_i8080_base.h, pins_i8085.cpp, pins_i8085.h]
2026-10-04 [i8096] Add automation config
    Fix the samples, which enabled the serial port interrupt instead of
    EXTINT.
    [pins_p8095bh.cpp, pins_p8095bh.h]
2026-10-04 [ins8060] Add automation config
    Fix the data bus pin order and the samples' signed division.
    [devs_ins8060.cpp, devs_ins8060.h, ins8060_sci_handler.cpp, pins_ins8060.cpp, pins_ins8060.h, regs_ins8060.cpp, signals_ins8060.cpp]
2026-10-04 [ins8070] Add automation config
    Fix auto-indexed addressing and the mandelbrot sample.
    [pins_ins8070.cpp, pins_ins8070.h]
2026-10-04 [mc6805] Add automation config
    The MC68HC05C0 and MC68HC08AZ0 run MC146805E2 code, and the MC68HC08AZ0
    runs MC68HC05C0 code too. Fix halting in WAIT and STOP, and the
    MC68HC08AZ0's interrupts and MUL/DIV stepping.
    [pins_mc146805e2.cpp, pins_mc146805e2.h, pins_mc68hc05c0.cpp, pins_mc68hc05c0.h, pins_mc68hc08az0.cpp, pins_mc68hc08az0.h]
2026-10-04 [tms370] Add automation config
    Fix the samples' 16-bit division and resuming after an oscillator fault.
    [bionic-tms370cx5x-B_Cu.gbr, bionic-tms370cx5x-B_Mask.gbr, bionic-tms370cx5x-B_Paste.gbr, bionic-tms370cx5x-B_Silkscreen.gbr, bionic-tms370cx5x-Edge_Cuts.gbr, bionic-tms370cx5x-F_Cu.gbr, bionic-tms370cx5x-F_Mask.gbr, bionic-tms370cx5x-F_Paste.gbr]
2026-10-04 [tms9900] Add automation config
    The TMS9980, TMS9995, TMS99105 and TMS99110 run TMS9900 code. Fix the
    TMS9980's program memory writes and the TMS9995's on-chip memory map.
    [bionic-tms99105-B_Cu.gbr, bionic-tms99105-B_Mask.gbr, bionic-tms99105-B_Paste.gbr, bionic-tms99105-B_Silkscreen.gbr, bionic-tms99105-Edge_Cuts.gbr, bionic-tms99105-F_Cu.gbr, bionic-tms99105-F_Mask.gbr, bionic-tms99105-F_Paste.gbr]
2026-10-04 [z80] Add automation config
    The Z80 mandelbrot does its I/O through IN/OUT (C), so the NSC800, Z180
    and Z280 run it as is.
    [bionic-z180f.kicad_pcb, bionic-z180f.kicad_sch]
2026-10-04 [samples] Rebuild an image when a file it includes changes
    A change to a shared .inc rebuilds every image that includes it.
2026-10-05 [280] Improve mandelbrot to wait send buffer empty per each frame
2026-10-06 [z280] Replay cycle dumps against the images they were recorded from
    Editing a sample shifted its addresses and broke the replay of older dumps.
2026-10-07 [z380] Add schematics
    [bionic-z380-B_Cu.gbl, bionic-z380-B_Mask.gbs, bionic-z380-B_Paste.gbp, bionic-z380-B_Silkscreen.gbo, bionic-z380-Edge_Cuts.gm1, bionic-z380-F_Cu.gtl, bionic-z380-F_Mask.gts, bionic-z380-F_Paste.gtp]
2026-10-07 [z380] Speed up the samples' division
2026-10-08 Fix the build with ENABLE_SERIAL_HANDLER defined
    The CDP1802 and i8051 devices lacked their handlers' includes. The
    handler stays off by default.
    [devs_cdp1802.cpp, devs_cdp1802.h, devs_i8051.cpp, devs_i8051.h]
2026-10-08 [test] Record bench rings where running samples stop
2026-10-08 [ins8070] Walk bus cycles with the common sequence legend
    Its host test replays the recorded runs and the bench rings; an
    interrupt pushes the PC and fetches at 0004 or 0007. The backtrace prints
    every cycle in order when verbose, the profile's fields too.
2026-10-08 [mc6809] Walk bus cycles with the common sequence legend
    With an Arch of its own, the MC6809's and the HD6309's: the host test
    replays both chips' recorded runs and bench rings, the HD6309s' running
    the MC6809 samples in emulation mode too. In native mode an interrupt
    reads the interrupted opcode's next byte once more before its pushes.
    echoir spins, echoitr waits with CWAI. The backtrace prints every cycle
    in order when verbose, the profile's fields too.
2026-10-08 [mc6800] Walk bus cycles with the common sequence legend
    The MC6800, MC6802, MB8861, MB8870, MC6801 and HD6301: the host test
    replays their recorded runs and bench rings, the SCI samples' too. The
    HD6301 takes an interrupt after an opcode fetched ahead. echoir and
    sciir spin, echoitr and sciitr wait with WAI. The backtrace prints every
    cycle in order when verbose, the profile's fields too.
2026-10-08 [tlcs90] Walk bus cycles with the common sequence legend
    Its host test replays the recorded runs and the bench rings, the UART
    samples' too. RETI pops AF, then PC; a direct-page access to the on-chip
    registers, FFC0-FFEF, has no data cycle. The backtrace prints every
    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
2026-10-08 [z280] Walk bus cycles with the common sequence legend
    Its host test replays the recorded runs, the dumps and the bench rings.
    A backtrace stopped at a breakpoint walks the planted RST 38H. The
    backtrace prints the profile's fields when verbose.
2026-10-09 [z380] Probe D0-D3 in the default channel set
2026-10-09 [scripts] Run single samples with sample:name
2026-10-09 [z8002] Update schematics
    [bionic-z8002-B_Cu.gbr, bionic-z8002-B_Mask.gbr, bionic-z8002-B_Paste.gbr, bionic-z8002-B_Silkscreen.gbr, bionic-z8002-Edge_Cuts.gbr, bionic-z8002-F_Cu.gbr, bionic-z8002-F_Mask.gbr, bionic-z8002-F_Paste.gbr]
2026-10-09 [z8001] Update schematics
    [bionic-z8001-B_Cu.gbr, bionic-z8001-B_Mask.gbr, bionic-z8001-B_Paste.gbr, bionic-z8001-B_Silkscreen.gbr, bionic-z8001-Edge_Cuts.gbr, bionic-z8001-F_Cu.gbr, bionic-z8001-F_Mask.gbr, bionic-z8001-F_Paste.gbr]
2026-10-09 [z8000] Run NMOS parts
    An NMOS Z8001 strobes later than the CMOS parts and switches mode less
    reliably:
    - #AS falls 22ns after CLOCK rises, missed by a 10ns settle; #DS falls
    32ns after a rising edge and rises 30ns after a falling one, so the
    I/O and acknowledge cycles that watch #DS settle as long before each
    look.
    - LDCTL FCW does not always set SEG, so the nonsegmented samples'
    interrupt return enters segmented mode with LDPS.
    [pins_z8000.cpp]
2026-10-10 [i8096] Clear INT_PENDING at reset
    A reset leaves it undefined, so an EXTINT latched at power-up was taken
    as soon as a program enabled it.
2026-10-10 [n8097] Add schematics for N8097BH
    [bionic-n8097-B_Cu.gbr, bionic-n8097-B_Mask.gbr, bionic-n8097-B_Paste.gbr, bionic-n8097-B_Silkscreen.gbr, bionic-n8097-Edge_Cuts.gbr, bionic-n8097-F_Cu.gbr, bionic-n8097-F_Mask.gbr, bionic-n8097-F_Paste.gbr]
2026-10-11 [scripts] Add route-length.py to compare routed track length with pad distance
2026-10-11 [debugger] Hold the i8251 Tx interrupt until the next character is sent
    A write drops TxRDY, but the done flag of the previous character raised
    it again on the next loop, too briefly for an edge-triggered CPU to see.
2026-10-11 [s80c196kc] Add S80C196KC schematics
2026-10-11 [i8096] Add S80C196KC and S80C196KB support
    The S80C196KB runs on the S80C196KC board: the QFP pinouts match.
    Untested on hardware: no board with the QFP layout exists yet.
2026-10-11 [scripts] Let a regress file move devices for the whole run
    A [devices] table places devices with the I command before the cases and
    restores them after, so a binary built for another chip of the family
    runs as is.
2026-10-11 [scripts] Let a regress sample name a hex in another directory
2026-10-12 [z380] Walk mode 2 and 3 interrupts in backtraces
    The handler's address read from the vector table had no sequence, so a
    backtrace through a mode 2 interrupt began at the handler.
2026-10-12 [z80] Share mandelbrot with the KL5C80
    Mode 2 is the only interrupt mode the KL5C80A12's on-chip controller
    serves.
2026-10-12 [mc6805] Drop CPU-type detection from the samples
    The mc6805 samples use the ACIA at 17F8, which the HC05/HC08 regress
    file moves there, so mandelbrot runs as is on all three chips; its other
    samples are MC146805E2-only. The mc68hc05 samples use the ACIA at FFE0
    on both of their chips. Both service the MC68HC08's COP unconditionally.
2026-10-13 [z8000] Read SN and R/#W, B/#W without reshuffling
    SN comes from one GPIO7 read, and RWBW is kept as read. SC #0FFH now
    both breaks and exits, so the samples' exit moves there. Comments are
    trimmed. Mandelbrot runs 2% faster on the Z8002, 0.6% on the Z8001.
2026-10-13 [debugger] Fix W65C816 cycle width, Z8 data drive and CDP1802 pin notes
    - mos6502: the W65C816 chose its 24-bit cycle on an E bit left in the
    ring slot from long before, so cycles after an XCE could read the
    wrong bank; it now reads this cycle's CNTL first. getAddr() is
    renamed getAddr16(), the counterpart of getAddr24().
    - z8: outData() turned the port to output before writing it, briefly
    driving the last cycle's data.
    - cdp1802: two pin comments named the wrong port bits.
2026-10-14 [debugger] Keep held-ring saves and go-until break points contained
    A go-until that starts on a break point steps off it first; when that
    step fails or lands on another break point, go() returned before run()
    could clear the temporary break point and left it set. Clearing break
    point 0 now drops only the temporary one instead of shifting the list
    into its slot.
    While the ring is held, Cycles::next() clears the in-flight cycle's
    capture flag, so the TMS370, TMS9900 and TMS320C15 sent a halt's
    captured register writes to memory or a device as well. They now read
    the flag before the clock edge.
2026-10-14 [i8080] Shorten mandelbrot's divide and multiply loops
    The divide shifts the divisor only until it passes the dividend,
    Q*F takes Q as the multiplier, and the 8251 gets RST instructions
    as its vectors and moves to 40H, where the Z80 board has it, so the
    samples also run on the Z80.
2026-10-14 [i8085] Run the i8080 mandelbrot and arith
    They differed from the i8080's only in interrupt setup, and the 8085
    keeps the 8080's INTR.
2026-10-14 [pdp8] Shorten mandelbrot's divide and multiply loops
    and -F*Q takes Q as the multiplier.
    The IM6100 and HD6120 debuggers keep a halt's register-save writes
    captured and its polled status intact, instead of storing them over
    page 0 and the current page.
    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
2026-10-14 [tms370] Shorten mandelbrot's divide
    udiv16_8 skips the high-byte DIV when that byte is below the divisor,
    and putchar re-enables interrupts between retries instead of pushing
    ST again.
2026-10-14 [ins8060] Speed up mandelbrot's multiply and divide
    The multiply splits its multiplier by byte in E and returns 0 for a
    zero multiplier; the divide runs in a P2 stack frame, compares the
    divisor with half the dividend, and returns at once when the divisor
    exceeds the dividend.
2026-10-15 [i8080] Mask interrupts in the register save
    The 8080's halt no longer lands on an interrupt acknowledge, whose M1
    looks like a fetch.
2026-10-15 [i8085] Halt through TRAP
    TRAP clears IE and stacks the PC itself, and RIM still reads the IE
    it cleared, so a pending interrupt can no longer take over the save.
2026-10-15 [pdp8] Hold INTREQ off while the debugger owns the CPU
    From the fetch a halt stops at until the program's first fetch after
    the restore, so no interrupt can come in during the save or restore.
2026-10-15 [ins8060] Mask interrupts in the register save
2026-10-15 [ins8070] Mask interrupts in the register save
2026-10-15 [mc6809] Let a halt or step get past another interrupt's entry
    A halt captured an IRQ, FIRQ or SWI2/3 frame as NMI's, and a step with
    IRQ or FIRQ pending stayed on the same instruction.
2026-10-15 [scn2650] Mask interrupts in the register save
2026-10-15 [tlcs90] Resume a halt or break with interrupts as they were
    The register save stored F after the NMI or SWI had cleared IFF. The
    restore now sets IFF last, with EI before the jump.
2026-10-15 [tms320c15] Mask interrupts in the register save
2026-10-15 [z8] Mask interrupts in the register save
    A halt also lets an interrupt acknowledge under way finish before the
    PC is saved.
2026-10-15 [z80] Save and restore the interrupt enable
    The halt returns from its NMI with RET, so interrupts stay off through
    the save; the restore enables them, as the program had them, right
    before the jump. The Z180 resumes at the fetch the restore stopped at,
    an interrupt handler's when one came in.
2026-10-15 [z380] Mask interrupts in the register save
2026-10-15 [i8085] Return the TRAP frame rather than keep it in the pins
2026-10-15 [i8096] Stop a step at the first fetch past the instruction
    An interrupt taken at a step left the CPU running in its handler; it
    now stops there. Where the CPU has INST, every fetch past the
    instruction gets the TRAP.
2026-10-15 [i8096] Halt the N8097BH through NMI
    A program running with EXTINT masked could not be halted. An interrupt
    the CPU takes before the save now runs its handler first.
2026-10-15 [i8051] Keep a pending interrupt out of the register save and restore
    SJMP $ runs at the halt until no interrupt comes, or the save starts at
    the handler; the restore sets IE right before the jump.
2026-10-15 [mc68hc08] Keep a pending interrupt out of the register save
    No halt in an interrupt's stacking, and an IRQ that takes the SWI's
    place stacks the PC before it.
2026-10-15 [tms7000] Keep a pending interrupt out of the register save and restore
    JMP $ runs at the halt until no interrupt comes, or the save starts at
    the handler; the restore ends with RETI.
2026-10-15 [tms370] Keep a pending interrupt out of the register save and restore
    JMP $ runs twice without an interrupt before the save; reset also turns
    off the oscillator fault detector.
2026-10-16 [tms9980] Time bus samples from the #PHI3 fall
    The address, control and data were sampled at fixed delays from CKIN
    edges, racing the chip's output changes; anchor each cycle on #PHI3
    instead, and bound the halt's wait for the NMI vector.
2026-10-16 [tms370] Bound the waits for a bus cycle
    A CPU that stopped issuing bus cycles wedged the board until the
    watchdog rebooted it.
2026-10-16 [z8] Enable interrupts with IRET on restore
    An interrupt could come in between the IMR load and the JP.
    Z88_FAST_INTERRUPT follows the Super8 fast interrupt, which pushes
    nothing. The casts are re-recorded on this firmware.
2026-10-16 [debugger] Add a stress build that thins the halt poll
    Y n, in the teensy41-stress build only, yields on one in n halt polls;
    haltgo now halts first at a random point too, within 0.2 s.
2026-10-16 [samples] Make the comments match the code and say what it does not
    Fix wrong registers, clobber lists, formulas and expected answers, add
    routine contracts and the tricks behind the code, and trim noise. The
    listings are rebuilt; no binary changes.
2026-10-16 [mc68hc12] Add schematics
2026-10-16 [debugger] Keep device wiring across reset; set the vector with I
    A device's base address and interrupt vectors are board wiring, so R
    and the 8251's internal reset no longer touch them. `I dev addr vec`
    sets both vectors, and the listing shows them in the target's radix.
2026-10-16 [scripts] Rewire devices per program and after a scenario
    R keeps device wiring now, so the regress applies [devices], which may
    give a vector, before each program it loads and restores it even when
    interrupted; record-scenario puts back any device a scenario moved. The
    i8096 regress turns the USART's interrupts off, since its polling
    samples enable EXTINT for the halt switch.
2026-10-16 [scripts] Name, watch and lock each bench
    scripts/bionic-bench.py names each Teensy bench1, bench2, ... in the
    order seen, and a session can rename one. Its daemon logs power,
    flashes and the target seated, with the firmware's branch and image
    hash, next to the uploads and commands each session sends. A session
    locks a bench or a logic analyzer, or queues for one; the lock passes
    on when its holder's process ends, and anyone can peek at what a bench
    prints. bionic-control.py talks to the bench the session holds, refuses
    one held by another, and flashes only that bench's Teensy. Every
    command-line script is executable, and scripts/README.md lists them.
2026-10-17 [s80296sa] Add schematics
2026-10-17 [cp1610] Add schematics
2026-10-17 [mc68hc16] Add schematics
2026-10-17 [samples] Wait for the Tx queue to drain after each frame
    Mandelbrot samples drawing a frame in under 10 s call queue_wait_empty
    after the frame's newline, so each frame ends with its output sent.
    queue_wait.inc keeps it out of samples that never wait. It replaces the
    mc68hc12 and z280 private versions; scenario addresses follow the moved
    code, and per-frame breakpoints sit after the wait. Their casts are
    re-recorded; a TMS9981 replaces the TMS9980 and a TMS99110 in baseline
    mode stands in for the TMS99105.
2026-10-19 [scripts] Watch bench state changes and log more of them
    A session follows its benches with `bionic-bench.py watch --mine` under
    a Monitor instead of polling status. The log now also carries the
    daemon's start and stop, CrashReports read on the first open after a
    re-enumeration, and each board state check and recover result.
2026-10-19 [scripts] Retry a flash on the bench's own bootloader
    A Teensy that reaches HalfKay too late for the first loader run made the
    retry refuse as if another bench were in its bootloader. Each failed
    attempt now logs and prints the loader's output.
2026-10-19 [z80] Zero the register upper halves for the Z380 mandelbrot
    (HL) uses all 32 bits of HL in Native mode, and Z80 code never writes
    the upper halves, so the scenario clears BC, DE, HL, IX and IY before
    the run. The re-recorded frame takes 17.4 s.
2026-10-19 [debugger] Drop the i8251's deferred Tx interrupt on a data write
    The previous character's interrupt rose after the next write had cleared
    TxRDY, so an edge-triggered CPU saw no edge when TxRDY was set again and
    its transmit queue stalled.
2026-10-19 [i8096] Clock the S80C196KC bus cycle on its own
    Its state is two XTAL1 periods and its outputs lag XTAL1 by up to
    110 ns. It halts through NMI, as the N8097BH does, and pushes the PC
    before it reads a vector. After a reset it holds ALE high before the
    first fetch's address is on AD, so that fetch is taken as 2080H; an
    RST, seen as #RESET low during a long wait, gets the same handling.
    The S80C196KB shares the board as one S80C196K identity: a store to
    0100H reaches the bus only on the KB, whose register RAM ends at 0FFH.
    libasm 1.6.68 names the 80C196KB.
2026-10-19 [i8096] Share the samples across every i8096 board
    The USART moves to 0400H, above the 80C196NP's register RAM, and the
    samples enable and vector both EXTINT and the 80C196NP and 80296SA's
    EXTINT0 to one handler, so one build serves every chip. The P8095BH
    and N8097BH mandelbrots are re-recorded from it.
2026-10-20 [i8096] Clock the S80C196KC bus cycle on its own
    The walker gains 80C196 traits, off for every other CPU: the queue
    holds five bytes past the running instruction, a short jump's target
    m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
2026-10-20 [scripts] Add KiCad board draft helpers
    Draw a new board's first schematic, unrouted PCB, bionic TOML and CPU
    STEP model from pin lists, and finish a routed board: bypass stubs, GND
    stitching and straightened tracks.
2026-10-20 [mc68hc12] Refactor samples
    Split mc68hc12.inc into the CPU12 core and the MC68HC912BD32 chip, so
    the HCS12 and HCS12X samples can share the bodies. Take the queue in
    CPU12 indexed modes, and keep the mandelbrot loop's values in X and Y
    instead of on the stack.
2026-10-21 [mc68hc16] Add debugger
    Written against the manuals before the board exists; bench-dependent
    timings and landing points are marked ATTENTION.
2026-10-21 [i8096] Split the samples into bodies, fix queue_add when full
    Each sample's body moves into an .inc that another board's samples can
    include, as samples/mc68hc12 does; the i8096 images are unchanged by
    the split. queue_add on a full queue returned the C=1 that CMPB leaves
    on equal operands, so putchar dropped the character; no board so far
    filled the Tx queue. A NOP follows each DI that guards a queue call: an
    80296SA takes an interrupt requested during DI after DI's next
    instruction (80296SA user's manual, 6.4.1). The P8095BH, N8097BH and
    S80C196KC mandelbrots are re-recorded. libasm goes to 1.6.69.
2026-10-22 [debugger] Read I's base as 32-bit, and take Rx and Tx vectors
    The listing printed a base wider than I read back, so the tools that
    restore a listing set the i8096's USART to 000000. `I dev addr rx [tx]`
    sets the two vectors apart, Tx defaulting to Rx.
2026-10-22 [i8096] Add S80C196NP and S80296SA support
    Both run in 64-Kbyte mode on the debugger's 16-bit addresses, and a DPTS
    at reset tells them apart on their shared board. The S80296SA reads a
    vector before it pushes the PC and resets BUSCON5 on its own RST, which
    the debugger sets again; WSR1 is saved with the registers. A halt that
    takes it inside a call, after the call's push, resumes at the call's
    target. Its own instructions are in the tables, recorded on the chip.
    The S80C196NP is not yet run.
2026-10-22 [i80296] Add samples for the S80296SA
    The S80296SA board's samples include samples/i8096's bodies, assembled
    for the 80296, whose signed multiply and divide drop the FE prefix.
    Where a sample takes the USART's interrupt, P2.2 is first made the
    EXTINT0 input. The mandelbrot is recorded on the S80296SA, as is the
    i8096 one, with P2.2 set up from the debugger.
2026-10-22 [i8096] Disable interrupts before each call in the interrupt samples
    An 80296SA can take an interrupt inside a call, after the call pushed its
    return address, and push that address again: the handler returns past
    the callee, which dropped characters from mandelbrot. Callers disable
    interrupts and the callees enable them again; the NOPs after DI never
    helped.
2026-10-22 [i8096] Shorten the bus cycle's software time
    The halt switch's poll and the memory access stretched every bus cycle.
2026-10-22 [i8096] End an N8097BH halt's ring before its NMI push
    The NMI pushes the PC and reads no vector, so a ring ending on the push
    fit no interrupt sequence and the backtrace disassembled nothing.
2026-10-22 [scripts] Model rectangular QFPs in qfp_step.py
    Body, span and lead count take an (x, y) pair, and the marking gains
    spaced lines, printed rectangles and circled letters.
2026-10-22 [s80296sa] Fit the QFP pads to Intel's lead span (rev 2)
    The stock 14x20 footprint's pads ended at the leads' tips, leaving no
    toe fillet, and ran well inside the heel.
2026-10-24 [debugger] Add K to set the CPU clock input in a tuning build
    The teensy41-clock build adds K, to show or set the clock input a
    target's run uses, on a target that clocks its runs from a timer.
2026-10-24 [mc68hc16] Run from a free-running PWM clock
    A first step towards CPUs whose clock goes through a PLL. A run clocks
    EXTAL from FlexPWM3 at 10 MHz, the fastest the regress passes at, and
    holds each cycle by withholding #DSACK1; everything else stays
    bit-banged. K in the tuning build takes 1 kHz to 15 MHz.
2026-10-24 [docs] Record how the MC68HC16 runs from a PWM clock
    The findings that belonged in the PWM commit: holding cycles with
    #DSACK1, the masked clock handover, and GPIO and FlexIO pad use. The
    mandelbrot cast is re-recorded on the 10 MHz PWM clock.
2026-10-26 [tms9900] Model the DIP-64 socket as two round-pin strips
    The socket is a 1x40 round-pin strip (Akizuki 101591, Neltron 6604S)
    cut into two 1x32 strips; the stock KiCad header models were not
    installed, so the socket rendered empty.
2026-10-26 [schematics] Model the Bionic connectors as populated
    The Bionic-P135/P245 SMT and THT footprints now use
    bionic.pretty/Bionic-{SMT,THT}_1x24.step from kicad-library: KiCad's
    1x24 headers without the unpopulated pins 10/19 (30/39), and with
    straight end pins on the SMT header.
2026-10-26 [schematics] Straighten board tracks and regenerate Gerbers
    straighten_tracks.py on every routed board: router leftovers snapped to
    0/45/90 degrees and redundant segments merged, each pass DRC-checked
    (counts unchanged). Gerbers and drill files of the changed boards are
    regenerated with each board's plot settings, keeping the committed file
    sets; tms9980 keeps its tracks (the rebuild left a dangling VCC stub).
2026-10-26 [schematics] Align silkscreen reference labels
    align_silk.py snaps each footprint kind's labels onto their common
    offset and angle and clears labels DRC flags on silkscreen; 76 labels on
    22 boards, no DRC count grows. Their Gerbers are regenerated.
2026-10-26 [schematics] Remove the JLC order-number marker from all boards
2026-10-26 [base] Re-render the board picture at an angle, without the JLC marker
2026-10-26 [mezzanine] Use the base board's ZIF socket 3D model
2026-10-26 [tms9900] Poll the halt switch every 16 bus cycles in a run
    Its yield() held the clock at every cycle boundary, stretching the
    TMS9980's CKIN well past the 6 MHz minimum.
2026-10-26 [tms9980] Run CKIN from a free-running PWM, holding cycles with READY
    The bit-banged CKIN was held well past the 6 MHz minimum at every bus
    cycle boundary; the PWM keeps it at 10 MHz.
2026-10-26 [tms9980] Record the mandelbrot casts on the PWM clock
2026-10-26 [build] Bump libasm to 2.0.0
    Also bring the docs' counts and statuses up to date: libasm's
    architectures and CPUs, the adapter boards, the S80C196K identity, the
    firmware size and the Z8001 nonsegmented mandelbrot row.
2026-10-27 [p8086] Redraw the P8086 board for the Bionic connector pin map
    One board for the P8086, P8088, V20 and V30 with no logic ICs; the
    8-bit parts are told apart by pin 28's polarity. Routed on two layers.
2026-10-27 [p8086] Clean up the P8086 tracks and regenerate Gerbers
    Pad-exit stubs merged into straight and 45-degree runs, every track
    ending on its pad centre; C1/C2 labels aligned. Re-exported the
    schematic PDF.
2026-10-27 [mc68008] Redraw the MC68008P board and add the MC68008FN board
    Global labels as on recent boards; A8-A15 through one 74AHCT157 on
    P30-P33, FC on P50-P52, #HALT read with the strobes on P46, CLK on
    the PWM-capable P47. The MC68008FN board adds a second 74AHCT157 for
    A16-A21 on P34-P37.
2026-10-27 [mc68008] Clean up the MC68008P layout and add its Gerbers
    Straighten the tracks, put the bypass capacitors on their supply pin
    axes and line up the reference labels.
2026-10-27 [mc68008] Clean up the MC68008FN layout and add its Gerbers
    Straighten the tracks, centre the bypass capacitors on the supply pin
    and line up the reference labels.
2026-10-27 [d8087] Add a P8086 board with a D8087 coprocessor
    The D8087 sits beside the CPU on the same bus, with its INT on the
    free P44; it needs the CPU in maximum mode.
2026-10-27 [scripts] Let straighten_tracks.py move vias and guard against bent tracks
    Many leftovers on routed boards were vias wedged between stubs, vias a
    few microns off a pad's axis, jogs dodging another net's via, and 45°
    jogs under 0.1 mm, now treated as noise when DRC allows. The new
    off-axis check stops a short stub collapse from bending its
    neighbour, as happened on a second run over the MC68008FN.
2026-10-27 [build] Keep libasm in flash
    libasm serves only the assembler and disassembler commands, so its code
    and tables move out of RAM1 to leave room for more targets.
2026-10-27 [build] Add a teensy41-overlay image with only one target in ITCM
    One target runs per power-up, so with ITCM_OVERLAY each target
    directory's code becomes an ITCM overlay kept in flash; RAM1 holds the
    shared code and the largest overlay instead of every target.
2026-10-28 [mc68000] Add MC68000P, MC68000PS and MC68000FN boards
    DIP64, SDIP64 (HD68HC000PS) and PLCC68 boards with four 74HCS153 on
    P30-P37, routed, with Gerbers. The DIP64 board is 2-layer; the SDIP64
    and PLCC68 boards are 4-layer with GND and VCC planes. The PLCC68 board
    has a MODE jumper for the MC68HC001.
    straighten_tracks.py now centres a via a little off its pad's line.
2026-10-28 [hd641016] Add the BionicHD641016 board
    HD641016CP in a PLCC84 socket on a 2-layer board widened to 36.83 mm.
    Unused inputs are tied high and unused I/O pins pulled up, as the
    manual's pin-state notes ask.
2026-10-28 [scripts] Match KiCad 9's "PTH pad" in stitch.py's DRC report
2026-10-28 [debugger] Share the PWM clock code as PwmClock<PIN>
    The MC68000 family takes its clock from P47 as the MC68HC16 does, and
    other boards will too. The pin fixes every FlexPWM register at compile
    time, so the shared code costs nothing in a per-cycle loop. The
    MC68HC16 and the TMS9980/TMS9981 use it now.
2026-10-28 [tms370] Run CLKIN from a free-running PWM, holding cycles with #WAIT
    The oscillator fault logic reset the CPU whenever the bit-banged CLKIN
    paused, so every run and step began with a reset; the PWM keeps CLKIN
    at 18.75 MHz and those workarounds go.
2026-10-28 [tms370] Record the mandelbrot cast on the PWM clock
2026-10-28 [scn2650] Run CLOCK from a free-running PWM, holding cycles with #OPACK
    The timer paces each cycle instead of 17 hand-tuned clock delays, and
    the CPU runs at its rated 1.25 MHz; the clock build lets K overclock
    it. The mandelbrot casts are recorded at 1.25 MHz and at 2.0 MHz.
2026-10-28 [debugger] Pace a bit-banged serial handler by the cycle counter
    A CPU on a free-running clock gives no edges to count, so the handler
    can tick by the clock's rate on the Teensy's cycle counter instead.
2026-10-28 [ins8060] Run XIN from a free-running PWM, holding cycles with #HOLD
    XIN must not stop below 0.1 MHz. It now runs at 150 MHz / 37, #HOLD
    stretches each strobe until the cycle is served, and #ENIN grants each
    cycle ahead of its request so #ADS's status is read on time.
2026-10-28 [ins8070] Save S in the samples' interrupt handlers
    An interrupt between an ADD and the LD A,S that reads its carry changed
    CY, which the free-running clock exposed as wrong bits in echoitr.
2026-10-28 [ins8070] Run XIN from a free-running PWM, holding cycles with #HOLD
    XIN must not stop below 1.0 MHz. It now runs at 150 MHz / 37, and #HOLD
    keeps each external cycle until it is served.
2026-10-28 [debugger] Re-arm a bit-banged receiver only on a mark
    A sender whose bits run longer than the handler's may still be sending
    bit 7 when the handler expects the stop bit; a space there read as the
    next start bit and a phantom 0xFF.
2026-10-28 [ins8070] Retune the bit-banged serial to INS8073 BASIC
    The divider tuned to the bit-banged XIN no longer matched on the PWM
    clock: INS8073 BASIC's echo came back garbled and its input corrupted.
2026-10-28 [tms370] Note the PWM clock rate in the mandelbrot table
2026-10-28 [ins8060] Note the PWM clock rate in the mandelbrot table
2026-10-28 [ins8070] Note the PWM clock rate in the mandelbrot table
2026-10-28 [docs] Explain clocking the CPU from a timer
    The user docs only described bit-banged clocks, though six targets now
    run from a FlexPWM clock and the teensy41-clock build has a K command.
2026-10-28 [docs] Plan the 3.3 V base bus holder behind the TXS0108E
    The TXS0108Es stay as buffers, and their 40 kohm pull-ups outpull a
    single bus-hold cell holding a low, so each data line gets four.
2026-10-28 [docs] Give the 3.3 V base a CPU rail of its own from VBUS
2026-10-28 [docs] Use octal 74LVCH244As for the 3.3 V base bus holder
2026-10-28 [cp1610] Note the UCC27444 as the clock driver's replacement
2026-10-28 [cp1610] Name the UCC27624 as the best clock driver
2026-10-28 [docs] Gather the high-voltage clock drivers in one section
2026-10-28 [debugger] Move a pending UART interrupt when its vector is rewritten
    A program's vector write left the request asserted on the old vector,
    so echoir failed after mandelbrot had wired the 8085's Tx to RST 6.
2026-10-28 [i8080] Run the P8085's X1 from a free-running PWM, holding cycles with READY
    An 8085AH-2 runs at its rated 10 MHz X1, and the mandelbrot frame
    drops from 40.2 s to 32.2 s; the clock build lets K set the rate.
2026-10-28 [debugger] Add busWriteFast(), writing a bus without reading its port
    busWrite()'s read of the data register can stall behind earlier
    peripheral accesses; it stays for targets whose timing counts on it.
2026-10-28 [i8080] Run the P8080's PHI1 and PHI2 from free-running PWMs, holding cycles with READY
    A P8080A-1 runs at 2.5 MHz, and the mandelbrot frame drops from 63.2 s
    to 49.7 s; plain memory reads take no wait state.
2026-10-28 [docs] Plan a FlexIO bus engine for multiplexed buses
    A polled Teensy can't catch a multiplexed bus's address strobe under a
    free-running clock; the P8085 read zero-wait only at 6 MHz.
2026-10-28 [cdp1802] Read memory ahead and trim the bit-banged clock to 5 MHz
    The low address byte is valid from early c30, so memory is read in c40
    and staged in the port with busWriteFast(); the halt switch and devices
    are polled once in 10 us.
2026-10-28 [debugger] Build K into the standard image, unlisted
    Every Teensy build now defines TUNE_CLOCK, so a sweep or a rate change
    needs no separate image; K stays out of the usage text.
2026-10-29 [kl5c80] Clear the Tx vector in echoir
    Mandelbrot leaves the USART's Tx request wired to IR0, which held the
    edge-triggered IR0 low, so echoir run after it never got an interrupt.
2026-10-29 [z80] Add a bounded wait and a K hook for PWM-clocked variants
2026-10-29 [z180] Run EXTAL from a free-running PWM, holding cycles with #WAIT
    The Z8018008 and Z8018010 run at 16.67 MHz, the HD64180S at 18.75 MHz.
    The Z8018010 gets casts of its own.
2026-10-29 [nsc800] Run XIN from a free-running PWM, holding cycles with #WAIT
    XIN runs at 8.33 MHz, CLK 4.17 MHz.
2026-10-29 [kl5c80] Run XIN from a free-running PWM, holding cycles with ERDY
    XIN runs at 18.75 MHz, CLK 9.375 MHz.
2026-10-29 [mos6502] Speed up the 6502-family mandelbrots; add a G65SC02 build
    The mos6502 loop inlines its constants and its 16-bit loads, stores,
    adds and subtracts instead of calling helpers; samples/g65sc02 is the
    same code for the CMOS cores, with STZ and BRA. The W65C816 build keeps
    its squares and multiply result in memory. Frames drop from 71.6 s to
    47.0 s on the UM6502A and from 33.6 s to 32.7 s on the W65C816, and the
    G65SC02 build draws in 46.6 s. The casts are re-recorded on the new
    images.
2026-10-29 [kl5c80] Run the i8080 mandelbrot on the KL5C80A12
    The KL5C80A12 takes interrupts in mode 2 only, so mandelbrot_mode2 is
    the 8080 program with the Z80 build's mode 2 setup and Rx/Tx handler,
    now shared in samples/z80 with the KL5C80 echo samples. The other
    binaries are unchanged.
2026-10-29 [docs] Measure the bit-banged clocks and re-record their casts
    Each 🔨 rate is the average of two 5 ms windows on the clock pin while
    the cast's program ran, on the image that recorded the fresh casts.
    Adds the MC68HC11A0P's MC6800/MC6801 rows, the MN1613A and the G65SC02
    build's rows, joins the cast and listing icons into one column, and
    gives each family table a row per chip with its seconds per listing.
2026-10-29 [scripts] Show every supply pin of a CPU symbol
    Stacked supply pins hid which VCC and VSS pins a board ties.
2026-10-30 [scripts] Measure chip photos and draw QFP footprints
    photo_measure.py reads lead, corner and marking dimensions off a chip
    photo for qfp_step.py, which can now cut a pin 1 index corner;
    qfp_footprint.py replaces the hand-drawn Hitachi QFP footprints.
2026-10-30 [scripts] Put a new board's origins on the outline's top left corner
    The 2-layer template board has its origins off the board.
2026-10-30 [h8536] Add the BionicH8/536 board
    H8/536 HD6475368TF (TQFP80) in mode 3 on a 2-layer board; A8-A11
    and A16-A19 share P30-P33 through a 74AHCT157. U1 has pads sized
    for hand soldering from the TFP-80C drawing and a 3D model of the
    chip on hand. TXD and RXD reach P44 and P45.
2026-10-30 [h8323] Add the BionicH8/323 board
    H8/323 HD6413238F (QFP64) in mode 1 on a 2-layer board, wired
    straight to the Bionic connectors: 8-bit bus, 64 Kbytes, SCI on
    P44/P45. U1 has pads sized for hand soldering from the FP-64A
    drawing and a 3D model of the chip on hand.
2026-10-30 [h8510] Add the BionicH8/510 board
    H8/510 HD6415108F (QFP112) in mode 4 on a 4-layer board; A0-A23 reach
    P30-P37 through two 74HCS153 and a 74AHCT157. U1 has pads sized for
    hand soldering from the FP-112 drawing and a 3D model of the chip
    on hand. Supplies reach a GND plane on In1 and a VCC plane on In2.
    SCI1 TXD1 and RXD1 reach P44 and P45.
2026-10-30 [scripts] Fix the pad-centre ends of straightened runs
    joined() read tracks commit() had deleted, crashing on the H8/5xx
    boards. Also keep an in-pad leg that misses its run by a micron, try
    the run onto the centre before adding a leg, slide a via whose one
    leg crosses a pad onto its centre, and never snap an end off a pad
    centre.
2026-10-30 [mos6502] Move PHI0 to P47 and run CMOS parts from a PWM clock (rev 11)
    PHI0 on P55 has no FlexPWM output; P47 does. Rev 11 moves PHI0 there
    and swaps PHI2O, E and PHI1O around it. Reset tells the parts apart
    bit-banged, then the G65SC02, R65C02, W65C02S and W65C816S hand PHI0
    to the PWM at a rate per part, holding each cycle with RDY; the NMOS
    6502 ignores RDY on writes and stays bit-banged. Unbenched: the rev 11
    board does not exist yet.
2026-10-30 [h8510] [h8536] End the boards' tracks on their pad centres
    Re-run the track straightener with the pad-centre fixes (#184) and
    regenerate the Gerbers.
2026-10-30 [h8323] Name the chip above U1 on the silkscreen
2026-10-30 [schematics] Use the THT connector footprint on p8095 and tms32010
    The old Vertical footprint has the same pads and only pointed at the
    stock pin-header 3D model, so the Gerbers do not change.
2026-10-31 [ns32016] Redraw the BionicNS32016 board
    Move it to the SMT connector, and generate PHI1/PHI2 on the board from
    CLK with a 74LVC02 non-overlap clock generator.
2026-10-31 [ns32016] Add the BionicNS32081 board
    An NS32016 with an NS32081 FPU beside it, sharing the NS32016 board's
    Bionic pin map.
2026-10-31 [dct11] Add the BionicDCT11 board
2026-10-31 [dcj11] Add the BionicDCJ11 board
2026-11-02 [debugger] Show the rest of a continued instruction
    libasm decodes CP1600's SDBD with its instruction, and the 8086's WAIT
    before one it doesn't merge with, as two names over one instruction;
    the disassembly printed only the first.
2026-11-02 [i8086] Add debugger
    The P8086 and D8087 boards, both in maximum mode: CLK free-runs from
    FlexPWM3, as the V20/V30 and the NMOS 8087 need, and READY holds every
    bus cycle until it is served. Reset runs at 2.5 MHz to tell the 8086,
    8088, V30 and V20 apart, then each runs at 5 MHz with its own clock
    phase; K overrides both. Samples and regress for all four chips.
2026-11-02 [i8086] Disassemble the halt backtrace from the queue status
    DMA samples QS1/QS0 every clock into a ring; the decoder pairs the
    bytes taken with the fetches, so the backtrace lists the instructions
    the CPU ran. Mandelbrot casts for the four P8086 parts.
2026-11-02 [debugger] Make P a target's memory area
    The target names the area and gives it its meaning; assemble() and
    disassemble() become virtual for a target with code of two kinds.
2026-11-02 [i8086] Run the mandelbrot with 80186 instructions on the V20/V30
    IMUL by an immediate replaces two of the per-pixel multiplies; the
    inner loop's 32-bit IMUL and IDIV have no 80186 form, so the frame
    times stay those of the 8086 code.
2026-11-02 [i8086] Start sample interrupt handlers on even addresses
    The first fetch after a jump to an odd address is a single byte on a
    16-bit bus. getchar, putchar and the queue routines are aligned too.
2026-11-02 [build] Bump libasm to 2.0.1
    It decodes a WAIT before a non-control instruction as its own
    instruction (libasm #174), which the D8087 board needs to disassemble
    8087 code.
2026-11-03 [scripts] Give each channels.toml channel its connector pin
    A channel is { pin = "P10", signal = "D0" }: the lead's Bionic
    Connector pin is data, not a comment, and the table may hold more
    than channels.
2026-11-03 [scripts] Keep a capture's trigger, decoders and view in channels.toml
    A table may give its trigger ({ signal, edge, when, before, after }),
    its Simple Parallel decoders and its row order, so saleae-logic-pro.py
    can arm a capture from the table and save it named and decoded.
2026-11-03 [mos6502] Return the debugger to the rev 10 board
    The 6502 boards in use are rev 10. The rev 11 firmware from 81ba135e6
    (PHI0 on P47, a PWM clock for the CMOS parts) drives the wrong pins on
    them, and no rev 11 board has been built yet. Restore the bit-banged
    debugger, the capture channels and the docs to rev 10. The rev 11
    schematics and Gerbers stay.
2026-11-03 [build] Bump libasm to 2.0.2
    It decodes a CP1600 immediate without SDBD as a full 16-bit word
    (libasm #198), as the CP1610 board needs for MVII and the like.
2026-11-03 [scripts] Sample channels.toml entries analog on request
    An entry with `analog = [high, low]` is sampled analog, at 50 MS/s
    beside 125 MS/s digital, and saved with its row spanning those volts;
    load-sal writes the range back. Other entries stay digital as before.
2026-11-04 [scripts] Sample an analog channels.toml entry digital too on request
    An entry with `analog = [high, low]` and `digital = true` is sampled
    both ways, so an analog clock can clock a Simple Parallel decoder.
    With more than 14 digital channels the Logic Pro 16 takes 100 MS/s
    beside 50 MS/s analog.
2026-11-04 [cp1600] Add CP1610 support
    Debugger and samples. PHI1/PHI2 run free from FlexPWM at the rated
    2 MHz, phases as the Data Manual gives them. BDRDY holds a fetch while
    the debugger is away, BUSRQ pauses the CPU for USB work once every 256
    transactions, and #STPST halts and steps it, as #INTR cannot be pulled
    low on the rev 1 board. A break point serves HLT and NOP. Memory, the
    operand of a reading instruction, the IAB vector and break points are
    looked up ahead of the DTB. R6/R7 disassemble as SP/PC.
2026-11-04 [i8096] Zero-extend the value print_uint16 divides
    EXT sign-extended it, so values from 0x8000 up printed wrong digits.
    Add arith cases for a negative multiplicand and a -32768 multiplier.
2026-11-04 [samples] Add arith cases for a negative multiplicand and a -32768 multiplier
    The samples whose multiply needs no change get the same cases.
2026-11-04 [debugger] Write buses through the clear and set registers
    A read of the GPIO data register stalls behind earlier peripheral
    accesses, so every target writes its buses with a clear then a set.
    A phase left holding only the write gets a minimum: the i8051's XTAL
    high and the TLCS-90's X1 high that stage a read's data, the
    MC68HC05C0's read c4 low, the HD6120's read-out OSC low and the
    TMS9995's read CLKIN high.
    The clear-then-set write can show a code that was never asserted, so
    the TMS9980 goes through interrupt code 7 and the TMS99105 changes
    IC0-IC3 with #INTREQ negated. The KL5C80A12's mode 2 mandelbrot moves
    from the P8080's regress to its own.
2026-11-04 [scripts] Capture at the fastest sample rate the channels allow
    Logic 2 lists the rates a channel set takes when given one it cannot,
    so each capture asks and takes the fastest: on the Logic Pro 16, 500
    MS/s for up to 6 digital channels, 250 for up to 12 and 125 for more,
    against a fixed 100 before. With analog channels the analog rate comes
    first, as the fixed pairs chose.
2026-11-05 [samples] Disable the USART's Tx interrupt in echoir
    The USART's interrupt wiring survives a reset, so after mandelbrot or
    echoitr enabled its Tx interrupt, echoir's Rx-only handler kept taking
    TxRDY requests and never echoed. echoir now writes 0 to the Tx vector,
    as the other archs' echoir already do.
2026-11-05 [n80c186] Add the BionicN80C186 board
    An N80C186XL (PLCC68) on the Bionic Connector sheet column AC. The
    #RD/#QSMD pin goes to P34, so the firmware picks the bus mode at reset:
    held low it selects queue status mode, with QS0/QS1 on P40/P41 next to
    the #S0-#S2 status on GPIO9; left as an input it reads #RD in normal
    mode, where P40/P41 carry ALE/#WR. ALE also reaches P36, a FlexIO3 pad,
    so FlexIO3 can latch the AD bus on it. The #DEN strobe on P45 marks when
    AD carries data; INT1 is tied low, INT0 is the maskable interrupt.
    Address/data pins are direct, no mux.
    The PCB is a routed 2-layer board in BionicMC68000FN's outline, with
    GND poured on both sides.
2026-11-05 [samples] Return from the pdp8 interrupts through ION
    The IM6100's RTF enables interrupts after the next instruction, so an
    interrupt pending at the exit landed before its JMP I 0 and overwrote
    the return address. The handlers now restore L with a skip and AC with
    a TAD into a cleared AC, then return with ION, which enables interrupts
    only after the JMP.
2026-11-05 [n80c286] Add the BionicN80C286 board
    An N80C286 (PLCC68) on the Bionic Connector sheet column AI: A0-A23
    through four 74HCS153, with #LOCK/HLDA/#PEACK on phase 10 of the
    A16-A23 muxes, and INTR, NMI and HOLD on a 74HCT259. PEREQ is tied
    low, #BUSY and #ERROR high.
    The PCB is a routed 4-layer board in BionicMC68000FN's outline, with
    GND on In1 and both outer layers and VCC on In2.
2026-11-05 [mc68008] Improve parts layout
    Centre the 157 in the socket and the power LED on the MC68008P, and
    mark pin 1 of the MC68000PS socket at its notch. No electrical or
    schematic change.
2026-11-05 [samples] Move mc68xx above every 68xx chip's internal map
    At 1000 it ran over the MC68HC11A's register block, where the
    HC11A0 stalled silent; at 0100 its stack sat in internal RAM.
2026-11-05 [hd641016] Notch the socket courtyard at pin 1
    Follows the 3M 8484 body's chamfered pin 11/12 corner, with a silk
    dot marking pin 1.
2026-11-05 [debugger] Reject a record whose length or checksum is wrong
    The loaders took the length from the count field, so a line cut short
    loaded what an earlier line left in the buffer. A bad record now prints
    ?bad record and loads nothing. S2 and S3 records no longer take the
    checksum and an address byte as data.
2026-11-05 [debugger] Take the halt switch when the devices report a service
    Device::loop() and Devs::loop() now return true on the cycle a device
    ran its slow service, or once in 10 us when none is enabled, and every
    bus loop takes the halt switch only then. The UART paces itself by
    time, once in 10 us, instead of once in 256 loop() calls, a pace that
    depended on how often a loop called it. This replaces the per-arch
    counts of 16 cycles and 10 us timers.
    A cycle that skips the poll pads the clock phase the poll used to
    fill. The F3850's XTLY high phase after a cycle with no write and the
    HD6120's OSC low phase after a memory write, short before, get pads
    too.
2026-11-05 [debugger] Check the service time before calling the devices
    Devs::loop() now checks the 10 us service time first and calls the
    devices only then, so every other bus cycle costs one comparison
    instead of a chain of virtual calls. The UART loses its own pacing.
    A device that counts bus cycles, the SCI handlers' bit clock and the
    8087's INT, is called on every cycle instead.
    The MC68HC12's EXTAL pad after a cycle with no service goes: that low
    phase measured at least 256 ns against a 25 ns minimum.
2026-11-05 [debugger] Trim the Z80 and MC6800 pads after the device loop
    The loop's own time now fills most of the clock phase before the next
    cycle: the Z80 CLK low before T1 measured 220 ns and the MC6800 PHI2
    fall to PHI1 rise 200-210 ns, against 125 and 100 ns minimums.
2026-11-05 [i8086] Support D8087 FPU
    Show the 8087's registers at each stop and detect an empty socket.
    Fix backtraces of short runs and steps into an interrupt.
2026-11-06 [scripts] Start casts at their first output and hold the last screen
    A saved recording opened on seconds of blank screen while the board was
    being opened, and the player stopped the moment the last line printed.
    retime-cast.py moves the first output to 0.5 s and keeps the final
    screen up for 3 s; record-scenario.py --save applies it.
2026-11-06 [samples] Retime the recorded casts
    Applies scripts/retime-cast.py to every cast: no blank start, and a
    3 s hold on the final screen. Output and its timing are unchanged.
2026-11-06 [h16] Add an HD641016 debugger
    EXTAL runs free from FlexPWM at 10 MHz and #WAIT holds every cycle;
    halt is #NMI, step the trace exception and a breakpoint the
    unimplemented opcode H'C0. The backtrace disassembles from the queue
    flushes PF shows. Samples echo, arith, echoir, echoitr and mandelbrot,
    with a mandelbrot cast from an HD641016CP10, and an encoding probe of
    the opcodes where ASL departs from the Programming Manual.
2026-11-06 [schematics] Return the mos6502 board to rev 10
    The rev 11 PWM clock gains nothing on a bus that takes one clock per
    cycle, so the rev 10 board, bit-banged with PHI0 on P55, stays the
    design. It matches the boards in use and the debugger on main.
2026-11-06 [h16] Release #WAIT at a calibrated PHI phase
    The release is timed on ARM_DWT_CYCCNT from a calibrated PHI phase
    instead of polling PHI, which let releases land inside the next fall's
    setup. Reads are looked up before their strobes and fetches one word
    ahead; the bus is let go at the release, and a write is stored after
    the next address. Memory cycles take two Tw instead of three:
    mandelbrot 2.4 s/frame at EXTAL 10 MHz, recast. The waves' windows
    cover the longer reset, step and echoitr.
2026-11-06 [debugger] Let r print registers the step dump leaves out
2026-11-06 [h16] List the ring bank registers on r, and add a ring bank sample
    In ring mode CR0-CR15 and PR0-PR15 follow the dump, read from the bank
    RAM with BPM set for the reads only, four registers a sequence. The
    sample is an Ackermann function with a ring bank per call: arguments in
    PRn, locals in CRn, and ring overflows stacked through BSP and back,
    with a cast. The samples name R15 SP.
2026-11-06 [mc9s12d] Add schematics
    Bionic board for the MC9S12DG128B (112-pin LQFP), two layers, on the
    MC68HC12B's Teensy bus pins. EXTAL is a 2.5 V pin, so P46 drives it
    through a buffer on its own LDO.
2026-11-07 [mc9s12x] Add schematics
    Bionic board for the MC9S12XDP512MAG (144-pin LQFP), four layers. The
    23 address lines reach P30-P37 through four 74HCS153 muxes. EXTAL is a
    2.5 V pin, so P47 drives it through a buffer on its own LDO.
2026-11-07 [z8000] Name the stack pointer SP
    The disassembler prints SP for R15, or RR14 on a segmented Z8001, and
    the register dump's SP= shows the same register, the other stack on
    line 1 above it. The samples name it SP; the Z8001's arith.inc is now
    the Z8002's.
2026-11-07 [z8000] Share the queue and mandelbrot includes
    The Z8001 samples include the Z8002's queue.inc, queue_wait.inc, io.inc
    and mandelbrot.inc. Queues and variables live at DATA: segment 2 for
    segmented code, 4000H otherwise, which moves the Z8002's workspace out
    of its image.
2026-11-07 [mos6502] Run each part's bit-banged bus cycles from its own engine
    Each part gets its own bus-cycle engine with its constants as traits,
    so a cycle makes no run-time part tests or virtual calls and reads each
    port once. Delays start from the part's datasheet and are cut where the
    code between edges covers them, keeping PHI2 within tPWH, tPWL and the
    rated clock; K still scales them, and RDY now gets time to rise.
    The mandelbrot docs take the new frame times; the 65C02 samples get a
    regress file and the 6502s capture tables for their BusCycles waves.
2026-11-08 [h16] Look up the predicted fetch while #WAIT holds the CPU
    A lookup missing the cache, after #WAIT was negated, could outlast
    the next cycle's T2: the CPU ran that cycle unserved, as echoir's
    third interrupt did (an STM mask read as its own address).
2026-11-08 [h16] Drop prefetched instructions that never ran from the backtrace
    A queue flush drops up to 8 fetched bytes, which the backtrace showed
    as executed. Each run now ends where its flush's cause says, lines a
    branch may have skipped without a flush are marked "?", and the
    backtrace count is of printed lines.
2026-11-08 [h16] Take a stacked PC only from an exception frame
    A spilled ring bank holding a code address looked like a stacked
    return PC and cut its own run from the backtrace.
2026-11-09 [docs] List the missing targets and variants
    Bring the README's Supported CPUs table in line with
    docs/supported-cpus.md: add the x86 row (P8086 with P8088, V30
    and V20, and D8087) and the CP1610, give the Z180 its own row,
    list the chips that run rather than board names (P8039 and
    MSM80C39, S80C196KC), and add the P80C51, TMP90P802 and TMS7000
    variants. In docs/supported-cpus.md, list the TMS7001, TMS7001NL4
    and TMS70C02, which pass the full regress on bench2, and name the
    chips the P8048, P8051 and TMS370Cx5x boards run on.
2026-11-09 [mc68000] Rename the MC68000PS board to HD68000PS
    It carries the HD68HC000PS, so the board takes the Hitachi name.
2026-11-09 [mc68000] Add MC68008 support
    The MC68008P and MC68008FN boards, one identity each. Reset parks the
    CPU at 0FF000H; the bus-cycle engine, register save and restore, step,
    halt, run and backtrace are shared with the 16-bit boards.
2026-11-09 [mc68000] Add MC68000 support
    The MC68000P, HD68000PS and MC68000FN boards: a 16-bit bus whose
    address comes through four 153s, its byte lanes from #UDS and #LDS.
2026-11-09 [mc68000] Add MC68HC001 support
    An MC68HC001 strapped for 8 bits (MODE low, JP1 on the FN board) moves
    every byte on #LDS with A0 on the bus. MODE is read while #RESET is
    held, as the first cycle's A0 already depends on it.
2026-11-09 [mc68000] Add MC68010 support
    The MC68010 stacks an 8-byte exception frame against 6: reset counts a
    level-7 frame's bytes to tell it apart. Its VBR, SFC and DFC are saved
    and restored through MOVEC, and vectors are read from VBR.
2026-11-09 [mc68000] Instantiate the bus cycle engine per board
    Each board class instantiates the engine, so its hooks are direct calls;
    the MC68008 boards then serve most writes in 6 clocks. The address
    nibbles shift into place with one mask per phase, and the 16-bit walk
    does its math while the selects settle.
2026-11-10 [scripts] Draw bumpered PQFPs in qfp_step.py and qfp_footprint.py
    The NG80386SX and MC68020 come in bumpered PQFPs: their models get
    the corner bumpers and the pin 1 side bevel, and their footprints a
    courtyard round the bumpers. Pin 1 is at the top row's middle on
    Motorola's package, at a corner on Intel's.
2026-11-10 [scripts] Draw Motorola's batwing logo in qfp_step.py
    logo=('motorola', u, v, ring radius) draws the ringed batwing as
    laser-marked on Motorola chips such as the MC68020FC.
2026-11-10 [debugger] Clock the MC68HC12 and MC68HC05C0 SCI handlers every cycle
    Their bit clocks count bus cycles, but they were still called from
    loopDevices(), which runs once per 10 us service tick since 5715aed93,
    so their bits ran several times too slow and the SCI samples received
    NULs.
2026-11-10 [mc9s12d] Add debugger
    Run the MC9S12DG128B in special test mode on the MC68HC12 debugger,
    answering reads that are neither internal nor free in place of #DBE.
    The SCI samples build per chip. K scales the bus cycle's delays; the
    defaults are half the MC68HC12B's. Benched with the mandelbrot cast.
2026-11-10 [mc68hc12] Put the sample code at $4000
    The MC9S12XDP512 has internal RAM up to $3FFF, so code from $2000 never
    reaches the bus there. $4000 is outside on the MC68HC912BD32,
    MC9S12DG128B and MC9S12XDP512 alike, so one set of images serves all
    three; data and the stack stay at $1000.
2026-11-10 [docs] Update the MC68HC12 mandelbrot timings
    The casts #242 re-recorded on the MC68HC912BD32 and MC9S12DG128B, with
    the same code moved to $4000, run at 2.5 s and 2.6 s per frame. The
    cycles per frame are unchanged, so the bit-banged clock scales with it.
2026-11-11 [mc9s12x] Add debugger
    Run the MC9S12XDP512 in emulation expanded mode with emulation memory,
    reading its 23-bit address through the board's muxes and replaying the
    queue from IQSTAT. Add an HCS12X mandelbrot sample.
    Also hold the CPU at the vector read when an interrupt is pending as
    restore()'s RTI ends, on every MC68HC12 board.
2026-11-13 [pdp11] Open the casts with the board's banner
    The DCT11 and DCJ11 scenarios now start with ?, as the others do, so
    each cast names its board. Recorded again.
2026-11-13 [pdp11] Drop discarded DCJ11 prefetches from the backtrace
    An IREQ followed by a demand fetch, or by no fetch, never ran, so it
    no longer prints as an instruction. The casts are re-recorded.
2026-11-13 [scripts] Accept octal words in the disasm regress
    PDP-11 lines print 6-digit octal words, so no line matched.
2026-11-13 [i8051] Clock each XTAL drive from a const-traits engine
    The P8051 (XTAL2) and P80C51 (inverted XTAL1) each get an engine with
    the clock level as a trait, so an XTAL edge is a plain store instead of
    an indirect call. Constant delays measured on the bus keep XTAL within
    the 12 MHz part's limits; registers are saved before a halt prints.
    Waves, casts and mandelbrot rows re-recorded.
2026-11-13 [scripts] Let a wave table filter its trigger's glitches
    A trigger's glitch drops the trigger channel's pulses shorter than
    that many seconds, so a CPU-side probe's crosstalk can't fire it.
2026-11-13 [z180] Read A8-A15 with one port read
    AM and AH share GPIO7: read it once, then flip ASEL and compose while
    the extended address settles. Re-record the casts with their frame
    times, add the reset, echoitr and step wave tables, and name the
    HD64180S's WCRL and RCR.
2026-11-13 [tms9900] Read the resting address half first
    SEL0 rests high, so read that half before switching, and put it away
    while the other half settles. One settle per address instead of two.
    Re-record the cast with its clock and frame time, and add the reset,
    echoitr and step wave tables.
2026-11-13 [z380] Settle each mux step with one port read
    Measured from the Teensy side, the read right after a select write is
    still stale and the next one right; a discarded read costs 15 ns
    against delayNanoseconds(15) and its call. Re-record the casts with
    their clocks and frame times, and add the reset, echoitr and step wave
    tables.
2026-11-13 [mc68hc16] Settle each mux step with one port read
    against delayNanoseconds(15) and its call. Pack the nibbles with
    shifts; compose() stays as the tested layout. Re-record the cast and
    add the reset, echoitr and step wave tables.
    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
2026-11-13 [mc68000] Settle each mux step with one port read
    still stale and the next one right. The control read fills the first
    step; the others take a discarded read instead of
    delayNanoseconds(15). Add an echoitr sample, re-record the MC68010
    cast with its clock, and add the reset, echoitr and step wave tables.
    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
2026-11-13 [mc68008] Settle the mux step with one port read
    Measured from the Teensy side, the read right after the select write
    is still stale and the next one right; a discarded read replaces
    delayNanoseconds(15). Re-record the casts and add the reset, echoitr
    and step wave tables.
2026-11-13 [i8087] Put fmandel's data on even addresses
    A 16-bit bus moves an even word in one cycle. Re-pin the scenarios'
    fmandel_i and re-record both casts.
2026-11-13 [i8086] Start the console routines on even addresses
    A 16-bit bus fetches an odd entry's first byte alone. Re-pin the
    8080 emulation scenarios' handler and re-record the casts.
2026-11-13 [z280] Put the console routines and words on even addresses
    A 16-bit bus fetches an odd entry's first byte alone and moves an odd
    word in two cycles. newline ends in a jump so putchar can be aligned.
    Re-pin the scenario and re-record the cast.
2026-11-13 [z380] Start the console routines on even addresses
    A 16-bit bus fetches an odd entry's first byte alone. newline ends in
    a jump so putchar can be aligned. Re-pin the scenario and re-record
    the cast.
2026-11-14 [debugger] Fix the teensy41 build warnings
2026-11-14 [mc68000] Settle the mux with a delay
    One port read per select step misreads device cycles on bench1, on the
    FN and P boards alike: each step waits asel_delay_ns again, with the
    strobes read before the first select write.
2026-11-14 [mc68000] Name the detected CPU
    The banner and help named the board's identity, not the chip: report
    MC68010 when reset finds its 8-byte frame and MC68000 otherwise; an
    MC68008 board keeps its identity, MC68008P or MC68008FN. cpu() still
    names the instruction set. The regress takes its chips from the banner.
2026-11-14 [scripts] Check the backtrace line count in regress
    A [backtrace] table opts a target in: g to a label, and G a sample
    that stops by itself, with counts 0, n and none.
2026-11-14 [tms320] Honor the backtrace line limit
    Every program read is a fetch, so count instructions as the backtrace
    prints them.
2026-11-14 [pdp11] Honor the DCJ11 backtrace line limit
    Discarded prefetches and operand words are fetches too, so count
    instructions as the backtrace prints them.
2026-11-14 [dcj11] Find the trap frame by its 16-bit addresses
    DAL16-DAL19 can read wrong under the PWM; a frame whose two writes
    differed there was missed, and the CPU ran on from 173004.
2026-11-14 [dcj11] Leave DAL16-DAL19 out of a run's address read
    They leave DAL before the PWM's read reaches the 153s' phase 0, and
    were read wrong in most cycles; with the MMU off they follow DAL20/21.
